koko69420/SmartBMS_Active-balancing/16s_BMS_Bill_of_Materials.xlsx

Sheet: Executive_Summary
16S LiFePO4 BMS - Procurement Executive Summary & Stock Analysis
Complete breakdown with MOQ / minimum pack sizing, XIQI 100A current shunt, external harness sensors, and verified domestic in-stock alternatives
SUPPLIER COST BREAKDOWN (ACCOUNTING FOR MOQ)
Supplier Name | Website / Storefront | Line Items | Design Qty | Cart / Order Qty | Order Total (₹) | Share of Total
ET Store | https://etstore.in
Robu.in | https://robu.in
Evelta | https://evelta.com
LionCircuits | https://lioncircuits.com
Rajiv Electronics | https://rajivelectronics.com
Sharvi Electronics | https://sharvielectronics.com
TOTALS | All Approved Domestic Sources
STOCK STATUS & VERIFIED IN-STOCK ALTERNATIVES
Part / Subsystem | Design Part | Supplier Status | Recommended In-Stock Alternative | Technical Verification & Impact
60V TVS Diode | SMBJ60CA (Evelta) | Out of stock on Evelta | SMBJ64CA-13-F (Robu.in ₹31.00) | In stock on Robu. Standoff 64V prevents leakage at 58.4V full pack charge while clamping safely below 100V FET breakdown.
100V Buck Regulator | TI LM5164DDA (Evelta) | Bare IC fluctuating | 7Semi LM5164 Buck Module (Evelta ₹548.70) | 173 units in stock on Evelta. Pre-built synchronous buck board with inductor and filter caps; can be wired or IC desoldered.
16-Ch Analog Mux | CD74HC4067SM (ET Store) | Breakout temporarily sold out | 74HC4067 Bare IC (Robu.in ₹35.00 / Sunrom) | In stock on Robu and Sunrom. Exact pin-compatible TSSOP/SSOP/SOP footprint for temperature & balance sensing.
RISC-V Microcontroller | CH32V203C8T6 Bare IC (ET Store) | In stock / hobby pack | WeAct CH32V203 Board (Robu ₹199) or STM32F103 (Evelta) | STM32F103C8T6 is 100% pin-compatible in LQFP-48 with identical pin functions (CAN, ADC, I2C, SPI).
Isolated DC-DC Rail | B1209S-1WR3 (Robu.in) | In stock (K-CUT brand ₹109) | Hi-Link HLK-B1209S-2WR3 (Robu.in ₹199.00) | 2W version provides higher peak gate charging current margin for switching the 16x IRFB4110 MOSFET bank.

Sheet: Master_BOM
16S LiFePO4 BMS - Complete Master Bill of Materials (Hierarchical & Verified)
Includes all 7 schematic sheets, 32 NTC dividers, XIQI 100A shunt, external NTC probes, mating hoods, commercial MOQs, stock status & verified alternatives
Item # | Subsystem / Sheet | Category | Reference Designator(s) | Component / Value | Description & Functional Purpose | Package / Footprint | Type | Design Qty | MOQ / Pack | Order Qty | Primary Supplier | Unit Price (₹) | Order Total (₹) | Stock Status | Verified In-Stock Alternative(s) | Direct Purchase Link
1 | External (Chassis / Busbar) | Current Shunt | RS1 (External Current Shunt, wired to J31/J32) | FL-2B 100A 75mV | XIQI Electric CG FL-2B 100A 75mV DC Current Shunt Resistor | Chassis_BoltMount | Chassis/THT | 1 | 1 | 1 | Robu.in | ₹352.00 |  | In Stock | FL-2C 100A 75mV with base (Robu ₹499), FL-2 150A 75mV | View / Buy on Robu.in (https://robu.in/product/xiqi-electric-cg-fl-2b-100a-75mv-dc-current-shunt-resister/)
2 | External (Chassis / Precharge) | Precharge Resistor | R_PRE (External Precharge Chassis-Mount Power Resistor, wired to J35) | 50 Ω 25W | 50 Ohm 25W Aluminum Housed Wirewound Power Resistor (55mm mounting pitch) | Chassis_Mount_55mm_Pitch | Chassis/THT | 1 | 1 | 1 | Sharvi Electronics | ₹184.88 |  | Procured (In Hand, 55mm Pitch) | 50 Ohm 50W Aluminum Resistor (Sharvi ₹184.88) | View / Buy on Sharvi Electronics (https://sharvielectronics.com/product/50-ohm-25-watt-aluminum-housed-wirewound-power-resistor/)
3 | External (Cell Pack Harness) | Sensors (External) | TH1..TH16 (16x Cell Temperature Sensors for DB-25 J20) | 10k NTC 3950 (with wire) | 10K Ohm NTC Thermistor Temperature Sensor Probe with 1m wire lead | Probe_Wire_Harness | Harness | 16 | 1 | 16 | ET Store | ₹14.58 |  | In Stock | ETStore SKU ET5524, NTC 10K with steel cap (ETD11498), 100K 3950 | View / Buy on ET Store (https://www.etstore.in/products/ntc-10k-ohm-with-wire-thermistor-temperature-sensor-et5524)
4 | 01 Cell AFE | ICs & Modules | U1 | BQ76952PFBR | 16S LiFePO4 Battery Monitor, Protector & Balancer IC | QFP50P900X900X120-48N | SMD | 1 | 1 | 1 | LionCircuits | ₹665.29 |  | In Stock | TI BQ76952PFBR, BQ7695202 (I2C default) | View / Buy on LionCircuits (https://www.lioncircuits.com/components/texas-instruments/bq76952pfbr)
5 | 04 Current Switching | ICs & Modules | U2, U3 | UCC27517DBVR | 4A High-Speed Low-Side Gate Driver, SOT-23-5 | SOT-23-5 | SMD | 2 | 1 | 2 | Robu.in | ₹35.00 |  | In Stock | UCC27511DBVR, FAN3100, MCP1407 | View / Buy on Robu.in (https://robu.in/product/ucc27517dbvr-texas-instruments/)
6 | 04 Current Switching | ICs & Modules | U4, U5, U6, U7, U40 | EL817 | Single Channel Phototransistor Optocoupler, SOP-4 | SOP-4_3.8x4.1mm_P2.54mm | SMD | 5 | 2 | 6 | ET Store | ₹6.50 |  | In Stock | PC817C, EL817S, TLP785, LTV-817 | View / Buy on ET Store (https://www.etstore.in/products/pc817-el817-opto-coupler-isolator-module-4-channel-level-shifter-et7518)
7 | 05 Temperature Sensing | ICs & Modules | U8, U9, U30 | CD74HC4067SM | High-Speed 16-Channel Analog Multiplexer / Demultiplexer | SSOP-24_5.3x8.2mm_P0.65mm | SMD | 3 | 1 | 3 | ET Store | ₹56.87 |  | In Stock | 74HC4067, 74HCT4067, ADG706 (Robu.in SKU 16345, Sunrom) | View / Buy on ET Store (https://www.etstore.in/products/cd74hc4067-multiplexer-breakout-module-et5969)
8 | 02 Power Supply | ICs & Modules | U10 | LM5164DDA | 100V 1A Synchronous Step-Down Buck DC-DC Converter | HSOP-8-1EP_3.9x4.9mm_P1.27mm_EP2.41x3.1mm_ThermalVias | SMD | 1 | 1 | 1 | Evelta | ₹548.70 |  | In Stock (7Semi Module / IC) | 7Semi LM5164 Breakout, TI LM5017MR, LM5007 (100V step-down) | View / Buy on Evelta (https://evelta.com/7semi-dc-dc-buck-converter-7v-100v-input-to-5v-1a-output-lm5164/)
9 | 02 Power Supply | ICs & Modules | U11 | LM2596S-3.3 | 3A Step-Down Voltage Regulator (LM2596S-3.3), TO-263-5 | TO-263-5_TabPin3 | SMD | 1 | 1 | 1 | ET Store | ₹35.00 |  | In Stock | LM2596S-ADJ + divider, LM2576S, XL4015 module | View / Buy on ET Store (https://www.etstore.in/products/lm2596s-step-down-voltage-regulator-to-263)
10 | 02 Power Supply | ICs & Modules | U12 | B1212S-1WR3 | 1W 12V-to-12V Isolated DC-DC Converter Module | Converter_DCDC_Murata_MEE1SxxxxSC_THT | THT | 1 | 1 | 1 | ET Store | ₹103.00 |  | In Stock | Mornsun B1212S-1WR3, Hi-Link HLK-B1212S-2WR3 | View / Buy on ET Store (https://www.etstore.in/products/b1212s-1wr3-g-energy-ylptec-isolated-module-dc-dc-converter-eta2637)
11 | 02 Power Supply | ICs & Modules | U13 | LM2596S-5.0 | 3A Step-Down Voltage Regulator (LM2596S-5.0), TO-263-5 | TO-263-5_TabPin3 | SMD | 1 | 1 | 1 | ET Store | ₹35.00 |  | In Stock | LM2596S-ADJ + divider, LM2576S, XL4015 module | View / Buy on ET Store (https://www.etstore.in/products/lm2596s-step-down-voltage-regulator-to-263)
12 | 07 Isolated CAN & Comms | ICs & Modules | U13 | ISO1050DUBR | 5V Isolated CAN Transceiver, SOP-8 | SOP-8_6.62x9.15mm_P2.54mm | SMD | 1 | 1 | 1 | Evelta | ₹230.10 |  | In Stock | TI ISO1050DUB, Robu.in ISO1050 Module, MAX14882 | View / Buy on Evelta (https://evelta.com/iso1050dubr-5v-isolated-can-transceiver-8-pin-sop/)
13 | 07 Isolated CAN & Comms | ICs & Modules | U14 | B1209S-1WR3 | 1W 12V-to-9V Isolated DC-DC Converter for Gate Drive Rail | Converter_DCDC_Murata_MEE1SxxxxSC_THT | THT | 1 | 1 | 1 | Robu.in | ₹109.00 |  | In Stock | K-CUT B1209S-1W, Hi-Link HLK-B1209S-2WR3 (₹199, Robu) | View / Buy on Robu.in (https://robu.in/product/k-cut-b1209s-1w-dc-dc-12-to-9v-isolated-step-down-power-module/)
14 | 07 Isolated CAN & Comms | ICs & Modules | U15 | AMS1117-5.0 | 1A Low Dropout Linear Voltage Regulator 5.0V, SOT-223 | SOT-223-3_TabPin2 | SMD | 1 | 1 | 1 | ET Store | ₹8.00 |  | In Stock | LM1117-5.0, AP1117-50, LD1117S50TR | View / Buy on ET Store (https://www.etstore.in/products/ams1117-5-0v-sot-223-voltage-regulator)
15 | 03 MCU Control | ICs & Modules | U20 | CH32V203C8T6 | QingKe 32-bit RISC-V MCU, 64KB Flash, 20KB SRAM, LQFP-48 | LQFP-48_7x7mm_P0.5mm | SMD | 1 | 1 | 1 | ET Store | ₹95.00 |  | In Stock | Robu.in WeAct CH32V203C8T6 Board (₹199), Evelta STM32F103C8T6 (₹210) | View / Buy on ET Store (https://www.etstore.in/products/ch32v203c8t6-risc-v-microcontroller-lqfp-48)
16 | 03 MCU Control | ICs & Modules | U21 | FM24CL64B-G | 64 Kbit (8Kx8) High-Endurance Non-Volatile I2C FRAM | SOIC-8_3.9x4.9mm_P1.27mm | SMD | 1 | 1 | 1 | Robu.in | ₹232.00 |  | In Stock | FM24CL16B (16Kb), FM24W256 (256Kb), Microchip 24LC256 (EEPROM) | View / Buy on Robu.in (https://robu.in/product/fm24cl64b-gtr-infineon-cypress-64kbit-soic-8-fram/)
17 | 06 Balance Status | ICs & Modules | U31..U34 (16 items: U31, U31, U31, U31 ...) | LTV-847S | Lite-On 4-Channel DC Optocoupler Isolator (Quad) | SMDIP-16_W9.53mm | SMD | 4 | 1 | 4 | ET Store | ₹60.53 |  | In Stock | PC847, EL847, TLP281-4, 4x PC817 | View / Buy on ET Store (https://www.etstore.in/products/ltv-847-dip-16-lite-on-847-4-channel-opto-coupler-isolators-eta2359)
18 | 04 Current Switching | Transistors/FETs | Q1..Q19 (17 items: Q1, Q2, Q3, Q4 ...) | IRFB4110 | 100V 180A 3.7mR N-Channel Power MOSFET (TO-220 THT) | TO-220-3_Vertical | THT | 17 | 1 | 17 | ET Store | ₹55.99 |  | In Stock | HY4008 (80V 200A), IRFB4310, STP180N10F7 | View / Buy on ET Store (https://www.etstore.in/products/irfb4110-to220-ir-mosfet-n-channel-100v-180a-eta1308)
19 | 04 Current Switching | Transistors/FETs | Q17, Q18 | BC817-40,215 | 45V 500mA General Purpose NPN Transistor, SOT-23 | SOT-23_Handsoldering | SMD | 2 | 5 | 5 | ET Store | ₹3.00 |  | In Stock | MMBT3904, 2N3904, BC847 | View / Buy on ET Store (https://www.etstore.in/products/bc817-25-sot-23-npn-transistor)
20 | 01 Cell AFE | Transistors/FETs | Q21 | BCX56-135 | 80V 1A Medium Power NPN Transistor, SOT-89-3 | SOT-89-3_Handsoldering | SMD | 1 | 1 | 1 | Evelta | ₹11.38 |  | In Stock | BCX56-16, BCP56, 2SD882 | View / Buy on Evelta (https://evelta.com/bcx56-cj-npn-bipolar-transistor-bjt-80v-1a-sot-89/)
21 | 01 Cell AFE | Diodes/TVS | D1, D2 | BAV21WS | 250V 200mA Fast Switching Diode, SOD-323 | D_SOD-323_HandSoldering | SMD | 2 | 5 | 5 | ET Store | ₹2.50 |  | In Stock | 1N4148W, BAV19WS, BAV20WS | View / Buy on ET Store (https://www.etstore.in/products/bav21ws-sod-323-switching-diode)
22 | 02 Power Supply | Diodes/TVS | D3 | SMBJ60CA | 60V 600W Bidirectional TVS Diode, SMB | D_SMB | SMD | 1 | 1 | 1 | Evelta | ₹15.00 |  | Low Stock / Use In-Stock Alt | SMBJ64CA-13-F (₹31, In Stock Robu), SMCJ60CA, 1.5SMC62CA | View / Buy on Evelta (https://evelta.com/smbj60ca-60v-bidirectional-tvs-diode-smb-surface-mount/)
23 | 02 Power Supply | Diodes/TVS | D4 | B340 | 40V 3A Schottky Barrier Rectifier Diode, SMC | D_SMC | SMD | 1 | 2 | 2 | ET Store | ₹6.00 |  | In Stock | SS34, SK34, MBRS340 | View / Buy on ET Store (https://www.etstore.in/products/ss34-b340-smc-schottky-barrier-diode)
24 | 02 Power Supply | Diodes/TVS | D5 | B340 | 40V 3A Schottky Barrier Rectifier Diode, SMC | D_SMC | SMD | 1 | 2 | 2 | ET Store | ₹6.00 |  | In Stock | SS34, SK34, MBRS340 | View / Buy on ET Store (https://www.etstore.in/products/ss34-b340-smc-schottky-barrier-diode)
25 | 07 Isolated CAN & Comms | Diodes/TVS | D5 | PESD2CAN | CAN Bus Dual-line ESD Protection TVS Diode, SOT-23 | SOT-23 | SMD | 1 | 1 | 1 | Robu.in | ₹12.00 |  | In Stock | PESD1CAN, NUP2105L, ESDCAN01-2BWY | View / Buy on Robu.in (https://robu.in/product/pesd2can215-nexperia/)
26 | 02 Power Supply | Diodes/TVS | D6 | B5819W | 40V 1A Surface Mount Schottky Barrier Diode, SOD-123 | D_SMA | SMD | 1 | 5 | 5 | ET Store | ₹3.00 |  | In Stock | 1N5819HW, SS14, BAT54 | View / Buy on ET Store (https://www.etstore.in/products/1n5819-b5819w-sod-123-schottky-diode)
27 | 03 MCU Control | Diodes/TVS | D10 | GREEN | SMD Green Indicator LED, 0805 | LED_0805_2012Metric | SMD | 1 | 5 | 5 | ET Store | ₹2.00 |  | In Stock | Standard 0805 SMD LEDs (Red/Blue/Green) | View / Buy on ET Store (https://www.etstore.in/products/smd-0805-green-led)
28 | 07 Isolated CAN & Comms | Diodes/TVS | D20 | SMAJ6.0A | 6.0V 400W Fast Unidirectional TVS Diode, SMA | D_SMA | SMD | 1 | 1 | 1 | Evelta | ₹4.15 |  | In Stock | SMAJ5.0A, SMAJ6.5A, SMBJ6.0A | View / Buy on Evelta (https://evelta.com/smaj6-0a-6v-400w-esd-suppressor-tvs-diode/)
29 | 08 Precharge Circuit | Diodes/TVS | D40 | SMAJ75A | 75V 400W Fast Unidirectional TVS Diode (Precharge Inductive Clamp, SMA) | D_SMA | SMD | 1 | 1 | 1 | Evelta | ₹3.30 |  | In Stock (SKU: 273-SMAJ75A) | SMAJ70A, SMAJ78A, SMCJ75A (1.5kW), Robu.in 75V TVS | View / Buy on Evelta (https://evelta.com/smaj75a-75v-400w-esd-suppressor-tvs-diode/)
30 | 08 Precharge Circuit | Diodes/TVS | D41 | BZT52C15 | 15V 500mW SMD Zener Diode (Gate Clamp, SOD-123) | D_SOD-123 | SMD | 1 | 5 | 5 | ET Store | ₹1.77 |  | In Stock (Marking WJ, ETStore) | MMSZ5245B, BZX384-C15, 15V 500mW Zener SOD-123 | View / Buy on ET Store (https://www.etstore.in/products/bzt52c15-wj-sod123-15v-zener-diode-smd)
31 | 08 Precharge Circuit | Diodes/TVS | D42 | BAT54S | Dual Schottky Barrier Diode Series Pair (Precharge Sense ADC Rail Clamp, SOT-23) | SOT-23 | SMD | 1 | 1 | 1 | Evelta | ₹2.01 |  | In Stock (JD / Nexperia, Evelta) | BAT54A, BAT54C, MMBD4148 dual, 2x 1N5819 | View / Buy on Evelta (https://evelta.com/bat54s-sot-23-3-schottky-barrier-diode/)
32 | 02 Power Supply | Protection/Fuses | F1 | 2A 80V | 2A 80V Fast-Acting Surface Mount Fuse, 1812 | Fuse_1812_4532Metric | SMD | 1 | 2 | 2 | ET Store | ₹16.00 |  | In Stock | Bel Fuse 0685P, Littelfuse 0451 | View / Buy on ET Store (https://www.etstore.in/products/1812-smd-fast-blow-fuse)
33 | 02 Power Supply | Protection/Fuses | F2 | 3.15A | 3.15A Fast-Acting Surface Mount Fuse, 1812 | Fuse_1812_4532Metric | SMD | 1 | 2 | 2 | ET Store | ₹16.00 |  | In Stock | Bel Fuse 0685P, Littelfuse 0451 | View / Buy on ET Store (https://www.etstore.in/products/1812-smd-fast-blow-fuse)
34 | 07 Isolated CAN & Comms | Protection/Fuses | F10 | 1.0A 1812 PTC | 1.0A 16V Resettable Polymeric PTC Fuse, 1812 | Fuse_1812_4532Metric | SMD | 1 | 2 | 2 | ET Store | ₹18.00 |  | In Stock | Bourns MF-MSMF110, Littelfuse 1812L110 | View / Buy on ET Store (https://www.etstore.in/products/1812-resettable-ptc-fuse-1a)
35 | External (Harness Cable) | Connectors/Hardware | P20 (Mating Plug for J20 DB-25 NTC Harness) | DB25 Male Solder Plug + Hood | DB25 Male Solder-Type Connector Plug with Plastic/Metal Protective Shell | Cable_Mount | Cable | 1 | 1 | 1 | Rajiv Electronics | ₹35.00 |  | In Stock | DB25 Male Solder Cup (₹18.90) + DB25 Plastic Cover (₹18.00) | View / Buy on Rajiv Electronics (https://rajivelectronics.com/product/db25-male-connector/)
36 | External (Harness Cable) | Connectors/Hardware | P30 (Mating Plug for J30 DD-50 Balance Tap Harness) | DB50 Male Solder Plug + Hood | DB50 50-Pin D-Sub Male Solder-Type Connector Plug with Protective Dust Cover | Cable_Mount | Cable | 1 | 1 | 1 | Rajiv Electronics | ₹95.00 |  | In Stock | Rajiv DB50 Male Solder Type (₹82.60) + DB50 Metal/Plastic Hood | View / Buy on Rajiv Electronics (https://rajivelectronics.com/product/db50-50-pin-d-sub-male-connector-solder-type/)
37 | 02 Power Supply | Connectors/Hardware | J1 | FAN1 | 2-Pin 5.08mm Pitch PCB Screw Terminal Block | TerminalBlock_Phoenix_MKDS-1,5-2-5.08_1x02_P5.08mm_Horizontal | THT | 1 | 1 | 1 | ET Store | ₹12.00 |  | In Stock | Phoenix MKDS 1,5/2-5.08, Degson DG301-5.08 | View / Buy on ET Store (https://www.etstore.in/products/2-pin-5-08mm-pitch-screw-terminal-block)
38 | 02 Power Supply | Connectors/Hardware | J2 | FAN2 | 2-Pin 5.08mm Pitch PCB Screw Terminal Block | TerminalBlock_Phoenix_MKDS-1,5-2-5.08_1x02_P5.08mm_Horizontal | THT | 1 | 1 | 1 | ET Store | ₹12.00 |  | In Stock | Phoenix MKDS 1,5/2-5.08, Degson DG301-5.08 | View / Buy on ET Store (https://www.etstore.in/products/2-pin-5-08mm-pitch-screw-terminal-block)
39 | 02 Power Supply | Connectors/Hardware | J4 | 12V_EXT | 2-Pin 5.08mm Pitch PCB Screw Terminal Block | TerminalBlock_Phoenix_MKDS-1,5-2-5.08_1x02_P5.08mm_Horizontal | THT | 1 | 1 | 1 | ET Store | ₹12.00 |  | In Stock | Phoenix MKDS 1,5/2-5.08, Degson DG301-5.08 | View / Buy on ET Store (https://www.etstore.in/products/2-pin-5-08mm-pitch-screw-terminal-block)
40 | 07 Isolated CAN & Comms | Connectors/Hardware | J4 | PACK LINK, NOT ETHERNET | RJ45 8P8C Right-Angle Shielded PCB Modular Jack | RJ45_Amphenol_54602-x08_Horizontal | THT | 1 | 1 | 1 | ET Store | ₹25.00 |  | In Stock | Amphenol 54602-x08, Standard PCB RJ45 Jack | View / Buy on ET Store (https://www.etstore.in/products/rj45-8p8c-horizontal-pcb-female-jack)
41 | 03 MCU Control | Connectors/Hardware | J10 | WCH-LinkE | 2.54mm Pitch Breakaway Pin Header (WCH-LinkE) | PinHeader_1x05_P2.54mm_Vertical | THT | 1 | 1 | 1 | ET Store | ₹5.00 |  | In Stock | 40-pin 2.54mm Male/Female header strips | View / Buy on ET Store (https://www.etstore.in/products/40-pin-2-54mm-male-header-strip)
42 | 03 MCU Control | Connectors/Hardware | J11 | Debug UART | 2.54mm Pitch Breakaway Pin Header (Debug UART) | PinHeader_1x03_P2.54mm_Vertical | THT | 1 | 1 | 1 | ET Store | ₹5.00 |  | In Stock | 40-pin 2.54mm Male/Female header strips | View / Buy on ET Store (https://www.etstore.in/products/40-pin-2-54mm-male-header-strip)
43 | 03 MCU Control | Connectors/Hardware | J12 | OLED Display (I2C) | 0.96 inch 128x64 I2C OLED Display Module (SSD1306, 4-Pin) | PinHeader_1x04_P2.54mm_Vertical | THT | 1 | 1 | 1 | ET Store | ₹171.73 |  | In Stock | SSD1306 0.96 I2C Blue/White, SH1106 1.3 inch I2C OLED | View / Buy on ET Store (https://www.etstore.in/products/0-96-inch-oled-display-module-i2c-128x64-4-pin-blue-et5049)
44 | 06 Balance Status | Connectors/Hardware | J20 | DB25_Female | 25-Pin D-Sub Female Right-Angle PCB Connector (NTC Taps) | DSUB-25_Socket_Horizontal_P2.77x2.84mm_EdgePinOffset4.94mm_Housed_MountingHolesOffset4.94mm | THT | 1 | 1 | 1 | Rajiv Electronics | ₹26.00 |  | In Stock | Rajiv DB25 Female, Amphenol D-sub 25 | View / Buy on Rajiv Electronics (https://rajivelectronics.com/product/db25-right-angle-female-connector-25-pin-d-sub-pcb-mount/)
45 | Top Level Interconnect | Connectors/Hardware | J30 | DD50_Female | 50-Pin D-Sub High-Density Female PCB Connector (Cell Taps) |  | THT | 1 | 1 | 1 | Rajiv Electronics | ₹112.10 |  | In Stock | Rajiv DB50 Straight Female, NorComp 180-050-203L001 | View / Buy on Rajiv Electronics (https://rajivelectronics.com/product/db50-pin-d-sub-pcb-mount-straight-female-connector/)
46 | Top Level Interconnect | Connectors/Hardware | J31 | SHUNT KELVIN | 2.54mm Pitch Breakaway Pin Header (SHUNT KELVIN) | PinHeader_1x02_P2.54mm_Vertical | THT | 1 | 1 | 1 | ET Store | ₹5.00 |  | In Stock | 40-pin 2.54mm Male/Female header strips | View / Buy on ET Store (https://www.etstore.in/products/40-pin-2-54mm-male-header-strip)
47 | Top Level Interconnect | Connectors/Hardware | J32 | FROM SHUNT | FROM SHUNT High-Current M5/M6 Direct Bolt-Down PCB Pad Terminal | MountingHole_8.4mm_M8_Pad | THT/Pad | 1 | 5 | 5 | Rajiv Electronics | ₹12.00 |  | In Stock | M5/M6 SS304 Hex Bolt, Spring Washer, Flange Nut | View / Buy on Rajiv Electronics (https://rajivelectronics.com/product-category/hardware-fittings/)
48 | Top Level Interconnect | Connectors/Hardware | J33 | PACK MINUS | PACK MINUS High-Current M5/M6 Direct Bolt-Down PCB Pad Terminal | MountingHole_8.4mm_M8_Pad | THT/Pad | 1 | 5 | 5 | Rajiv Electronics | ₹12.00 |  | In Stock | M5/M6 SS304 Hex Bolt, Spring Washer, Flange Nut | View / Buy on Rajiv Electronics (https://rajivelectronics.com/product-category/hardware-fittings/)
49 | Top Level Interconnect | Connectors/Hardware | J34 | PACK PLUS TAP | PACK PLUS TAP High-Current M5/M6 Direct Bolt-Down PCB Pad Terminal | MountingHole_8.4mm_M8_Pad | THT/Pad | 1 | 5 | 5 | Rajiv Electronics | ₹12.00 |  | In Stock | M5/M6 SS304 Hex Bolt, Spring Washer, Flange Nut | View / Buy on Rajiv Electronics (https://rajivelectronics.com/product-category/hardware-fittings/)
50 | 08 Precharge Circuit | Connectors/Hardware | J35 | AK300-2 | 2-Pin 5.08mm Pitch Precharge Resistor Terminal Block (Chassis Resistor Header) | TerminalBlock_Phoenix_MKDS-1,5-2-5.08_1x02_P5.08mm_Horizontal | THT | 1 | 1 | 1 | ET Store | ₹12.00 |  | In Stock | Phoenix MKDS 1,5/2-5.08, Degson DG301-5.08 | View / Buy on ET Store (https://www.etstore.in/products/2-pin-5-08mm-pitch-screw-terminal-block)
51 | 02 Power Supply | Connectors/Hardware | JP1 | JP_OPEN | 2-Pin Solder Jumper (JP_OPEN) | SolderJumper-2_P1.3mm_Open_Pad1.0x1.5mm | SMD | 1 | N/A | 0 | ET Store | ₹0.00 |  | PCB Track Feature | Solder bridge / 0-Ohm 0805 resistor | N/A (PCB Feature)
52 | 07 Isolated CAN & Comms | Connectors/Hardware | JP1 | TERMINATION | 2-Pin Solder Jumper (TERMINATION) | SolderJumper-2_P1.3mm_Open_RoundedPad1.0x1.5mm | SMD | 1 | N/A | 0 | ET Store | ₹0.00 |  | PCB Track Feature | Solder bridge / 0-Ohm 0805 resistor | N/A (PCB Feature)
53 | 03 MCU Control | Connectors/Hardware | JP10 | BOOT0 | 2-Pin Solder Jumper (BOOT0) | SolderJumper-2_P1.3mm_Open_RoundedPad1.0x1.5mm | SMD | 1 | N/A | 0 | ET Store | ₹0.00 |  | PCB Track Feature | Solder bridge / 0-Ohm 0805 resistor | N/A (PCB Feature)
54 | 03 MCU Control | Connectors/Hardware | JP11 | ADDR0 | 2-Pin Solder Jumper (ADDR0) | SolderJumper-2_P1.3mm_Open_RoundedPad1.0x1.5mm | SMD | 1 | N/A | 0 | ET Store | ₹0.00 |  | PCB Track Feature | Solder bridge / 0-Ohm 0805 resistor | N/A (PCB Feature)
55 | 03 MCU Control | Connectors/Hardware | JP12 | ADDR1 | 2-Pin Solder Jumper (ADDR1) | SolderJumper-2_P1.3mm_Open_RoundedPad1.0x1.5mm | SMD | 1 | N/A | 0 | ET Store | ₹0.00 |  | PCB Track Feature | Solder bridge / 0-Ohm 0805 resistor | N/A (PCB Feature)
56 | 03 MCU Control | Connectors/Hardware | JP13 | ADDR2 | 2-Pin Solder Jumper (ADDR2) | SolderJumper-2_P1.3mm_Open_RoundedPad1.0x1.5mm | SMD | 1 | N/A | 0 | ET Store | ₹0.00 |  | PCB Track Feature | Solder bridge / 0-Ohm 0805 resistor | N/A (PCB Feature)
57 | 03 MCU Control | Connectors/Hardware | JP14 | EE_WP | 2-Pin Solder Jumper (EE_WP) | SolderJumper-2_P1.3mm_Open_RoundedPad1.0x1.5mm | SMD | 1 | N/A | 0 | ET Store | ₹0.00 |  | PCB Track Feature | Solder bridge / 0-Ohm 0805 resistor | N/A (PCB Feature)
58 | 03 MCU Control | Inductors/Filters | FB10 | 120R/1.5A | 120 Ohm @ 100MHz 1.5A Ferrite Bead, 0805 | L_0805_2012Metric | SMD | 1 | 5 | 5 | ET Store | ₹3.50 |  | In Stock | Murata BLM21PG121SN1D, Sunlord 0805 Bead | View / Buy on ET Store (https://www.etstore.in/products/0805-smd-ferrite-bead-120-ohm)
59 | 02 Power Supply | Inductors/Filters | L1 | 68 uH | 68 uH High-Current Shielded Power Inductor (SRR1260) | L_Bourns_SRR1260 | SMD | 1 | 1 | 1 | ET Store | ₹28.00 |  | In Stock | Bourns SRR1260, Wurth WE-PDF, Coilcraft MSS1260 | View / Buy on ET Store (https://www.etstore.in/products/33uh-smd-power-inductor-srr1260)
60 | 02 Power Supply | Inductors/Filters | L2, L3 | 33 uH | 33 uH High-Current Shielded Power Inductor (SRR1260) | L_Bourns_SRR1260 | SMD | 2 | 1 | 2 | ET Store | ₹28.00 |  | In Stock | Bourns SRR1260, Wurth WE-PDF, Coilcraft MSS1260 | View / Buy on ET Store (https://www.etstore.in/products/33uh-smd-power-inductor-srr1260)
61 | 03 MCU Control | Crystals | Y1 | 8MHz | 8.000 MHz Fundamental SMD Crystal Resonator (3225-4P) | Crystal_SMD_3225-4Pin_3.2x2.5mm | SMD | 1 | 1 | 1 | ET Store | ₹15.00 |  | In Stock | Abracon ABM8, TXC 7M-8.000MAAJ-T, HC-49SMD | View / Buy on ET Store (https://www.etstore.in/products/8mhz-smd-crystal-oscillator-3225)
62 | 01 Cell AFE | Resistors | R1..R17 (17 items: R1, R2, R3, R4 ...) | 20 Ω | SMD Chip Resistor 20 Ω, 1% tolerance | R_1206_3216Metric_Pad1.30x1.75mm_HandSolder | SMD | 17 | 10 | 20 | ET Store | ₹0.75 |  | In Stock | Standard 1% SMD Resistor 20 Ω (Yageo / Walsin / UniOhm) | View / Buy on ET Store (https://www.etstore.in/collections/1206-smd-package-resistors)
63 | 01 Cell AFE | Resistors | R18, R21, R22 | 100 Ω | SMD Chip Resistor 100 Ω, 1% tolerance | R_1206_3216Metric_Pad1.30x1.75mm_HandSolder | SMD | 3 | 10 | 10 | ET Store | ₹0.75 |  | In Stock | Standard 1% SMD Resistor 100 Ω (Yageo / Walsin / UniOhm) | View / Buy on ET Store (https://www.etstore.in/collections/1206-smd-package-resistors)
64 | 01 Cell AFE | Resistors | R19..R58 (22 items: R19, R20, R23, R24 ...) | 10 kΩ | SMD Chip Resistor 10 kΩ, 1% tolerance | R_1206_3216Metric_Pad1.30x1.75mm_HandSolder | SMD | 22 | 10 | 30 | ET Store | ₹0.75 |  | In Stock | Standard 1% SMD Resistor 10 kΩ (Yageo / Walsin / UniOhm) | View / Buy on ET Store (https://www.etstore.in/collections/1206-smd-package-resistors)
65 | 04 Current Switching | Resistors | R25..R40 (16 items: R25, R26, R27, R28 ...) | 27 Ω | SMD Chip Resistor 27 Ω, 1% tolerance | R_1206_3216Metric_Pad1.30x1.75mm_HandSolder | SMD | 16 | 10 | 20 | ET Store | ₹0.75 |  | In Stock | Standard 1% SMD Resistor 27 Ω (Yageo / Walsin / UniOhm) | View / Buy on ET Store (https://www.etstore.in/collections/1206-smd-package-resistors)
66 | 04 Current Switching | Resistors | R59, R61 | 2.2 kΩ | SMD Chip Resistor 2.2 kΩ, 1% tolerance | R_1206_3216Metric_Pad1.30x1.75mm_HandSolder | SMD | 2 | 10 | 10 | ET Store | ₹0.75 |  | In Stock | Standard 1% SMD Resistor 2.2 kΩ (Yageo / Walsin / UniOhm) | View / Buy on ET Store (https://www.etstore.in/collections/1206-smd-package-resistors)
67 | 05 Temperature Sensing (NTC Dividers) | Resistors | R62..R110 (32 items: R62, R64, R66, R73 ...) | 10 kΩ | SMD Chip Resistor 10 kΩ, 1% tolerance | R_0805_2012Metric_Pad1.20x1.40mm_HandSolder | SMD | 32 | 10 | 40 | ET Store | ₹0.75 |  | In Stock | Standard 1% SMD Resistor 10 kΩ (Yageo / Walsin / UniOhm) | View / Buy on ET Store (https://www.etstore.in/collections/0805-smd-resistors-r0805)
68 | 04 Current Switching | Resistors | R63, R65 | 100 kΩ | SMD Chip Resistor 100 kΩ, 1% tolerance | R_1206_3216Metric_Pad1.30x1.75mm_HandSolder | SMD | 2 | 10 | 10 | ET Store | ₹0.75 |  | In Stock | Standard 1% SMD Resistor 100 kΩ (Yageo / Walsin / UniOhm) | View / Buy on ET Store (https://www.etstore.in/collections/1206-smd-package-resistors)
69 | 04 Current Switching | Resistors | R67, R68, R71, R72 | 330 Ω | SMD Chip Resistor 330 Ω, 1% tolerance | R_1206_3216Metric_Pad1.30x1.75mm_HandSolder | SMD | 4 | 10 | 10 | ET Store | ₹0.75 |  | In Stock | Standard 1% SMD Resistor 330 Ω (Yageo / Walsin / UniOhm) | View / Buy on ET Store (https://www.etstore.in/collections/1206-smd-package-resistors)
70 | 01 Cell AFE | Resistors | R69 | 300 Ω | SMD Chip Resistor 300 Ω, 1% tolerance | R_1206_3216Metric_Pad1.30x1.75mm_HandSolder | SMD | 1 | 10 | 10 | ET Store | ₹0.75 |  | In Stock | Standard 1% SMD Resistor 300 Ω (Yageo / Walsin / UniOhm) | View / Buy on ET Store (https://www.etstore.in/collections/1206-smd-package-resistors)
71 | 01 Cell AFE | Resistors | R70 | 10 MΩ | SMD Chip Resistor 10 MΩ, 1% tolerance | R_1206_3216Metric_Pad1.30x1.75mm_HandSolder | SMD | 1 | 10 | 10 | ET Store | ₹0.75 |  | In Stock | Standard 1% SMD Resistor 10 MΩ (Yageo / Walsin / UniOhm) | View / Buy on ET Store (https://www.etstore.in/collections/1206-smd-package-resistors)
72 | 08 Precharge Circuit | Resistors | R90 | 220 | SMD Chip Resistor 220, 1% tolerance | R_1206_3216Metric | SMD | 1 | 10 | 10 | ET Store | ₹0.75 |  | In Stock | Standard 1% SMD Resistor 220 (Yageo / Walsin / UniOhm) | View / Buy on ET Store (https://www.etstore.in/collections/1206-smd-package-resistors)
73 | 08 Precharge Circuit | Resistors | R91 | 100k | SMD Chip Resistor 100k, 1% tolerance | R_1206_3216Metric | SMD | 1 | 10 | 10 | ET Store | ₹0.75 |  | In Stock | Standard 1% SMD Resistor 100k (Yageo / Walsin / UniOhm) | View / Buy on ET Store (https://www.etstore.in/collections/1206-smd-package-resistors)
74 | 08 Precharge Circuit | Resistors | R92 | 100 | SMD Chip Resistor 100, 1% tolerance | R_1206_3216Metric | SMD | 1 | 10 | 10 | ET Store | ₹0.75 |  | In Stock | Standard 1% SMD Resistor 100 (Yageo / Walsin / UniOhm) | View / Buy on ET Store (https://www.etstore.in/collections/1206-smd-package-resistors)
75 | 08 Precharge Circuit | Resistors | R93 | 10k | SMD Chip Resistor 10k, 1% tolerance | R_1206_3216Metric | SMD | 1 | 10 | 10 | ET Store | ₹0.75 |  | In Stock | Standard 1% SMD Resistor 10k (Yageo / Walsin / UniOhm) | View / Buy on ET Store (https://www.etstore.in/collections/1206-smd-package-resistors)
76 | 08 Precharge Circuit | Resistors | R94, R96 | 84.5k 1% | SMD Chip Resistor 84.5k 1%, 1% tolerance | R_1206_3216Metric | SMD | 2 | 10 | 10 | ET Store | ₹0.75 |  | In Stock | Standard 1% SMD Resistor 84.5k 1% (Yageo / Walsin / UniOhm) | View / Buy on ET Store (https://www.etstore.in/collections/1206-smd-package-resistors)
77 | 08 Precharge Circuit | Resistors | R95 | 10k 1% | SMD Chip Resistor 10k 1%, 1% tolerance | R_1206_3216Metric | SMD | 1 | 10 | 10 | ET Store | ₹0.75 |  | In Stock | Standard 1% SMD Resistor 10k 1% (Yageo / Walsin / UniOhm) | View / Buy on ET Store (https://www.etstore.in/collections/1206-smd-package-resistors)
78 | 08 Precharge Circuit | Resistors | R97 | 1k | SMD Chip Resistor 1k, 1% tolerance | R_0805_2012Metric | SMD | 1 | 10 | 10 | ET Store | ₹0.75 |  | In Stock | Standard 1% SMD Resistor 1k (Yageo / Walsin / UniOhm) | View / Buy on ET Store (https://www.etstore.in/collections/0805-smd-resistors-r0805)
79 | 02 Power Supply | Resistors | R101 | 1M | SMD Chip Resistor 1M, 1% tolerance | R_1206_3216Metric | SMD | 1 | 10 | 10 | ET Store | ₹0.75 |  | In Stock | Standard 1% SMD Resistor 1M (Yageo / Walsin / UniOhm) | View / Buy on ET Store (https://www.etstore.in/collections/1206-smd-package-resistors)
80 | 02 Power Supply | Resistors | R102 | 51k | SMD Chip Resistor 51k, 1% tolerance | R_0805_2012Metric | SMD | 1 | 10 | 10 | ET Store | ₹0.75 |  | In Stock | Standard 1% SMD Resistor 51k (Yageo / Walsin / UniOhm) | View / Buy on ET Store (https://www.etstore.in/collections/0805-smd-resistors-r0805)
81 | 02 Power Supply | Resistors | R103, R121, R126, R127 | 100k | SMD Chip Resistor 100k, 1% tolerance | R_0805_2012Metric | SMD | 4 | 10 | 10 | ET Store | ₹0.75 |  | In Stock | Standard 1% SMD Resistor 100k (Yageo / Walsin / UniOhm) | View / Buy on ET Store (https://www.etstore.in/collections/0805-smd-resistors-r0805)
82 | 02 Power Supply | Resistors | R104 | 270k | SMD Chip Resistor 270k, 1% tolerance | R_0805_2012Metric | SMD | 1 | 10 | 10 | ET Store | ₹0.75 |  | In Stock | Standard 1% SMD Resistor 270k (Yageo / Walsin / UniOhm) | View / Buy on ET Store (https://www.etstore.in/collections/0805-smd-resistors-r0805)
83 | 02 Power Supply | Resistors | R105 | 30k | SMD Chip Resistor 30k, 1% tolerance | R_0805_2012Metric | SMD | 1 | 10 | 10 | ET Store | ₹0.75 |  | In Stock | Standard 1% SMD Resistor 30k (Yageo / Walsin / UniOhm) | View / Buy on ET Store (https://www.etstore.in/collections/0805-smd-resistors-r0805)
84 | 02 Power Supply | Resistors | R106 | 470k | SMD Chip Resistor 470k, 1% tolerance | R_0805_2012Metric | SMD | 1 | 10 | 10 | ET Store | ₹0.75 |  | In Stock | Standard 1% SMD Resistor 470k (Yageo / Walsin / UniOhm) | View / Buy on ET Store (https://www.etstore.in/collections/0805-smd-resistors-r0805)
85 | 07 Isolated CAN & Comms | Resistors | R107, R120, R131 | 10k | SMD Chip Resistor 10k, 1% tolerance | R_0805_2012Metric | SMD | 3 | 10 | 10 | ET Store | ₹0.75 |  | In Stock | Standard 1% SMD Resistor 10k (Yageo / Walsin / UniOhm) | View / Buy on ET Store (https://www.etstore.in/collections/0805-smd-resistors-r0805)
86 | 07 Isolated CAN & Comms | Resistors | R108 | 2k | SMD Chip Resistor 2k, 1% tolerance | R_0805_2012Metric | SMD | 1 | 10 | 10 | ET Store | ₹0.75 |  | In Stock | Standard 1% SMD Resistor 2k (Yageo / Walsin / UniOhm) | View / Buy on ET Store (https://www.etstore.in/collections/0805-smd-resistors-r0805)
87 | 07 Isolated CAN & Comms | Resistors | R109 | 120 | SMD Chip Resistor 120, 1% tolerance | R_1206_3216Metric | SMD | 1 | 10 | 10 | ET Store | ₹0.75 |  | In Stock | Standard 1% SMD Resistor 120 (Yageo / Walsin / UniOhm) | View / Buy on ET Store (https://www.etstore.in/collections/1206-smd-package-resistors)
88 | 03 MCU Control | Resistors | R125 | 1k | SMD Chip Resistor 1k, 1% tolerance | R_0805_2012Metric | SMD | 1 | 10 | 10 | ET Store | ₹0.75 |  | In Stock | Standard 1% SMD Resistor 1k (Yageo / Walsin / UniOhm) | View / Buy on ET Store (https://www.etstore.in/collections/0805-smd-resistors-r0805)
89 | 03 MCU Control | Resistors | R128, R129 | 4.7k | SMD Chip Resistor 4.7k, 1% tolerance | R_0805_2012Metric | SMD | 2 | 10 | 10 | ET Store | ₹0.75 |  | In Stock | Standard 1% SMD Resistor 4.7k (Yageo / Walsin / UniOhm) | View / Buy on ET Store (https://www.etstore.in/collections/0805-smd-resistors-r0805)
90 | 06 Balance Status | Resistors | R130 | 47k | SMD Chip Resistor 47k, 1% tolerance | R_0805_2012Metric | SMD | 1 | 10 | 10 | ET Store | ₹0.75 |  | In Stock | Standard 1% SMD Resistor 47k (Yageo / Walsin / UniOhm) | View / Buy on ET Store (https://www.etstore.in/collections/0805-smd-resistors-r0805)
91 | 01 Cell AFE | Capacitors | C1..C17 (17 items: C1, C2, C3, C4 ...) | 220 nF | 220 nF 50V Ceramic Decoupling Capacitor, 0805 | C_1206_3216Metric_Pad1.33x1.80mm_HandSolder | SMD | 17 | 10 | 20 | ET Store | ₹1.25 |  | In Stock | Standard SMD MLCC (Murata / Samsung / TDK) | View / Buy on ET Store (https://www.etstore.in/collections/smd-capacitors)
92 | 01 Cell AFE | Capacitors | C18, C20 | 1 µF | 1 µF 50V Ceramic Decoupling Capacitor, 0805 | C_1812_4532Metric_Pad1.57x3.40mm_HandSolder | SMD | 2 | 10 | 10 | ET Store | ₹1.25 |  | In Stock | Standard SMD MLCC (Murata / Samsung / TDK) | View / Buy on ET Store (https://www.etstore.in/collections/smd-capacitors)
93 | 01 Cell AFE | Capacitors | C19 | 100 pF | 100 pF 50V Ceramic Decoupling Capacitor, 0805 | C_0805_2012Metric_Pad1.18x1.45mm_HandSolder | SMD | 1 | 10 | 10 | ET Store | ₹1.25 |  | In Stock | Standard SMD MLCC (Murata / Samsung / TDK) | View / Buy on ET Store (https://www.etstore.in/collections/smd-capacitors)
94 | 01 Cell AFE | Capacitors | C21 | 2.2 µF | 2.2 µF 50V Ceramic Decoupling Capacitor, 0805 | C_0805_2012Metric_Pad1.18x1.45mm_HandSolder | SMD | 1 | 10 | 10 | ET Store | ₹1.25 |  | In Stock | Standard SMD MLCC (Murata / Samsung / TDK) | View / Buy on ET Store (https://www.etstore.in/collections/smd-capacitors)
95 | 01 Cell AFE | Capacitors | C22 | 100 nF | 100 nF 50V Ceramic Decoupling Capacitor, 0805 | C_0805_2012Metric_Pad1.18x1.45mm_HandSolder | SMD | 1 | 10 | 10 | ET Store | ₹1.25 |  | In Stock | Standard SMD MLCC (Murata / Samsung / TDK) | View / Buy on ET Store (https://www.etstore.in/collections/smd-capacitors)
96 | 01 Cell AFE | Capacitors | C23 | 22 nF | 22 nF 50V Ceramic Decoupling Capacitor, 0805 | C_0805_2012Metric_Pad1.18x1.45mm_HandSolder | SMD | 1 | 10 | 10 | ET Store | ₹1.25 |  | In Stock | Standard SMD MLCC (Murata / Samsung / TDK) | View / Buy on ET Store (https://www.etstore.in/collections/smd-capacitors)
97 | 01 Cell AFE | Capacitors | C24 | 1 µF | 1 µF 50V Ceramic Decoupling Capacitor, 0805 | C_0805_2012Metric_Pad1.18x1.45mm_HandSolder | SMD | 1 | 10 | 10 | ET Store | ₹1.25 |  | In Stock | Standard SMD MLCC (Murata / Samsung / TDK) | View / Buy on ET Store (https://www.etstore.in/collections/smd-capacitors)
98 | 05 Temperature Sensing | Capacitors | C25, C26 | 100 nF | 100 nF 50V Ceramic Decoupling Capacitor, 0805 | C_1206_3216Metric_Pad1.33x1.80mm_HandSolder | SMD | 2 | 10 | 10 | ET Store | ₹1.25 |  | In Stock | Standard SMD MLCC (Murata / Samsung / TDK) | View / Buy on ET Store (https://www.etstore.in/collections/smd-capacitors)
99 | 02 Power Supply | Capacitors | C27 | 4.7uF 100V | 4.7uF 100V Multi-layer Ceramic Capacitor (MLCC), 1206/0805 | C_1210_3225Metric | SMD | 1 | 10 | 10 | ET Store | ₹3.50 |  | In Stock | Standard SMD MLCC (Murata / Samsung / TDK) | View / Buy on ET Store (https://www.etstore.in/collections/smd-capacitors)
100 | 02 Power Supply | Capacitors | C28 | 100nF 100V | 100nF 100V 100V High-Voltage Ceramic Capacitor | C_0805_2012Metric | SMD | 1 | 5 | 5 | ET Store | ₹4.50 |  | In Stock | Standard SMD MLCC (Murata / Samsung / TDK) | View / Buy on ET Store (https://www.etstore.in/collections/smd-capacitors)
101 | 02 Power Supply | Capacitors | C29 | 2.2nF 50V | 2.2nF 50V 50V Ceramic Decoupling Capacitor, 0805 | C_0805_2012Metric | SMD | 1 | 10 | 10 | ET Store | ₹1.25 |  | In Stock | Standard SMD MLCC (Murata / Samsung / TDK) | View / Buy on ET Store (https://www.etstore.in/collections/smd-capacitors)
102 | 02 Power Supply | Capacitors | C30 | 3.3nF | 3.3nF 50V Ceramic Decoupling Capacitor, 0805 | C_0805_2012Metric | SMD | 1 | 10 | 10 | ET Store | ₹1.25 |  | In Stock | Standard SMD MLCC (Murata / Samsung / TDK) | View / Buy on ET Store (https://www.etstore.in/collections/smd-capacitors)
103 | 02 Power Supply | Capacitors | C31 | 56pF | 56pF 50V Ceramic Decoupling Capacitor, 0805 | C_0805_2012Metric | SMD | 1 | 10 | 10 | ET Store | ₹1.25 |  | In Stock | Standard SMD MLCC (Murata / Samsung / TDK) | View / Buy on ET Store (https://www.etstore.in/collections/smd-capacitors)
104 | 02 Power Supply | Capacitors | C32 | 22uF 25V | 22uF 25V Multi-layer Ceramic Capacitor (MLCC), 1206/0805 | C_1206_3216Metric | SMD | 1 | 10 | 10 | ET Store | ₹3.50 |  | In Stock | Standard SMD MLCC (Murata / Samsung / TDK) | View / Buy on ET Store (https://www.etstore.in/collections/smd-capacitors)
105 | 02 Power Supply | Capacitors | C33, C35 | 100nF 25V | 100nF 25V 50V Ceramic Decoupling Capacitor, 0805 | C_0805_2012Metric | SMD | 2 | 10 | 10 | ET Store | ₹1.25 |  | In Stock | Standard SMD MLCC (Murata / Samsung / TDK) | View / Buy on ET Store (https://www.etstore.in/collections/smd-capacitors)
106 | 02 Power Supply | Capacitors | C34 | 470uF 25V | 470uF 25V Radial Aluminum Electrolytic Capacitor (Low-ESR) | CP_Elec_8x10 | THT | 1 | 2 | 2 | ET Store | ₹8.50 |  | In Stock | Panasonic FR/FC series, Nichicon HE | View / Buy on ET Store (https://www.etstore.in/products/470uf-25v-radial-electrolytic-capacitor)
107 | 02 Power Supply | Capacitors | C36 | 220uF 10V | 220uF 10V Radial Aluminum Electrolytic Capacitor (Low-ESR) | CP_Elec_8x10 | THT | 1 | 2 | 2 | ET Store | ₹8.50 |  | In Stock | Panasonic FR/FC series, Nichicon HE | View / Buy on ET Store (https://www.etstore.in/products/470uf-25v-radial-electrolytic-capacitor)
108 | 02 Power Supply | Capacitors | C37 | 100nF 10V | 100nF 10V 50V Ceramic Decoupling Capacitor, 0805 | C_0805_2012Metric | SMD | 1 | 10 | 10 | ET Store | ₹1.25 |  | In Stock | Standard SMD MLCC (Murata / Samsung / TDK) | View / Buy on ET Store (https://www.etstore.in/collections/smd-capacitors)
109 | 02 Power Supply | Capacitors | C38, C39 | 4.7uF 25V | 4.7uF 25V Multi-layer Ceramic Capacitor (MLCC), 1206/0805 | C_0805_2012Metric | SMD | 2 | 10 | 10 | ET Store | ₹3.50 |  | In Stock | Standard SMD MLCC (Murata / Samsung / TDK) | View / Buy on ET Store (https://www.etstore.in/collections/smd-capacitors)
110 | 02 Power Supply | Capacitors | C40 | 22uF 25V | 22uF 25V Multi-layer Ceramic Capacitor (MLCC), 1206/0805 | C_1206_3216Metric | SMD | 1 | 10 | 10 | ET Store | ₹3.50 |  | In Stock | Standard SMD MLCC (Murata / Samsung / TDK) | View / Buy on ET Store (https://www.etstore.in/collections/smd-capacitors)
111 | 07 Isolated CAN & Comms | Capacitors | C40, C41 | 100nF | 100nF 50V Ceramic Decoupling Capacitor, 0805 | C_0805_2012Metric | SMD | 2 | 10 | 10 | ET Store | ₹1.25 |  | In Stock | Standard SMD MLCC (Murata / Samsung / TDK) | View / Buy on ET Store (https://www.etstore.in/collections/smd-capacitors)
112 | 02 Power Supply | Capacitors | C41 | 220uF 10V | 220uF 10V Radial Aluminum Electrolytic Capacitor (Low-ESR) | CP_Elec_8x10 | THT | 1 | 2 | 2 | ET Store | ₹8.50 |  | In Stock | Panasonic FR/FC series, Nichicon HE | View / Buy on ET Store (https://www.etstore.in/products/470uf-25v-radial-electrolytic-capacitor)
113 | 02 Power Supply | Capacitors | C42 | 100nF | 100nF 50V Ceramic Decoupling Capacitor, 0805 | C_0805_2012Metric | SMD | 1 | 10 | 10 | ET Store | ₹1.25 |  | In Stock | Standard SMD MLCC (Murata / Samsung / TDK) | View / Buy on ET Store (https://www.etstore.in/collections/smd-capacitors)
114 | 07 Isolated CAN & Comms | Capacitors | C42 | 4.7uF 25V | 4.7uF 25V Multi-layer Ceramic Capacitor (MLCC), 1206/0805 | C_0805_2012Metric | SMD | 1 | 10 | 10 | ET Store | ₹3.50 |  | In Stock | Standard SMD MLCC (Murata / Samsung / TDK) | View / Buy on ET Store (https://www.etstore.in/collections/smd-capacitors)
115 | 07 Isolated CAN & Comms | Capacitors | C43..C71 (12 items: C43, C45, C47, C50 ...) | 100nF | 100nF 50V Ceramic Decoupling Capacitor, 0805 | C_0805_2012Metric | SMD | 12 | 10 | 20 | ET Store | ₹1.25 |  | In Stock | Standard SMD MLCC (Murata / Samsung / TDK) | View / Buy on ET Store (https://www.etstore.in/collections/smd-capacitors)
116 | 07 Isolated CAN & Comms | Capacitors | C44 | 10uF 25V | 10uF 25V Multi-layer Ceramic Capacitor (MLCC), 1206/0805 | C_1206_3216Metric | SMD | 1 | 10 | 10 | ET Store | ₹3.50 |  | In Stock | Standard SMD MLCC (Murata / Samsung / TDK) | View / Buy on ET Store (https://www.etstore.in/collections/smd-capacitors)
117 | 07 Isolated CAN & Comms | Capacitors | C46 | 22uF 10V | 22uF 10V Multi-layer Ceramic Capacitor (MLCC), 1206/0805 | C_1206_3216Metric | SMD | 1 | 10 | 10 | ET Store | ₹3.50 |  | In Stock | Standard SMD MLCC (Murata / Samsung / TDK) | View / Buy on ET Store (https://www.etstore.in/collections/smd-capacitors)
118 | 03 MCU Control | Capacitors | C53 | 4.7uF | 4.7uF Multi-layer Ceramic Capacitor (MLCC), 1206/0805 | C_0805_2012Metric | SMD | 1 | 10 | 10 | ET Store | ₹3.50 |  | In Stock | Standard SMD MLCC (Murata / Samsung / TDK) | View / Buy on ET Store (https://www.etstore.in/collections/smd-capacitors)
119 | 03 MCU Control | Capacitors | C55 | 1uF | 1uF 50V Ceramic Decoupling Capacitor, 0805 | C_0805_2012Metric | SMD | 1 | 10 | 10 | ET Store | ₹1.25 |  | In Stock | Standard SMD MLCC (Murata / Samsung / TDK) | View / Buy on ET Store (https://www.etstore.in/collections/smd-capacitors)
120 | 03 MCU Control | Capacitors | C56 | 10nF | 10nF 50V Ceramic Decoupling Capacitor, 0805 | C_0805_2012Metric | SMD | 1 | 10 | 10 | ET Store | ₹1.25 |  | In Stock | Standard SMD MLCC (Murata / Samsung / TDK) | View / Buy on ET Store (https://www.etstore.in/collections/smd-capacitors)
121 | 03 MCU Control | Capacitors | C57, C58 | 18pF | 18pF 50V Ceramic Decoupling Capacitor, 0805 | C_0805_2012Metric | SMD | 2 | 10 | 10 | ET Store | ₹1.25 |  | In Stock | Standard SMD MLCC (Murata / Samsung / TDK) | View / Buy on ET Store (https://www.etstore.in/collections/smd-capacitors)
122 | 04 Current Switching | Capacitors | C_DRV1, C_DRV4 | 100 nF | 100 nF 50V Ceramic Decoupling Capacitor, 0805 |  | SMD | 2 | 10 | 10 | ET Store | ₹1.25 |  | In Stock | Standard SMD MLCC (Murata / Samsung / TDK) | View / Buy on ET Store (https://www.etstore.in/collections/smd-capacitors)
123 | 04 Current Switching | Capacitors | C_DRV2, C_DRV3 | 4.7 µF | 4.7 µF Multi-layer Ceramic Capacitor (MLCC), 1206/0805 |  | SMD | 2 | 10 | 10 | ET Store | ₹3.50 |  | In Stock | Standard SMD MLCC (Murata / Samsung / TDK) | View / Buy on ET Store (https://www.etstore.in/collections/smd-capacitors)
124 | 02 Power Supply | PCB Layout | NT1, NT2, NT3 | NetTie_2 | Net Tie Trace Link (Copper feature on PCB) | NetTie-2_SMD_Pad0.5mm | SMD | 3 | N/A | 0 | ET Store | ₹0.00 |  | PCB Track Feature | Direct PCB trace copper polygon | N/A (PCB Feature)
TOTAL ESTIMATED BILL OF MATERIALS (WITH MOQS & HARNESS)

Sheet: ET_Store
16S LiFePO4 BMS - Purchase Order: ET Store
Item # | Subsystem / Sheet | Component / Value | Description | Package | Type | Design Qty | MOQ / Pack | Order Qty | Unit Price (₹) | Order Total (₹) | Direct Product Link
1 | External (Cell Pack Harness) | 10k NTC 3950 (with wire) | 10K Ohm NTC Thermistor Temperature Sensor Probe with 1m wire lead | Probe_Wire_Harness | Harness | 16 | 1 | 16 | ₹14.58 |  | Buy on ET Store (https://www.etstore.in/products/ntc-10k-ohm-with-wire-thermistor-temperature-sensor-et5524)
2 | 04 Current Switching | EL817 | Single Channel Phototransistor Optocoupler, SOP-4 | SOP-4_3.8x4.1mm_P2.54mm | SMD | 5 | 2 | 6 | ₹6.50 |  | Buy on ET Store (https://www.etstore.in/products/pc817-el817-opto-coupler-isolator-module-4-channel-level-shifter-et7518)
3 | 05 Temperature Sensing | CD74HC4067SM | High-Speed 16-Channel Analog Multiplexer / Demultiplexer | SSOP-24_5.3x8.2mm_P0.65mm | SMD | 3 | 1 | 3 | ₹56.87 |  | Buy on ET Store (https://www.etstore.in/products/cd74hc4067-multiplexer-breakout-module-et5969)
4 | 02 Power Supply | LM2596S-3.3 | 3A Step-Down Voltage Regulator (LM2596S-3.3), TO-263-5 | TO-263-5_TabPin3 | SMD | 1 | 1 | 1 | ₹35.00 |  | Buy on ET Store (https://www.etstore.in/products/lm2596s-step-down-voltage-regulator-to-263)
5 | 02 Power Supply | B1212S-1WR3 | 1W 12V-to-12V Isolated DC-DC Converter Module | Converter_DCDC_Murata_MEE1SxxxxSC_THT | THT | 1 | 1 | 1 | ₹103.00 |  | Buy on ET Store (https://www.etstore.in/products/b1212s-1wr3-g-energy-ylptec-isolated-module-dc-dc-converter-eta2637)
6 | 02 Power Supply | LM2596S-5.0 | 3A Step-Down Voltage Regulator (LM2596S-5.0), TO-263-5 | TO-263-5_TabPin3 | SMD | 1 | 1 | 1 | ₹35.00 |  | Buy on ET Store (https://www.etstore.in/products/lm2596s-step-down-voltage-regulator-to-263)
7 | 07 Isolated CAN & Comms | AMS1117-5.0 | 1A Low Dropout Linear Voltage Regulator 5.0V, SOT-223 | SOT-223-3_TabPin2 | SMD | 1 | 1 | 1 | ₹8.00 |  | Buy on ET Store (https://www.etstore.in/products/ams1117-5-0v-sot-223-voltage-regulator)
8 | 03 MCU Control | CH32V203C8T6 | QingKe 32-bit RISC-V MCU, 64KB Flash, 20KB SRAM, LQFP-48 | LQFP-48_7x7mm_P0.5mm | SMD | 1 | 1 | 1 | ₹95.00 |  | Buy on ET Store (https://www.etstore.in/products/ch32v203c8t6-risc-v-microcontroller-lqfp-48)
9 | 06 Balance Status | LTV-847S | Lite-On 4-Channel DC Optocoupler Isolator (Quad) | SMDIP-16_W9.53mm | SMD | 4 | 1 | 4 | ₹60.53 |  | Buy on ET Store (https://www.etstore.in/products/ltv-847-dip-16-lite-on-847-4-channel-opto-coupler-isolators-eta2359)
10 | 04 Current Switching | IRFB4110 | 100V 180A 3.7mR N-Channel Power MOSFET (TO-220 THT) | TO-220-3_Vertical | THT | 17 | 1 | 17 | ₹55.99 |  | Buy on ET Store (https://www.etstore.in/products/irfb4110-to220-ir-mosfet-n-channel-100v-180a-eta1308)
11 | 04 Current Switching | BC817-40,215 | 45V 500mA General Purpose NPN Transistor, SOT-23 | SOT-23_Handsoldering | SMD | 2 | 5 | 5 | ₹3.00 |  | Buy on ET Store (https://www.etstore.in/products/bc817-25-sot-23-npn-transistor)
12 | 01 Cell AFE | BAV21WS | 250V 200mA Fast Switching Diode, SOD-323 | D_SOD-323_HandSoldering | SMD | 2 | 5 | 5 | ₹2.50 |  | Buy on ET Store (https://www.etstore.in/products/bav21ws-sod-323-switching-diode)
13 | 02 Power Supply | B340 | 40V 3A Schottky Barrier Rectifier Diode, SMC | D_SMC | SMD | 1 | 2 | 2 | ₹6.00 |  | Buy on ET Store (https://www.etstore.in/products/ss34-b340-smc-schottky-barrier-diode)
14 | 02 Power Supply | B340 | 40V 3A Schottky Barrier Rectifier Diode, SMC | D_SMC | SMD | 1 | 2 | 2 | ₹6.00 |  | Buy on ET Store (https://www.etstore.in/products/ss34-b340-smc-schottky-barrier-diode)
15 | 02 Power Supply | B5819W | 40V 1A Surface Mount Schottky Barrier Diode, SOD-123 | D_SMA | SMD | 1 | 5 | 5 | ₹3.00 |  | Buy on ET Store (https://www.etstore.in/products/1n5819-b5819w-sod-123-schottky-diode)
16 | 03 MCU Control | GREEN | SMD Green Indicator LED, 0805 | LED_0805_2012Metric | SMD | 1 | 5 | 5 | ₹2.00 |  | Buy on ET Store (https://www.etstore.in/products/smd-0805-green-led)
17 | 08 Precharge Circuit | BZT52C15 | 15V 500mW SMD Zener Diode (Gate Clamp, SOD-123) | D_SOD-123 | SMD | 1 | 5 | 5 | ₹1.77 |  | Buy on ET Store (https://www.etstore.in/products/bzt52c15-wj-sod123-15v-zener-diode-smd)
18 | 02 Power Supply | 2A 80V | 2A 80V Fast-Acting Surface Mount Fuse, 1812 | Fuse_1812_4532Metric | SMD | 1 | 2 | 2 | ₹16.00 |  | Buy on ET Store (https://www.etstore.in/products/1812-smd-fast-blow-fuse)
19 | 02 Power Supply | 3.15A | 3.15A Fast-Acting Surface Mount Fuse, 1812 | Fuse_1812_4532Metric | SMD | 1 | 2 | 2 | ₹16.00 |  | Buy on ET Store (https://www.etstore.in/products/1812-smd-fast-blow-fuse)
20 | 07 Isolated CAN & Comms | 1.0A 1812 PTC | 1.0A 16V Resettable Polymeric PTC Fuse, 1812 | Fuse_1812_4532Metric | SMD | 1 | 2 | 2 | ₹18.00 |  | Buy on ET Store (https://www.etstore.in/products/1812-resettable-ptc-fuse-1a)
21 | 02 Power Supply | FAN1 | 2-Pin 5.08mm Pitch PCB Screw Terminal Block | TerminalBlock_Phoenix_MKDS-1,5-2-5.08_1x02_P5.08mm_Horizontal | THT | 1 | 1 | 1 | ₹12.00 |  | Buy on ET Store (https://www.etstore.in/products/2-pin-5-08mm-pitch-screw-terminal-block)
22 | 02 Power Supply | FAN2 | 2-Pin 5.08mm Pitch PCB Screw Terminal Block | TerminalBlock_Phoenix_MKDS-1,5-2-5.08_1x02_P5.08mm_Horizontal | THT | 1 | 1 | 1 | ₹12.00 |  | Buy on ET Store (https://www.etstore.in/products/2-pin-5-08mm-pitch-screw-terminal-block)
23 | 02 Power Supply | 12V_EXT | 2-Pin 5.08mm Pitch PCB Screw Terminal Block | TerminalBlock_Phoenix_MKDS-1,5-2-5.08_1x02_P5.08mm_Horizontal | THT | 1 | 1 | 1 | ₹12.00 |  | Buy on ET Store (https://www.etstore.in/products/2-pin-5-08mm-pitch-screw-terminal-block)
24 | 07 Isolated CAN & Comms | PACK LINK, NOT ETHERNET | RJ45 8P8C Right-Angle Shielded PCB Modular Jack | RJ45_Amphenol_54602-x08_Horizontal | THT | 1 | 1 | 1 | ₹25.00 |  | Buy on ET Store (https://www.etstore.in/products/rj45-8p8c-horizontal-pcb-female-jack)
25 | 03 MCU Control | WCH-LinkE | 2.54mm Pitch Breakaway Pin Header (WCH-LinkE) | PinHeader_1x05_P2.54mm_Vertical | THT | 1 | 1 | 1 | ₹5.00 |  | Buy on ET Store (https://www.etstore.in/products/40-pin-2-54mm-male-header-strip)
26 | 03 MCU Control | Debug UART | 2.54mm Pitch Breakaway Pin Header (Debug UART) | PinHeader_1x03_P2.54mm_Vertical | THT | 1 | 1 | 1 | ₹5.00 |  | Buy on ET Store (https://www.etstore.in/products/40-pin-2-54mm-male-header-strip)
27 | 03 MCU Control | OLED Display (I2C) | 0.96 inch 128x64 I2C OLED Display Module (SSD1306, 4-Pin) | PinHeader_1x04_P2.54mm_Vertical | THT | 1 | 1 | 1 | ₹171.73 |  | Buy on ET Store (https://www.etstore.in/products/0-96-inch-oled-display-module-i2c-128x64-4-pin-blue-et5049)
28 | Top Level Interconnect | SHUNT KELVIN | 2.54mm Pitch Breakaway Pin Header (SHUNT KELVIN) | PinHeader_1x02_P2.54mm_Vertical | THT | 1 | 1 | 1 | ₹5.00 |  | Buy on ET Store (https://www.etstore.in/products/40-pin-2-54mm-male-header-strip)
29 | 08 Precharge Circuit | AK300-2 | 2-Pin 5.08mm Pitch Precharge Resistor Terminal Block (Chassis Resistor Header) | TerminalBlock_Phoenix_MKDS-1,5-2-5.08_1x02_P5.08mm_Horizontal | THT | 1 | 1 | 1 | ₹12.00 |  | Buy on ET Store (https://www.etstore.in/products/2-pin-5-08mm-pitch-screw-terminal-block)
30 | 02 Power Supply | JP_OPEN | 2-Pin Solder Jumper (JP_OPEN) | SolderJumper-2_P1.3mm_Open_Pad1.0x1.5mm | SMD | 1 | N/A | 0 | ₹0.00 |  | N/A (PCB Feature)
31 | 07 Isolated CAN & Comms | TERMINATION | 2-Pin Solder Jumper (TERMINATION) | SolderJumper-2_P1.3mm_Open_RoundedPad1.0x1.5mm | SMD | 1 | N/A | 0 | ₹0.00 |  | N/A (PCB Feature)
32 | 03 MCU Control | BOOT0 | 2-Pin Solder Jumper (BOOT0) | SolderJumper-2_P1.3mm_Open_RoundedPad1.0x1.5mm | SMD | 1 | N/A | 0 | ₹0.00 |  | N/A (PCB Feature)
33 | 03 MCU Control | ADDR0 | 2-Pin Solder Jumper (ADDR0) | SolderJumper-2_P1.3mm_Open_RoundedPad1.0x1.5mm | SMD | 1 | N/A | 0 | ₹0.00 |  | N/A (PCB Feature)
34 | 03 MCU Control | ADDR1 | 2-Pin Solder Jumper (ADDR1) | SolderJumper-2_P1.3mm_Open_RoundedPad1.0x1.5mm | SMD | 1 | N/A | 0 | ₹0.00 |  | N/A (PCB Feature)
35 | 03 MCU Control | ADDR2 | 2-Pin Solder Jumper (ADDR2) | SolderJumper-2_P1.3mm_Open_RoundedPad1.0x1.5mm | SMD | 1 | N/A | 0 | ₹0.00 |  | N/A (PCB Feature)
36 | 03 MCU Control | EE_WP | 2-Pin Solder Jumper (EE_WP) | SolderJumper-2_P1.3mm_Open_RoundedPad1.0x1.5mm | SMD | 1 | N/A | 0 | ₹0.00 |  | N/A (PCB Feature)
37 | 03 MCU Control | 120R/1.5A | 120 Ohm @ 100MHz 1.5A Ferrite Bead, 0805 | L_0805_2012Metric | SMD | 1 | 5 | 5 | ₹3.50 |  | Buy on ET Store (https://www.etstore.in/products/0805-smd-ferrite-bead-120-ohm)
38 | 02 Power Supply | 68 uH | 68 uH High-Current Shielded Power Inductor (SRR1260) | L_Bourns_SRR1260 | SMD | 1 | 1 | 1 | ₹28.00 |  | Buy on ET Store (https://www.etstore.in/products/33uh-smd-power-inductor-srr1260)
39 | 02 Power Supply | 33 uH | 33 uH High-Current Shielded Power Inductor (SRR1260) | L_Bourns_SRR1260 | SMD | 2 | 1 | 2 | ₹28.00 |  | Buy on ET Store (https://www.etstore.in/products/33uh-smd-power-inductor-srr1260)
40 | 03 MCU Control | 8MHz | 8.000 MHz Fundamental SMD Crystal Resonator (3225-4P) | Crystal_SMD_3225-4Pin_3.2x2.5mm | SMD | 1 | 1 | 1 | ₹15.00 |  | Buy on ET Store (https://www.etstore.in/products/8mhz-smd-crystal-oscillator-3225)
41 | 01 Cell AFE | 20 Ω | SMD Chip Resistor 20 Ω, 1% tolerance | R_1206_3216Metric_Pad1.30x1.75mm_HandSolder | SMD | 17 | 10 | 20 | ₹0.75 |  | Buy on ET Store (https://www.etstore.in/collections/1206-smd-package-resistors)
42 | 01 Cell AFE | 100 Ω | SMD Chip Resistor 100 Ω, 1% tolerance | R_1206_3216Metric_Pad1.30x1.75mm_HandSolder | SMD | 3 | 10 | 10 | ₹0.75 |  | Buy on ET Store (https://www.etstore.in/collections/1206-smd-package-resistors)
43 | 01 Cell AFE | 10 kΩ | SMD Chip Resistor 10 kΩ, 1% tolerance | R_1206_3216Metric_Pad1.30x1.75mm_HandSolder | SMD | 22 | 10 | 30 | ₹0.75 |  | Buy on ET Store (https://www.etstore.in/collections/1206-smd-package-resistors)
44 | 04 Current Switching | 27 Ω | SMD Chip Resistor 27 Ω, 1% tolerance | R_1206_3216Metric_Pad1.30x1.75mm_HandSolder | SMD | 16 | 10 | 20 | ₹0.75 |  | Buy on ET Store (https://www.etstore.in/collections/1206-smd-package-resistors)
45 | 04 Current Switching | 2.2 kΩ | SMD Chip Resistor 2.2 kΩ, 1% tolerance | R_1206_3216Metric_Pad1.30x1.75mm_HandSolder | SMD | 2 | 10 | 10 | ₹0.75 |  | Buy on ET Store (https://www.etstore.in/collections/1206-smd-package-resistors)
46 | 05 Temperature Sensing (NTC Dividers) | 10 kΩ | SMD Chip Resistor 10 kΩ, 1% tolerance | R_0805_2012Metric_Pad1.20x1.40mm_HandSolder | SMD | 32 | 10 | 40 | ₹0.75 |  | Buy on ET Store (https://www.etstore.in/collections/0805-smd-resistors-r0805)
47 | 04 Current Switching | 100 kΩ | SMD Chip Resistor 100 kΩ, 1% tolerance | R_1206_3216Metric_Pad1.30x1.75mm_HandSolder | SMD | 2 | 10 | 10 | ₹0.75 |  | Buy on ET Store (https://www.etstore.in/collections/1206-smd-package-resistors)
48 | 04 Current Switching | 330 Ω | SMD Chip Resistor 330 Ω, 1% tolerance | R_1206_3216Metric_Pad1.30x1.75mm_HandSolder | SMD | 4 | 10 | 10 | ₹0.75 |  | Buy on ET Store (https://www.etstore.in/collections/1206-smd-package-resistors)
49 | 01 Cell AFE | 300 Ω | SMD Chip Resistor 300 Ω, 1% tolerance | R_1206_3216Metric_Pad1.30x1.75mm_HandSolder | SMD | 1 | 10 | 10 | ₹0.75 |  | Buy on ET Store (https://www.etstore.in/collections/1206-smd-package-resistors)
50 | 01 Cell AFE | 10 MΩ | SMD Chip Resistor 10 MΩ, 1% tolerance | R_1206_3216Metric_Pad1.30x1.75mm_HandSolder | SMD | 1 | 10 | 10 | ₹0.75 |  | Buy on ET Store (https://www.etstore.in/collections/1206-smd-package-resistors)
51 | 08 Precharge Circuit | 220 | SMD Chip Resistor 220, 1% tolerance | R_1206_3216Metric | SMD | 1 | 10 | 10 | ₹0.75 |  | Buy on ET Store (https://www.etstore.in/collections/1206-smd-package-resistors)
52 | 08 Precharge Circuit | 100k | SMD Chip Resistor 100k, 1% tolerance | R_1206_3216Metric | SMD | 1 | 10 | 10 | ₹0.75 |  | Buy on ET Store (https://www.etstore.in/collections/1206-smd-package-resistors)
53 | 08 Precharge Circuit | 100 | SMD Chip Resistor 100, 1% tolerance | R_1206_3216Metric | SMD | 1 | 10 | 10 | ₹0.75 |  | Buy on ET Store (https://www.etstore.in/collections/1206-smd-package-resistors)
54 | 08 Precharge Circuit | 10k | SMD Chip Resistor 10k, 1% tolerance | R_1206_3216Metric | SMD | 1 | 10 | 10 | ₹0.75 |  | Buy on ET Store (https://www.etstore.in/collections/1206-smd-package-resistors)
55 | 08 Precharge Circuit | 84.5k 1% | SMD Chip Resistor 84.5k 1%, 1% tolerance | R_1206_3216Metric | SMD | 2 | 10 | 10 | ₹0.75 |  | Buy on ET Store (https://www.etstore.in/collections/1206-smd-package-resistors)
56 | 08 Precharge Circuit | 10k 1% | SMD Chip Resistor 10k 1%, 1% tolerance | R_1206_3216Metric | SMD | 1 | 10 | 10 | ₹0.75 |  | Buy on ET Store (https://www.etstore.in/collections/1206-smd-package-resistors)
57 | 08 Precharge Circuit | 1k | SMD Chip Resistor 1k, 1% tolerance | R_0805_2012Metric | SMD | 1 | 10 | 10 | ₹0.75 |  | Buy on ET Store (https://www.etstore.in/collections/0805-smd-resistors-r0805)
58 | 02 Power Supply | 1M | SMD Chip Resistor 1M, 1% tolerance | R_1206_3216Metric | SMD | 1 | 10 | 10 | ₹0.75 |  | Buy on ET Store (https://www.etstore.in/collections/1206-smd-package-resistors)
59 | 02 Power Supply | 51k | SMD Chip Resistor 51k, 1% tolerance | R_0805_2012Metric | SMD | 1 | 10 | 10 | ₹0.75 |  | Buy on ET Store (https://www.etstore.in/collections/0805-smd-resistors-r0805)
60 | 02 Power Supply | 100k | SMD Chip Resistor 100k, 1% tolerance | R_0805_2012Metric | SMD | 4 | 10 | 10 | ₹0.75 |  | Buy on ET Store (https://www.etstore.in/collections/0805-smd-resistors-r0805)
61 | 02 Power Supply | 270k | SMD Chip Resistor 270k, 1% tolerance | R_0805_2012Metric | SMD | 1 | 10 | 10 | ₹0.75 |  | Buy on ET Store (https://www.etstore.in/collections/0805-smd-resistors-r0805)
62 | 02 Power Supply | 30k | SMD Chip Resistor 30k, 1% tolerance | R_0805_2012Metric | SMD | 1 | 10 | 10 | ₹0.75 |  | Buy on ET Store (https://www.etstore.in/collections/0805-smd-resistors-r0805)
63 | 02 Power Supply | 470k | SMD Chip Resistor 470k, 1% tolerance | R_0805_2012Metric | SMD | 1 | 10 | 10 | ₹0.75 |  | Buy on ET Store (https://www.etstore.in/collections/0805-smd-resistors-r0805)
64 | 07 Isolated CAN & Comms | 10k | SMD Chip Resistor 10k, 1% tolerance | R_0805_2012Metric | SMD | 3 | 10 | 10 | ₹0.75 |  | Buy on ET Store (https://www.etstore.in/collections/0805-smd-resistors-r0805)
65 | 07 Isolated CAN & Comms | 2k | SMD Chip Resistor 2k, 1% tolerance | R_0805_2012Metric | SMD | 1 | 10 | 10 | ₹0.75 |  | Buy on ET Store (https://www.etstore.in/collections/0805-smd-resistors-r0805)
66 | 07 Isolated CAN & Comms | 120 | SMD Chip Resistor 120, 1% tolerance | R_1206_3216Metric | SMD | 1 | 10 | 10 | ₹0.75 |  | Buy on ET Store (https://www.etstore.in/collections/1206-smd-package-resistors)
67 | 03 MCU Control | 1k | SMD Chip Resistor 1k, 1% tolerance | R_0805_2012Metric | SMD | 1 | 10 | 10 | ₹0.75 |  | Buy on ET Store (https://www.etstore.in/collections/0805-smd-resistors-r0805)
68 | 03 MCU Control | 4.7k | SMD Chip Resistor 4.7k, 1% tolerance | R_0805_2012Metric | SMD | 2 | 10 | 10 | ₹0.75 |  | Buy on ET Store (https://www.etstore.in/collections/0805-smd-resistors-r0805)
69 | 06 Balance Status | 47k | SMD Chip Resistor 47k, 1% tolerance | R_0805_2012Metric | SMD | 1 | 10 | 10 | ₹0.75 |  | Buy on ET Store (https://www.etstore.in/collections/0805-smd-resistors-r0805)
70 | 01 Cell AFE | 220 nF | 220 nF 50V Ceramic Decoupling Capacitor, 0805 | C_1206_3216Metric_Pad1.33x1.80mm_HandSolder | SMD | 17 | 10 | 20 | ₹1.25 |  | Buy on ET Store (https://www.etstore.in/collections/smd-capacitors)
71 | 01 Cell AFE | 1 µF | 1 µF 50V Ceramic Decoupling Capacitor, 0805 | C_1812_4532Metric_Pad1.57x3.40mm_HandSolder | SMD | 2 | 10 | 10 | ₹1.25 |  | Buy on ET Store (https://www.etstore.in/collections/smd-capacitors)
72 | 01 Cell AFE | 100 pF | 100 pF 50V Ceramic Decoupling Capacitor, 0805 | C_0805_2012Metric_Pad1.18x1.45mm_HandSolder | SMD | 1 | 10 | 10 | ₹1.25 |  | Buy on ET Store (https://www.etstore.in/collections/smd-capacitors)
73 | 01 Cell AFE | 2.2 µF | 2.2 µF 50V Ceramic Decoupling Capacitor, 0805 | C_0805_2012Metric_Pad1.18x1.45mm_HandSolder | SMD | 1 | 10 | 10 | ₹1.25 |  | Buy on ET Store (https://www.etstore.in/collections/smd-capacitors)
74 | 01 Cell AFE | 100 nF | 100 nF 50V Ceramic Decoupling Capacitor, 0805 | C_0805_2012Metric_Pad1.18x1.45mm_HandSolder | SMD | 1 | 10 | 10 | ₹1.25 |  | Buy on ET Store (https://www.etstore.in/collections/smd-capacitors)
75 | 01 Cell AFE | 22 nF | 22 nF 50V Ceramic Decoupling Capacitor, 0805 | C_0805_2012Metric_Pad1.18x1.45mm_HandSolder | SMD | 1 | 10 | 10 | ₹1.25 |  | Buy on ET Store (https://www.etstore.in/collections/smd-capacitors)
76 | 01 Cell AFE | 1 µF | 1 µF 50V Ceramic Decoupling Capacitor, 0805 | C_0805_2012Metric_Pad1.18x1.45mm_HandSolder | SMD | 1 | 10 | 10 | ₹1.25 |  | Buy on ET Store (https://www.etstore.in/collections/smd-capacitors)
77 | 05 Temperature Sensing | 100 nF | 100 nF 50V Ceramic Decoupling Capacitor, 0805 | C_1206_3216Metric_Pad1.33x1.80mm_HandSolder | SMD | 2 | 10 | 10 | ₹1.25 |  | Buy on ET Store (https://www.etstore.in/collections/smd-capacitors)
78 | 02 Power Supply | 4.7uF 100V | 4.7uF 100V Multi-layer Ceramic Capacitor (MLCC), 1206/0805 | C_1210_3225Metric | SMD | 1 | 10 | 10 | ₹3.50 |  | Buy on ET Store (https://www.etstore.in/collections/smd-capacitors)
79 | 02 Power Supply | 100nF 100V | 100nF 100V 100V High-Voltage Ceramic Capacitor | C_0805_2012Metric | SMD | 1 | 5 | 5 | ₹4.50 |  | Buy on ET Store (https://www.etstore.in/collections/smd-capacitors)
80 | 02 Power Supply | 2.2nF 50V | 2.2nF 50V 50V Ceramic Decoupling Capacitor, 0805 | C_0805_2012Metric | SMD | 1 | 10 | 10 | ₹1.25 |  | Buy on ET Store (https://www.etstore.in/collections/smd-capacitors)
81 | 02 Power Supply | 3.3nF | 3.3nF 50V Ceramic Decoupling Capacitor, 0805 | C_0805_2012Metric | SMD | 1 | 10 | 10 | ₹1.25 |  | Buy on ET Store (https://www.etstore.in/collections/smd-capacitors)
82 | 02 Power Supply | 56pF | 56pF 50V Ceramic Decoupling Capacitor, 0805 | C_0805_2012Metric | SMD | 1 | 10 | 10 | ₹1.25 |  | Buy on ET Store (https://www.etstore.in/collections/smd-capacitors)
83 | 02 Power Supply | 22uF 25V | 22uF 25V Multi-layer Ceramic Capacitor (MLCC), 1206/0805 | C_1206_3216Metric | SMD | 1 | 10 | 10 | ₹3.50 |  | Buy on ET Store (https://www.etstore.in/collections/smd-capacitors)
84 | 02 Power Supply | 100nF 25V | 100nF 25V 50V Ceramic Decoupling Capacitor, 0805 | C_0805_2012Metric | SMD | 2 | 10 | 10 | ₹1.25 |  | Buy on ET Store (https://www.etstore.in/collections/smd-capacitors)
85 | 02 Power Supply | 470uF 25V | 470uF 25V Radial Aluminum Electrolytic Capacitor (Low-ESR) | CP_Elec_8x10 | THT | 1 | 2 | 2 | ₹8.50 |  | Buy on ET Store (https://www.etstore.in/products/470uf-25v-radial-electrolytic-capacitor)
86 | 02 Power Supply | 220uF 10V | 220uF 10V Radial Aluminum Electrolytic Capacitor (Low-ESR) | CP_Elec_8x10 | THT | 1 | 2 | 2 | ₹8.50 |  | Buy on ET Store (https://www.etstore.in/products/470uf-25v-radial-electrolytic-capacitor)
87 | 02 Power Supply | 100nF 10V | 100nF 10V 50V Ceramic Decoupling Capacitor, 0805 | C_0805_2012Metric | SMD | 1 | 10 | 10 | ₹1.25 |  | Buy on ET Store (https://www.etstore.in/collections/smd-capacitors)
88 | 02 Power Supply | 4.7uF 25V | 4.7uF 25V Multi-layer Ceramic Capacitor (MLCC), 1206/0805 | C_0805_2012Metric | SMD | 2 | 10 | 10 | ₹3.50 |  | Buy on ET Store (https://www.etstore.in/collections/smd-capacitors)
89 | 02 Power Supply | 22uF 25V | 22uF 25V Multi-layer Ceramic Capacitor (MLCC), 1206/0805 | C_1206_3216Metric | SMD | 1 | 10 | 10 | ₹3.50 |  | Buy on ET Store (https://www.etstore.in/collections/smd-capacitors)
90 | 07 Isolated CAN & Comms | 100nF | 100nF 50V Ceramic Decoupling Capacitor, 0805 | C_0805_2012Metric | SMD | 2 | 10 | 10 | ₹1.25 |  | Buy on ET Store (https://www.etstore.in/collections/smd-capacitors)
91 | 02 Power Supply | 220uF 10V | 220uF 10V Radial Aluminum Electrolytic Capacitor (Low-ESR) | CP_Elec_8x10 | THT | 1 | 2 | 2 | ₹8.50 |  | Buy on ET Store (https://www.etstore.in/products/470uf-25v-radial-electrolytic-capacitor)
92 | 02 Power Supply | 100nF | 100nF 50V Ceramic Decoupling Capacitor, 0805 | C_0805_2012Metric | SMD | 1 | 10 | 10 | ₹1.25 |  | Buy on ET Store (https://www.etstore.in/collections/smd-capacitors)
93 | 07 Isolated CAN & Comms | 4.7uF 25V | 4.7uF 25V Multi-layer Ceramic Capacitor (MLCC), 1206/0805 | C_0805_2012Metric | SMD | 1 | 10 | 10 | ₹3.50 |  | Buy on ET Store (https://www.etstore.in/collections/smd-capacitors)
94 | 07 Isolated CAN & Comms | 100nF | 100nF 50V Ceramic Decoupling Capacitor, 0805 | C_0805_2012Metric | SMD | 12 | 10 | 20 | ₹1.25 |  | Buy on ET Store (https://www.etstore.in/collections/smd-capacitors)
95 | 07 Isolated CAN & Comms | 10uF 25V | 10uF 25V Multi-layer Ceramic Capacitor (MLCC), 1206/0805 | C_1206_3216Metric | SMD | 1 | 10 | 10 | ₹3.50 |  | Buy on ET Store (https://www.etstore.in/collections/smd-capacitors)
96 | 07 Isolated CAN & Comms | 22uF 10V | 22uF 10V Multi-layer Ceramic Capacitor (MLCC), 1206/0805 | C_1206_3216Metric | SMD | 1 | 10 | 10 | ₹3.50 |  | Buy on ET Store (https://www.etstore.in/collections/smd-capacitors)
97 | 03 MCU Control | 4.7uF | 4.7uF Multi-layer Ceramic Capacitor (MLCC), 1206/0805 | C_0805_2012Metric | SMD | 1 | 10 | 10 | ₹3.50 |  | Buy on ET Store (https://www.etstore.in/collections/smd-capacitors)
98 | 03 MCU Control | 1uF | 1uF 50V Ceramic Decoupling Capacitor, 0805 | C_0805_2012Metric | SMD | 1 | 10 | 10 | ₹1.25 |  | Buy on ET Store (https://www.etstore.in/collections/smd-capacitors)
99 | 03 MCU Control | 10nF | 10nF 50V Ceramic Decoupling Capacitor, 0805 | C_0805_2012Metric | SMD | 1 | 10 | 10 | ₹1.25 |  | Buy on ET Store (https://www.etstore.in/collections/smd-capacitors)
100 | 03 MCU Control | 18pF | 18pF 50V Ceramic Decoupling Capacitor, 0805 | C_0805_2012Metric | SMD | 2 | 10 | 10 | ₹1.25 |  | Buy on ET Store (https://www.etstore.in/collections/smd-capacitors)
101 | 04 Current Switching | 100 nF | 100 nF 50V Ceramic Decoupling Capacitor, 0805 |  | SMD | 2 | 10 | 10 | ₹1.25 |  | Buy on ET Store (https://www.etstore.in/collections/smd-capacitors)
102 | 04 Current Switching | 4.7 µF | 4.7 µF Multi-layer Ceramic Capacitor (MLCC), 1206/0805 |  | SMD | 2 | 10 | 10 | ₹3.50 |  | Buy on ET Store (https://www.etstore.in/collections/smd-capacitors)
103 | 02 Power Supply | NetTie_2 | Net Tie Trace Link (Copper feature on PCB) | NetTie-2_SMD_Pad0.5mm | SMD | 3 | N/A | 0 | ₹0.00 |  | N/A (PCB Feature)
SUBTOTAL - ET Store (WITH MOQ)

Sheet: Robuin
16S LiFePO4 BMS - Purchase Order: Robu.in
Item # | Subsystem / Sheet | Component / Value | Description | Package | Type | Design Qty | MOQ / Pack | Order Qty | Unit Price (₹) | Order Total (₹) | Direct Product Link
1 | External (Chassis / Busbar) | FL-2B 100A 75mV | XIQI Electric CG FL-2B 100A 75mV DC Current Shunt Resistor | Chassis_BoltMount | Chassis/THT | 1 | 1 | 1 | ₹352.00 |  | Buy on Robu.in (https://robu.in/product/xiqi-electric-cg-fl-2b-100a-75mv-dc-current-shunt-resister/)
2 | 04 Current Switching | UCC27517DBVR | 4A High-Speed Low-Side Gate Driver, SOT-23-5 | SOT-23-5 | SMD | 2 | 1 | 2 | ₹35.00 |  | Buy on Robu.in (https://robu.in/product/ucc27517dbvr-texas-instruments/)
3 | 07 Isolated CAN & Comms | B1209S-1WR3 | 1W 12V-to-9V Isolated DC-DC Converter for Gate Drive Rail | Converter_DCDC_Murata_MEE1SxxxxSC_THT | THT | 1 | 1 | 1 | ₹109.00 |  | Buy on Robu.in (https://robu.in/product/k-cut-b1209s-1w-dc-dc-12-to-9v-isolated-step-down-power-module/)
4 | 03 MCU Control | FM24CL64B-G | 64 Kbit (8Kx8) High-Endurance Non-Volatile I2C FRAM | SOIC-8_3.9x4.9mm_P1.27mm | SMD | 1 | 1 | 1 | ₹232.00 |  | Buy on Robu.in (https://robu.in/product/fm24cl64b-gtr-infineon-cypress-64kbit-soic-8-fram/)
5 | 07 Isolated CAN & Comms | PESD2CAN | CAN Bus Dual-line ESD Protection TVS Diode, SOT-23 | SOT-23 | SMD | 1 | 1 | 1 | ₹12.00 |  | Buy on Robu.in (https://robu.in/product/pesd2can215-nexperia/)
SUBTOTAL - Robu.in (WITH MOQ)

Sheet: Evelta
16S LiFePO4 BMS - Purchase Order: Evelta
Item # | Subsystem / Sheet | Component / Value | Description | Package | Type | Design Qty | MOQ / Pack | Order Qty | Unit Price (₹) | Order Total (₹) | Direct Product Link
1 | 02 Power Supply | LM5164DDA | 100V 1A Synchronous Step-Down Buck DC-DC Converter | HSOP-8-1EP_3.9x4.9mm_P1.27mm_EP2.41x3.1mm_ThermalVias | SMD | 1 | 1 | 1 | ₹548.70 |  | Buy on Evelta (https://evelta.com/7semi-dc-dc-buck-converter-7v-100v-input-to-5v-1a-output-lm5164/)
2 | 07 Isolated CAN & Comms | ISO1050DUBR | 5V Isolated CAN Transceiver, SOP-8 | SOP-8_6.62x9.15mm_P2.54mm | SMD | 1 | 1 | 1 | ₹230.10 |  | Buy on Evelta (https://evelta.com/iso1050dubr-5v-isolated-can-transceiver-8-pin-sop/)
3 | 01 Cell AFE | BCX56-135 | 80V 1A Medium Power NPN Transistor, SOT-89-3 | SOT-89-3_Handsoldering | SMD | 1 | 1 | 1 | ₹11.38 |  | Buy on Evelta (https://evelta.com/bcx56-cj-npn-bipolar-transistor-bjt-80v-1a-sot-89/)
4 | 02 Power Supply | SMBJ60CA | 60V 600W Bidirectional TVS Diode, SMB | D_SMB | SMD | 1 | 1 | 1 | ₹15.00 |  | Buy on Evelta (https://evelta.com/smbj60ca-60v-bidirectional-tvs-diode-smb-surface-mount/)
5 | 07 Isolated CAN & Comms | SMAJ6.0A | 6.0V 400W Fast Unidirectional TVS Diode, SMA | D_SMA | SMD | 1 | 1 | 1 | ₹4.15 |  | Buy on Evelta (https://evelta.com/smaj6-0a-6v-400w-esd-suppressor-tvs-diode/)
6 | 08 Precharge Circuit | SMAJ75A | 75V 400W Fast Unidirectional TVS Diode (Precharge Inductive Clamp, SMA) | D_SMA | SMD | 1 | 1 | 1 | ₹3.30 |  | Buy on Evelta (https://evelta.com/smaj75a-75v-400w-esd-suppressor-tvs-diode/)
7 | 08 Precharge Circuit | BAT54S | Dual Schottky Barrier Diode Series Pair (Precharge Sense ADC Rail Clamp, SOT-23) | SOT-23 | SMD | 1 | 1 | 1 | ₹2.01 |  | Buy on Evelta (https://evelta.com/bat54s-sot-23-3-schottky-barrier-diode/)
SUBTOTAL - Evelta (WITH MOQ)

Sheet: LionCircuits
16S LiFePO4 BMS - Purchase Order: LionCircuits
Item # | Subsystem / Sheet | Component / Value | Description | Package | Type | Design Qty | MOQ / Pack | Order Qty | Unit Price (₹) | Order Total (₹) | Direct Product Link
1 | 01 Cell AFE | BQ76952PFBR | 16S LiFePO4 Battery Monitor, Protector & Balancer IC | QFP50P900X900X120-48N | SMD | 1 | 1 | 1 | ₹665.29 |  | Buy on LionCircuits (https://www.lioncircuits.com/components/texas-instruments/bq76952pfbr)
SUBTOTAL - LionCircuits (WITH MOQ)

Sheet: Rajiv_Electronics
16S LiFePO4 BMS - Purchase Order: Rajiv Electronics
Item # | Subsystem / Sheet | Component / Value | Description | Package | Type | Design Qty | MOQ / Pack | Order Qty | Unit Price (₹) | Order Total (₹) | Direct Product Link
1 | External (Harness Cable) | DB25 Male Solder Plug + Hood | DB25 Male Solder-Type Connector Plug with Plastic/Metal Protective Shell | Cable_Mount | Cable | 1 | 1 | 1 | ₹35.00 |  | Buy on Rajiv Electronics (https://rajivelectronics.com/product/db25-male-connector/)
2 | External (Harness Cable) | DB50 Male Solder Plug + Hood | DB50 50-Pin D-Sub Male Solder-Type Connector Plug with Protective Dust Cover | Cable_Mount | Cable | 1 | 1 | 1 | ₹95.00 |  | Buy on Rajiv Electronics (https://rajivelectronics.com/product/db50-50-pin-d-sub-male-connector-solder-type/)
3 | 06 Balance Status | DB25_Female | 25-Pin D-Sub Female Right-Angle PCB Connector (NTC Taps) | DSUB-25_Socket_Horizontal_P2.77x2.84mm_EdgePinOffset4.94mm_Housed_MountingHolesOffset4.94mm | THT | 1 | 1 | 1 | ₹26.00 |  | Buy on Rajiv Electronics (https://rajivelectronics.com/product/db25-right-angle-female-connector-25-pin-d-sub-pcb-mount/)
4 | Top Level Interconnect | DD50_Female | 50-Pin D-Sub High-Density Female PCB Connector (Cell Taps) |  | THT | 1 | 1 | 1 | ₹112.10 |  | Buy on Rajiv Electronics (https://rajivelectronics.com/product/db50-pin-d-sub-pcb-mount-straight-female-connector/)
5 | Top Level Interconnect | FROM SHUNT | FROM SHUNT High-Current M5/M6 Direct Bolt-Down PCB Pad Terminal | MountingHole_8.4mm_M8_Pad | THT/Pad | 1 | 5 | 5 | ₹12.00 |  | Buy on Rajiv Electronics (https://rajivelectronics.com/product-category/hardware-fittings/)
6 | Top Level Interconnect | PACK MINUS | PACK MINUS High-Current M5/M6 Direct Bolt-Down PCB Pad Terminal | MountingHole_8.4mm_M8_Pad | THT/Pad | 1 | 5 | 5 | ₹12.00 |  | Buy on Rajiv Electronics (https://rajivelectronics.com/product-category/hardware-fittings/)
7 | Top Level Interconnect | PACK PLUS TAP | PACK PLUS TAP High-Current M5/M6 Direct Bolt-Down PCB Pad Terminal | MountingHole_8.4mm_M8_Pad | THT/Pad | 1 | 5 | 5 | ₹12.00 |  | Buy on Rajiv Electronics (https://rajivelectronics.com/product-category/hardware-fittings/)
SUBTOTAL - Rajiv Electronics (WITH MOQ)

Sheet: Sharvi_Electronics
16S LiFePO4 BMS - Purchase Order: Sharvi Electronics
Item # | Subsystem / Sheet | Component / Value | Description | Package | Type | Design Qty | MOQ / Pack | Order Qty | Unit Price (₹) | Order Total (₹) | Direct Product Link
1 | External (Chassis / Precharge) | 50 Ω 25W | 50 Ohm 25W Aluminum Housed Wirewound Power Resistor (55mm mounting pitch) | Chassis_Mount_55mm_Pitch | Chassis/THT | 1 | 1 | 1 | ₹184.88 |  | Buy on Sharvi Electronics (https://sharvielectronics.com/product/50-ohm-25-watt-aluminum-housed-wirewound-power-resistor/)
SUBTOTAL - Sharvi Electronics (WITH MOQ)
