koko69420/SmartBMS_Active-balancing/16s_BMS/Overall_schematic/16s_BMS.pdf

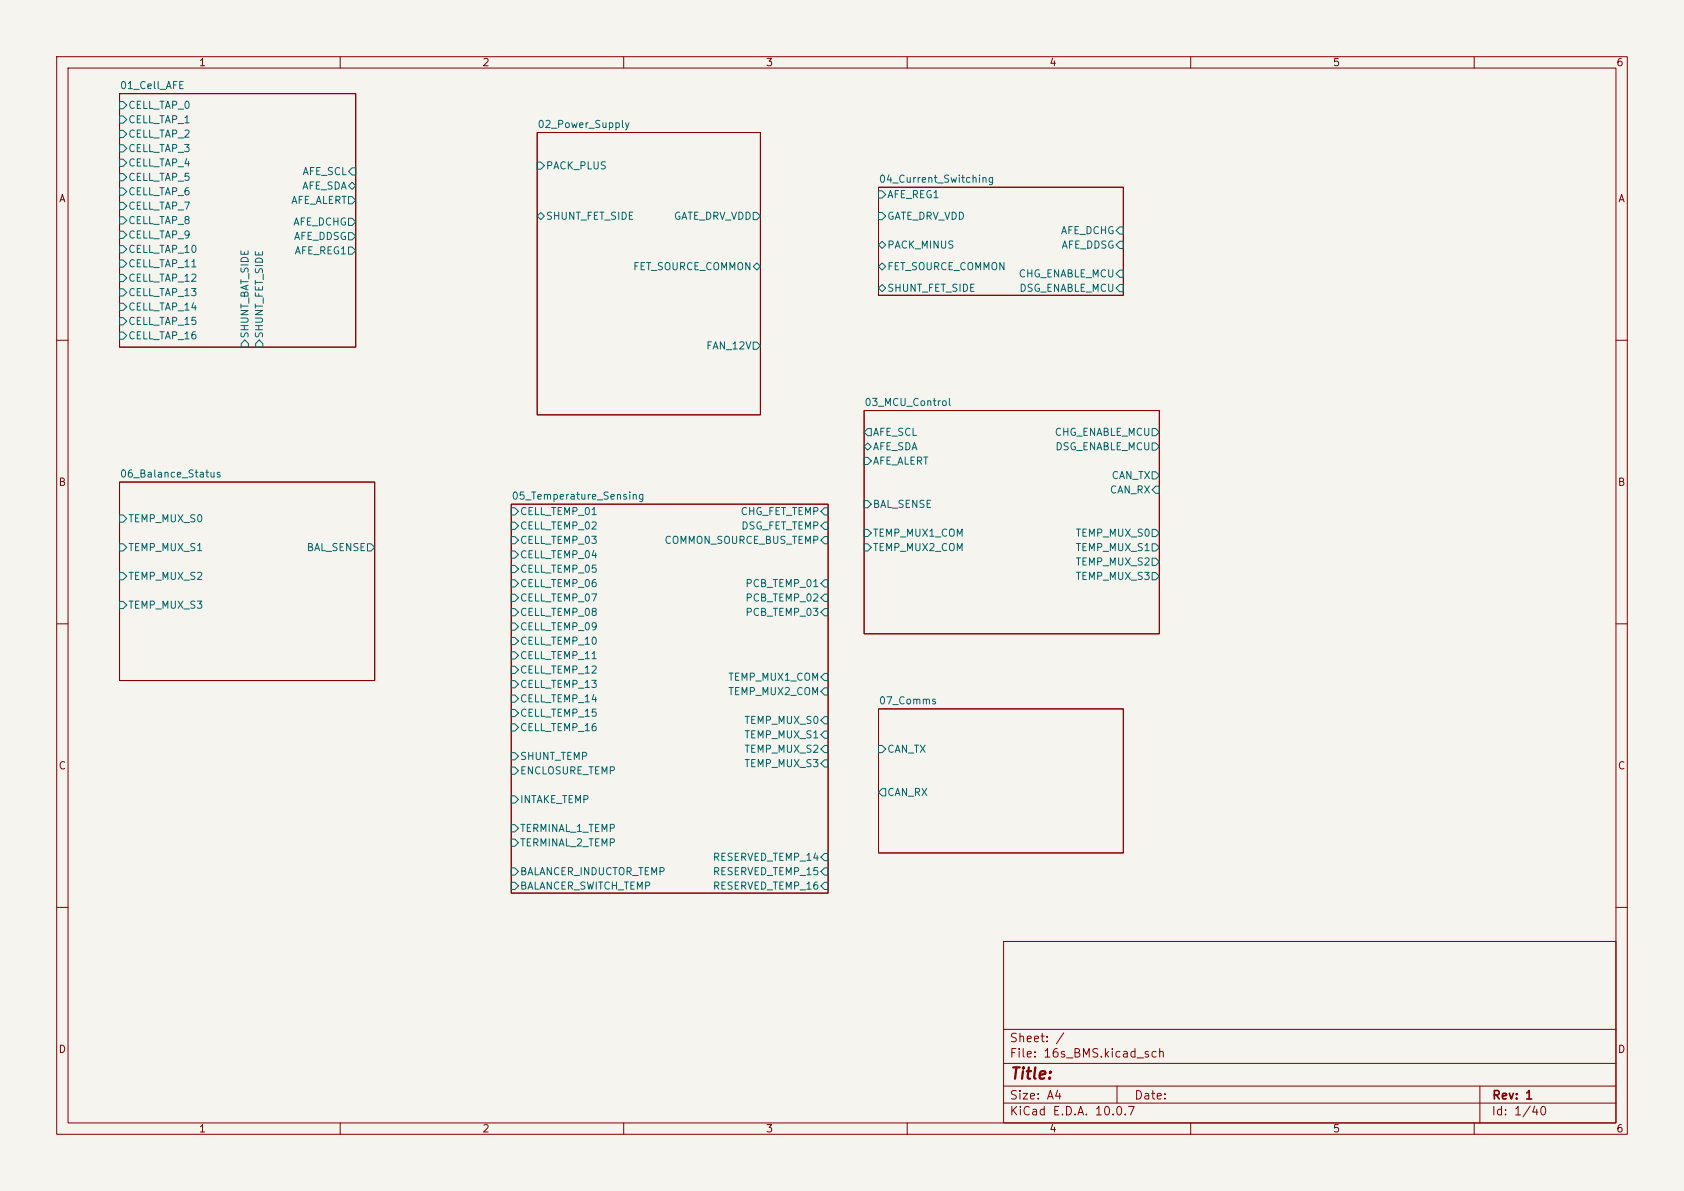
[picture p1: page 1]

Size: A4 | Rev: 1
KiCad E.D.A. 10.0.7 | Id: 1/40

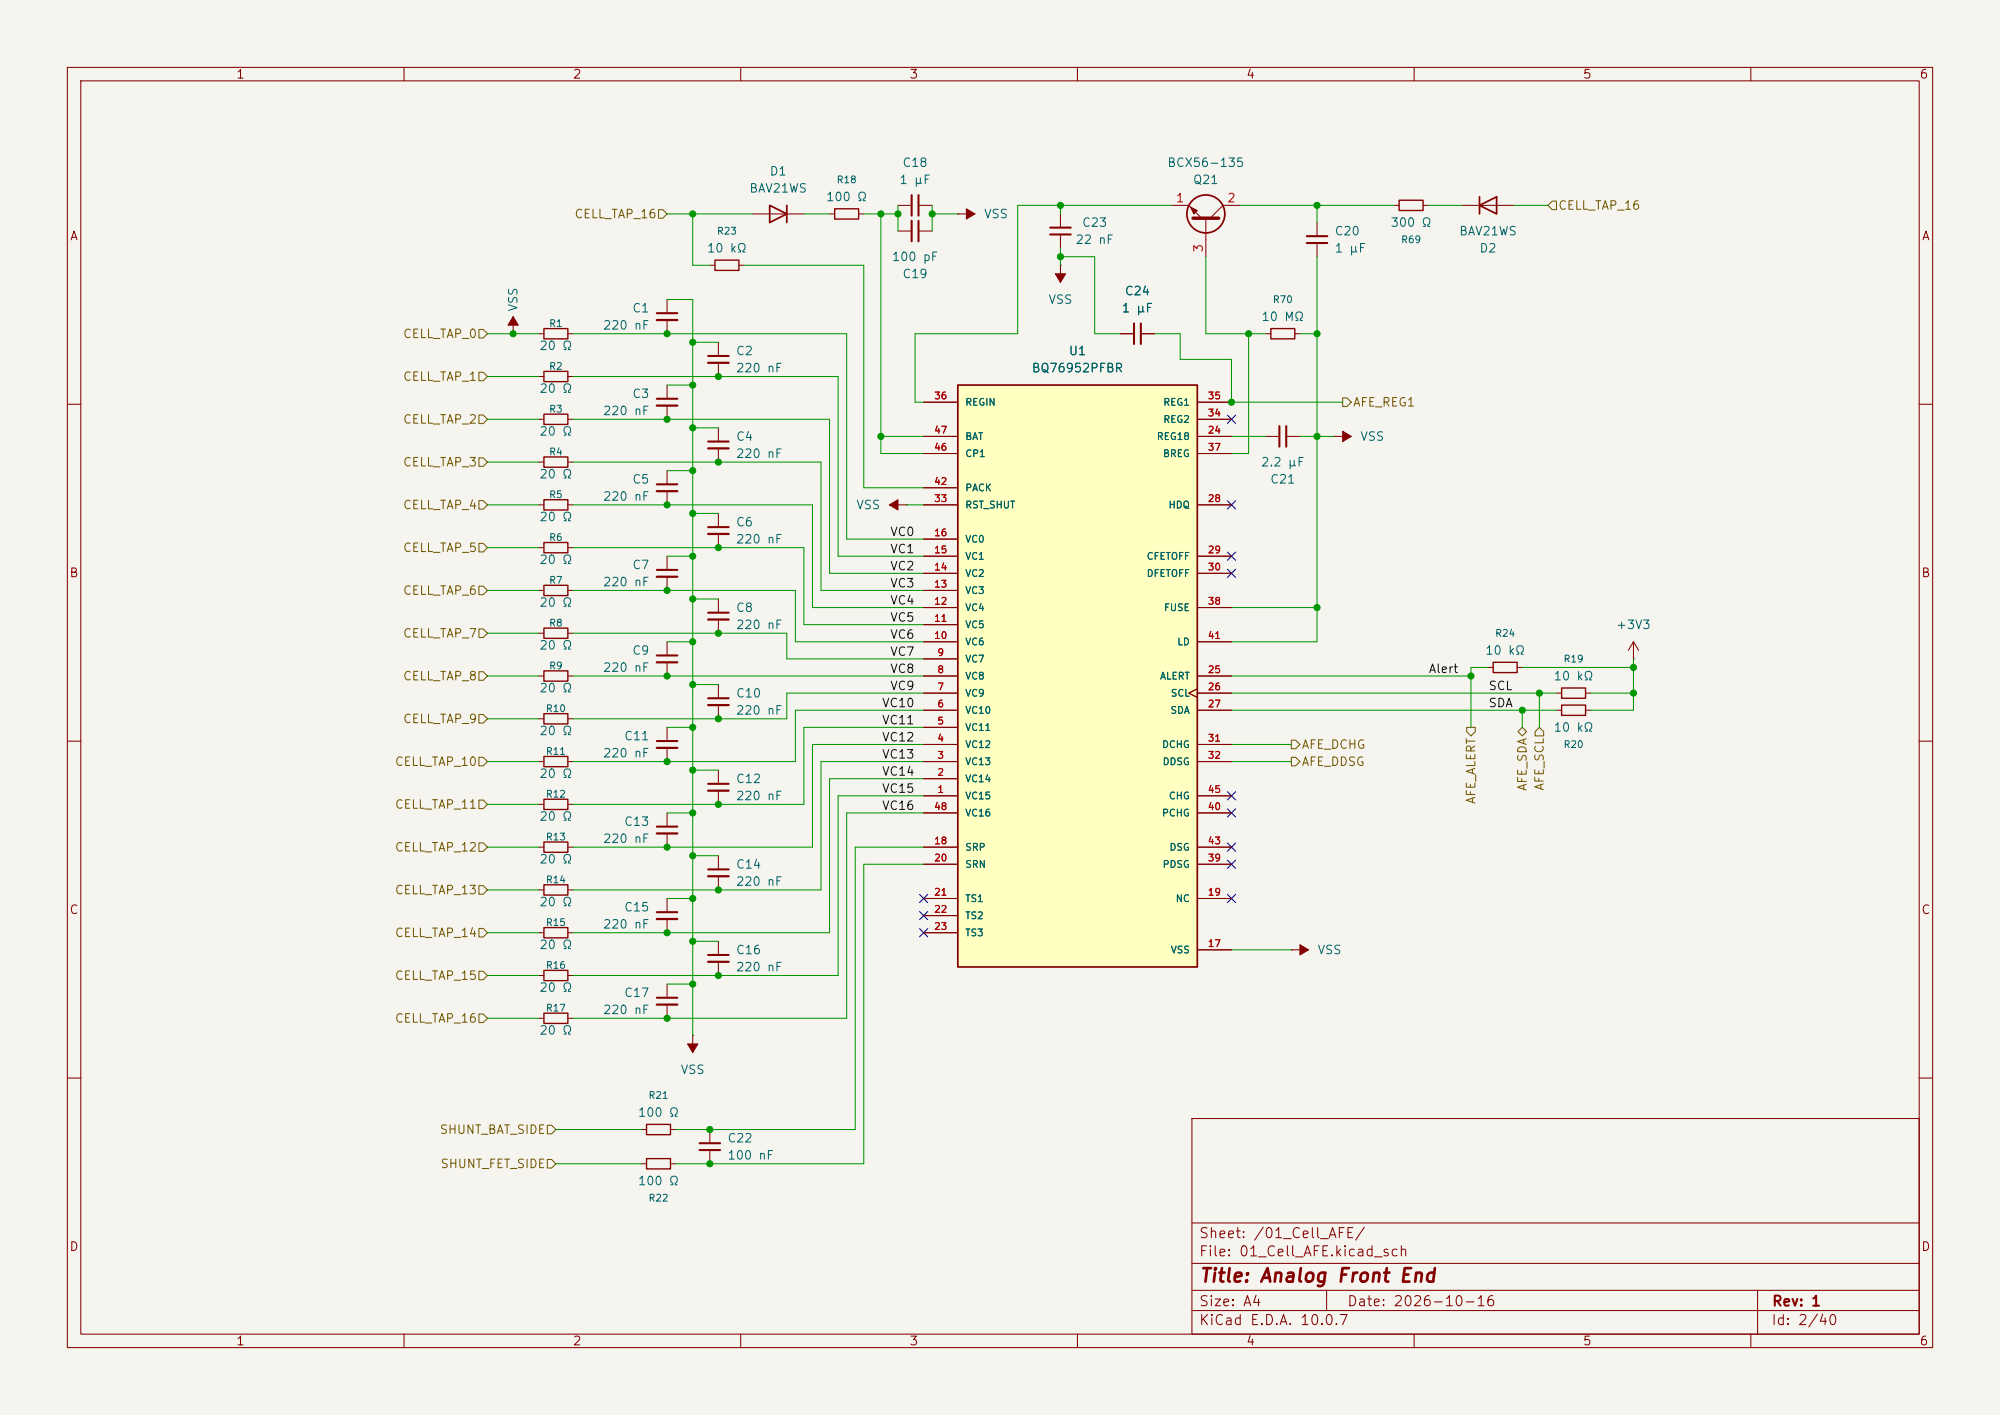
[picture p2: page 2]

Sheet: /01_Cell_AFE/
File: 01_Cell_AFE.kicad_sch
Title: Analog Front End

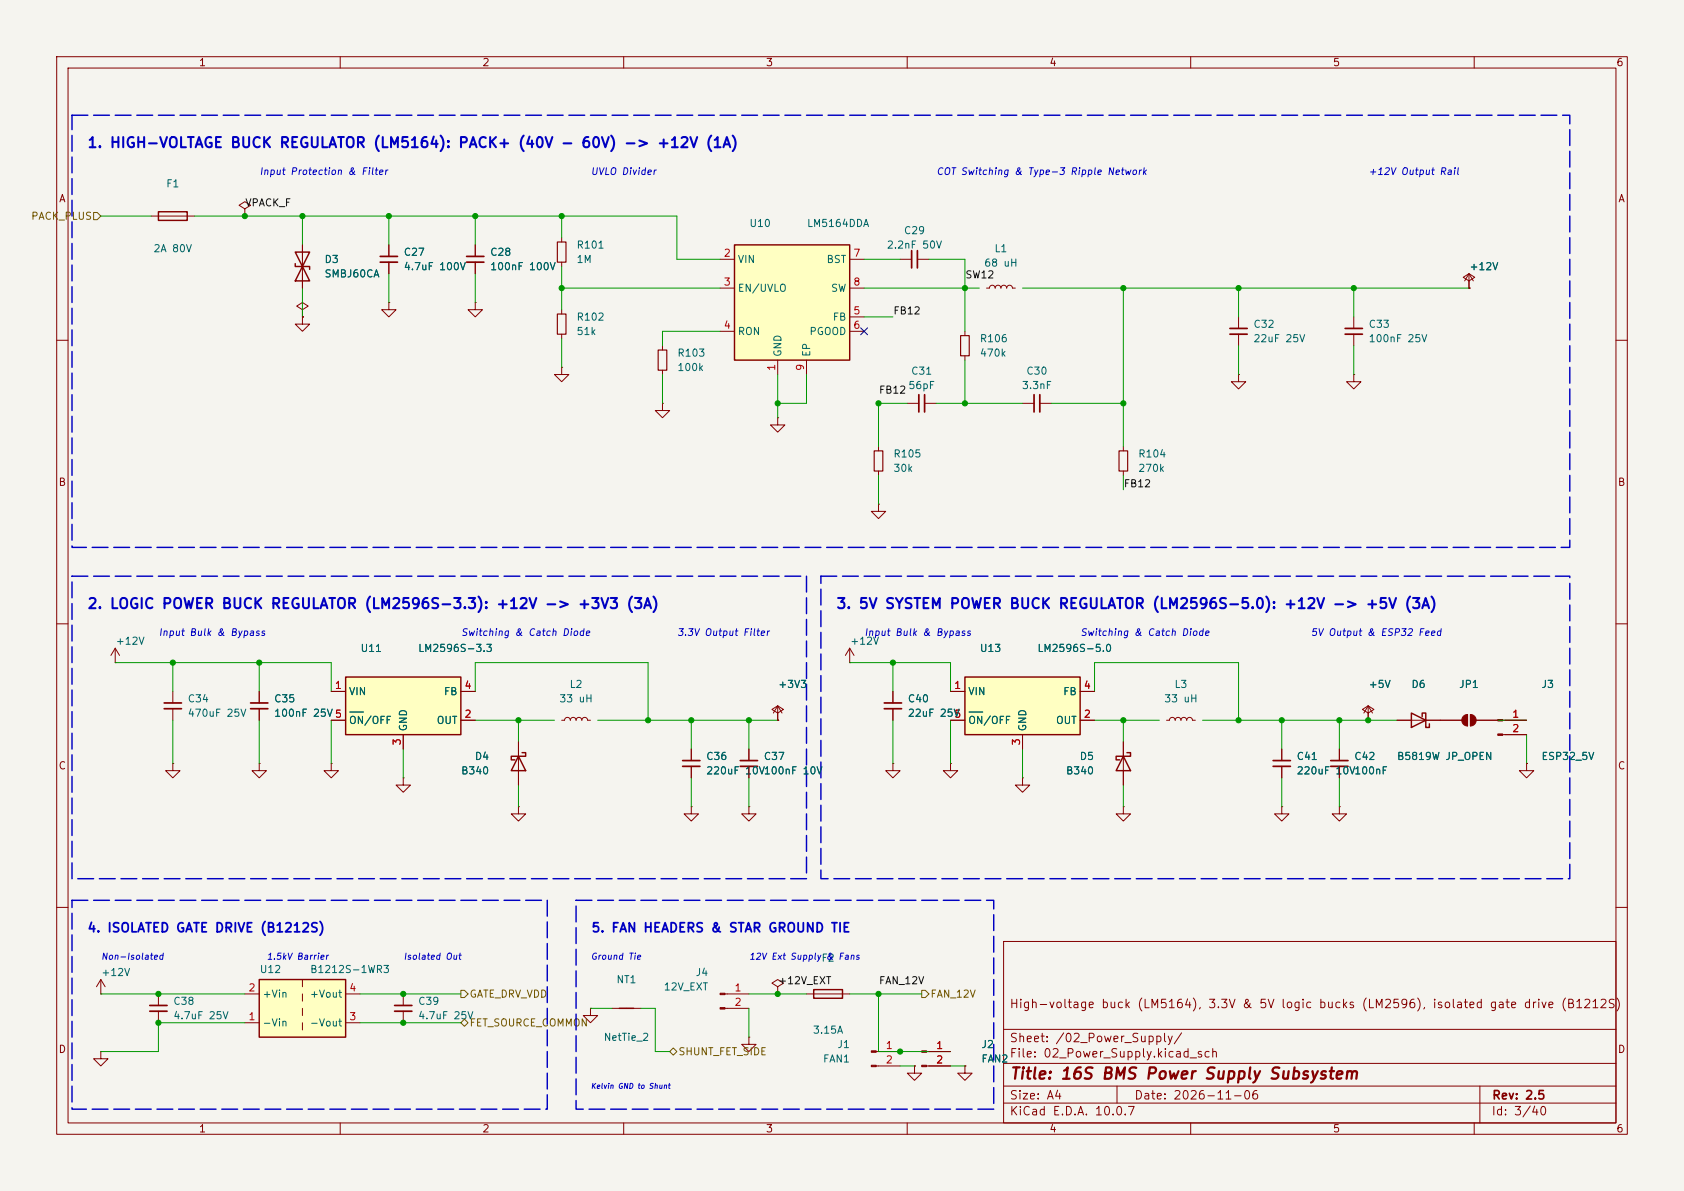
[picture p3: page 3]

Kelvin GND to Shunt 5. FAN HEADERS & STAR GROUND TIE

High-voltage buck (LM5164), 3.3V & 5V logic bucks (LM2596), isolated gate drive (B1212S) 1

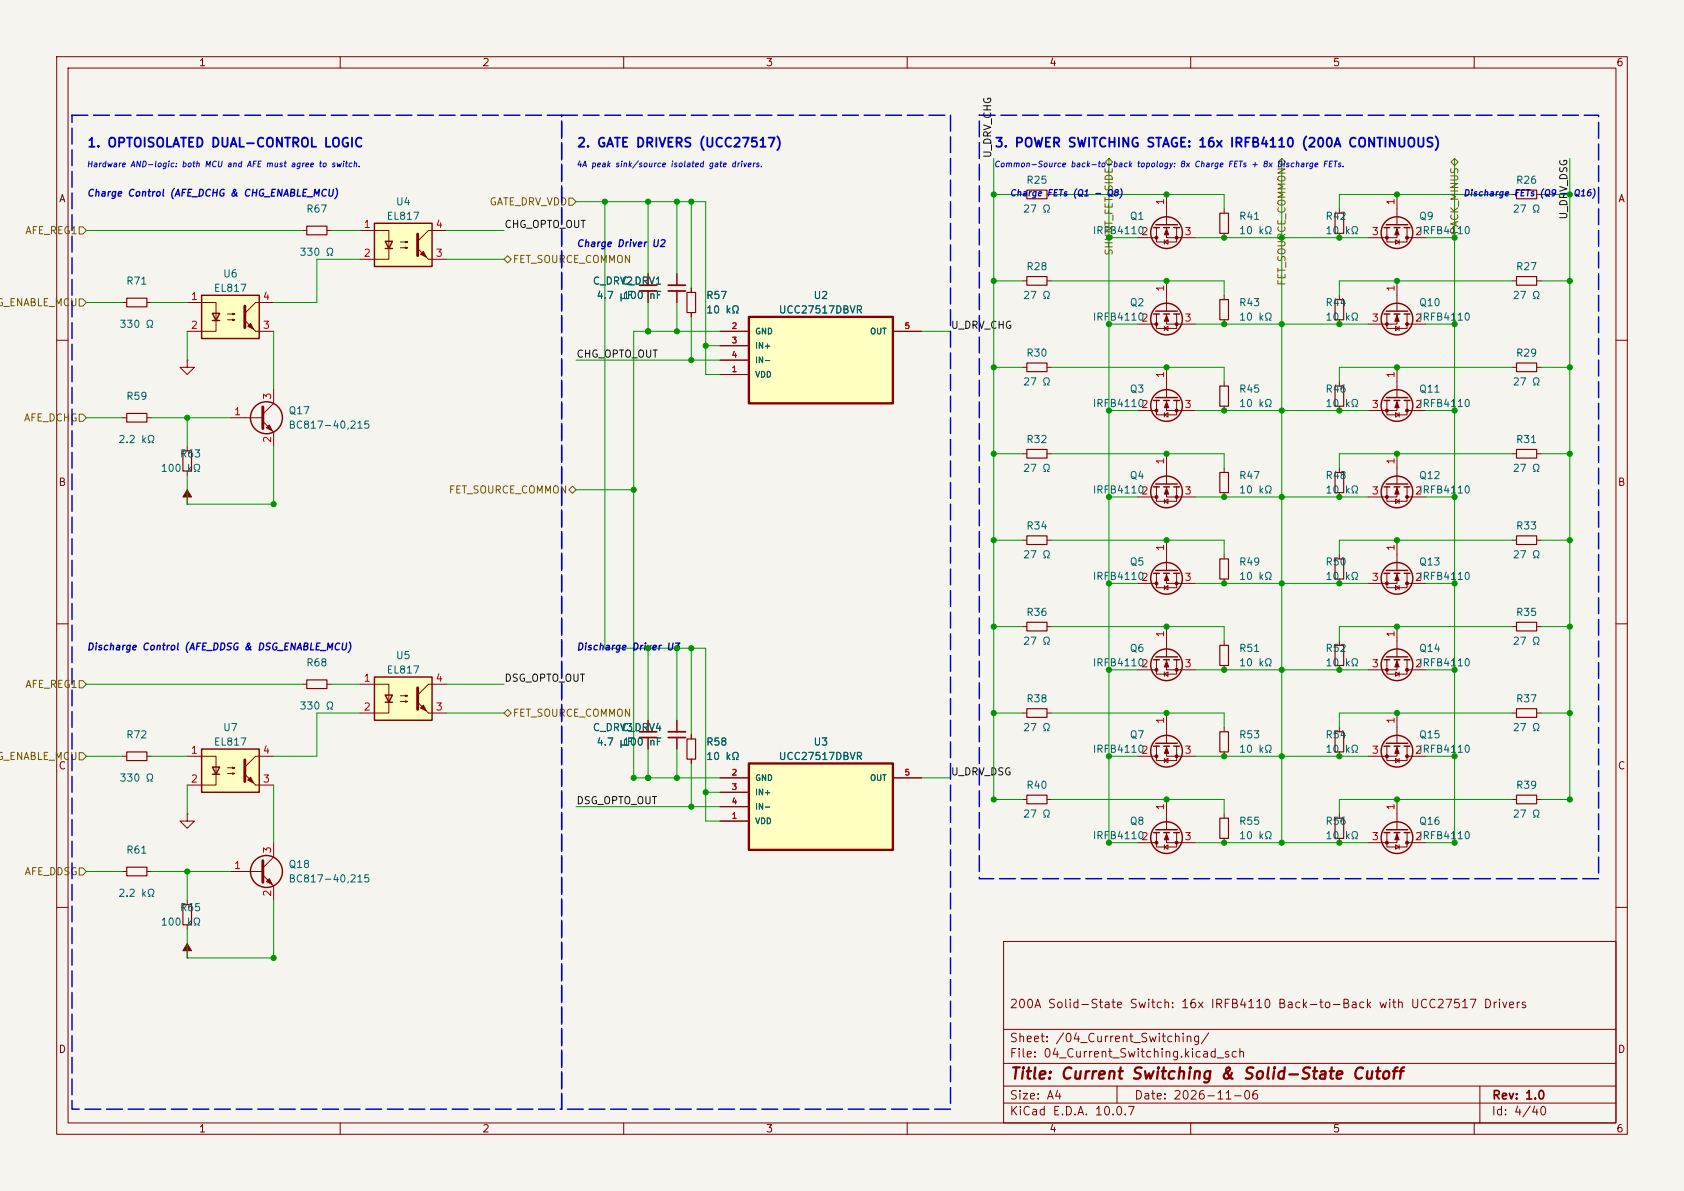
[picture p4: page 4]

1. OPTOISOLATED DUAL-CONTROL LOGIC

Hardware AND-logic: both MCU and AFE must agree to switch. Charge Control (AFE_DCHG & CHG_ENABLE_MCU)

200A Solid-State Switch: 16x IRFB4110 Back-to-Back with UCC27517 Drivers

Sheet: /04_Current_Switching/
File: 04_Current_Switching.kicad_sch
Title: Current Switching & Solid-State Cutoff

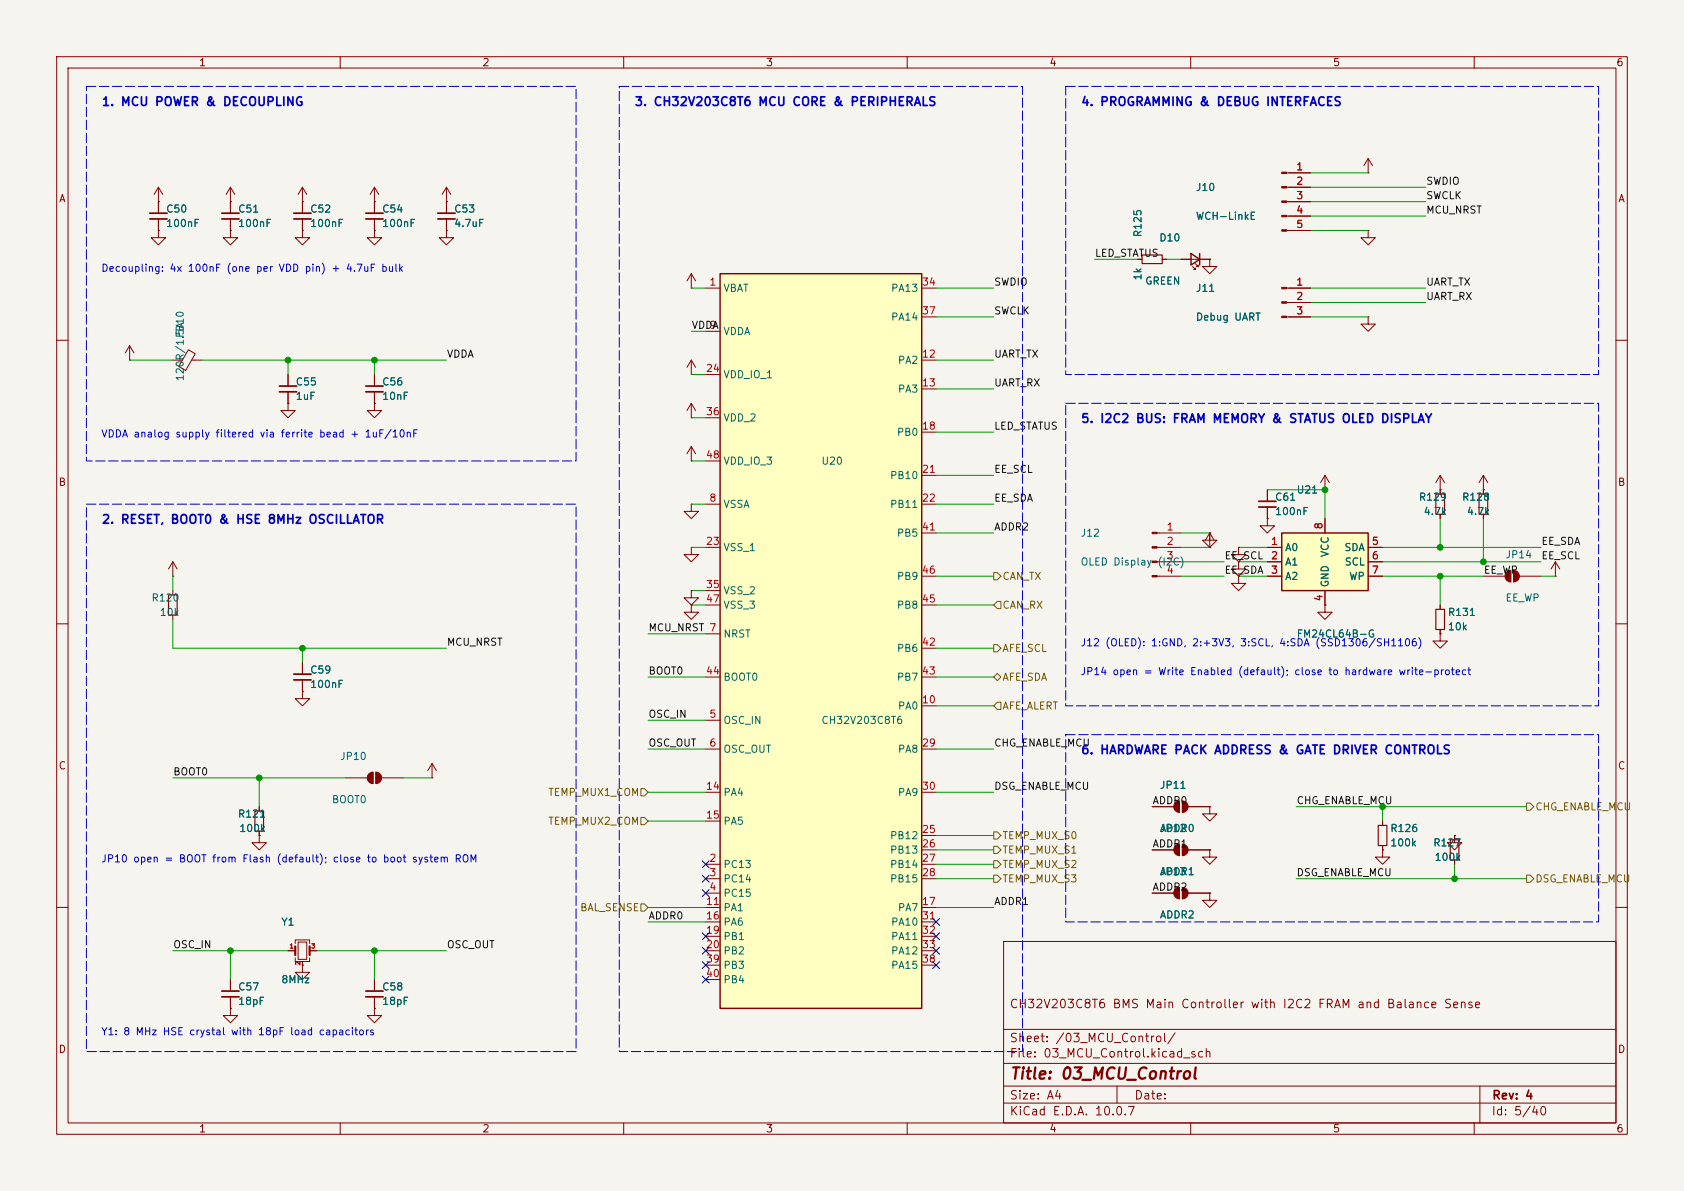
[picture p5: page 5]

J12 (OLED): 1:GND, 2:+3V3, 3:SCL, 4:SDA (SSD1306/SH1106) R125 1k

Decoupling: 4x 100nF (one per VDD pin) + 4.7uF bulk

5. I2C2 BUS: FRAM MEMORY & STATUS OLED DISPLAY

EE_SDA EE_SCL VDDA analog supply filtered via ferrite bead + 1uF/10nF

JP14 open = Write Enabled (default); close to hardware write-protect

6. HARDWARE PACK ADDRESS & GATE DRIVER CONTROLS

JP10 open = BOOT from Flash (default); close to boot system ROM

CH32V203C8T6 BMS Main Controller with I2C2 FRAM and Balance Sense

Y1: 8 MHz HSE crystal with 18pF load capacitors

Sheet: /03_MCU_Control/ File: 03_MCU_Control.kicad_sch | D Date:

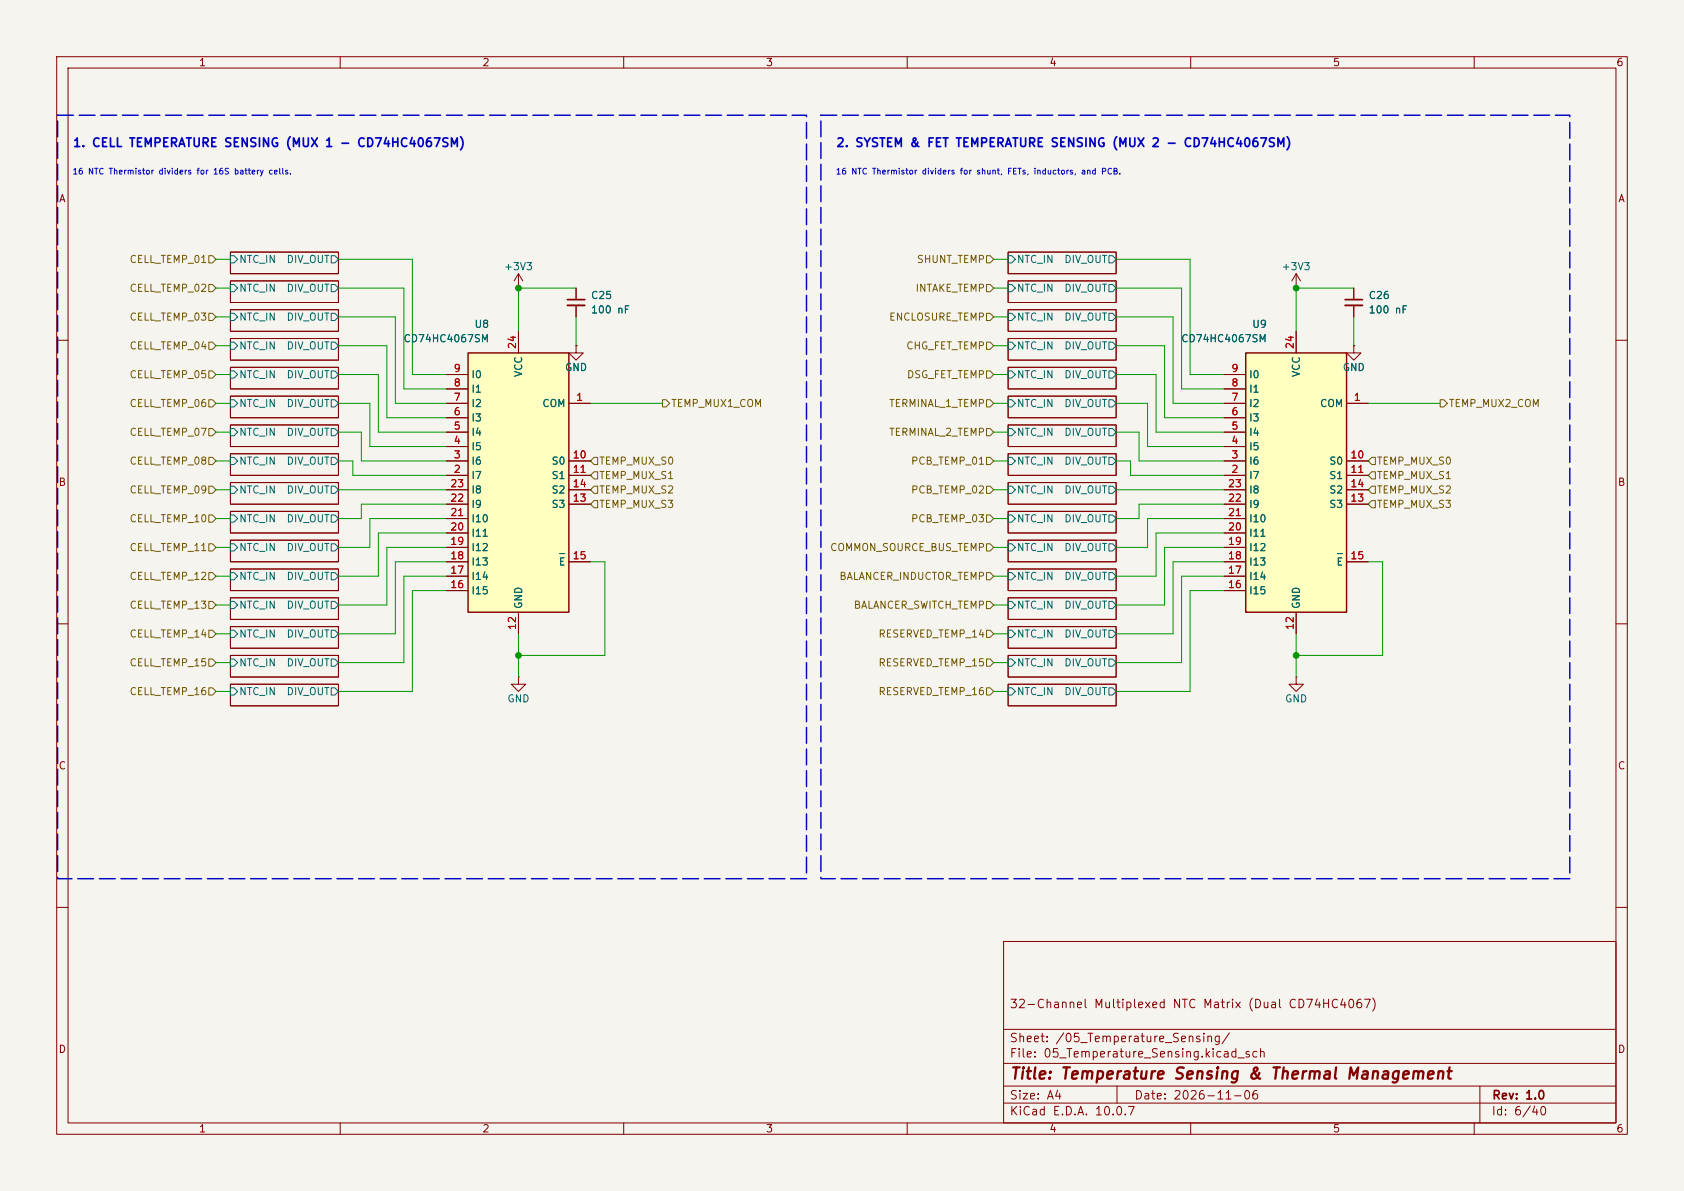
[picture p6: page 6]

16 NTC Thermistor dividers for 16S battery cells. 1. CELL TEMPERATURE SENSING (MUX 1 - CD74HC4067SM)
CELL_TEMP_15 CELL_TEMP_16 CELL_TEMP_13 CELL_TEMP_12 CELL_TEMP_14 CELL_TEMP_11 CELL_TEMP_10 CELL_TEMP_09 CELL_TEMP_08 CELL_TEMP_07 CELL_TEMP_06 CELL_TEMP_05 CELL_TEMP_04 CELL_TEMP_03 CELL_TEMP_02

16 NTC Thermistor dividers for shunt, FETs, inductors, and PCB. 2. SYSTEM & FET TEMPERATURE SENSING (MUX 2 - CD74HC4067SM) C25

32-Channel Multiplexed NTC Matrix (Dual CD74HC4067)

Sheet: /05_Temperature_Sensing/
File: 05_Temperature_Sensing.kicad_sch
Title: Temperature Sensing & Thermal Management

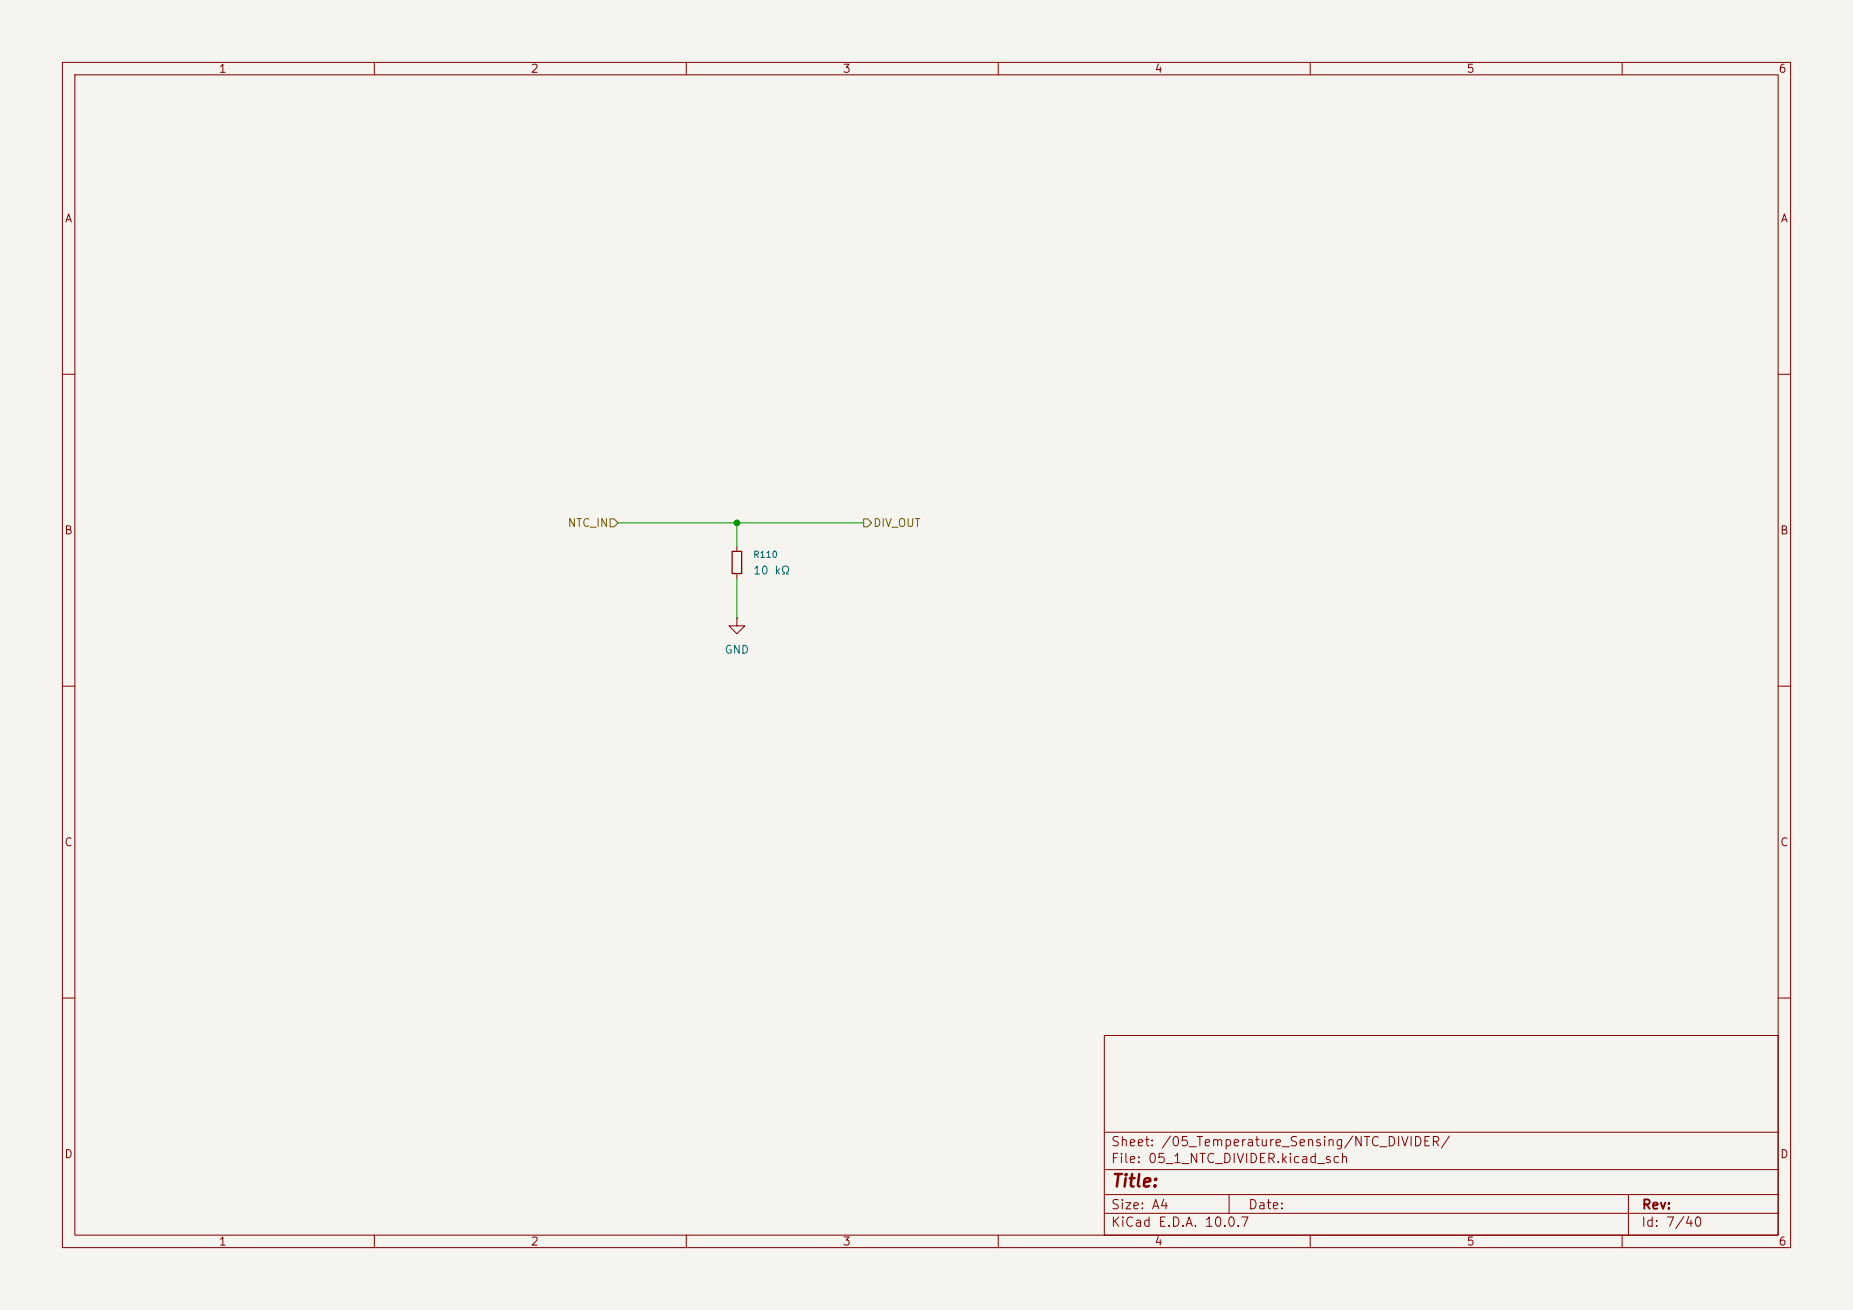
[picture p7: page 7]

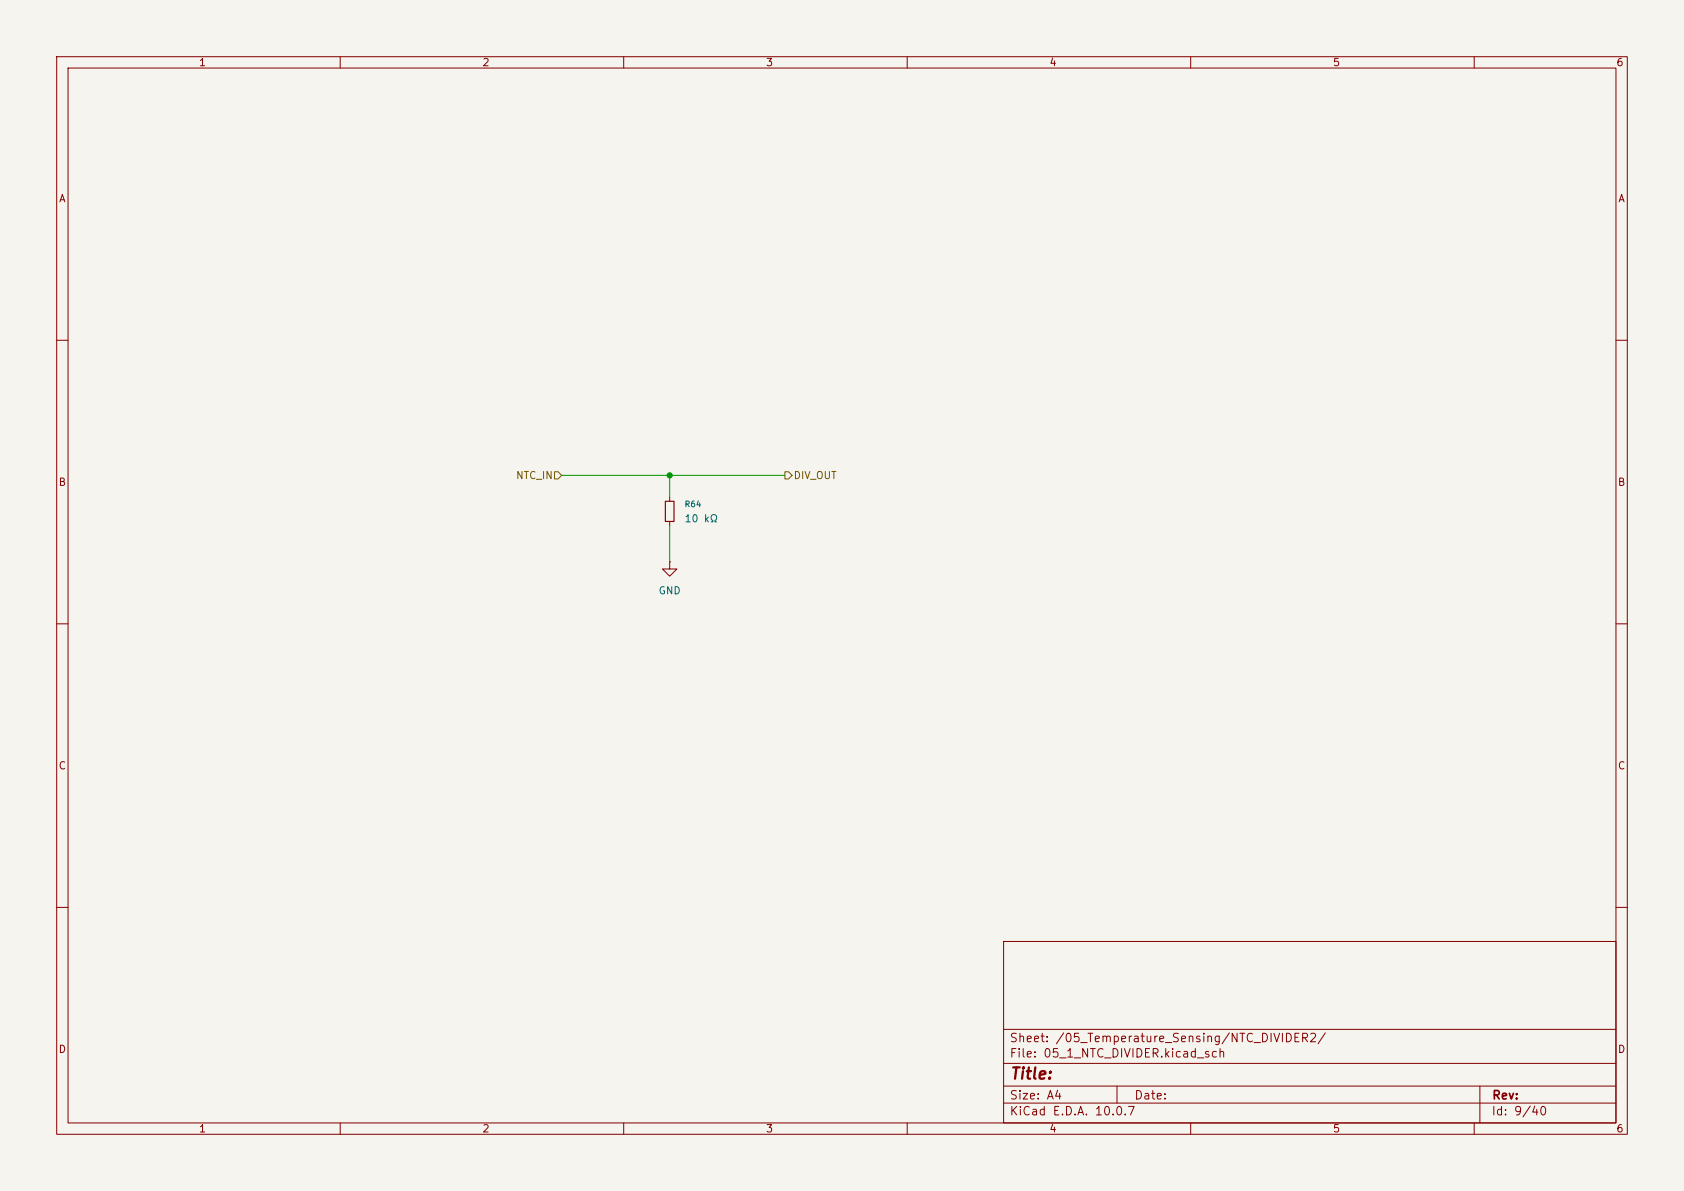
[picture p8: page 8]

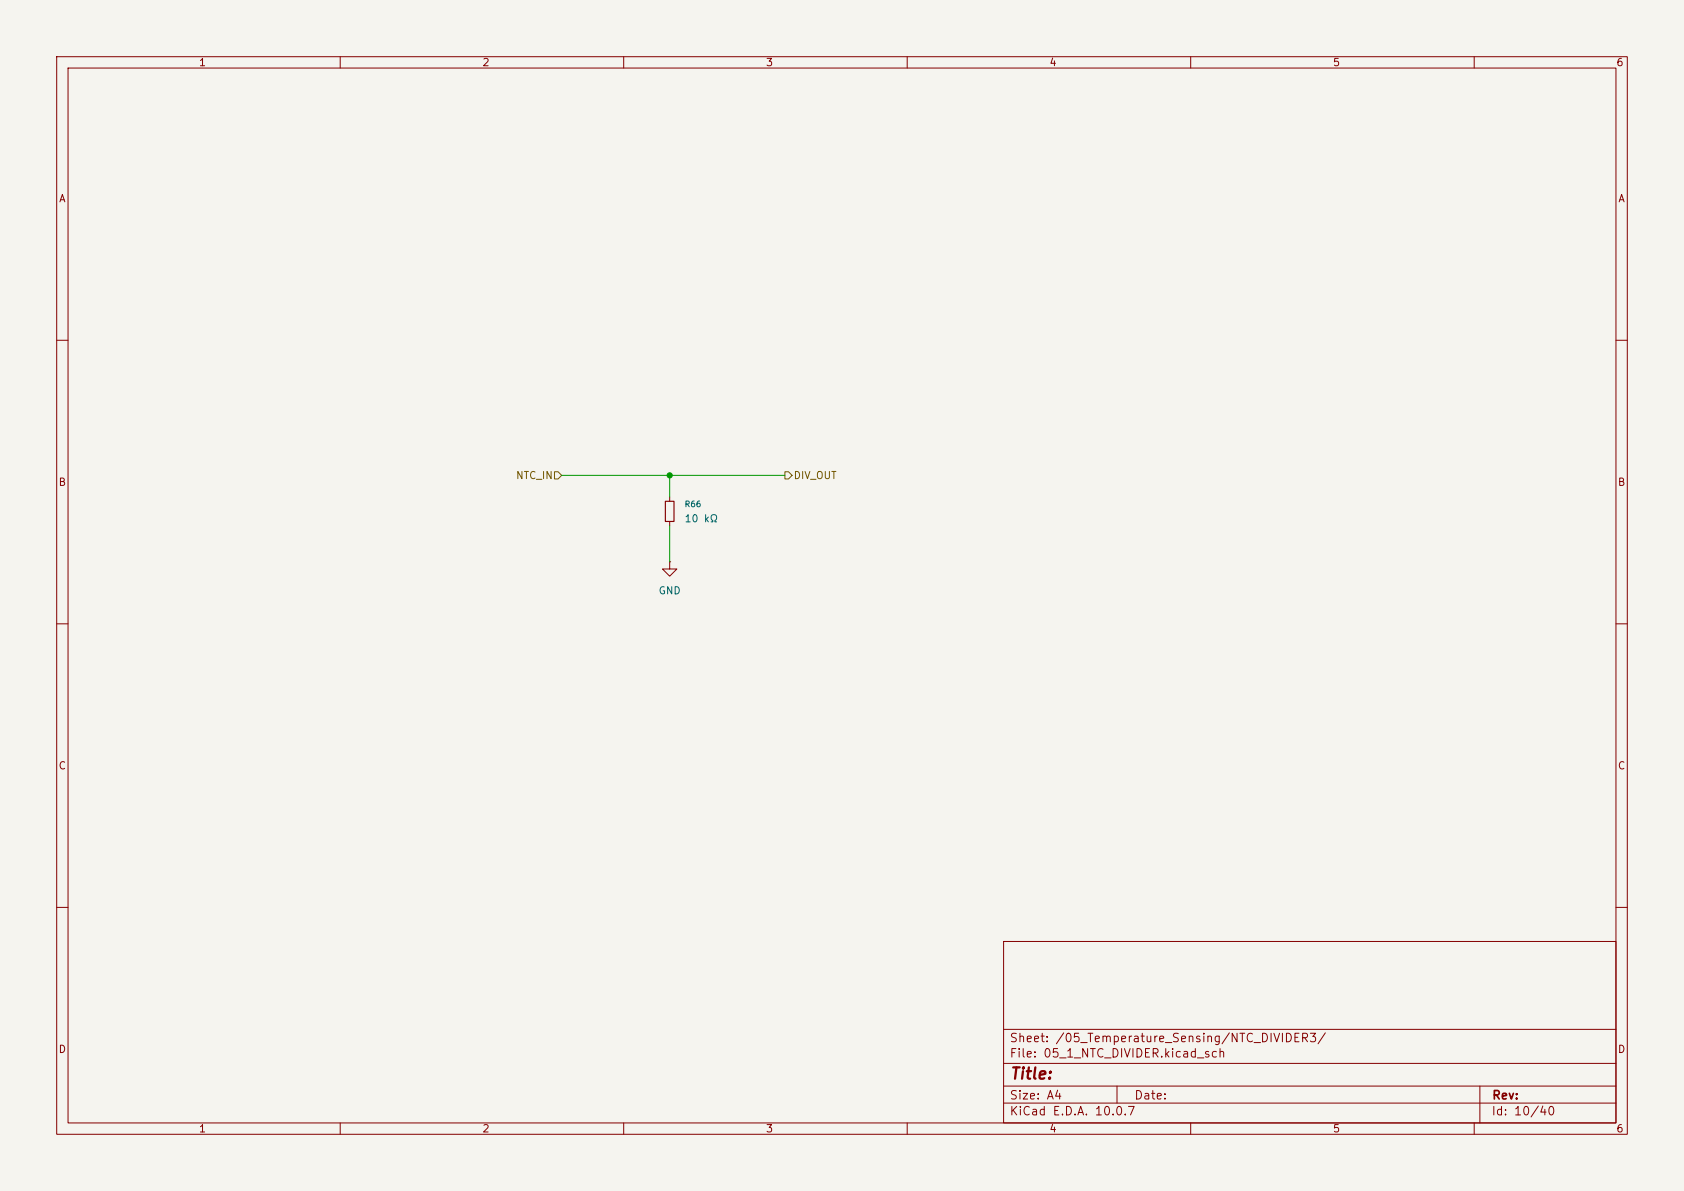
[picture p9: page 9]

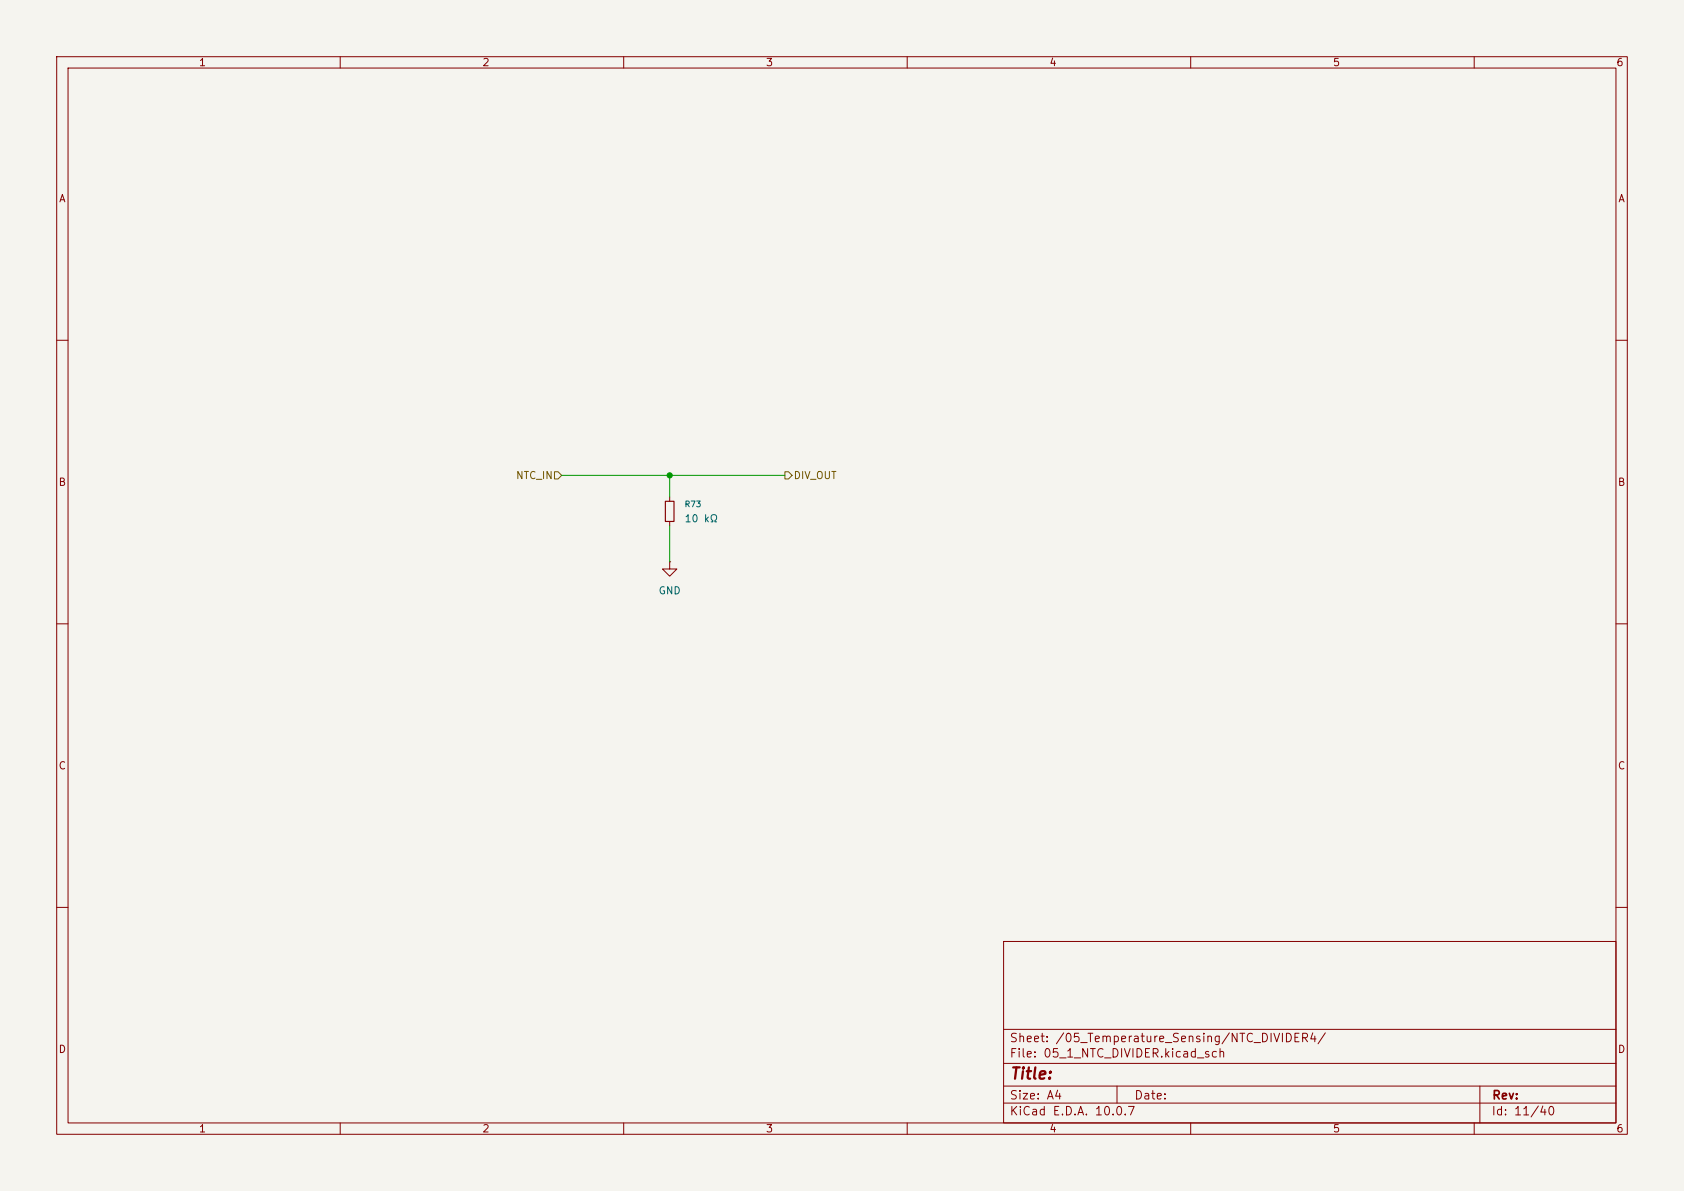
[picture p10: page 10]

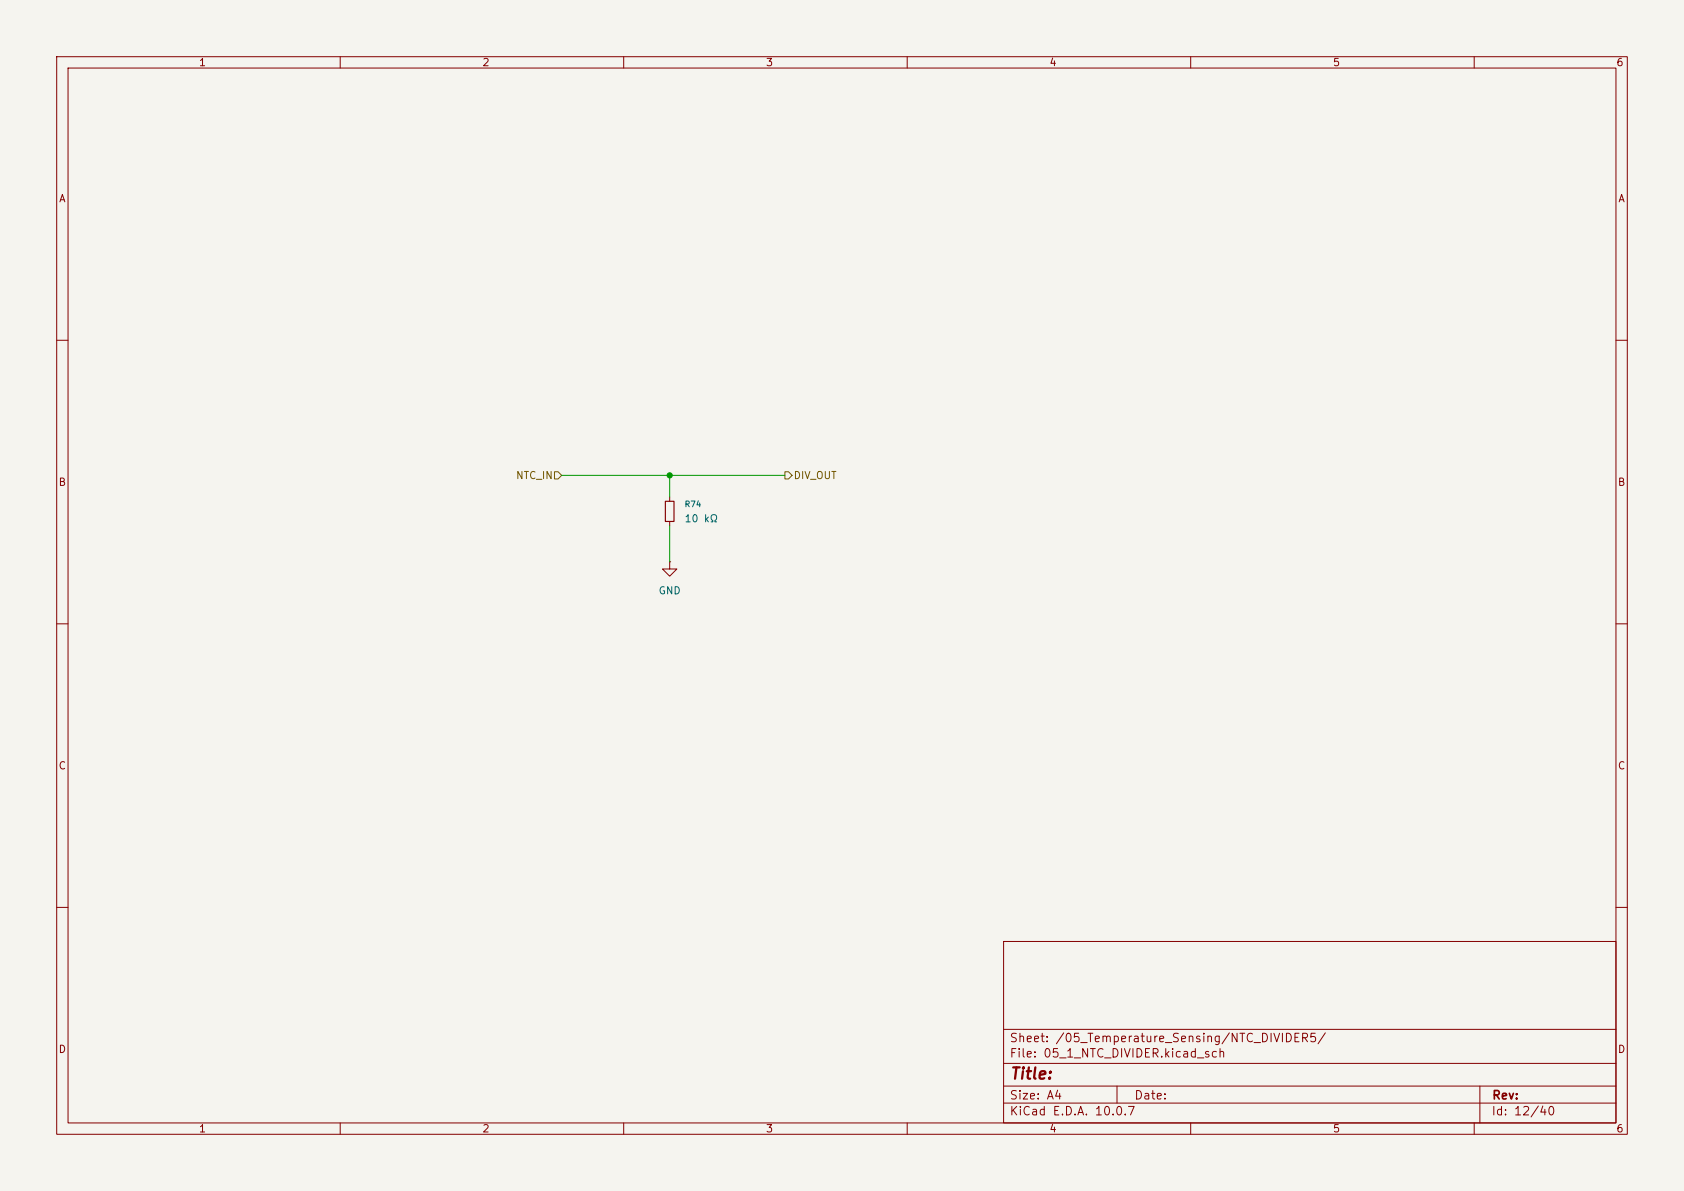
[picture p11: page 11]

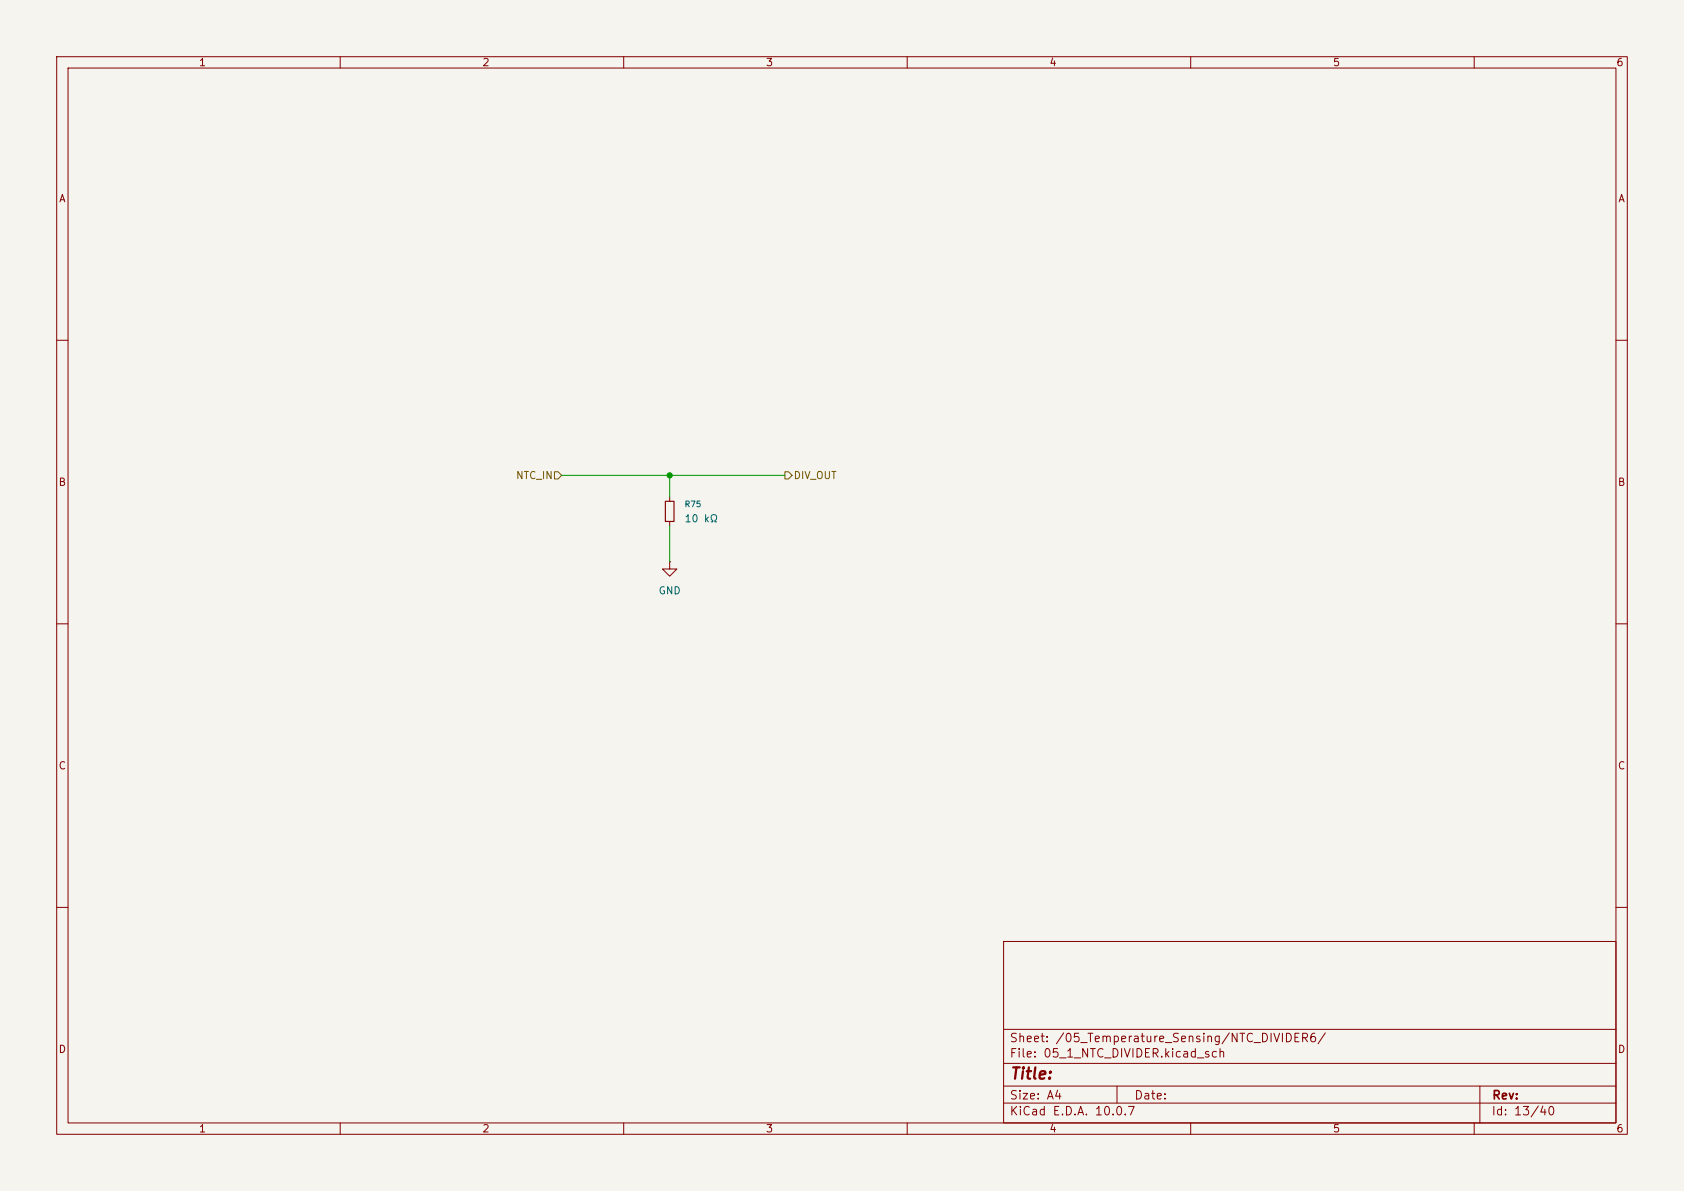
[picture p12: page 12]

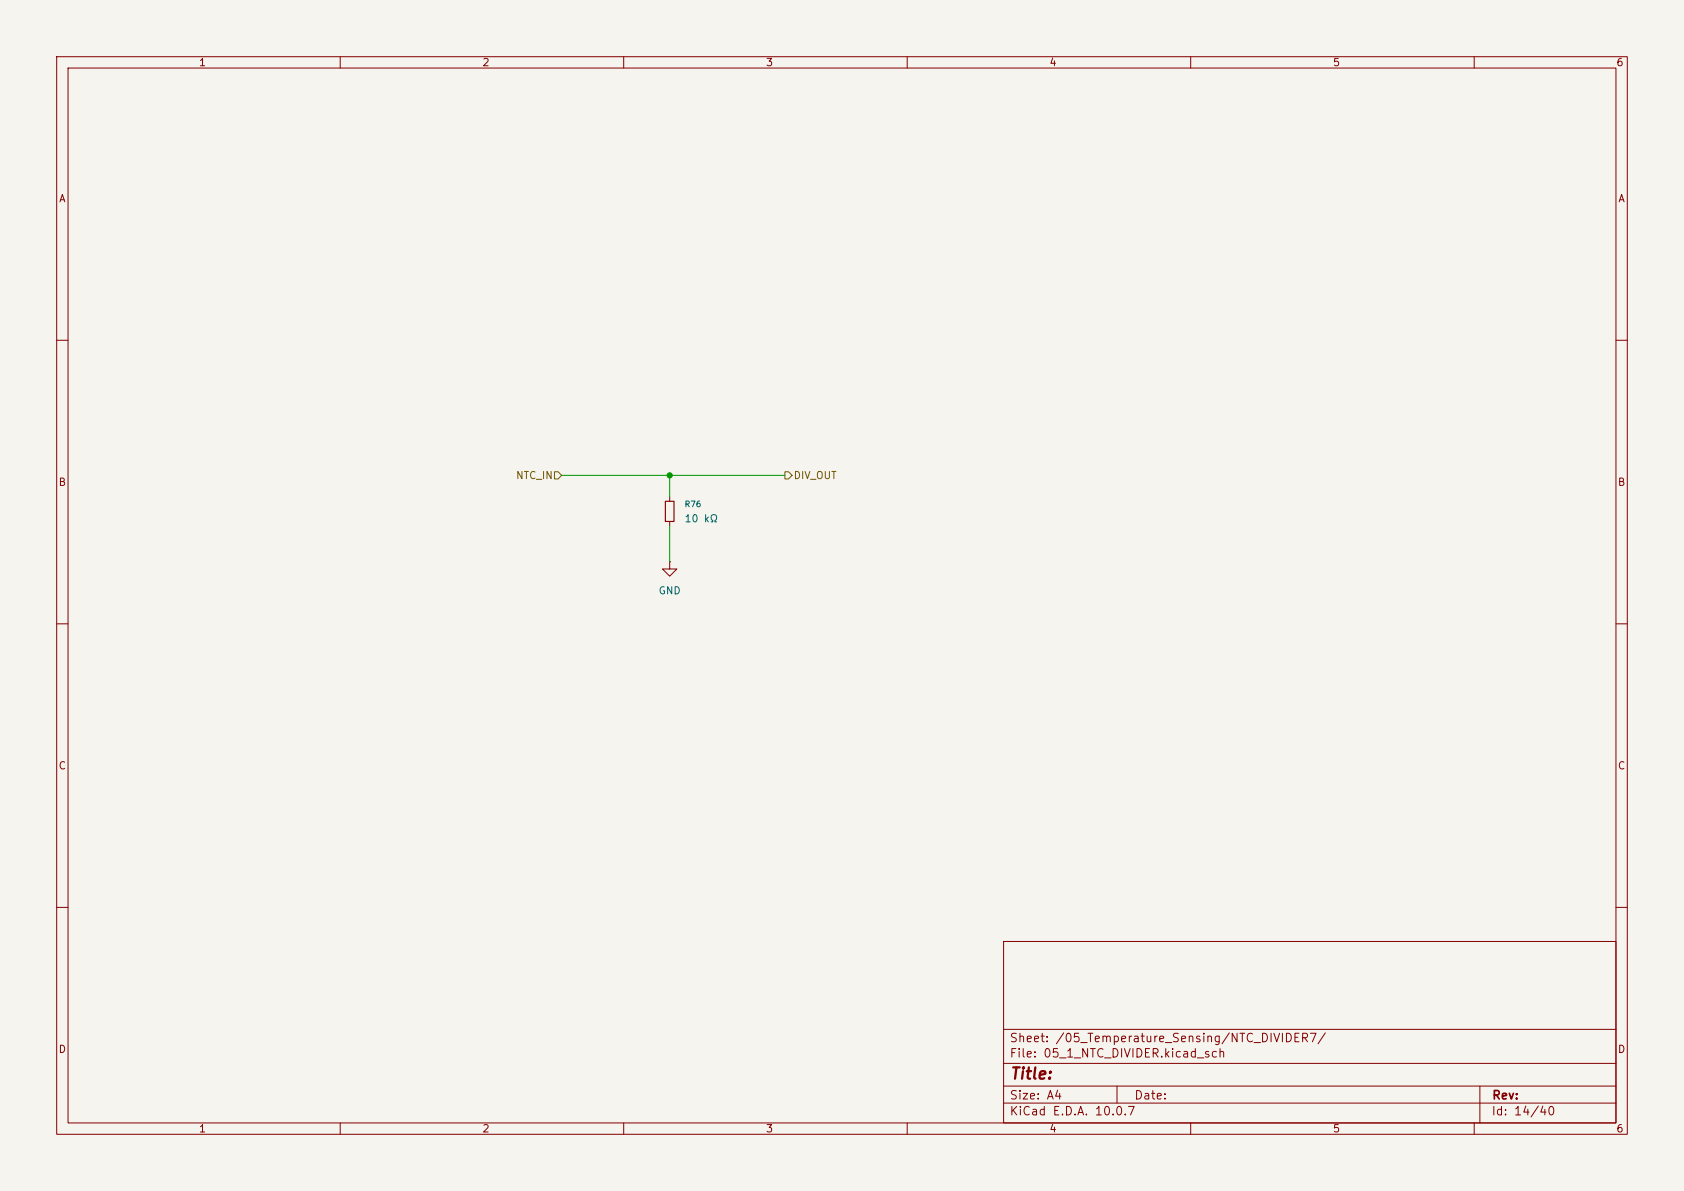
[picture p13: page 13]

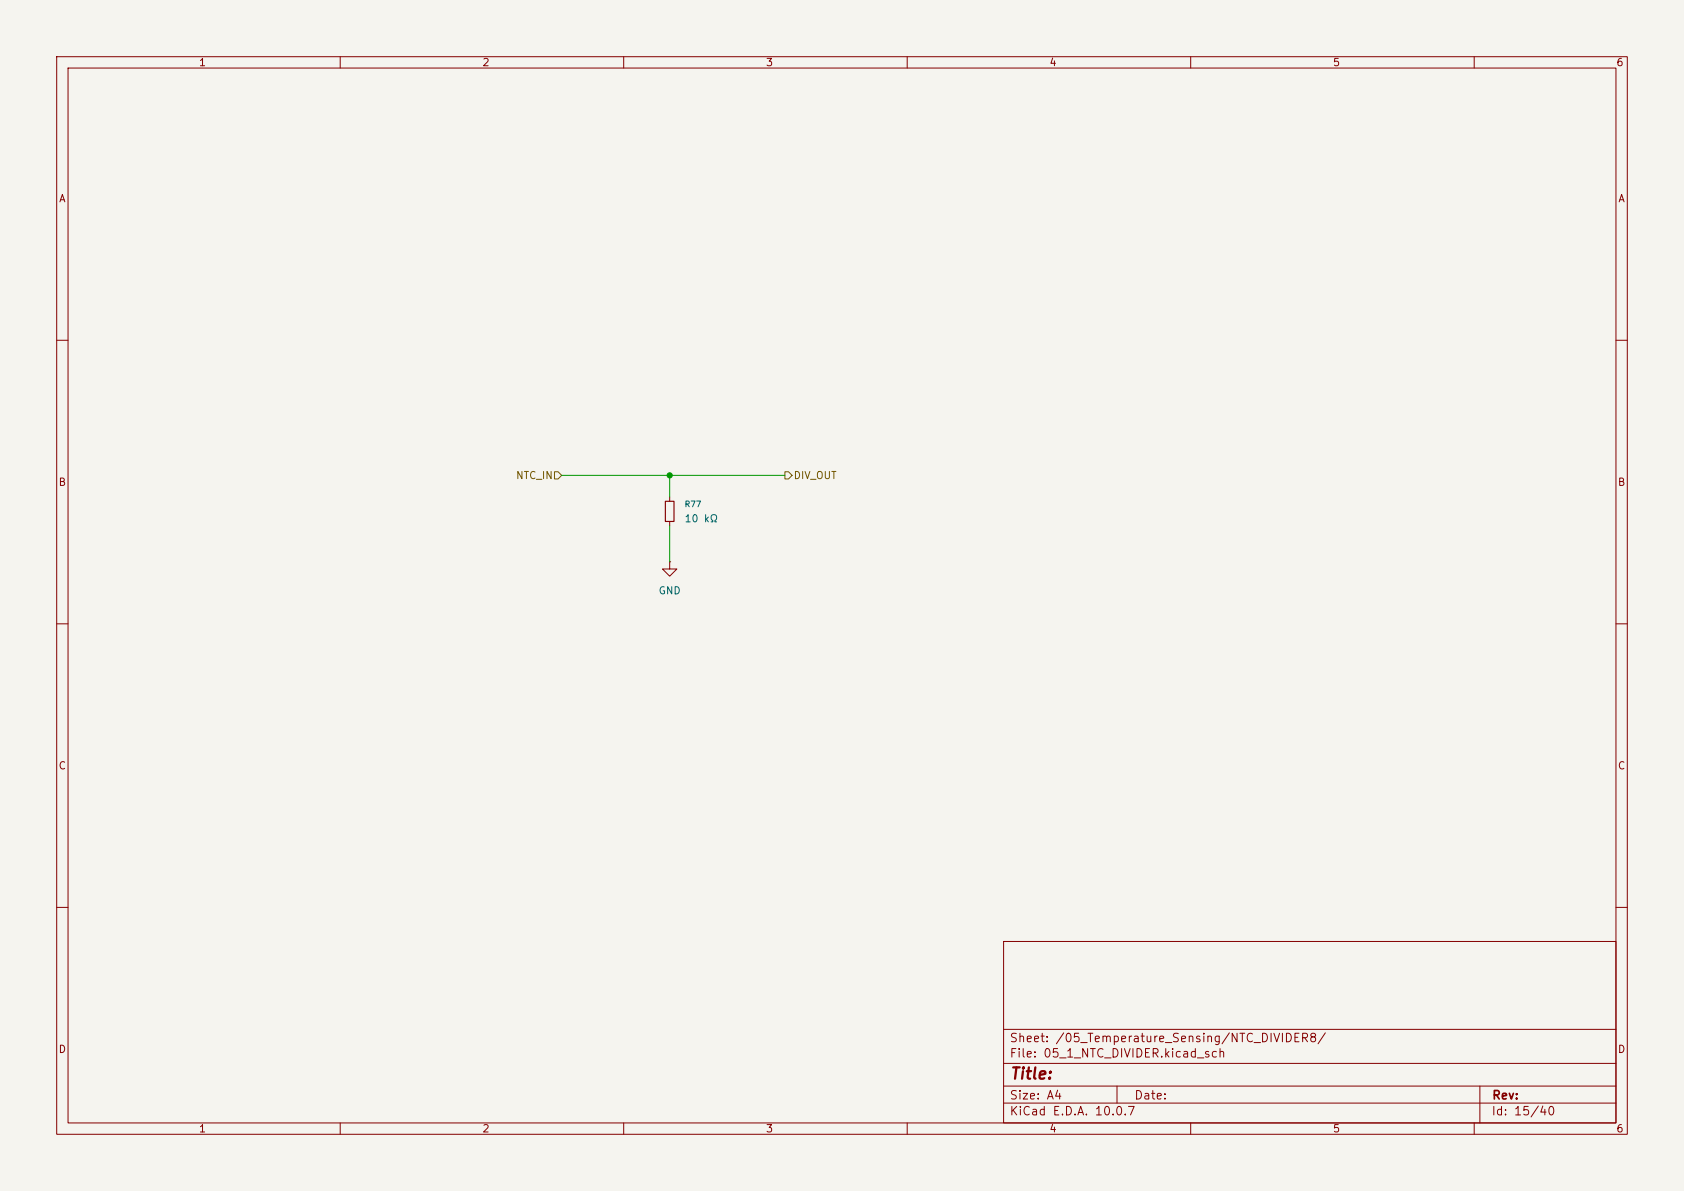
[picture p14: page 14]

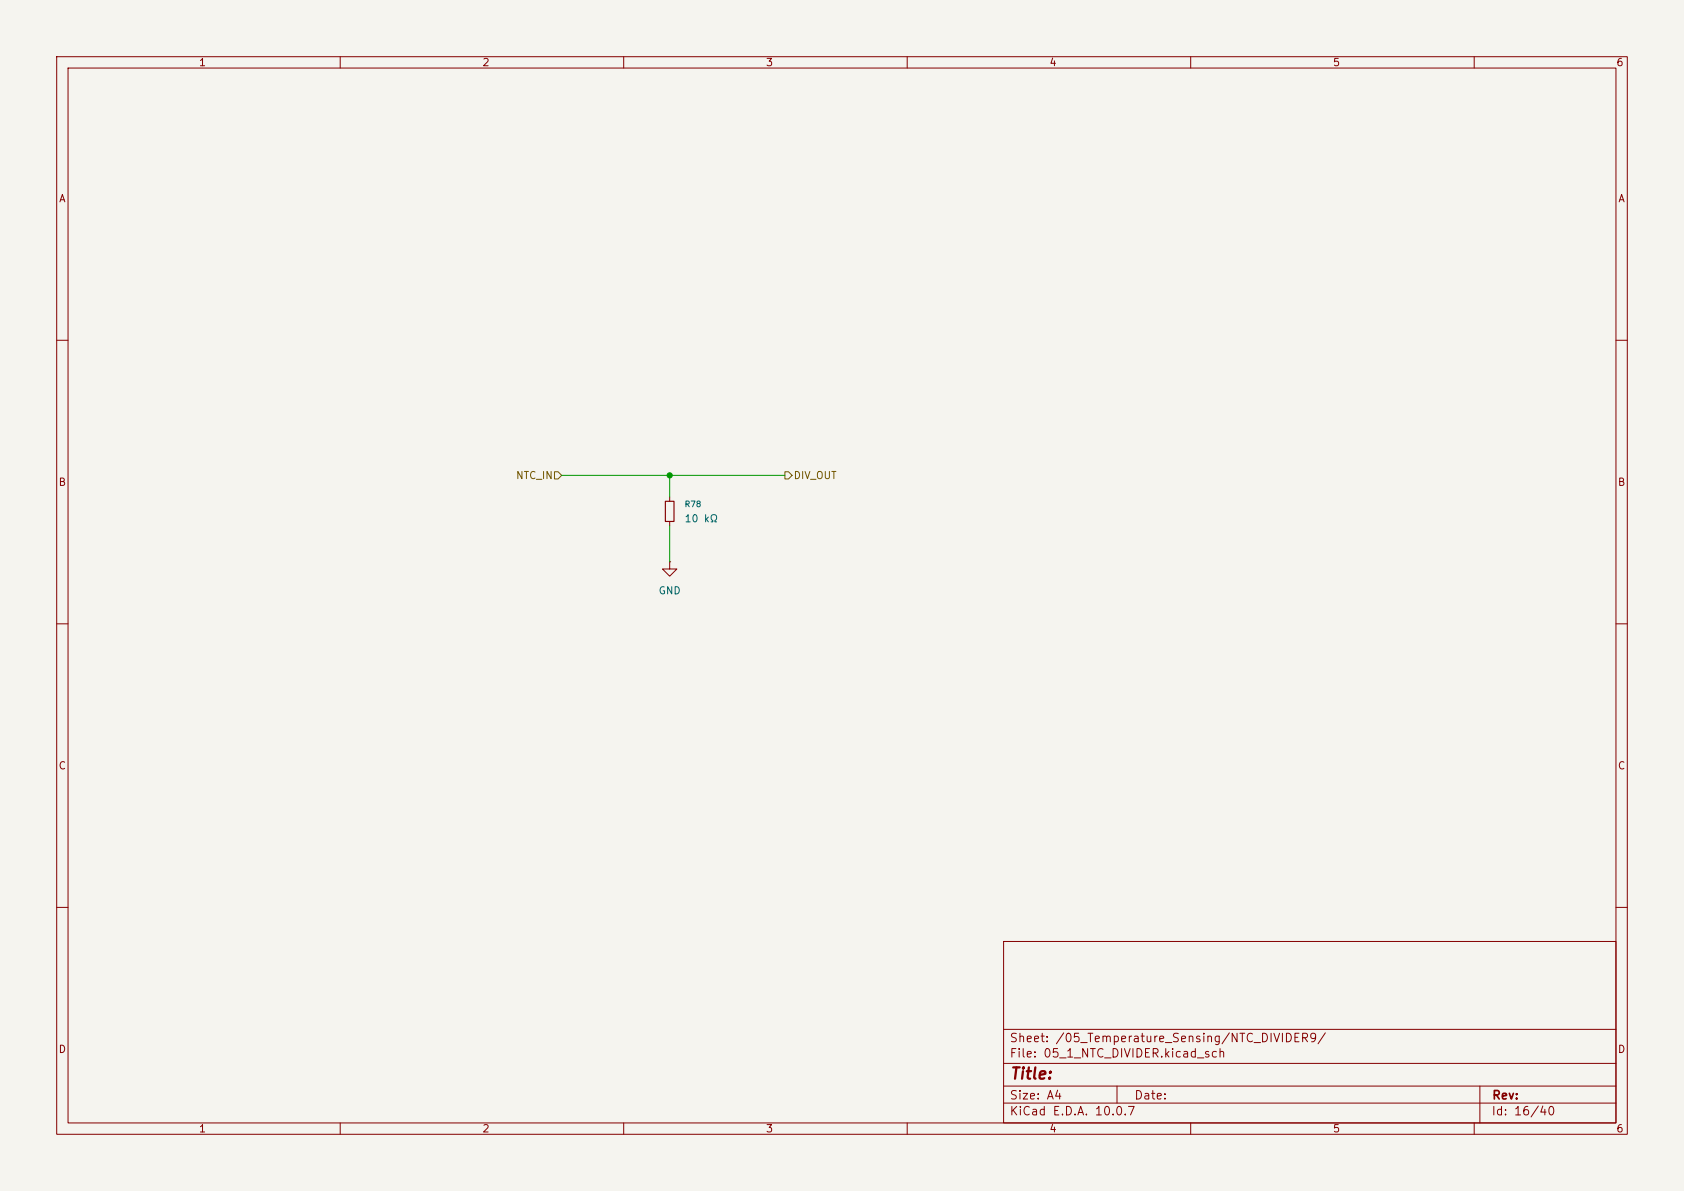
[picture p15: page 15]

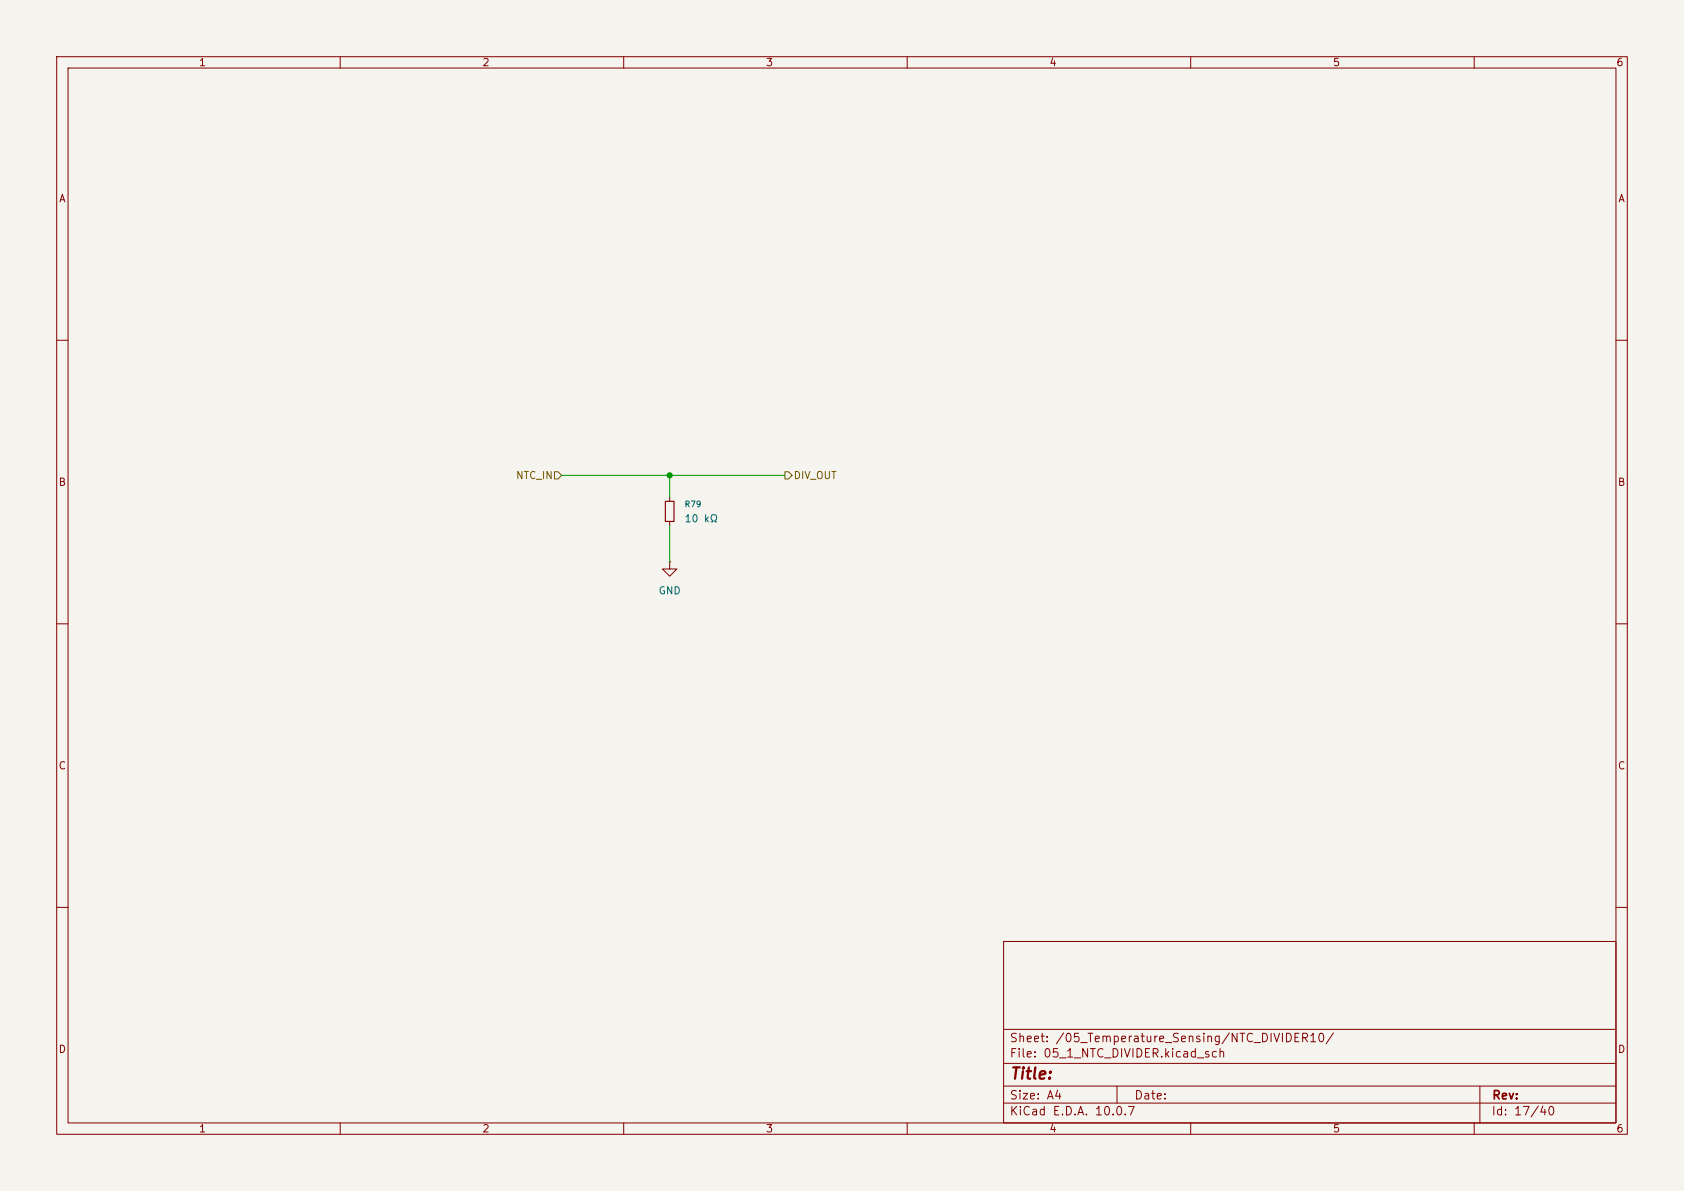
[picture p16: page 16]

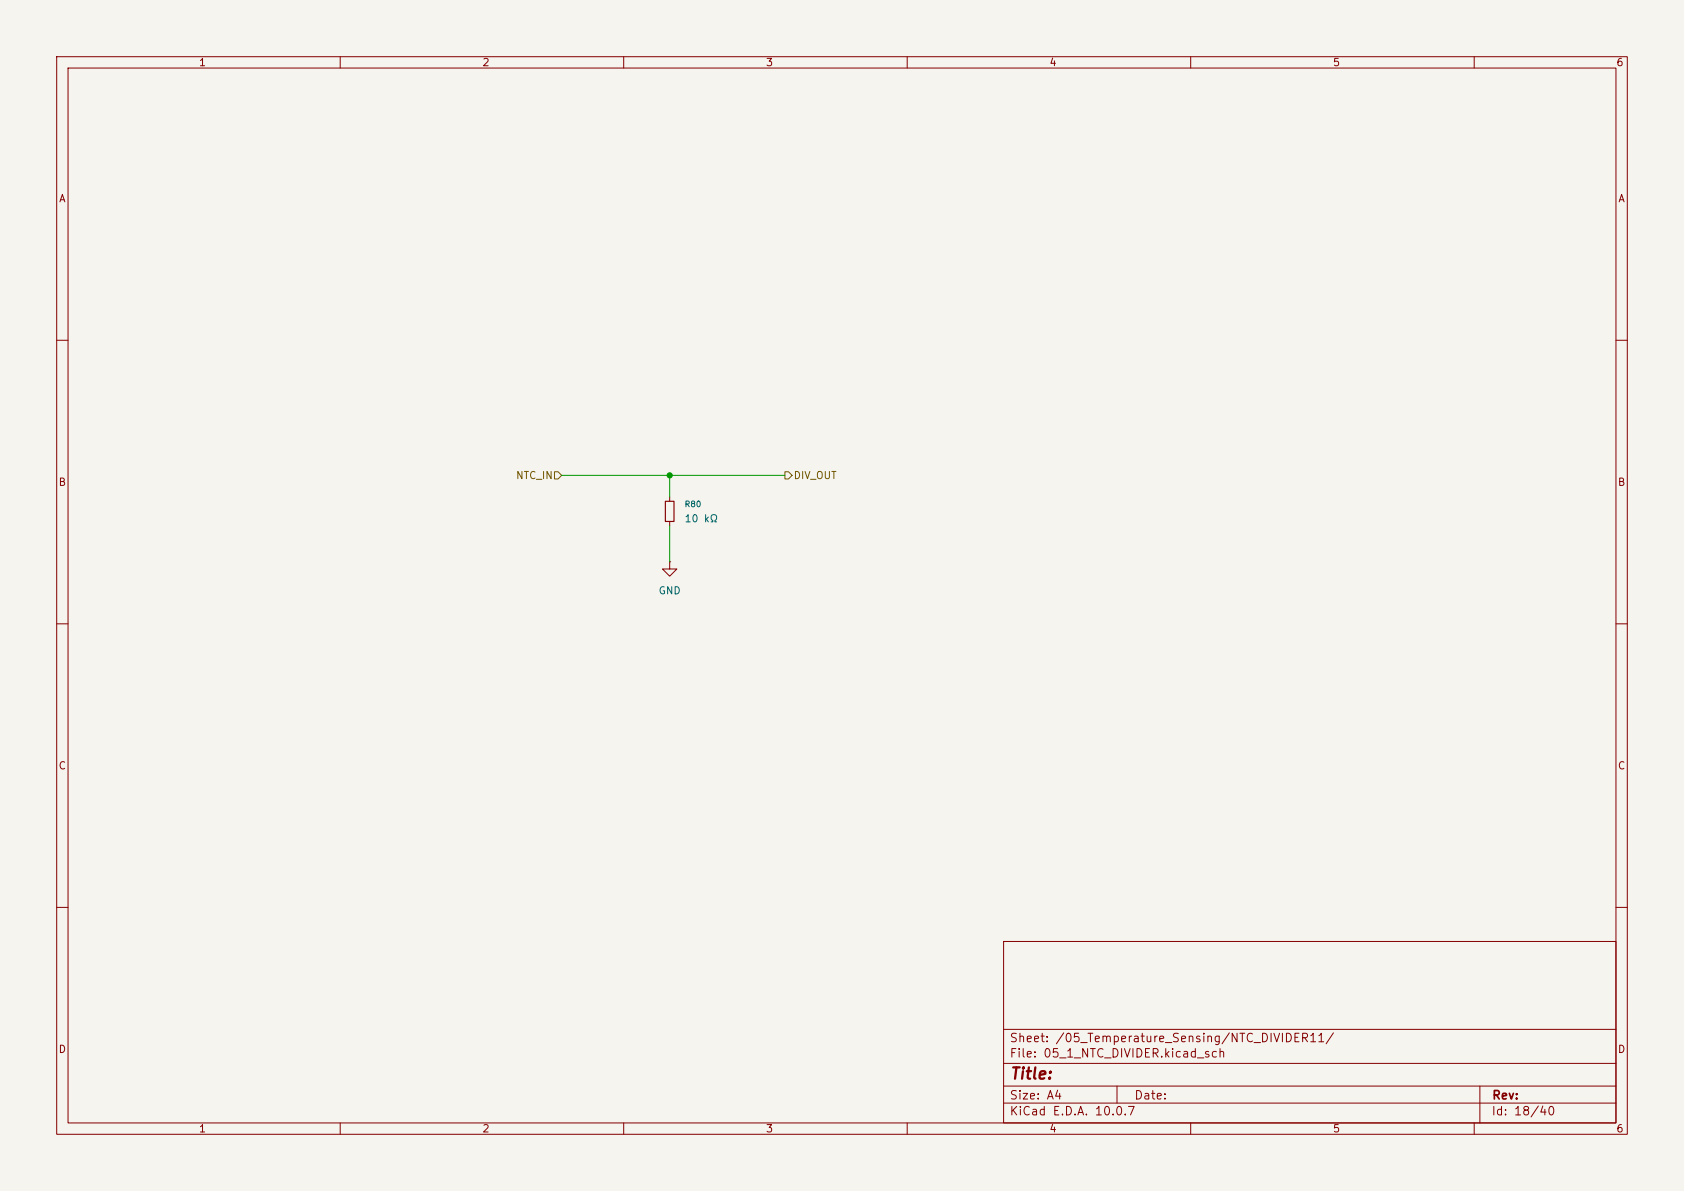
[picture p17: page 17]

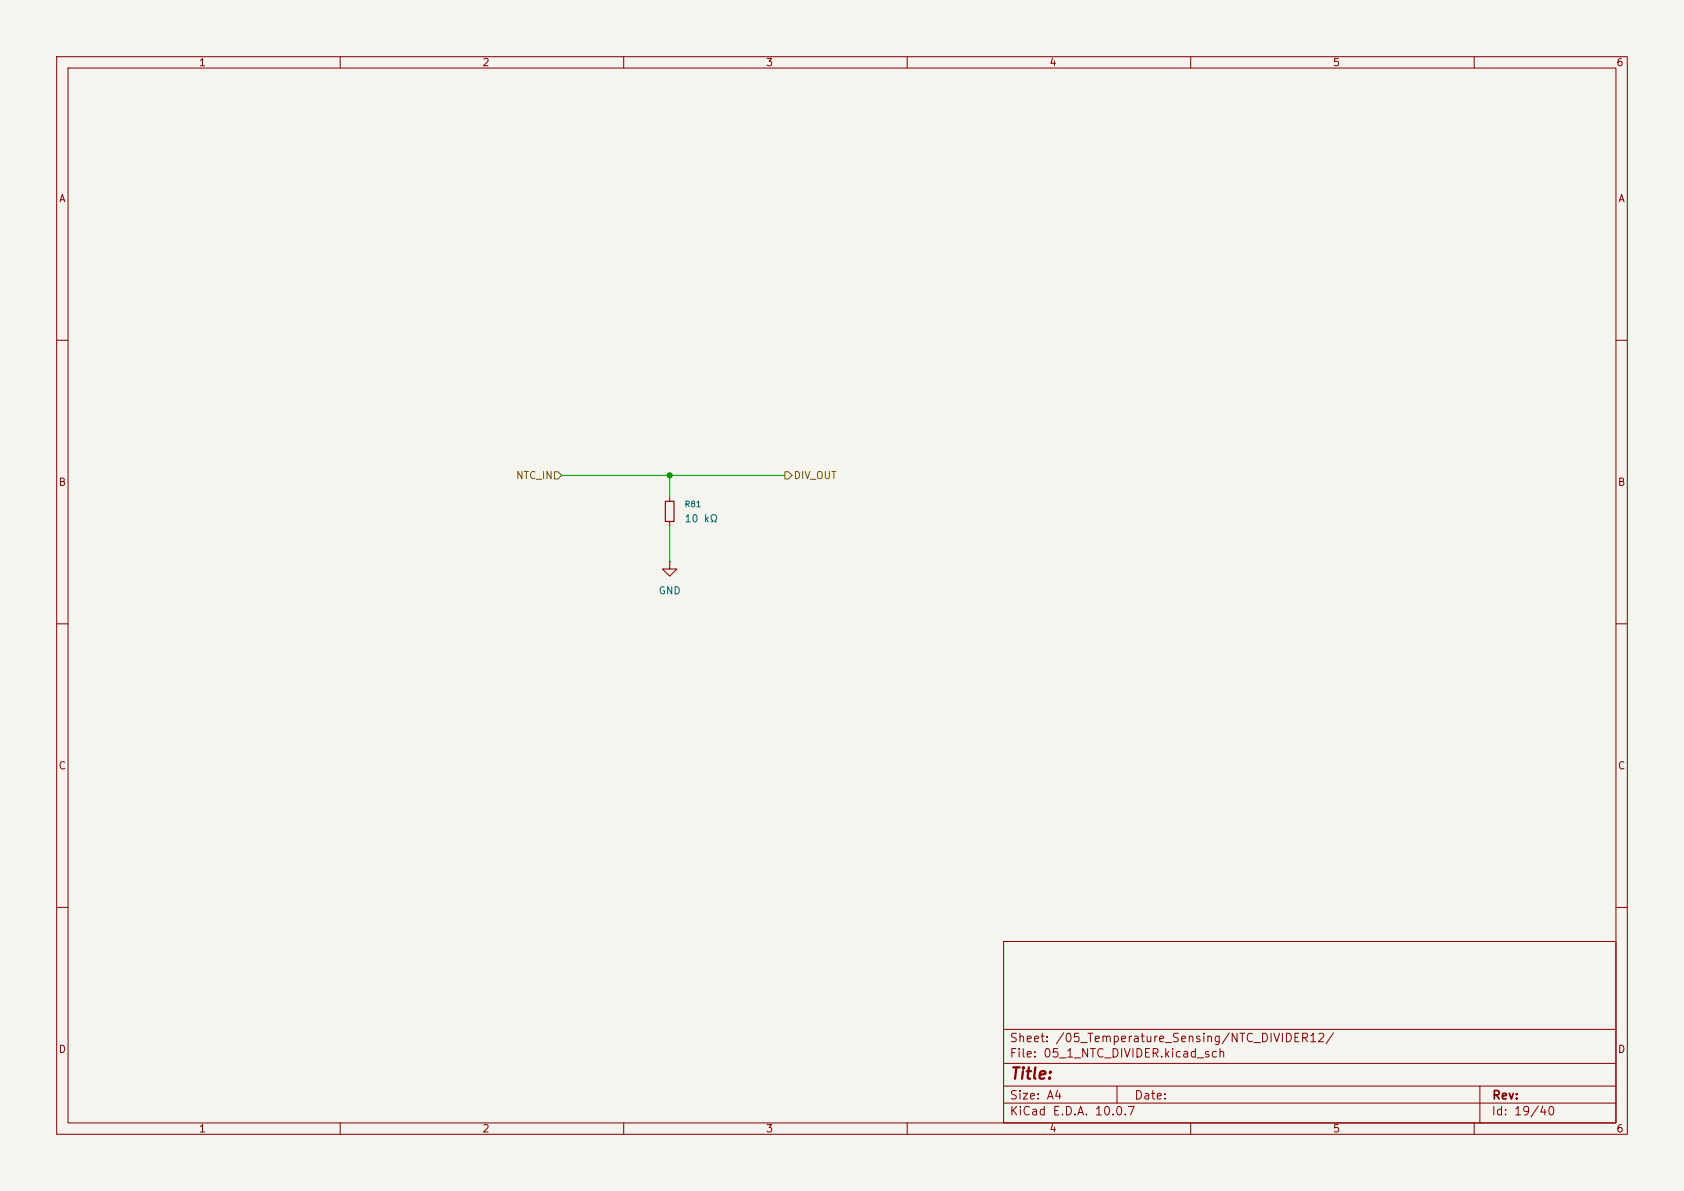
[picture p18: page 18]

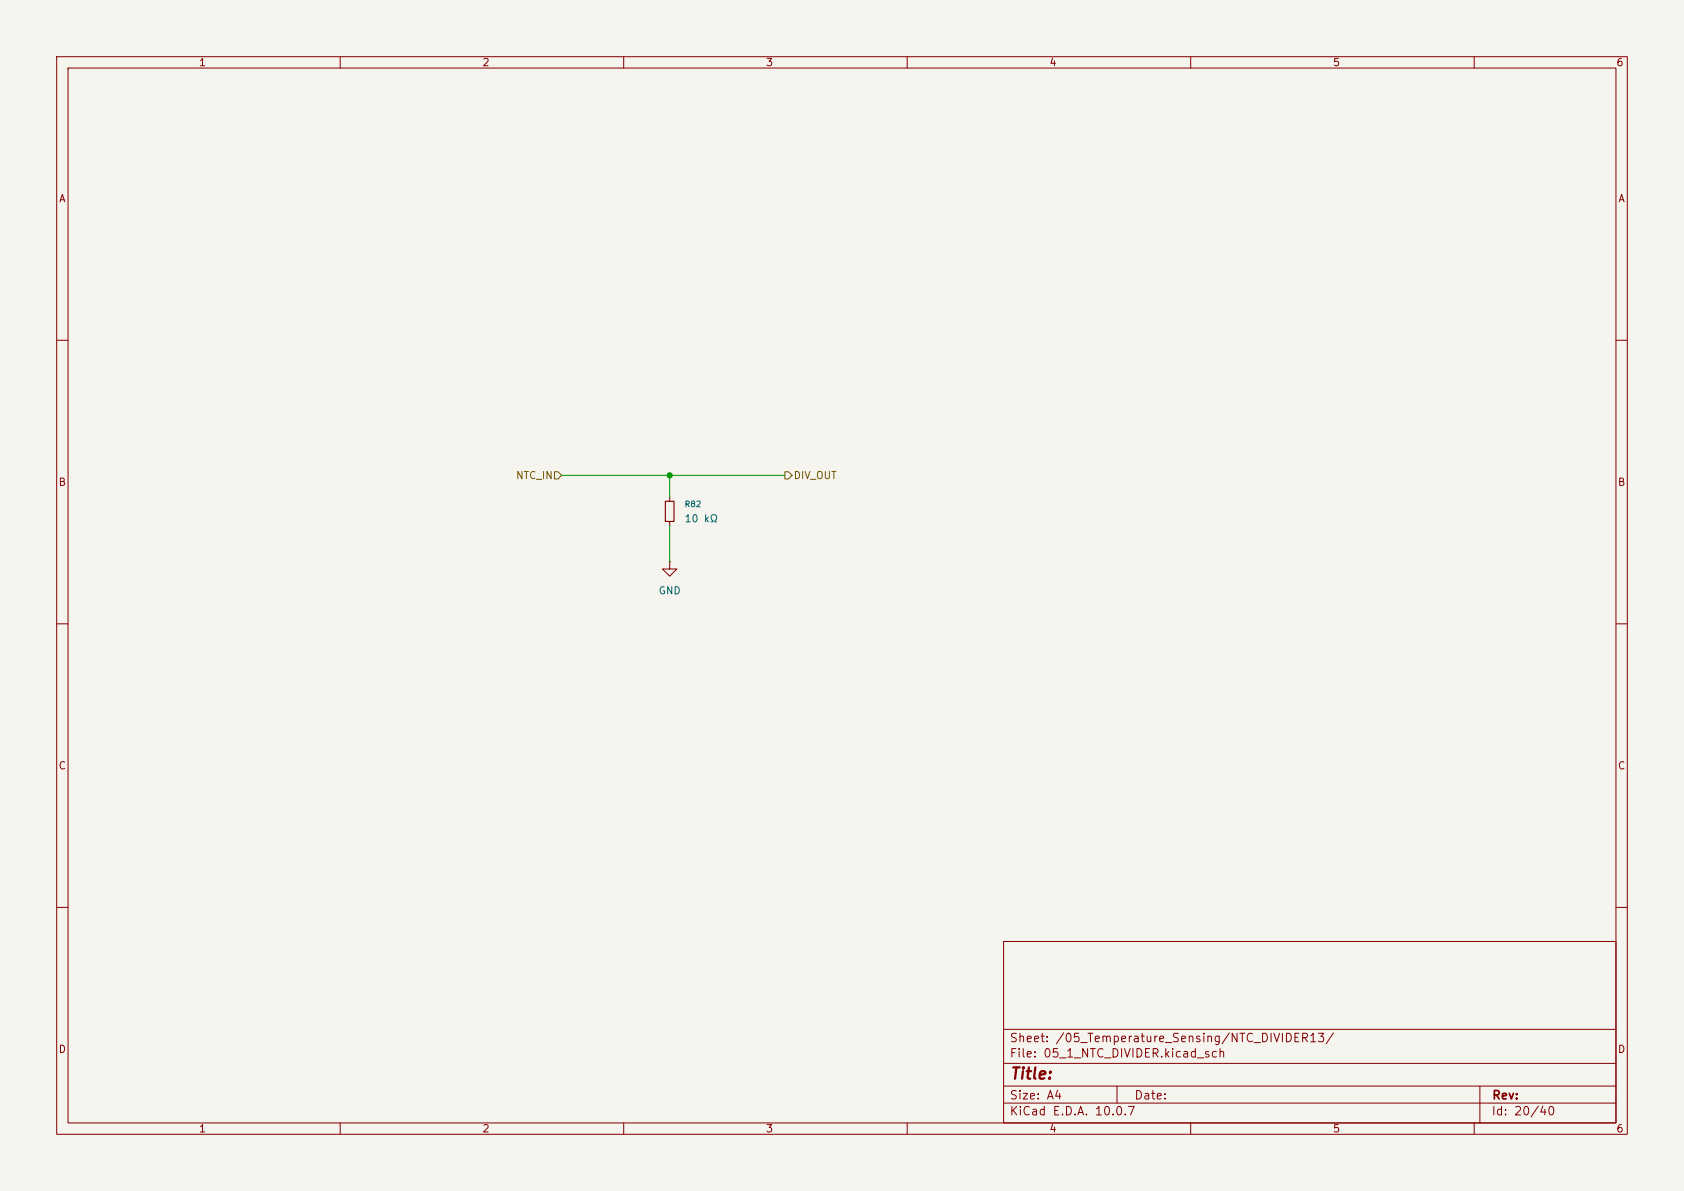
[picture p19: page 19]

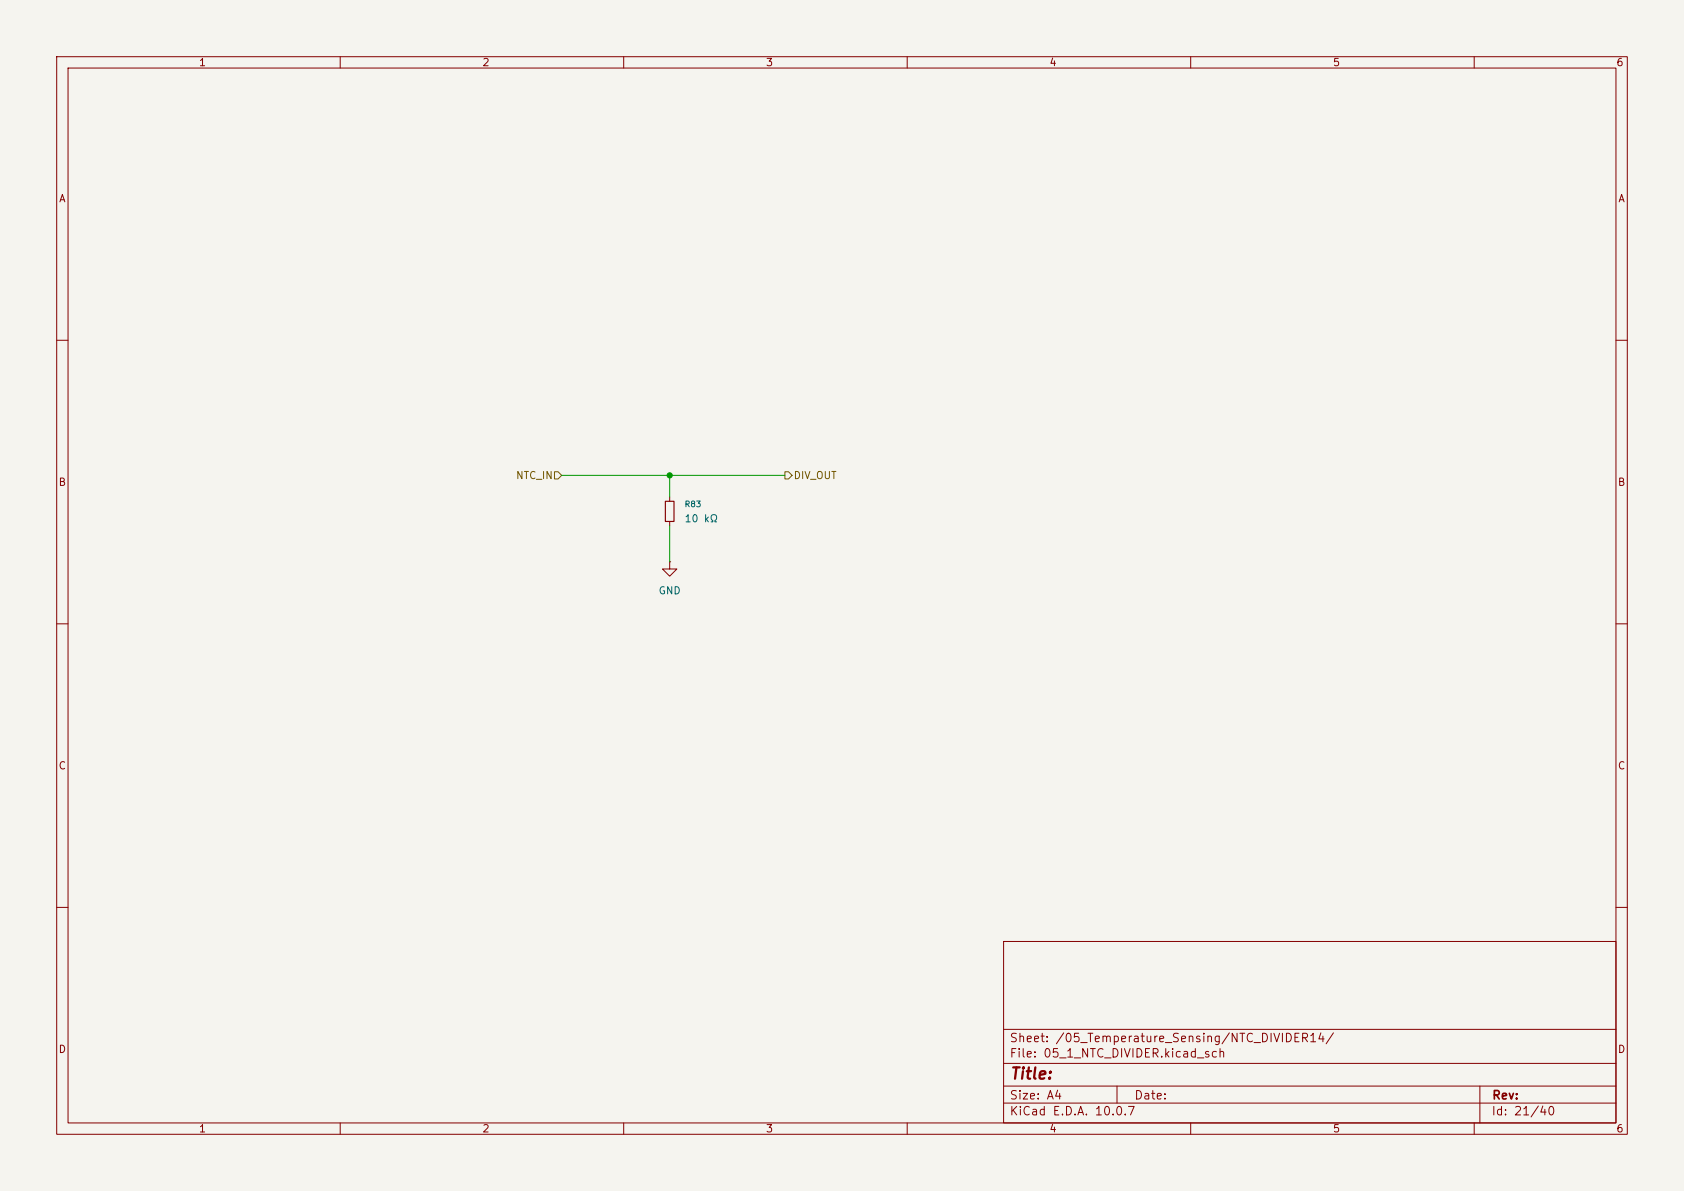
[picture p20: page 20]

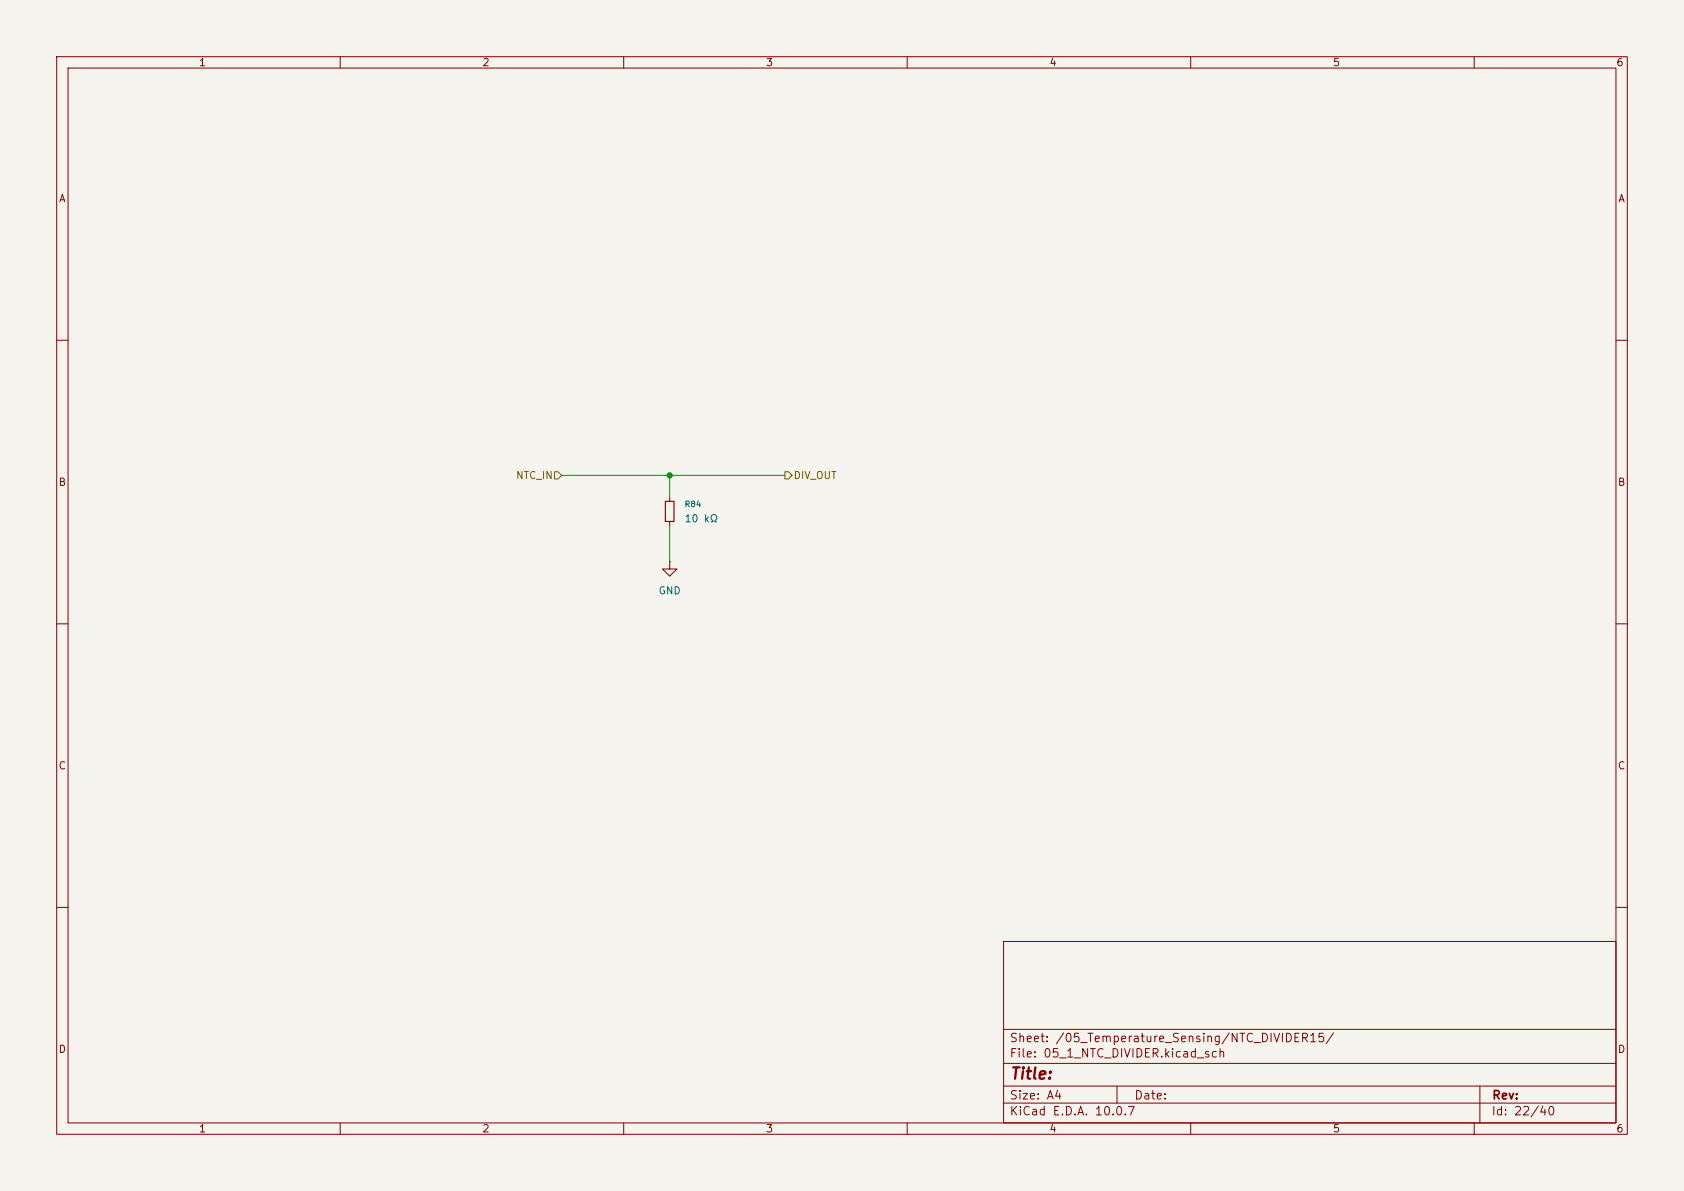
[picture p21: page 21]

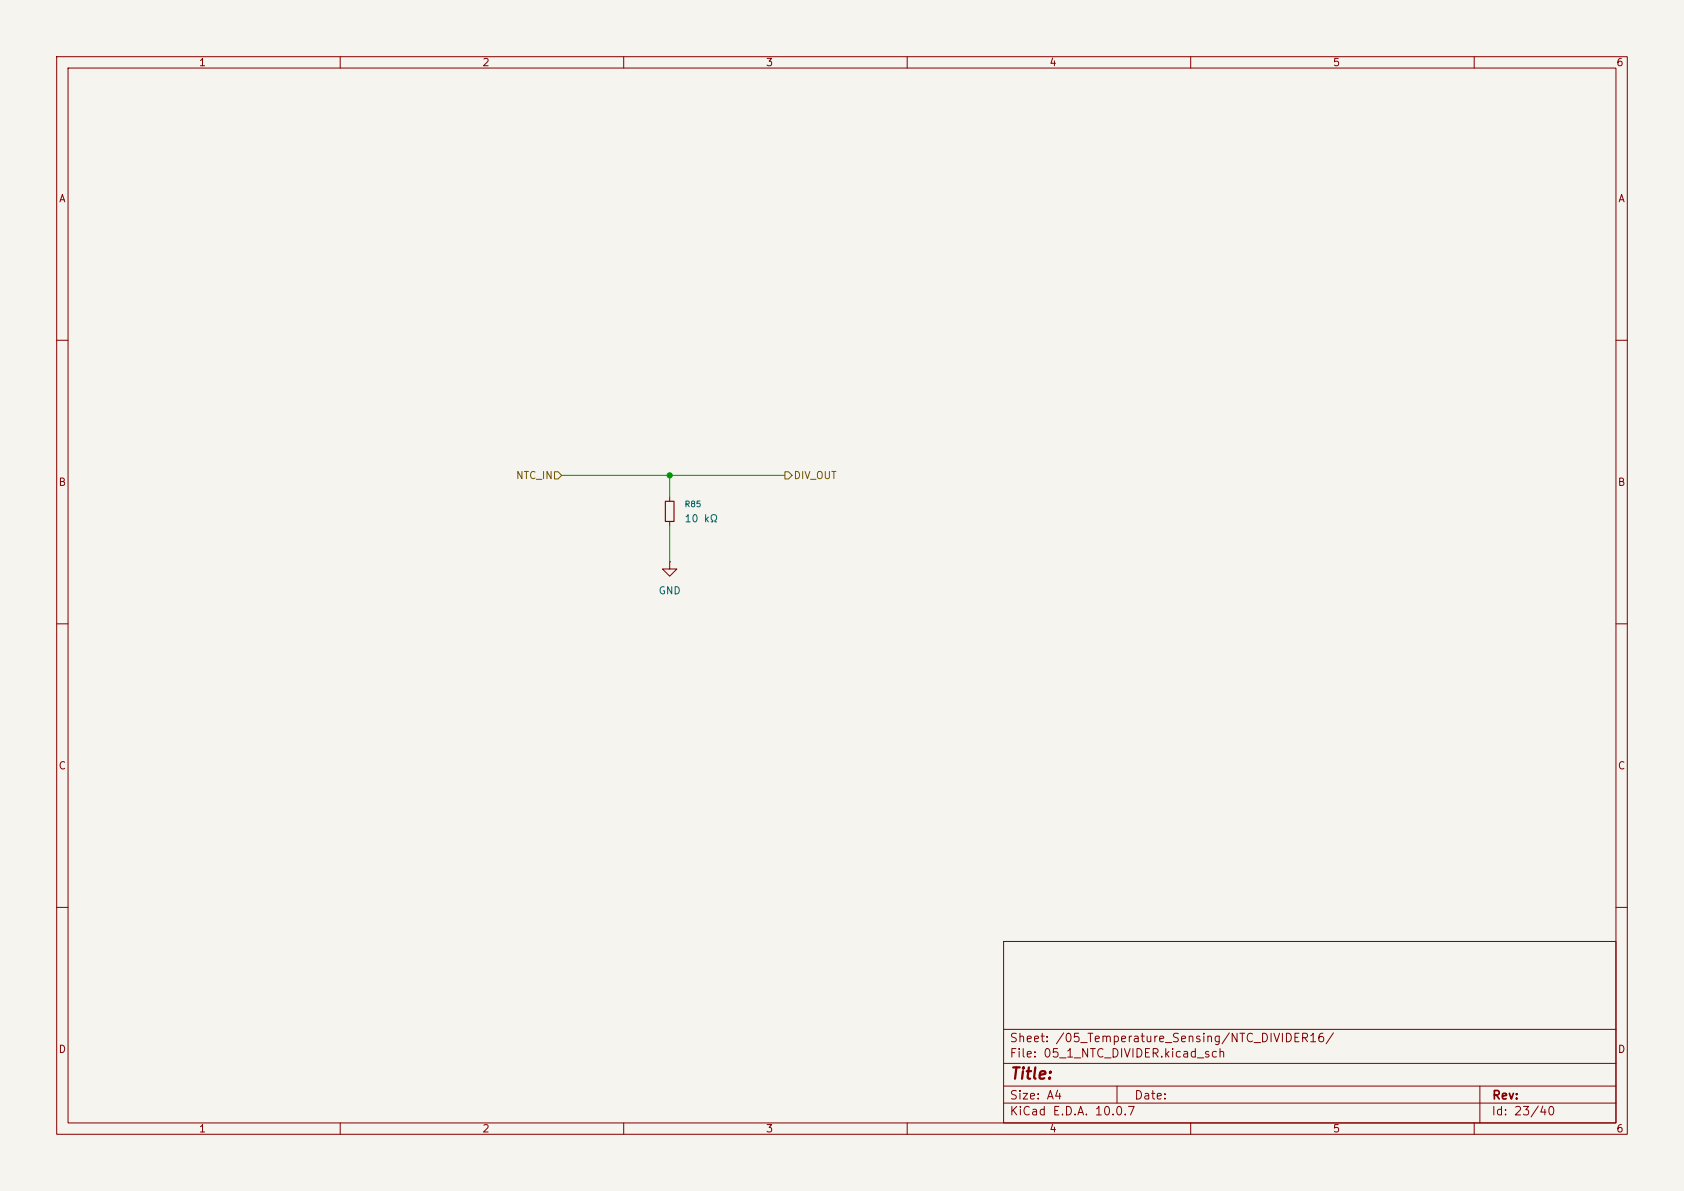
[picture p22: page 22]

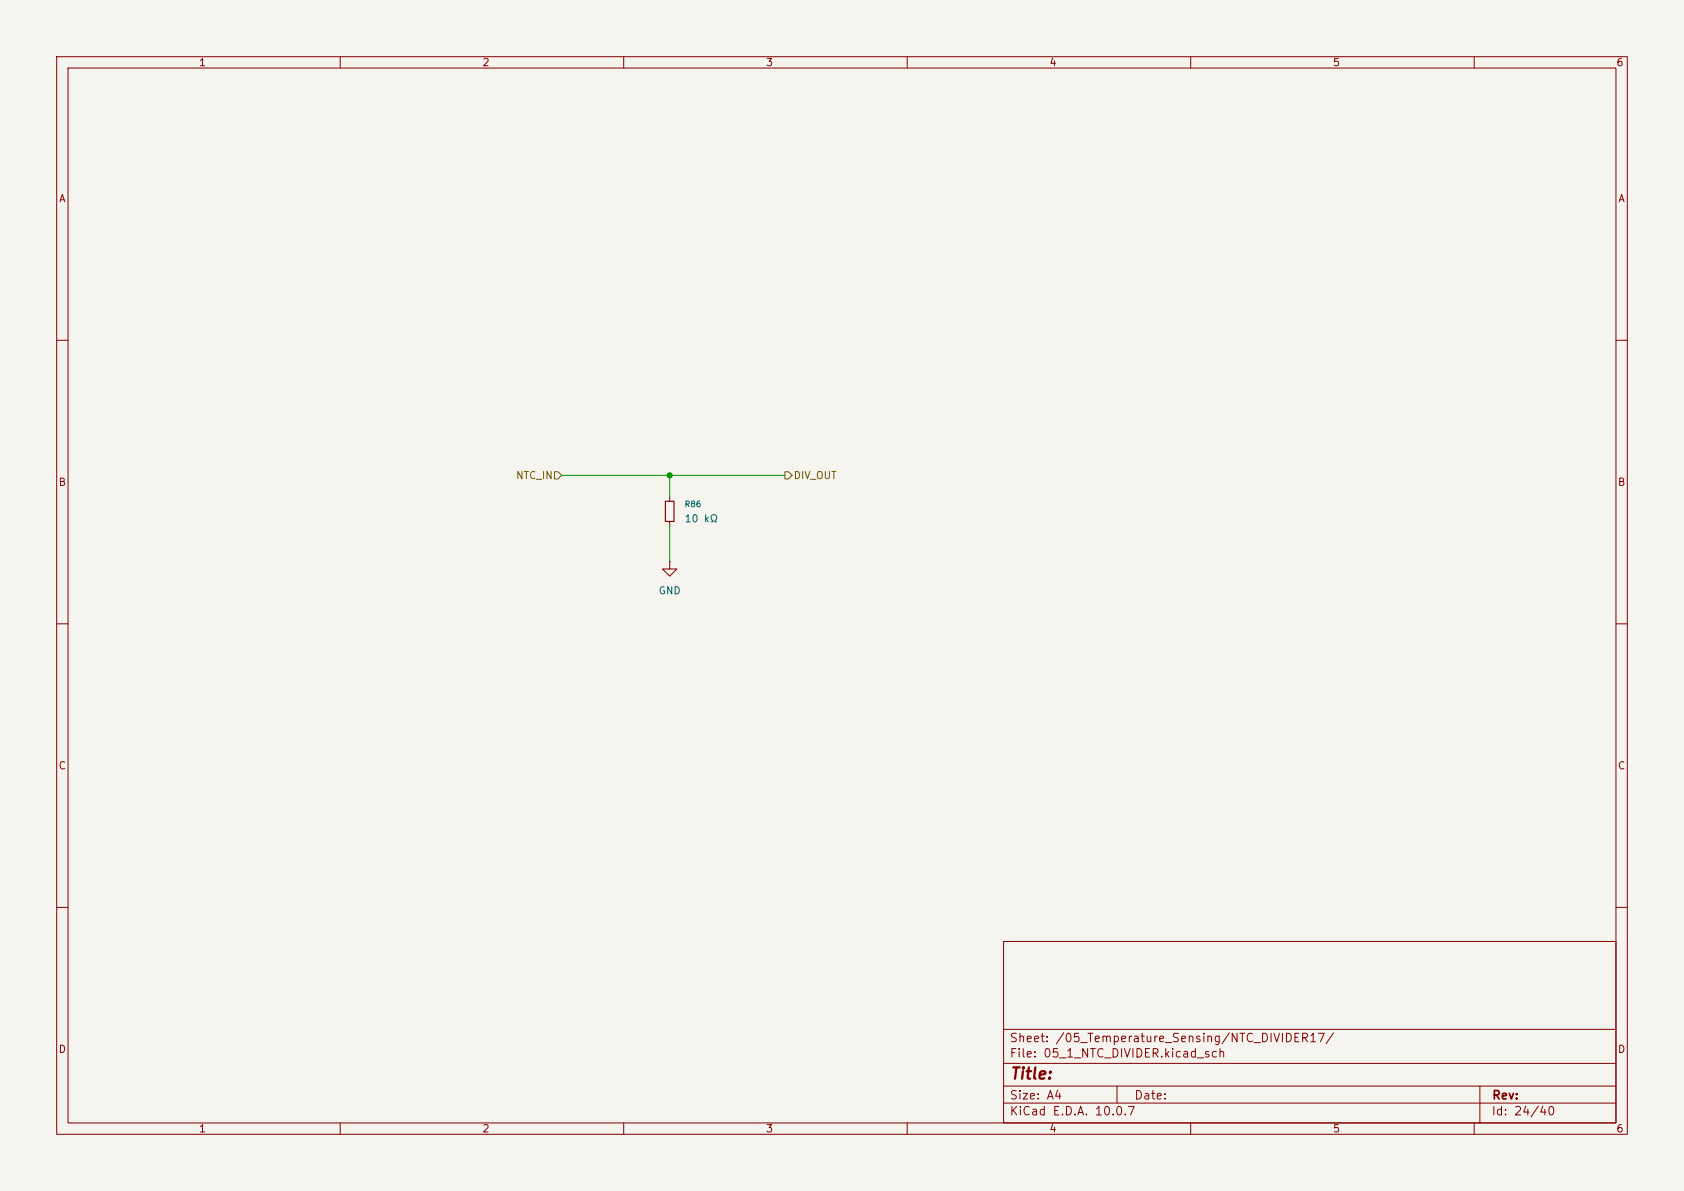
[picture p23: page 23]

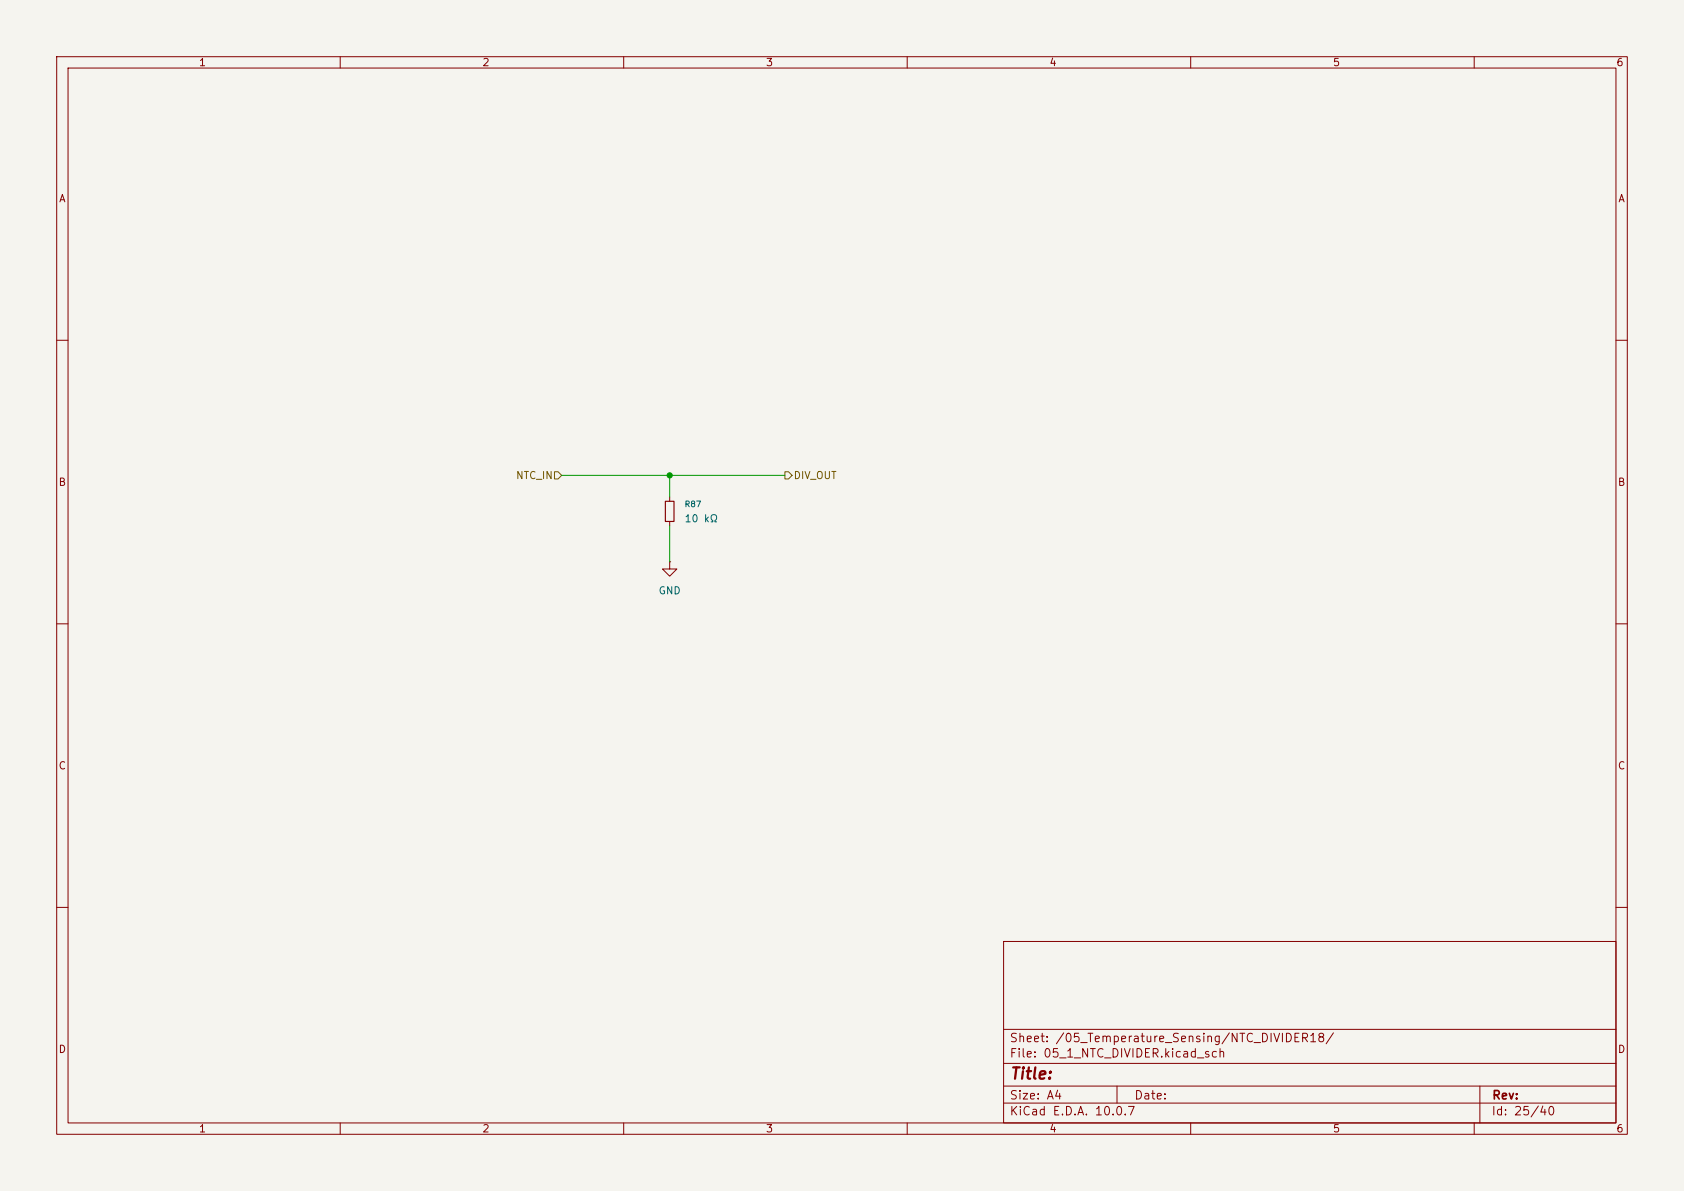
[picture p24: page 24]

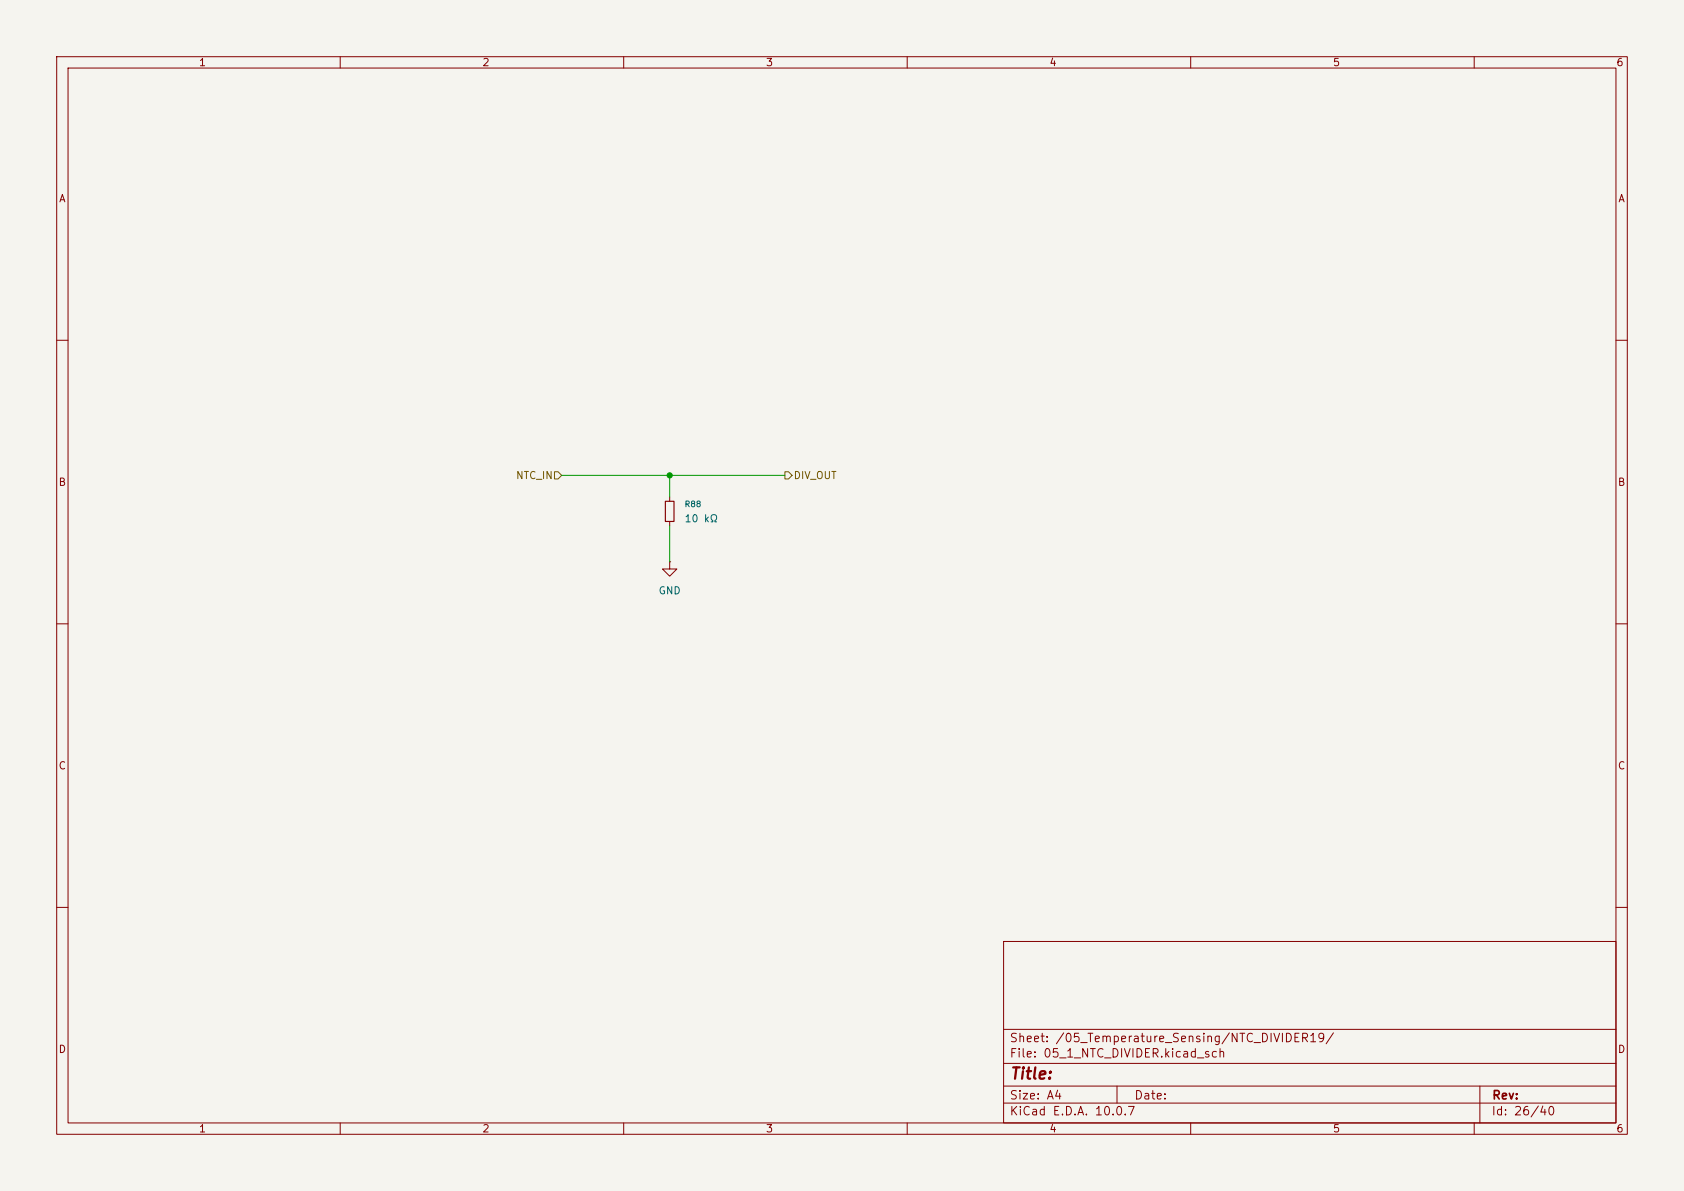
[picture p25: page 25]

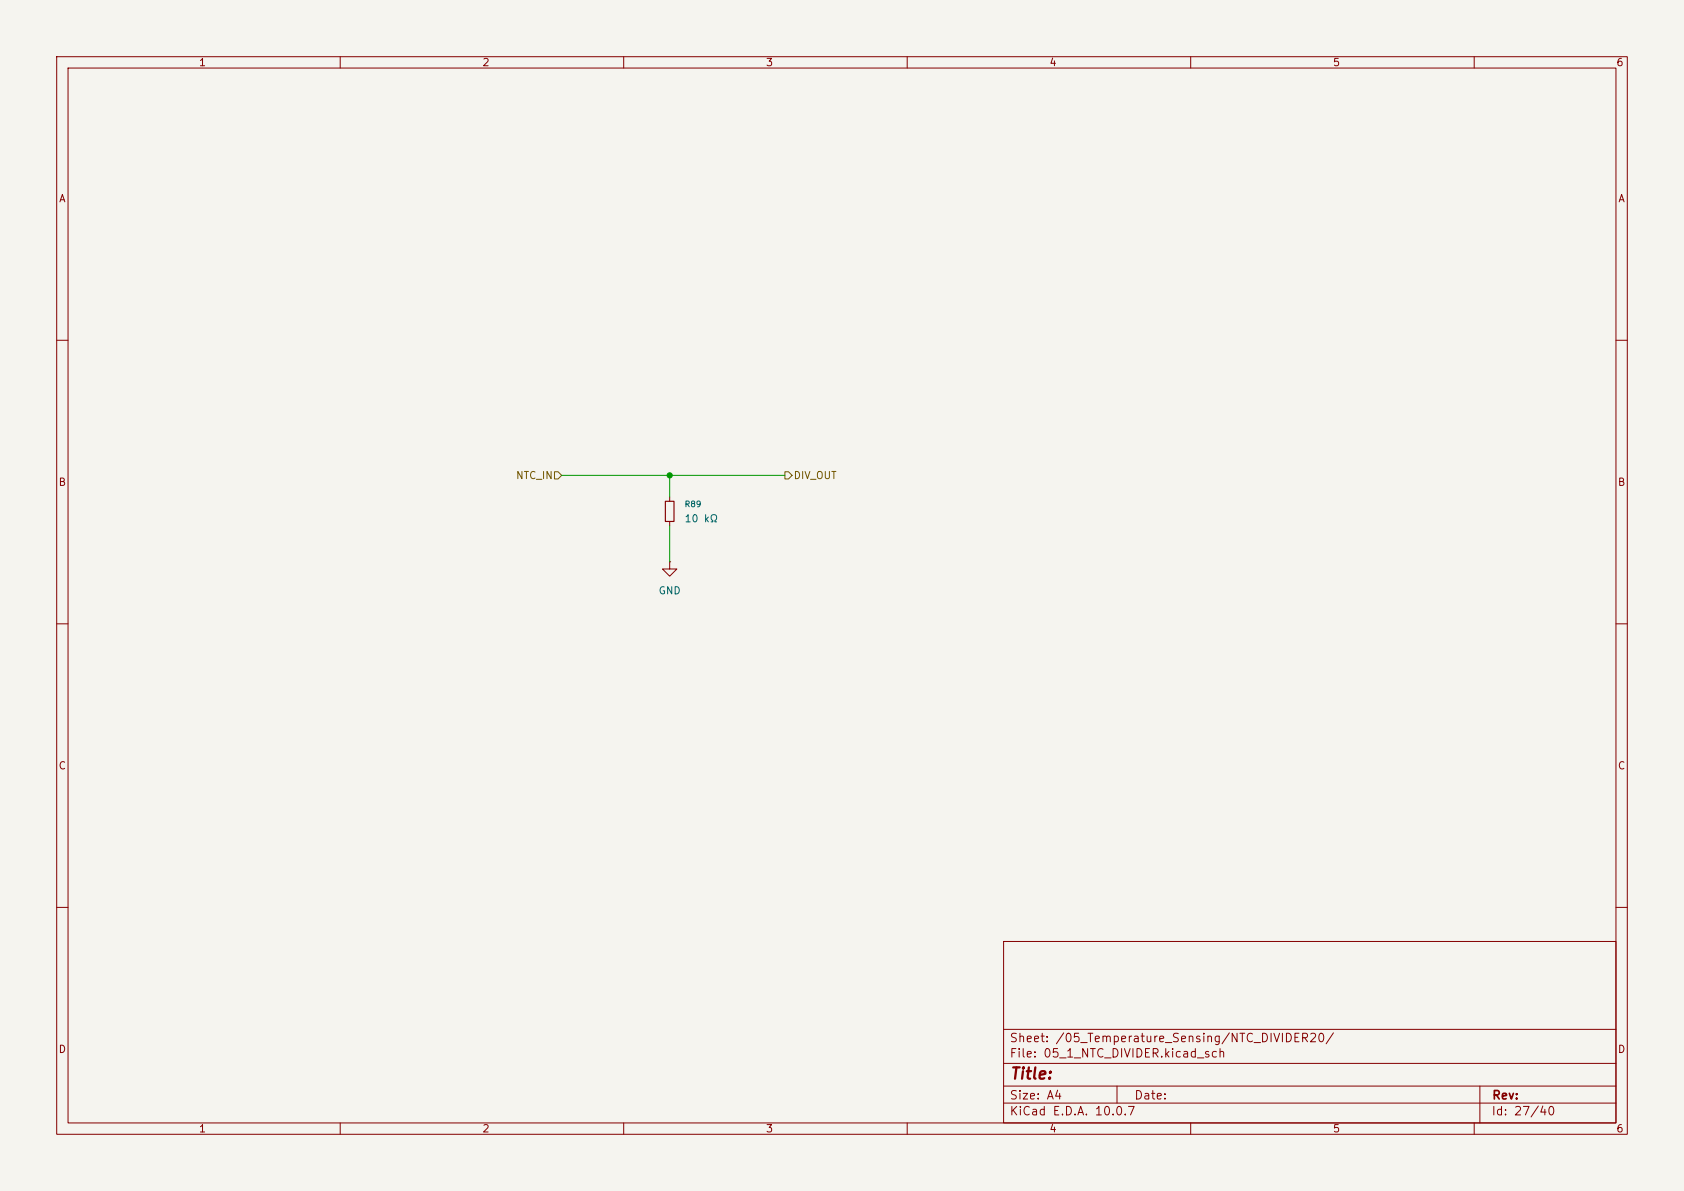
[picture p26: page 26]

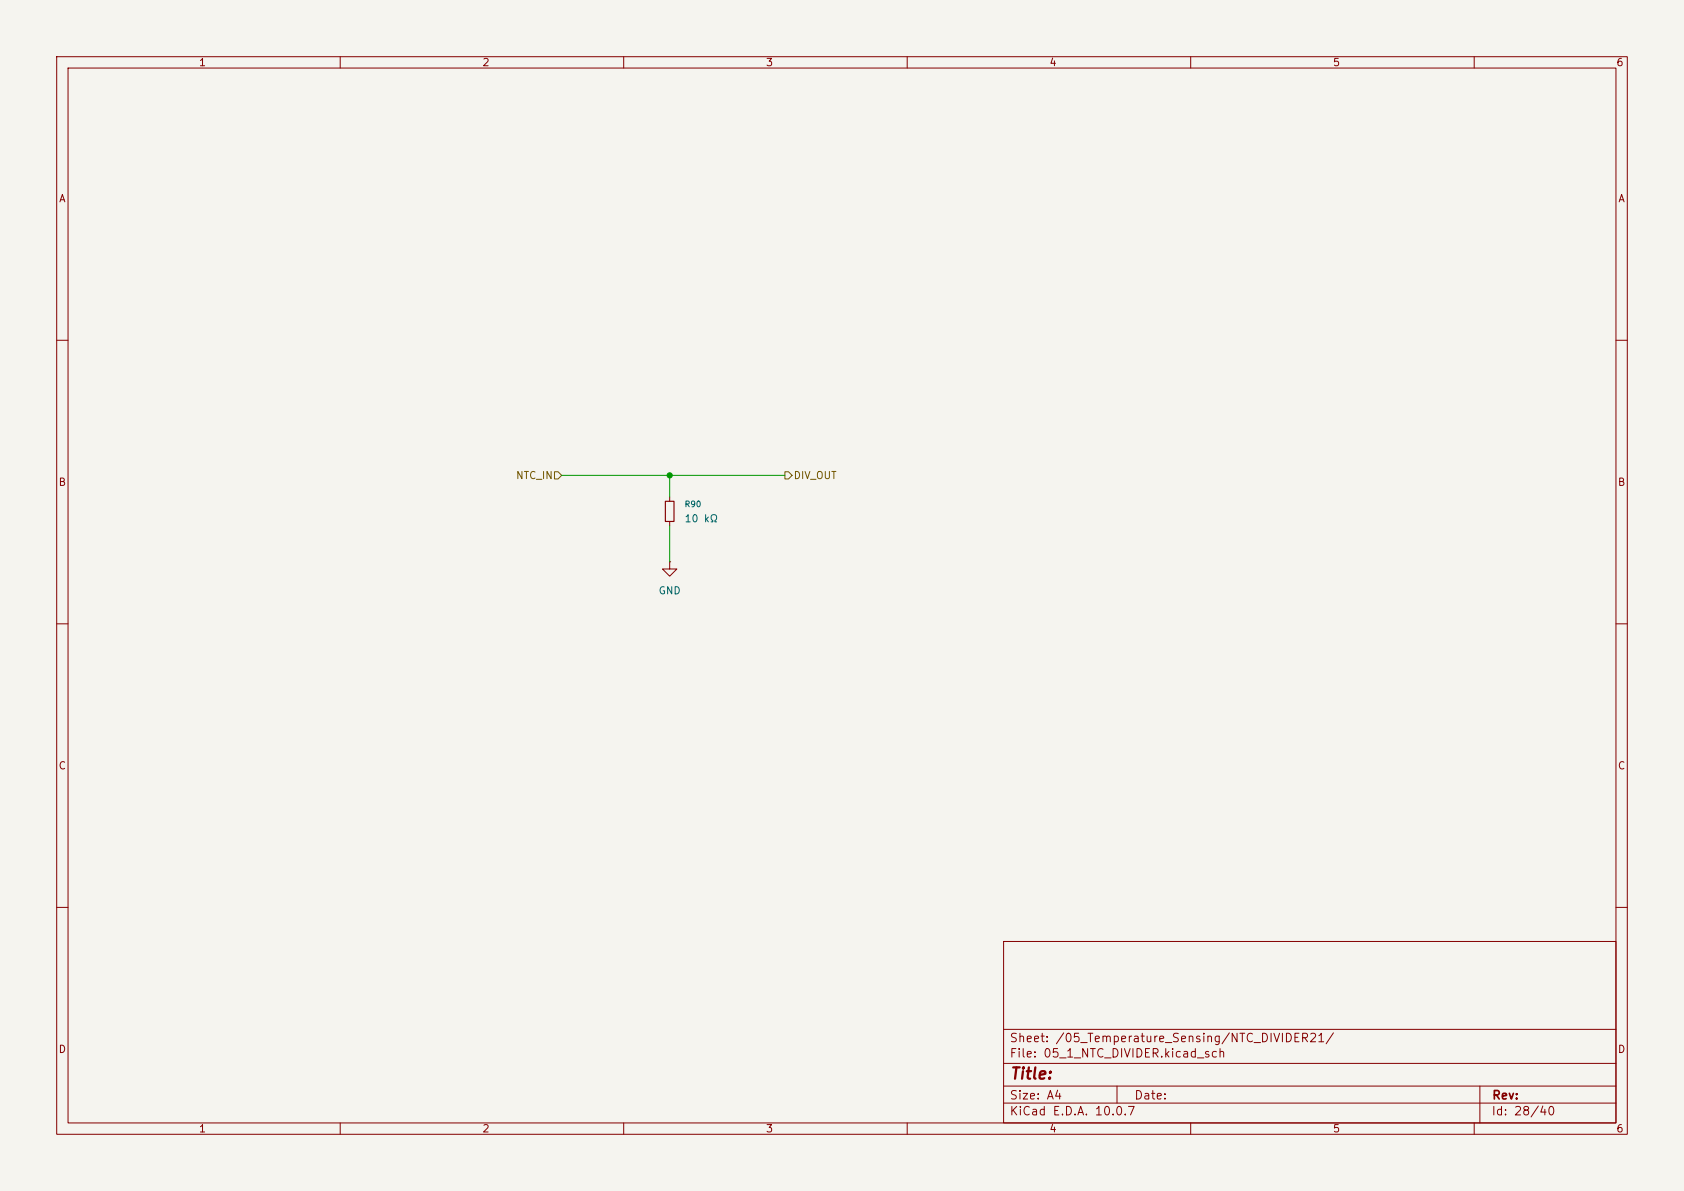
[picture p27: page 27]

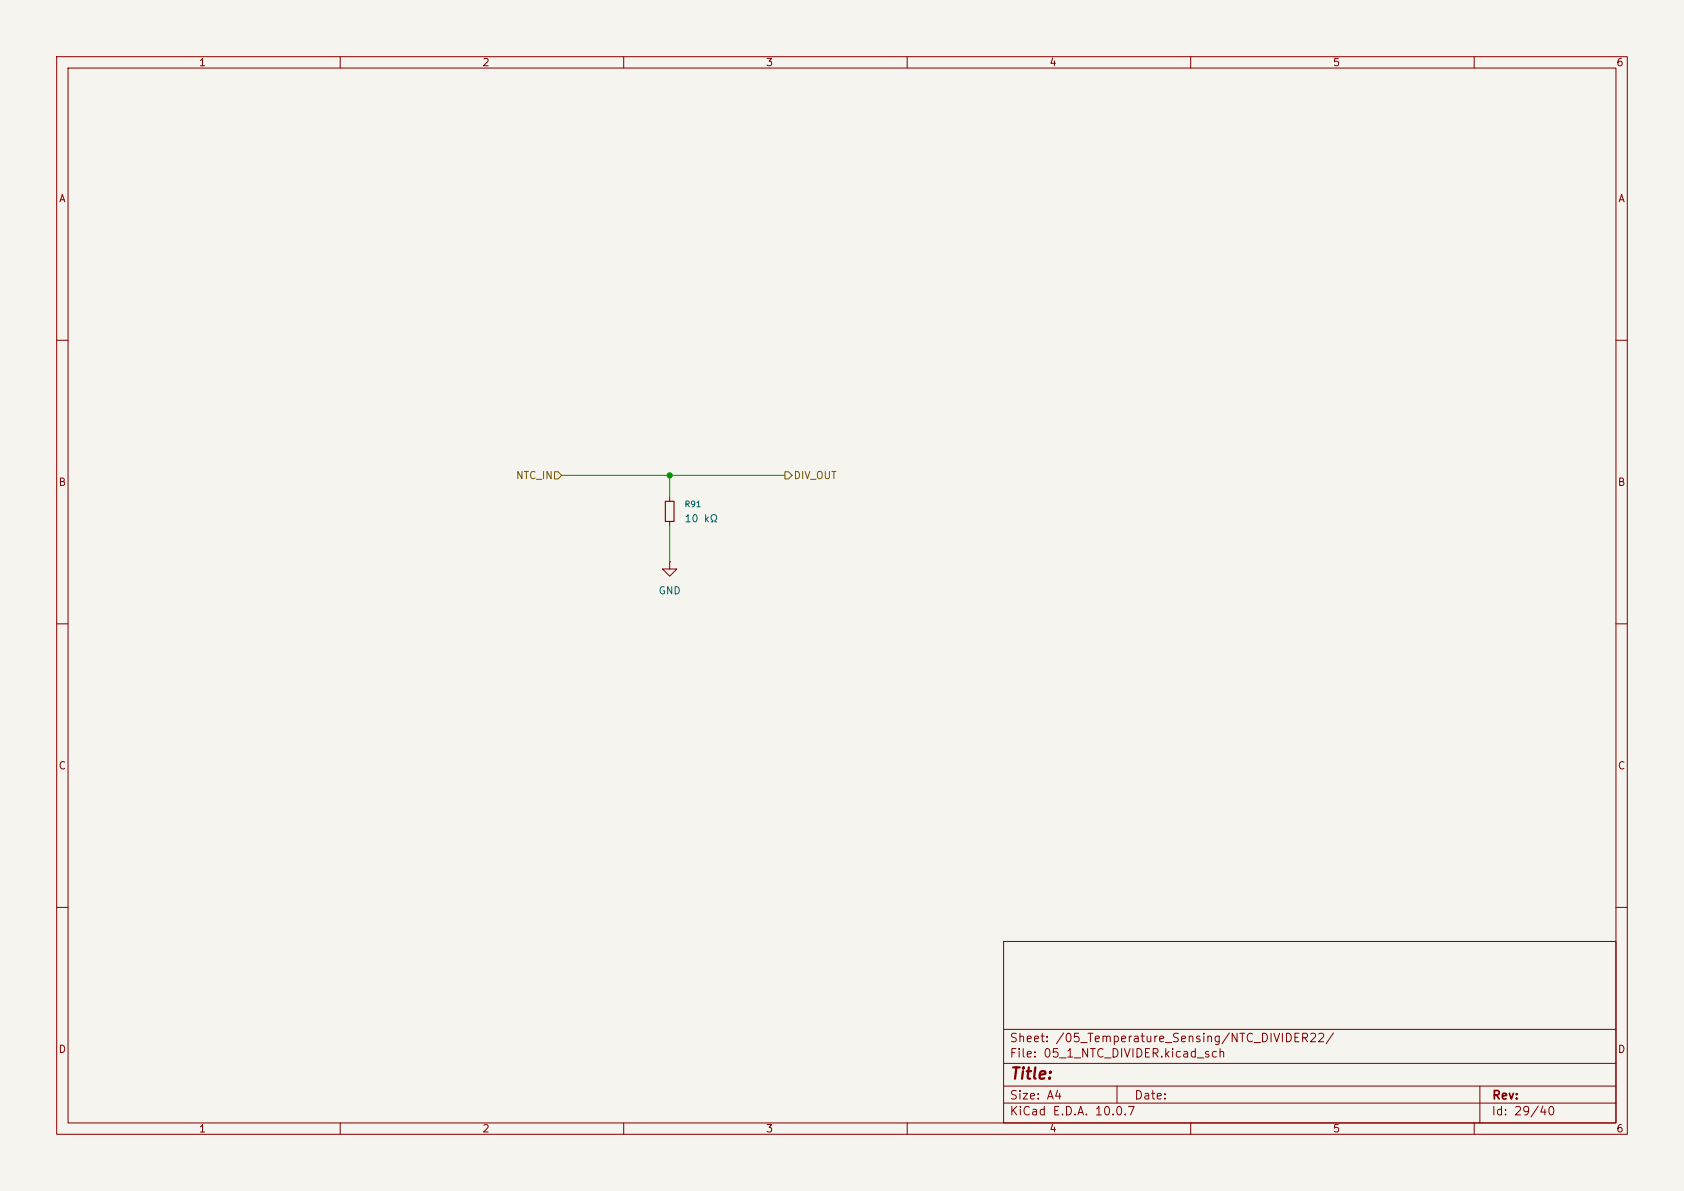
[picture p28: page 28]

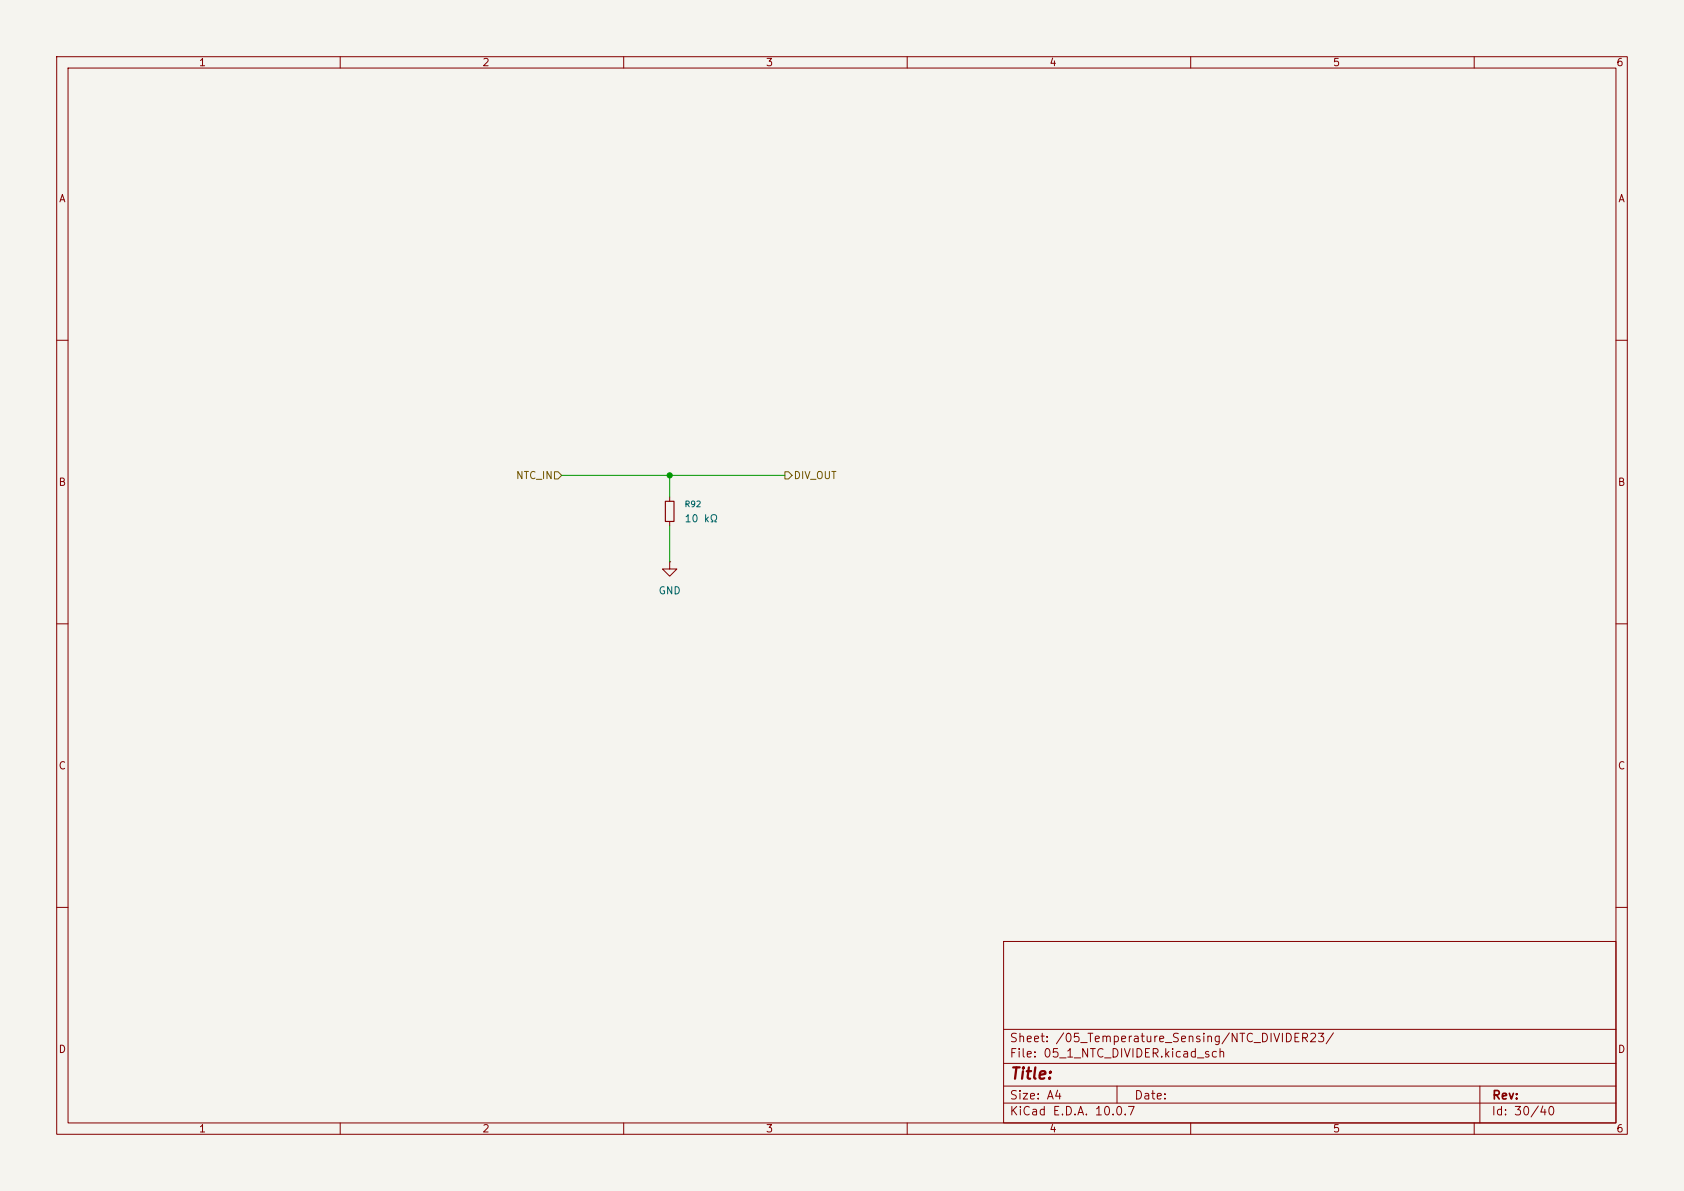
[picture p29: page 29]

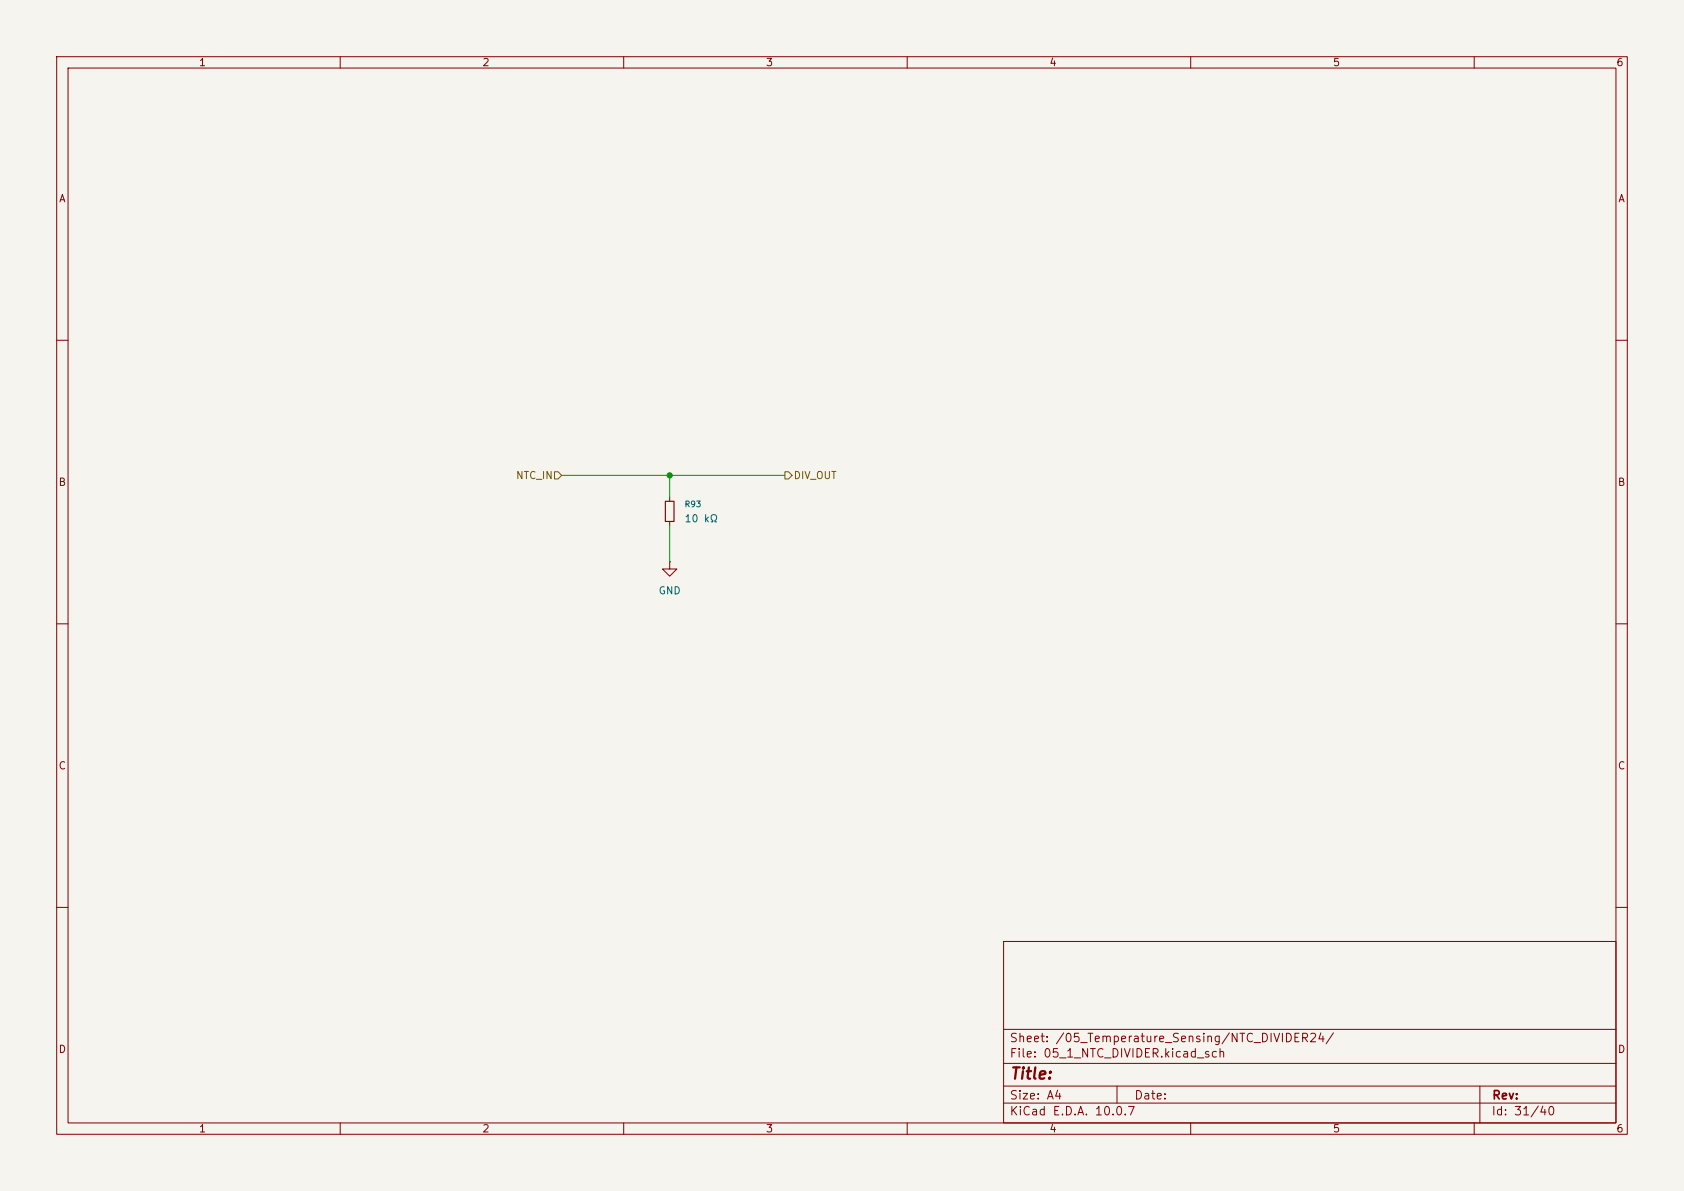
[picture p30: page 30]

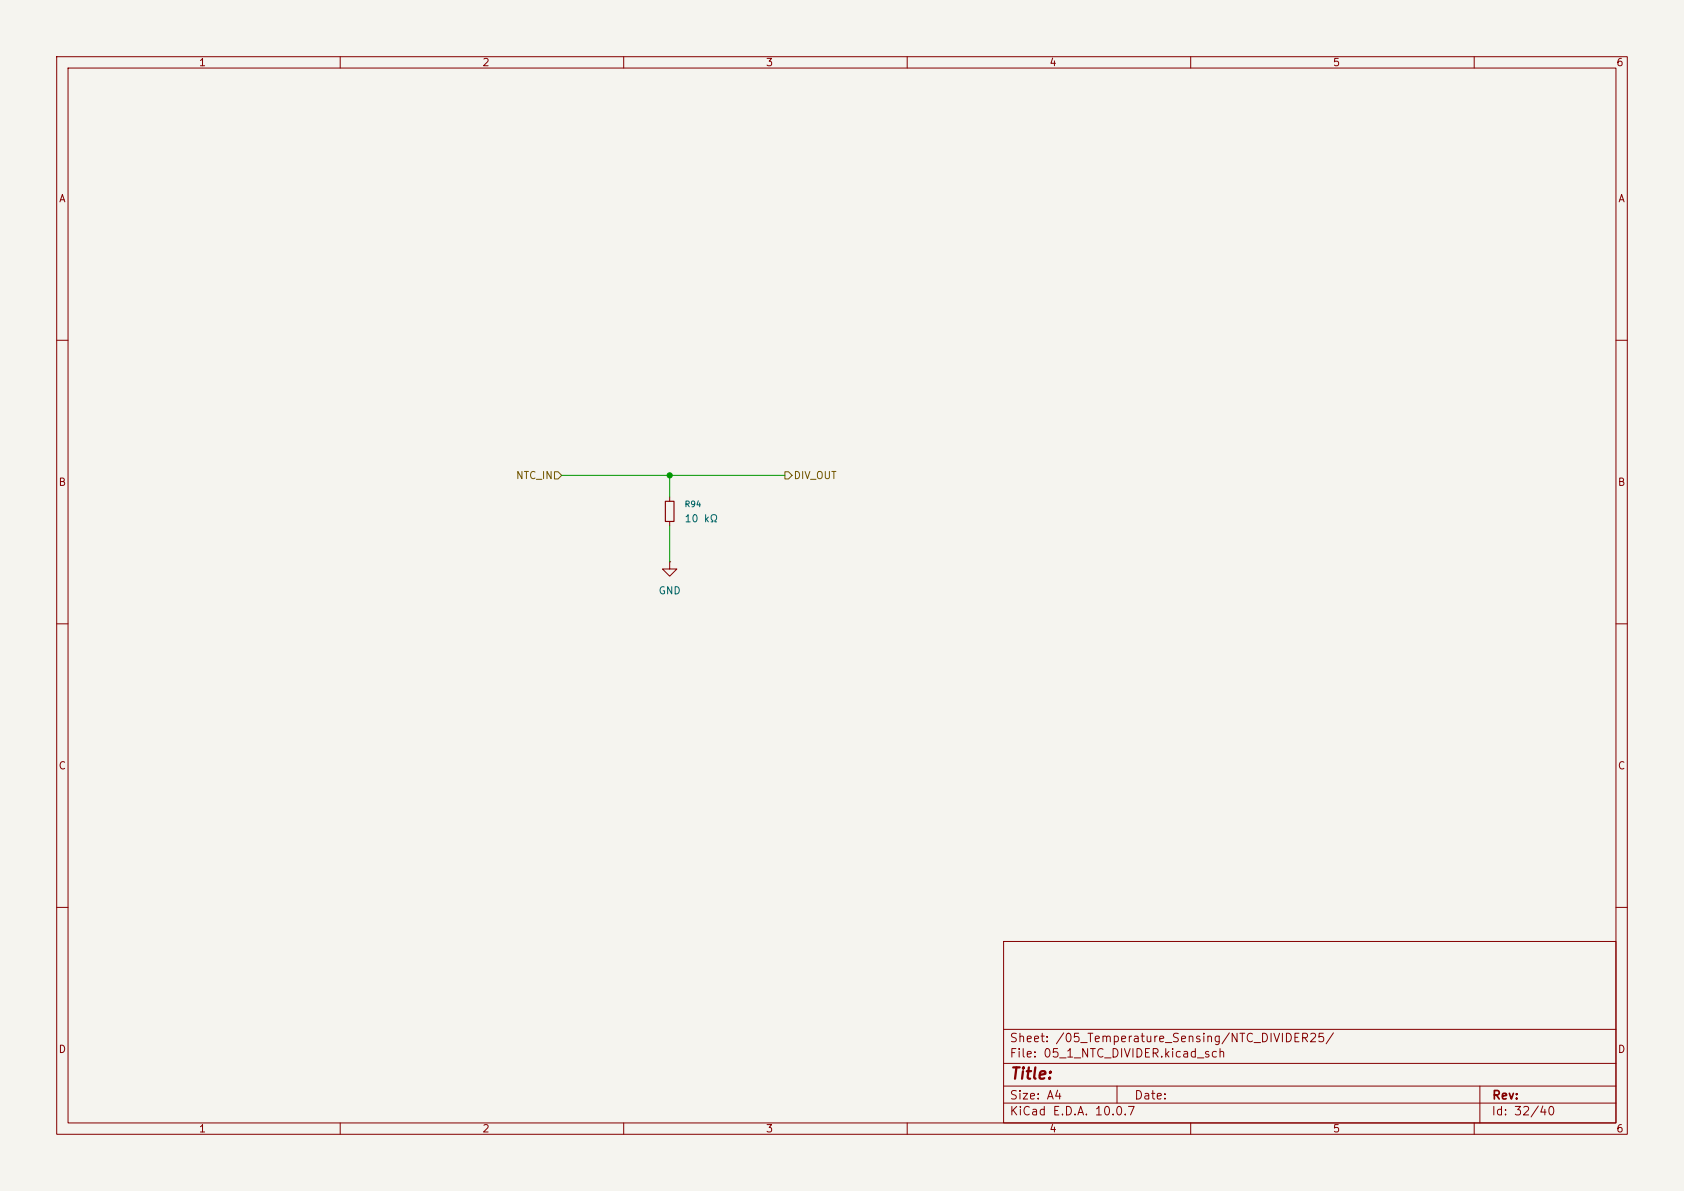
[picture p31: page 31]

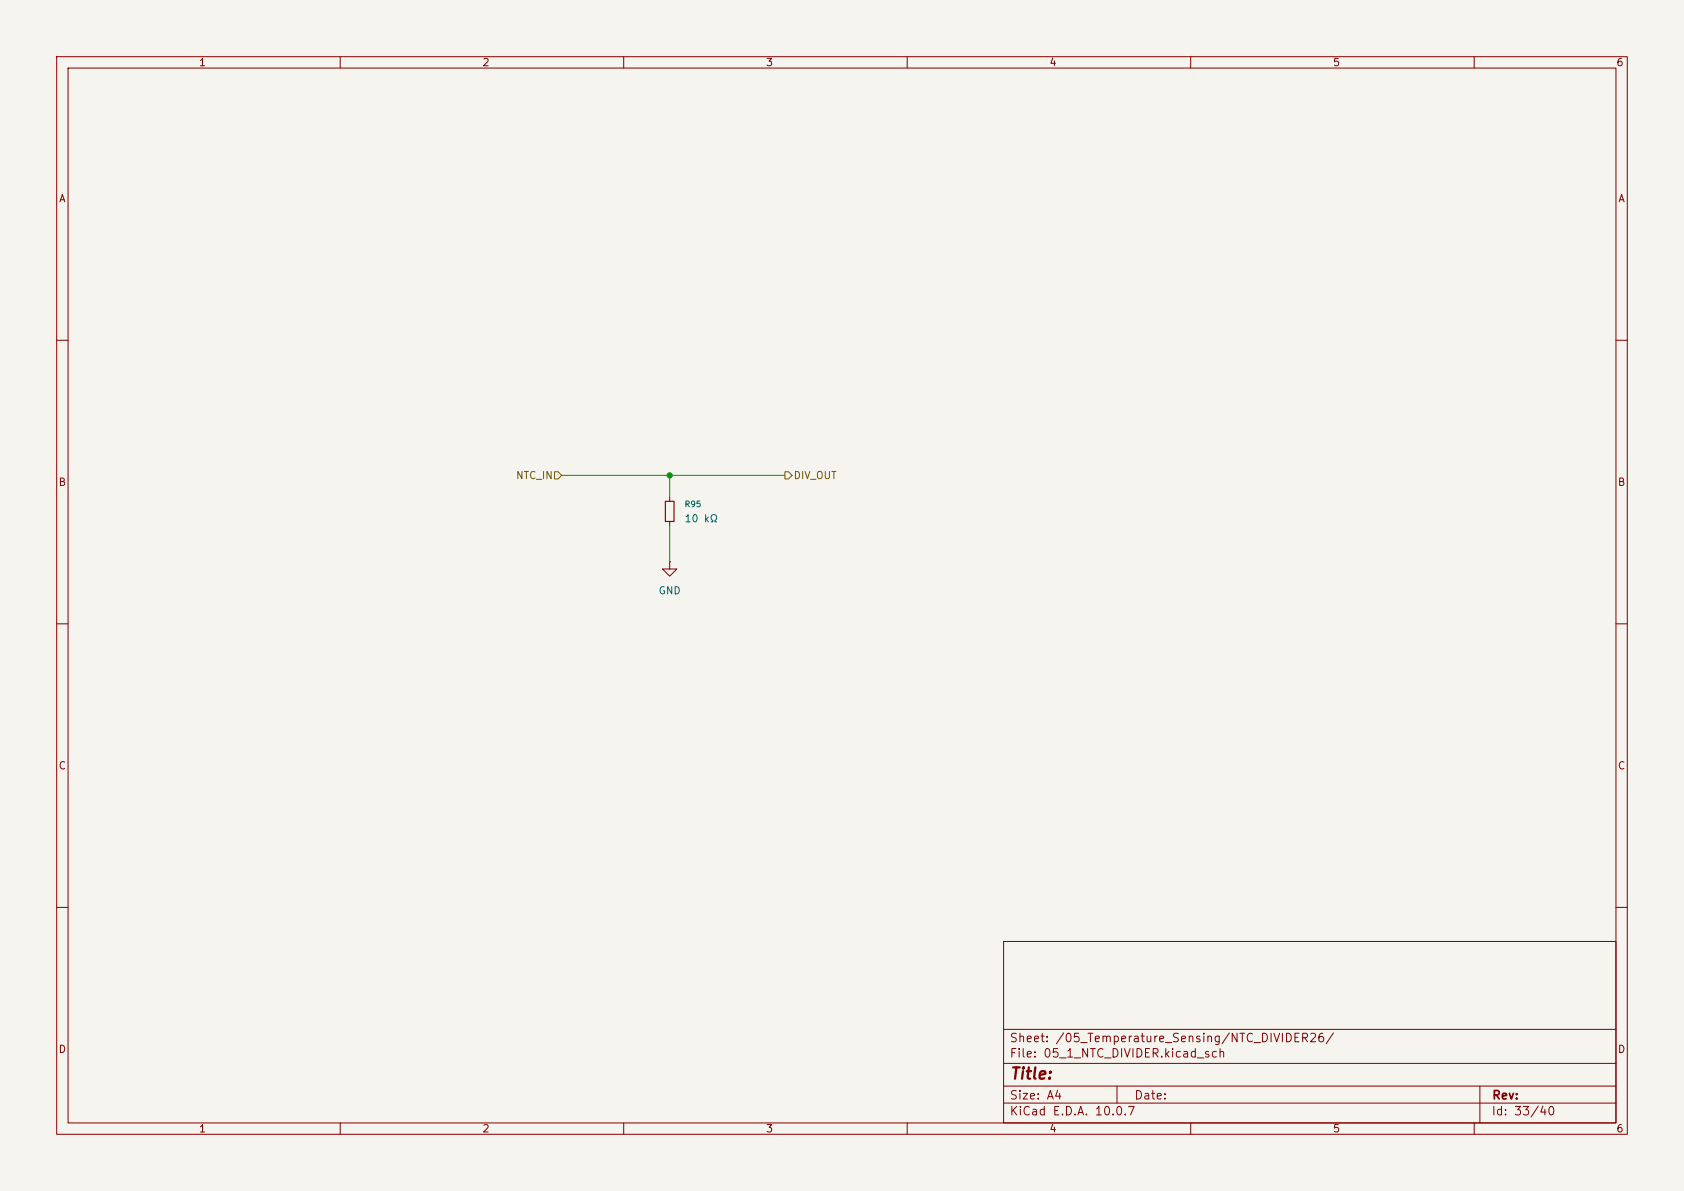
[picture p32: page 32]

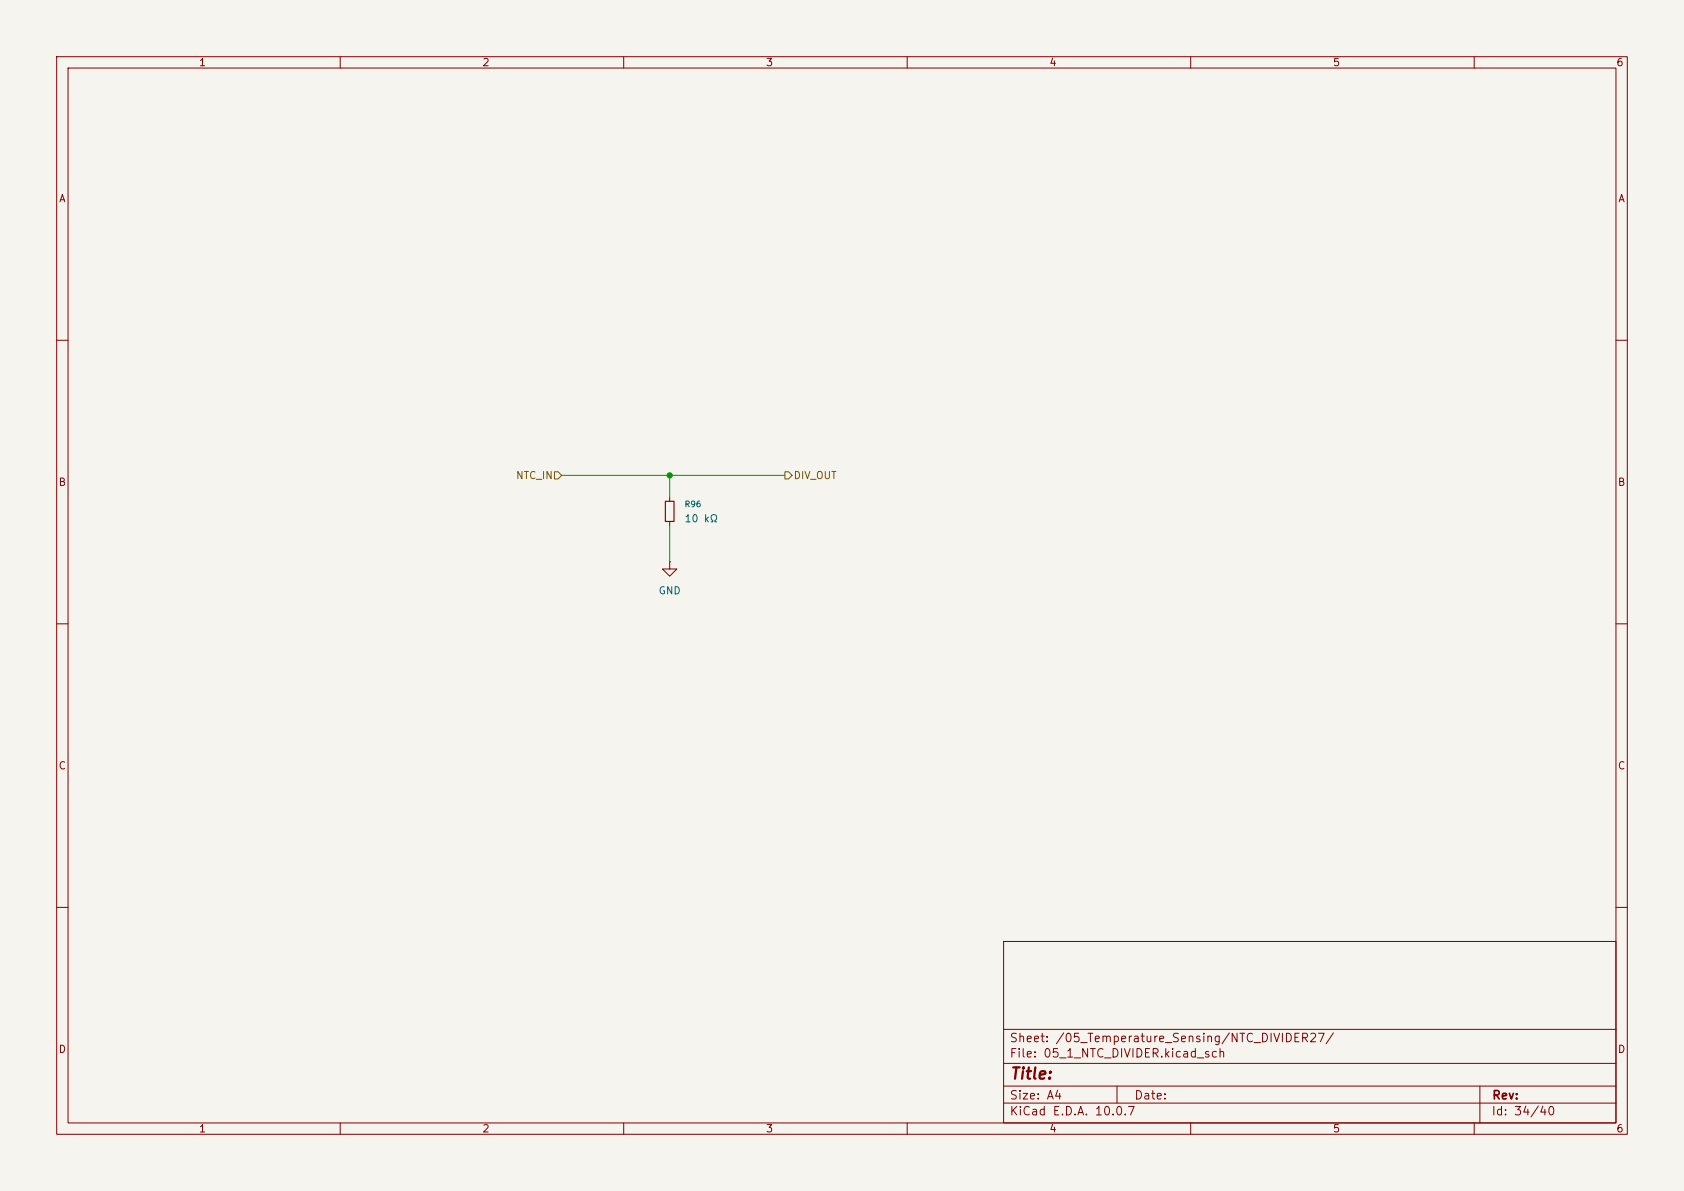
[picture p33: page 33]

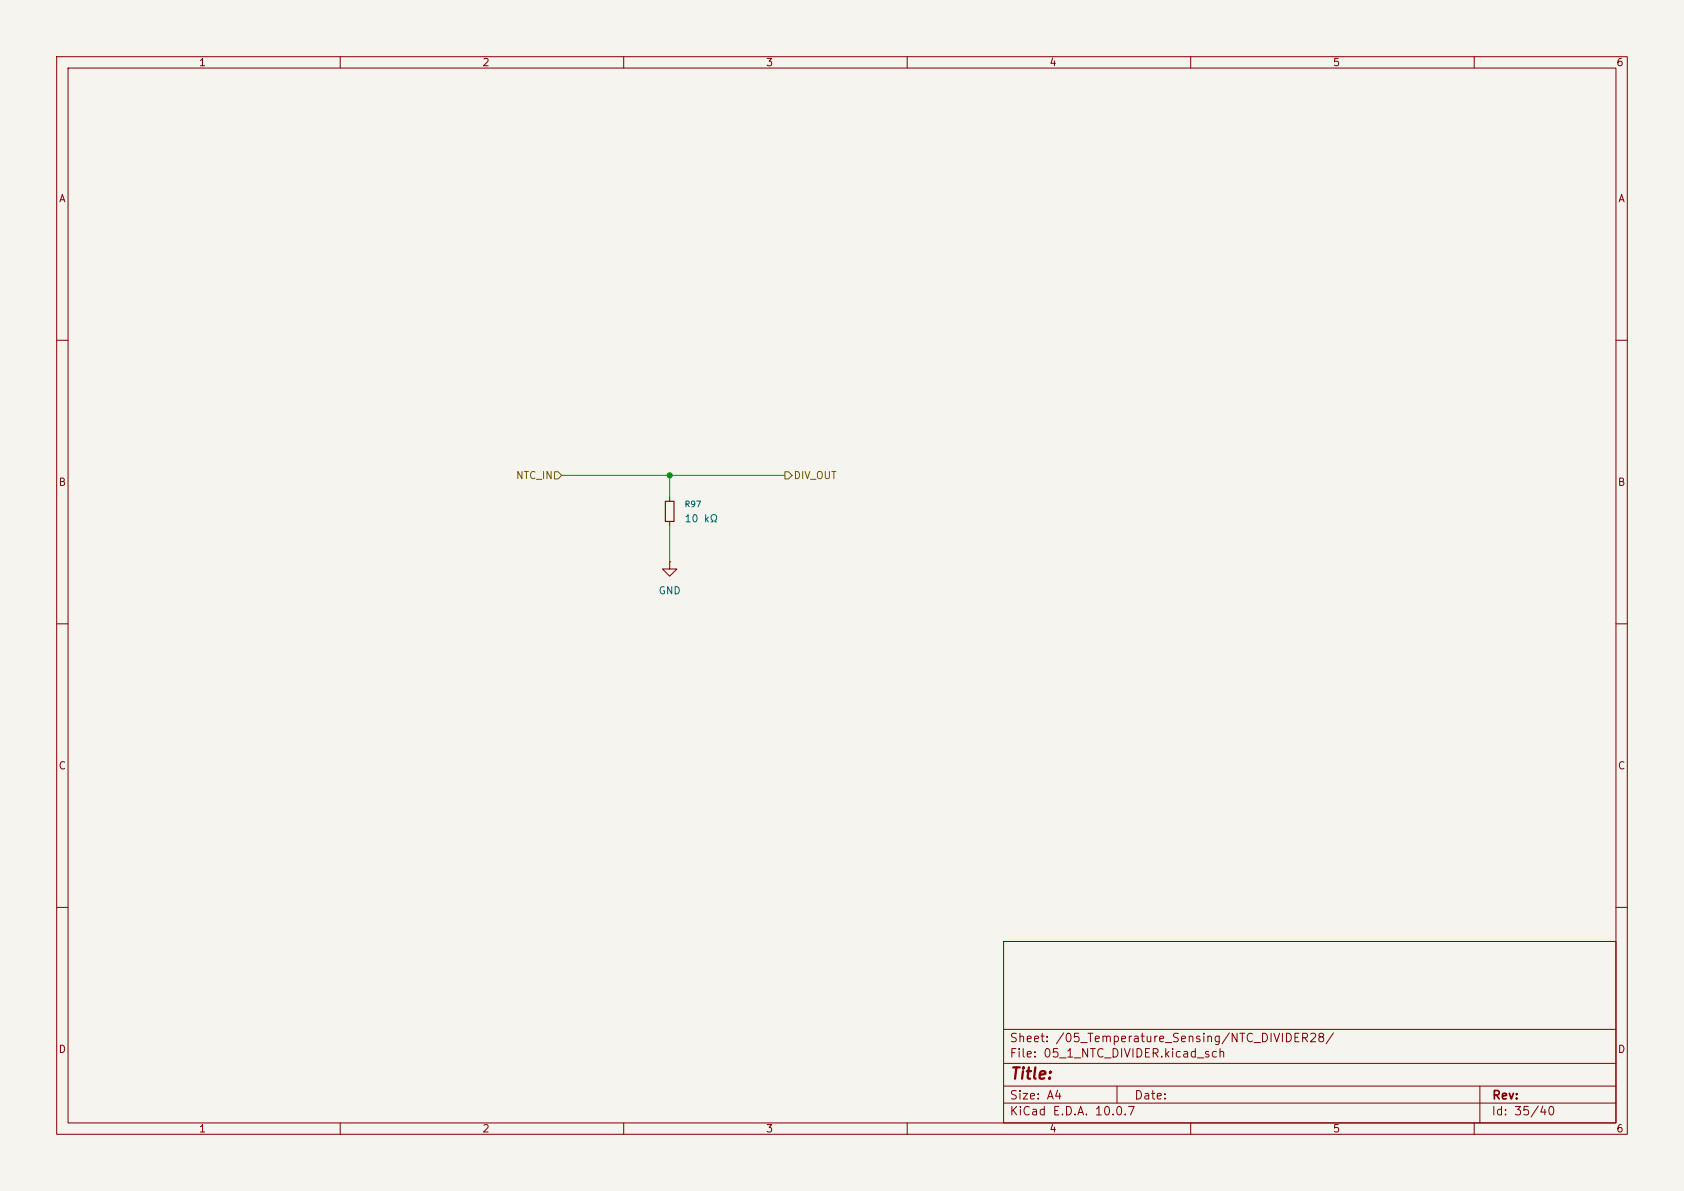
[picture p34: page 34]

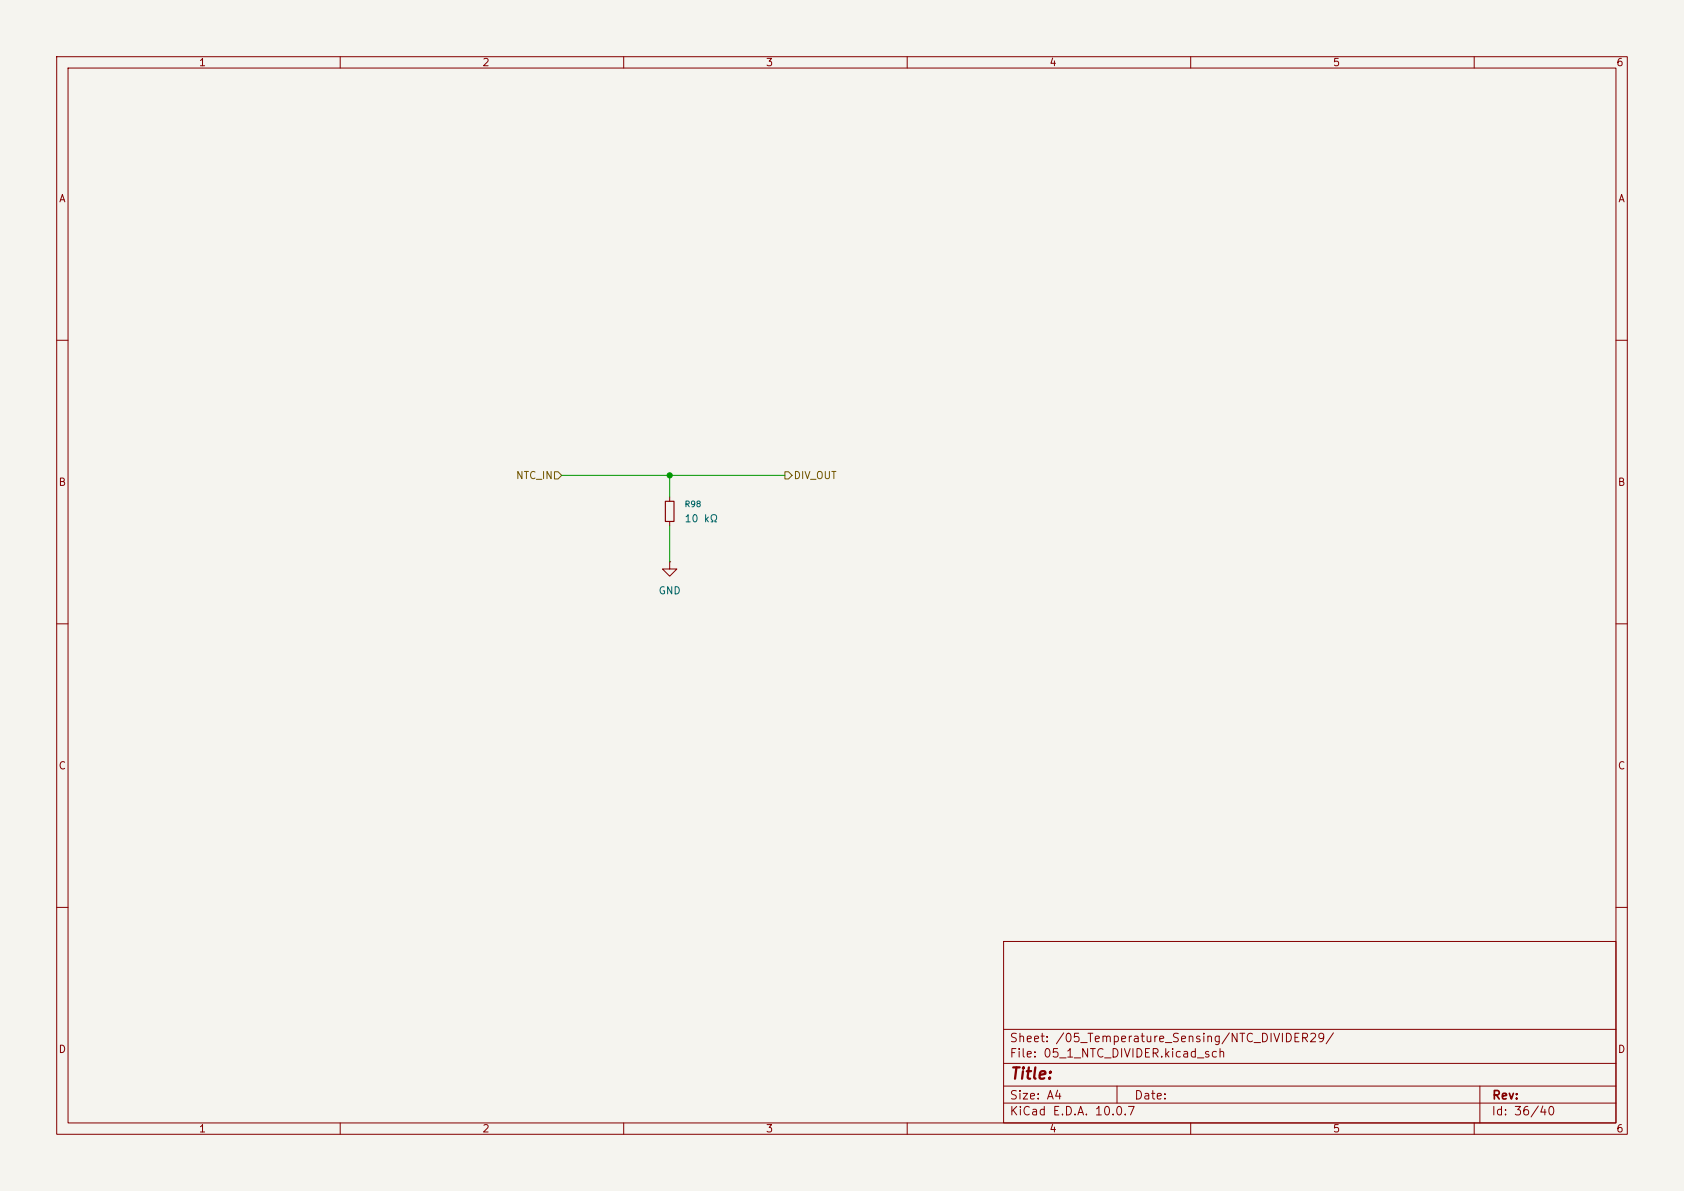
[picture p35: page 35]

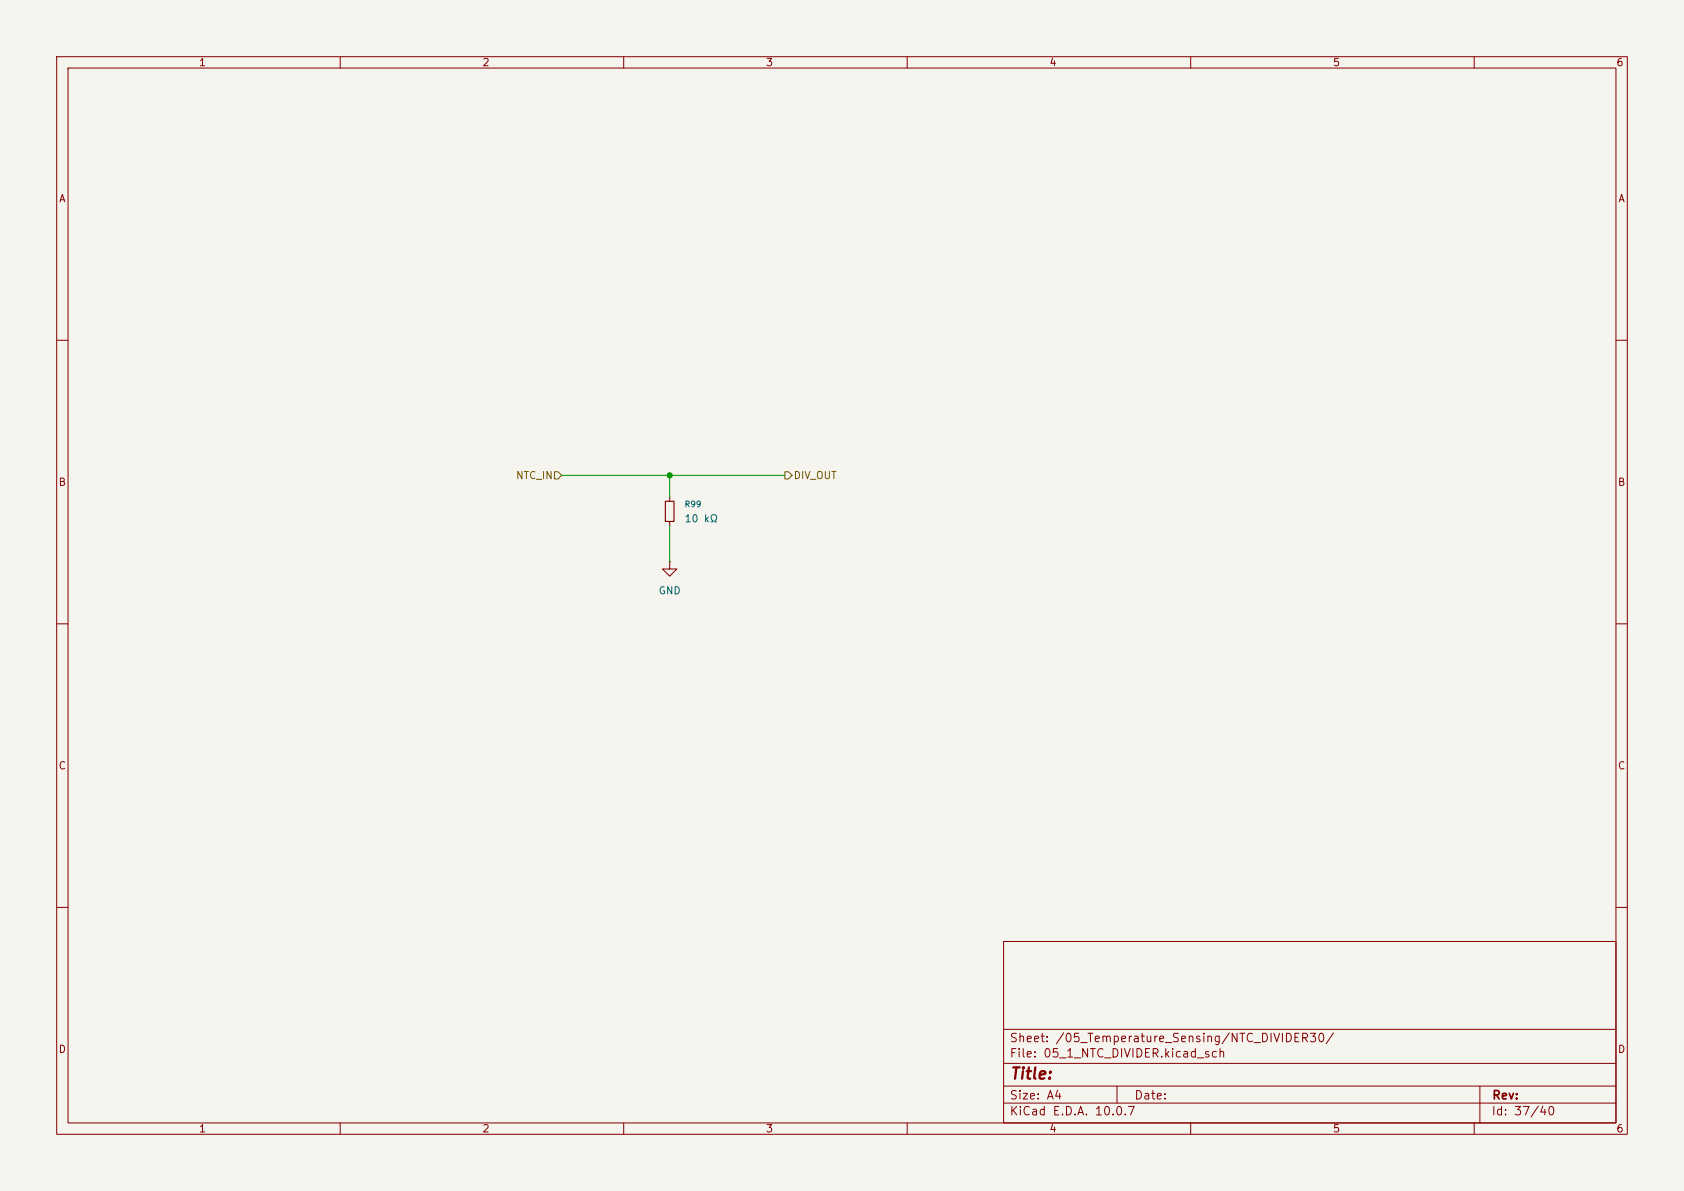
[picture p36: page 36]

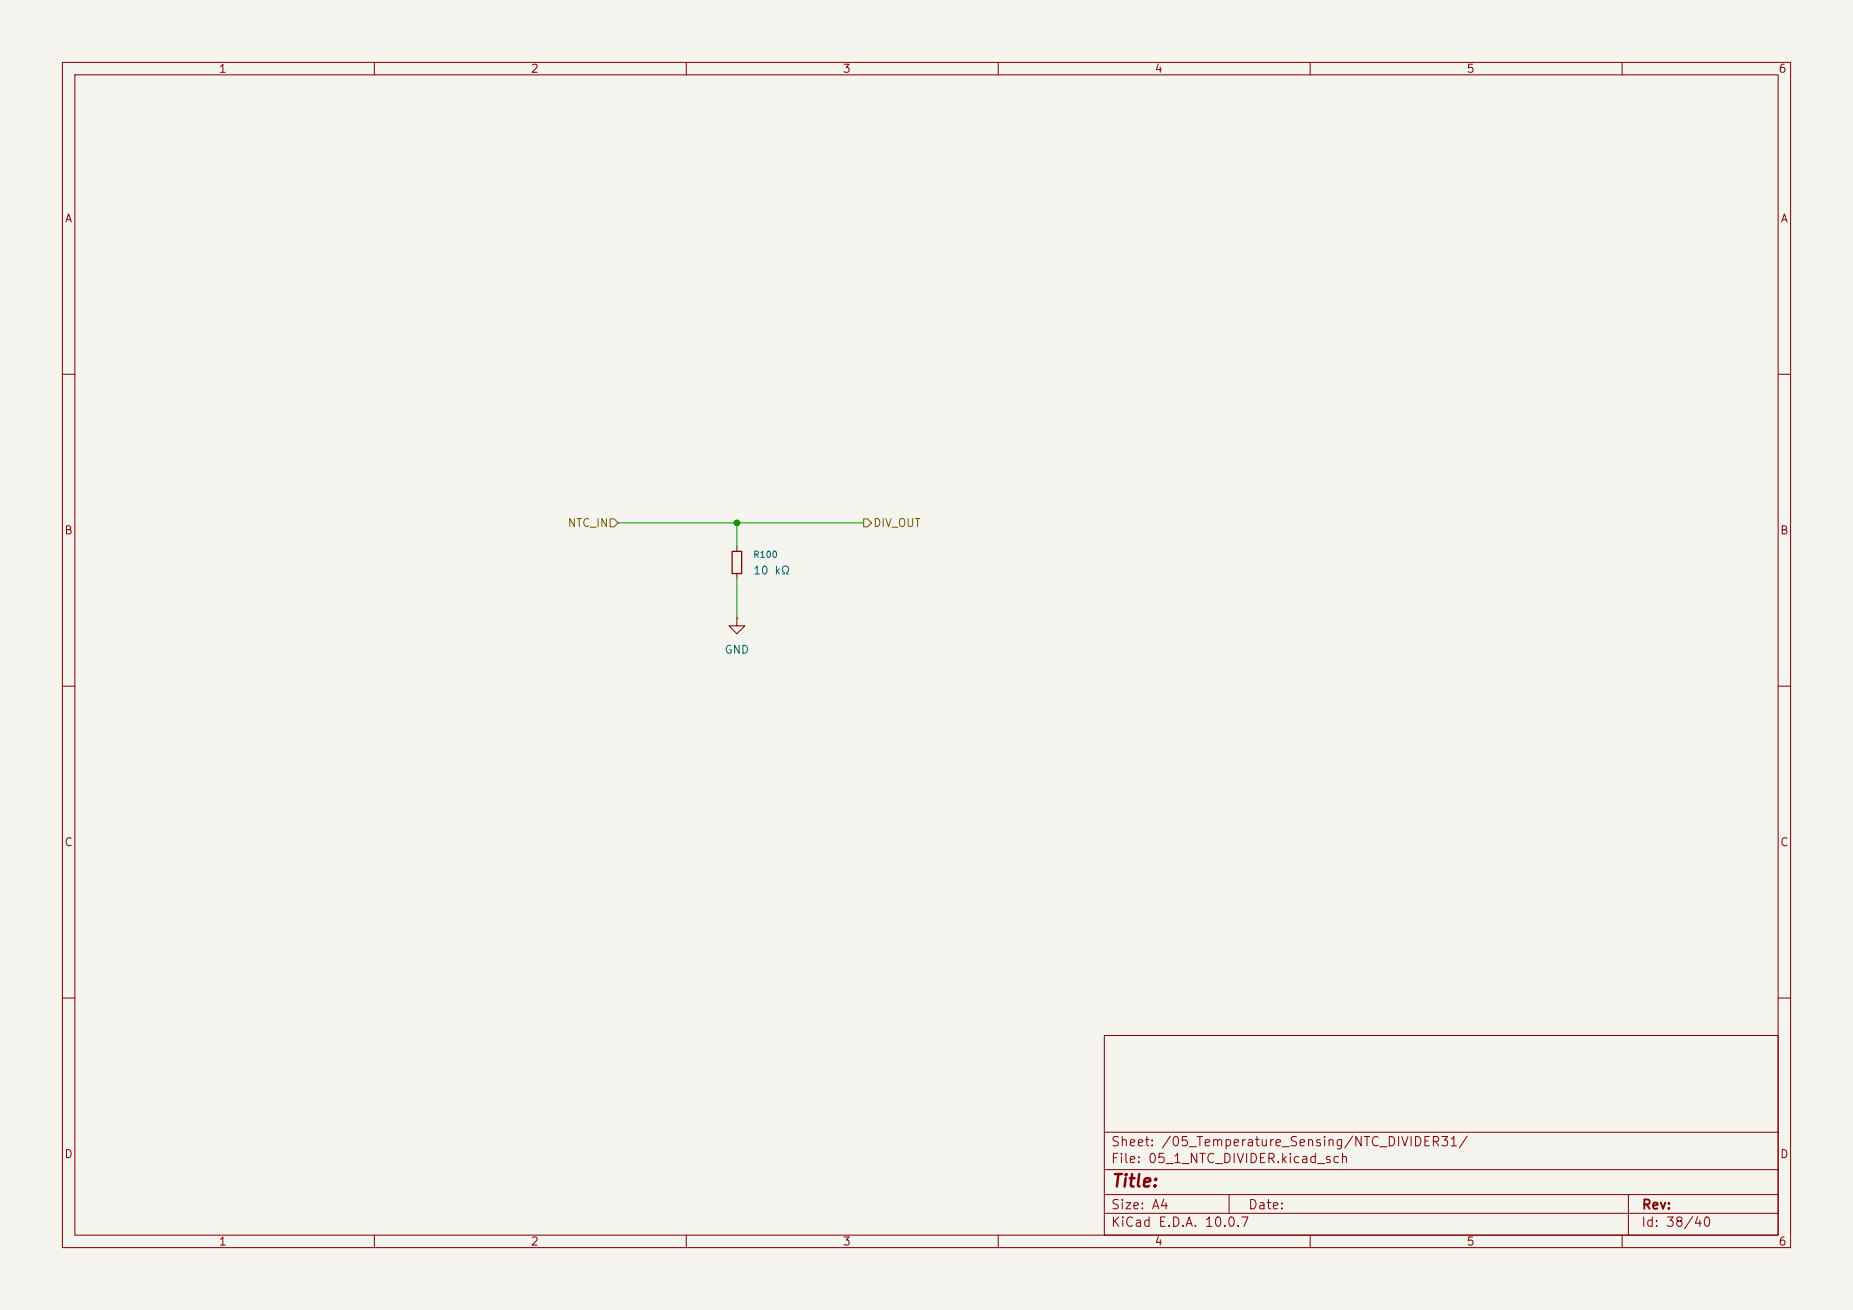
[picture p37: page 37]

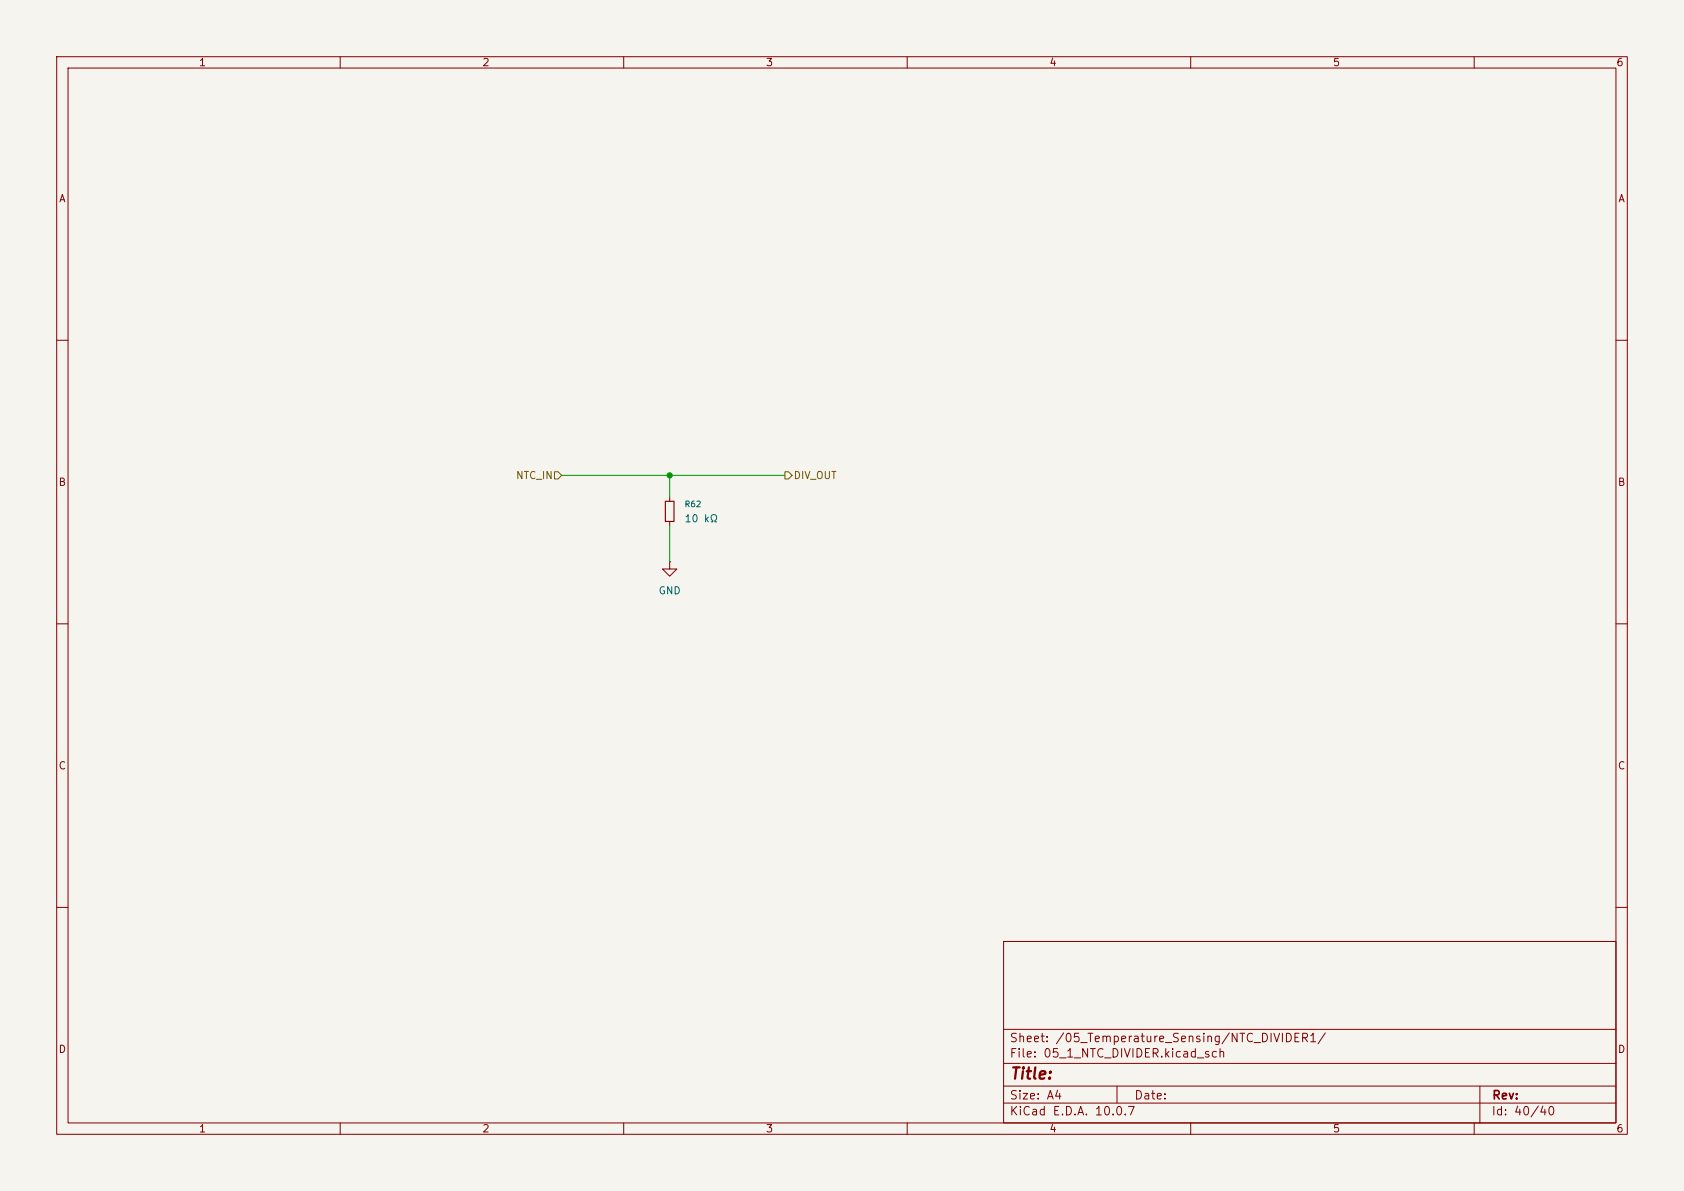
[picture p38: page 38]

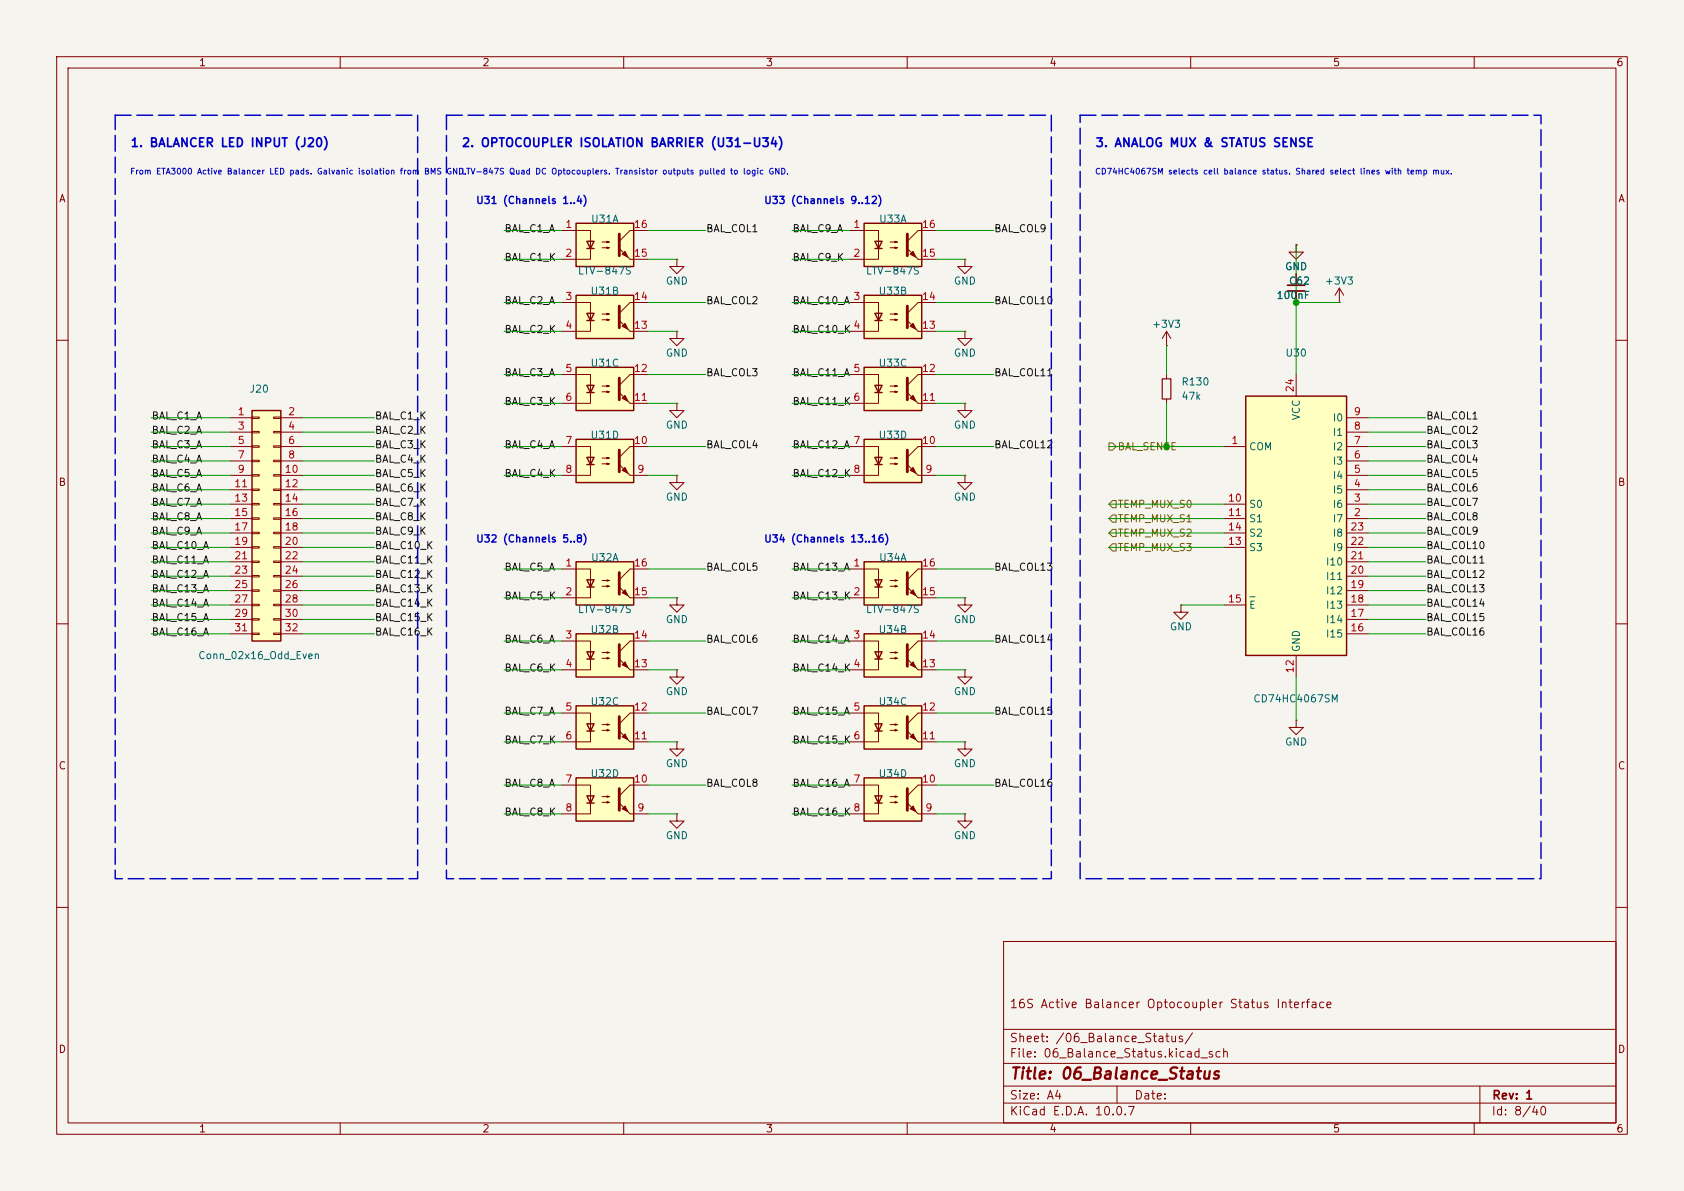
[picture p39: page 39]

CD74HC4067SM selects cell balance status. Shared select lines with temp mux. GND

16S Active Balancer Optocoupler Status Interface

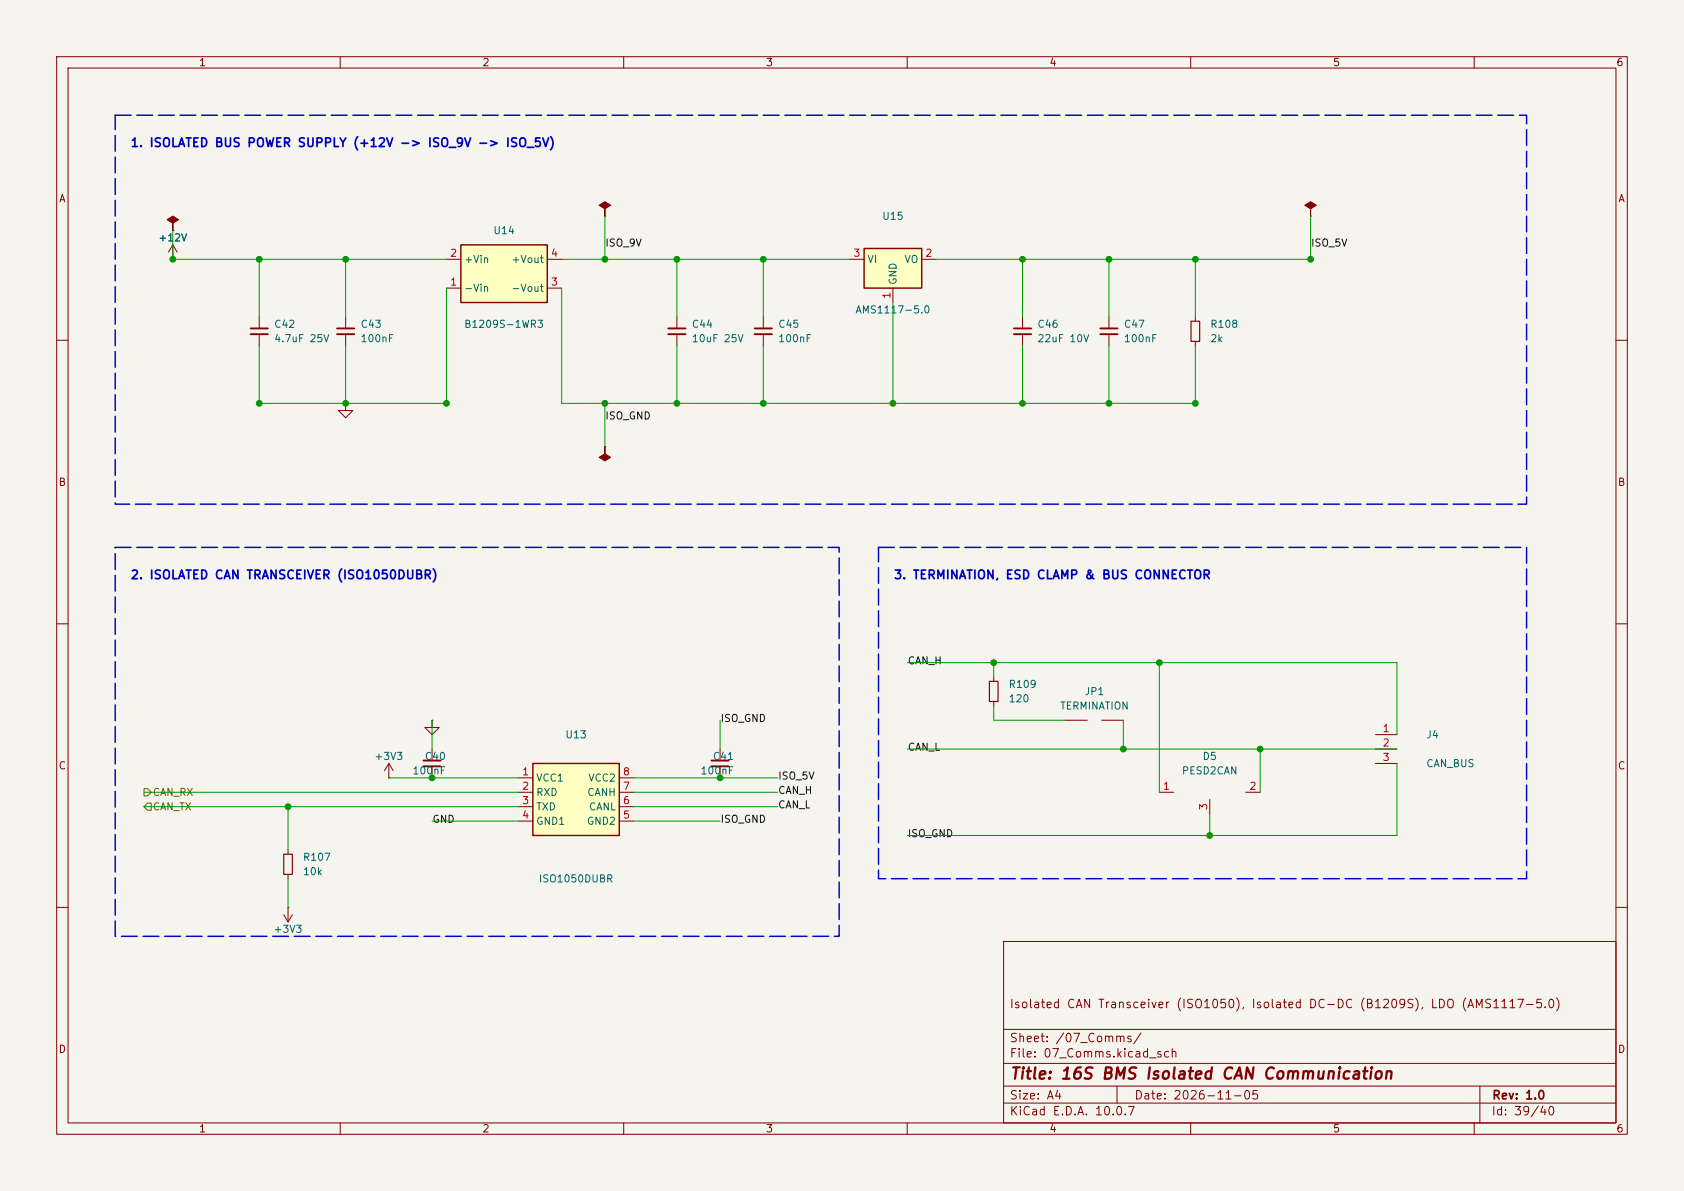
[picture p40: page 40]

1. ISOLATED BUS POWER SUPPLY (+12V -> ISO_9V -> ISO_5V) +12V

Isolated CAN Transceiver (ISO1050), Isolated DC-DC (B1209S), LDO (AMS1117-5.0)

Sheet: /07_Comms/
File: 07_Comms.kicad_sch
Title: 16S BMS Isolated CAN Communication
