koko69420/SmartBMS_Active-balancing/16s_BMS/16s_BMS_with_precharge.pdf

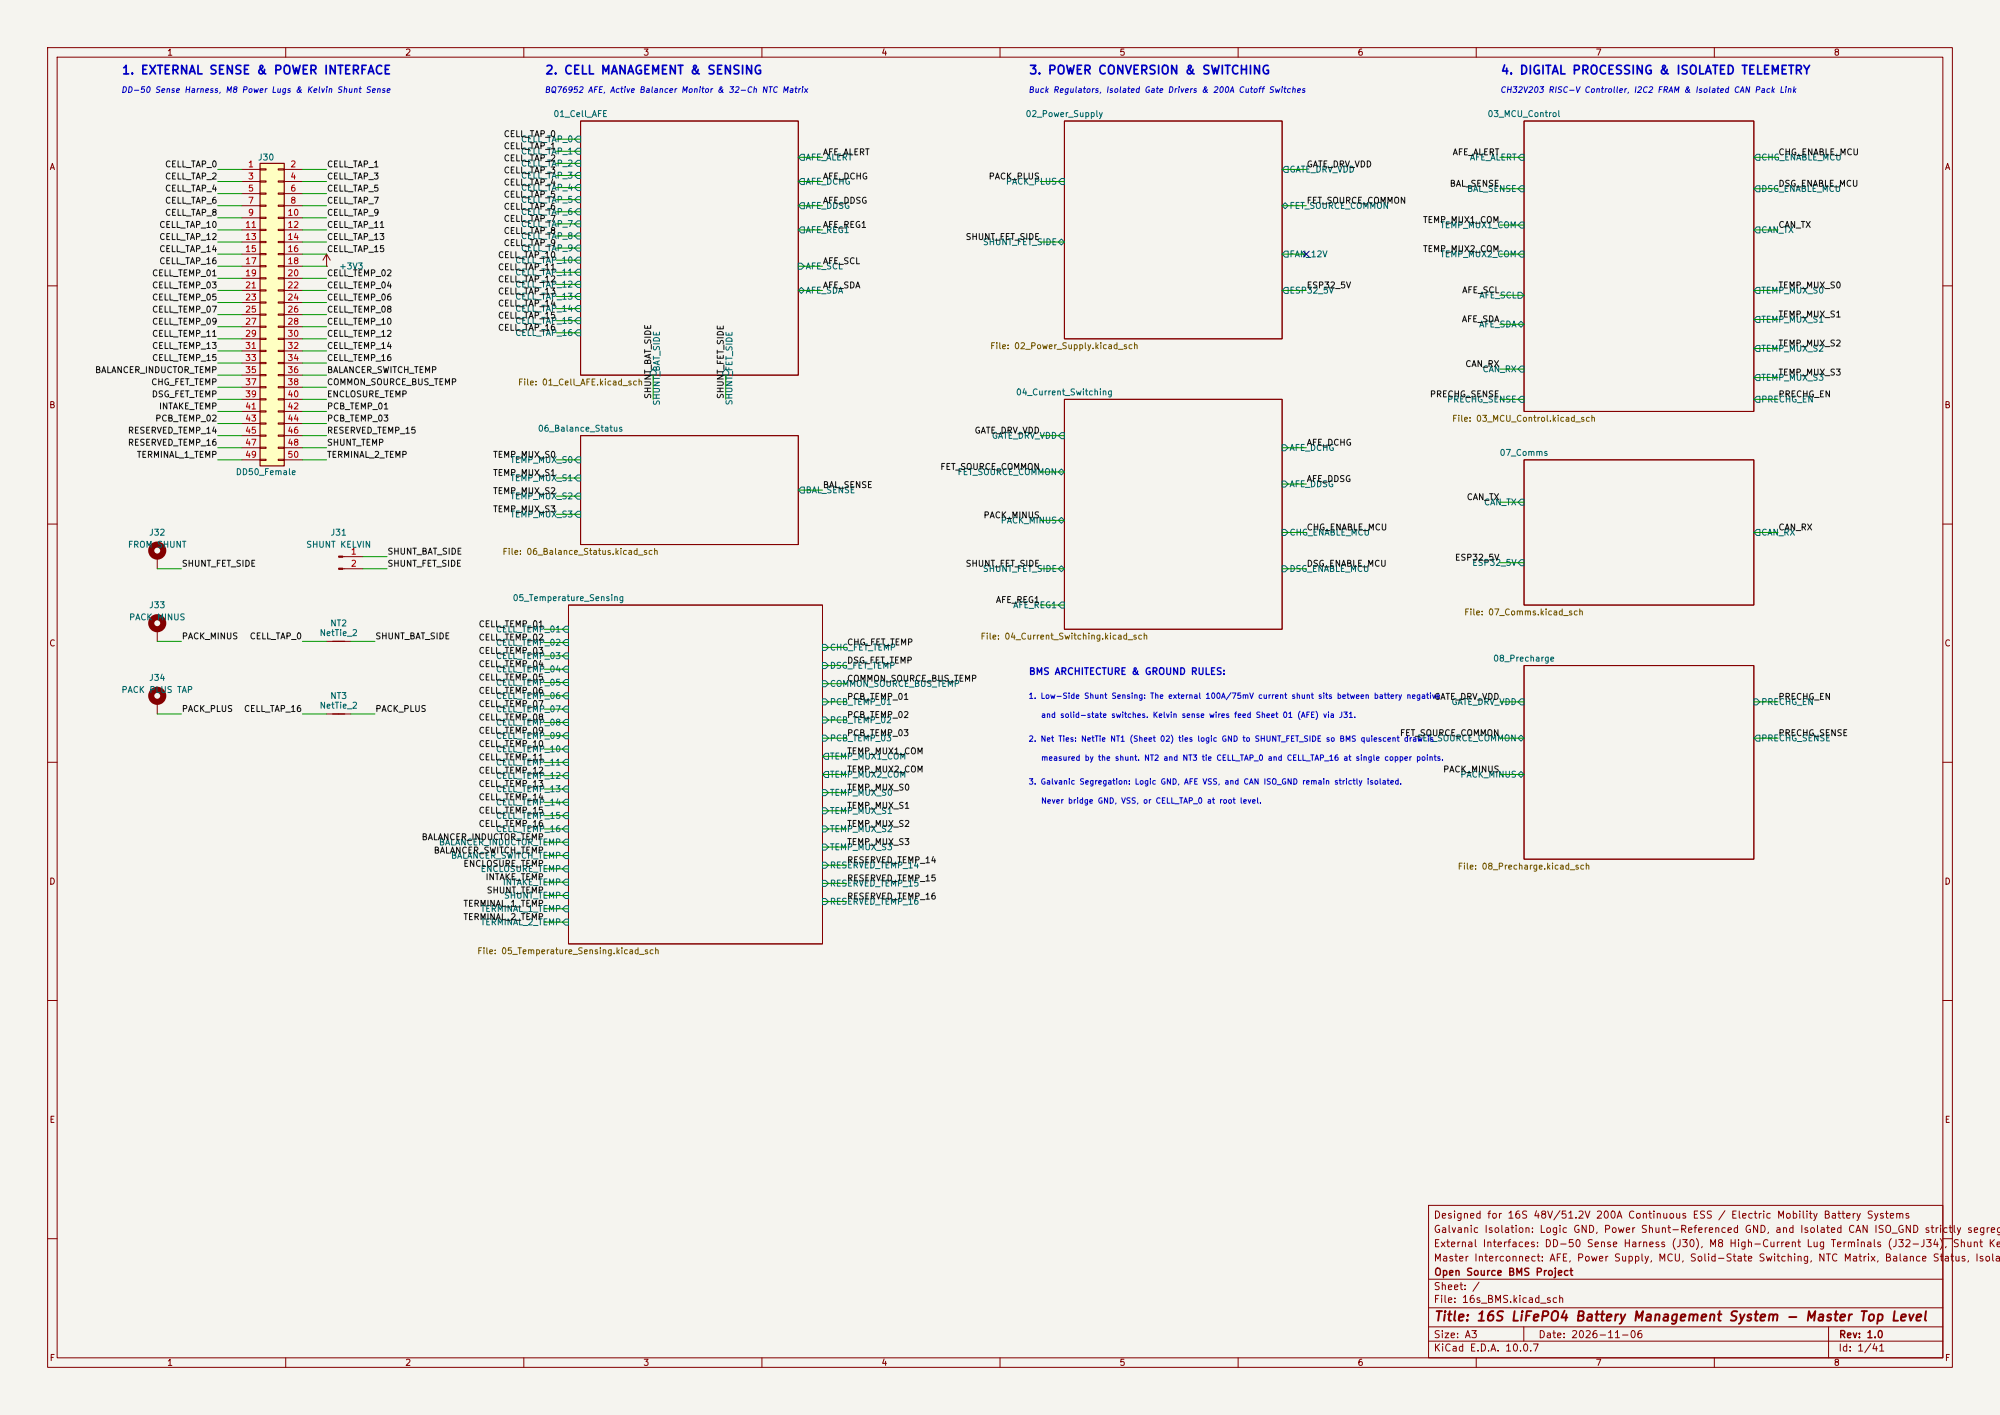
[picture p41: page 1]

CH32V203 RISC-V Controller, I2C2 FRAM & Isolated CAN Pack Link 3. POWER CONVERSION & SWITCHING
03_MCU_Control File: 03_MCU_Control.kicad_sch CAN_TX

BMS ARCHITECTURE & GROUND RULES:

Never bridge GND, VSS, or CELL_TAP_0 at root level. 3. Galvanic Segregation: Logic GND, AFE VSS, and CAN ISO_GND remain strictly isolated. measured by the shunt. NT2 and NT3 tie CELL_TAP_0 and CELL_TAP_16 at single copper points. 2. Net Ties: NetTie NT1 (Sheet 02) ties logic GND to SHUNT_FET_SIDE so BMS quiescent draw is and solid-state switches. Kelvin sense wires feed Sheet 01 (AFE) via J31. 1. Low-Side Shunt Sensing: The external 100A/75mV current shunt sits between battery negative

Designed for 16S 48V/51.2V 200A Continuous ESS / Electric Mobility Battery Systems
Galvanic Isolation: Logic GND, Power Shunt-Referenced GND, and Isolated CAN ISO_GND strictly segregated
External Interfaces: DD-50 Sense Harness (J30), M8 High-Current Lug Terminals (J32-J34), Shunt Kelvin Header (J31)
Master Interconnect: AFE, Power Supply, MCU, Solid-State Switching, NTC Matrix, Balance Status, Isolated CAN
Open Source BMS Project
Sheet: /
File: 16s_BMS.kicad_sch
Title: 16S LiFePO4 Battery Management System - Master Top Level

Size: A3 | Rev: 1.0 | F Date: 2026-11-06
KiCad E.D.A. 10.0.7 | Id: 1/41

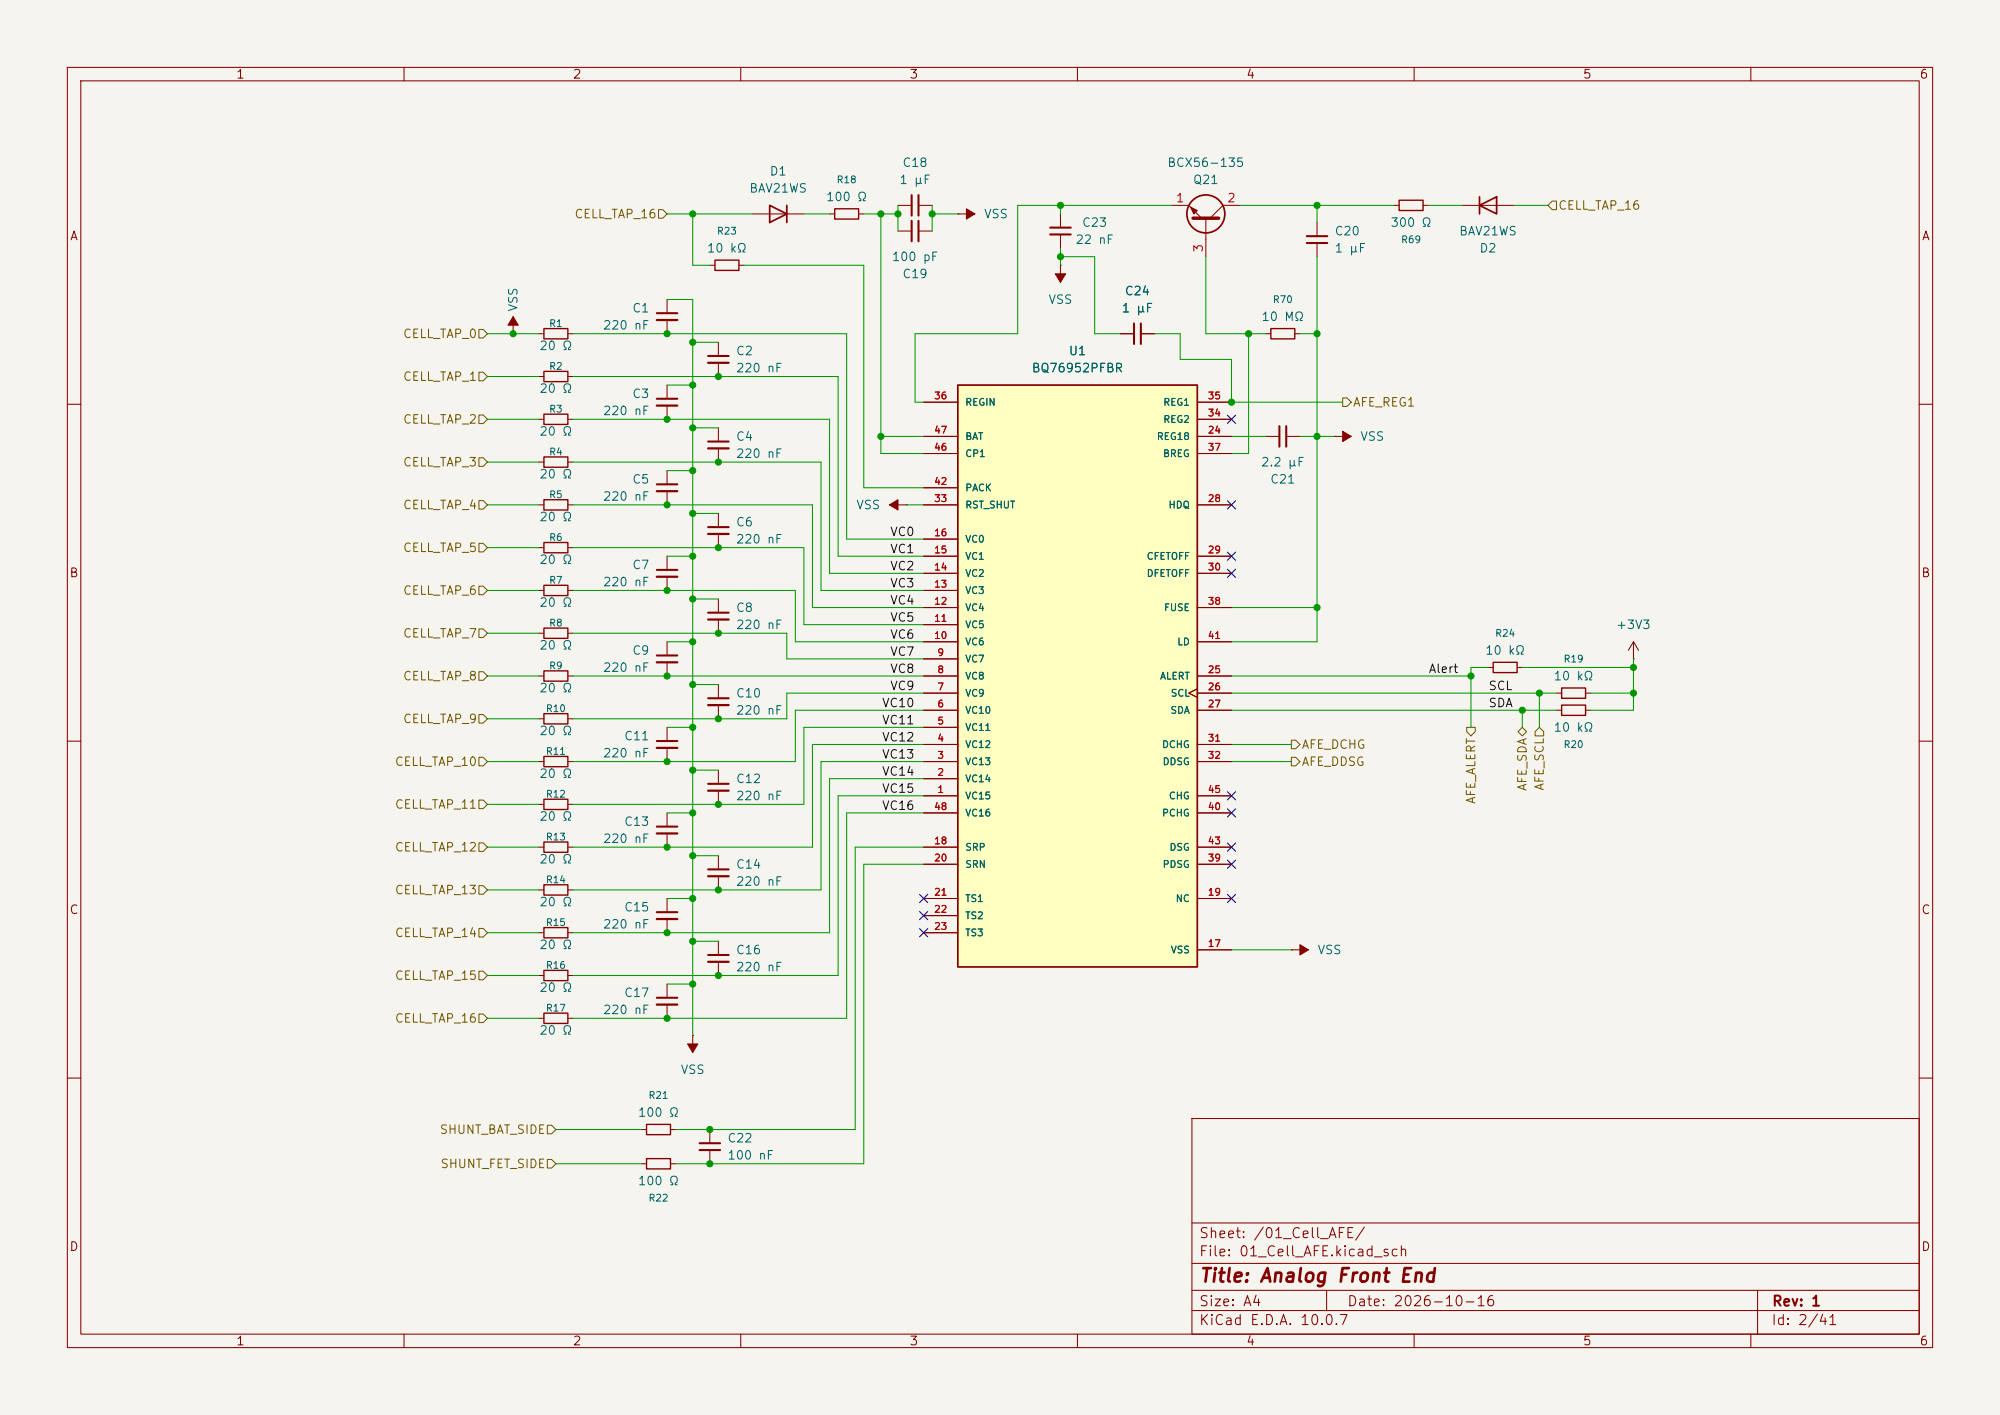
[picture p42: page 2]

Sheet: /01_Cell_AFE/
File: 01_Cell_AFE.kicad_sch
Title: Analog Front End

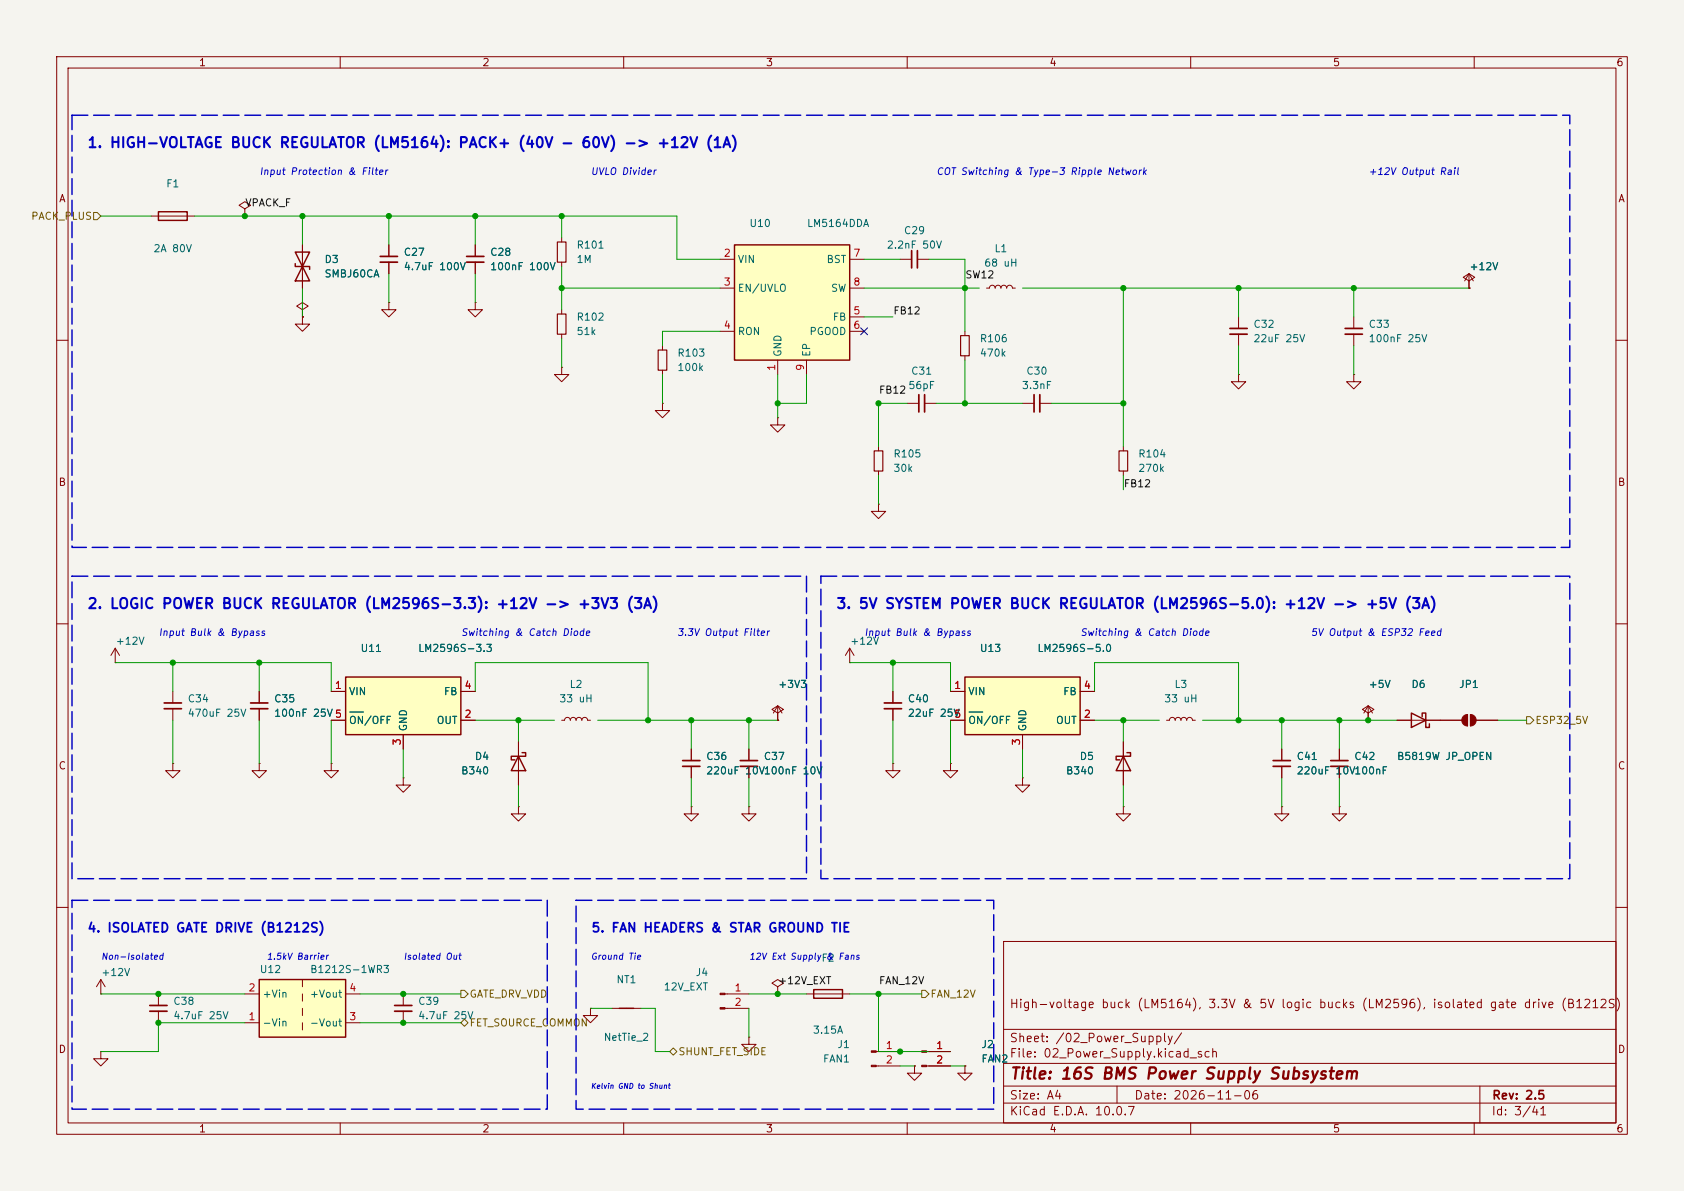
[picture p43: page 3]

Input Bulk & Bypass COT Switching & Type-3 Ripple Network D3

High-voltage buck (LM5164), 3.3V & 5V logic bucks (LM2596), isolated gate drive (B1212S) D4 B340

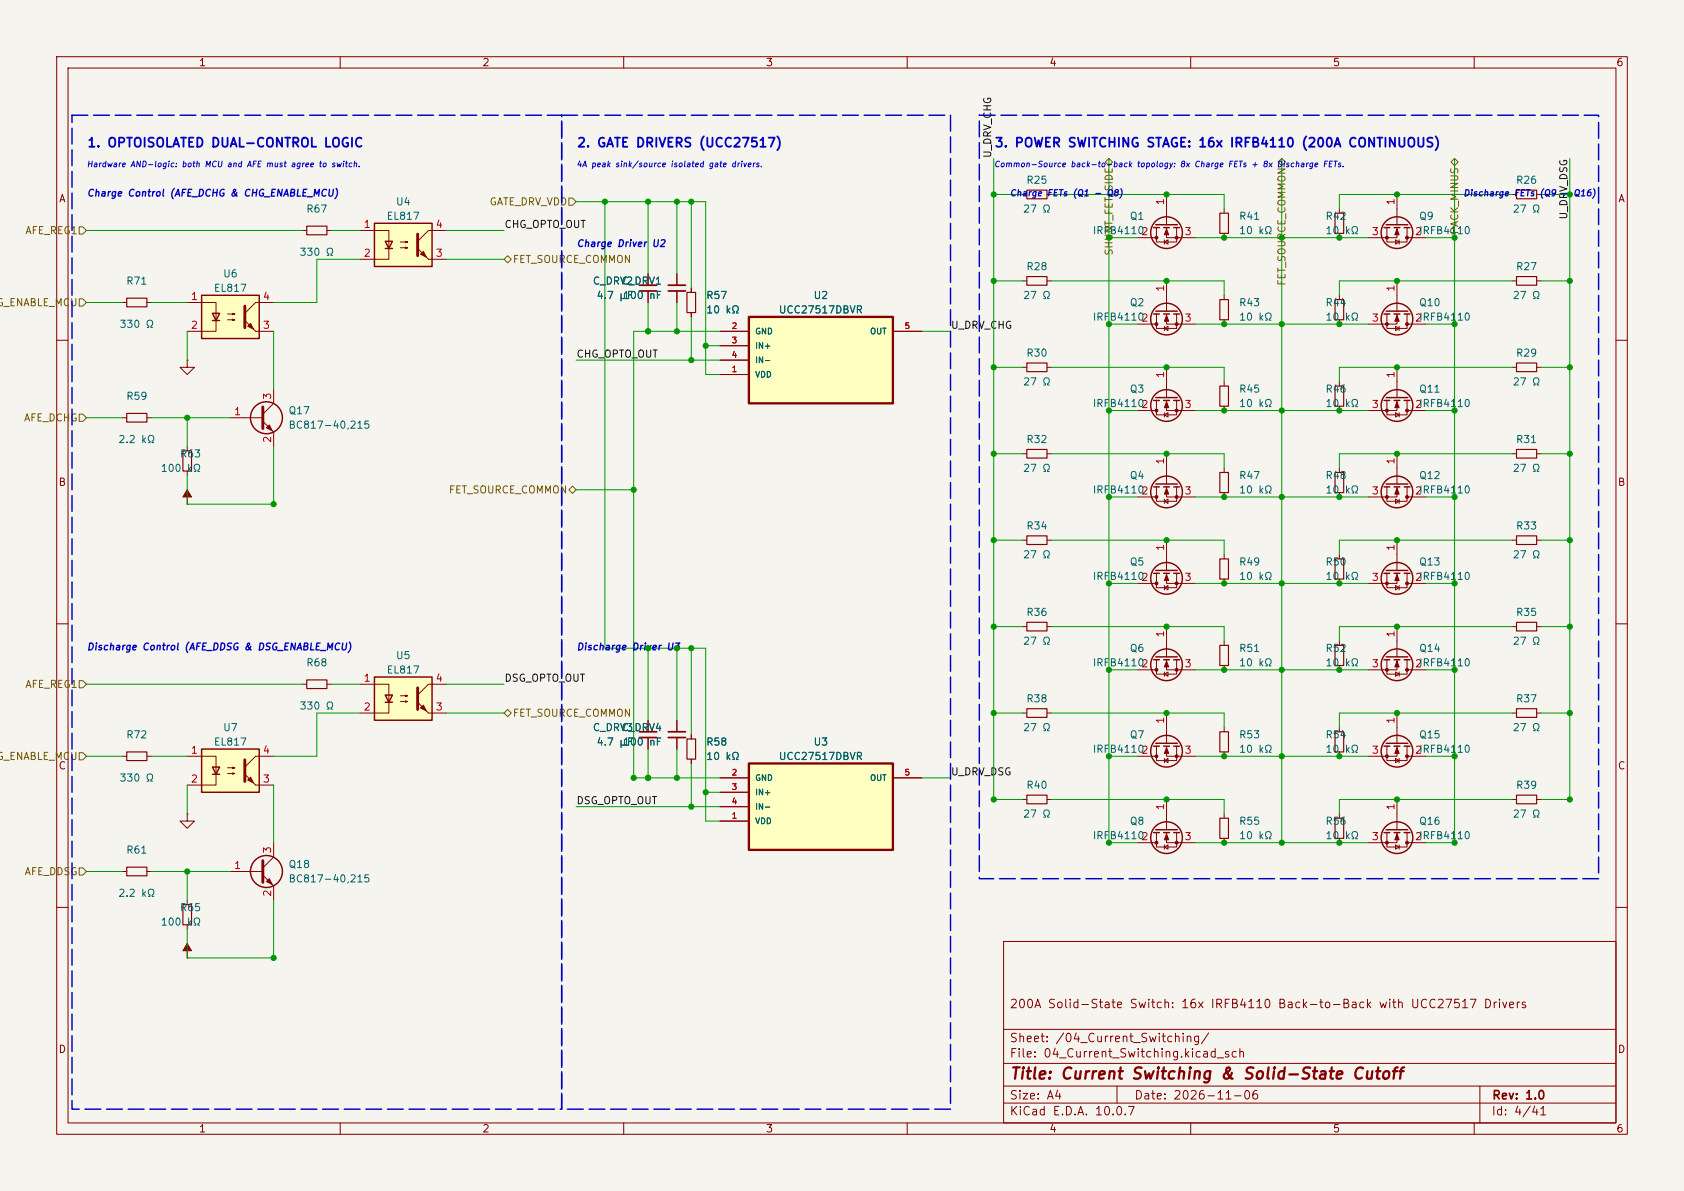
[picture p44: page 4]

1. OPTOISOLATED DUAL-CONTROL LOGIC

Hardware AND-logic: both MCU and AFE must agree to switch. Charge Control (AFE_DCHG & CHG_ENABLE_MCU)

200A Solid-State Switch: 16x IRFB4110 Back-to-Back with UCC27517 Drivers

Sheet: /04_Current_Switching/
File: 04_Current_Switching.kicad_sch
Title: Current Switching & Solid-State Cutoff

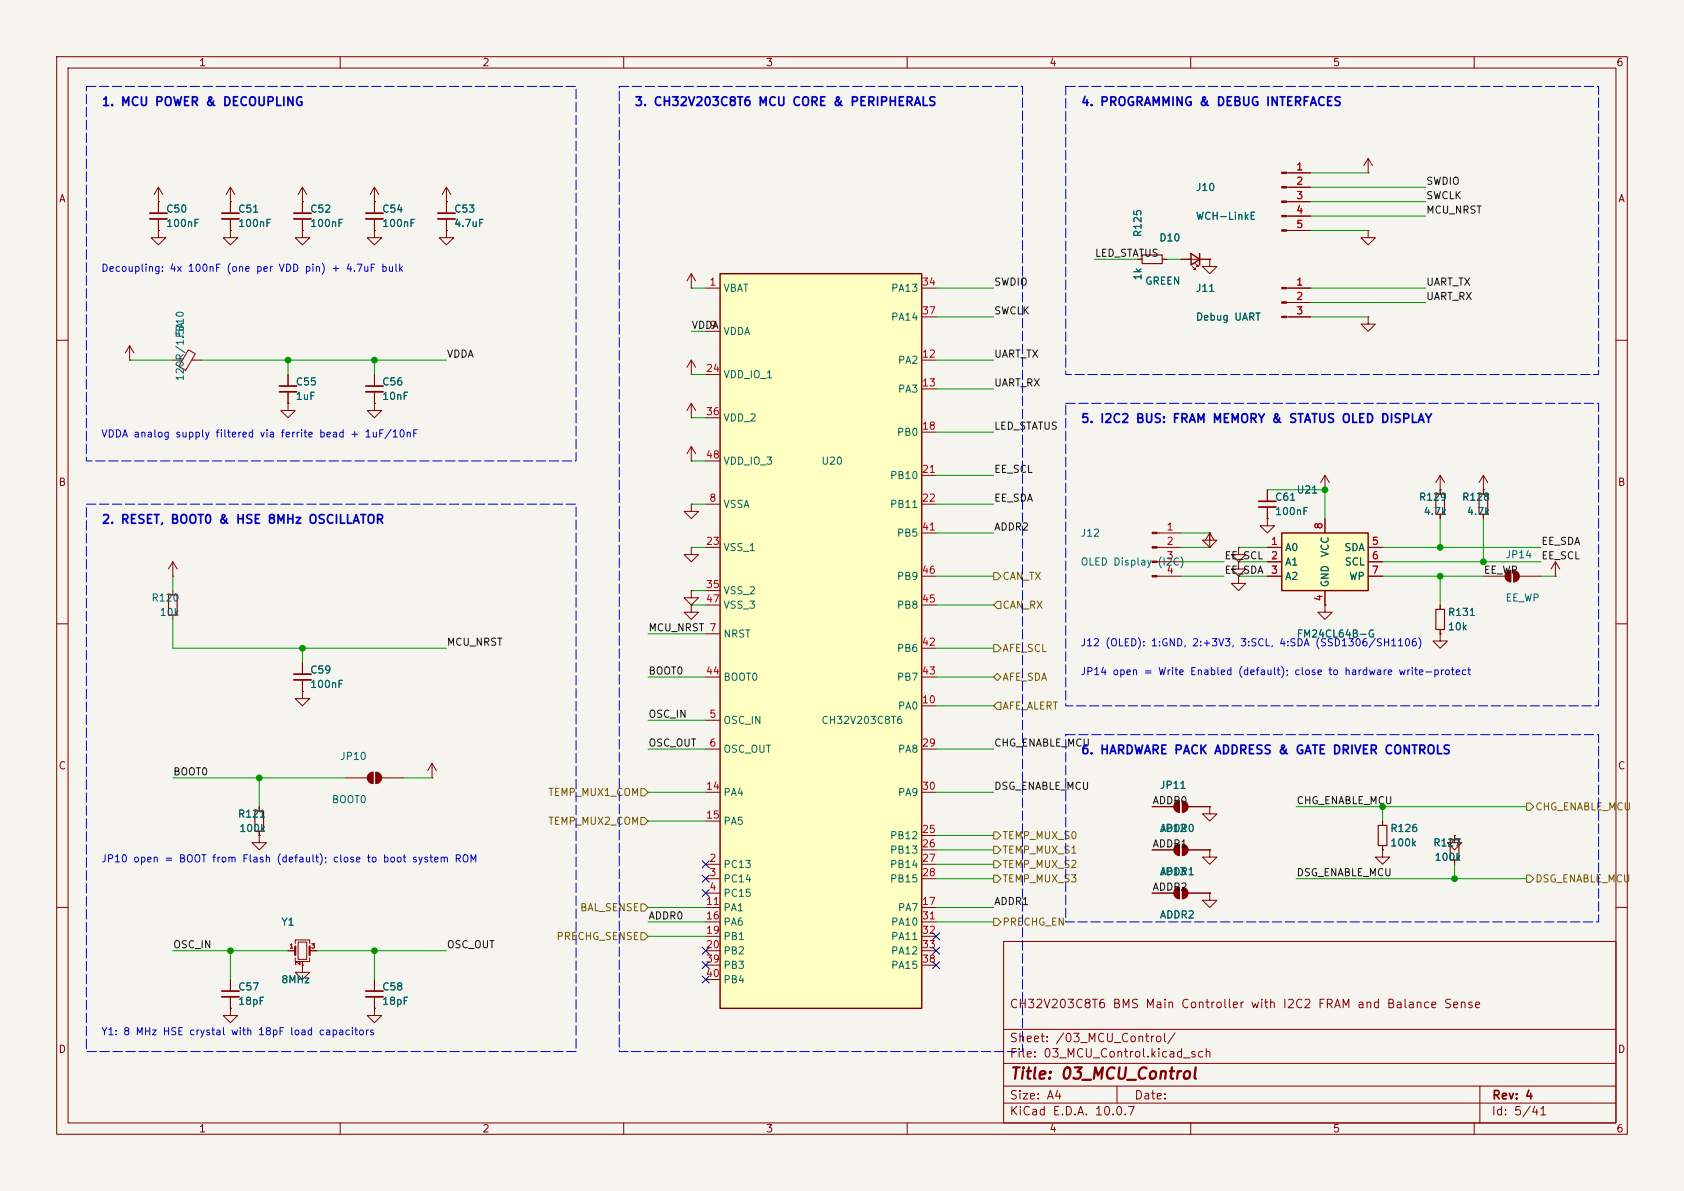
[picture p45: page 5]

6. HARDWARE PACK ADDRESS & GATE DRIVER CONTROLS R125 1k

Decoupling: 4x 100nF (one per VDD pin) + 4.7uF bulk

5. I2C2 BUS: FRAM MEMORY & STATUS OLED DISPLAY

VDDA analog supply filtered via ferrite bead + 1uF/10nF

J12 (OLED): 1:GND, 2:+3V3, 3:SCL, 4:SDA (SSD1306/SH1106)

JP14 open = Write Enabled (default); close to hardware write-protect

JP10 open = BOOT from Flash (default); close to boot system ROM

Y1: 8 MHz HSE crystal with 18pF load capacitors

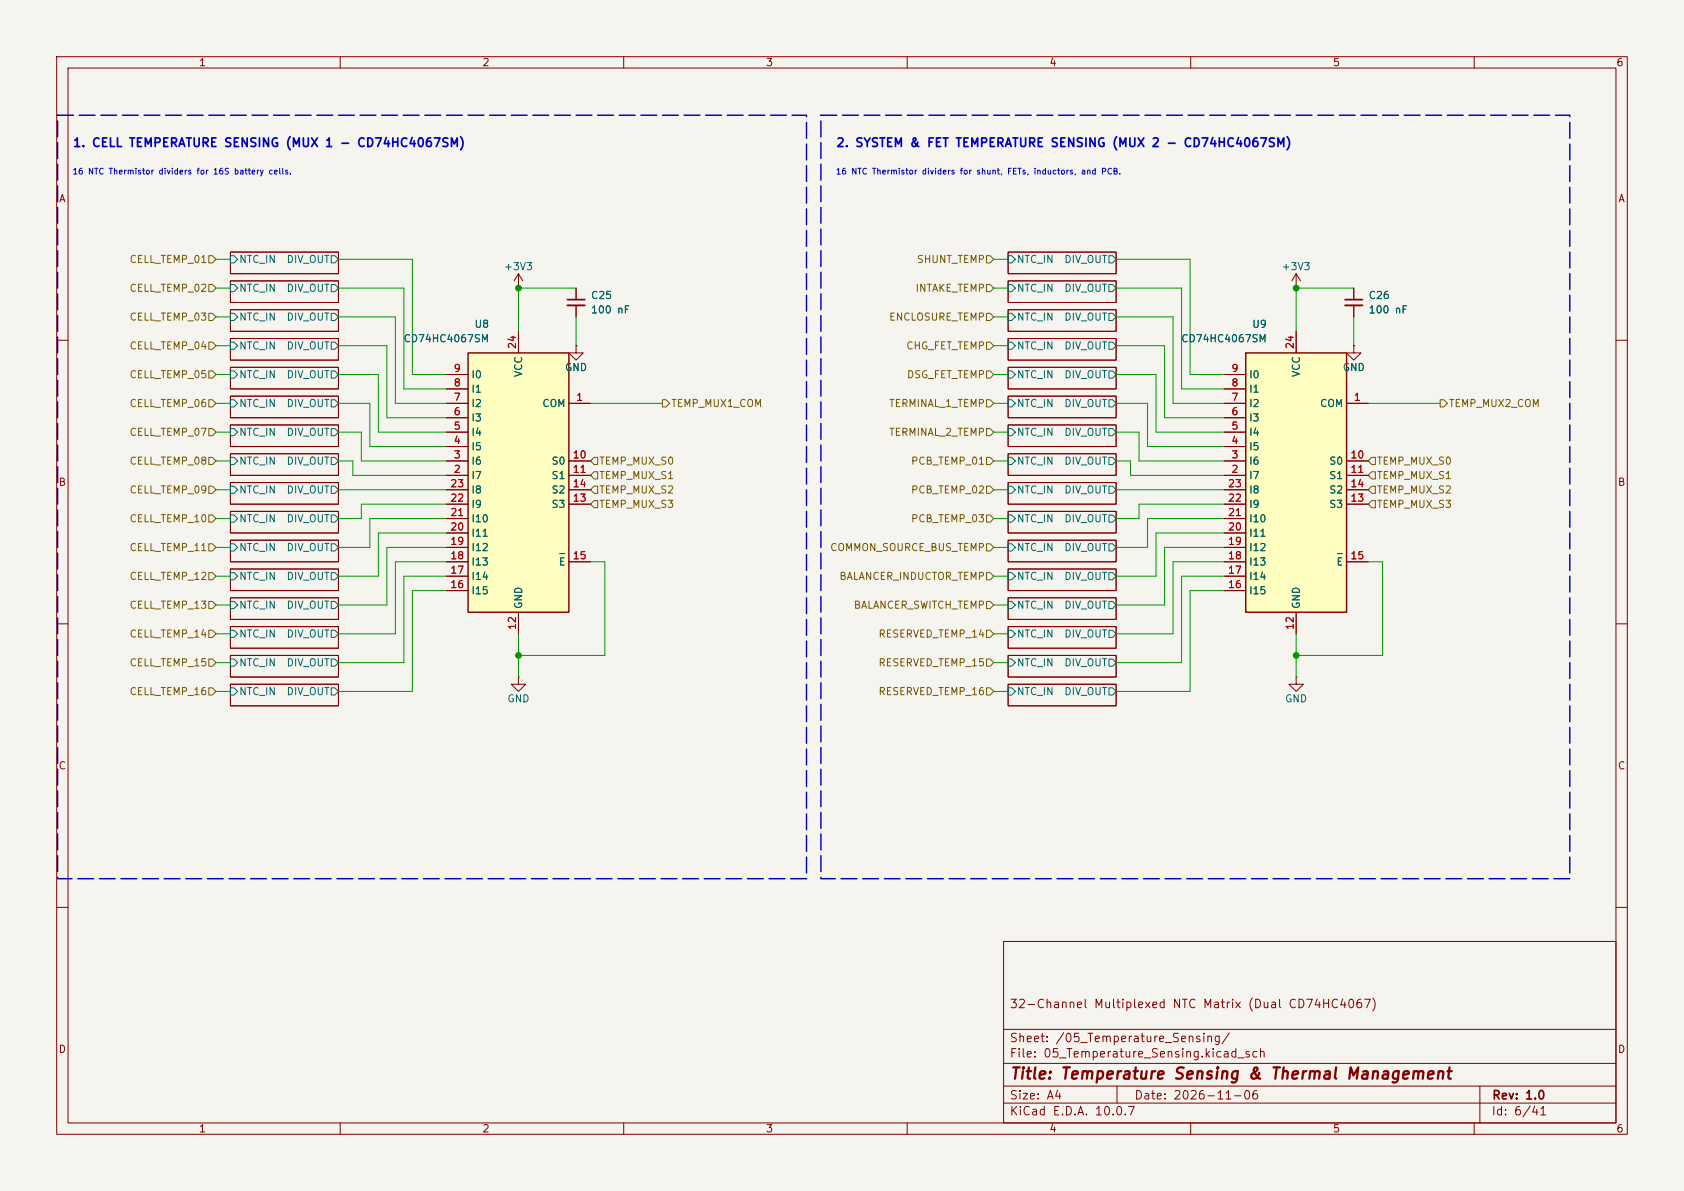
[picture p46: page 6]

16 NTC Thermistor dividers for 16S battery cells. 1. CELL TEMPERATURE SENSING (MUX 1 - CD74HC4067SM)
CELL_TEMP_15 CELL_TEMP_16 CELL_TEMP_13 CELL_TEMP_12 CELL_TEMP_14 CELL_TEMP_11 CELL_TEMP_10 CELL_TEMP_09 CELL_TEMP_08 CELL_TEMP_07 CELL_TEMP_06 CELL_TEMP_05 CELL_TEMP_04 CELL_TEMP_03 CELL_TEMP_02

16 NTC Thermistor dividers for shunt, FETs, inductors, and PCB. 2. SYSTEM & FET TEMPERATURE SENSING (MUX 2 - CD74HC4067SM) C25

32-Channel Multiplexed NTC Matrix (Dual CD74HC4067)

Sheet: /05_Temperature_Sensing/
File: 05_Temperature_Sensing.kicad_sch
Title: Temperature Sensing & Thermal Management

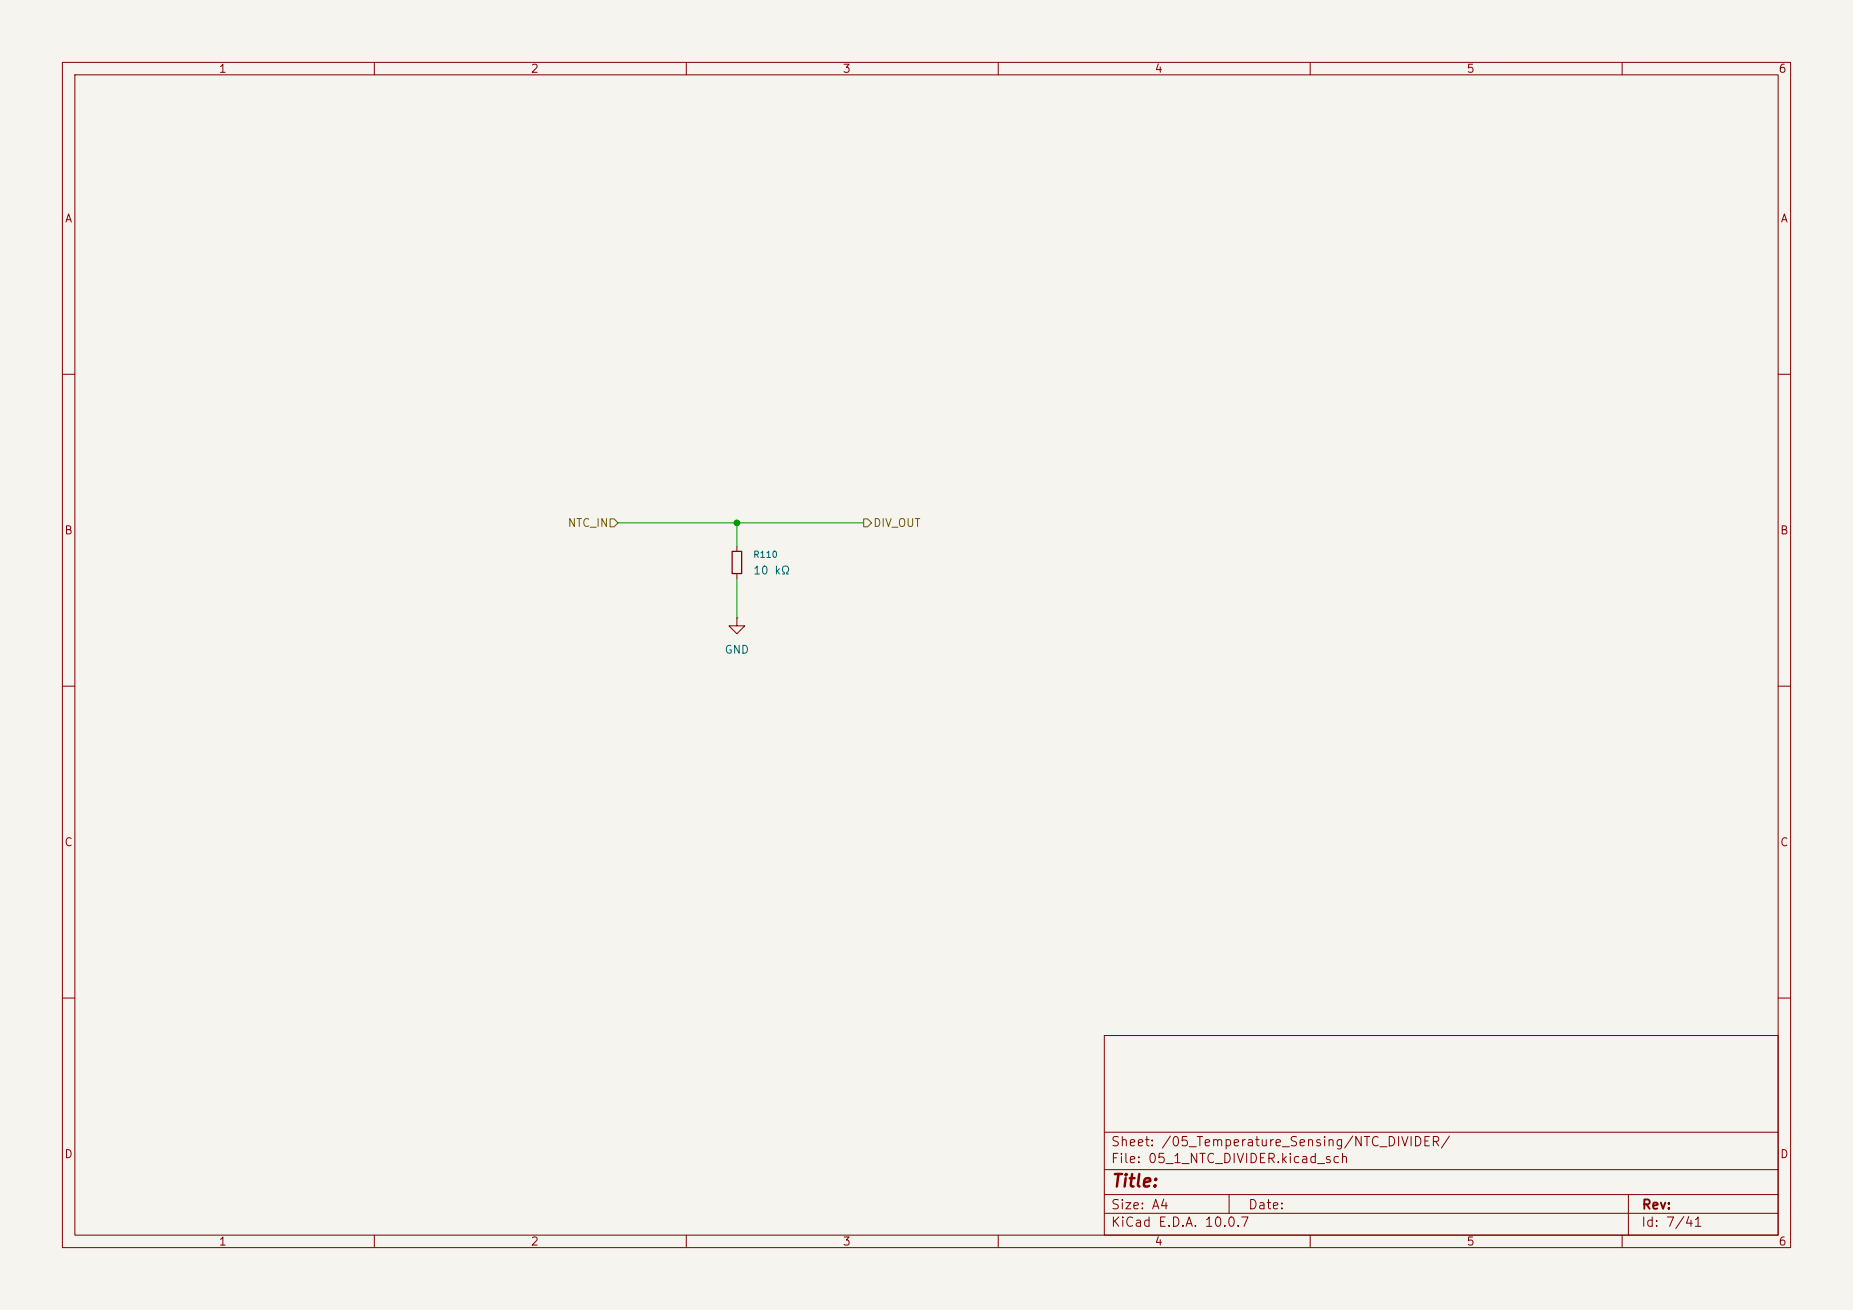
[picture p47: page 7]

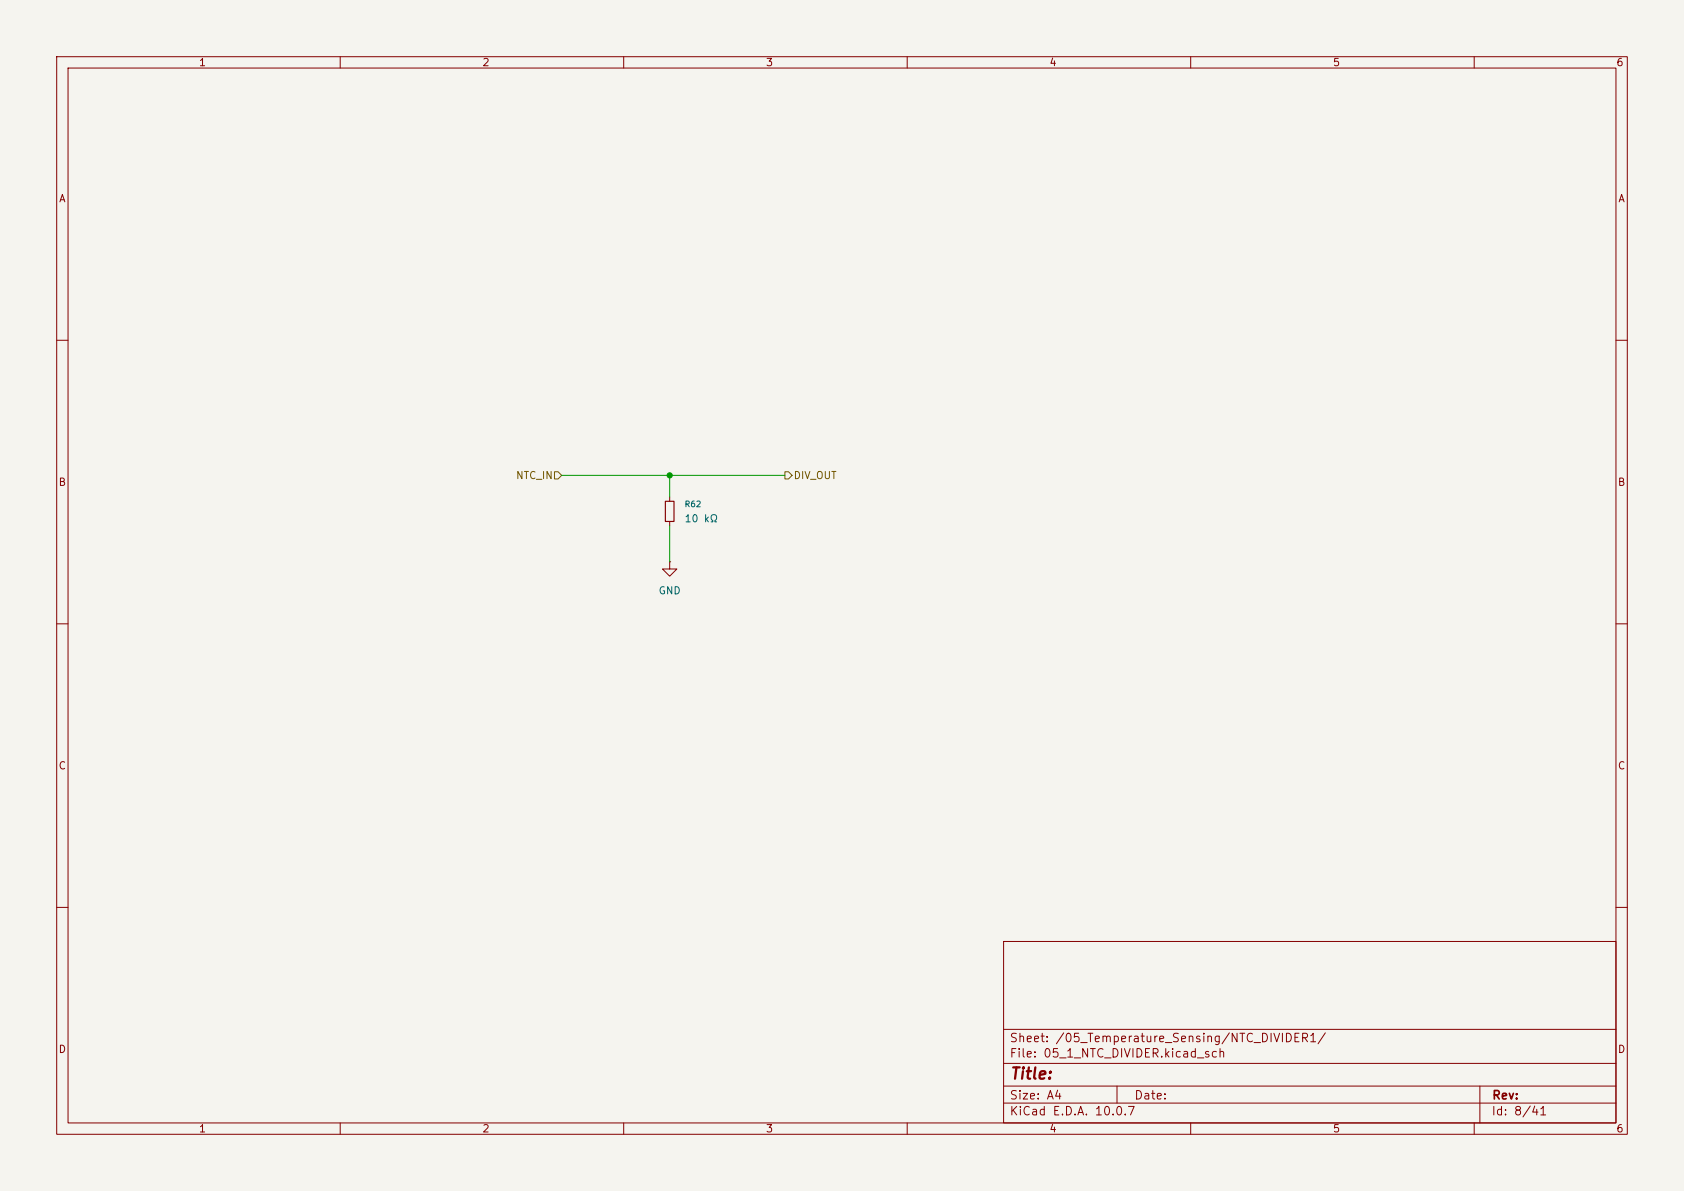
[picture p48: page 8]

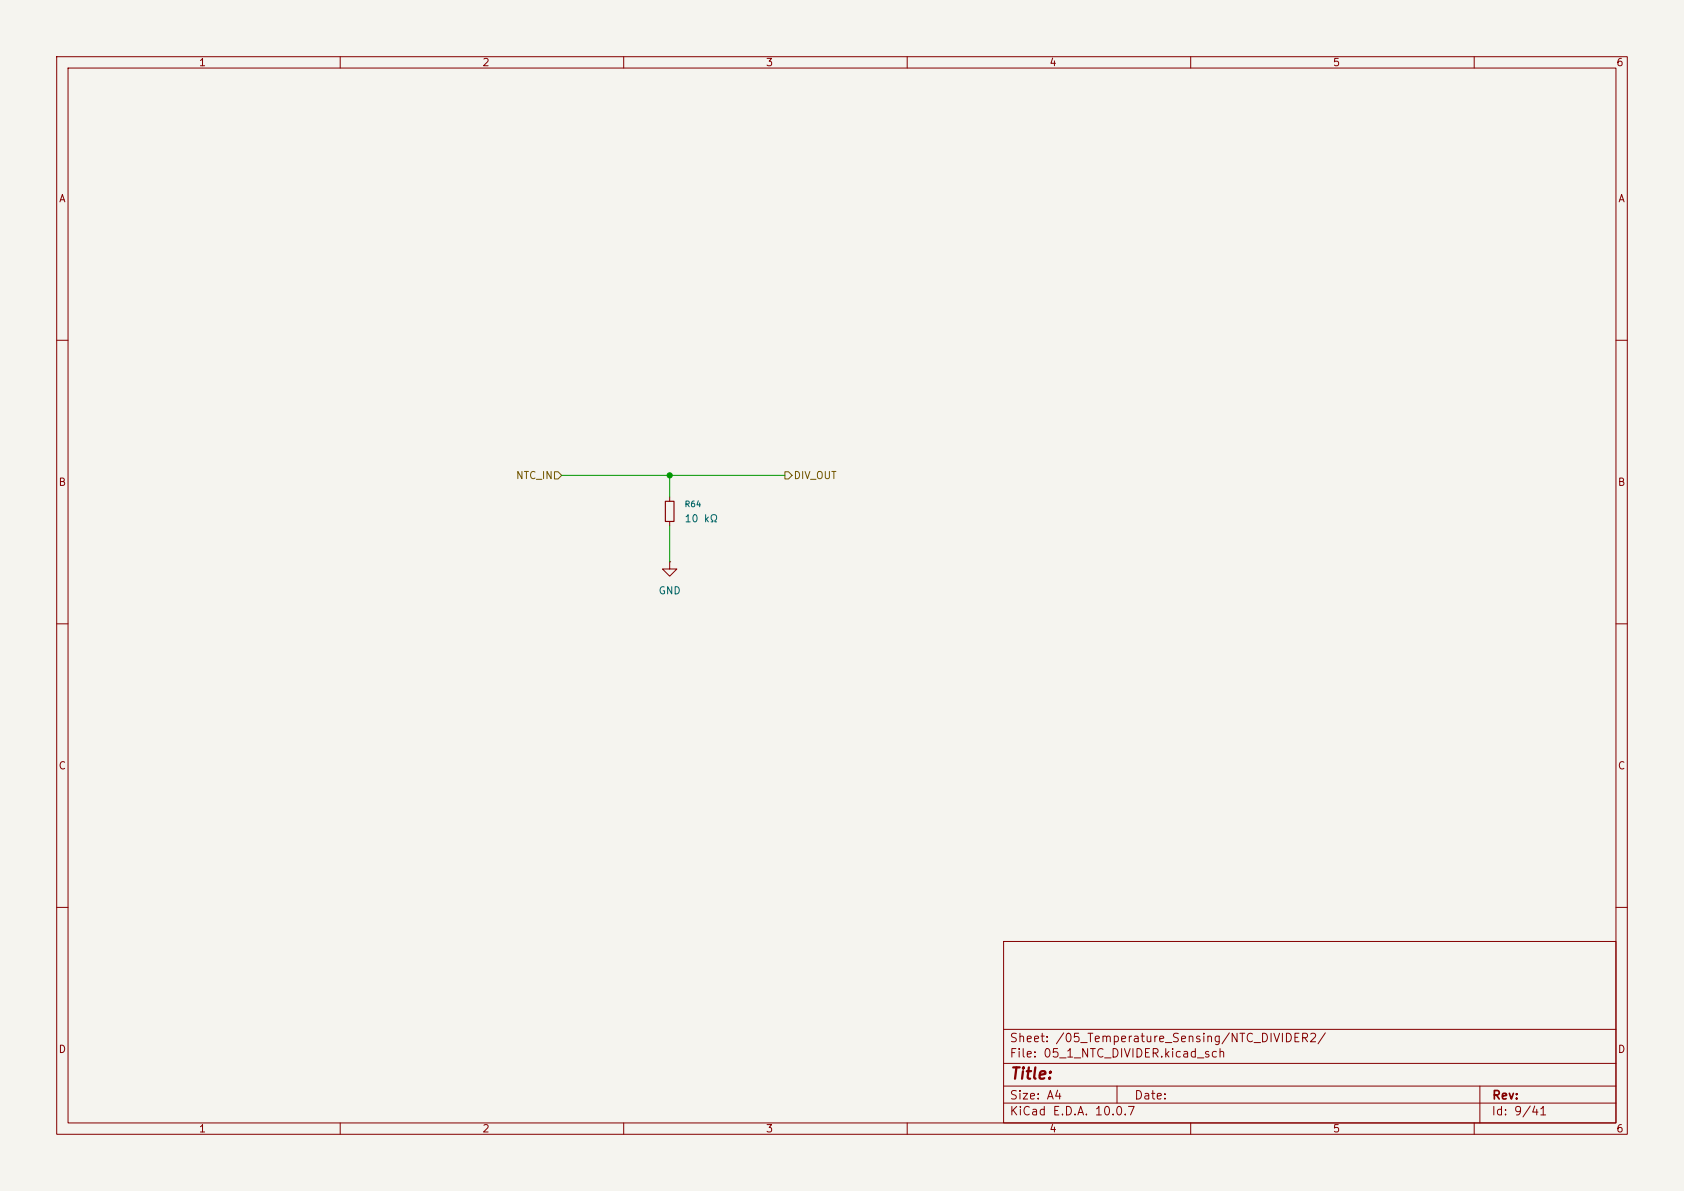
[picture p49: page 9]

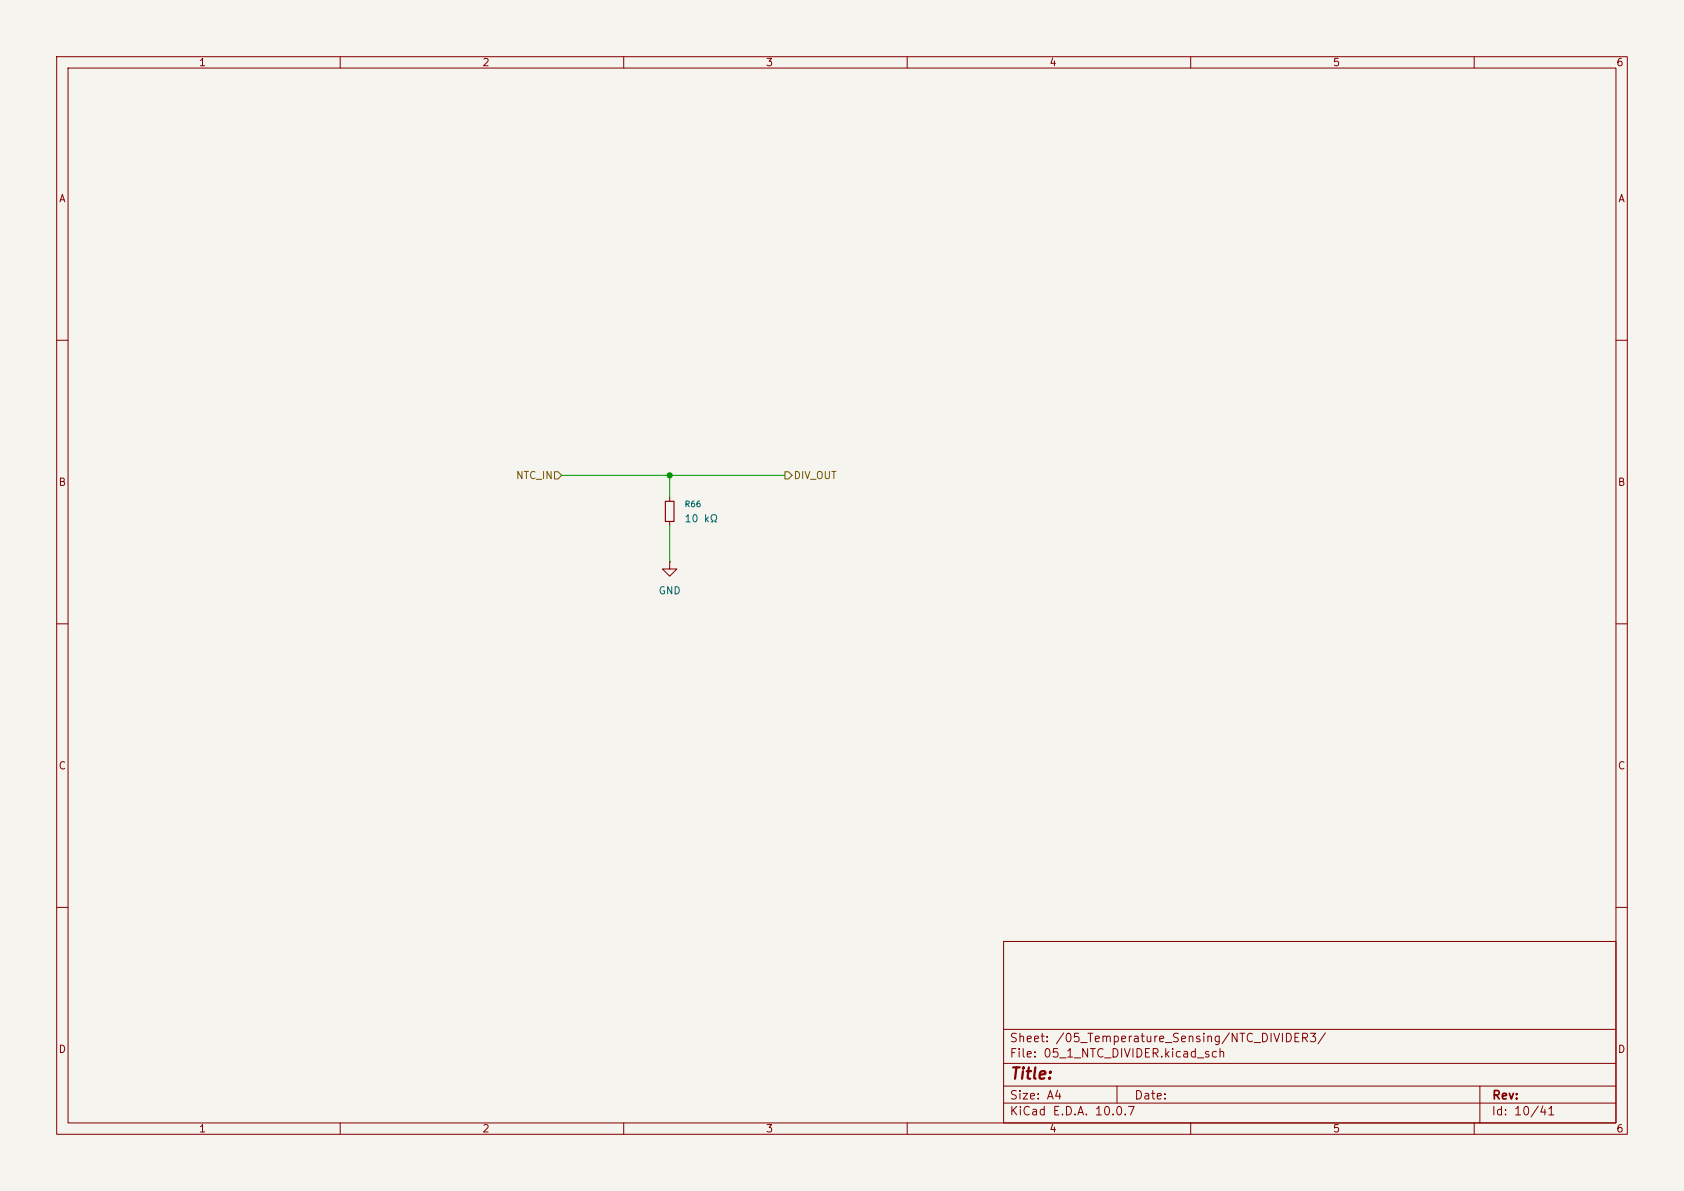
[picture p50: page 10]

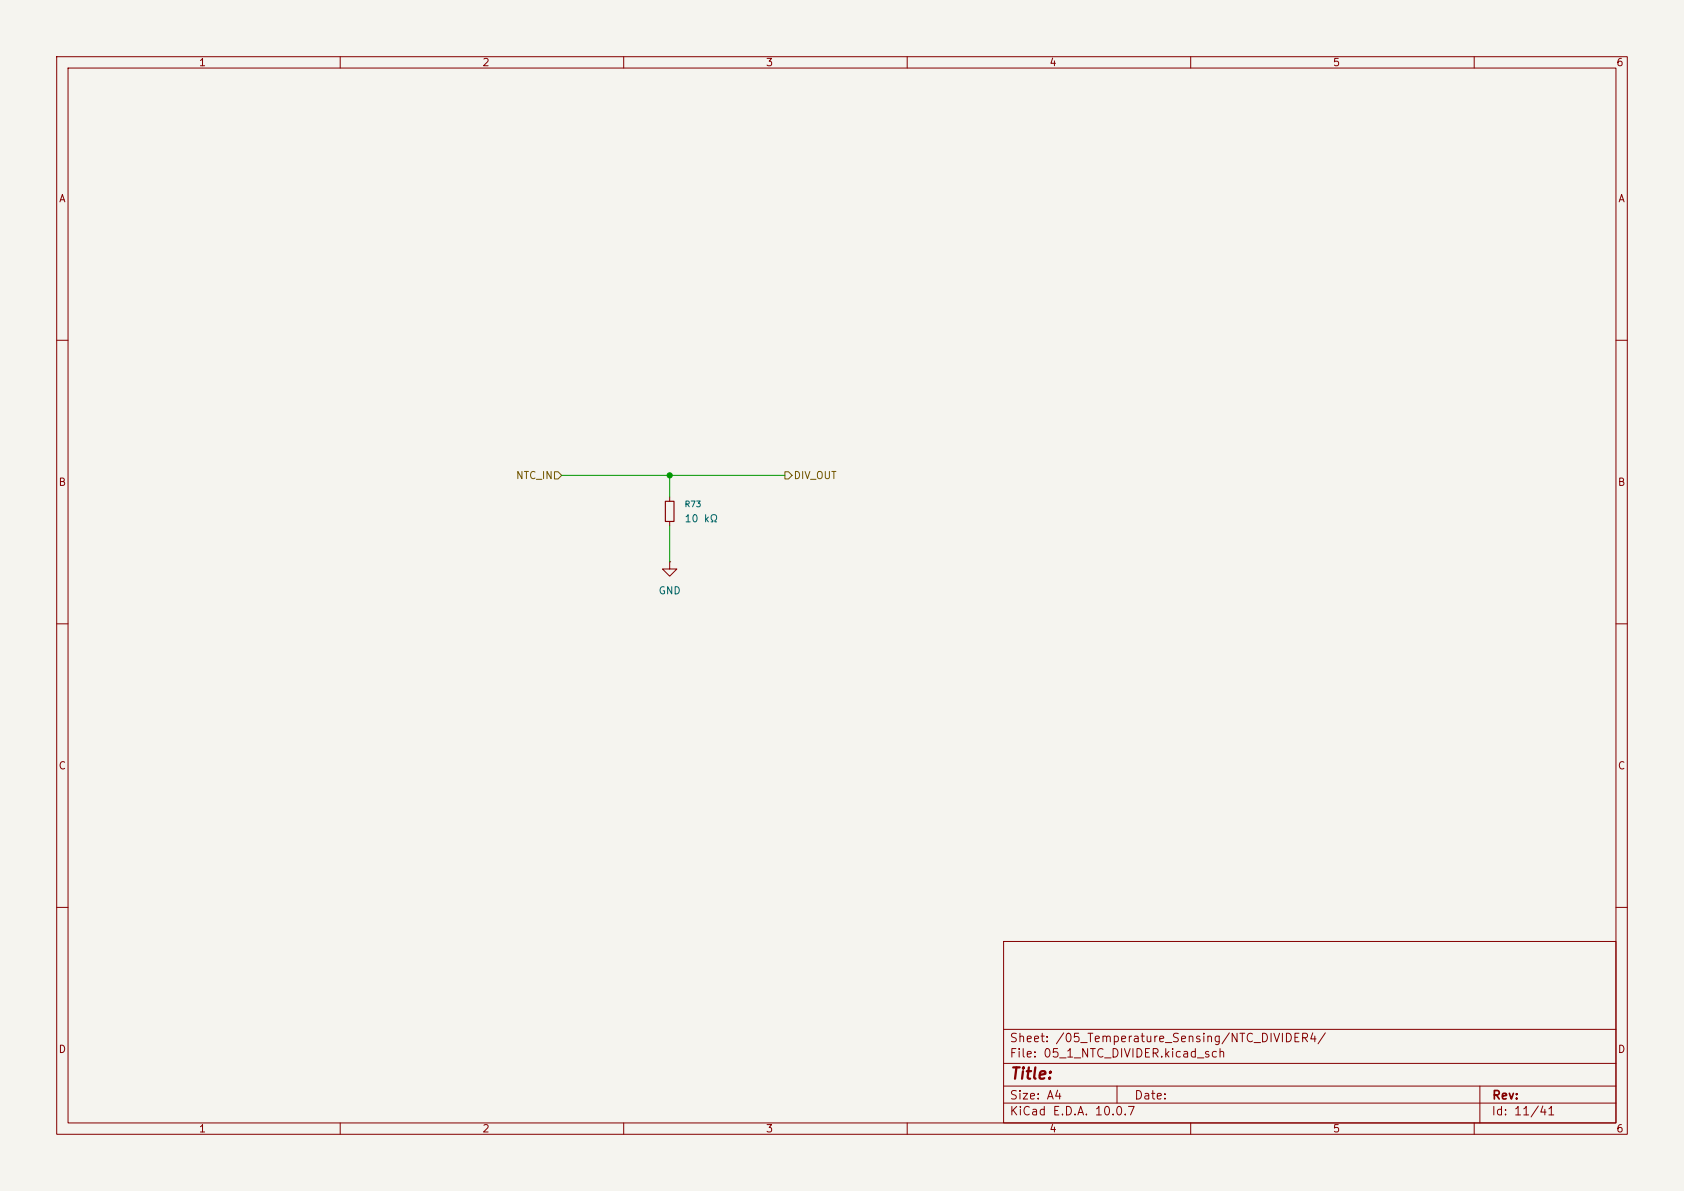
[picture p51: page 11]

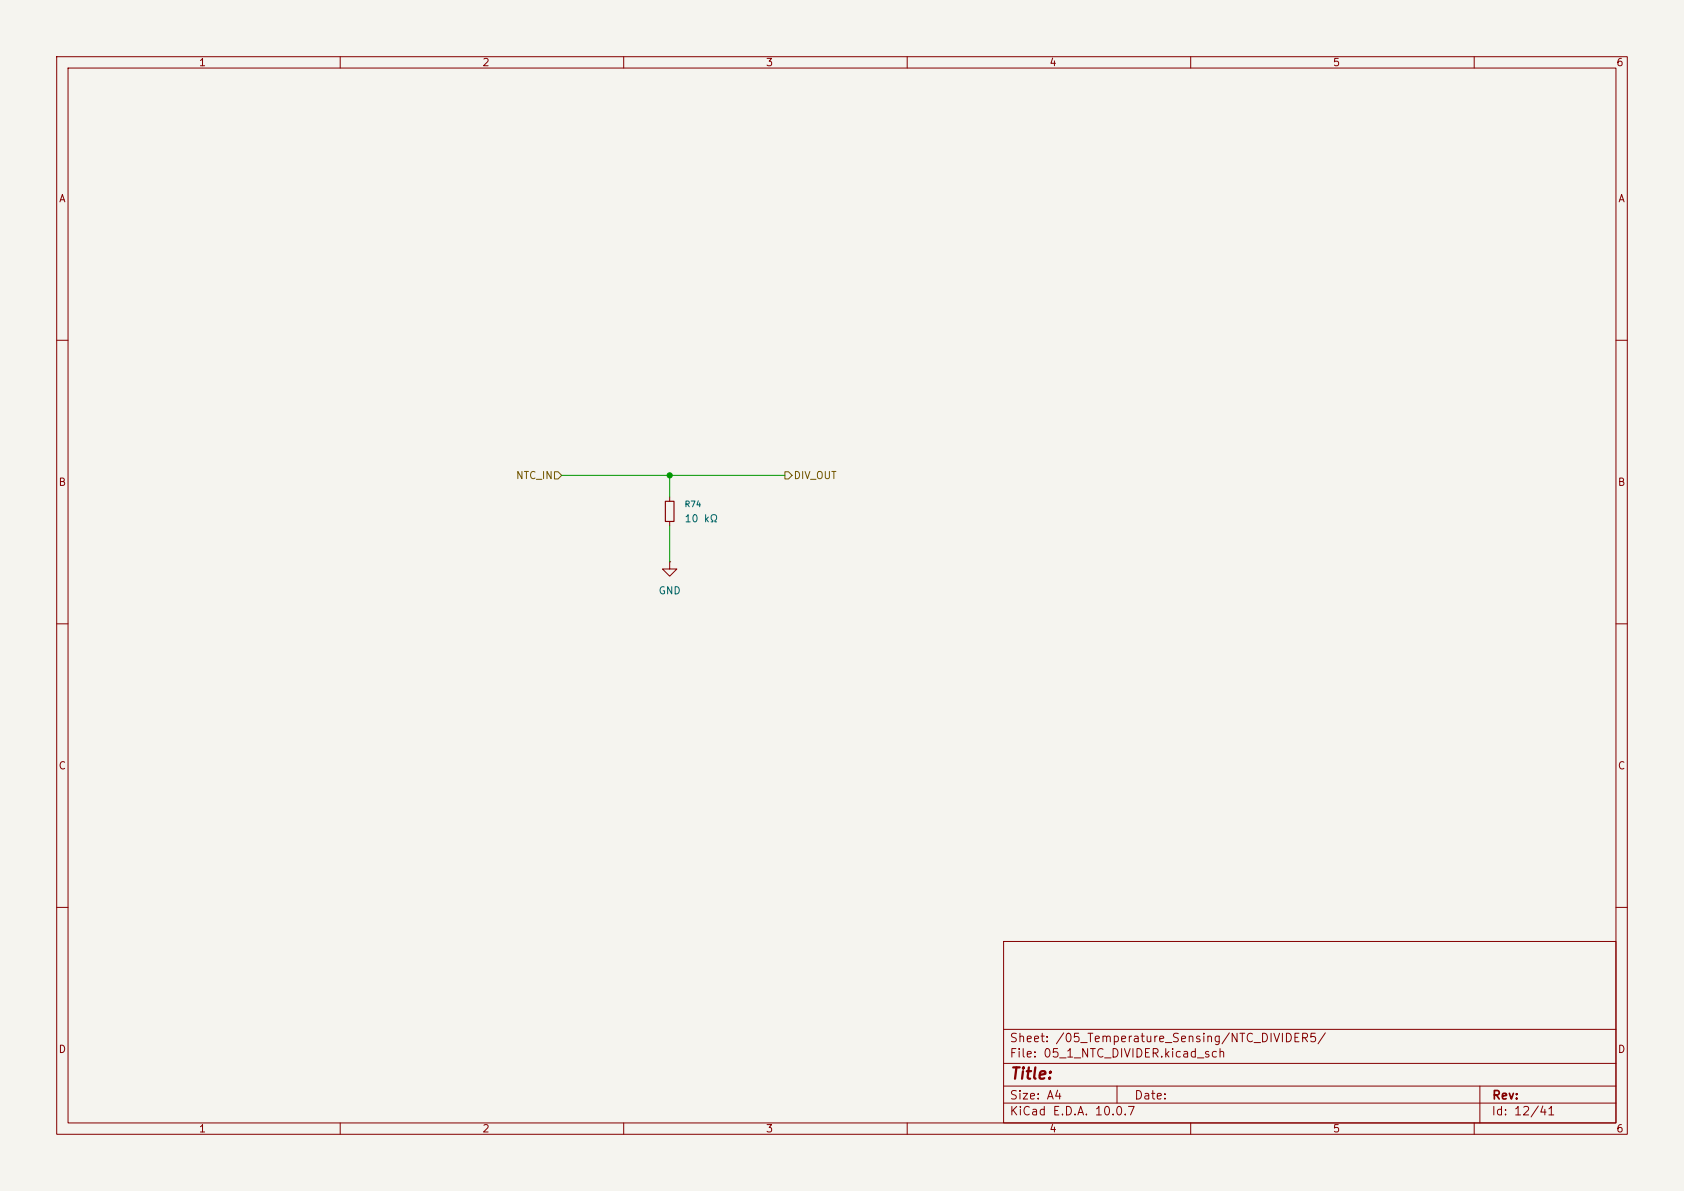
[picture p52: page 12]

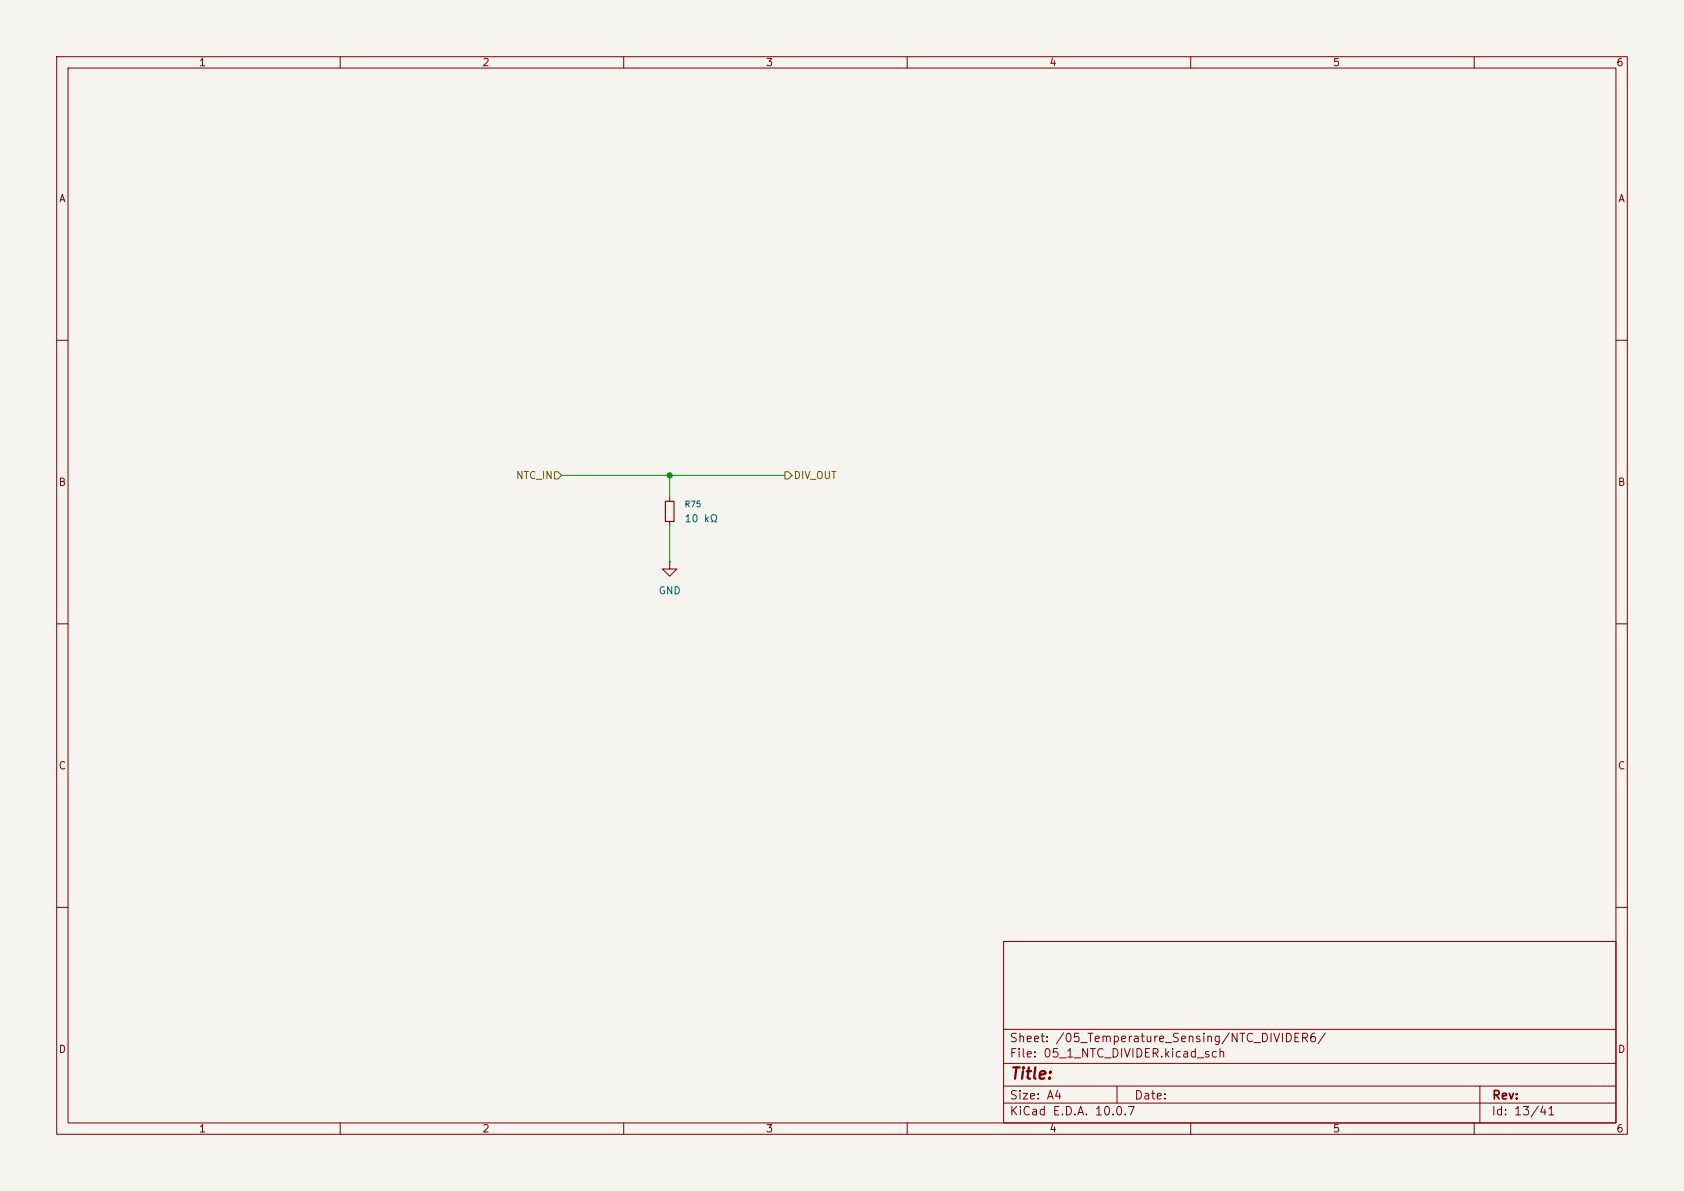
[picture p53: page 13]

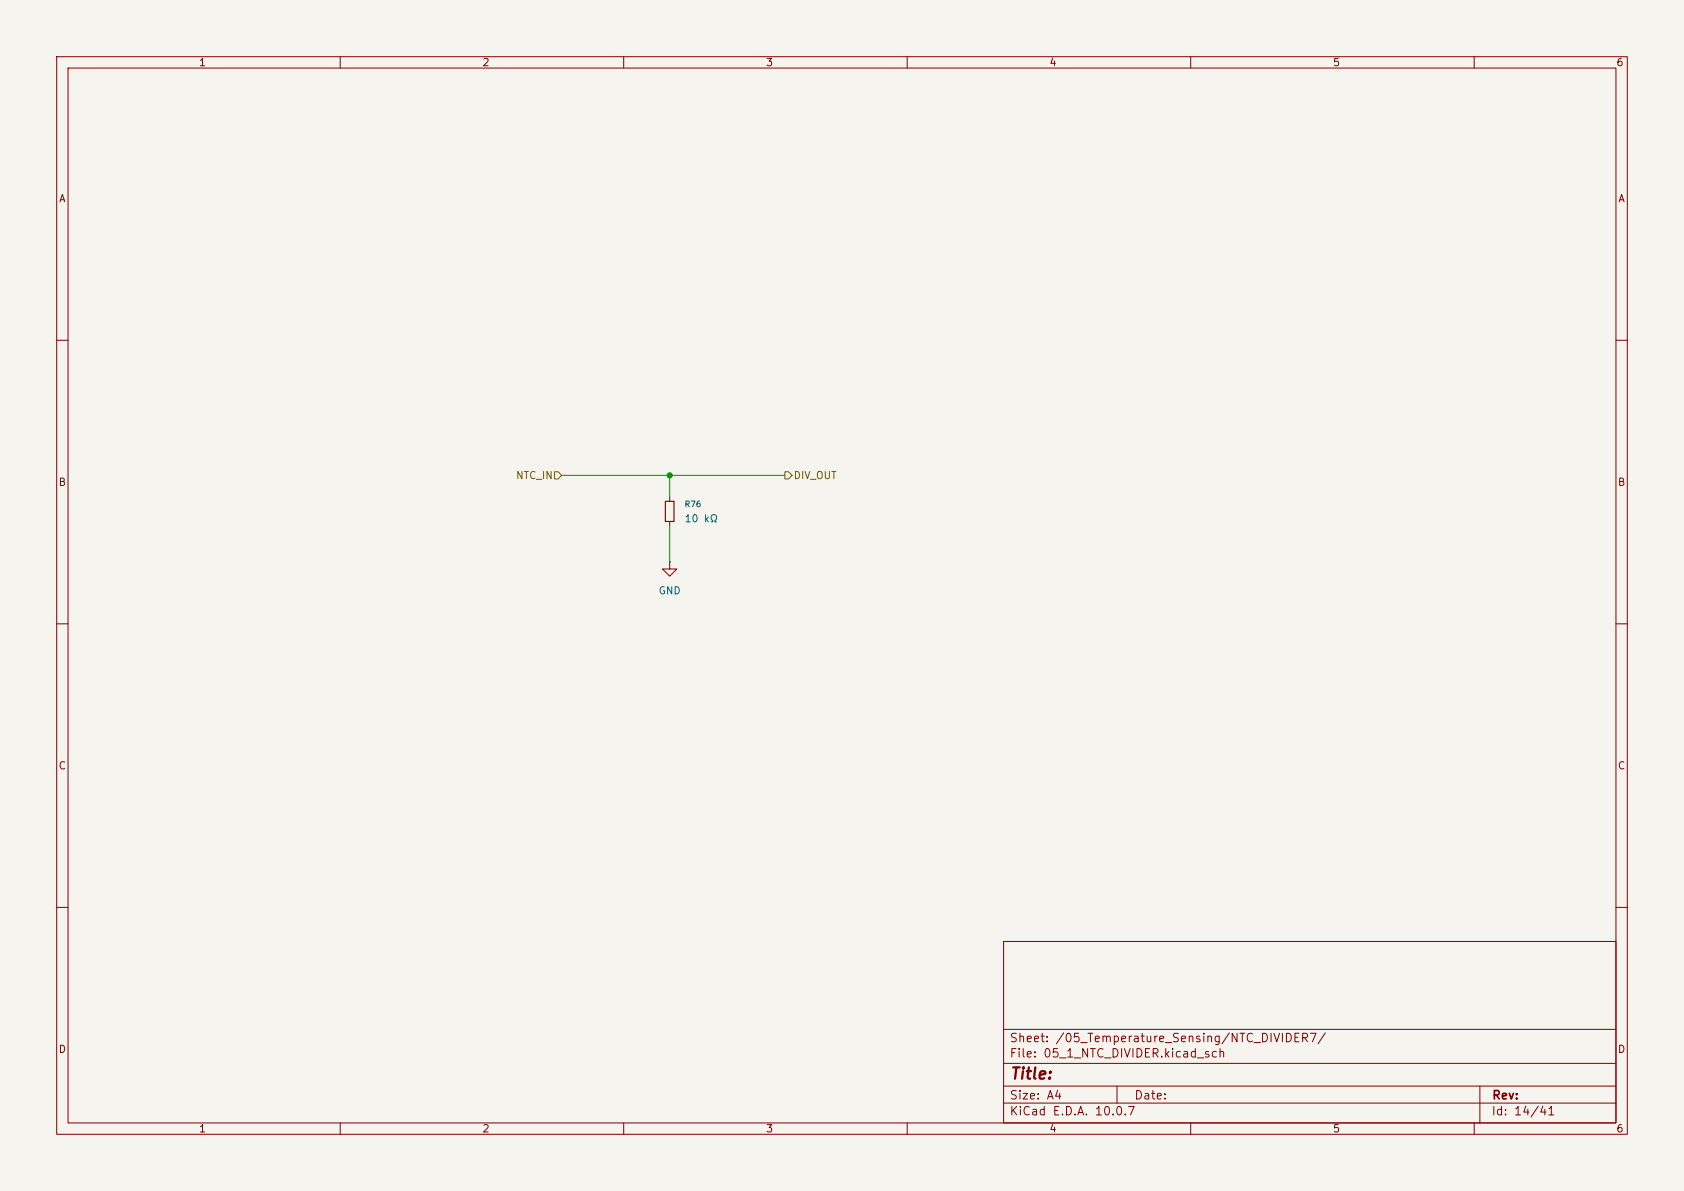
[picture p54: page 14]

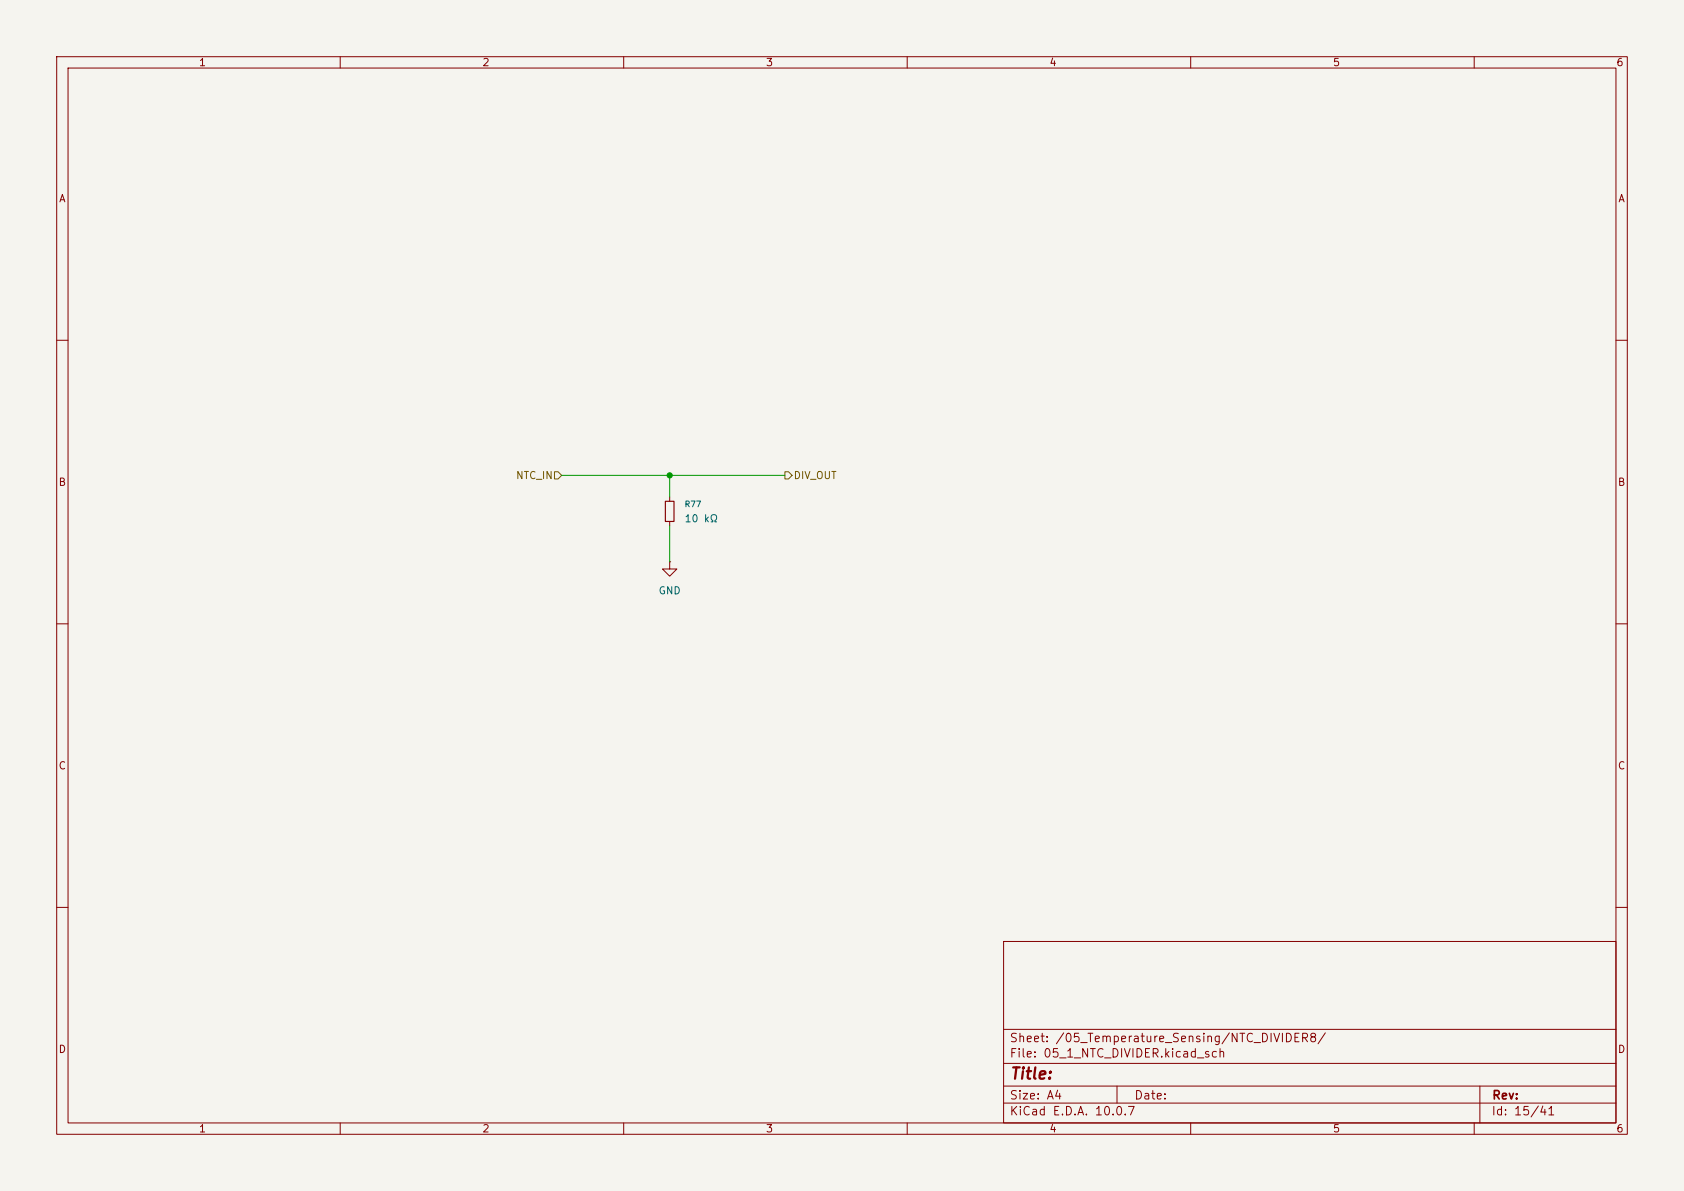
[picture p55: page 15]

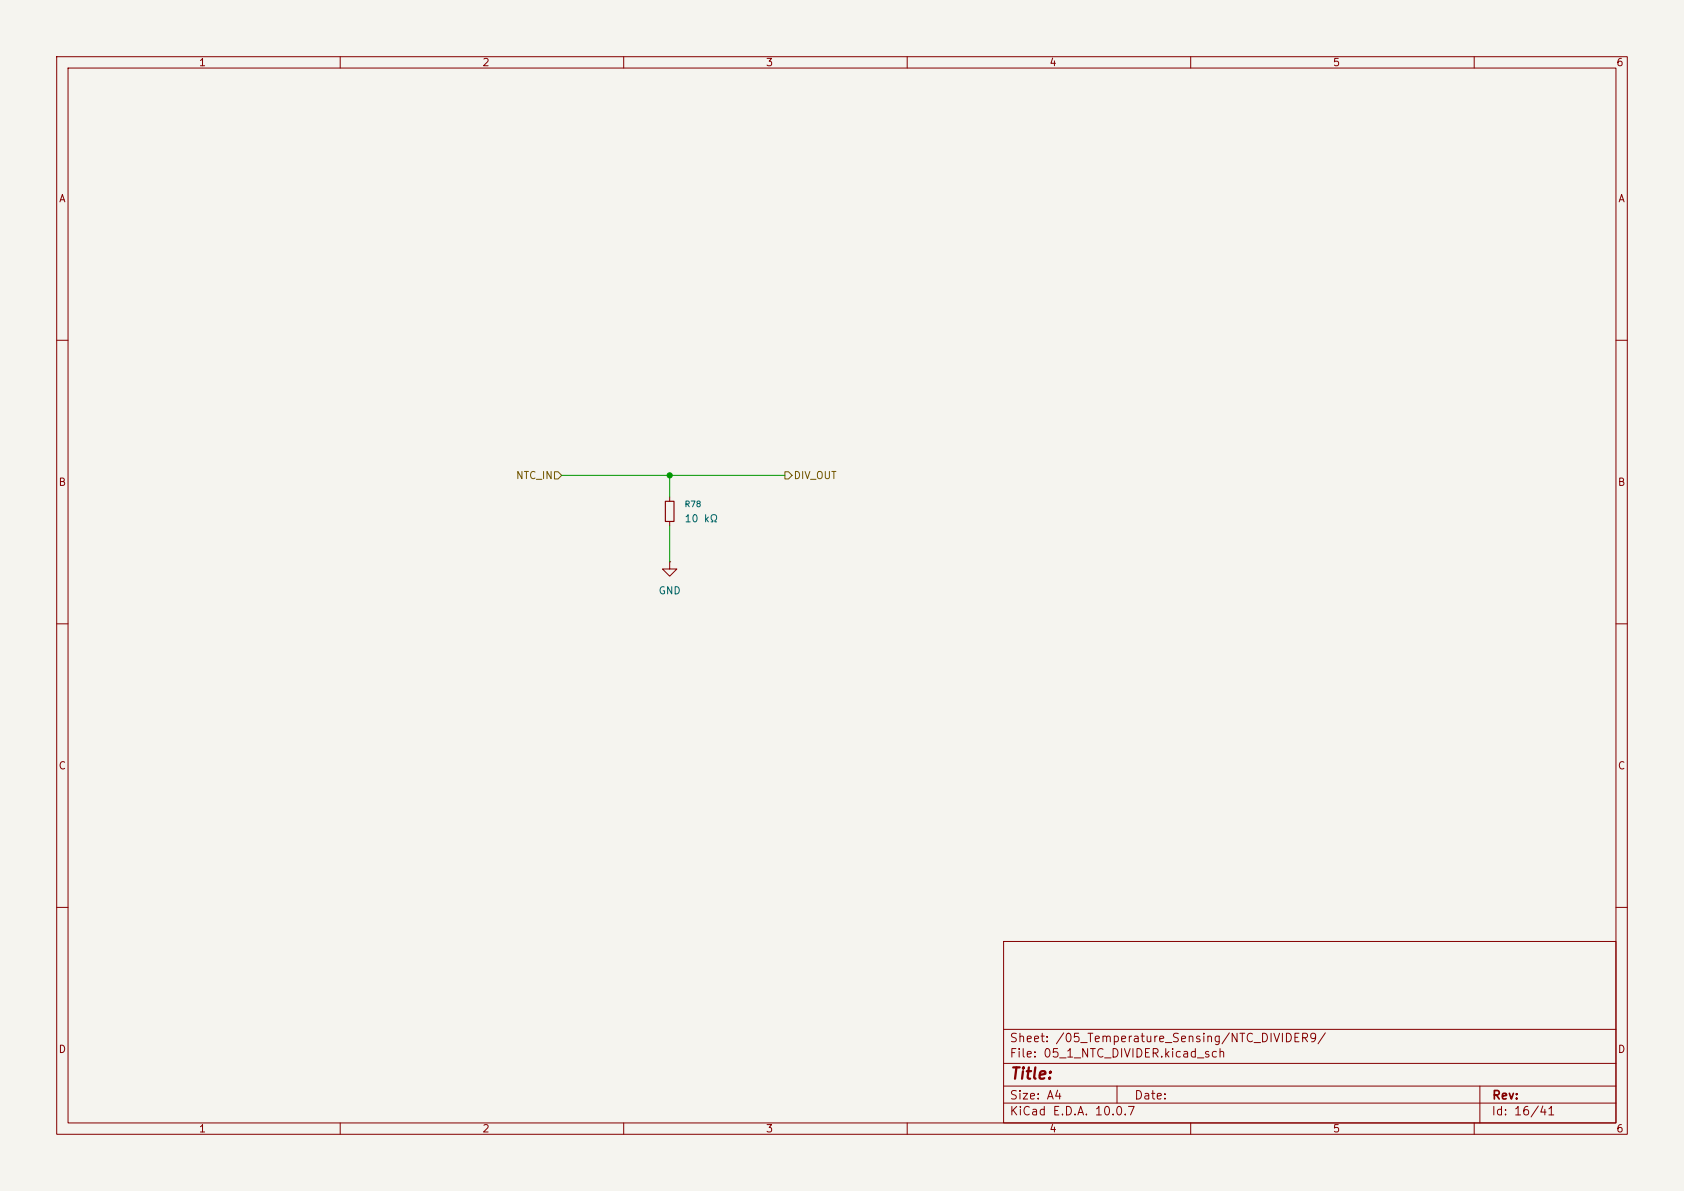
[picture p56: page 16]

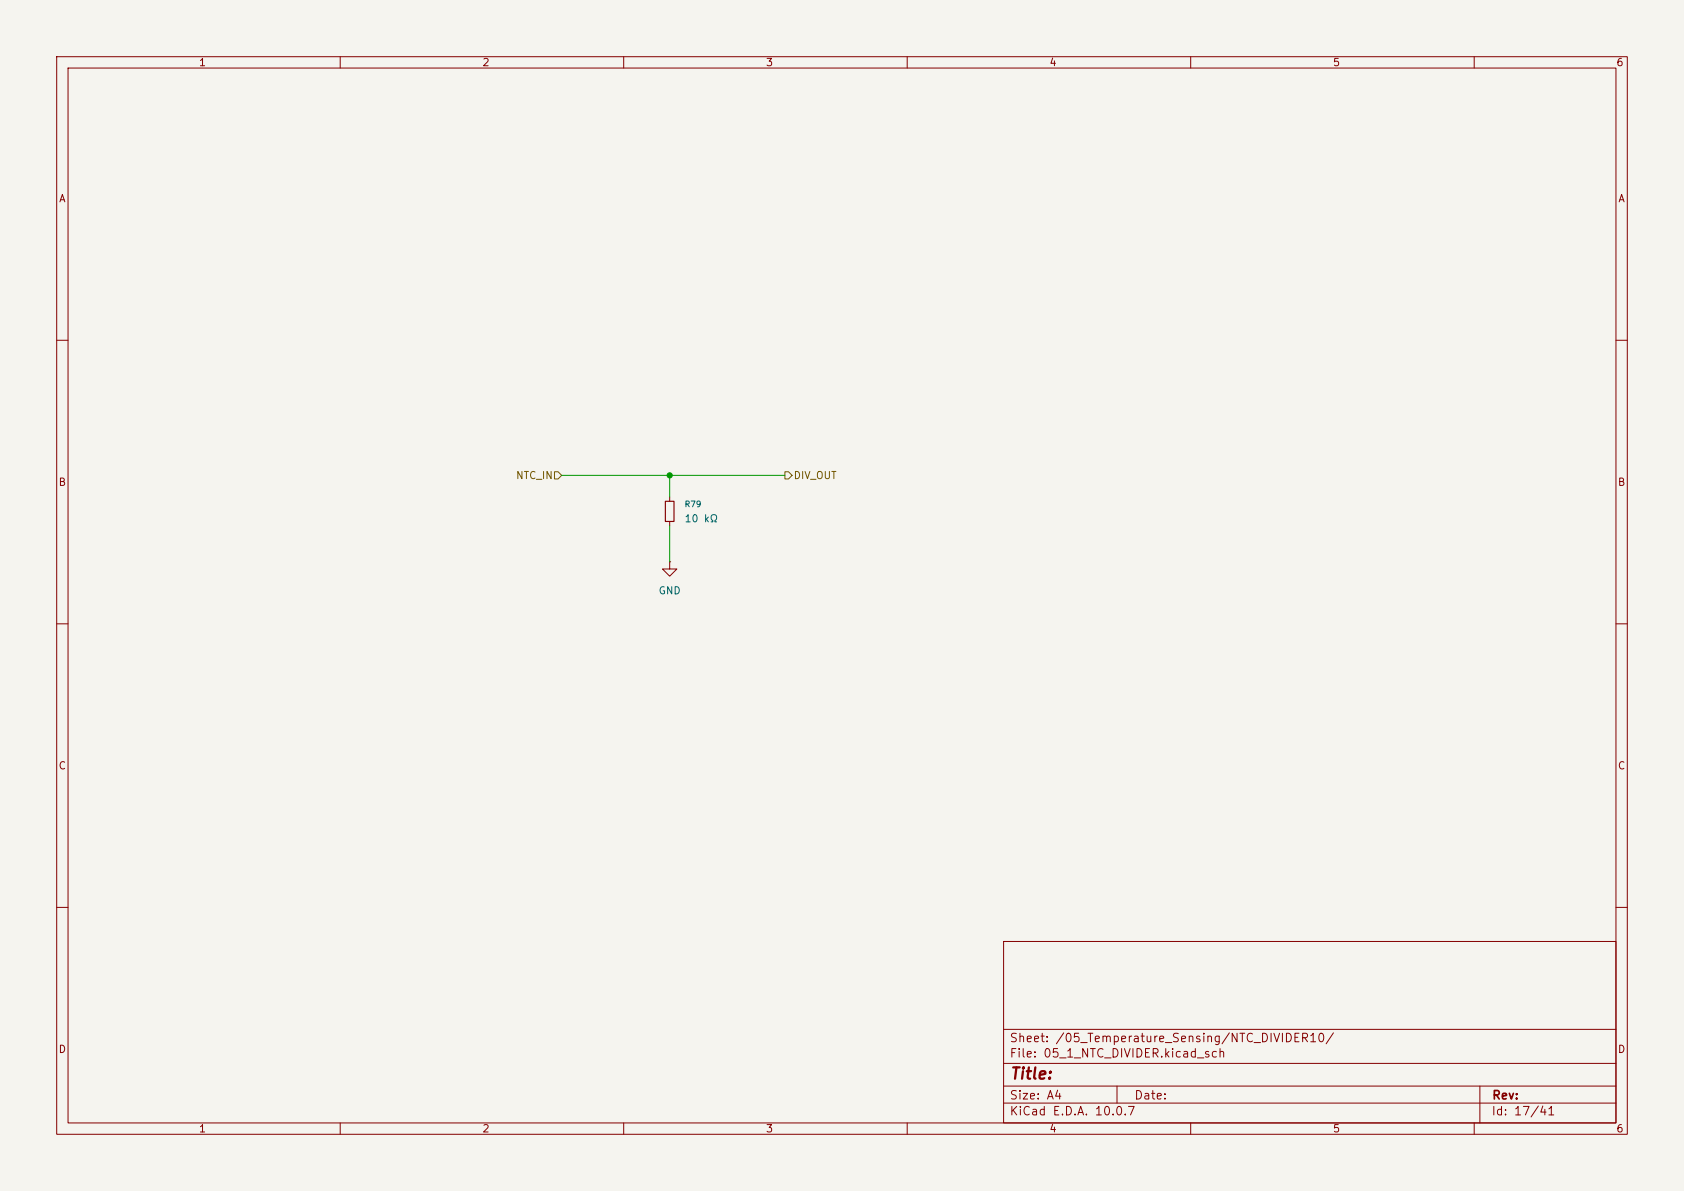
[picture p57: page 17]

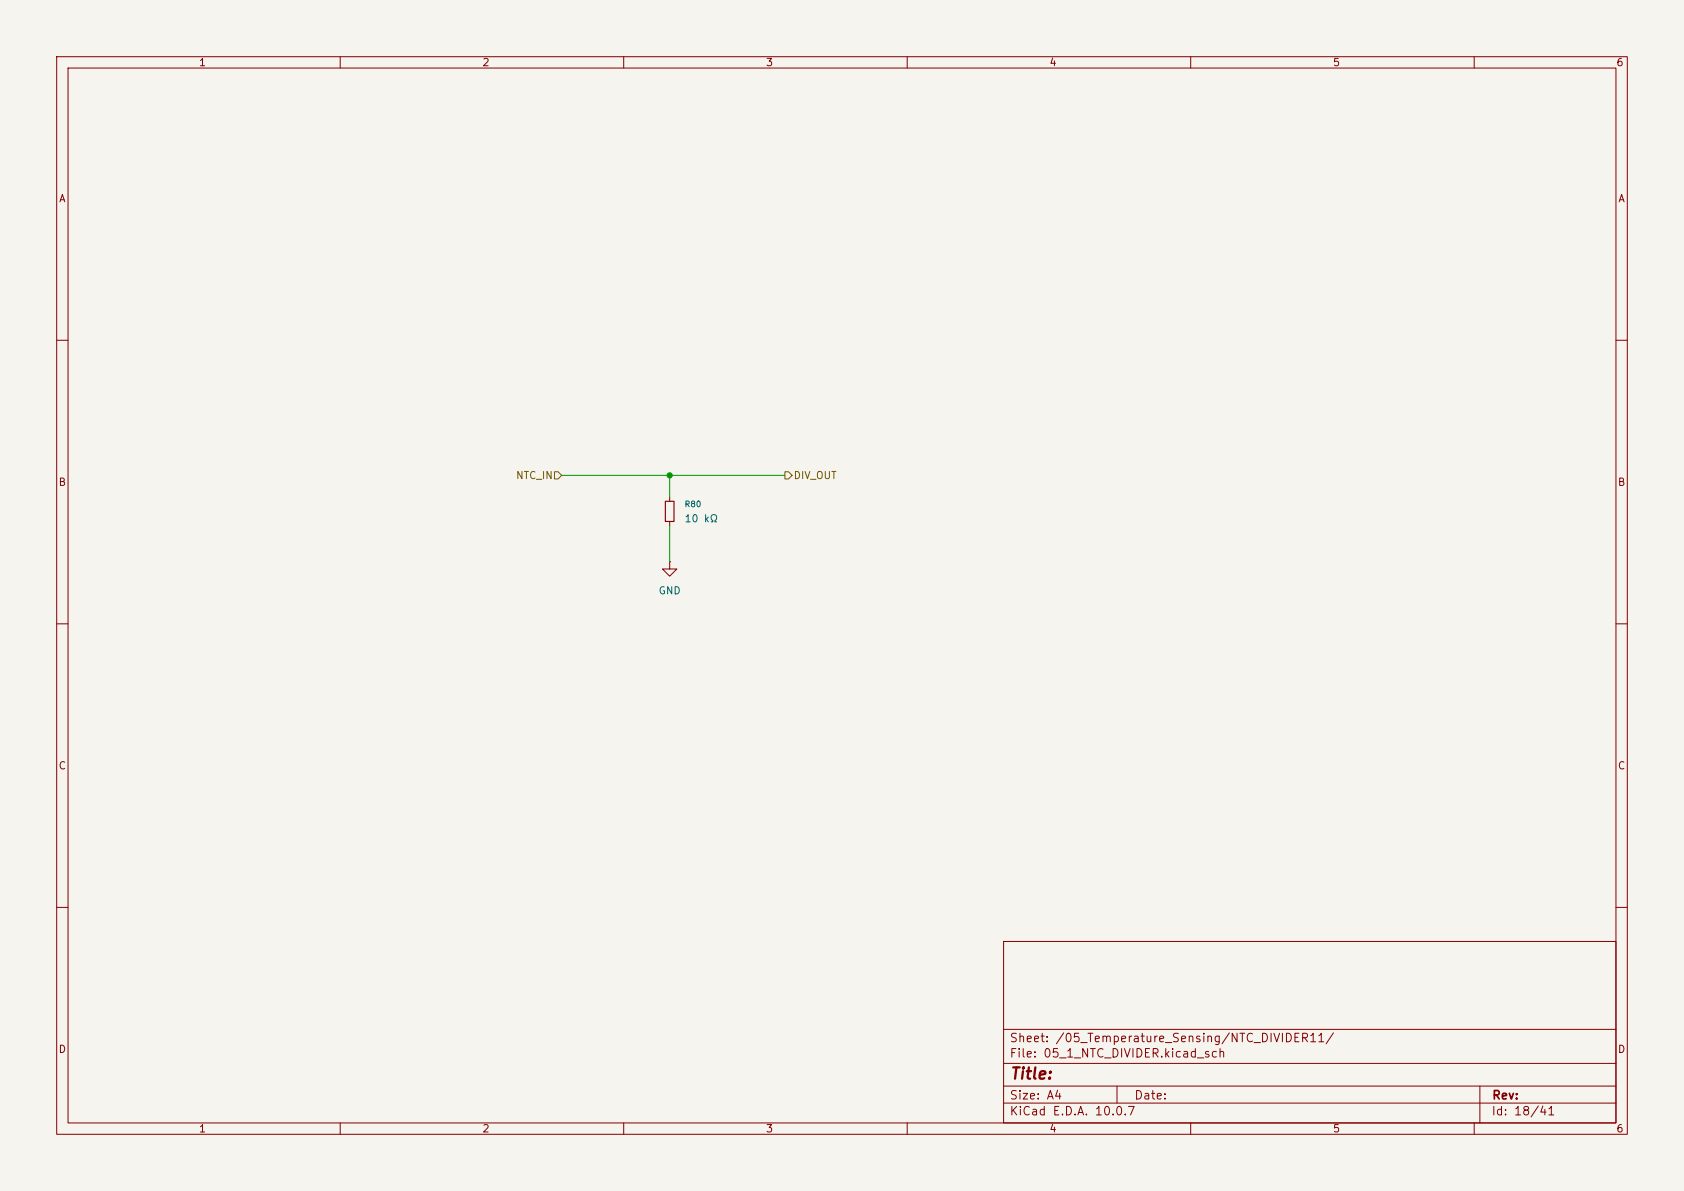
[picture p58: page 18]

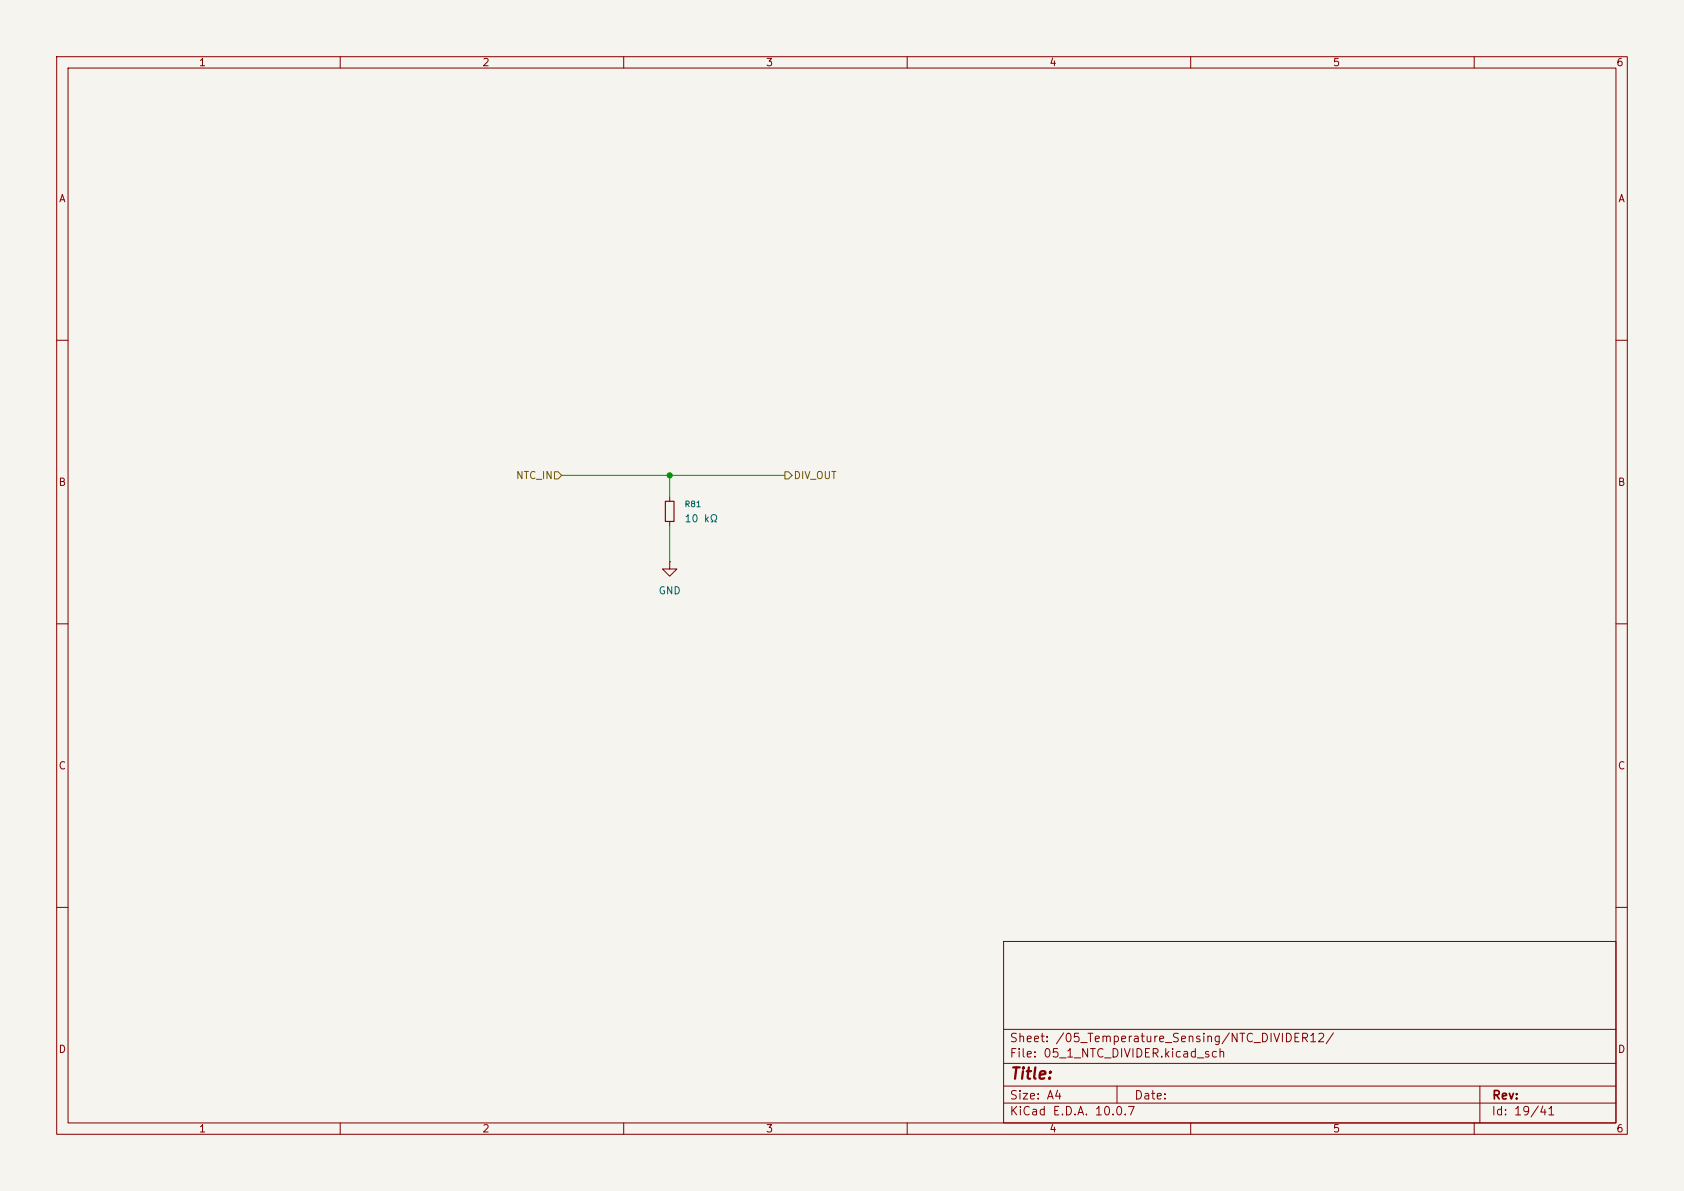
[picture p59: page 19]

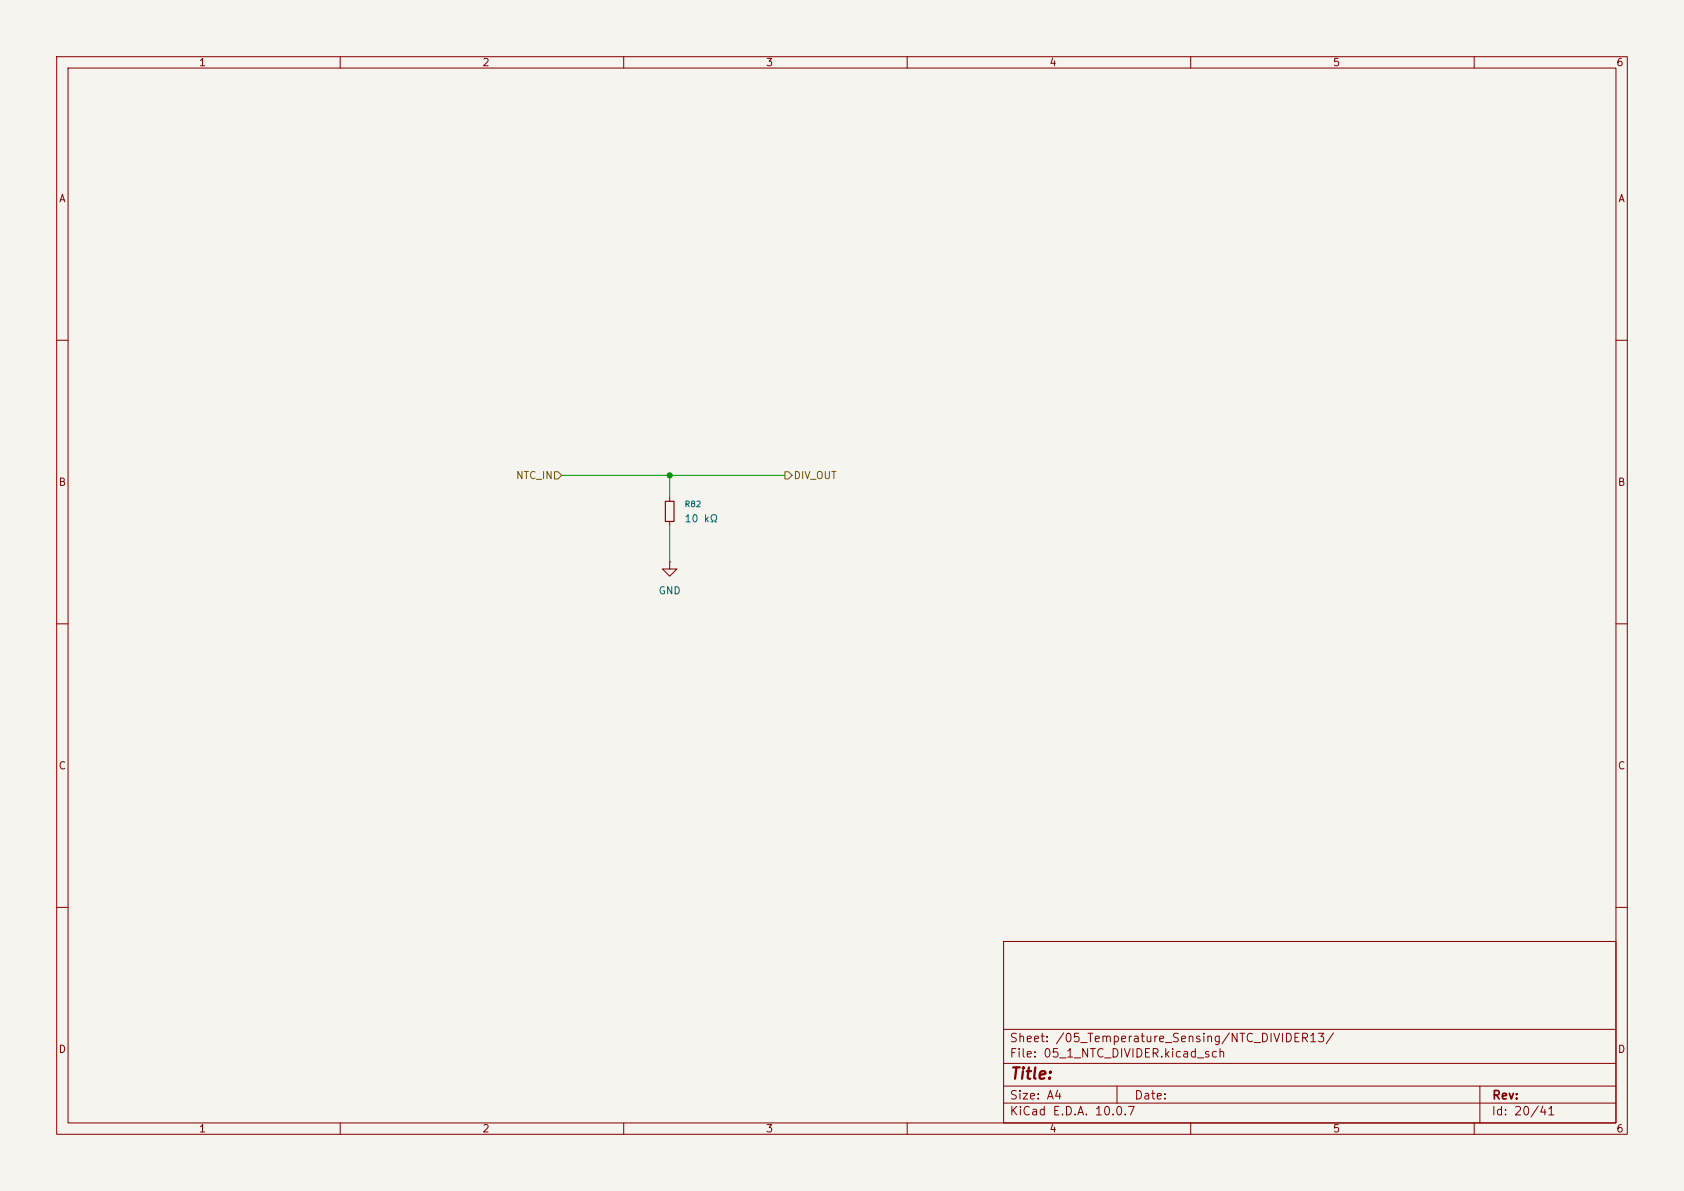
[picture p60: page 20]

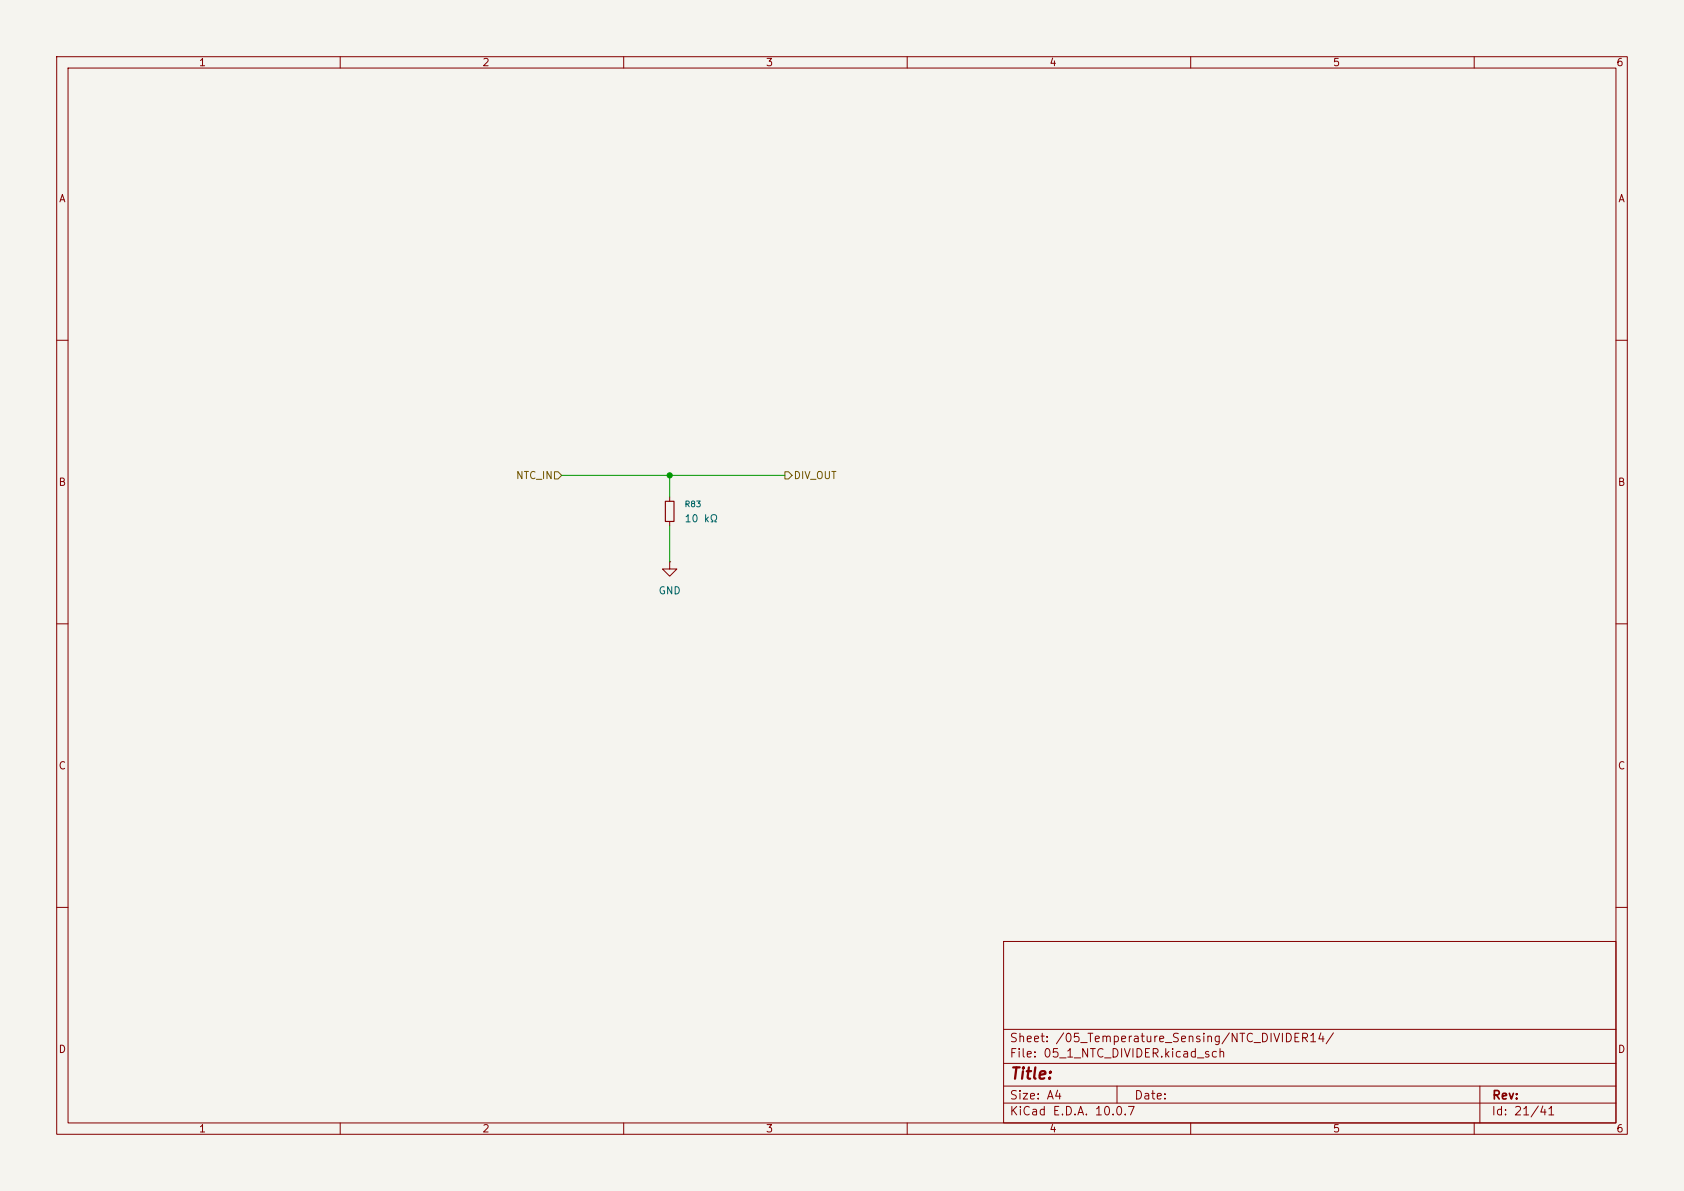
[picture p61: page 21]

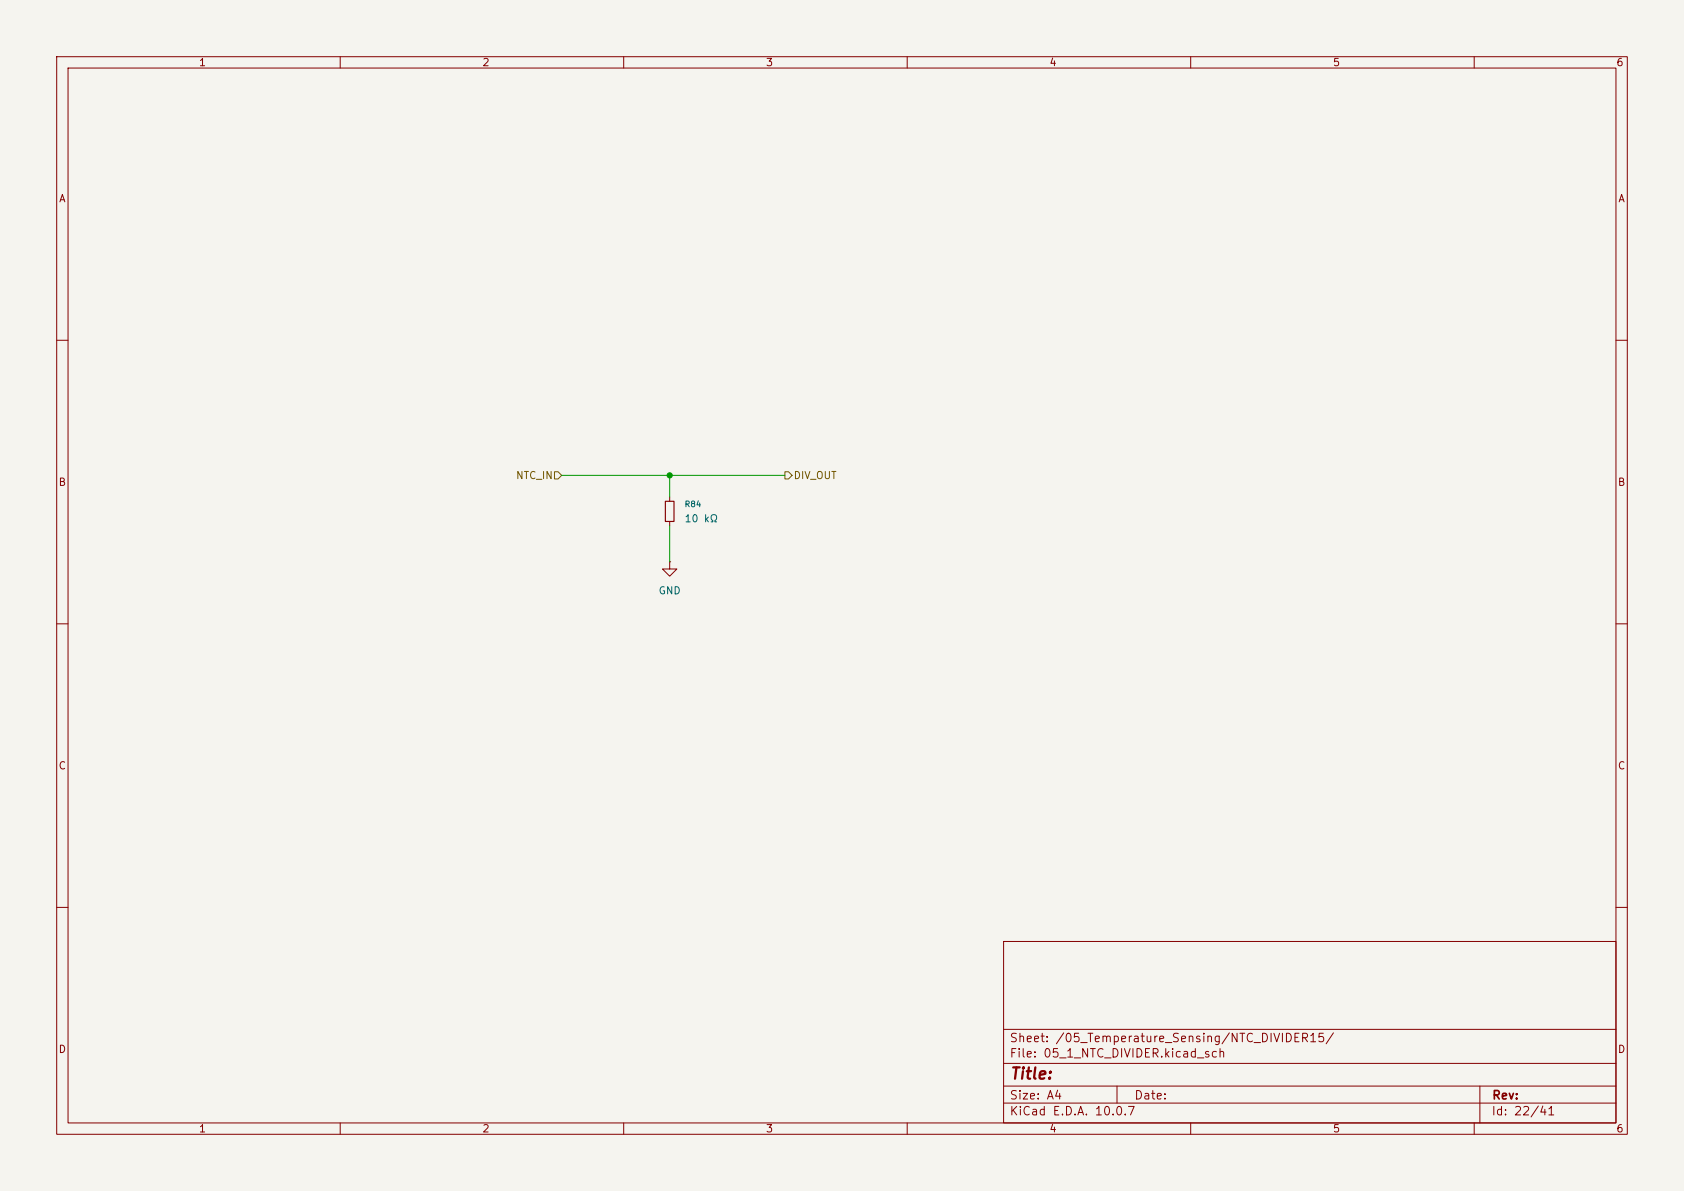
[picture p62: page 22]

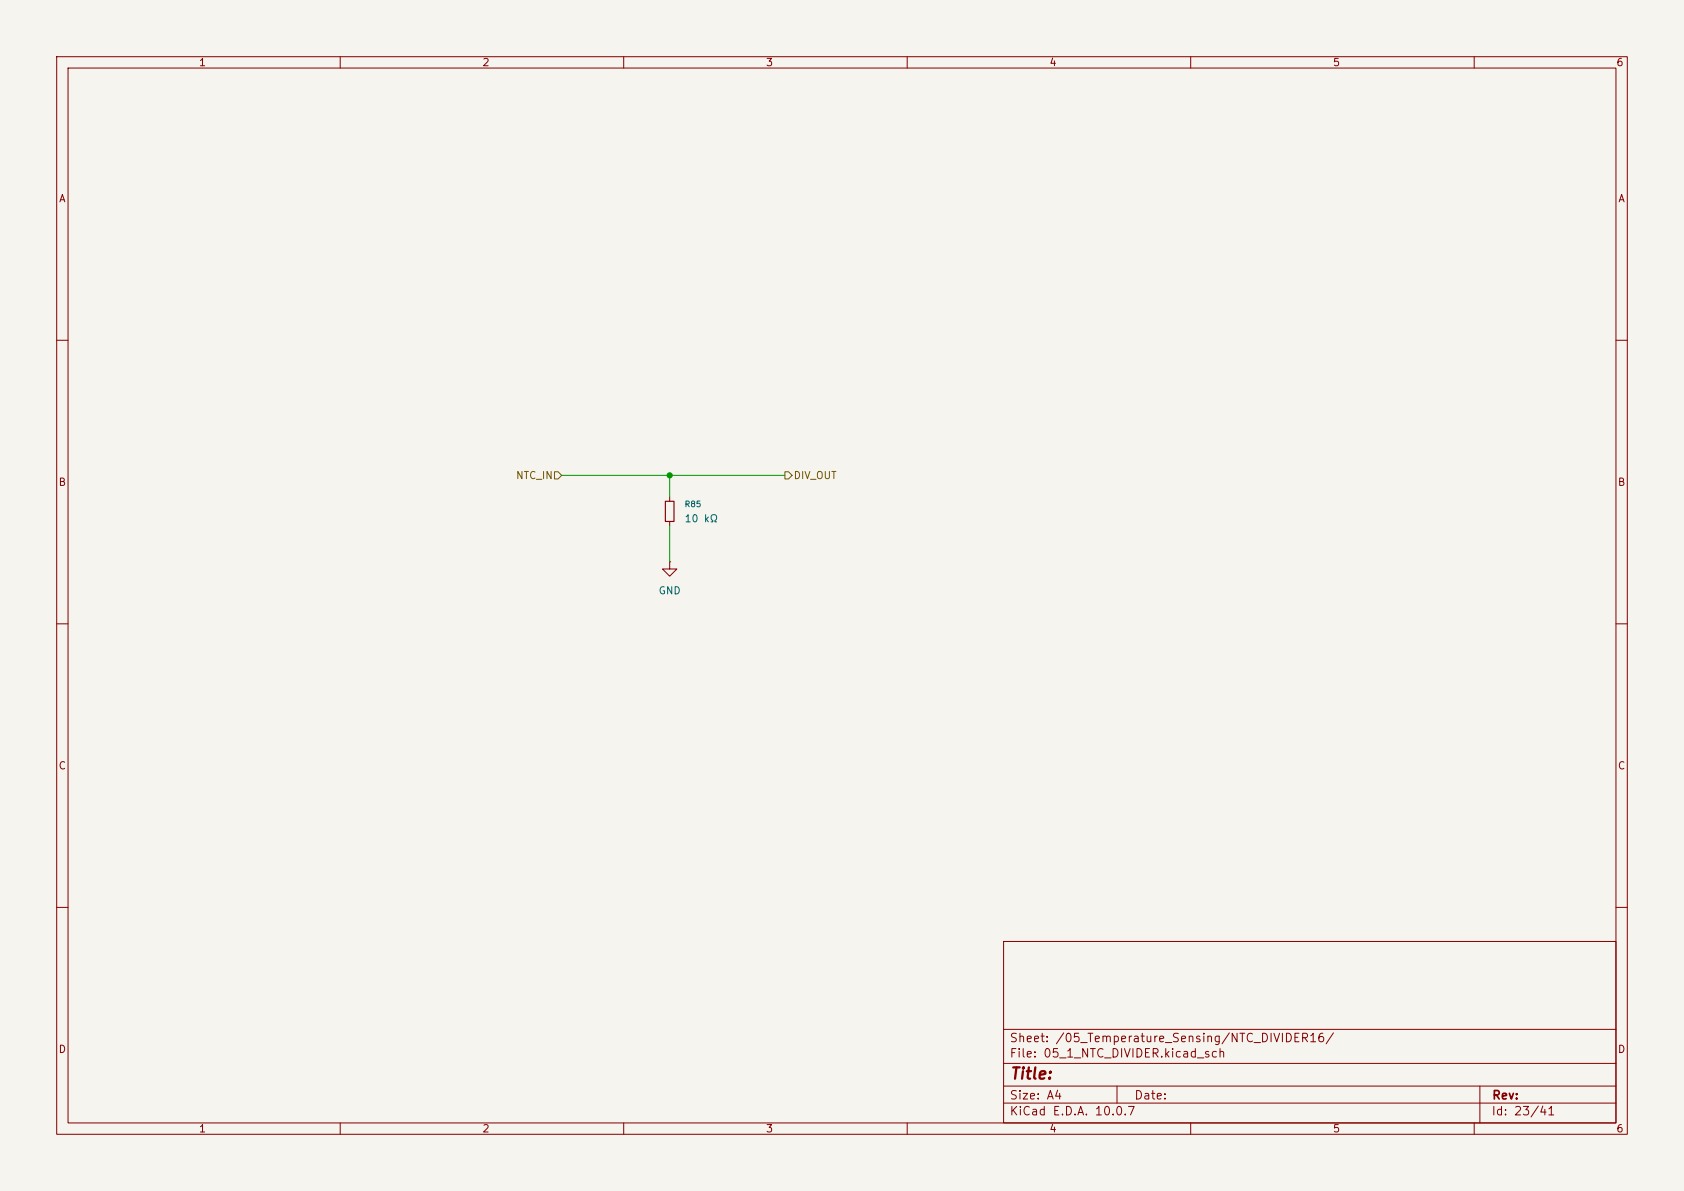
[picture p63: page 23]

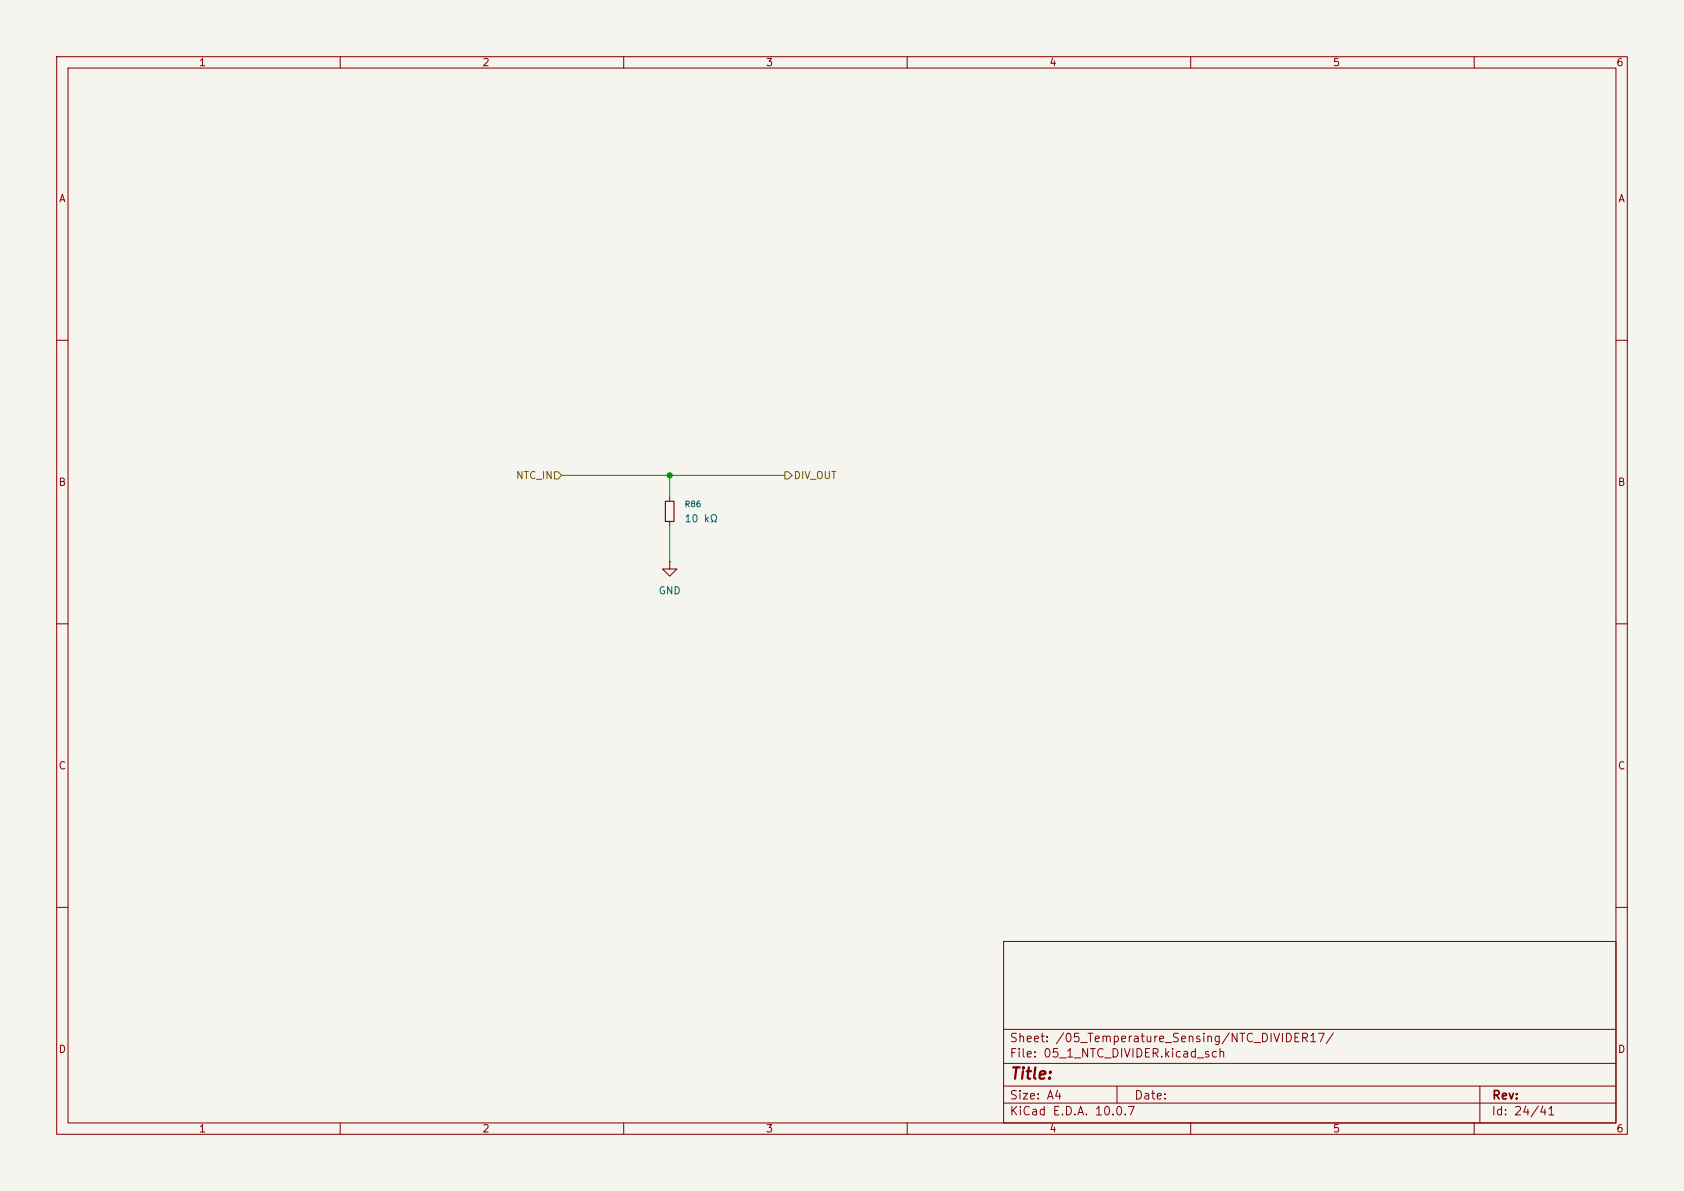
[picture p64: page 24]

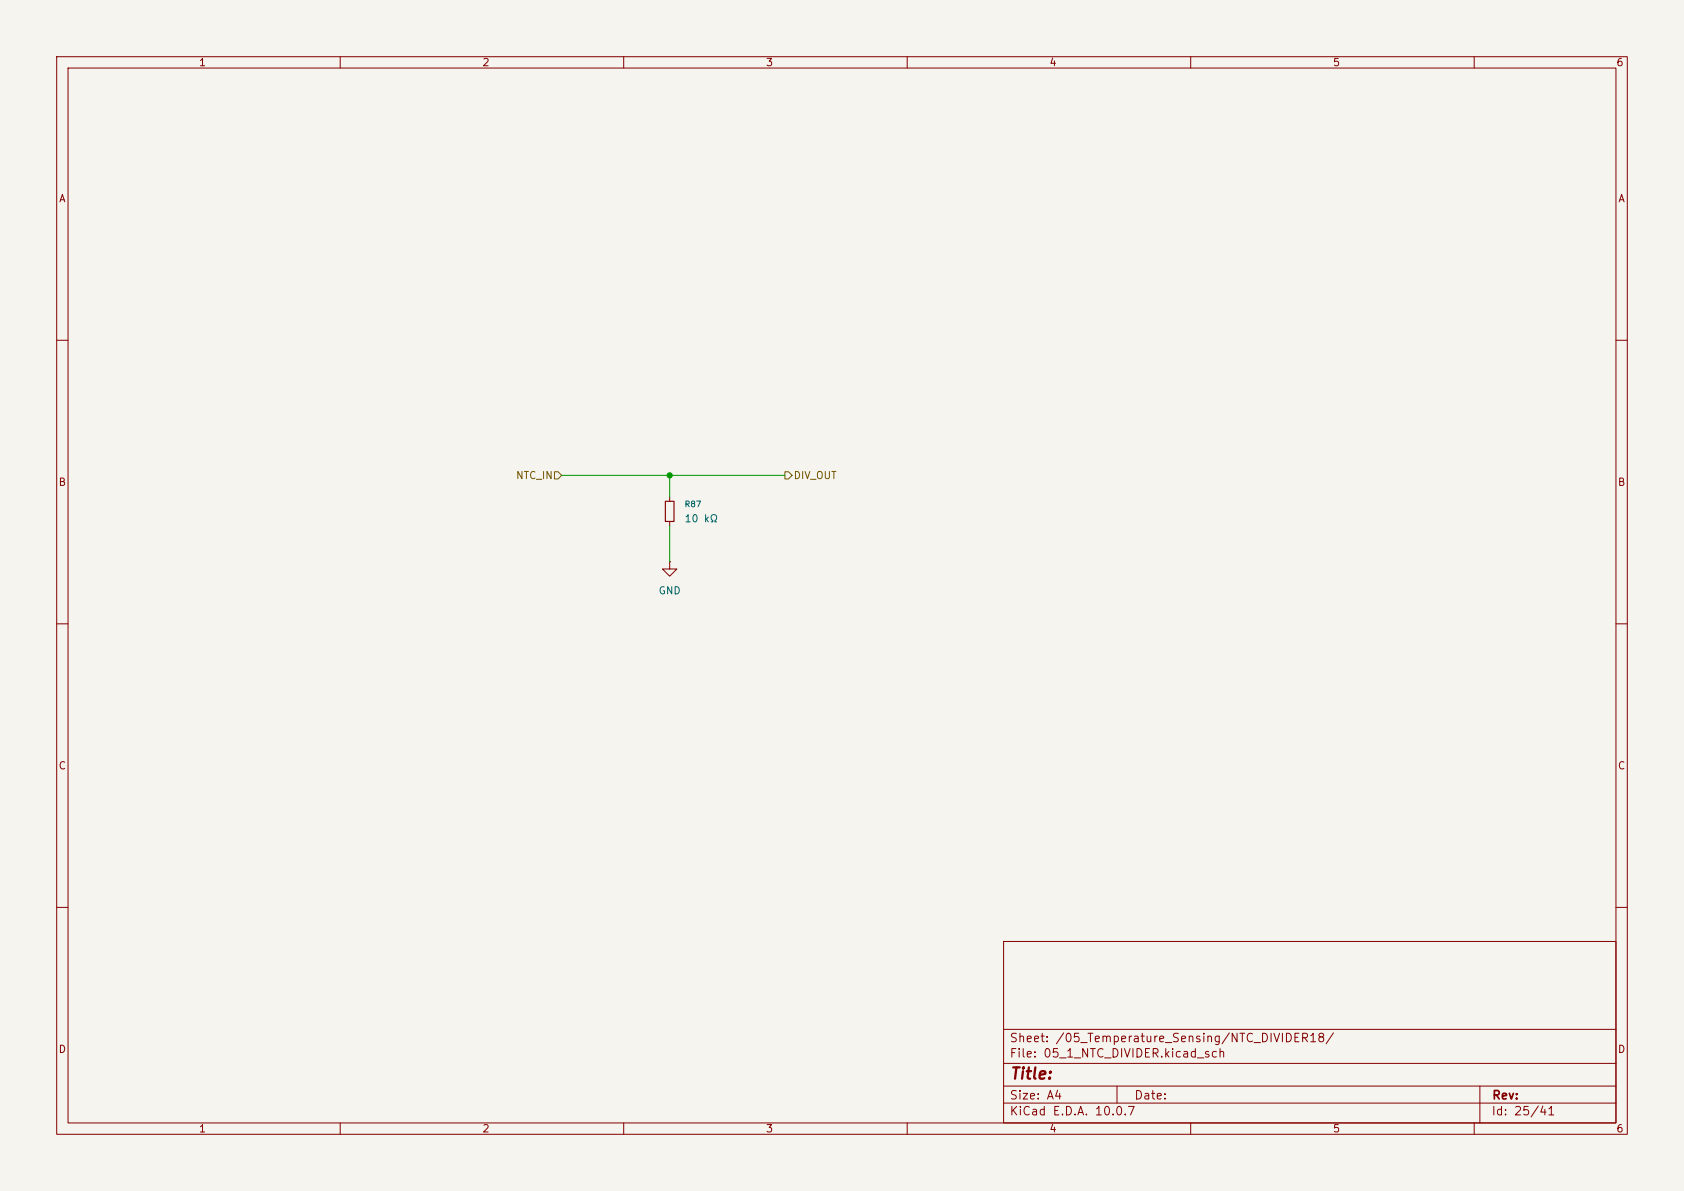
[picture p65: page 25]

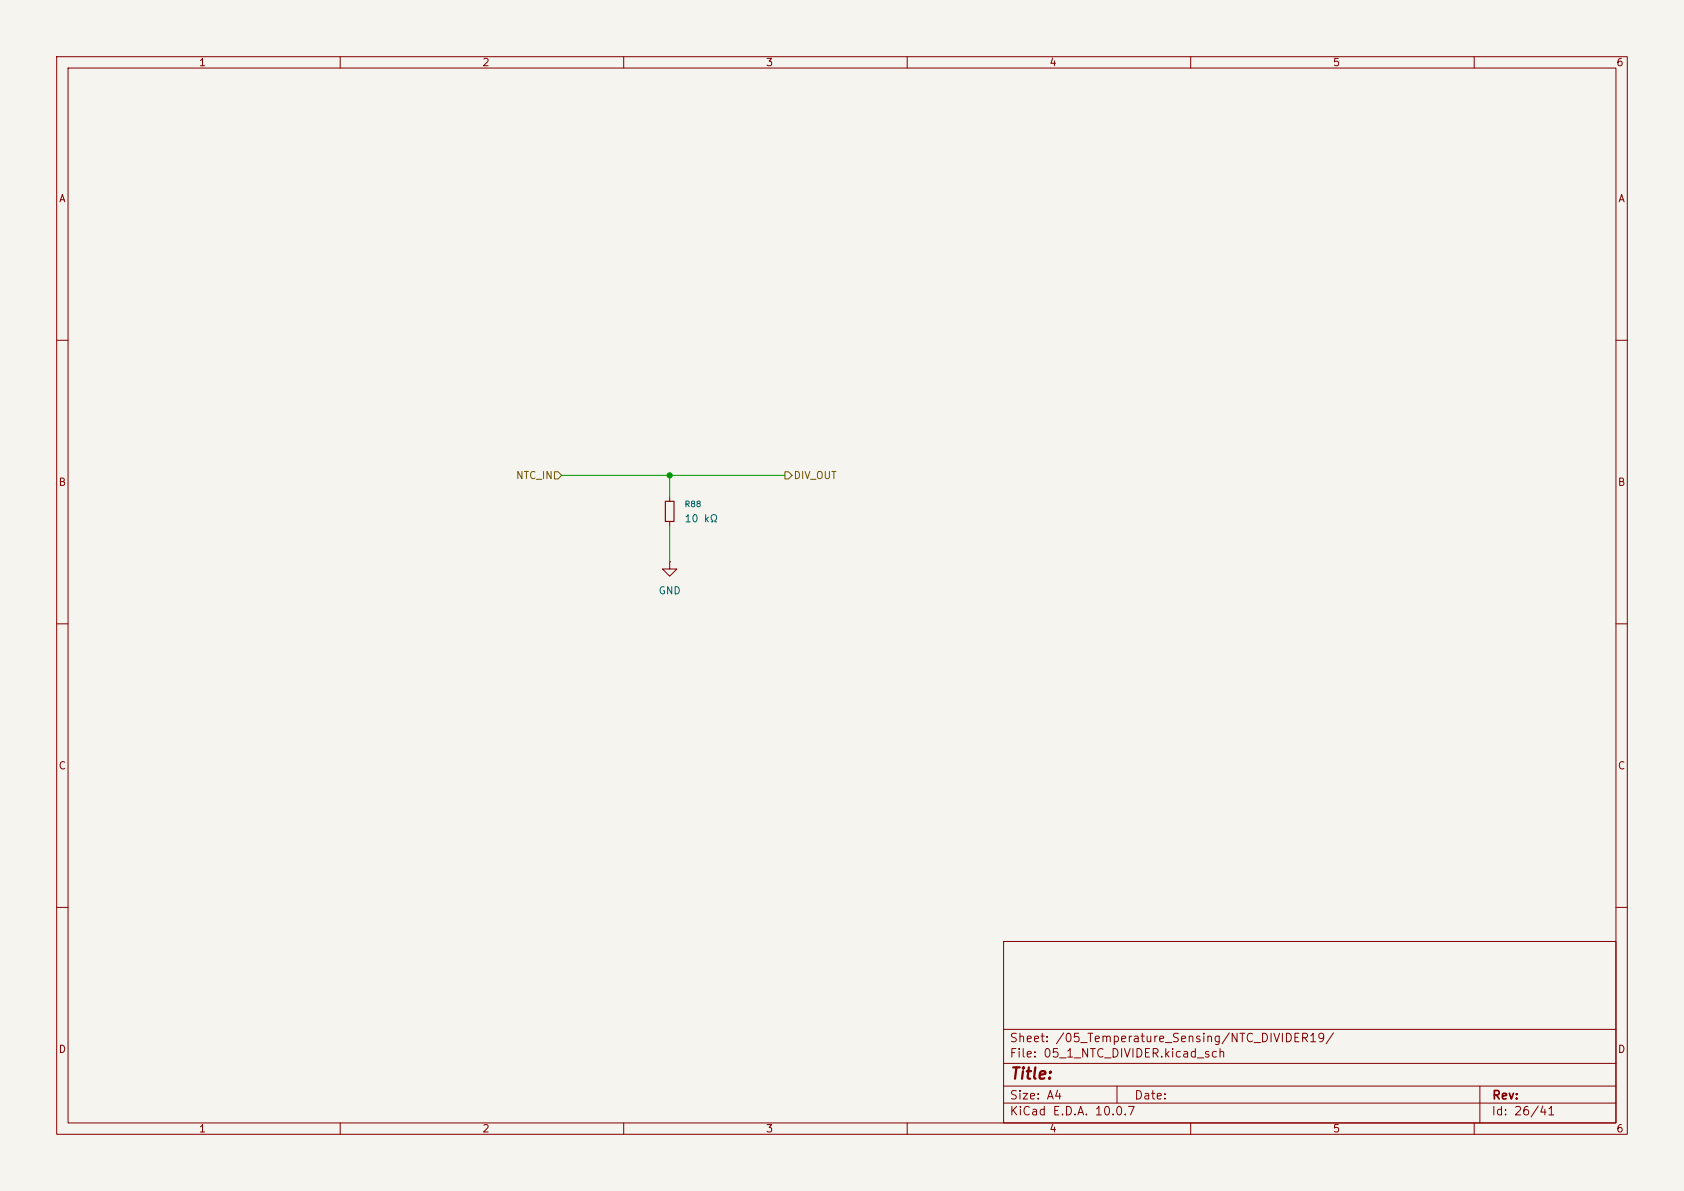
[picture p66: page 26]

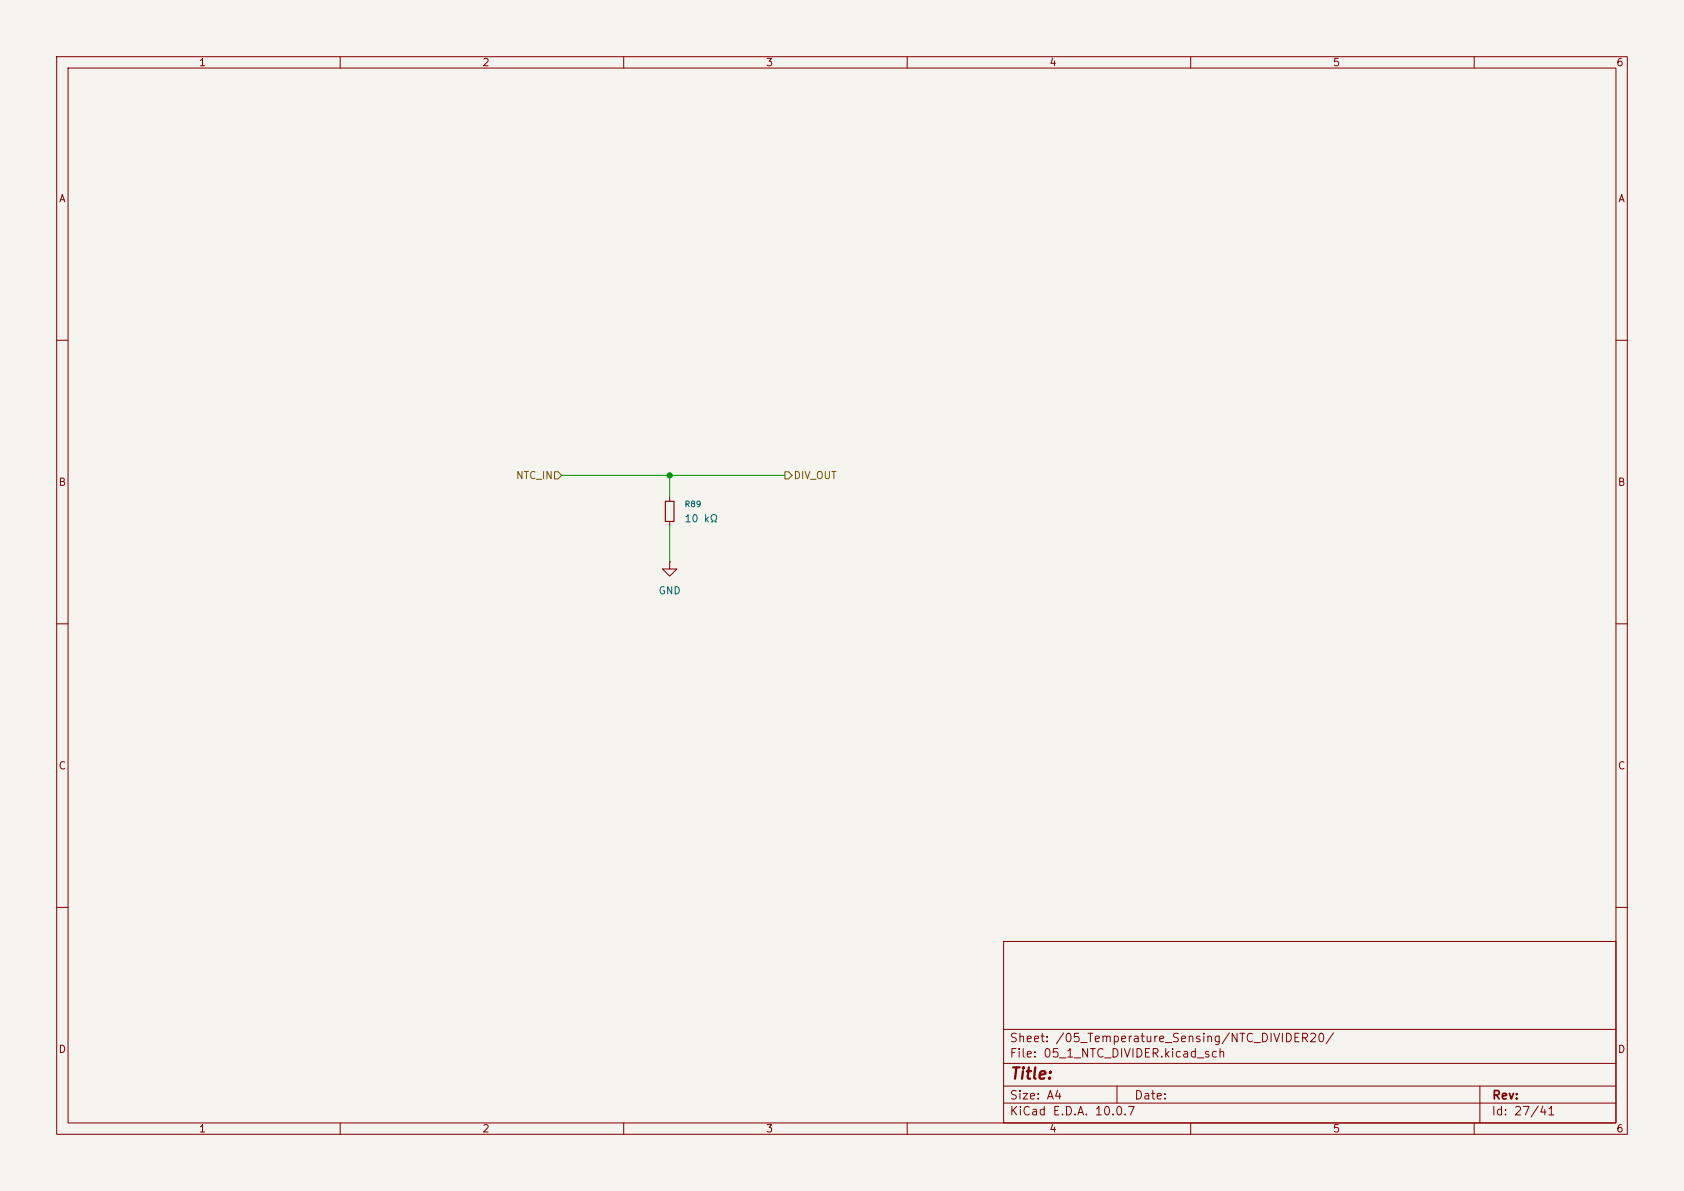
[picture p67: page 27]

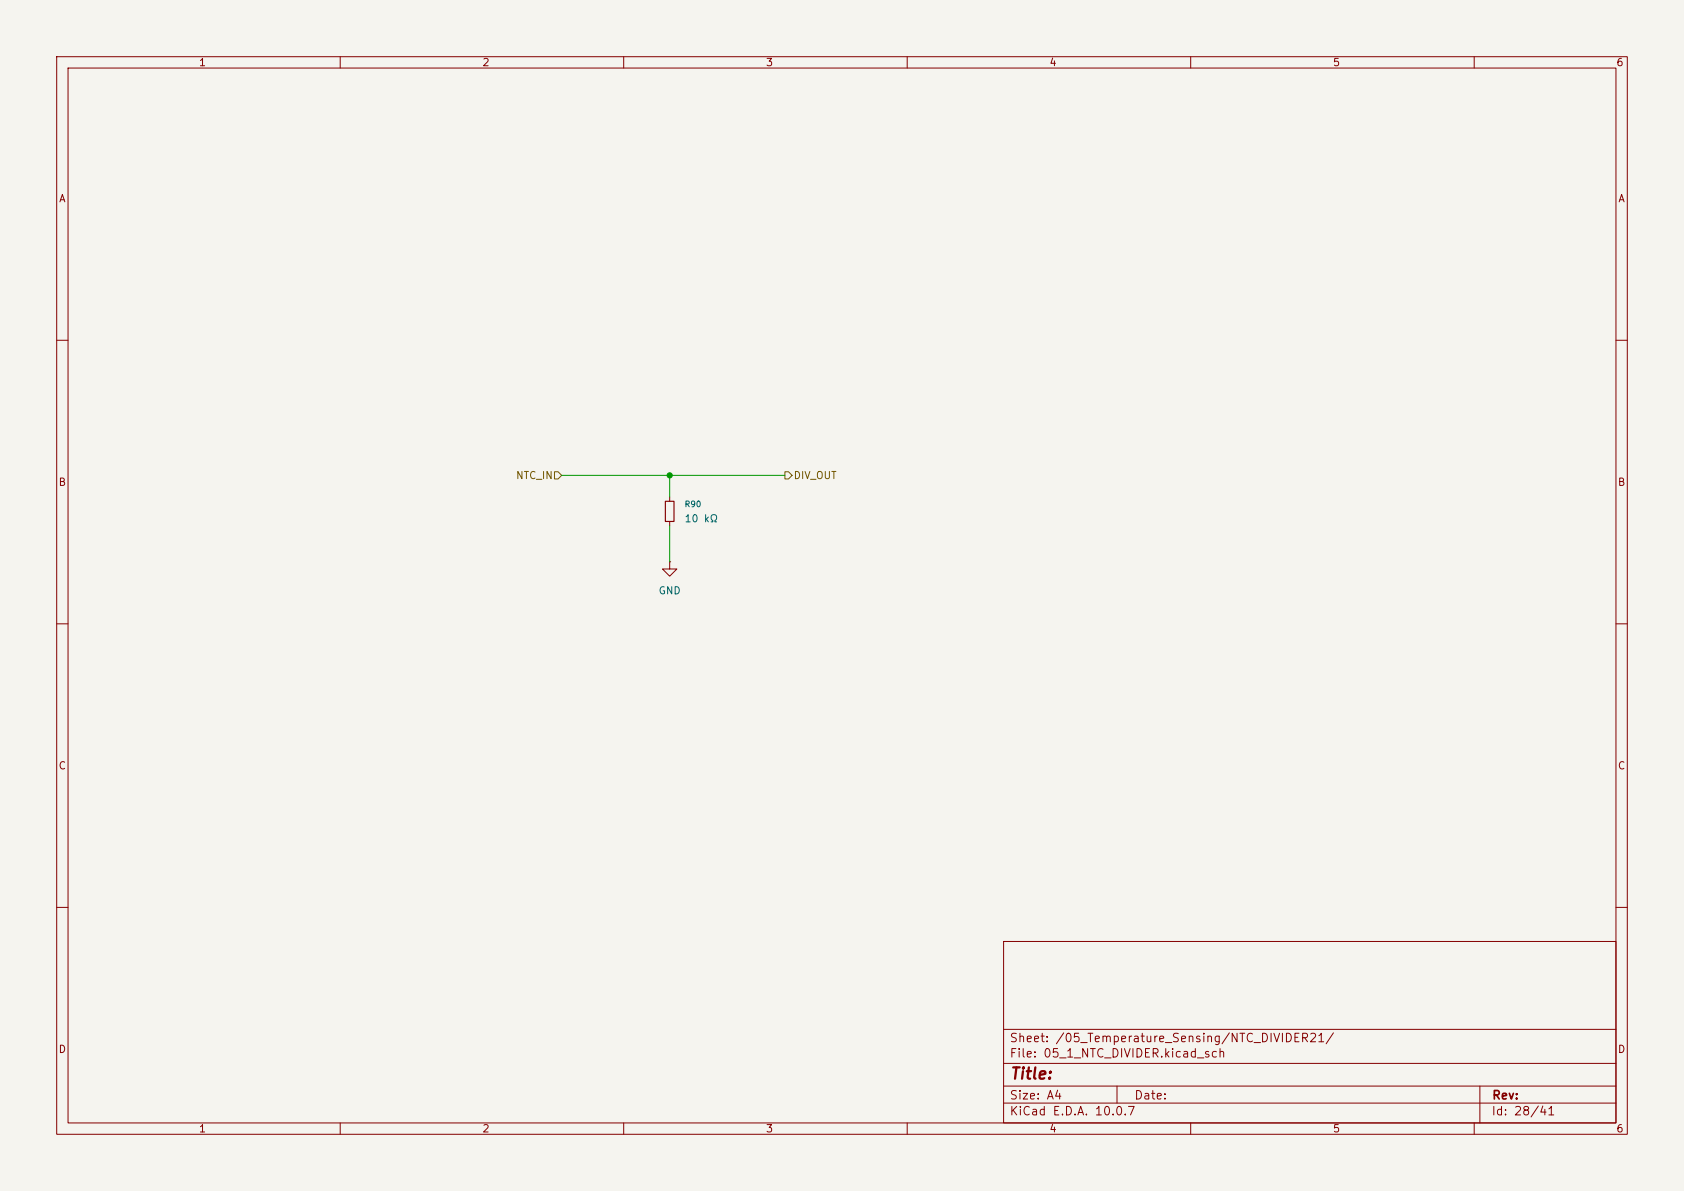
[picture p68: page 28]

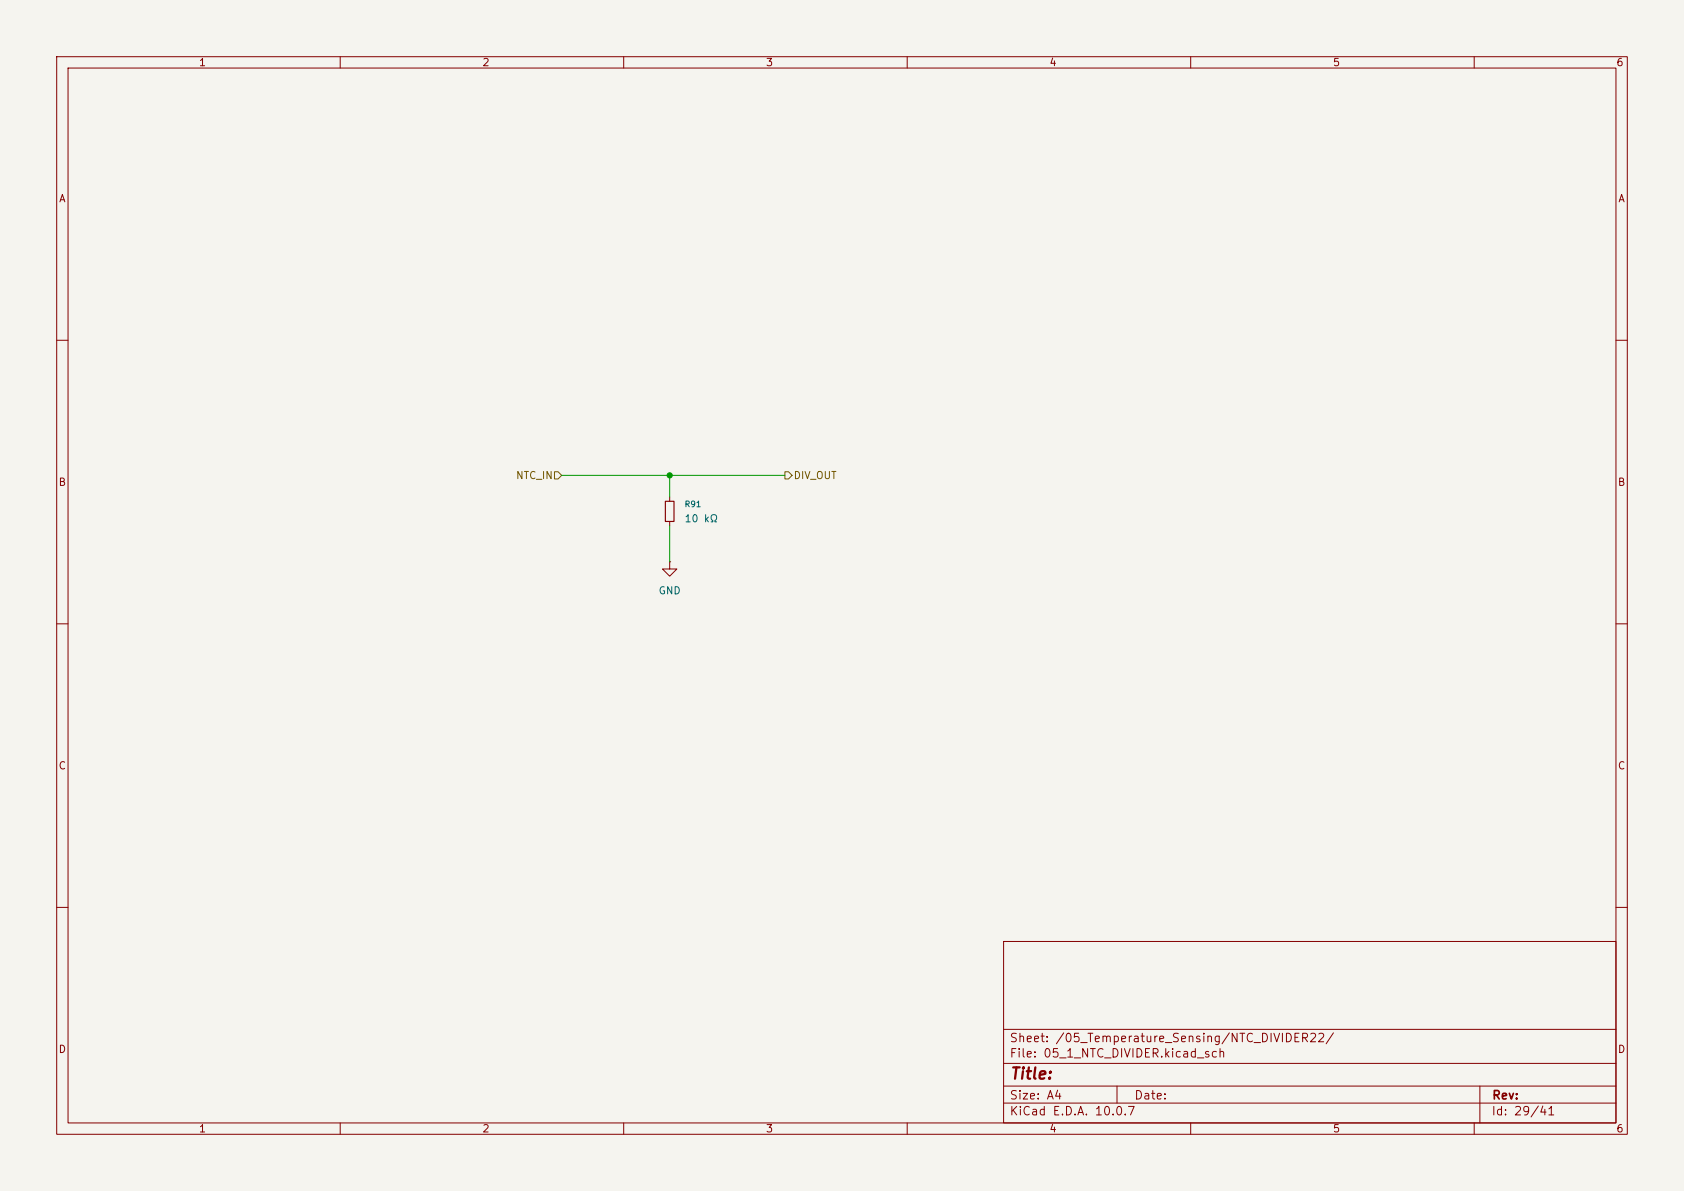
[picture p69: page 29]

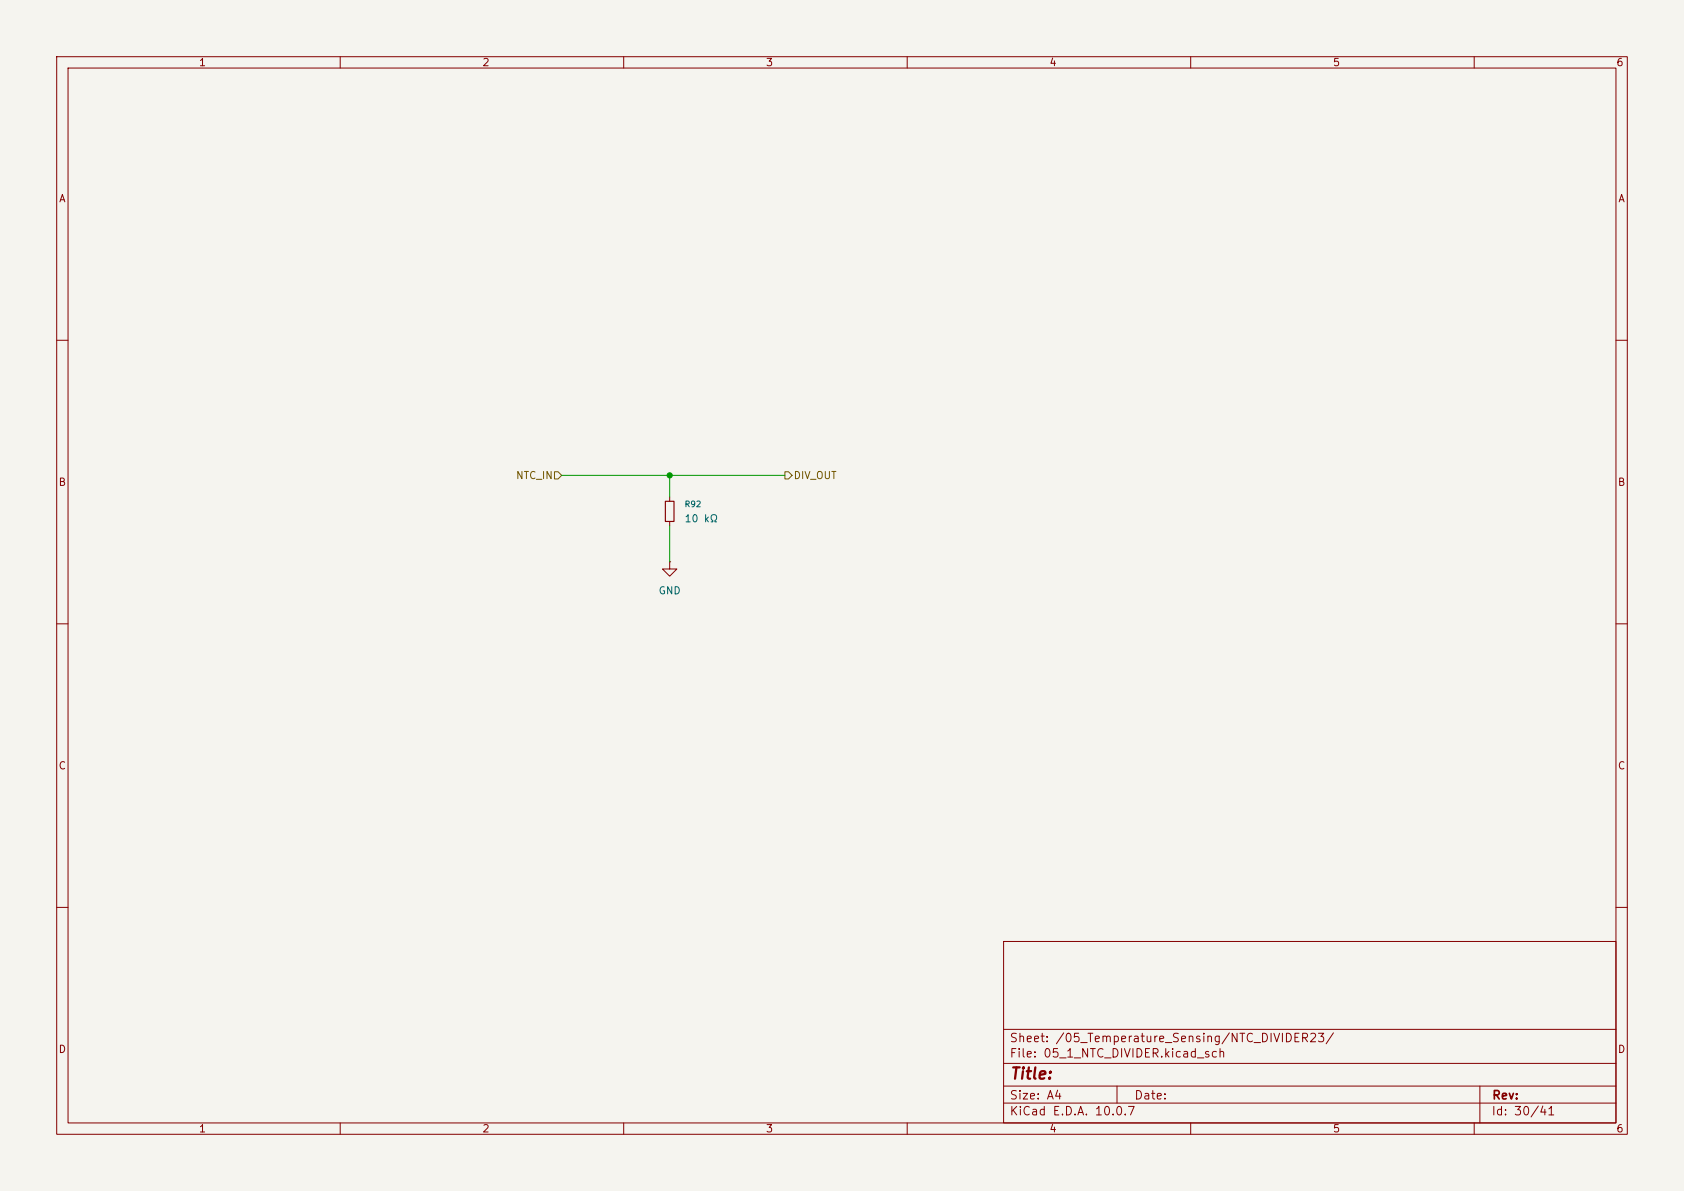
[picture p70: page 30]

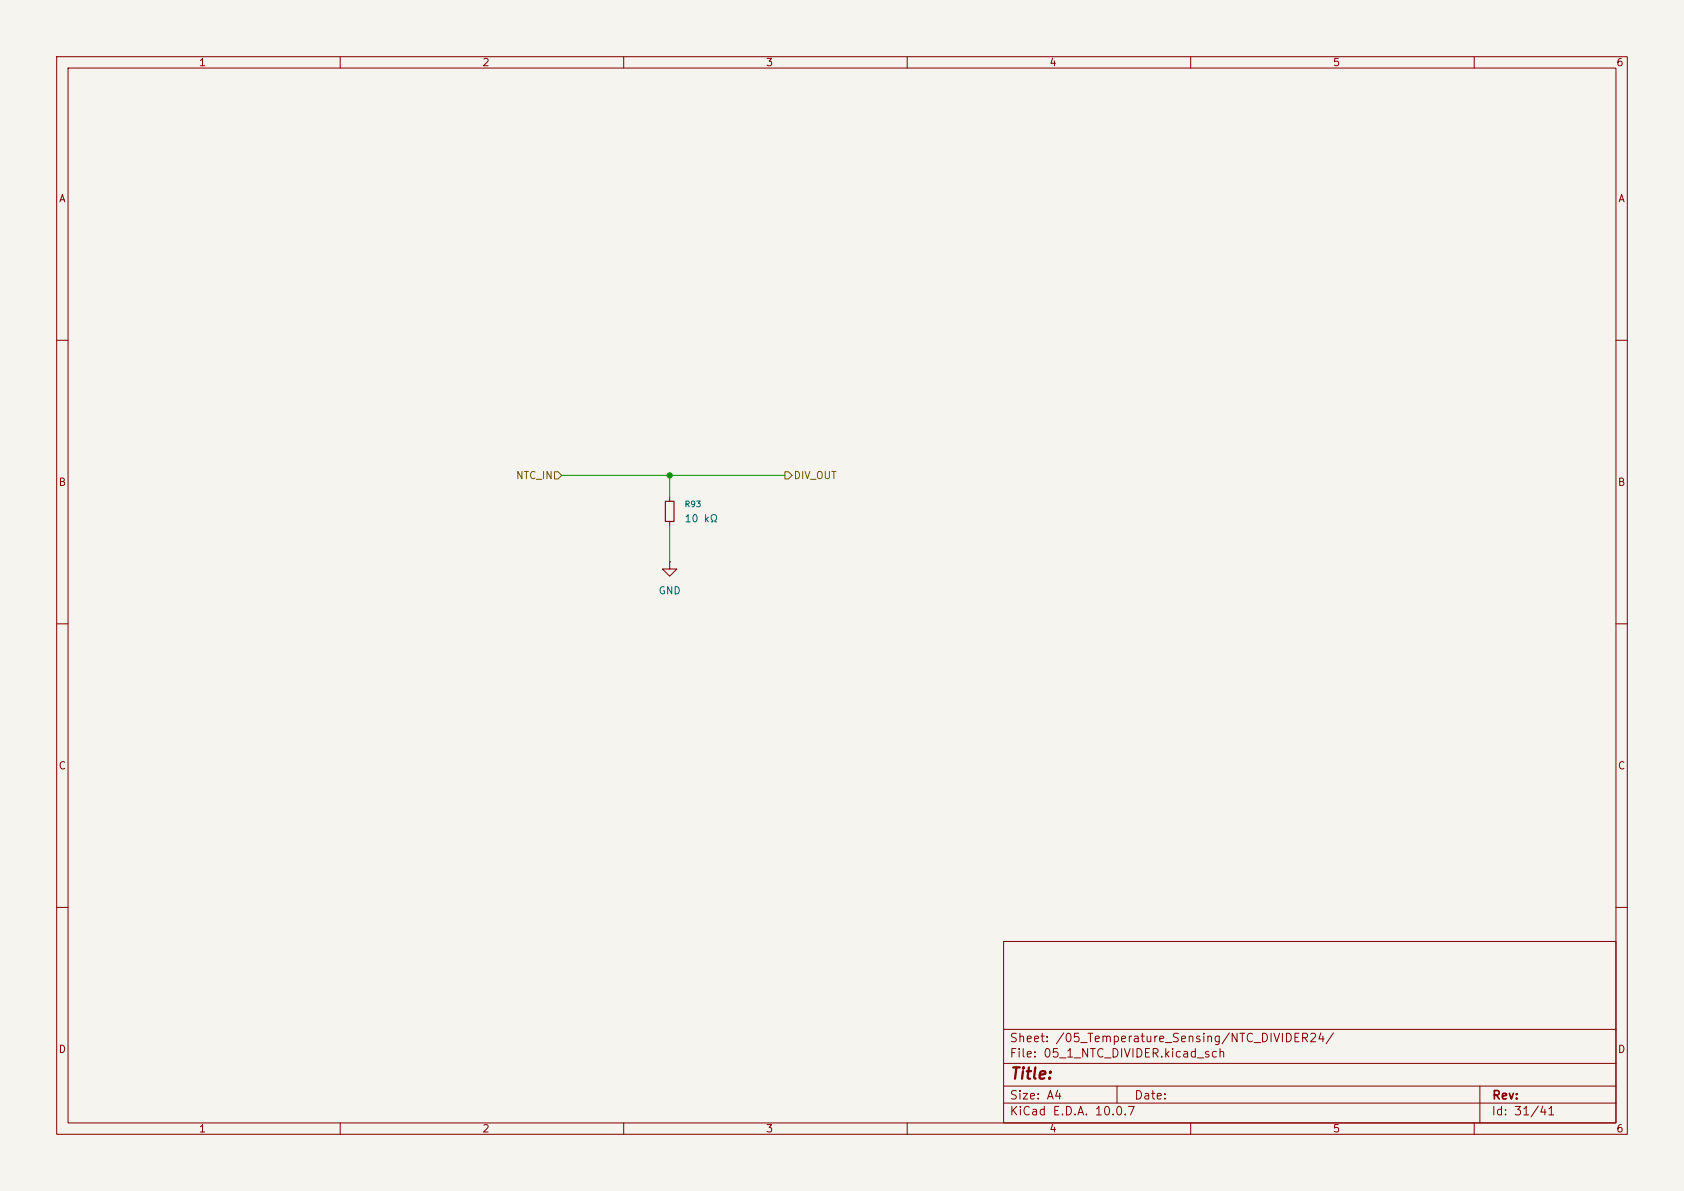
[picture p71: page 31]

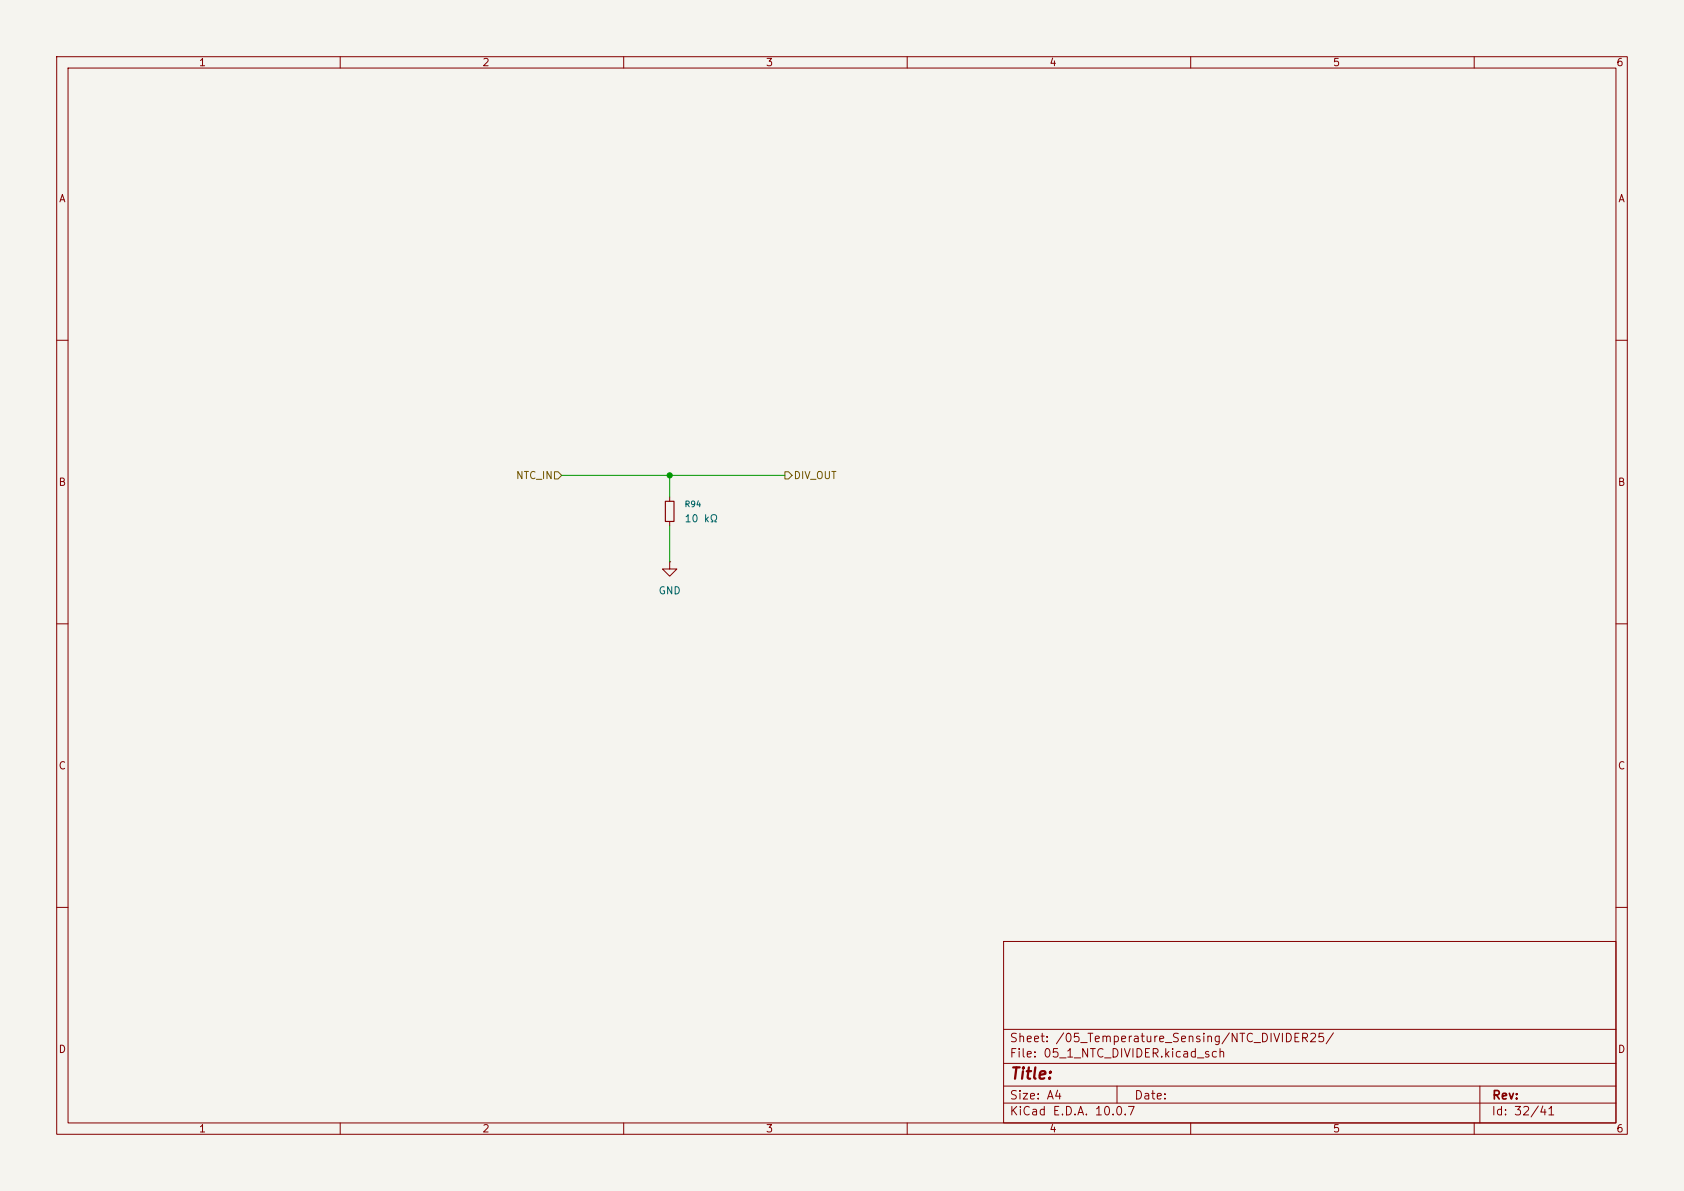
[picture p72: page 32]

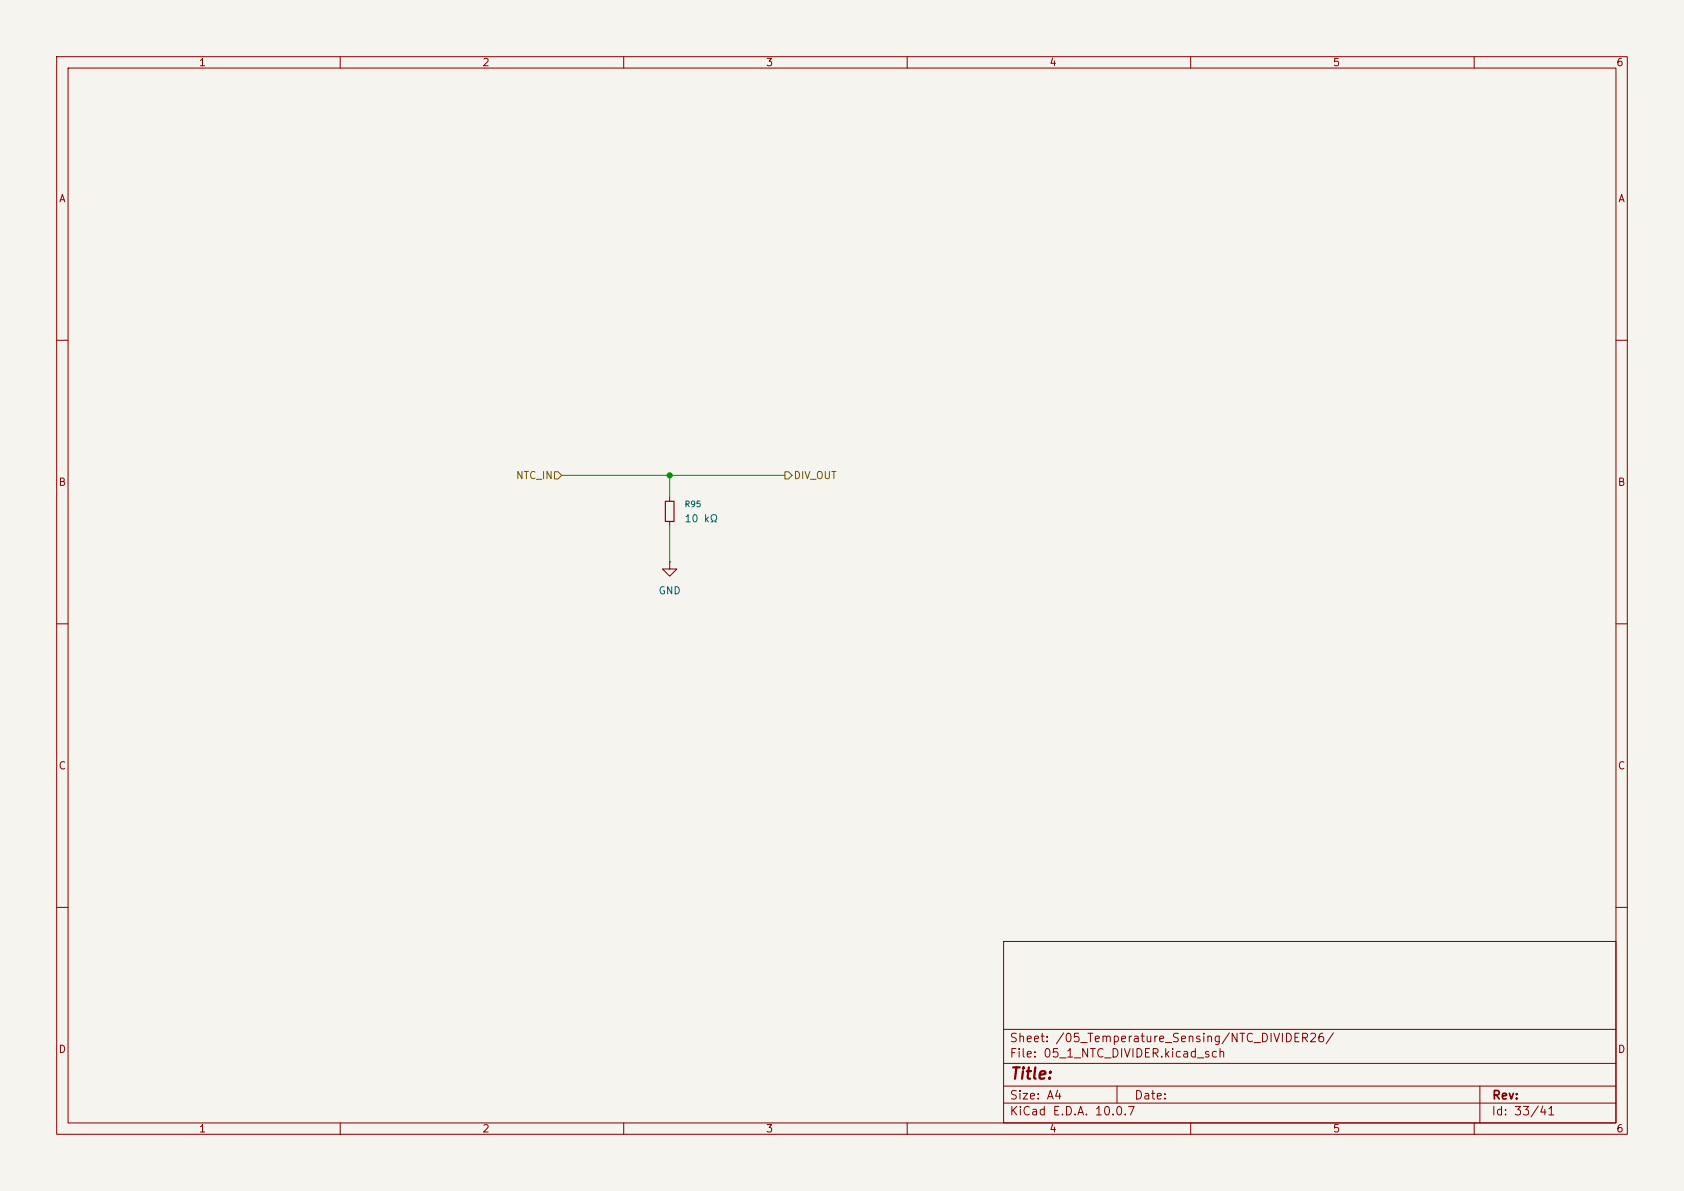
[picture p73: page 33]

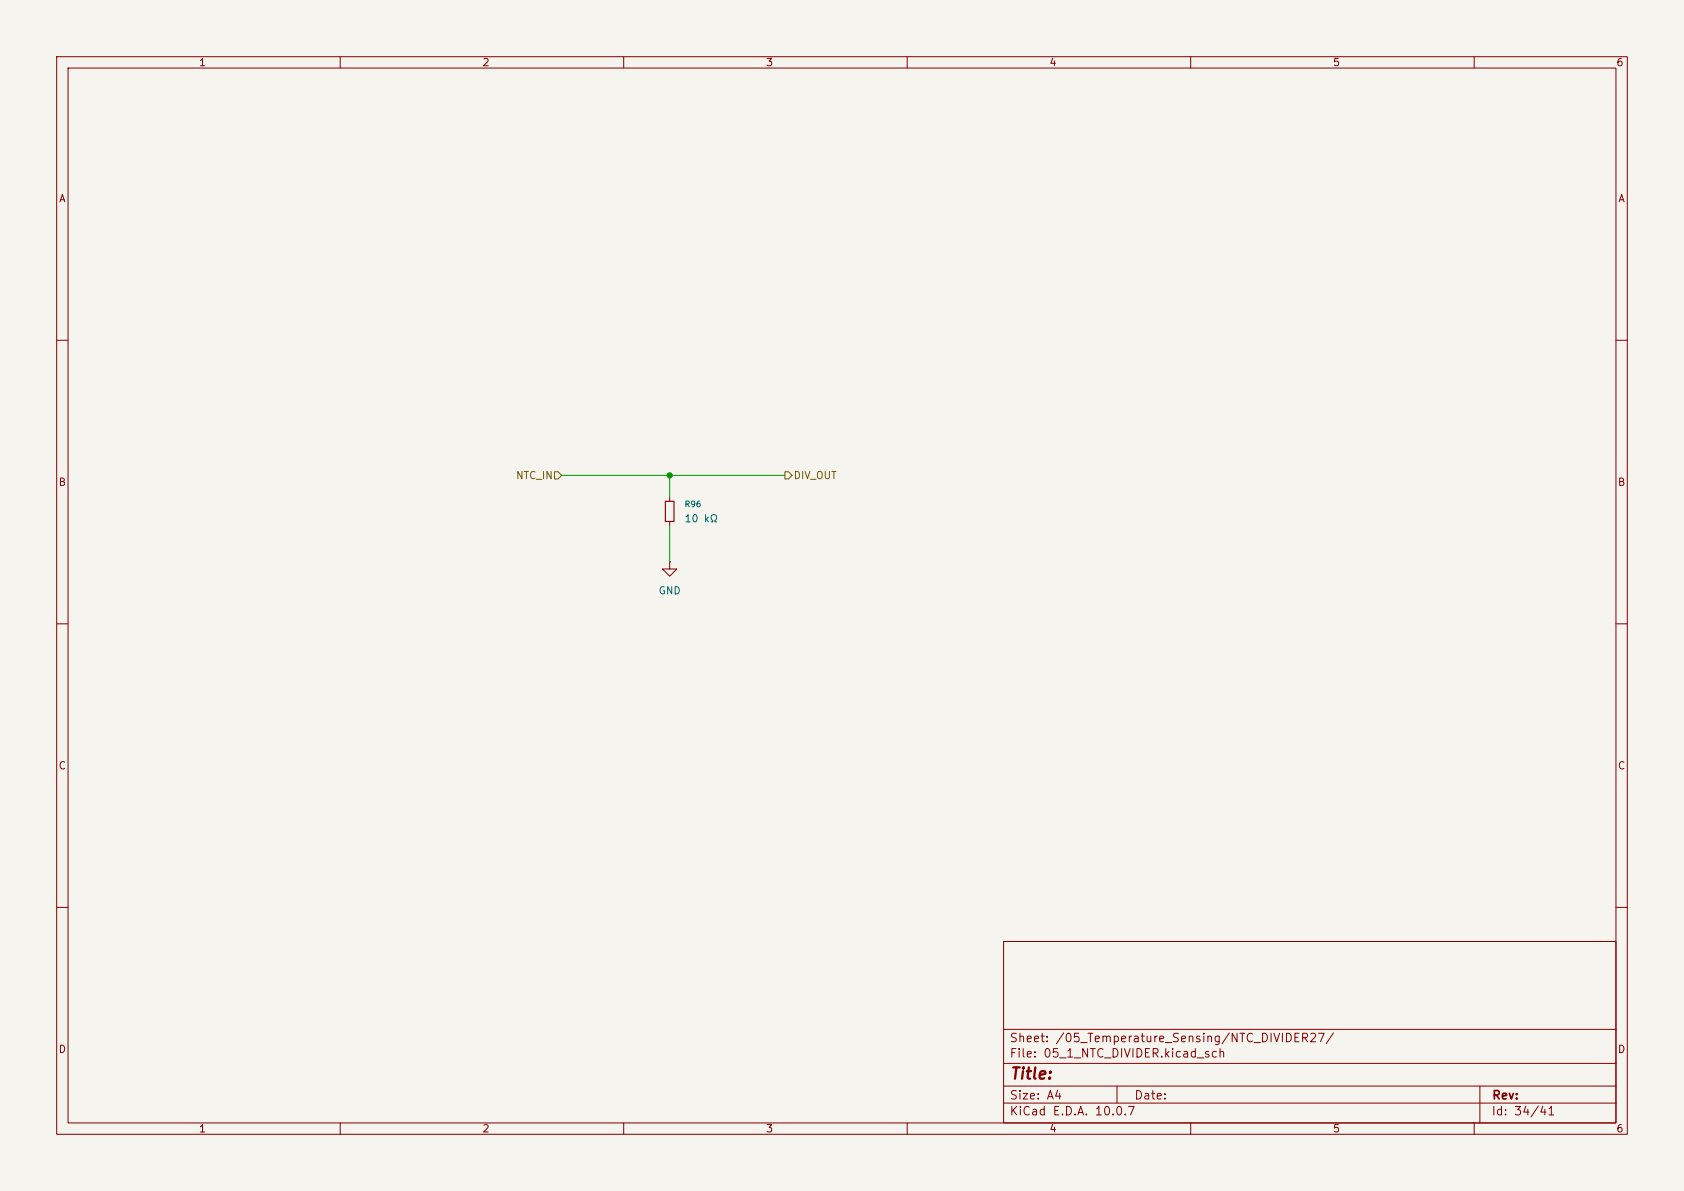
[picture p74: page 34]

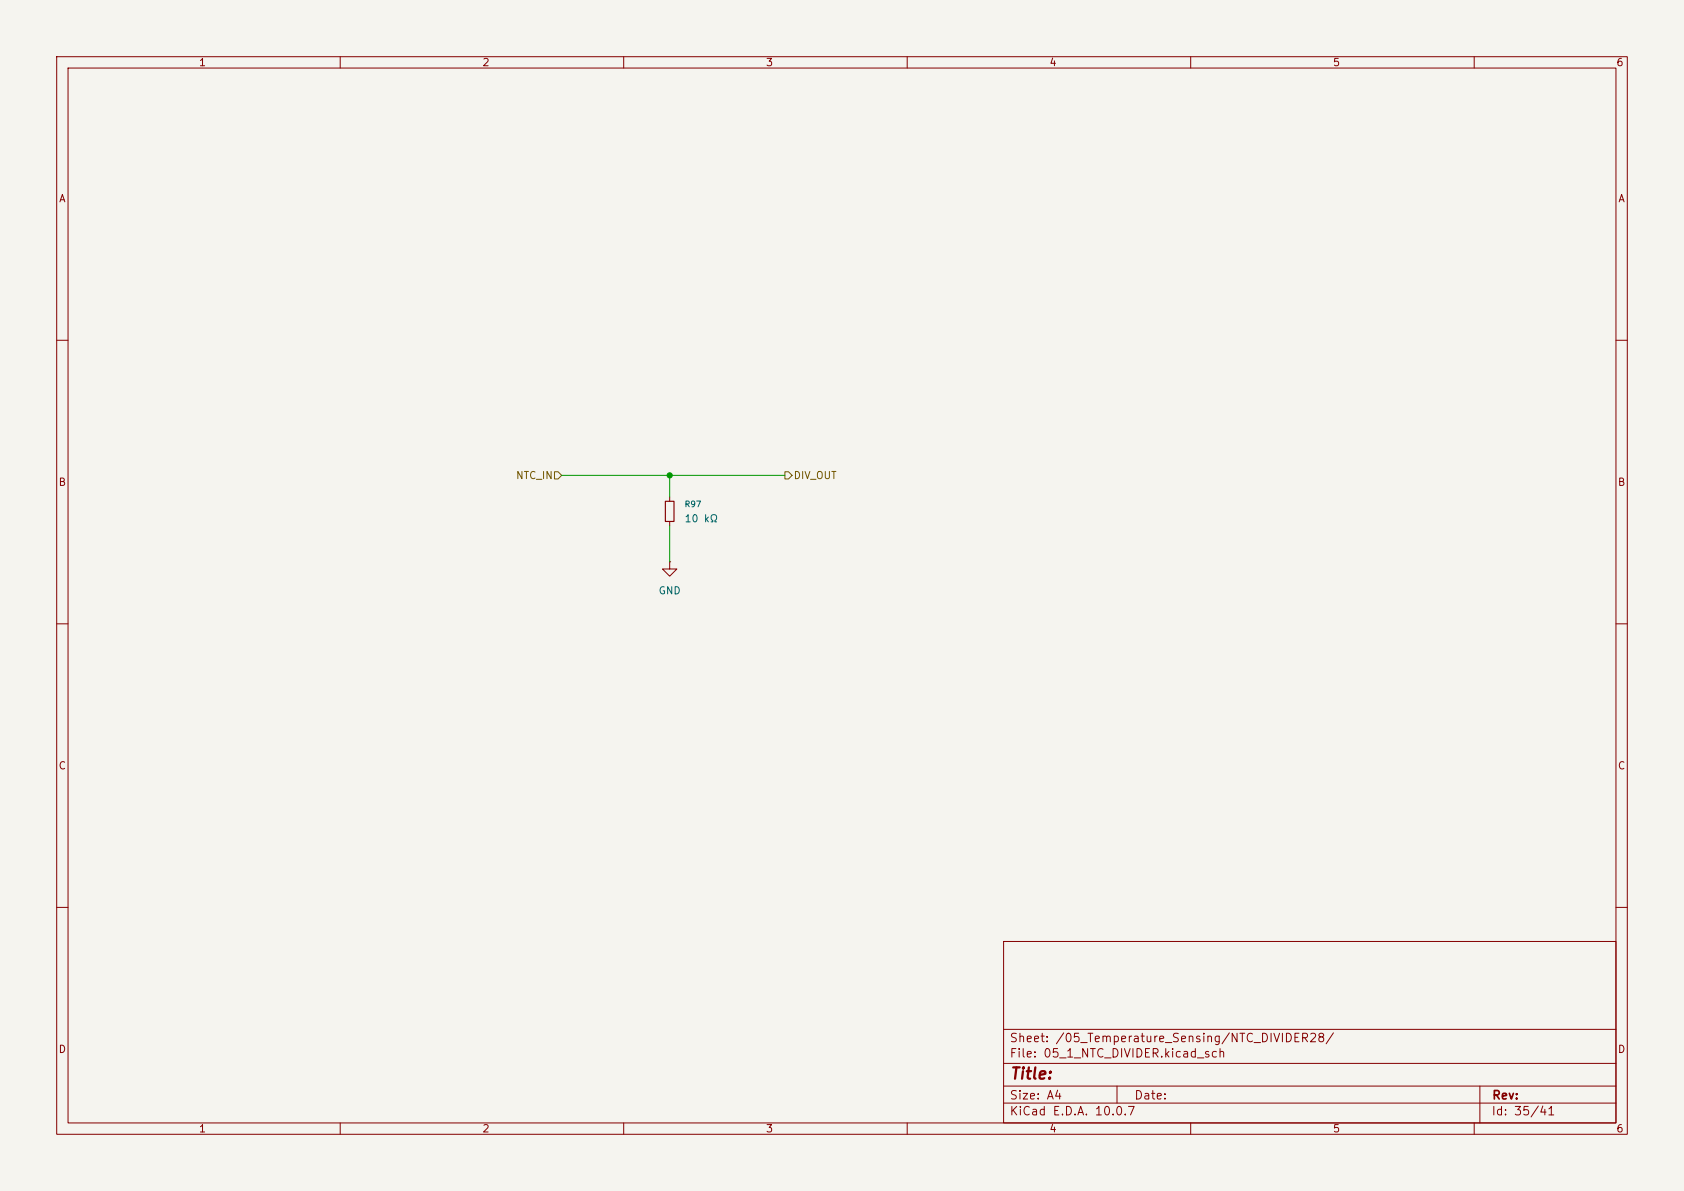
[picture p75: page 35]

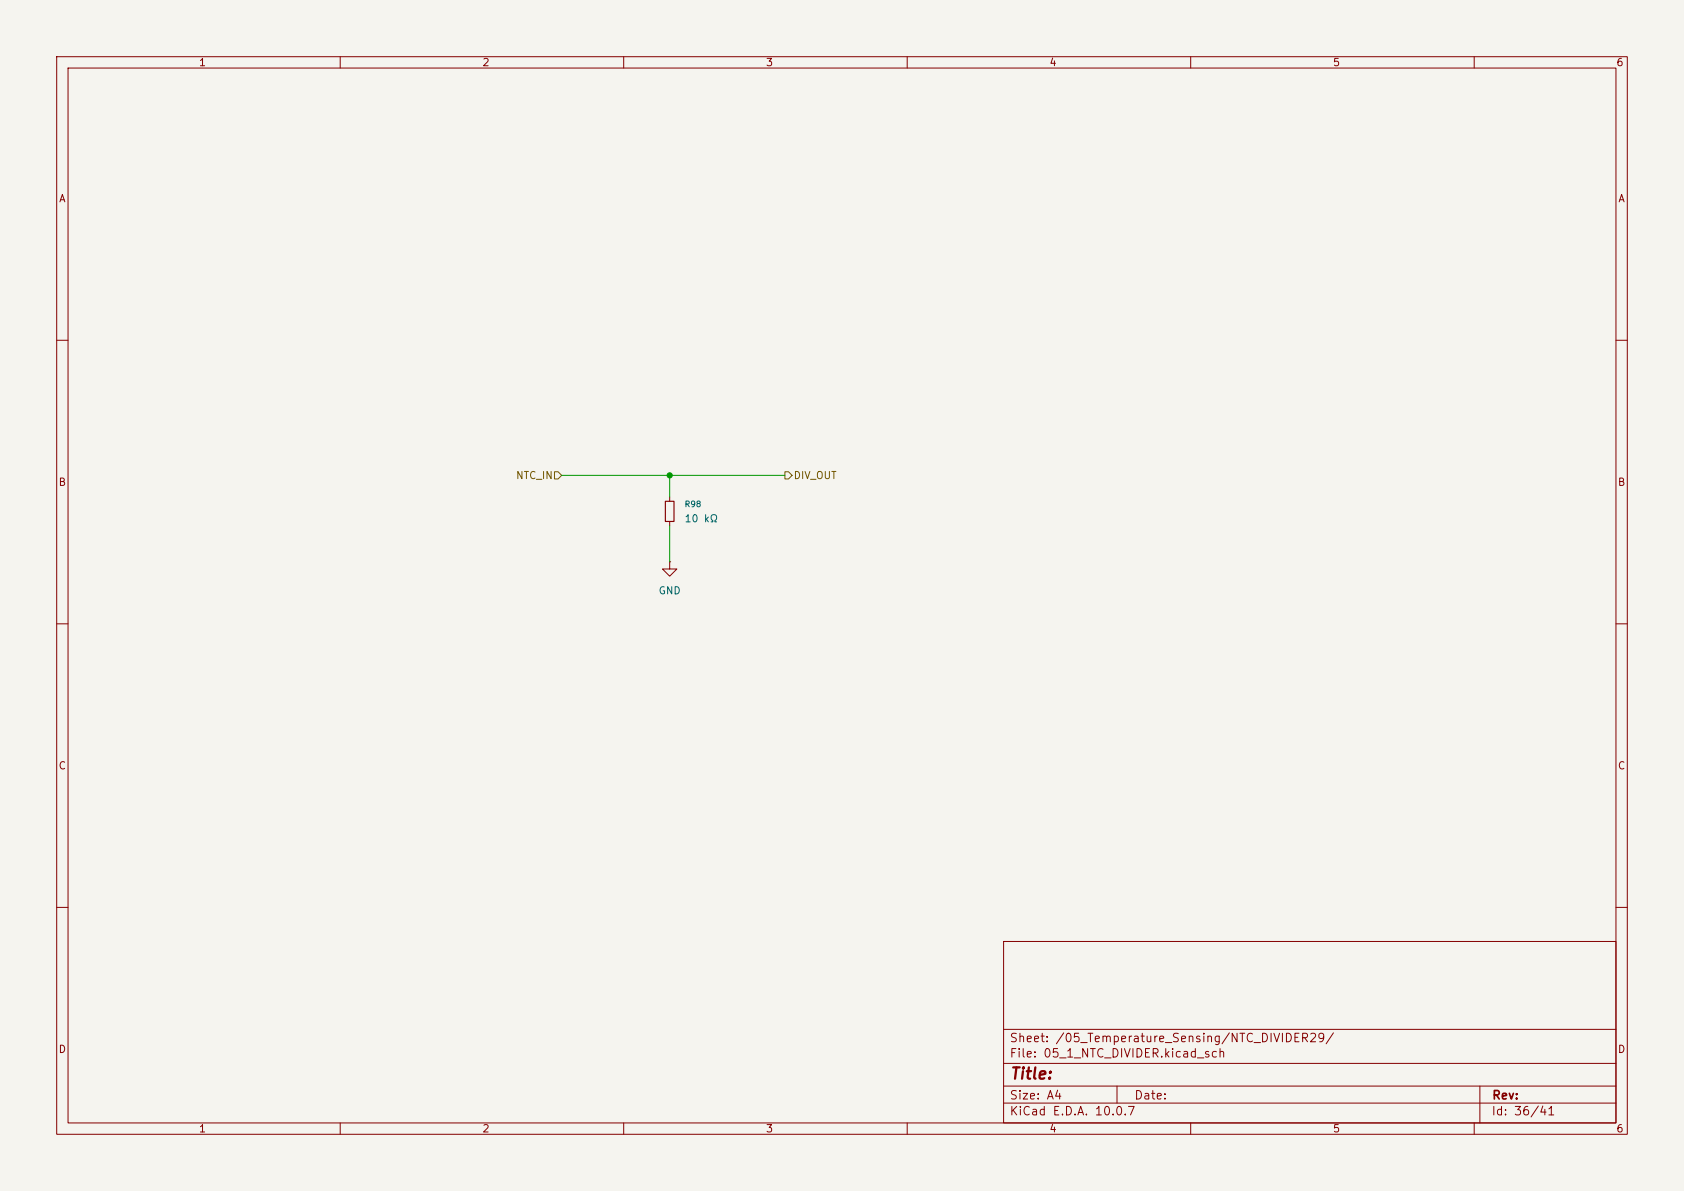
[picture p76: page 36]

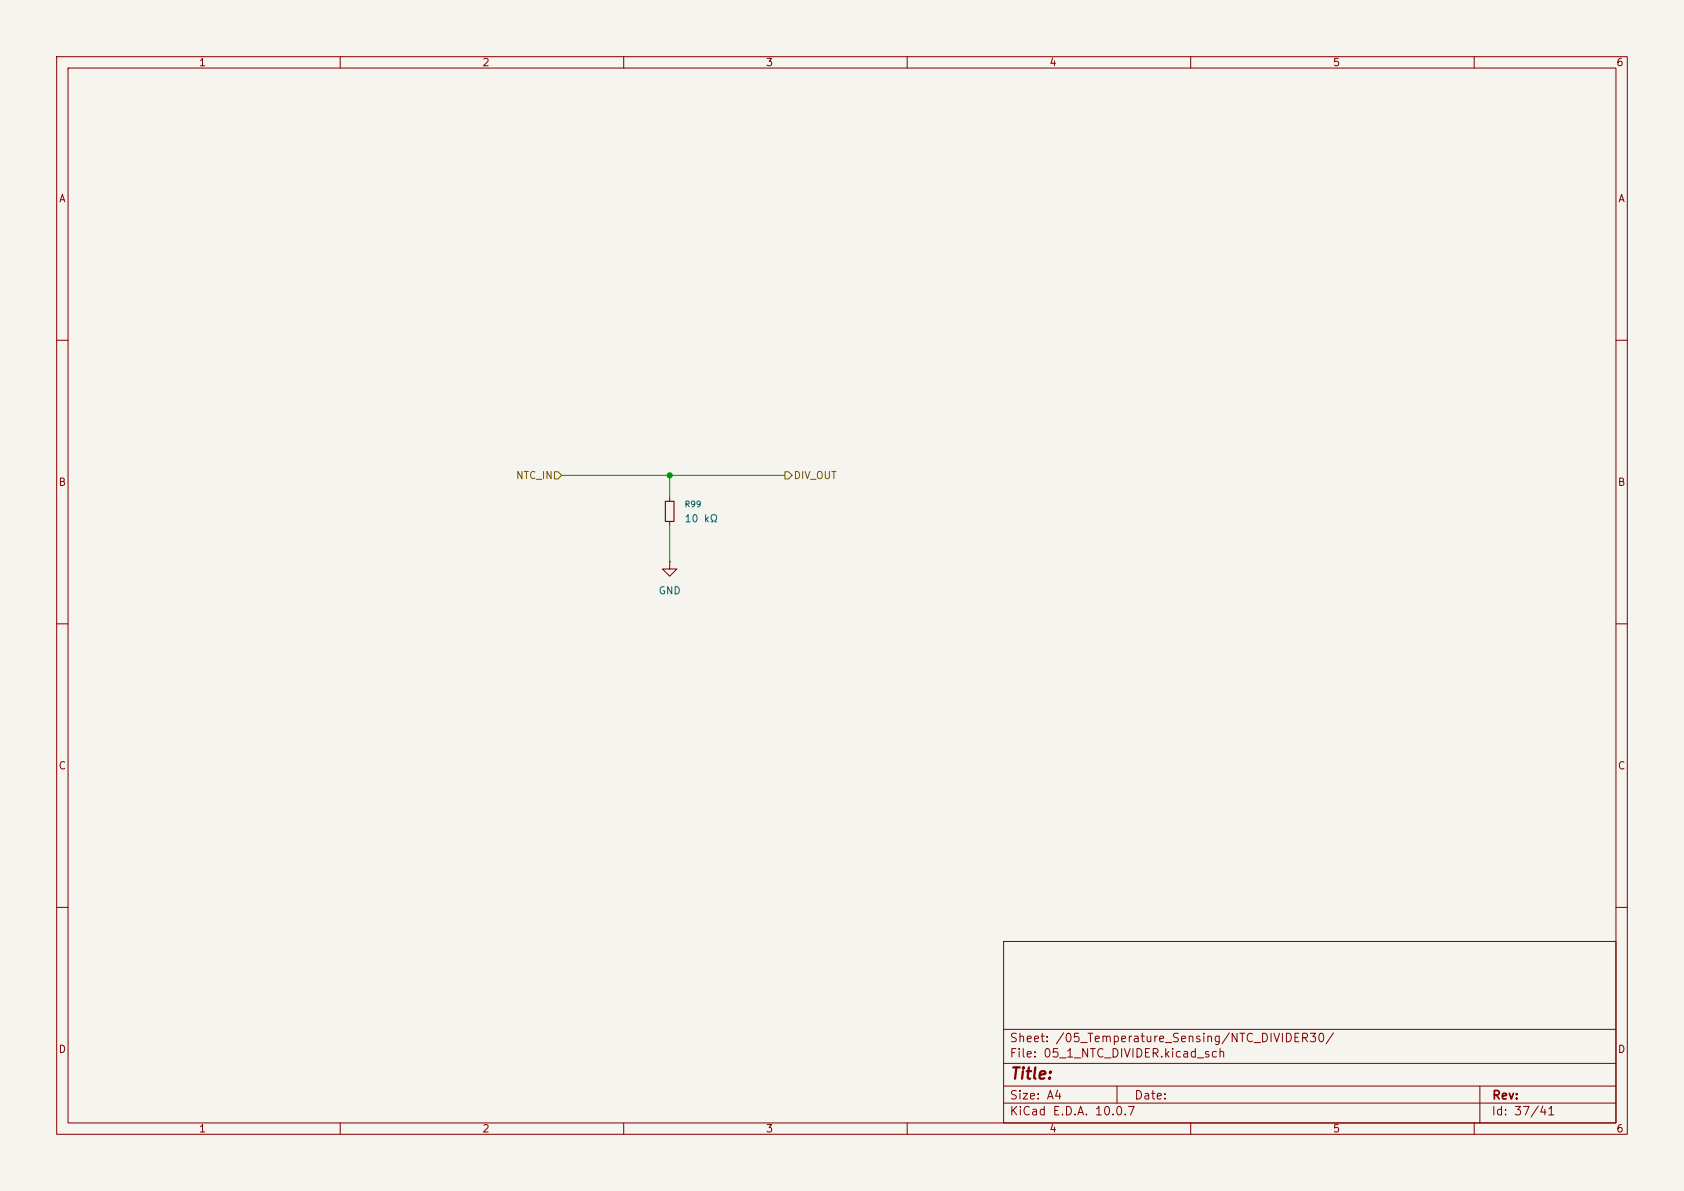
[picture p77: page 37]

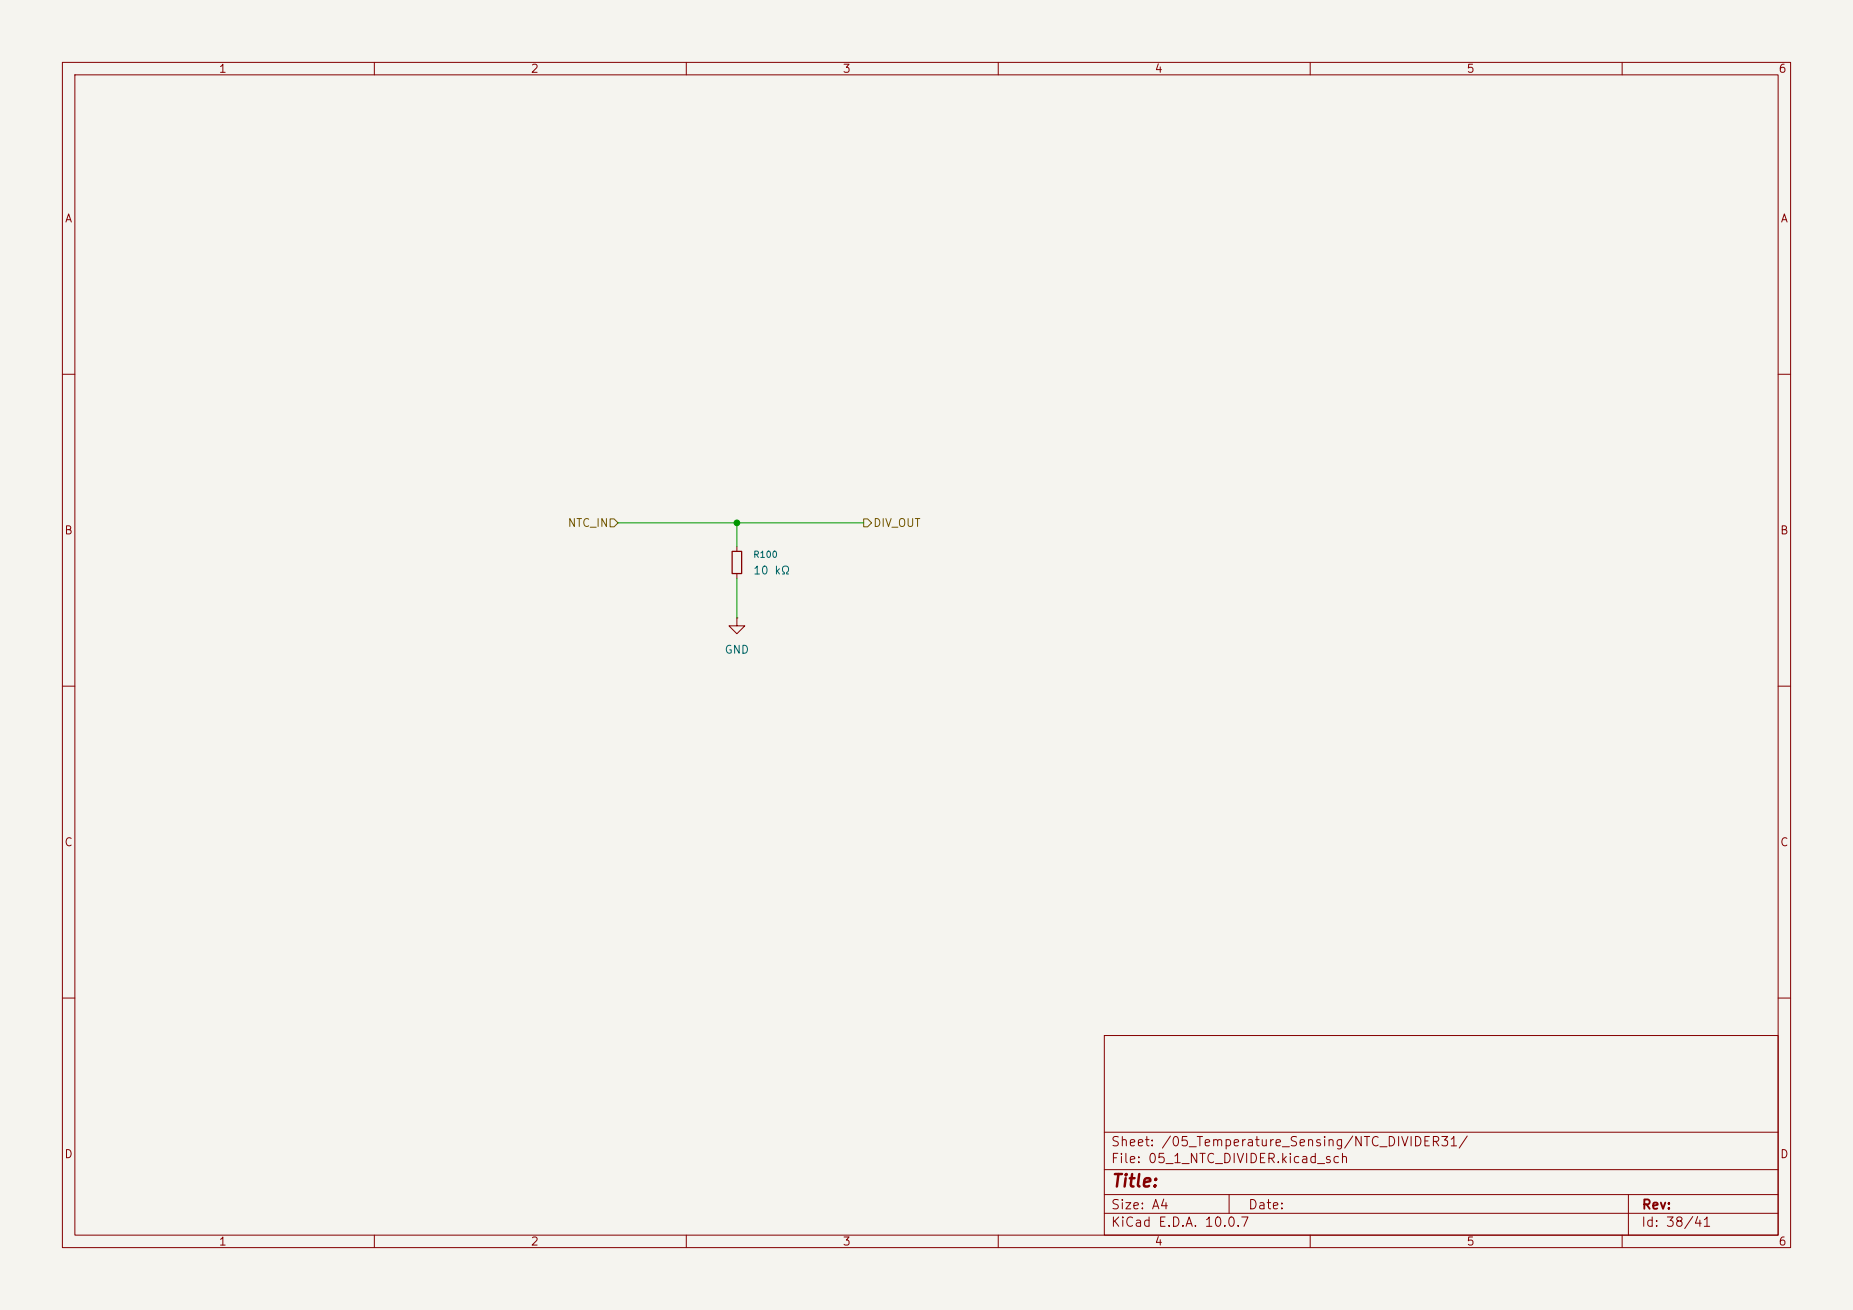
[picture p78: page 38]

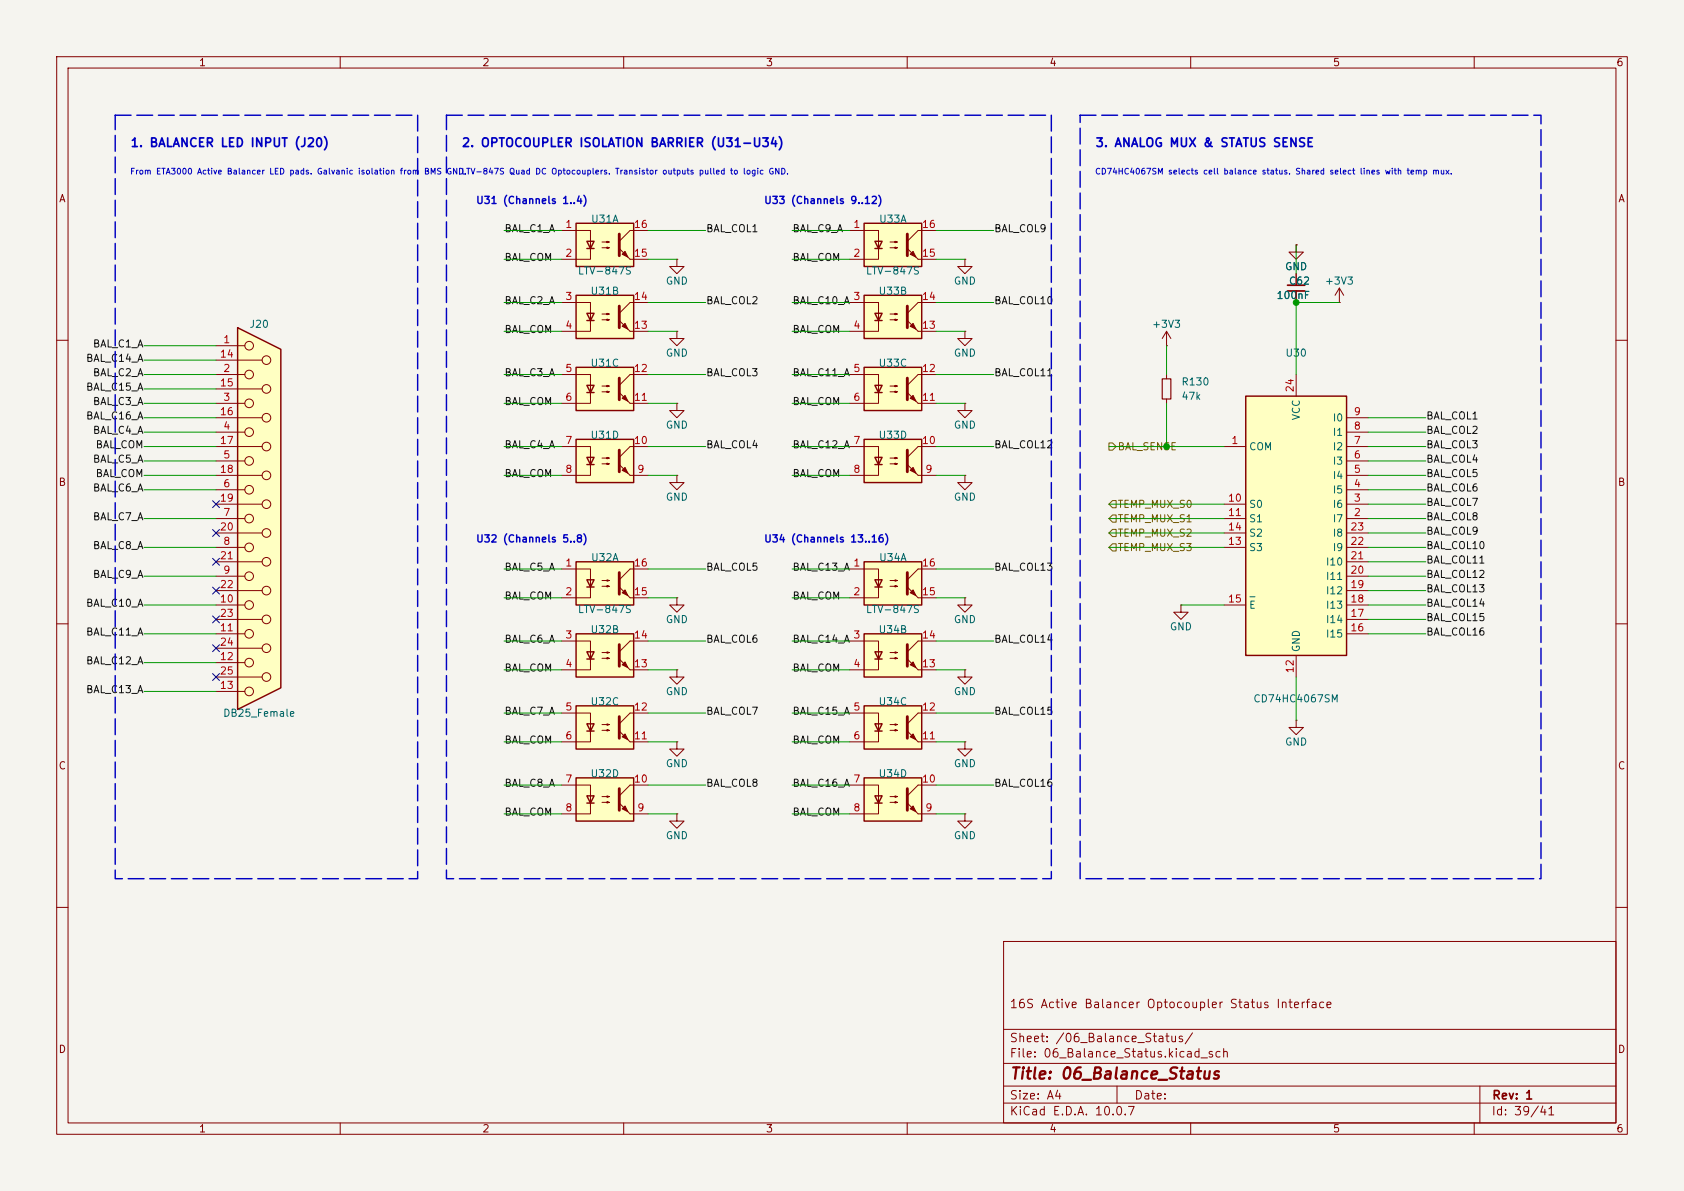
[picture p79: page 39]

LTV-847S Quad DC Optocouplers. Transistor outputs pulled to logic GND. U34 (Channels 13..16)
BAL_C1_A BAL_C4_A BAL_C3_A BAL_COM

16S Active Balancer Optocoupler Status Interface

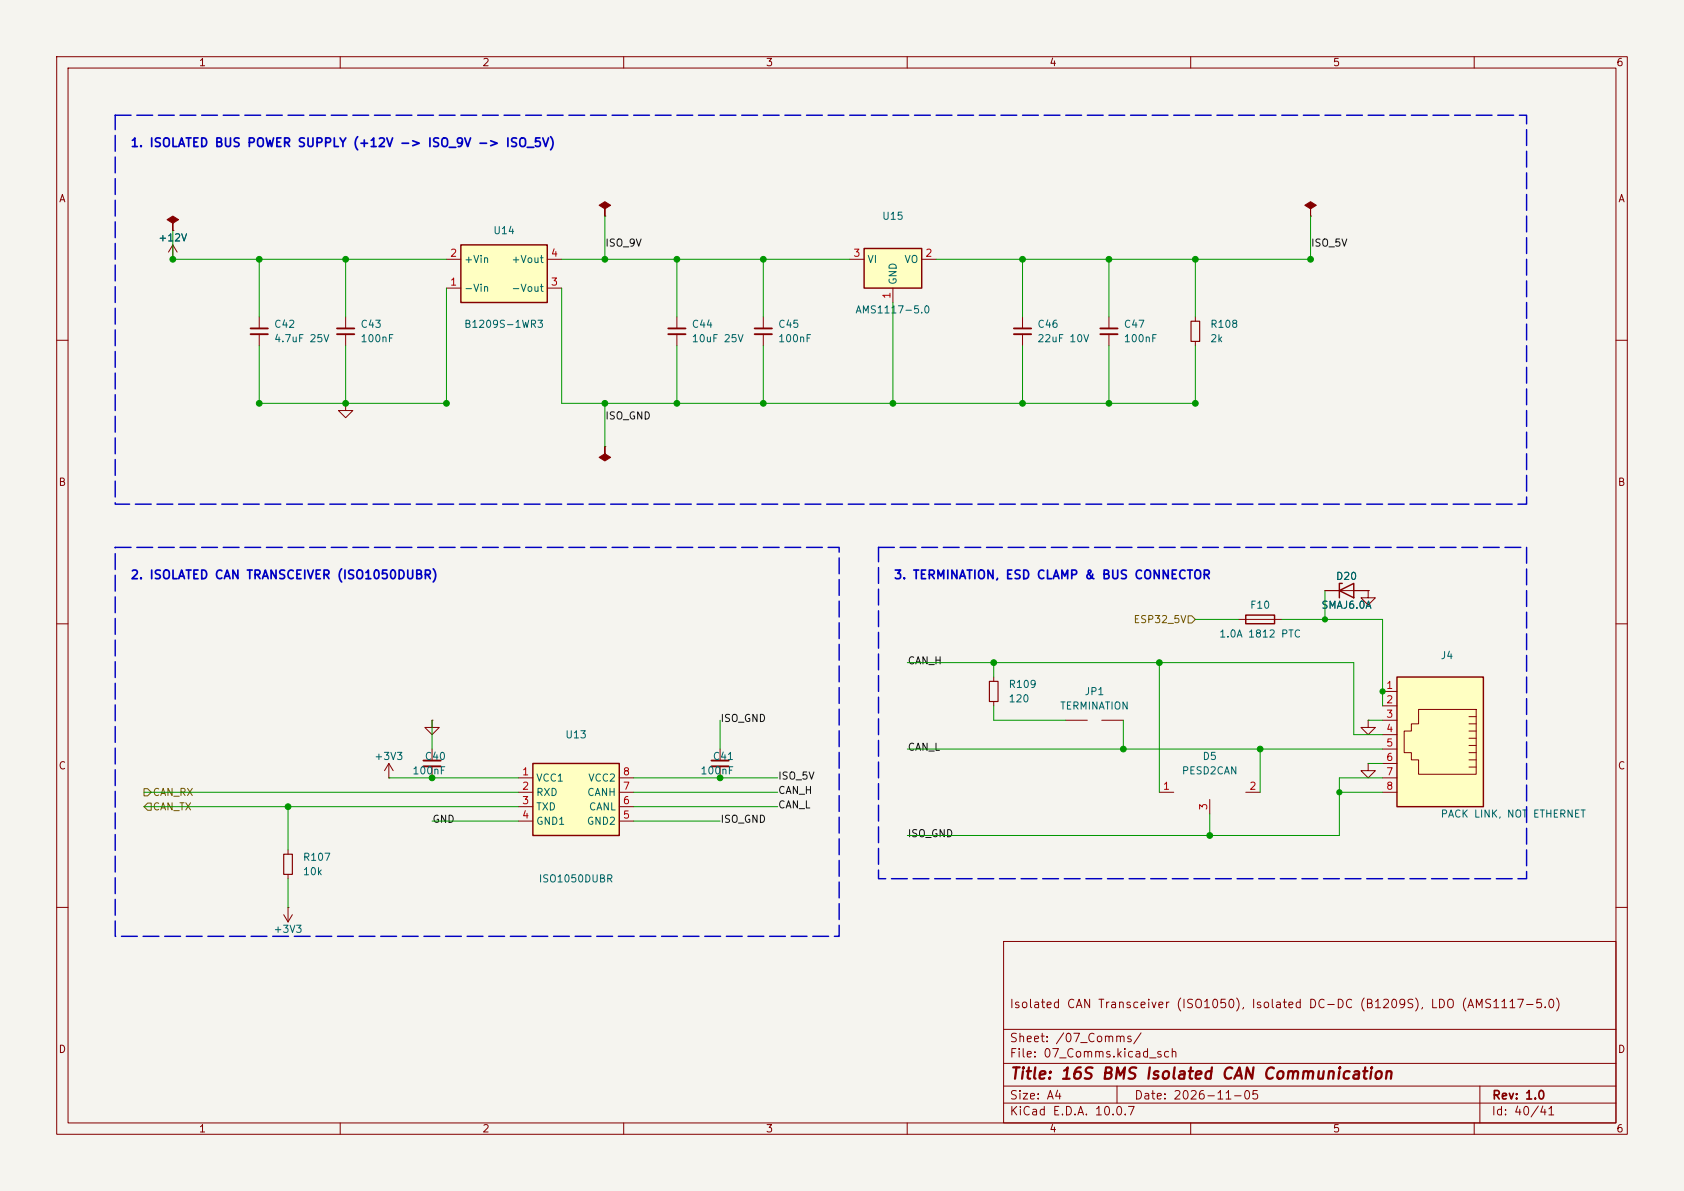
[picture p80: page 40]

1. ISOLATED BUS POWER SUPPLY (+12V -> ISO_9V -> ISO_5V)
4.7uF 25V CAN_TX CAN_RX

Isolated CAN Transceiver (ISO1050), Isolated DC-DC (B1209S), LDO (AMS1117-5.0)

Sheet: /07_Comms/
File: 07_Comms.kicad_sch
Title: 16S BMS Isolated CAN Communication

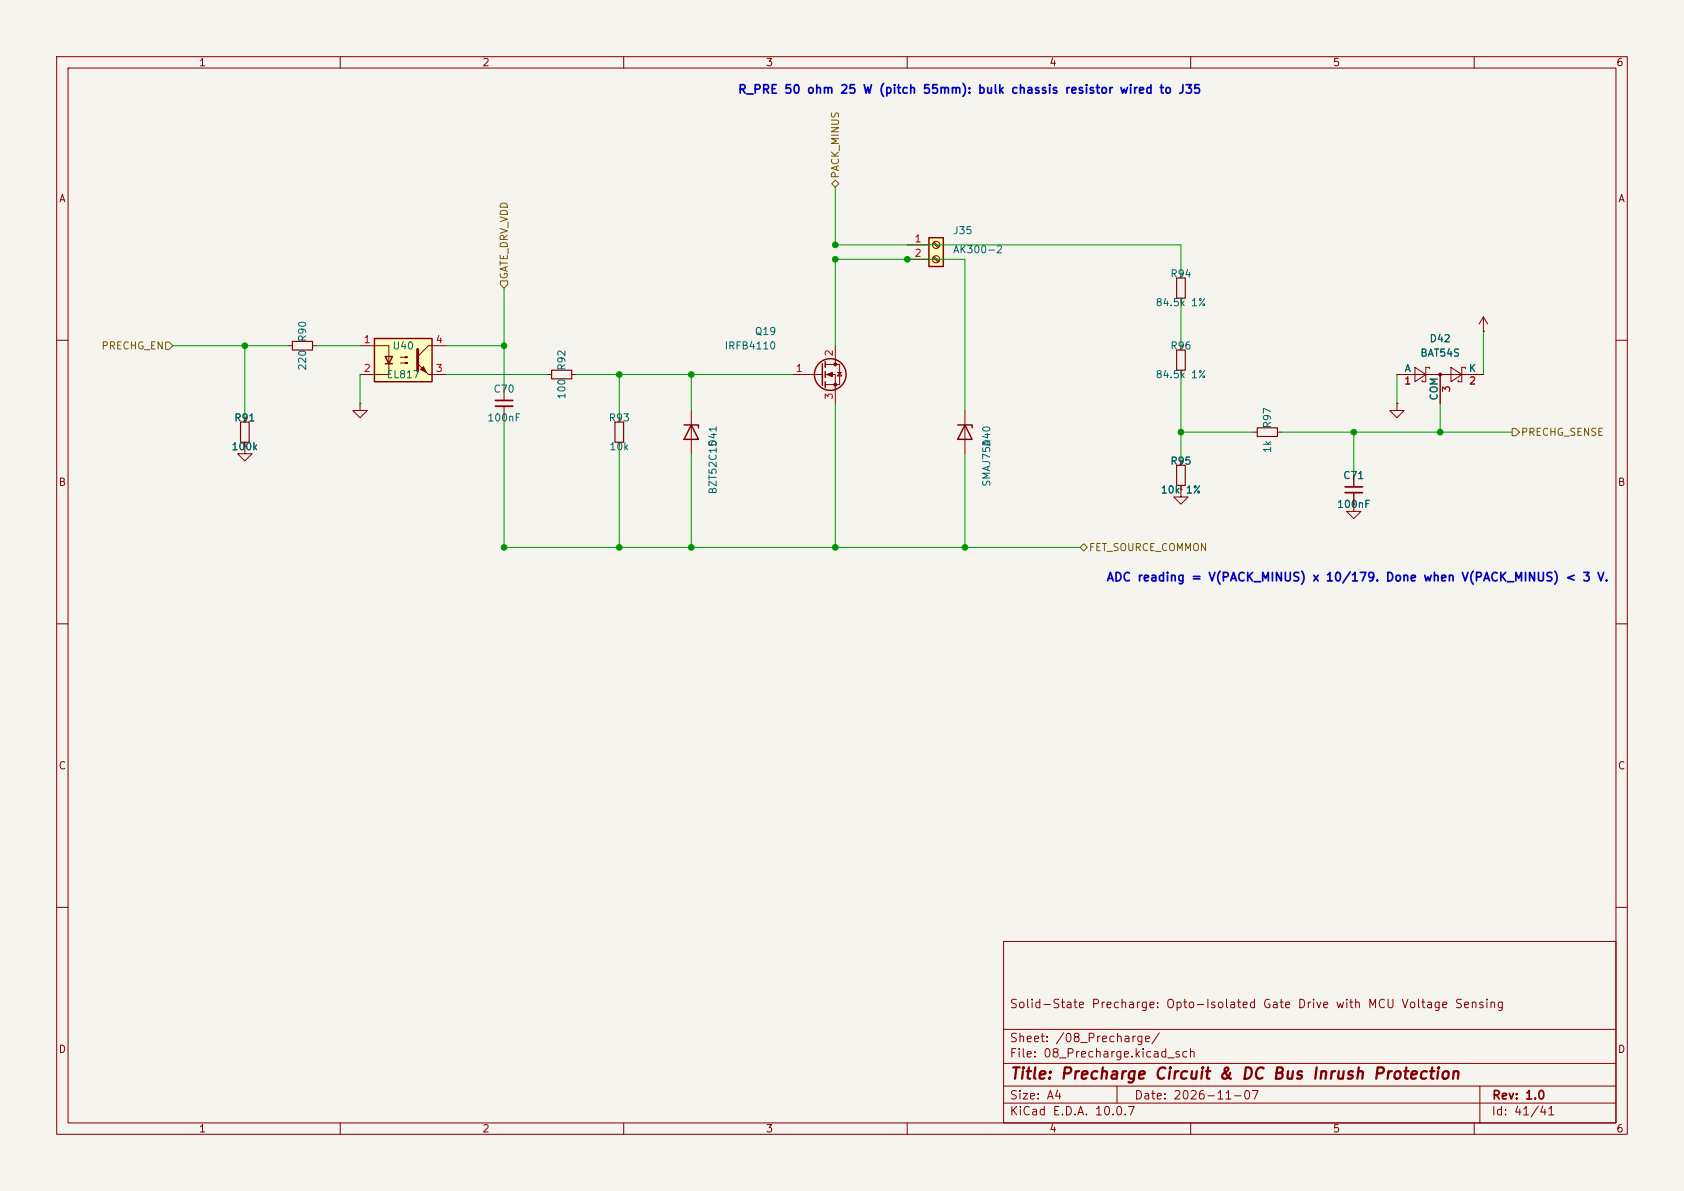
[picture p81: page 41]

R_PRE 50 ohm 25 W (pitch 55mm): bulk chassis resistor wired to J35

ADC reading = V(PACK_MINUS) x 10/179. Done when V(PACK_MINUS) < 3 V. R91

Solid-State Precharge: Opto-Isolated Gate Drive with MCU Voltage Sensing

Sheet: /08_Precharge/
File: 08_Precharge.kicad_sch
Title: Precharge Circuit & DC Bus Inrush Protection
