koko69420/SmartBMS_Active-balancing/16s_BMS/16s_BMS_all_sheets.pdf

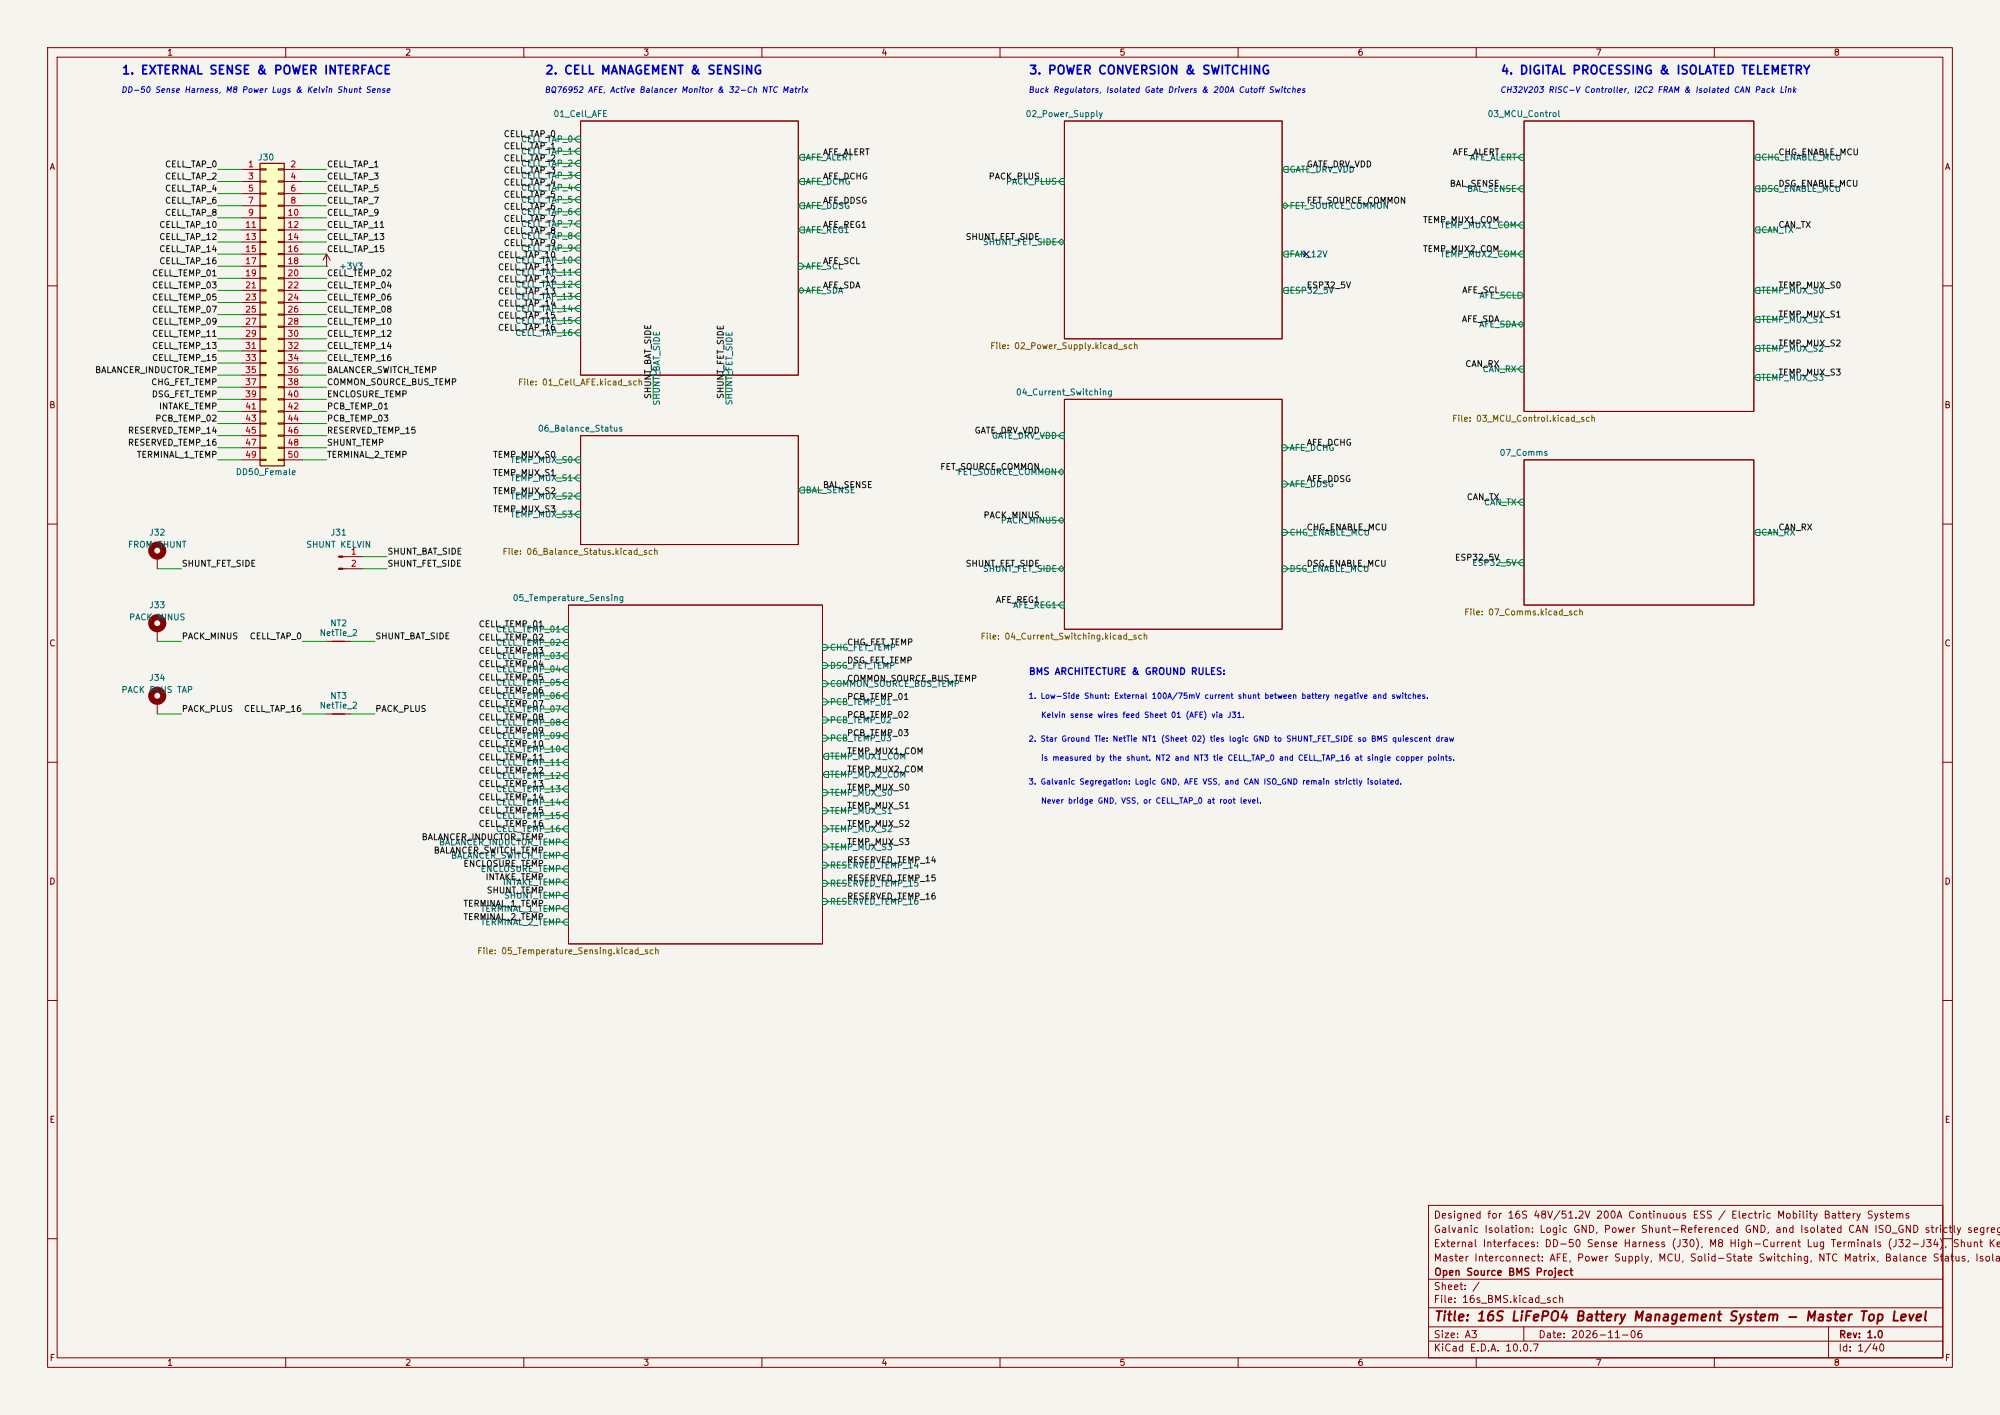
[picture p82: page 1]

BQ76952 AFE, Active Balancer Monitor & 32-Ch NTC Matrix

Buck Regulators, Isolated Gate Drivers & 200A Cutoff Switches
03_MCU_Control File: 03_MCU_Control.kicad_sch

1. Low-Side Shunt: External 100A/75mV current shunt between battery negative and switches. Never bridge GND, VSS, or CELL_TAP_0 at root level. Kelvin sense wires feed Sheet 01 (AFE) via J31. BMS ARCHITECTURE & GROUND RULES:

is measured by the shunt. NT2 and NT3 tie CELL_TAP_0 and CELL_TAP_16 at single copper points. 2. Star Ground Tie: NetTie NT1 (Sheet 02) ties logic GND to SHUNT_FET_SIDE so BMS quiescent draw

3. Galvanic Segregation: Logic GND, AFE VSS, and CAN ISO_GND remain strictly isolated.

Designed for 16S 48V/51.2V 200A Continuous ESS / Electric Mobility Battery Systems
Galvanic Isolation: Logic GND, Power Shunt-Referenced GND, and Isolated CAN ISO_GND strictly segregated
External Interfaces: DD-50 Sense Harness (J30), M8 High-Current Lug Terminals (J32-J34), Shunt Kelvin Header (J31)
Master Interconnect: AFE, Power Supply, MCU, Solid-State Switching, NTC Matrix, Balance Status, Isolated CAN
Open Source BMS Project
Sheet: /
File: 16s_BMS.kicad_sch
Title: 16S LiFePO4 Battery Management System - Master Top Level

Size: A3 | Rev: 1.0 | F Date: 2026-11-06
KiCad E.D.A. 10.0.7 | Id: 1/40


Sheet: /01_Cell_AFE/
File: 01_Cell_AFE.kicad_sch
Title: Analog Front End

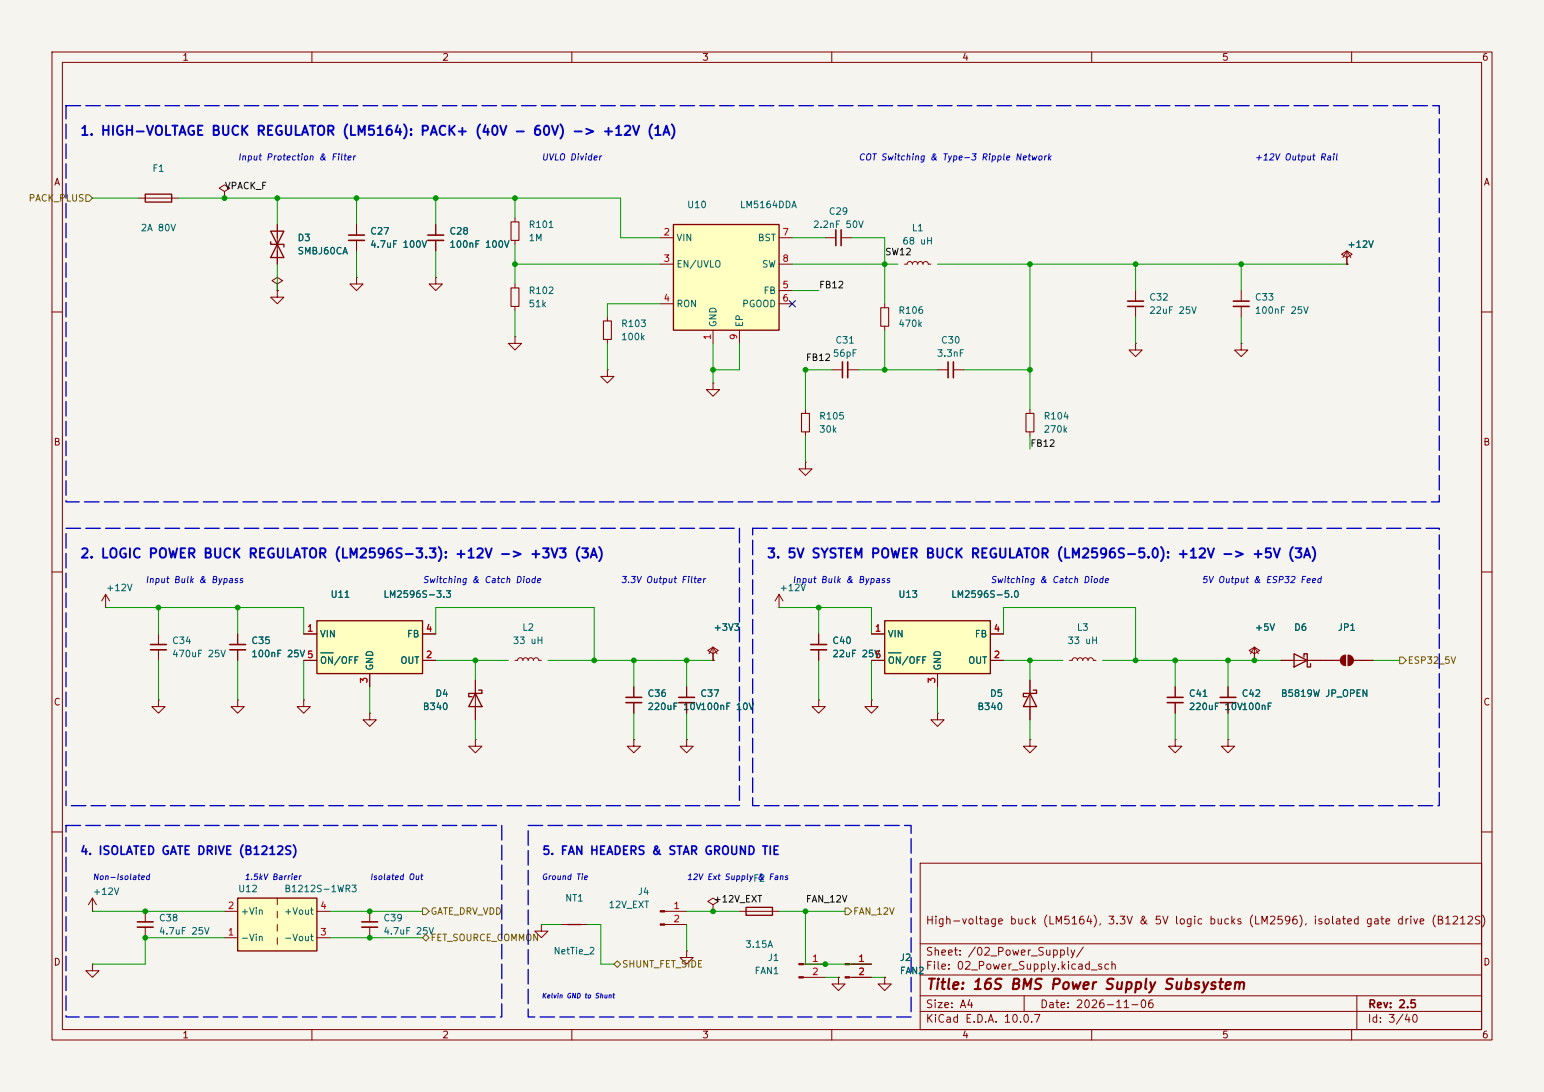
[picture p83: page 3]

Input Bulk & Bypass COT Switching & Type-3 Ripple Network D3

High-voltage buck (LM5164), 3.3V & 5V logic bucks (LM2596), isolated gate drive (B1212S) D4 B340

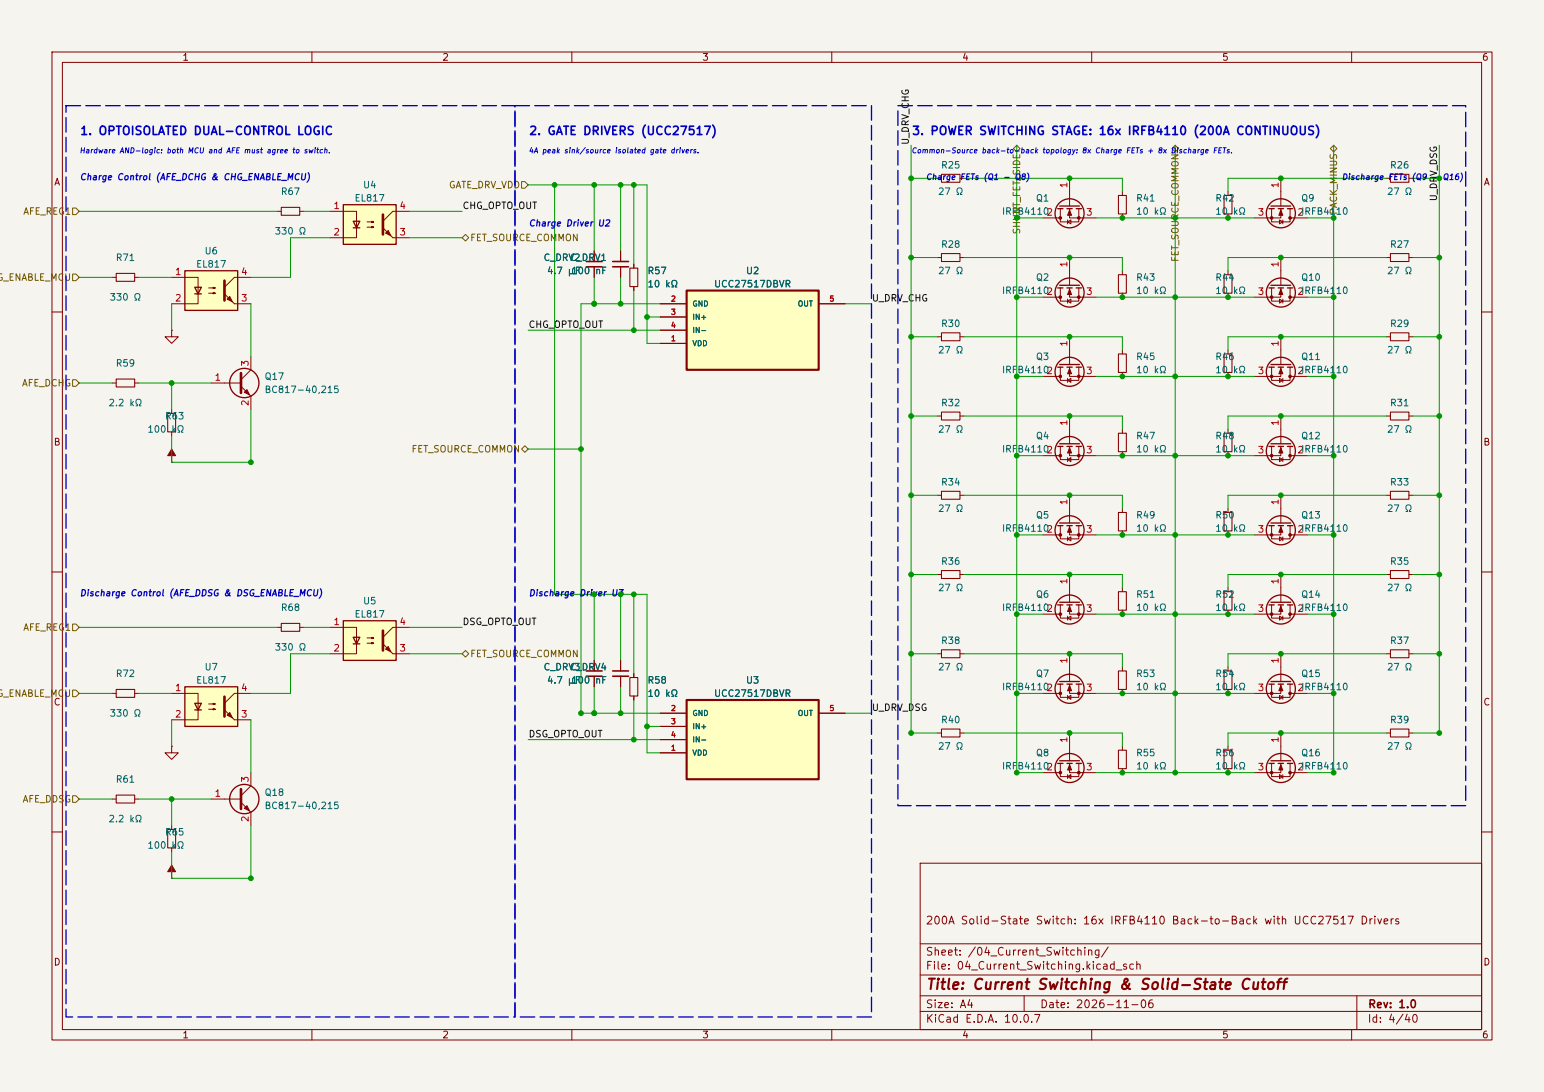
[picture p84: page 4]

1. OPTOISOLATED DUAL-CONTROL LOGIC

Hardware AND-logic: both MCU and AFE must agree to switch. Charge Control (AFE_DCHG & CHG_ENABLE_MCU)

200A Solid-State Switch: 16x IRFB4110 Back-to-Back with UCC27517 Drivers

Sheet: /04_Current_Switching/
File: 04_Current_Switching.kicad_sch
Title: Current Switching & Solid-State Cutoff

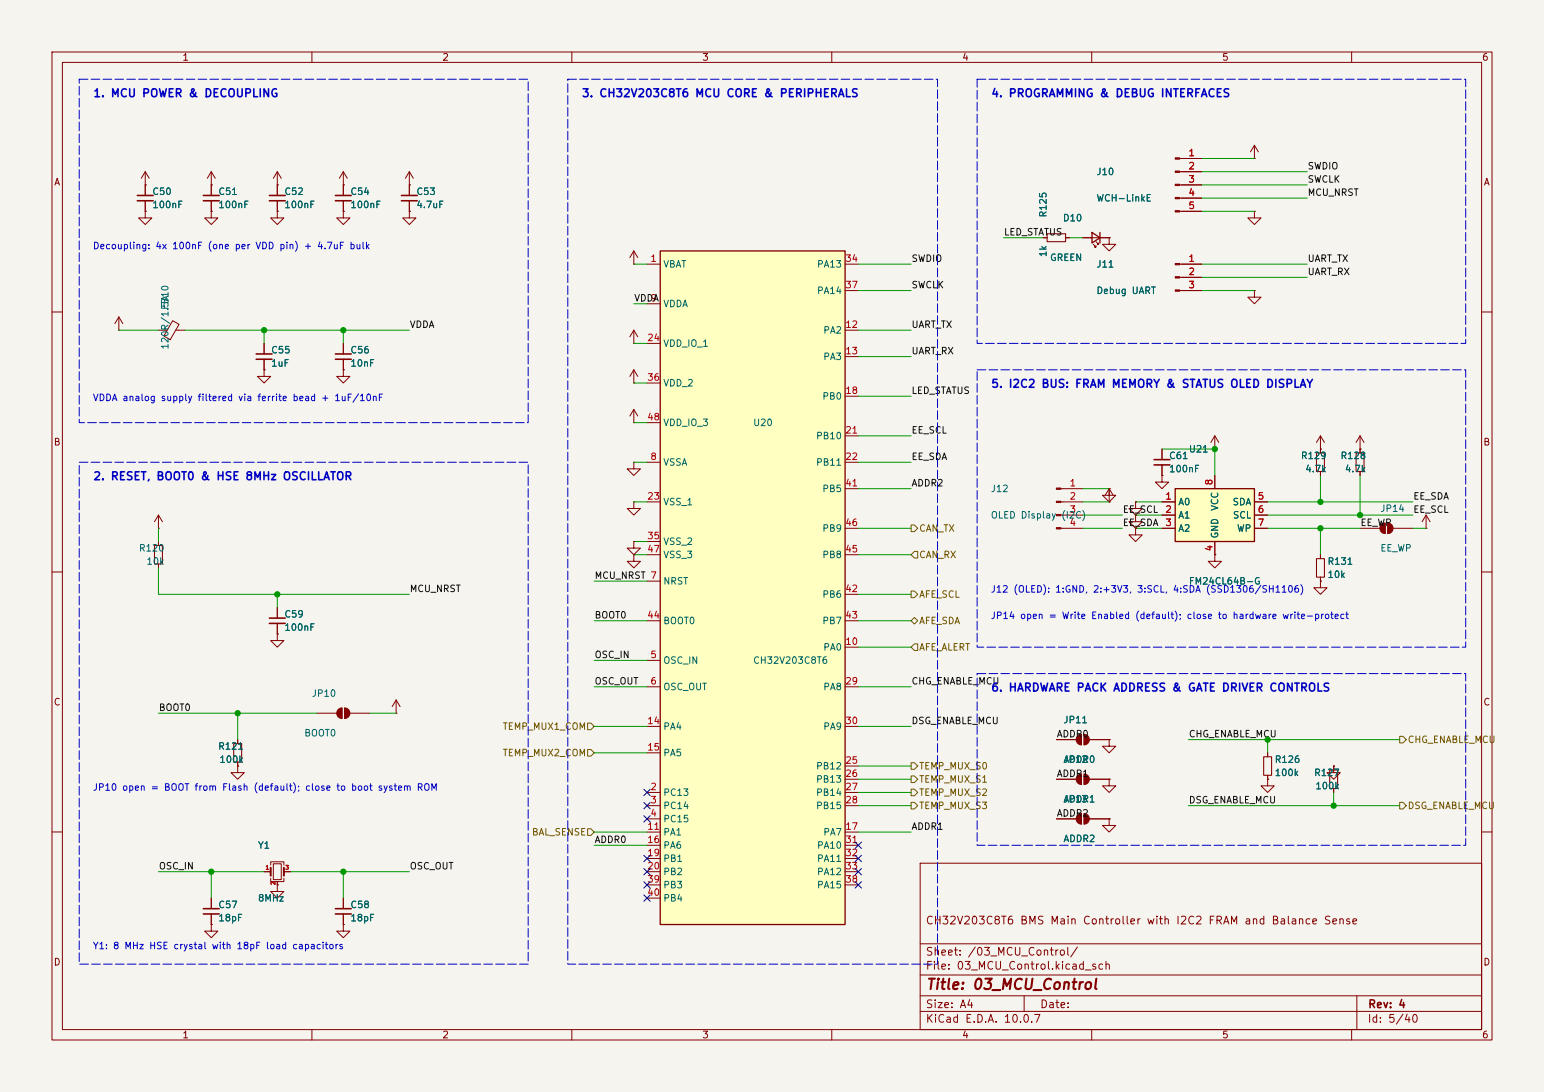
[picture p85: page 5]

J12 (OLED): 1:GND, 2:+3V3, 3:SCL, 4:SDA (SSD1306/SH1106) R125 1k

Decoupling: 4x 100nF (one per VDD pin) + 4.7uF bulk

5. I2C2 BUS: FRAM MEMORY & STATUS OLED DISPLAY

EE_SDA EE_SCL VDDA analog supply filtered via ferrite bead + 1uF/10nF

JP14 open = Write Enabled (default); close to hardware write-protect

6. HARDWARE PACK ADDRESS & GATE DRIVER CONTROLS

JP10 open = BOOT from Flash (default); close to boot system ROM

CH32V203C8T6 BMS Main Controller with I2C2 FRAM and Balance Sense

Y1: 8 MHz HSE crystal with 18pF load capacitors

Sheet: /03_MCU_Control/ File: 03_MCU_Control.kicad_sch | D Date:

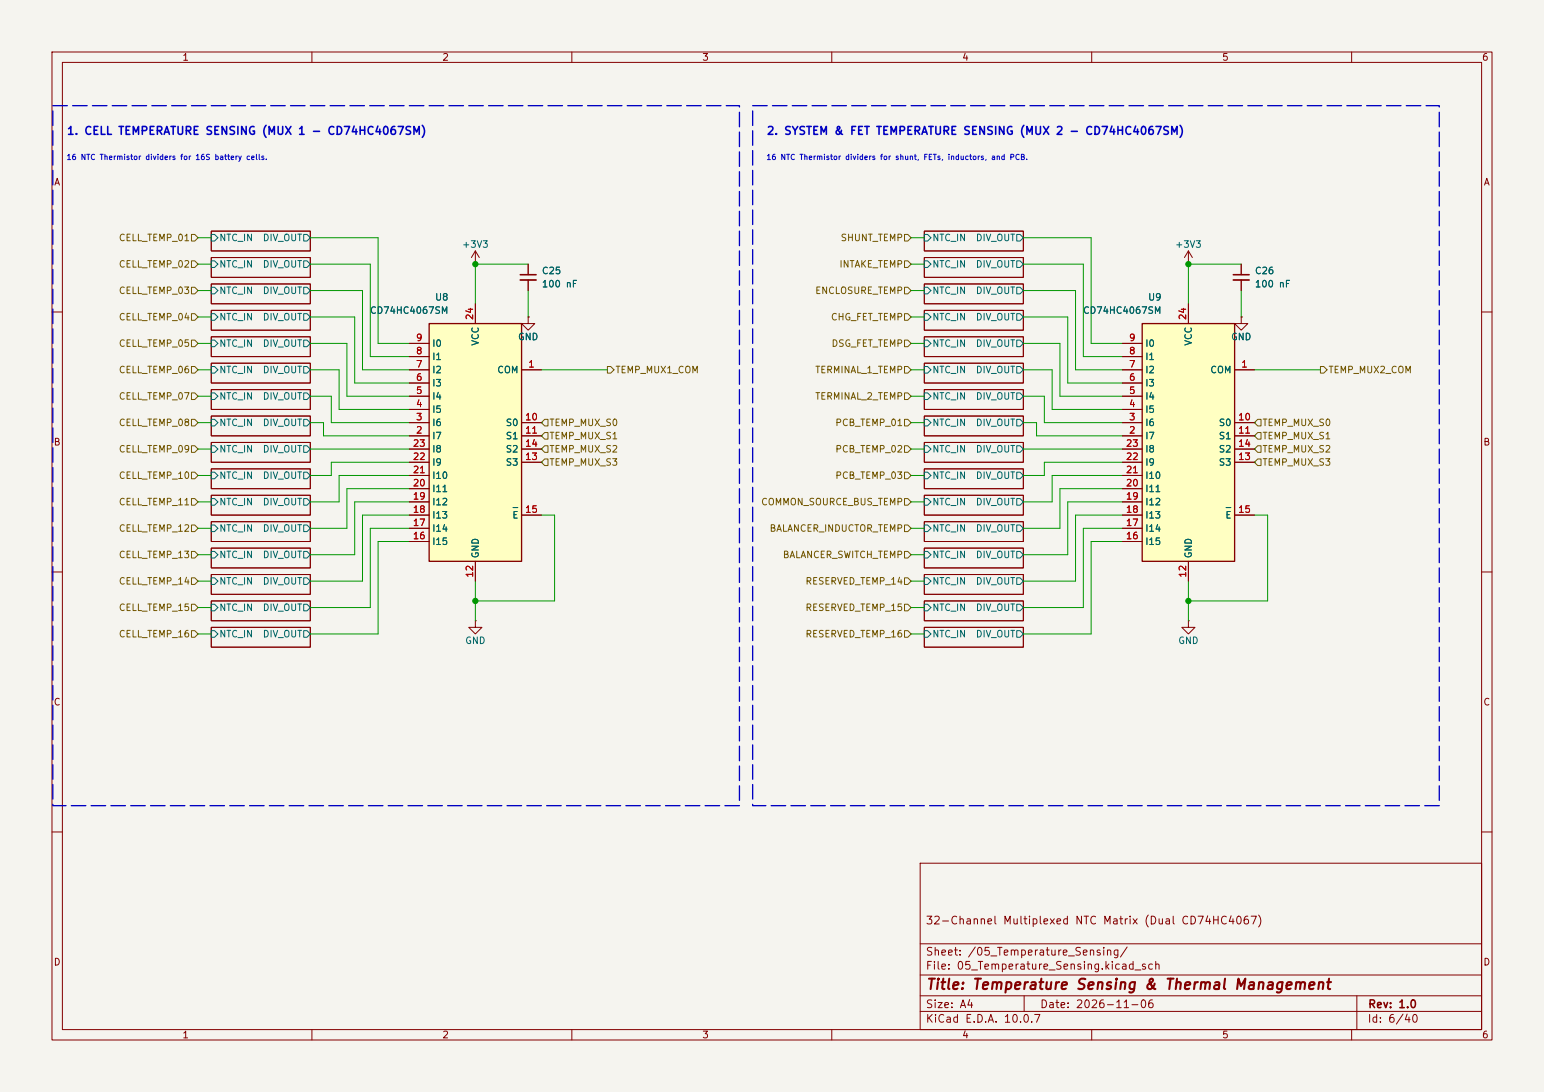
[picture p86: page 6]

16 NTC Thermistor dividers for 16S battery cells. 1. CELL TEMPERATURE SENSING (MUX 1 - CD74HC4067SM)
CELL_TEMP_15 CELL_TEMP_16 CELL_TEMP_13 CELL_TEMP_12 CELL_TEMP_14 CELL_TEMP_11 CELL_TEMP_10 CELL_TEMP_09 CELL_TEMP_08 CELL_TEMP_07 CELL_TEMP_06 CELL_TEMP_05 CELL_TEMP_04 CELL_TEMP_03 CELL_TEMP_02

16 NTC Thermistor dividers for shunt, FETs, inductors, and PCB. 2. SYSTEM & FET TEMPERATURE SENSING (MUX 2 - CD74HC4067SM) C25

32-Channel Multiplexed NTC Matrix (Dual CD74HC4067)

Sheet: /05_Temperature_Sensing/
File: 05_Temperature_Sensing.kicad_sch
Title: Temperature Sensing & Thermal Management


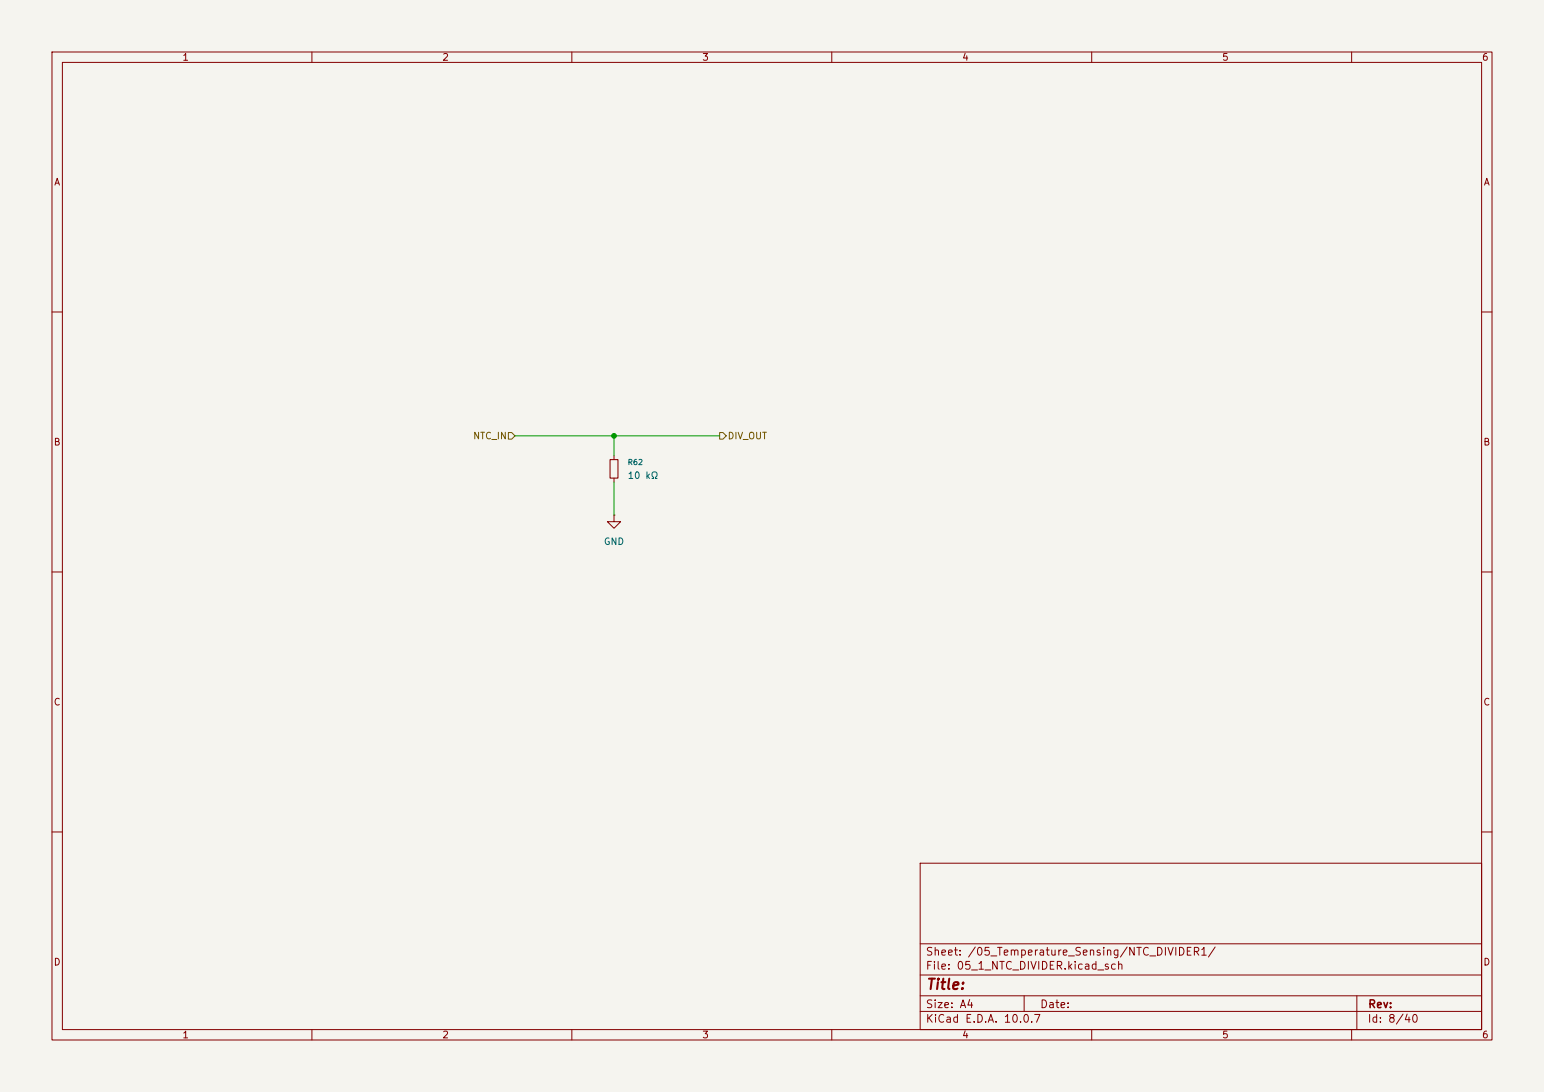
[picture p87: page 8]

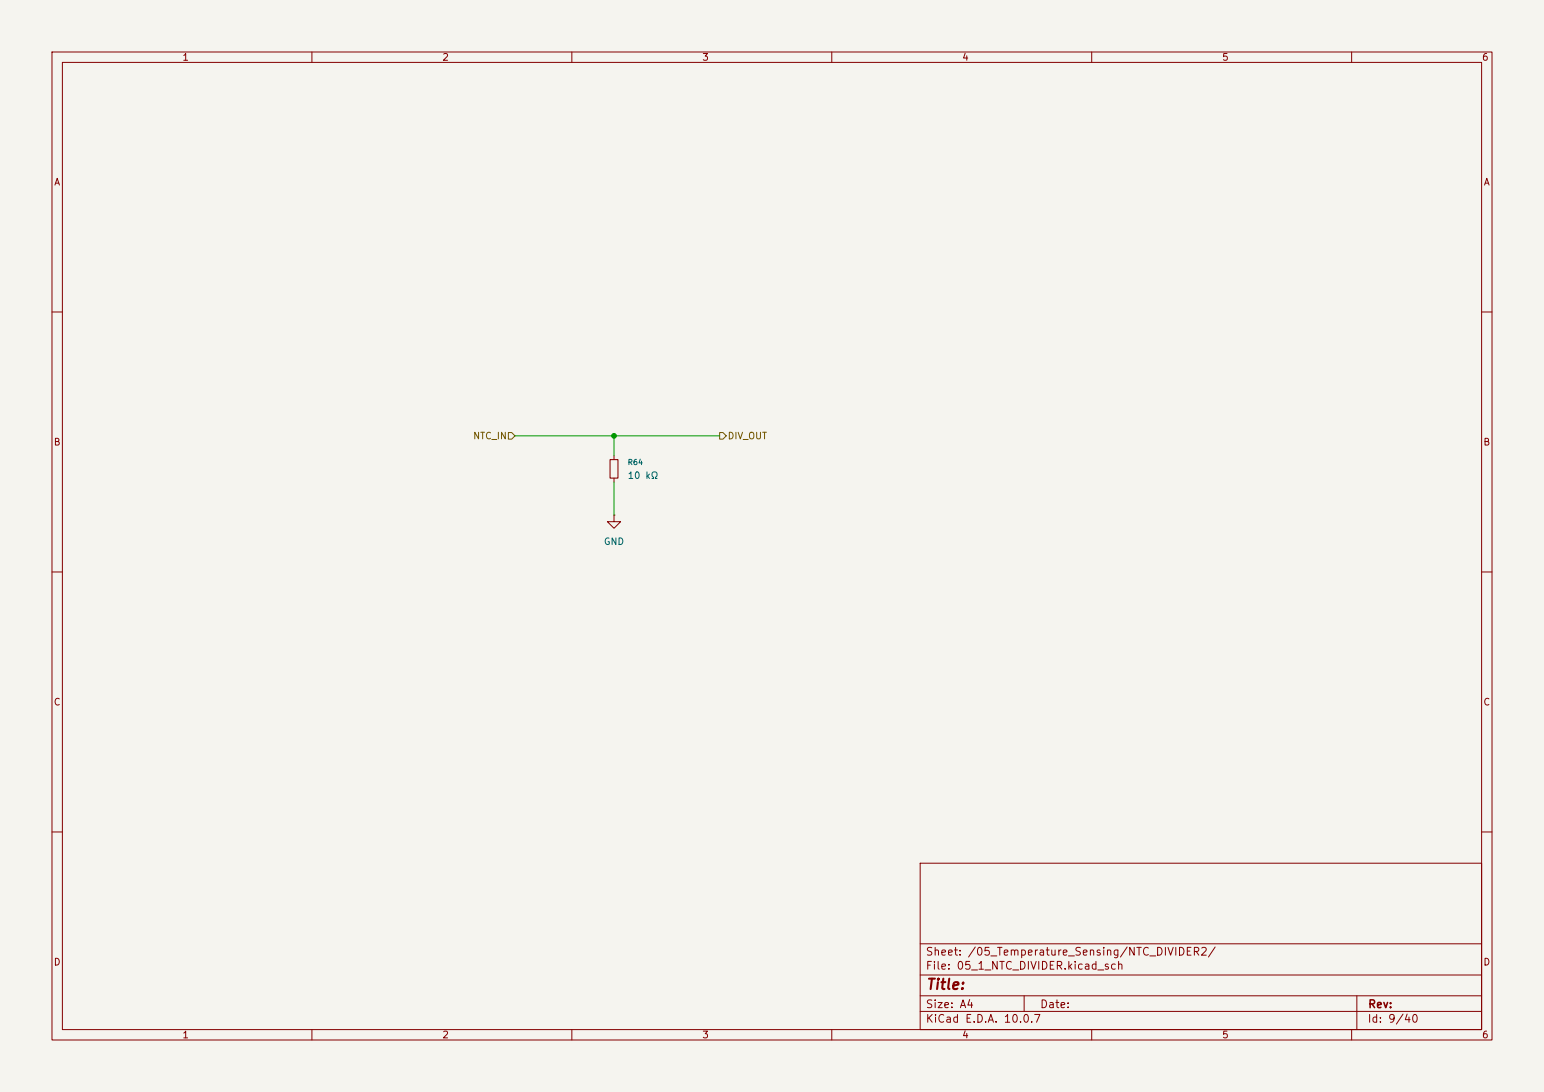
[picture p88: page 9]

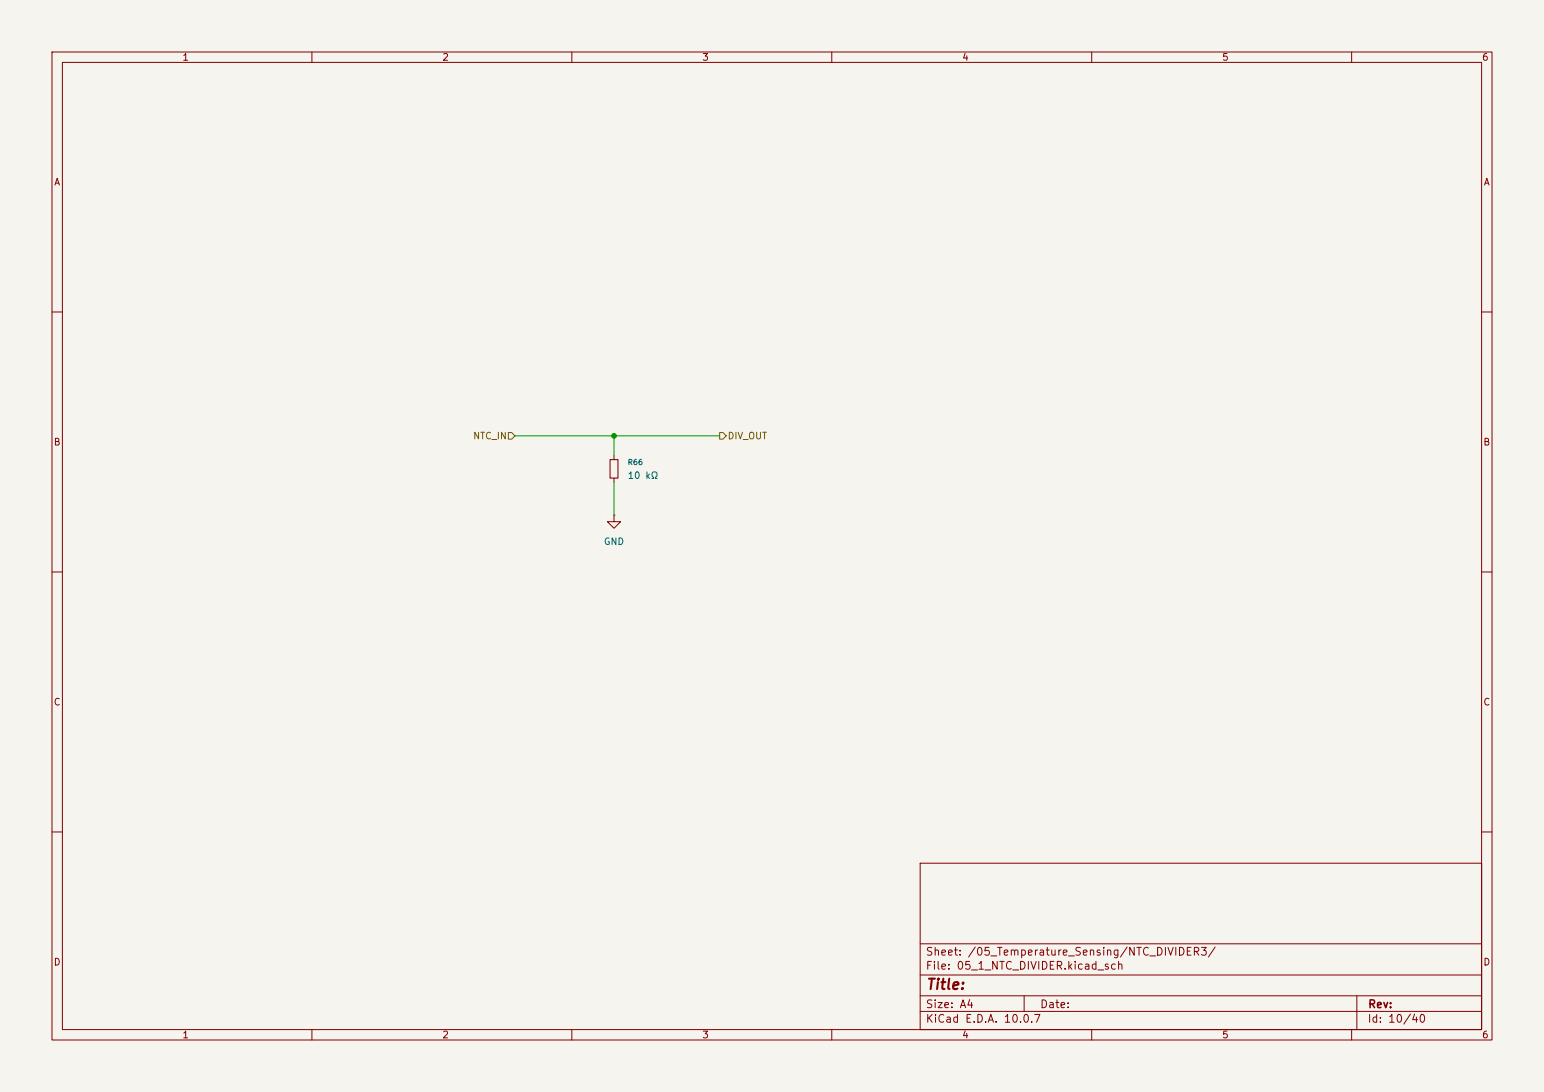
[picture p89: page 10]

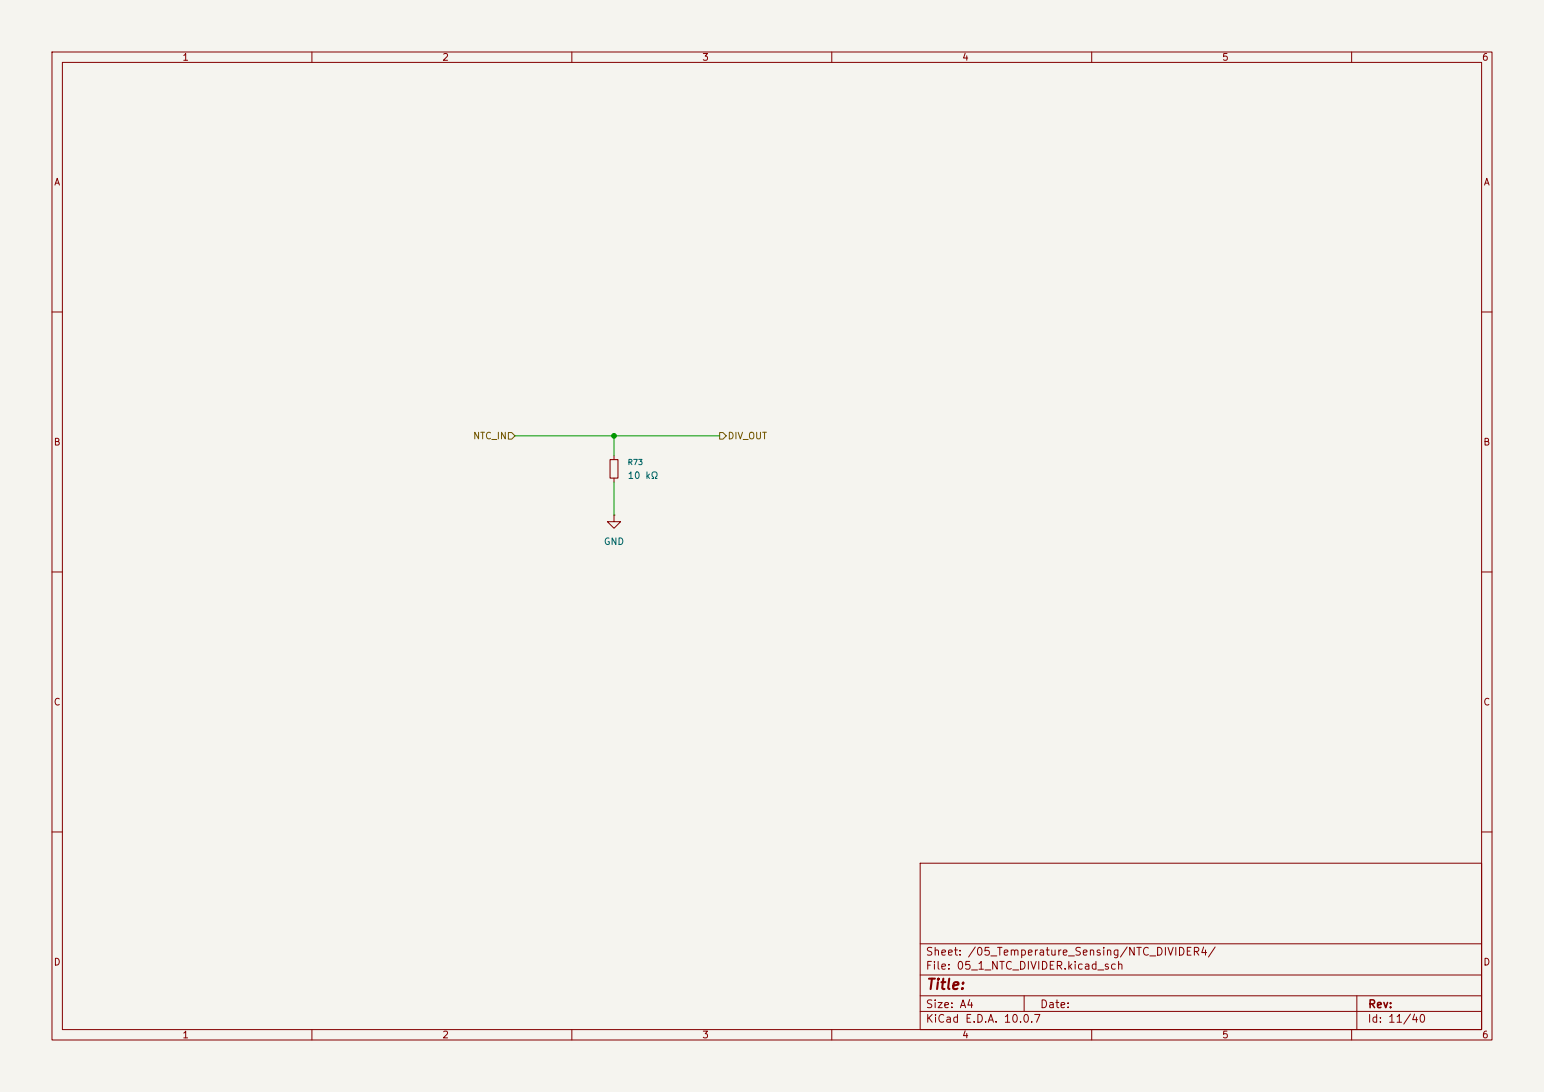
[picture p90: page 11]

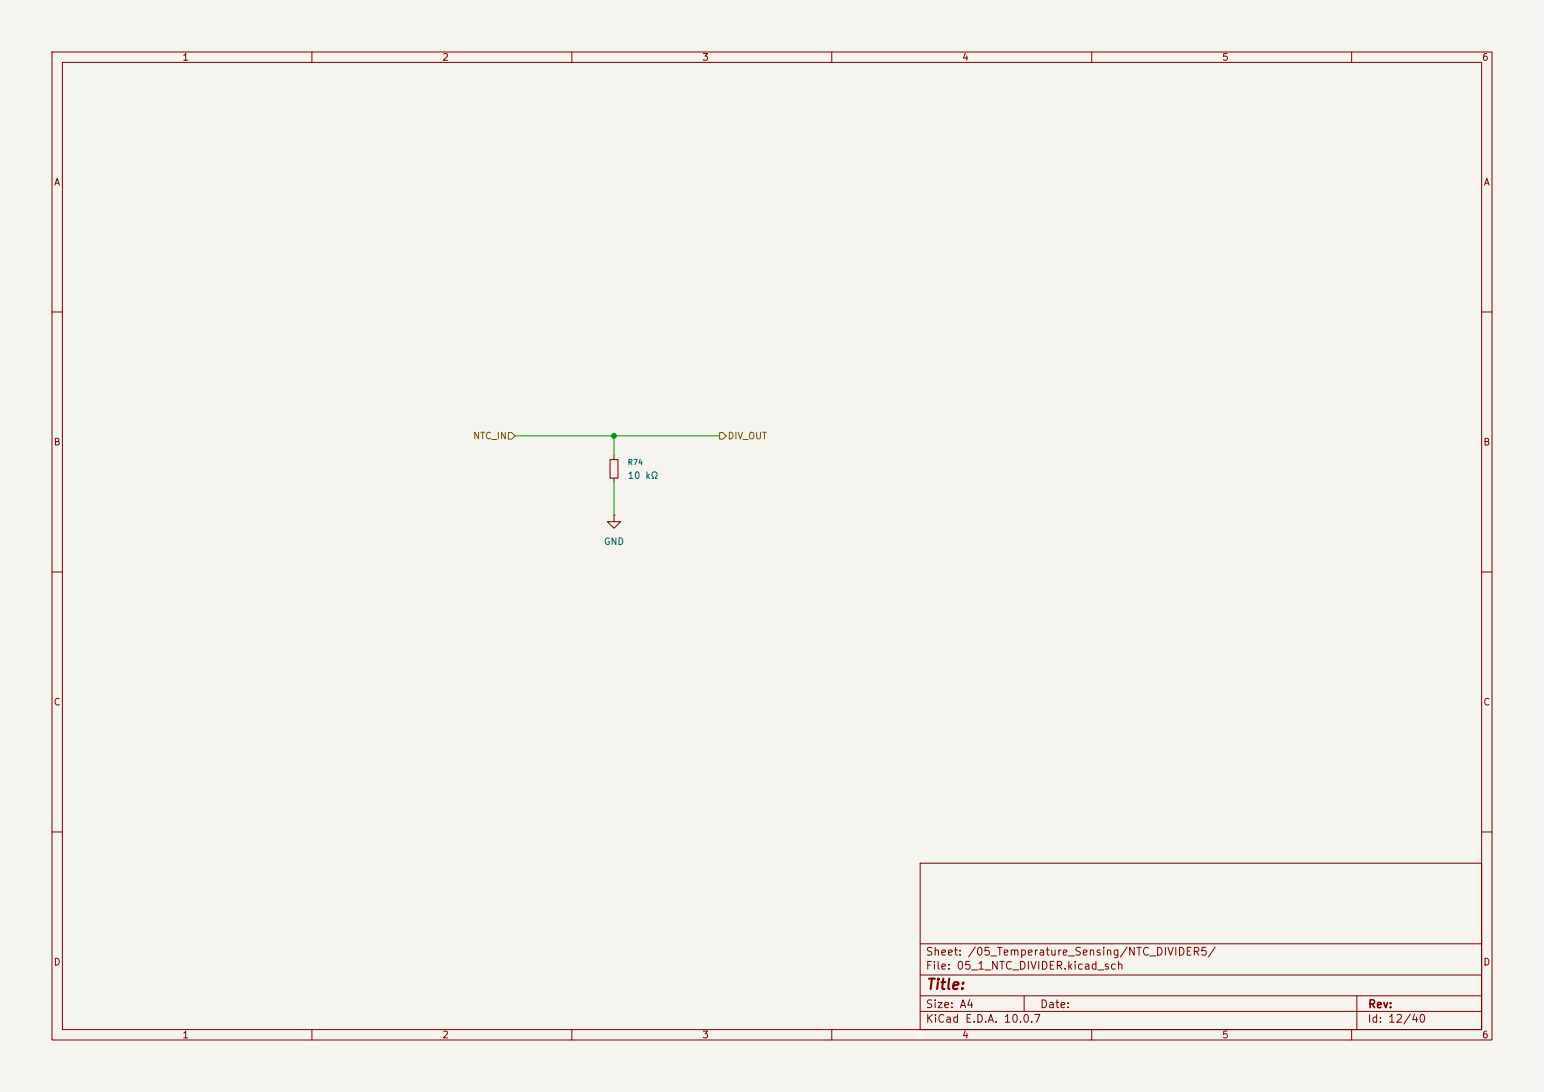
[picture p91: page 12]

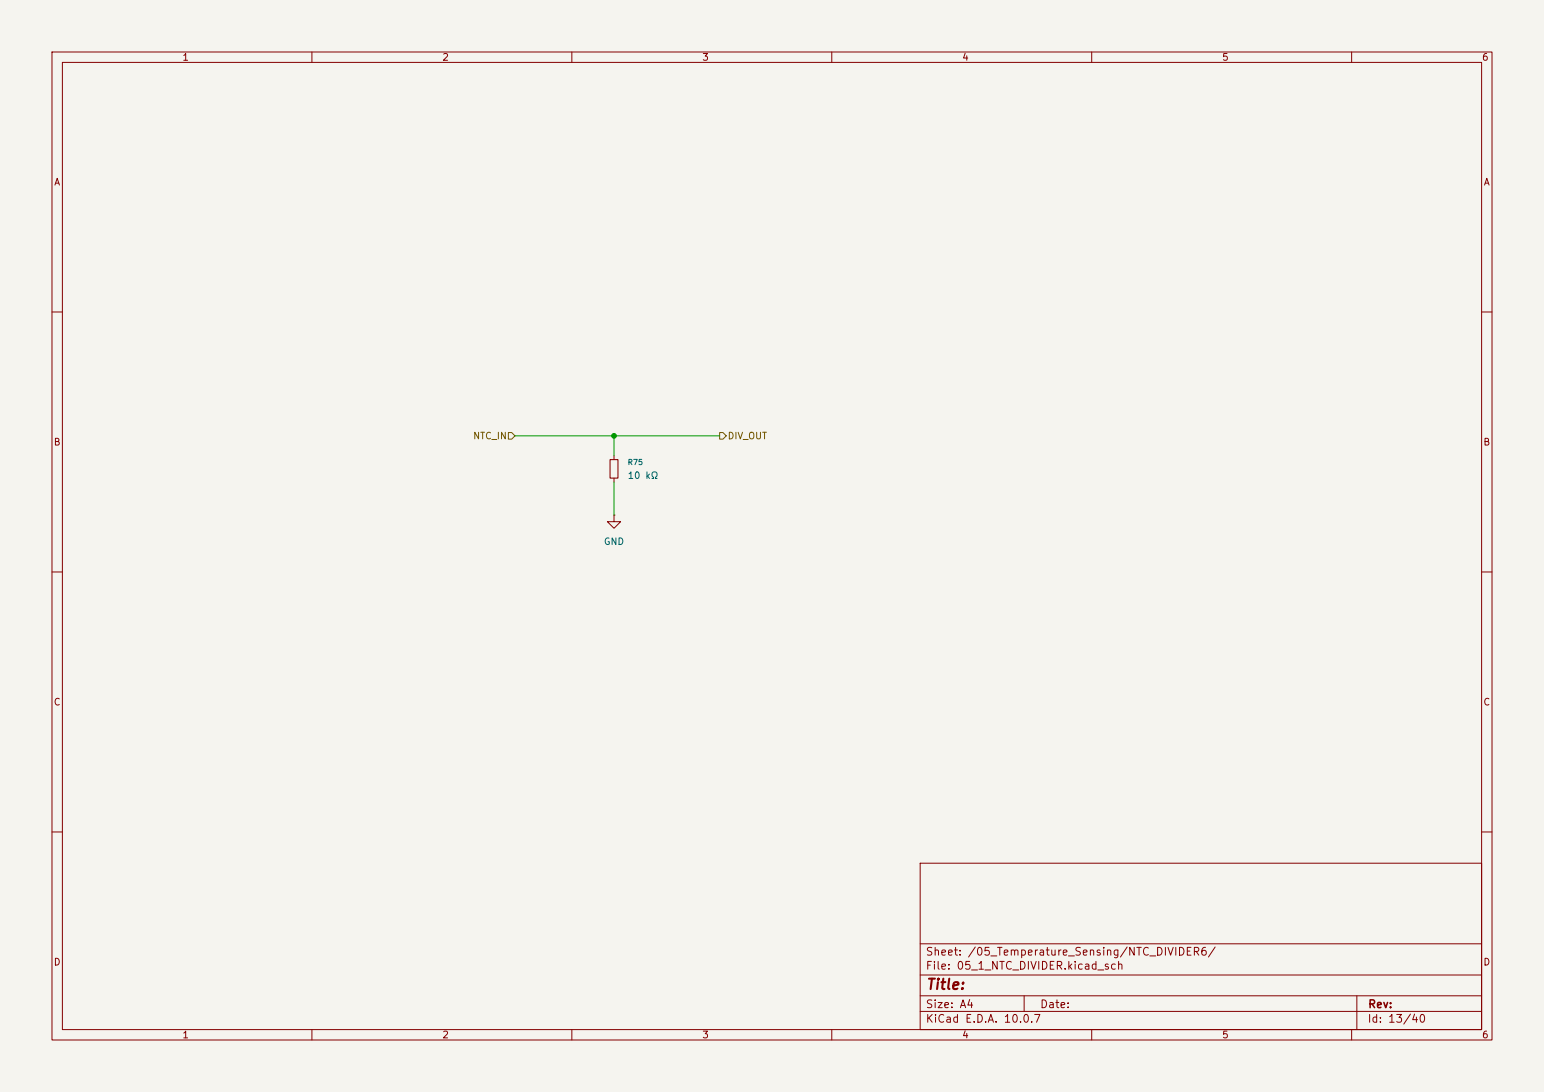
[picture p92: page 13]

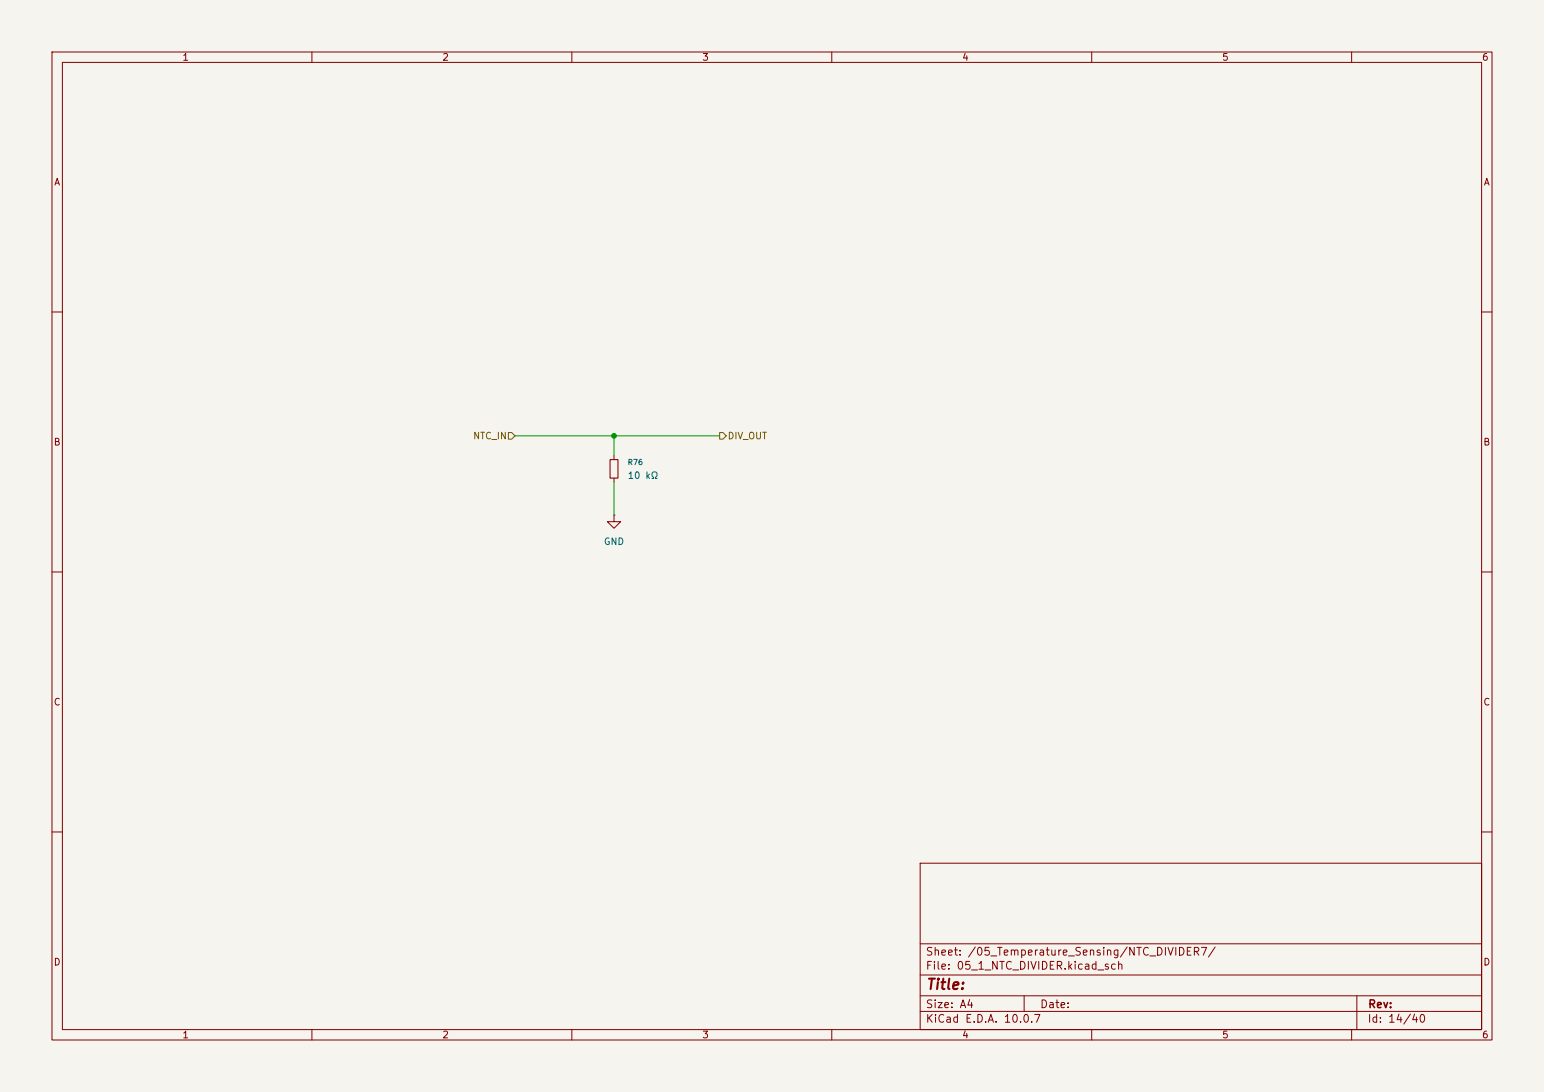
[picture p93: page 14]

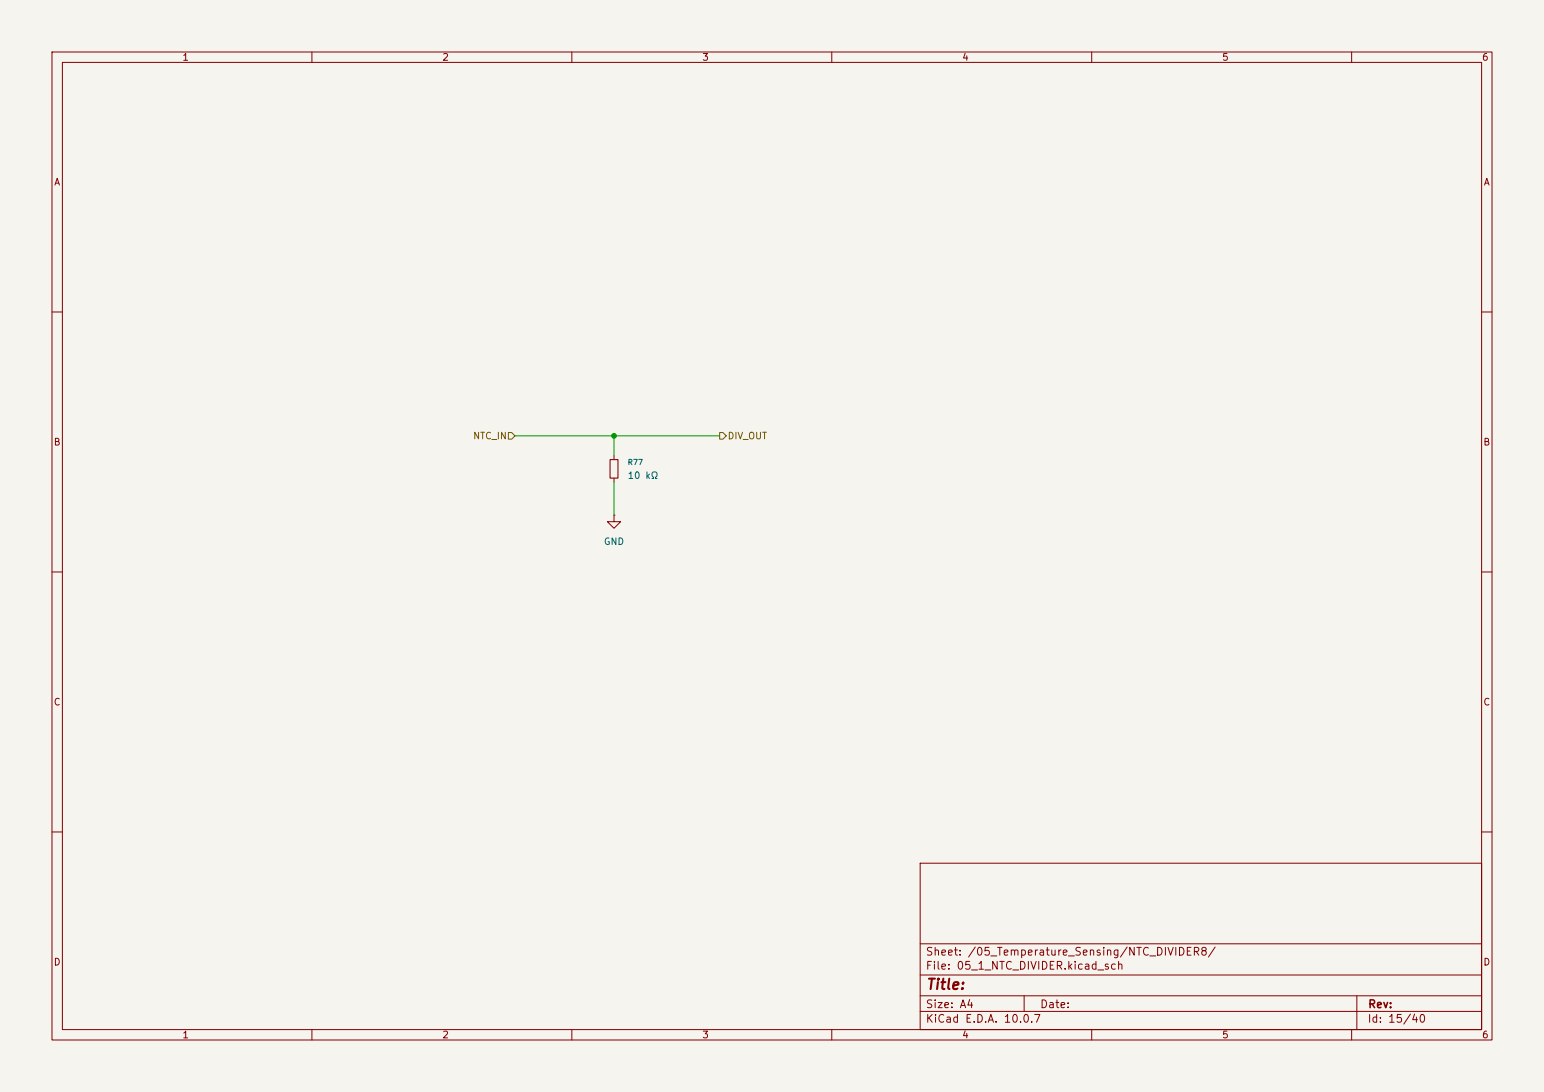
[picture p94: page 15]

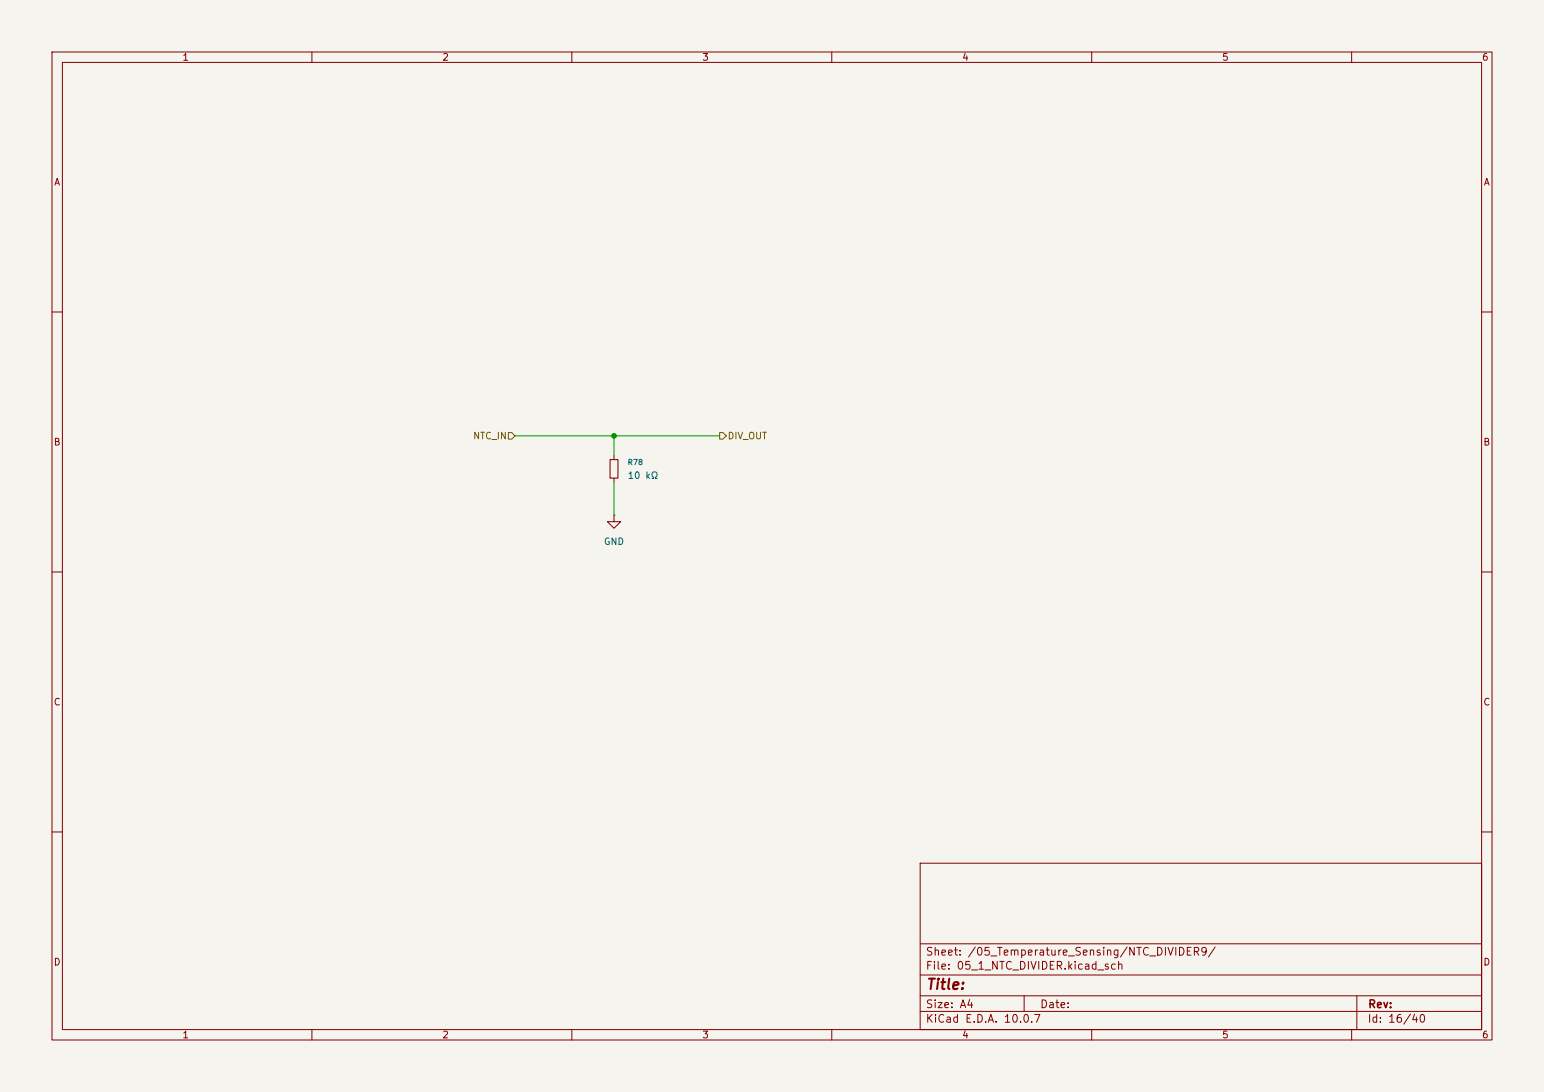
[picture p95: page 16]

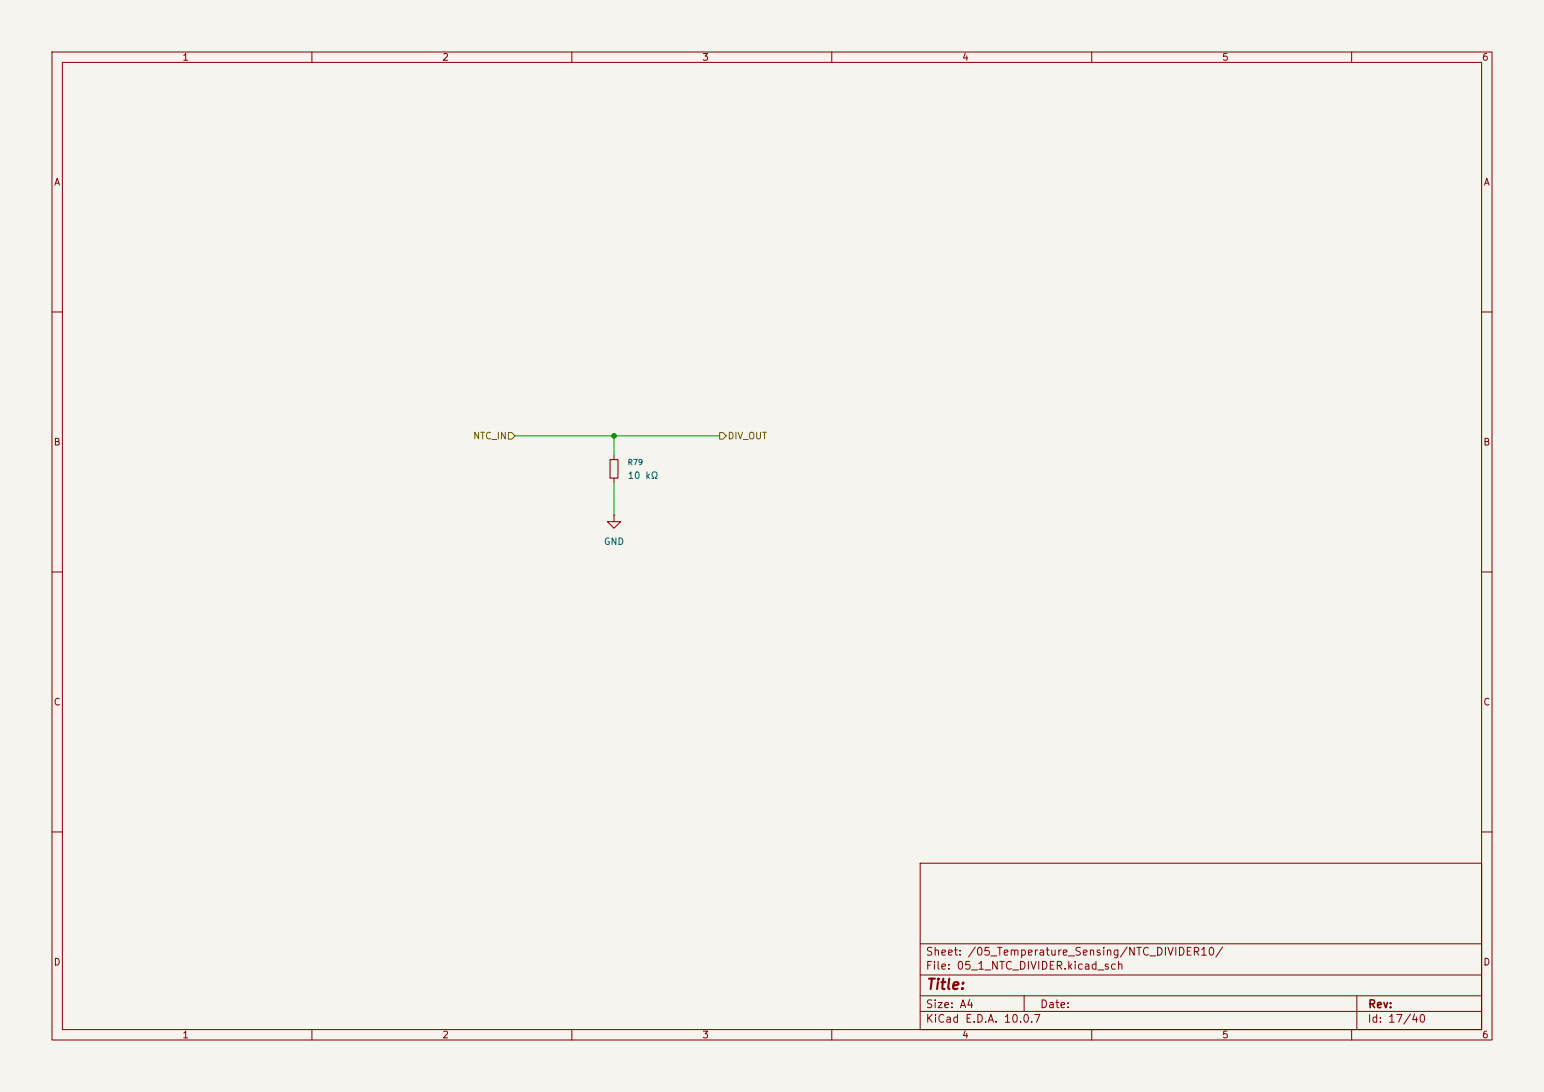
[picture p96: page 17]

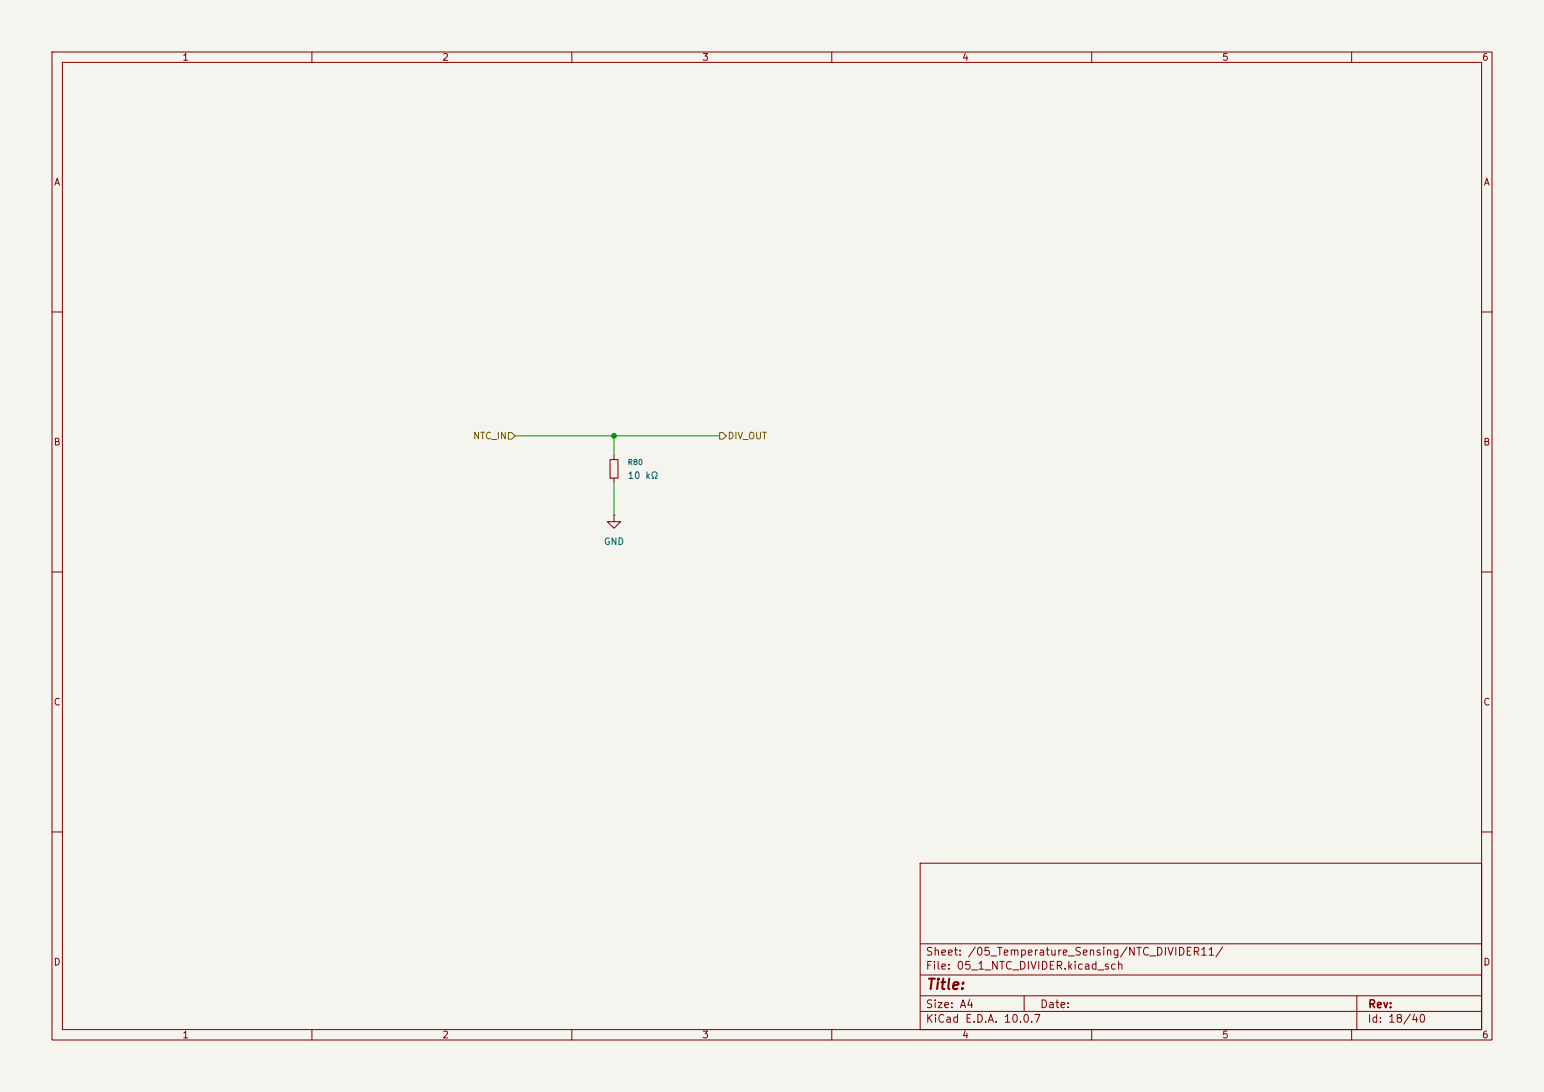
[picture p97: page 18]

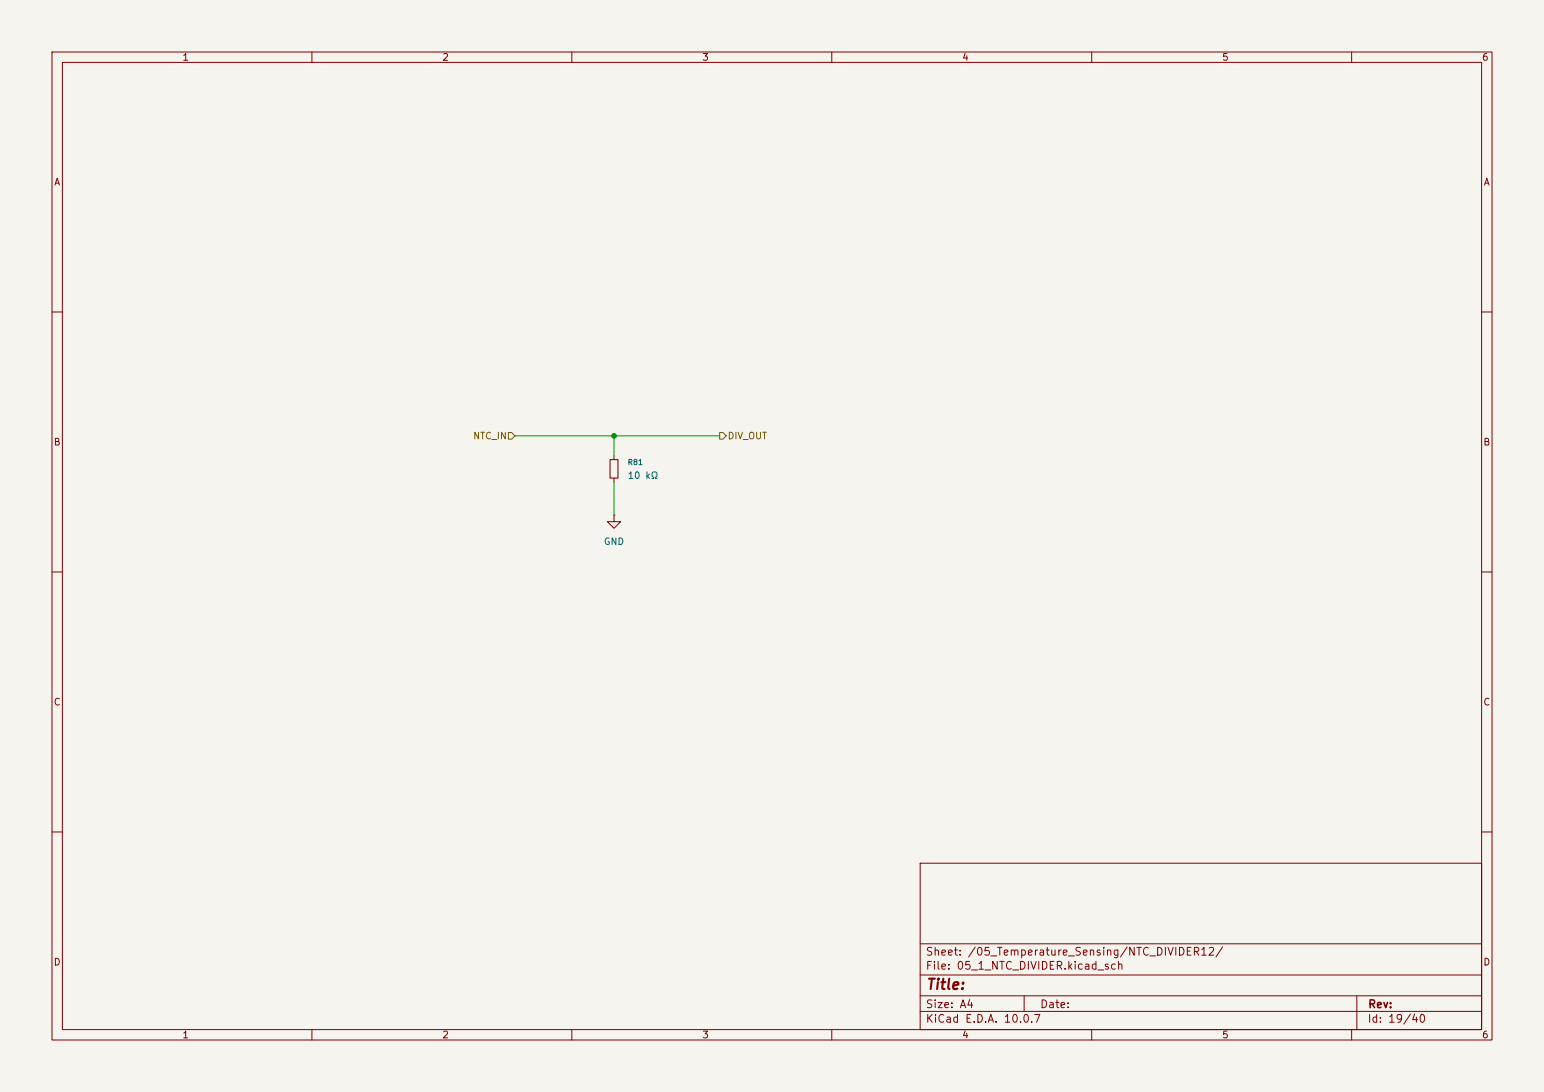
[picture p98: page 19]

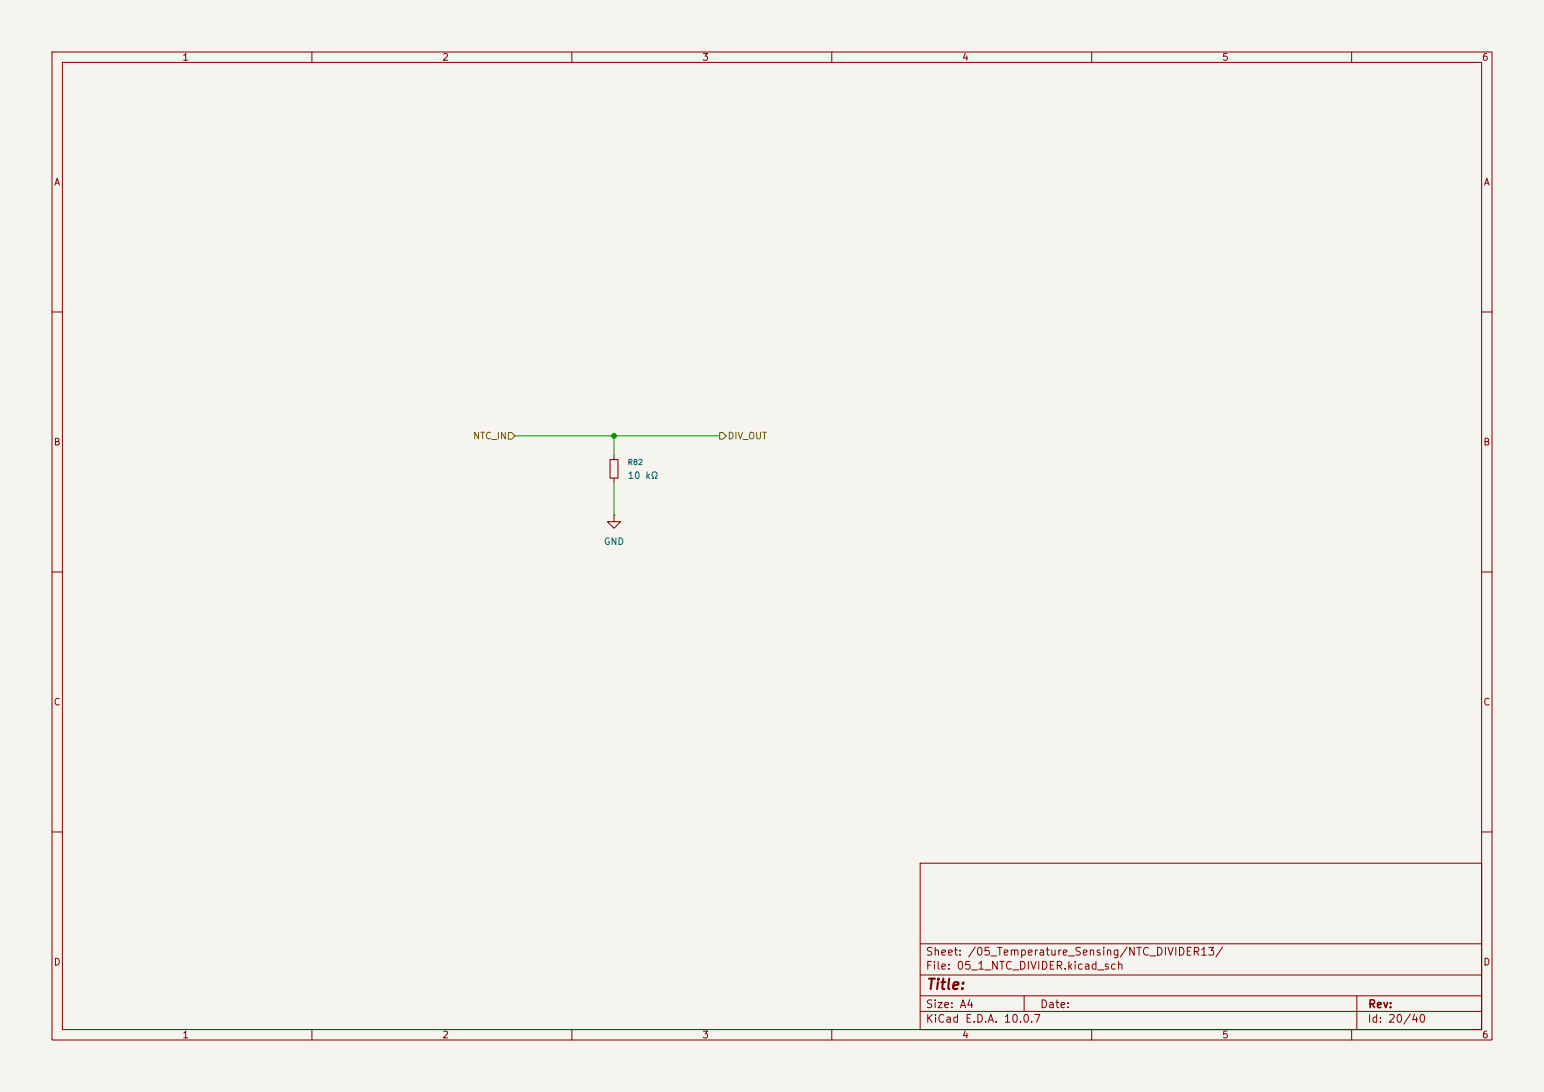
[picture p99: page 20]

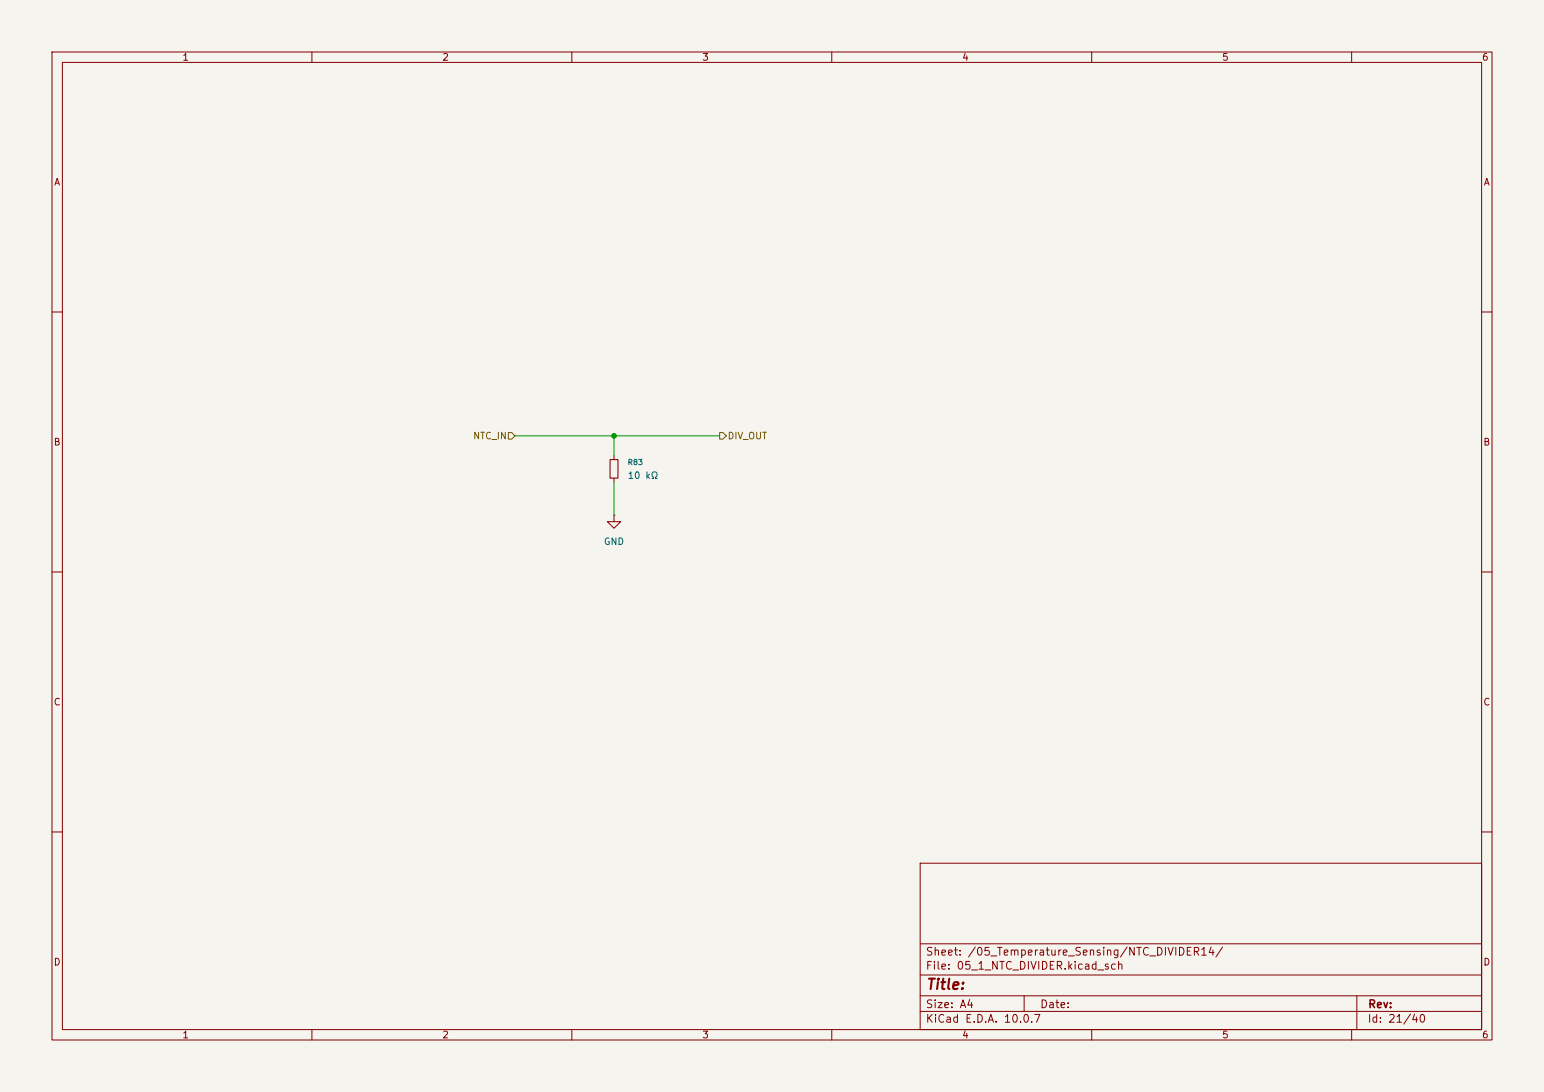
[picture p100: page 21]

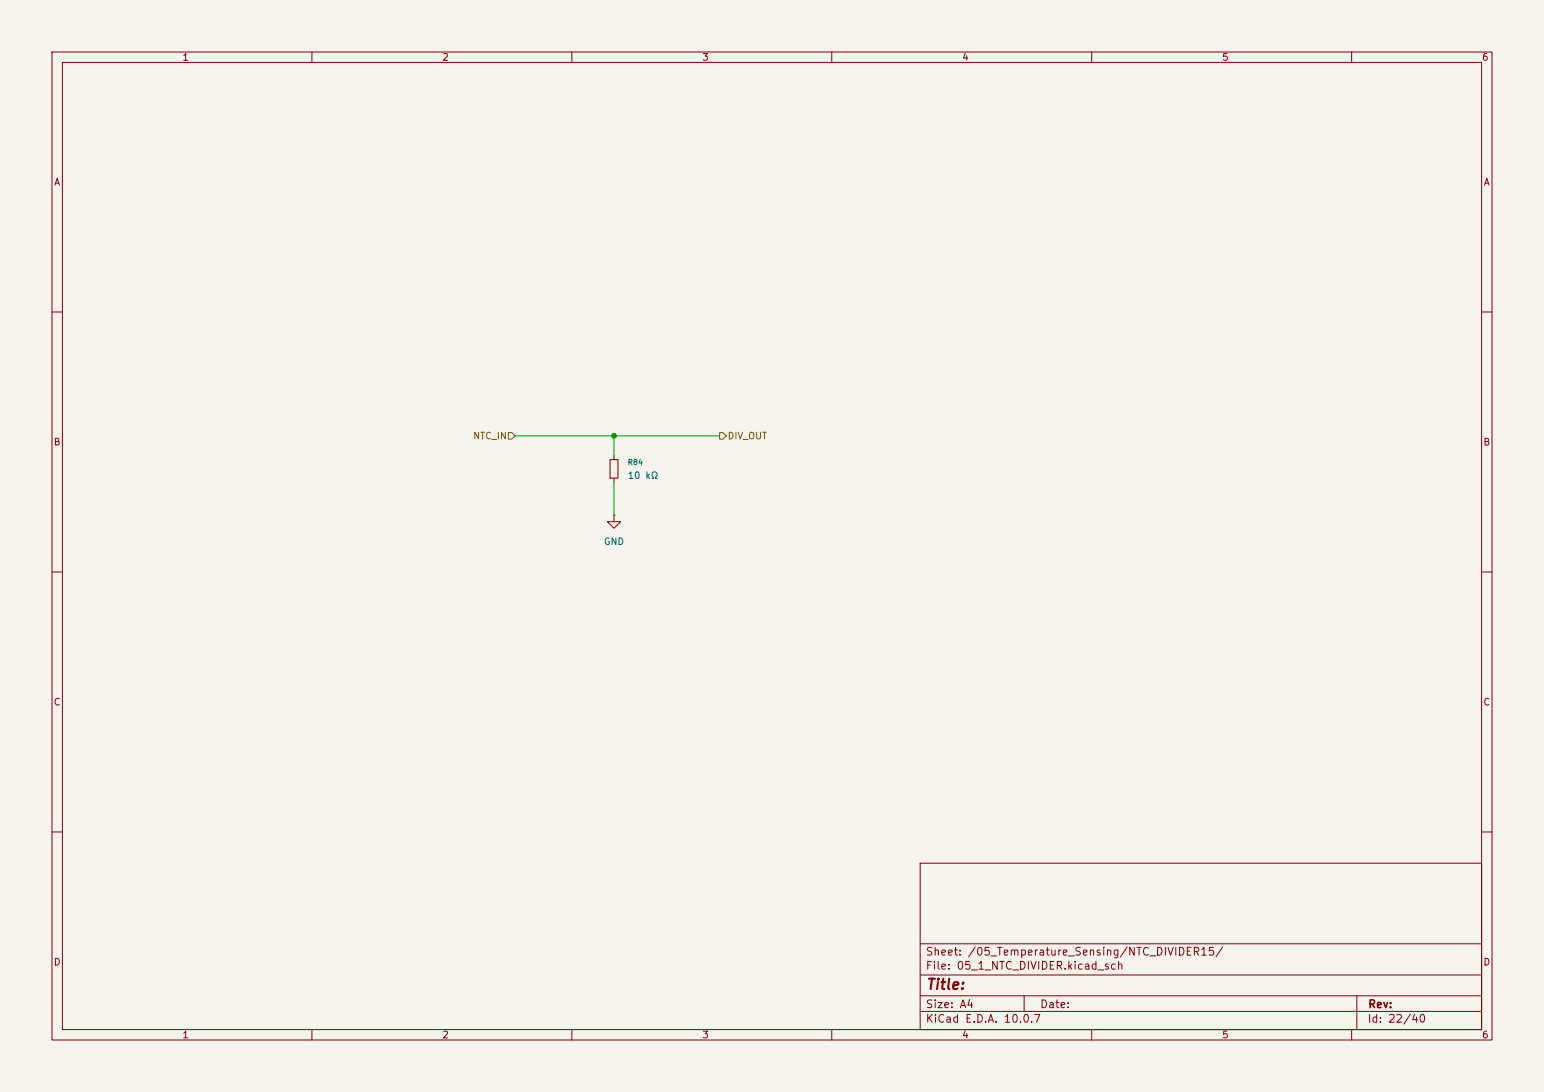
[picture p101: page 22]

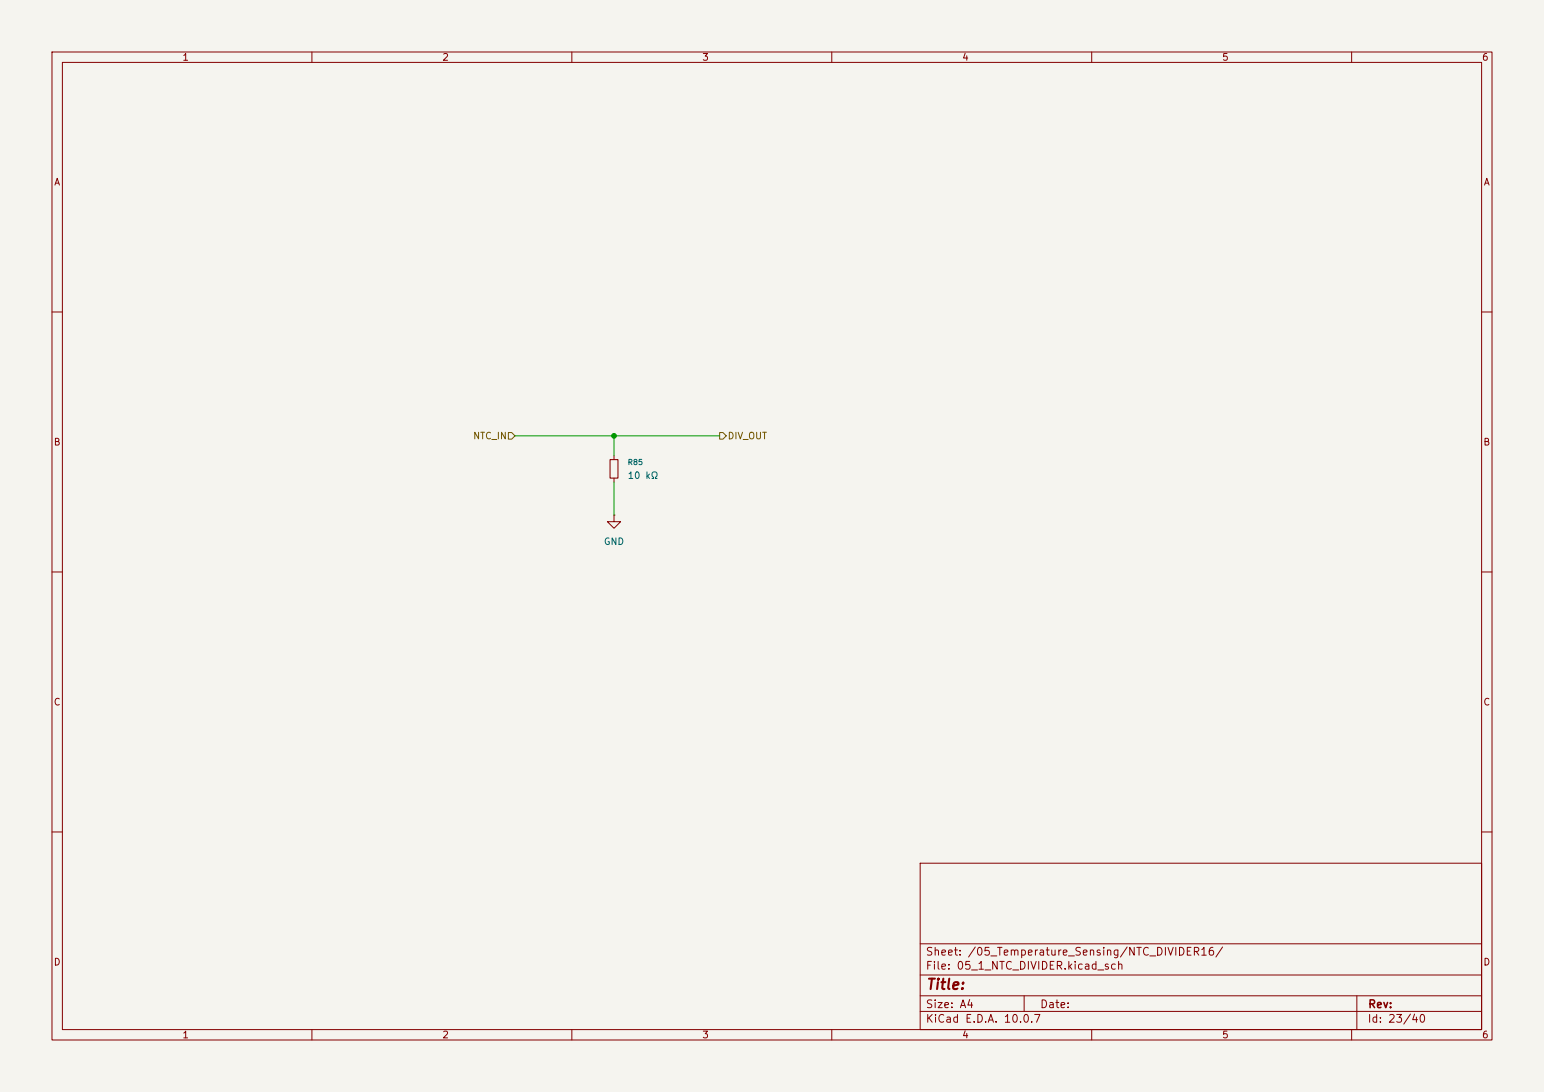
[picture p102: page 23]

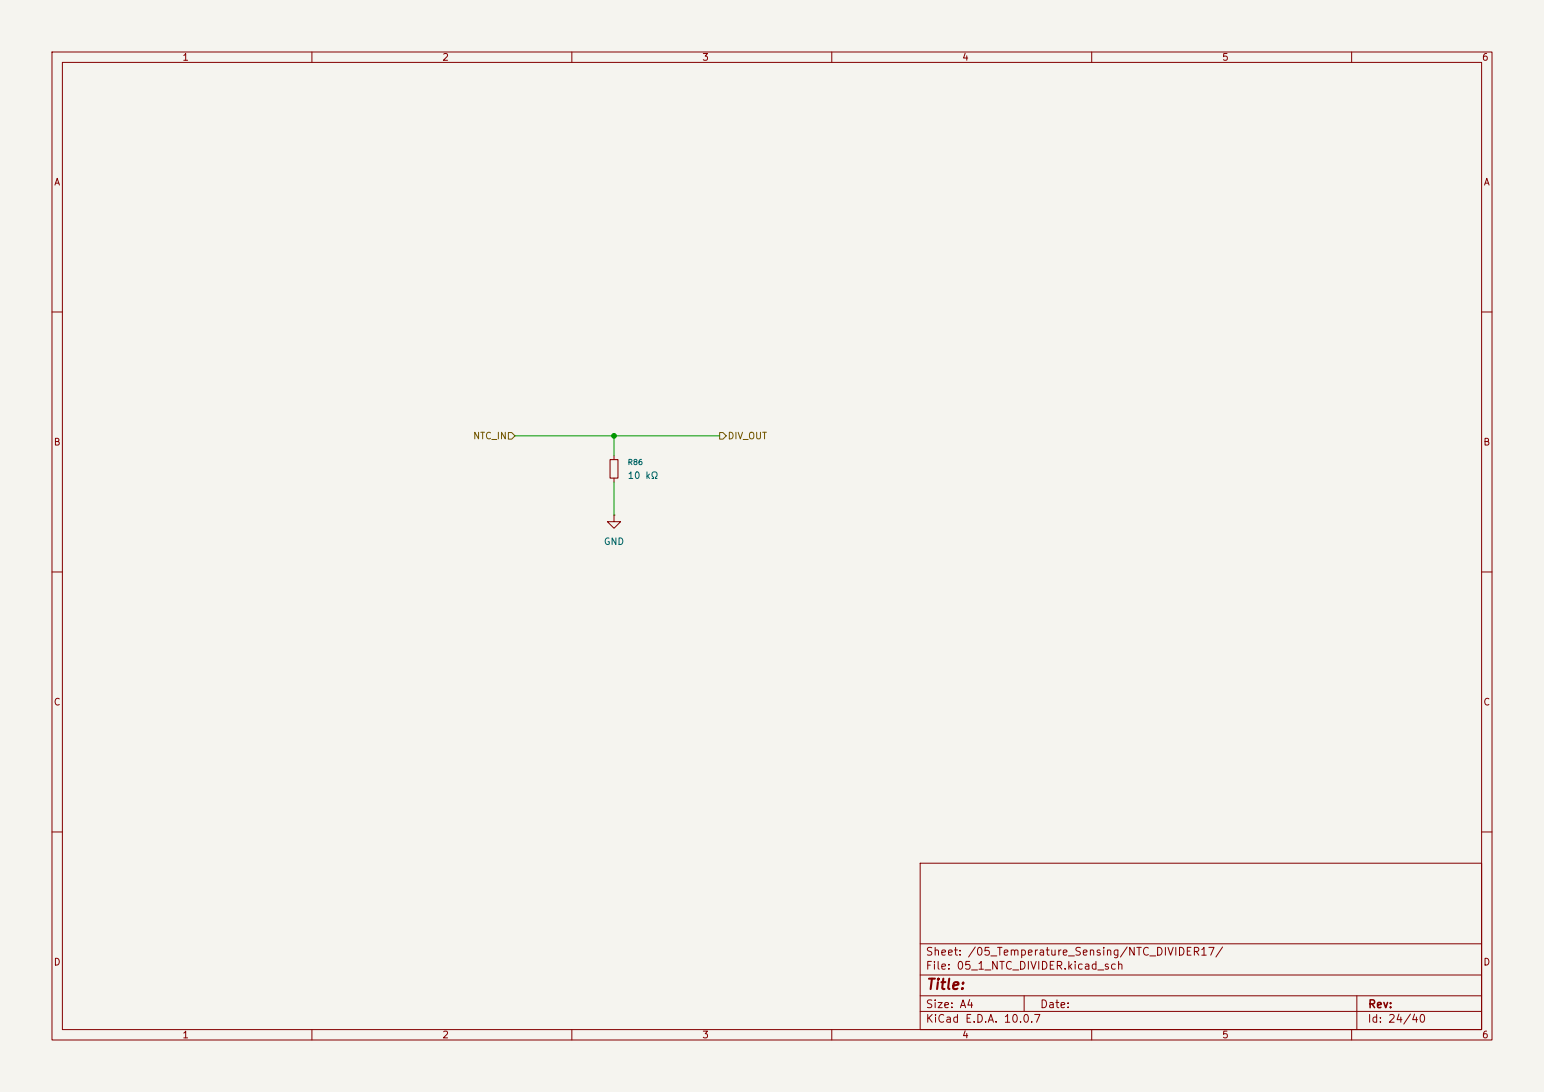
[picture p103: page 24]

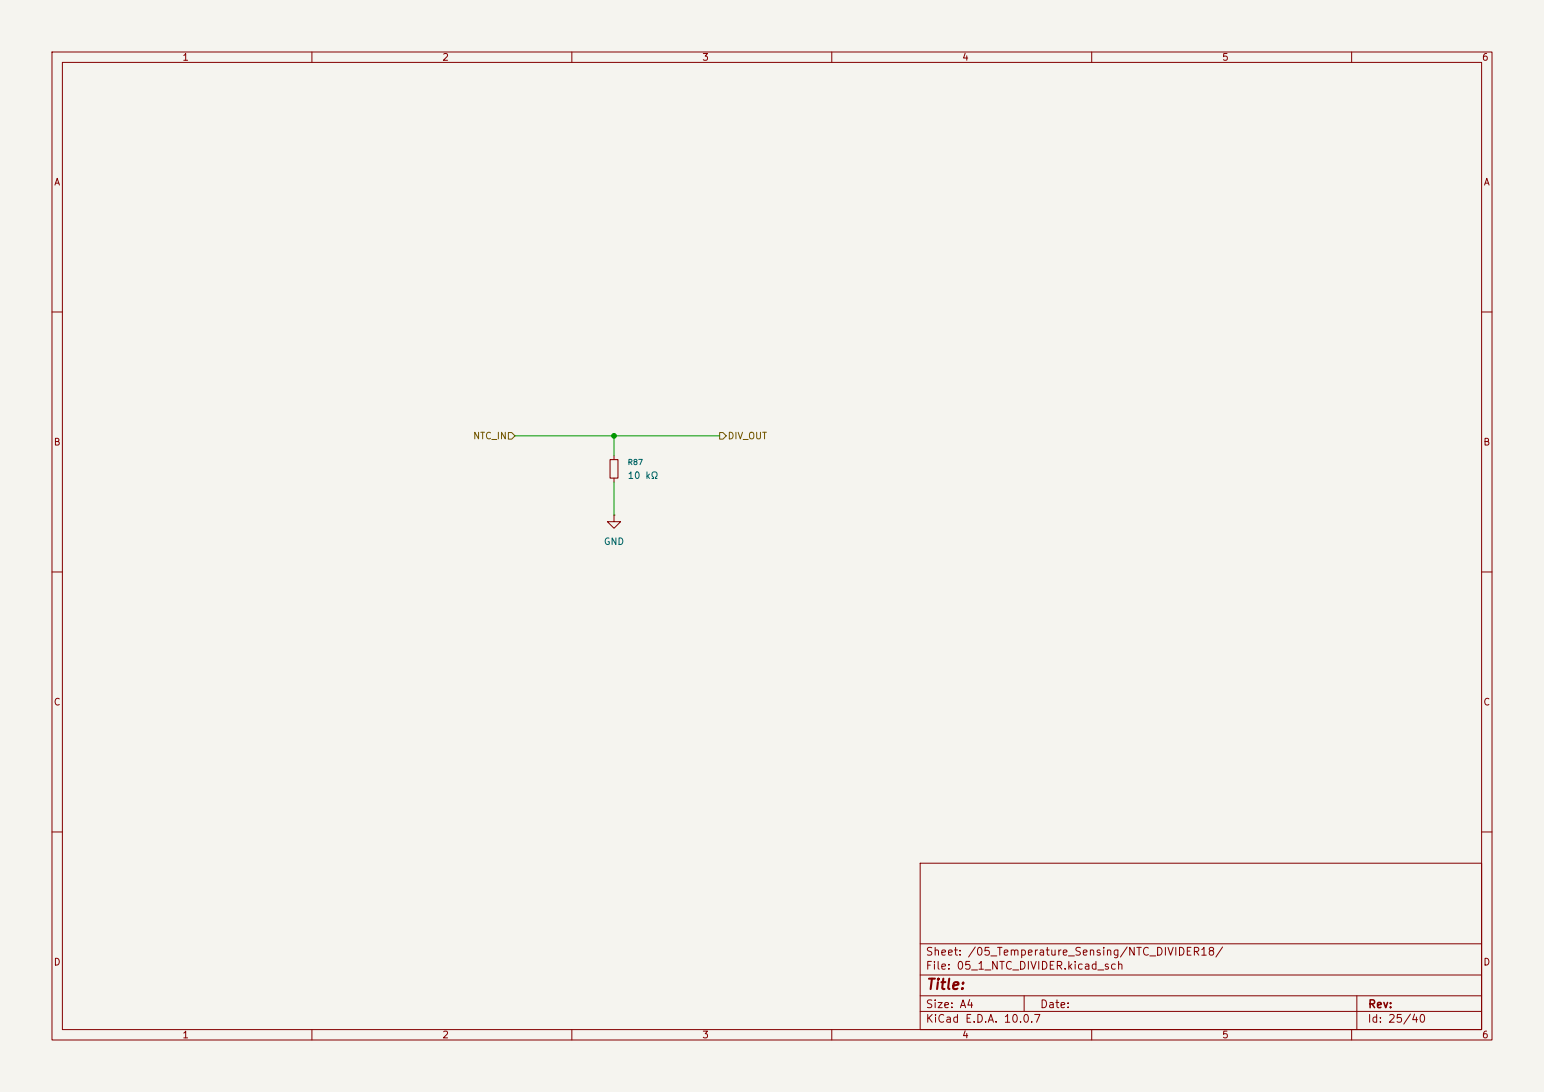
[picture p104: page 25]

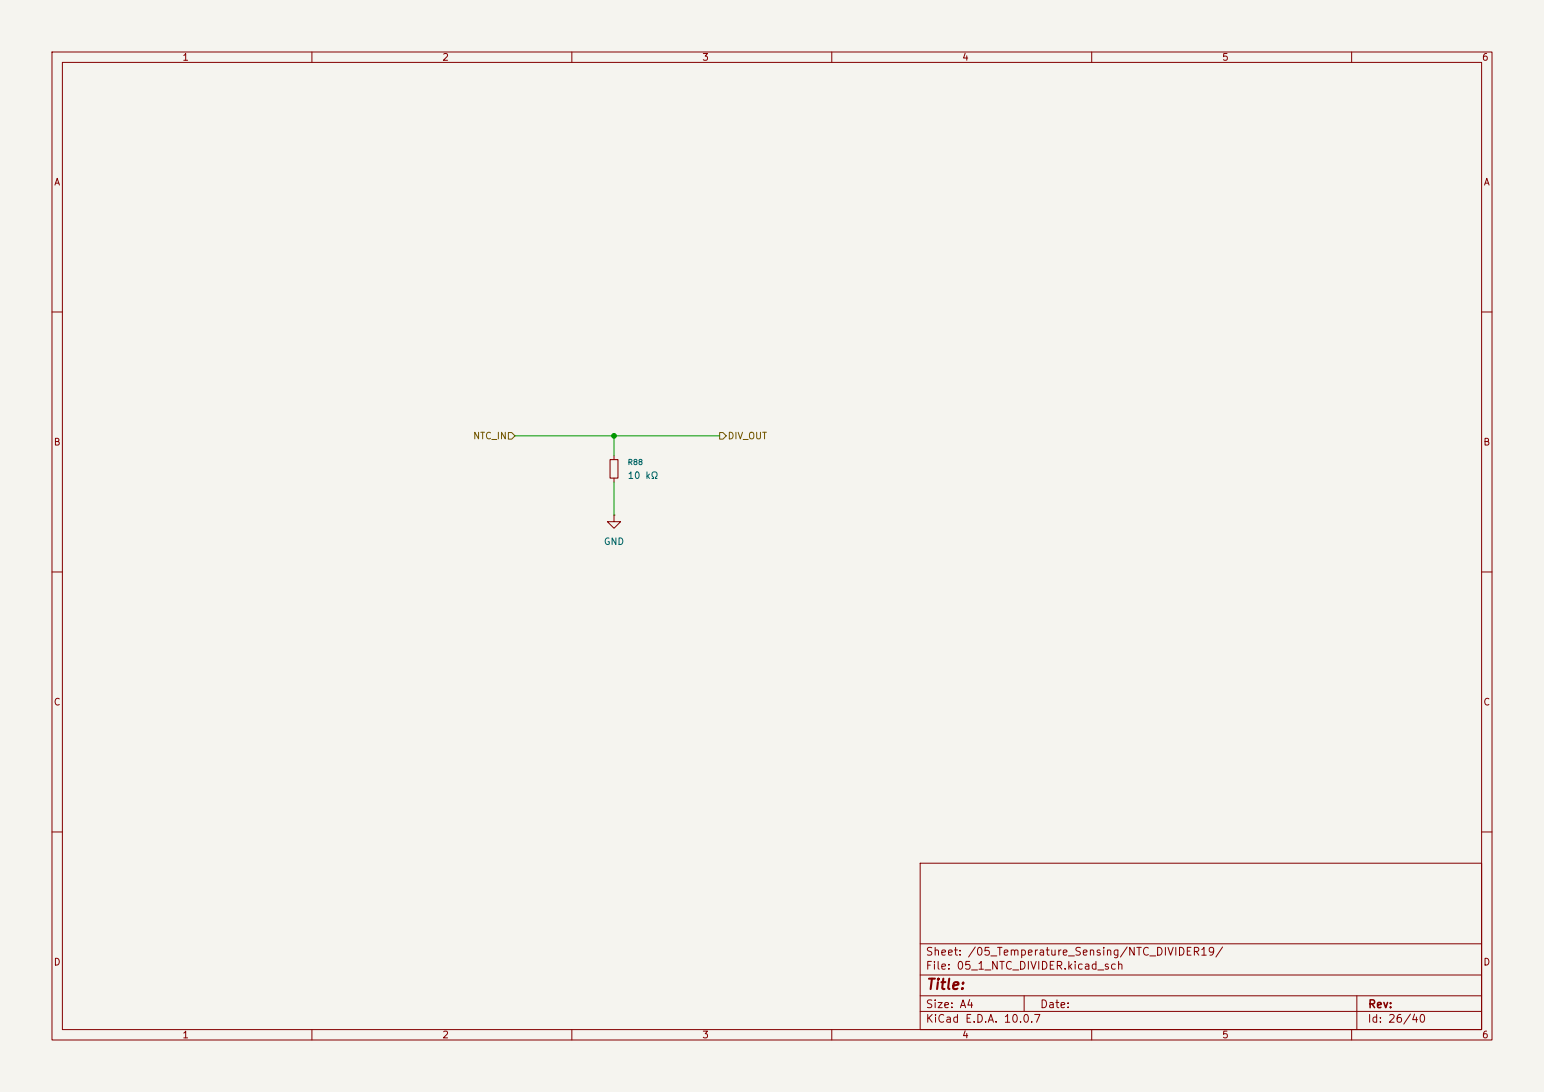
[picture p105: page 26]

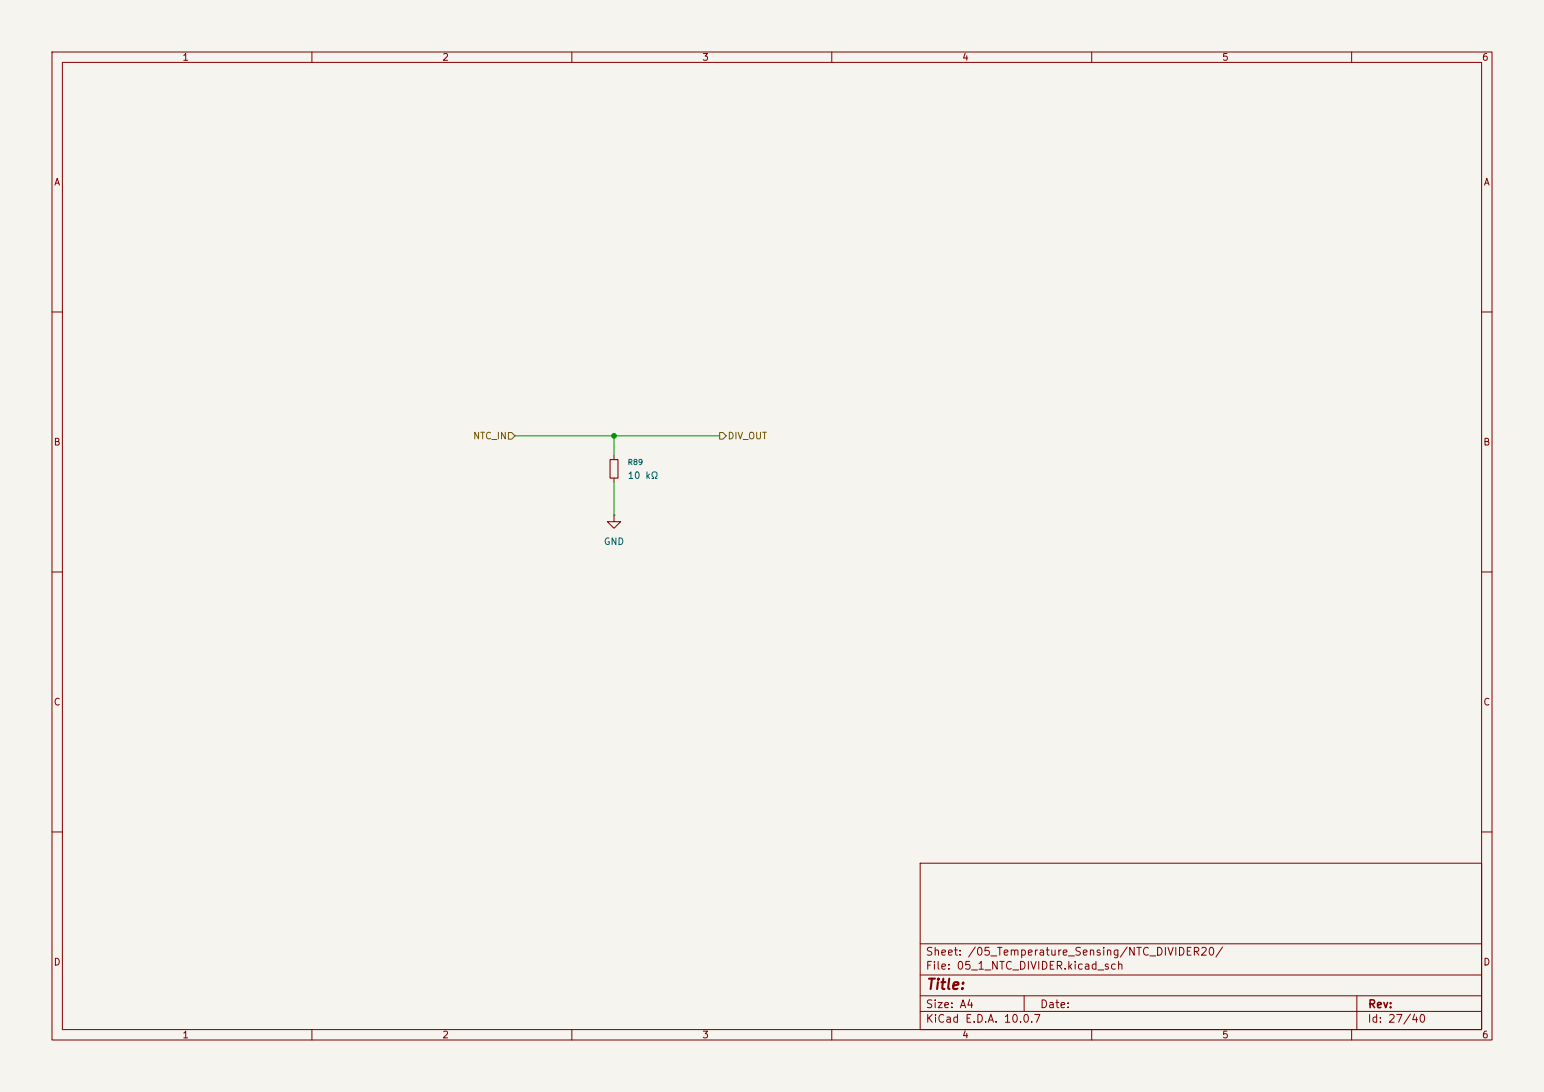
[picture p106: page 27]

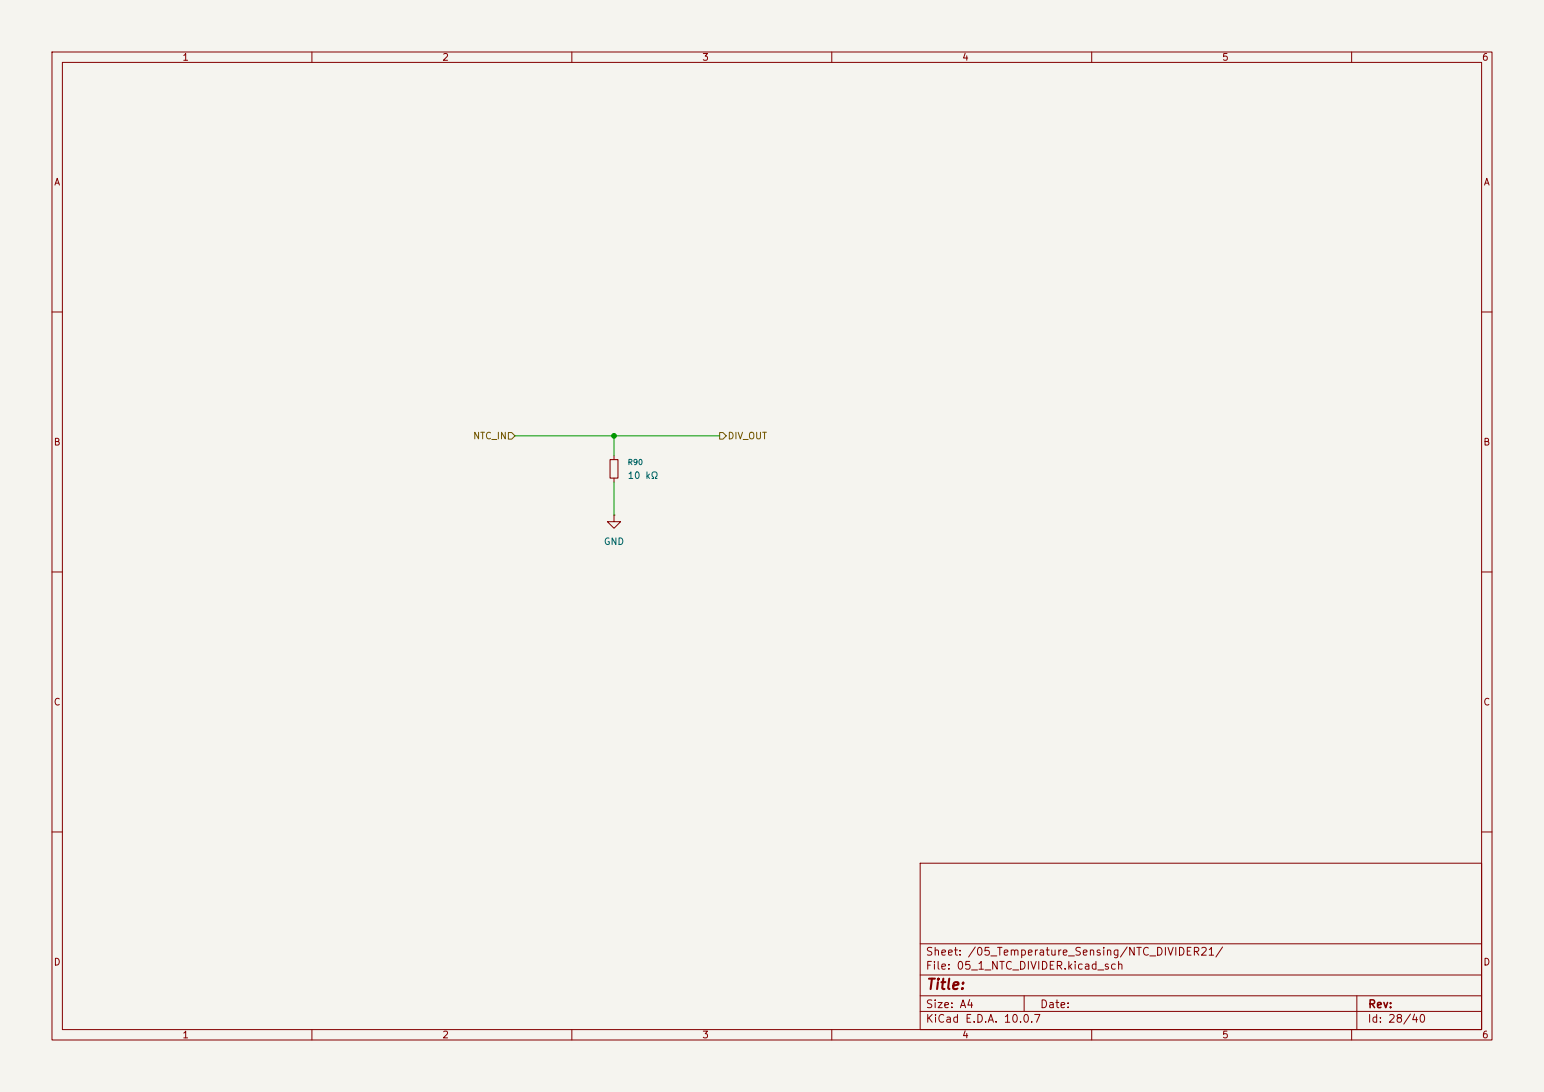
[picture p107: page 28]

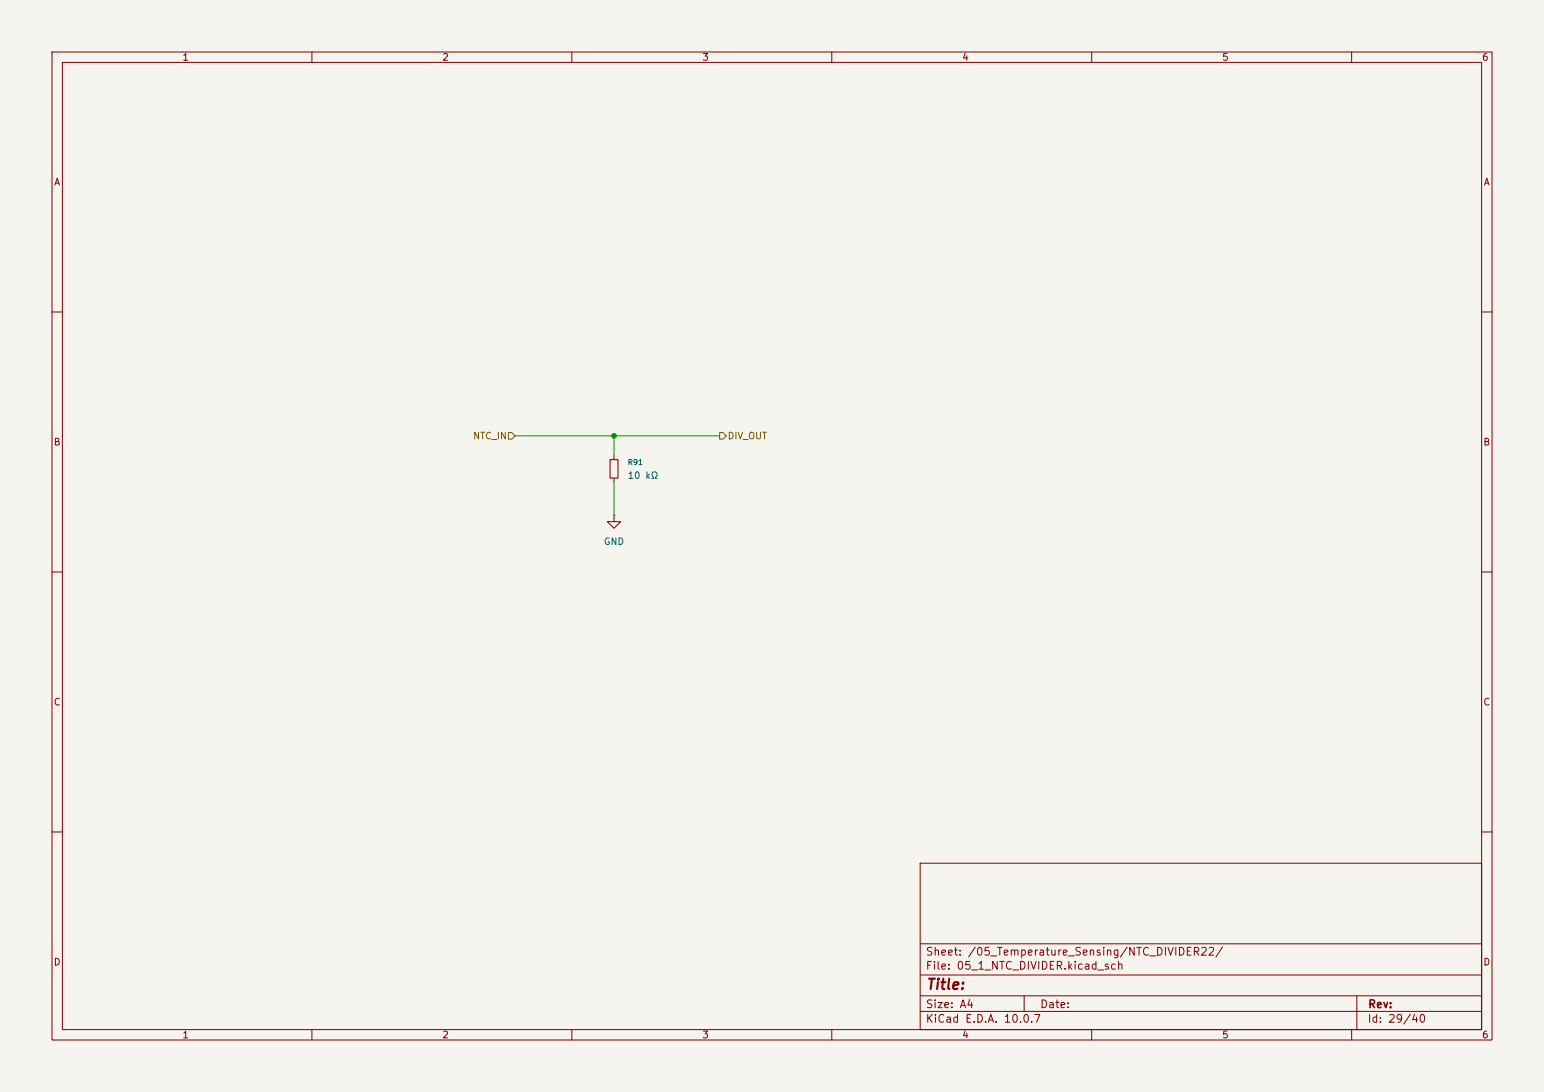
[picture p108: page 29]

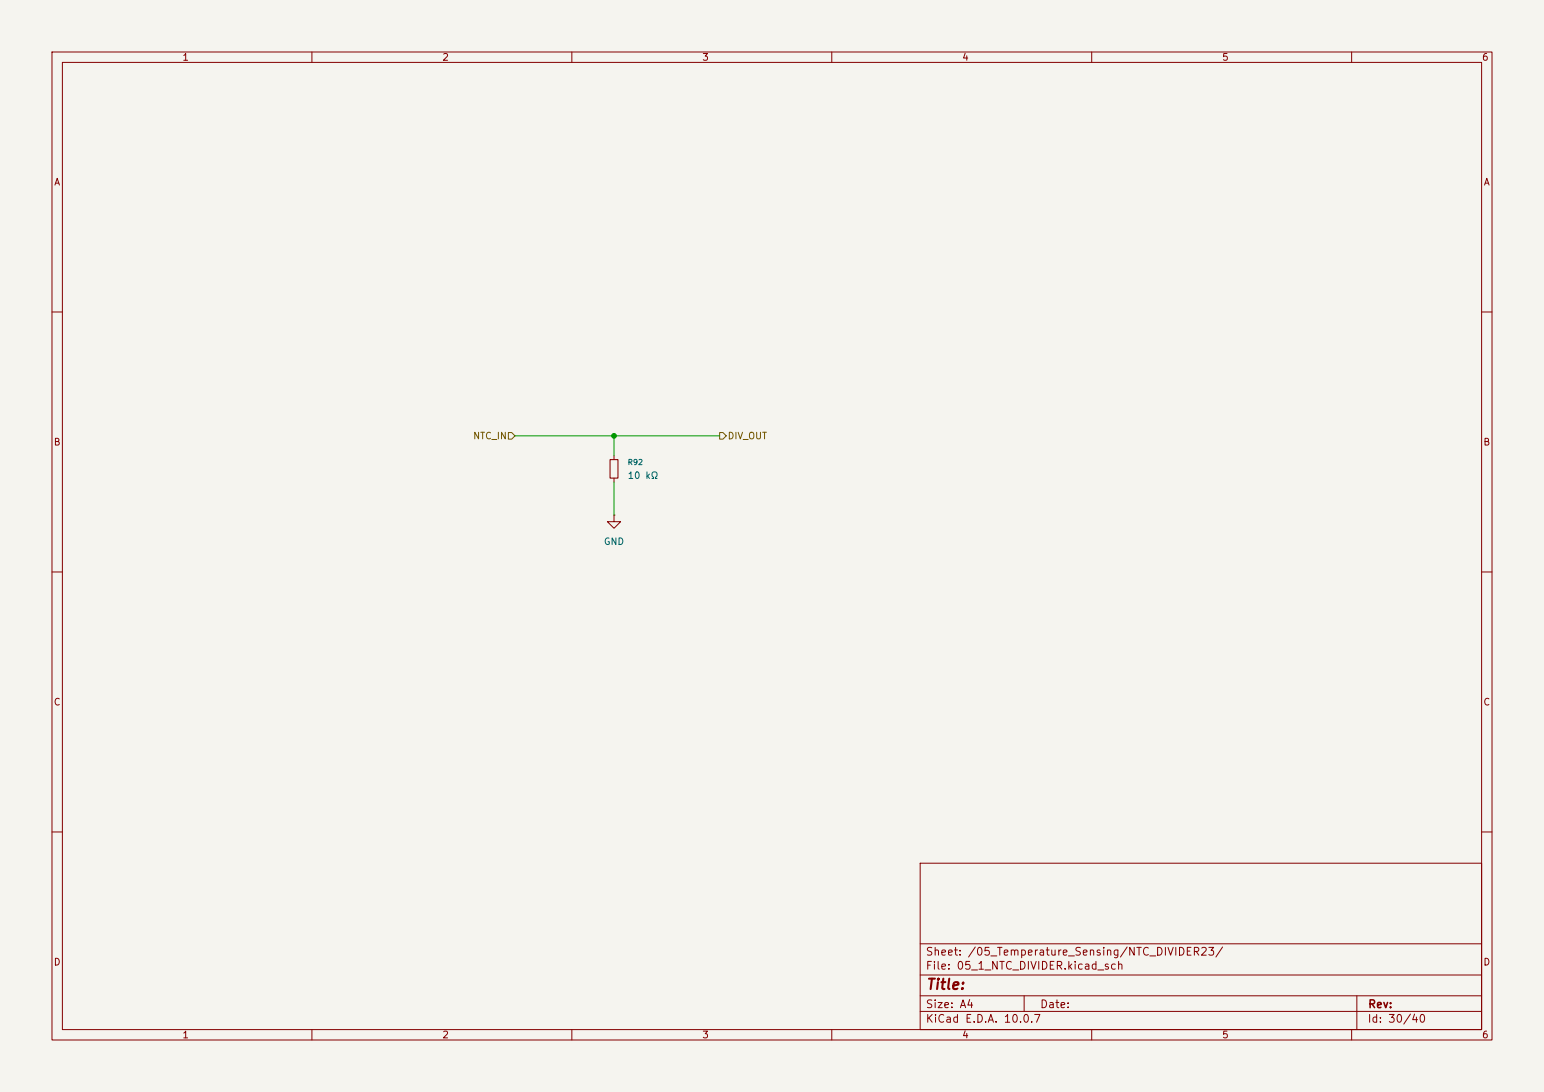
[picture p109: page 30]

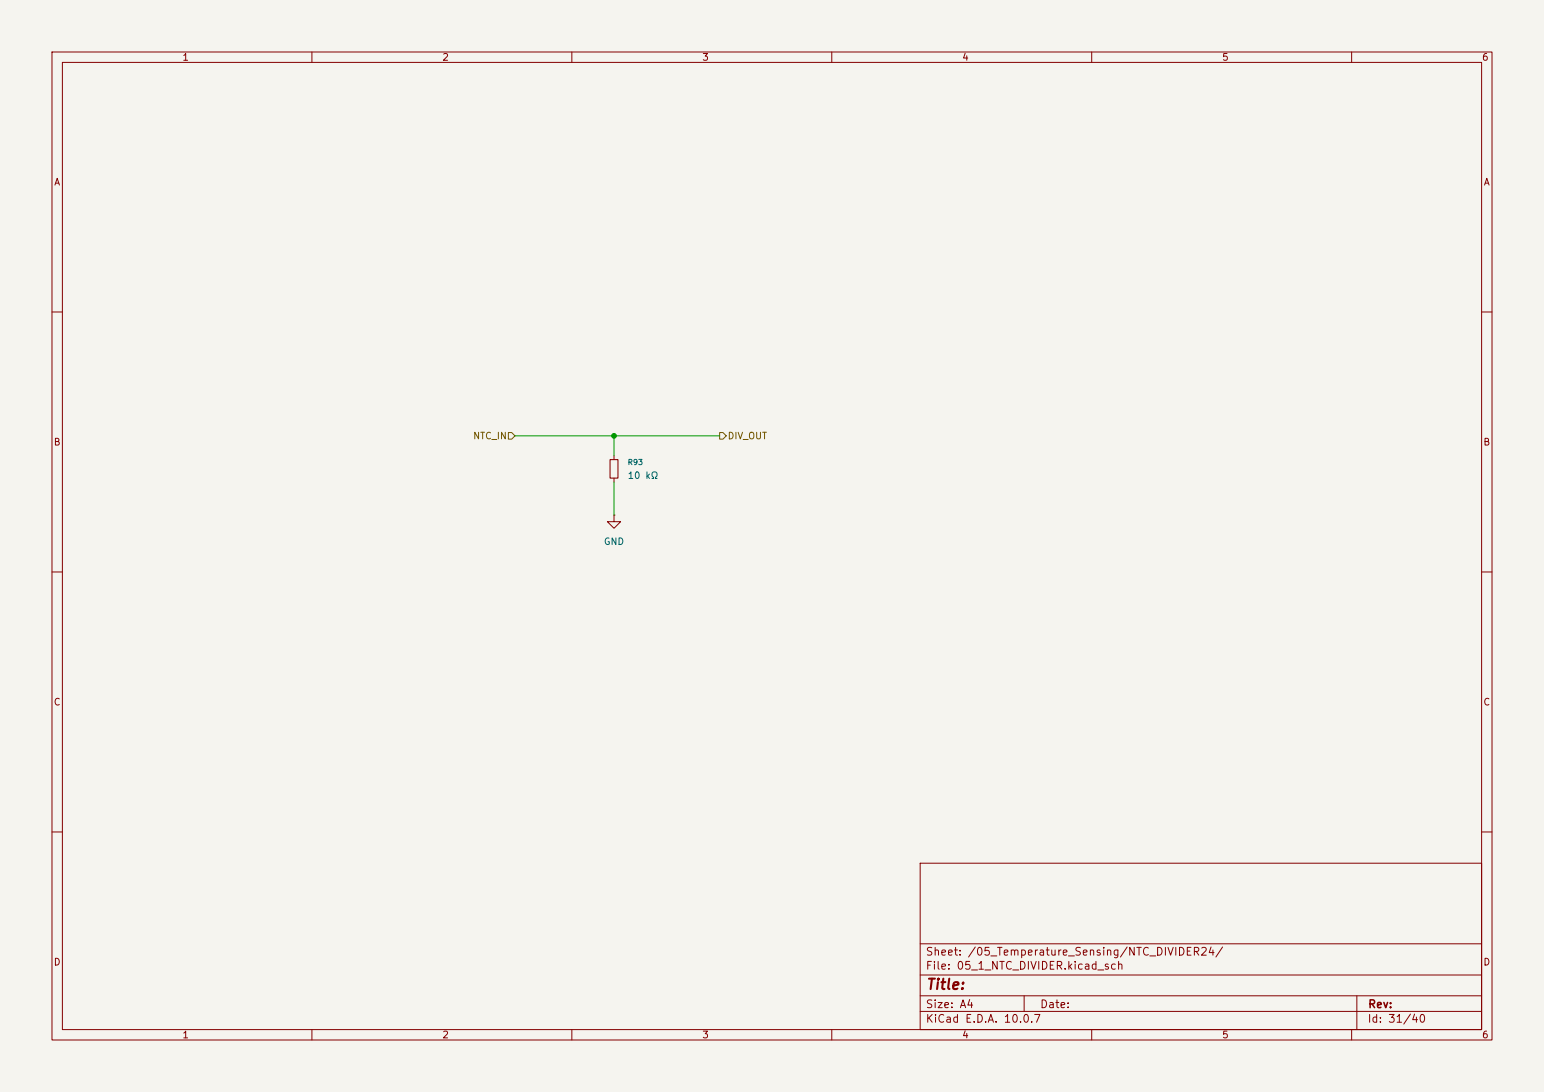
[picture p110: page 31]

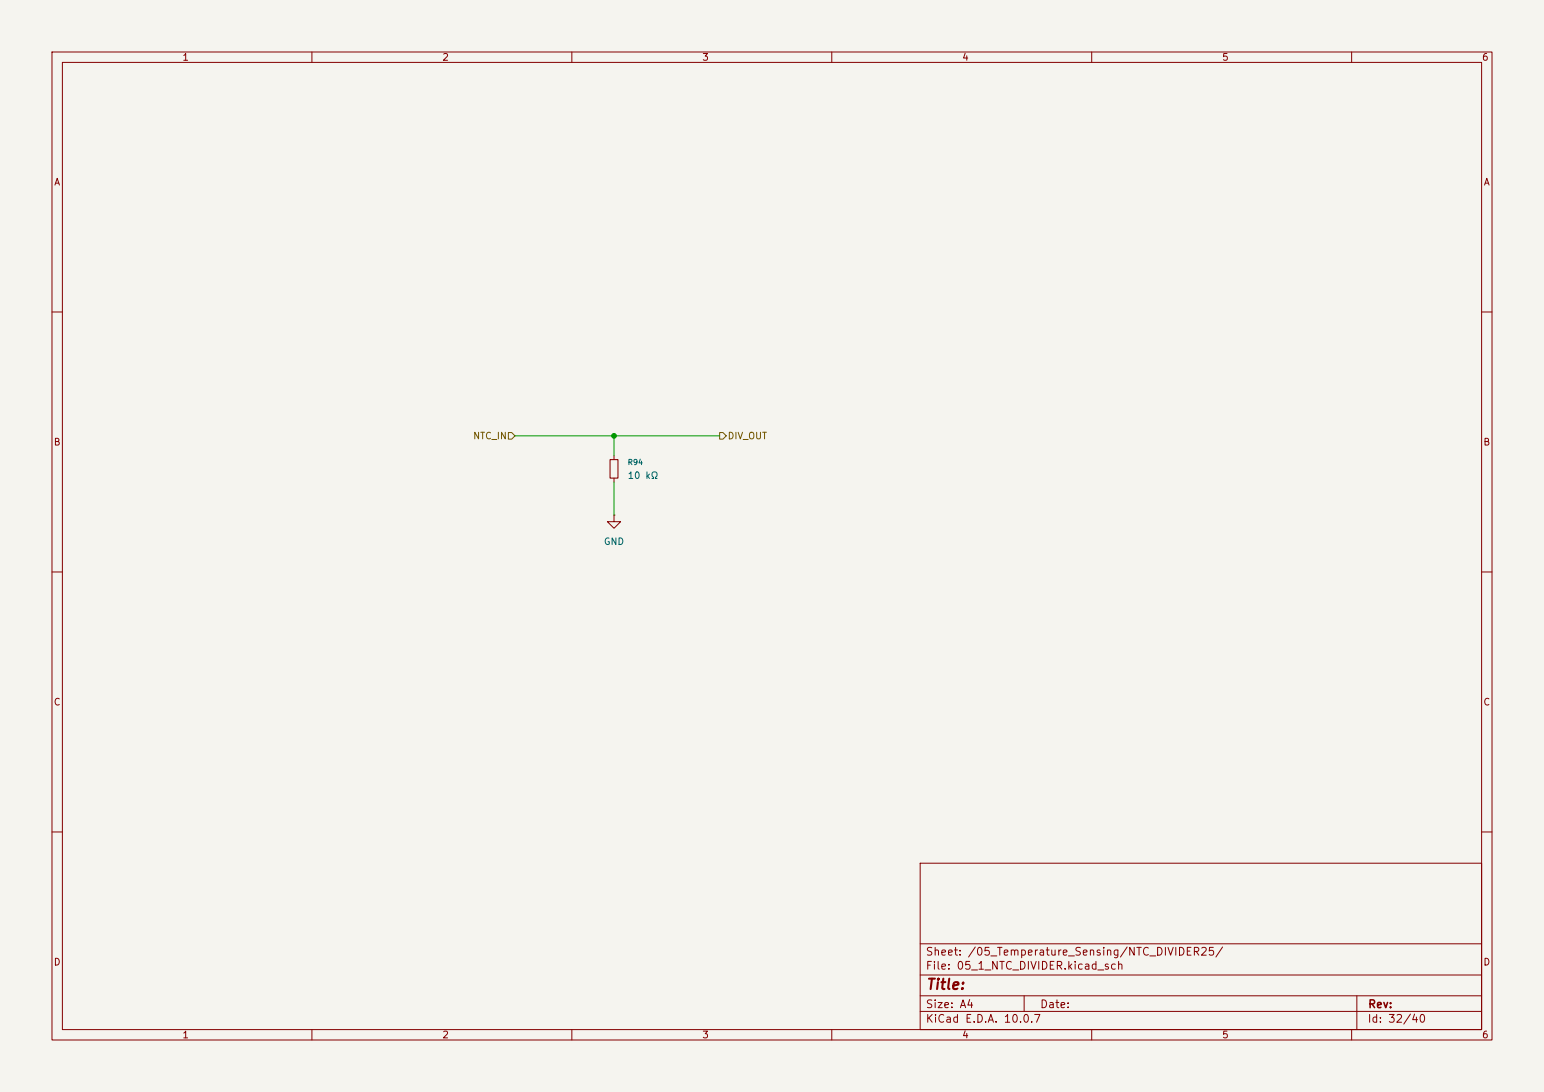
[picture p111: page 32]

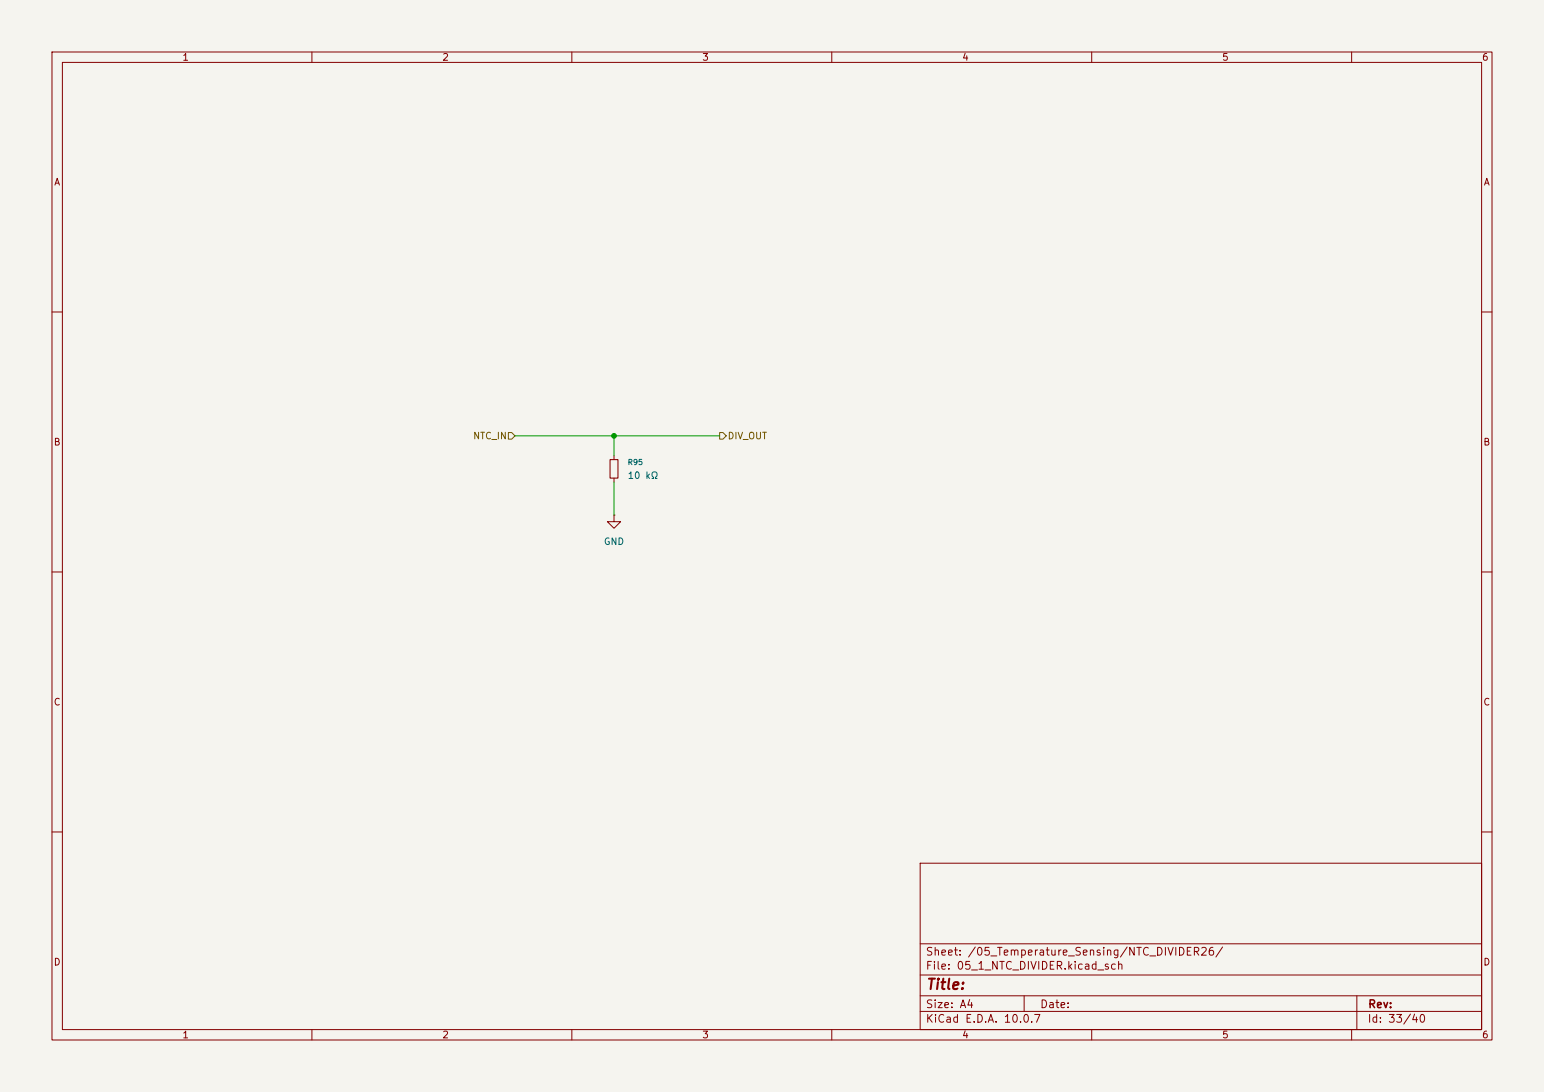
[picture p112: page 33]

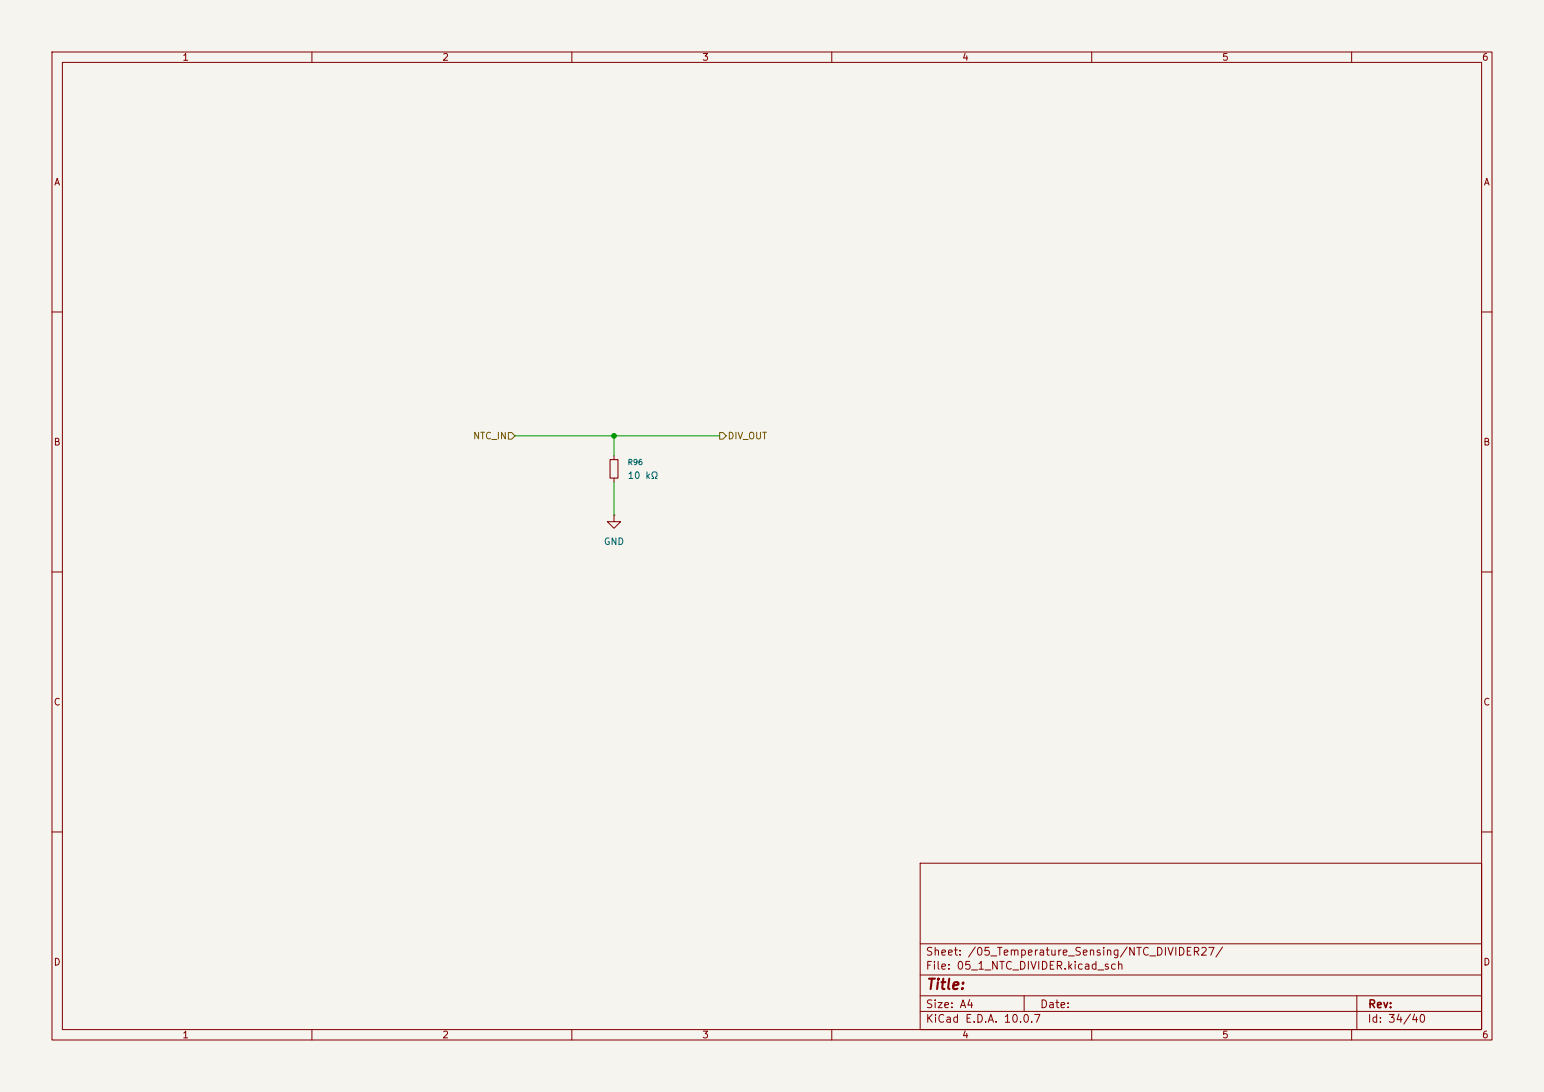
[picture p113: page 34]

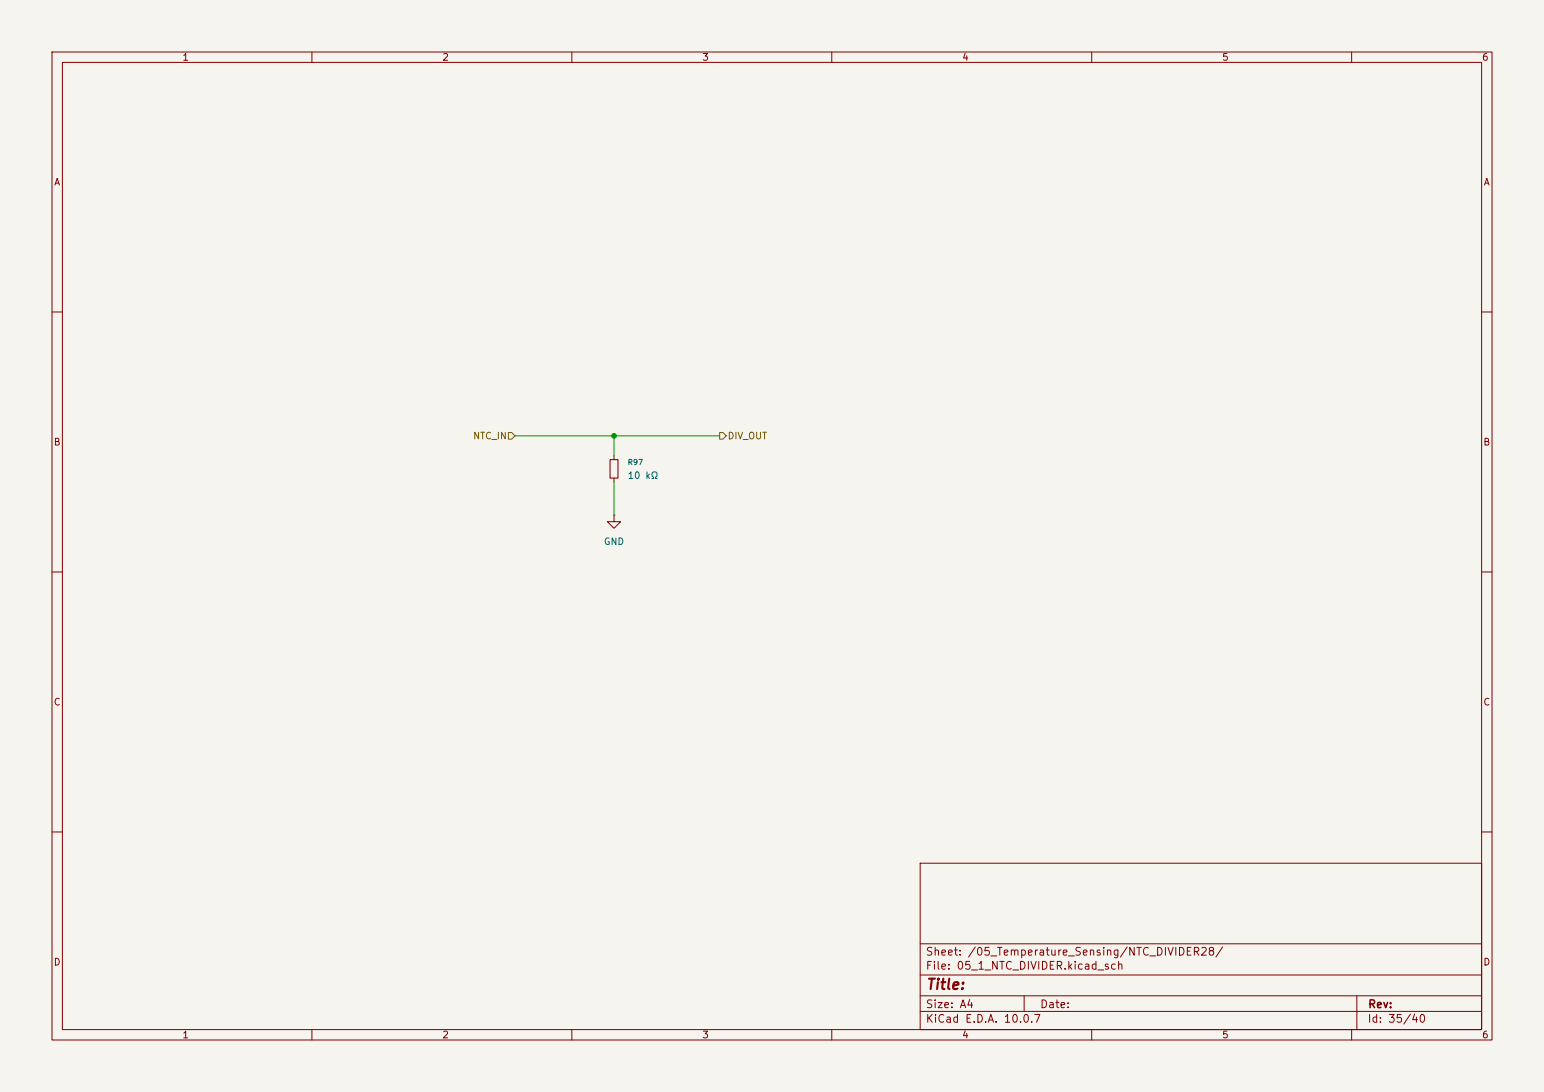
[picture p114: page 35]

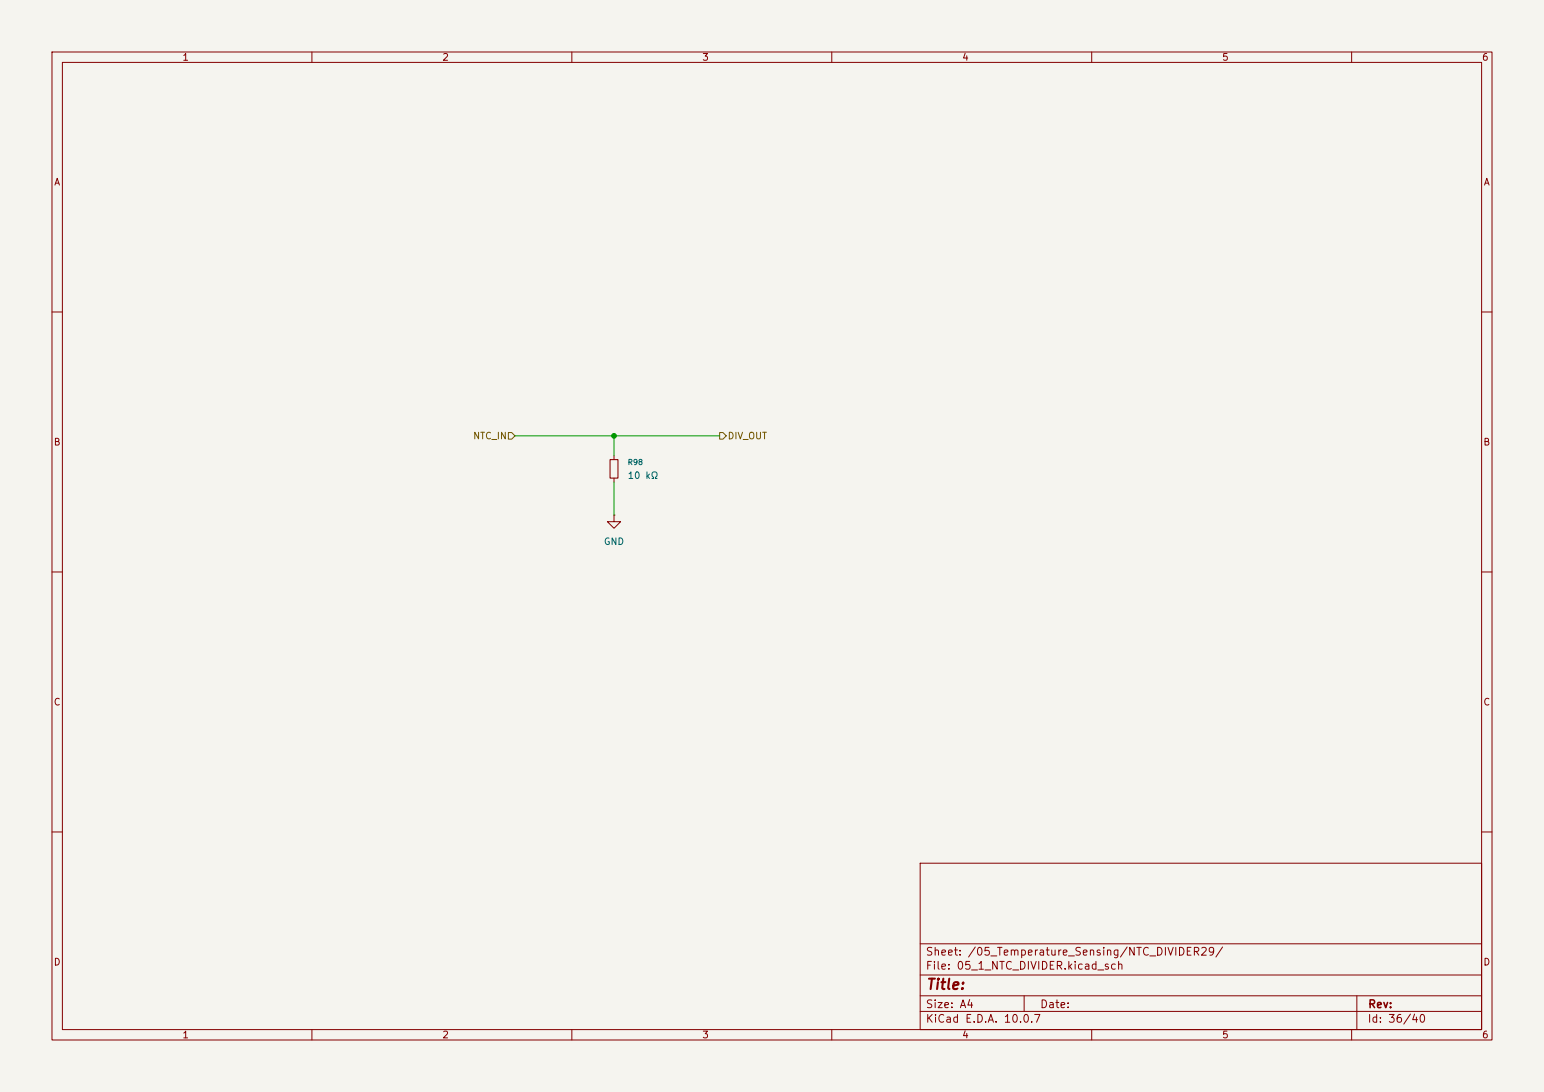
[picture p115: page 36]

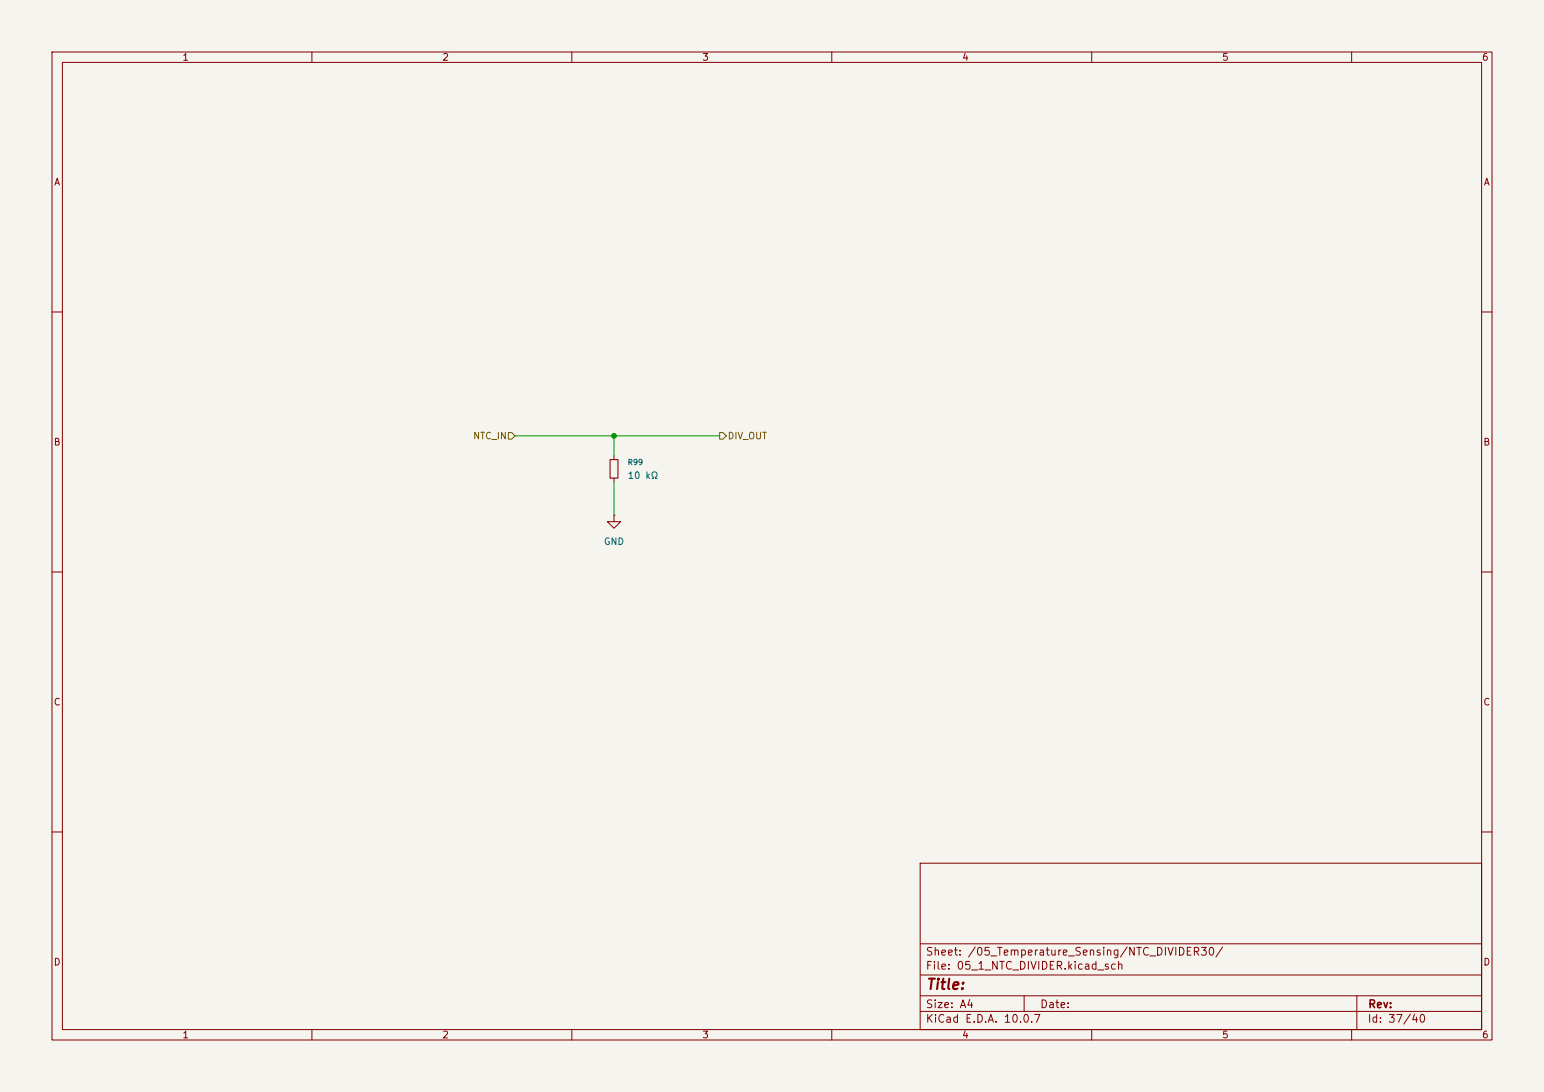
[picture p116: page 37]


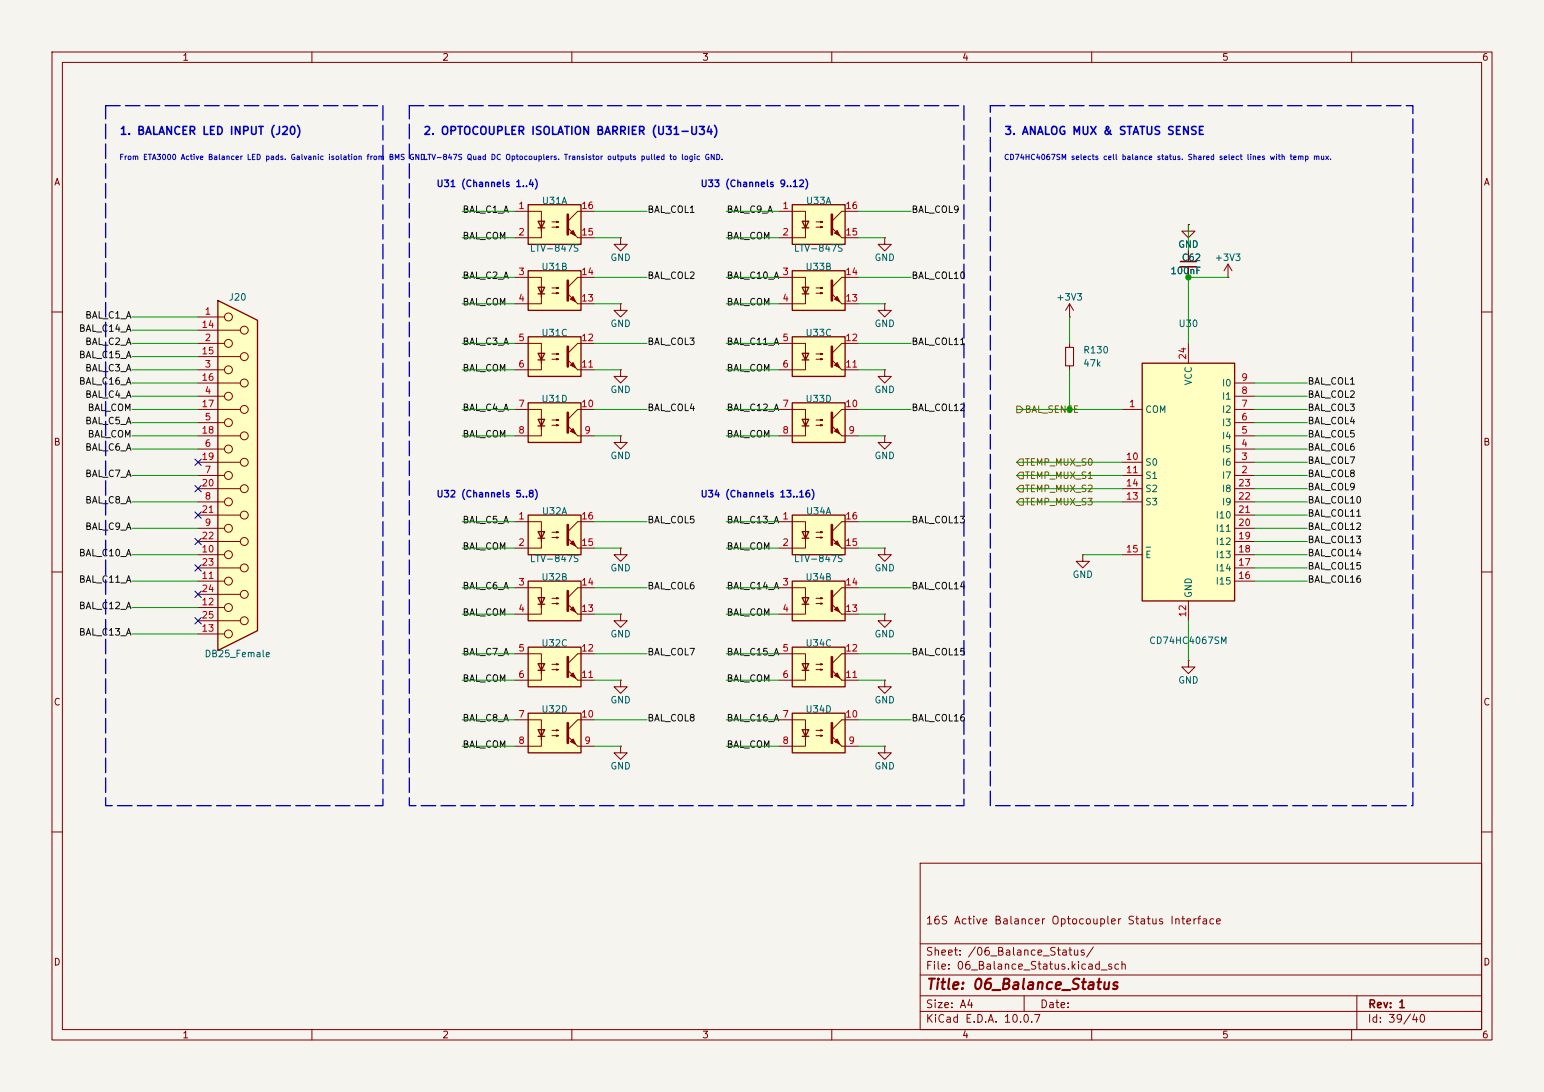
[picture p117: page 39]

LTV-847S Quad DC Optocouplers. Transistor outputs pulled to logic GND. U34 (Channels 13..16)
BAL_C1_A BAL_C4_A BAL_C3_A BAL_COM

16S Active Balancer Optocoupler Status Interface

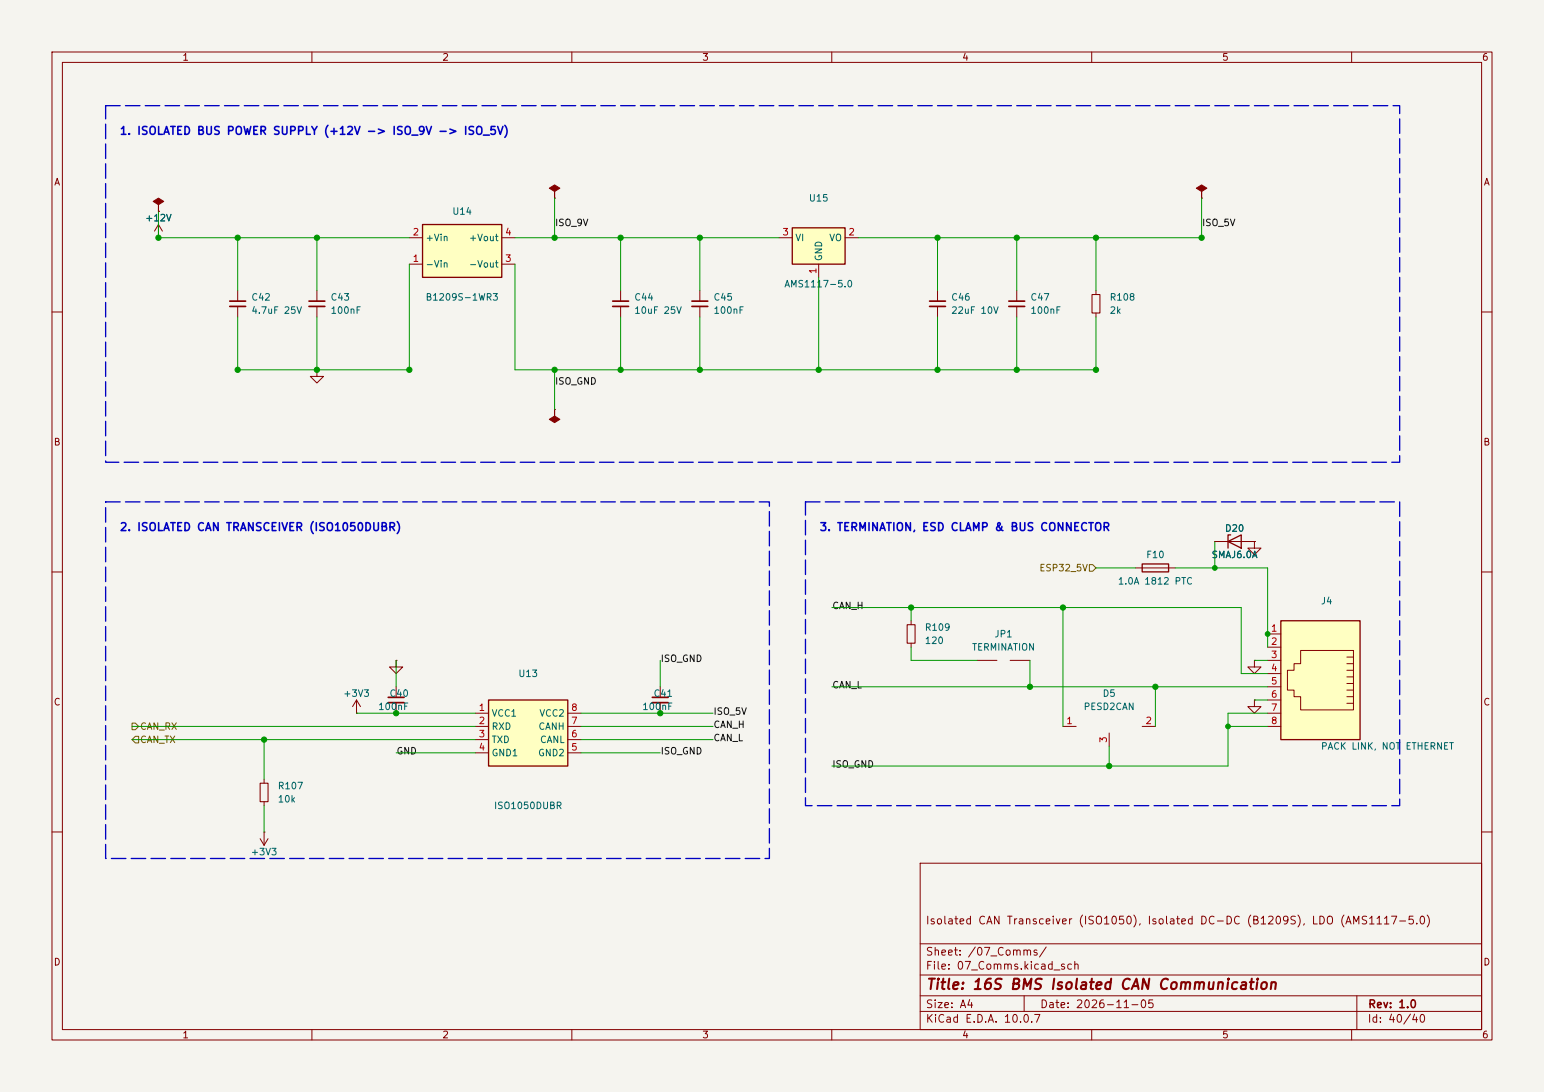
[picture p118: page 40]

1. ISOLATED BUS POWER SUPPLY (+12V -> ISO_9V -> ISO_5V)
4.7uF 25V CAN_TX CAN_RX

Isolated CAN Transceiver (ISO1050), Isolated DC-DC (B1209S), LDO (AMS1117-5.0)

Sheet: /07_Comms/
File: 07_Comms.kicad_sch
Title: 16S BMS Isolated CAN Communication
