koko69420/SmartBMS_Active-balancing/esp32_gateway/esp32_gateway.pdf

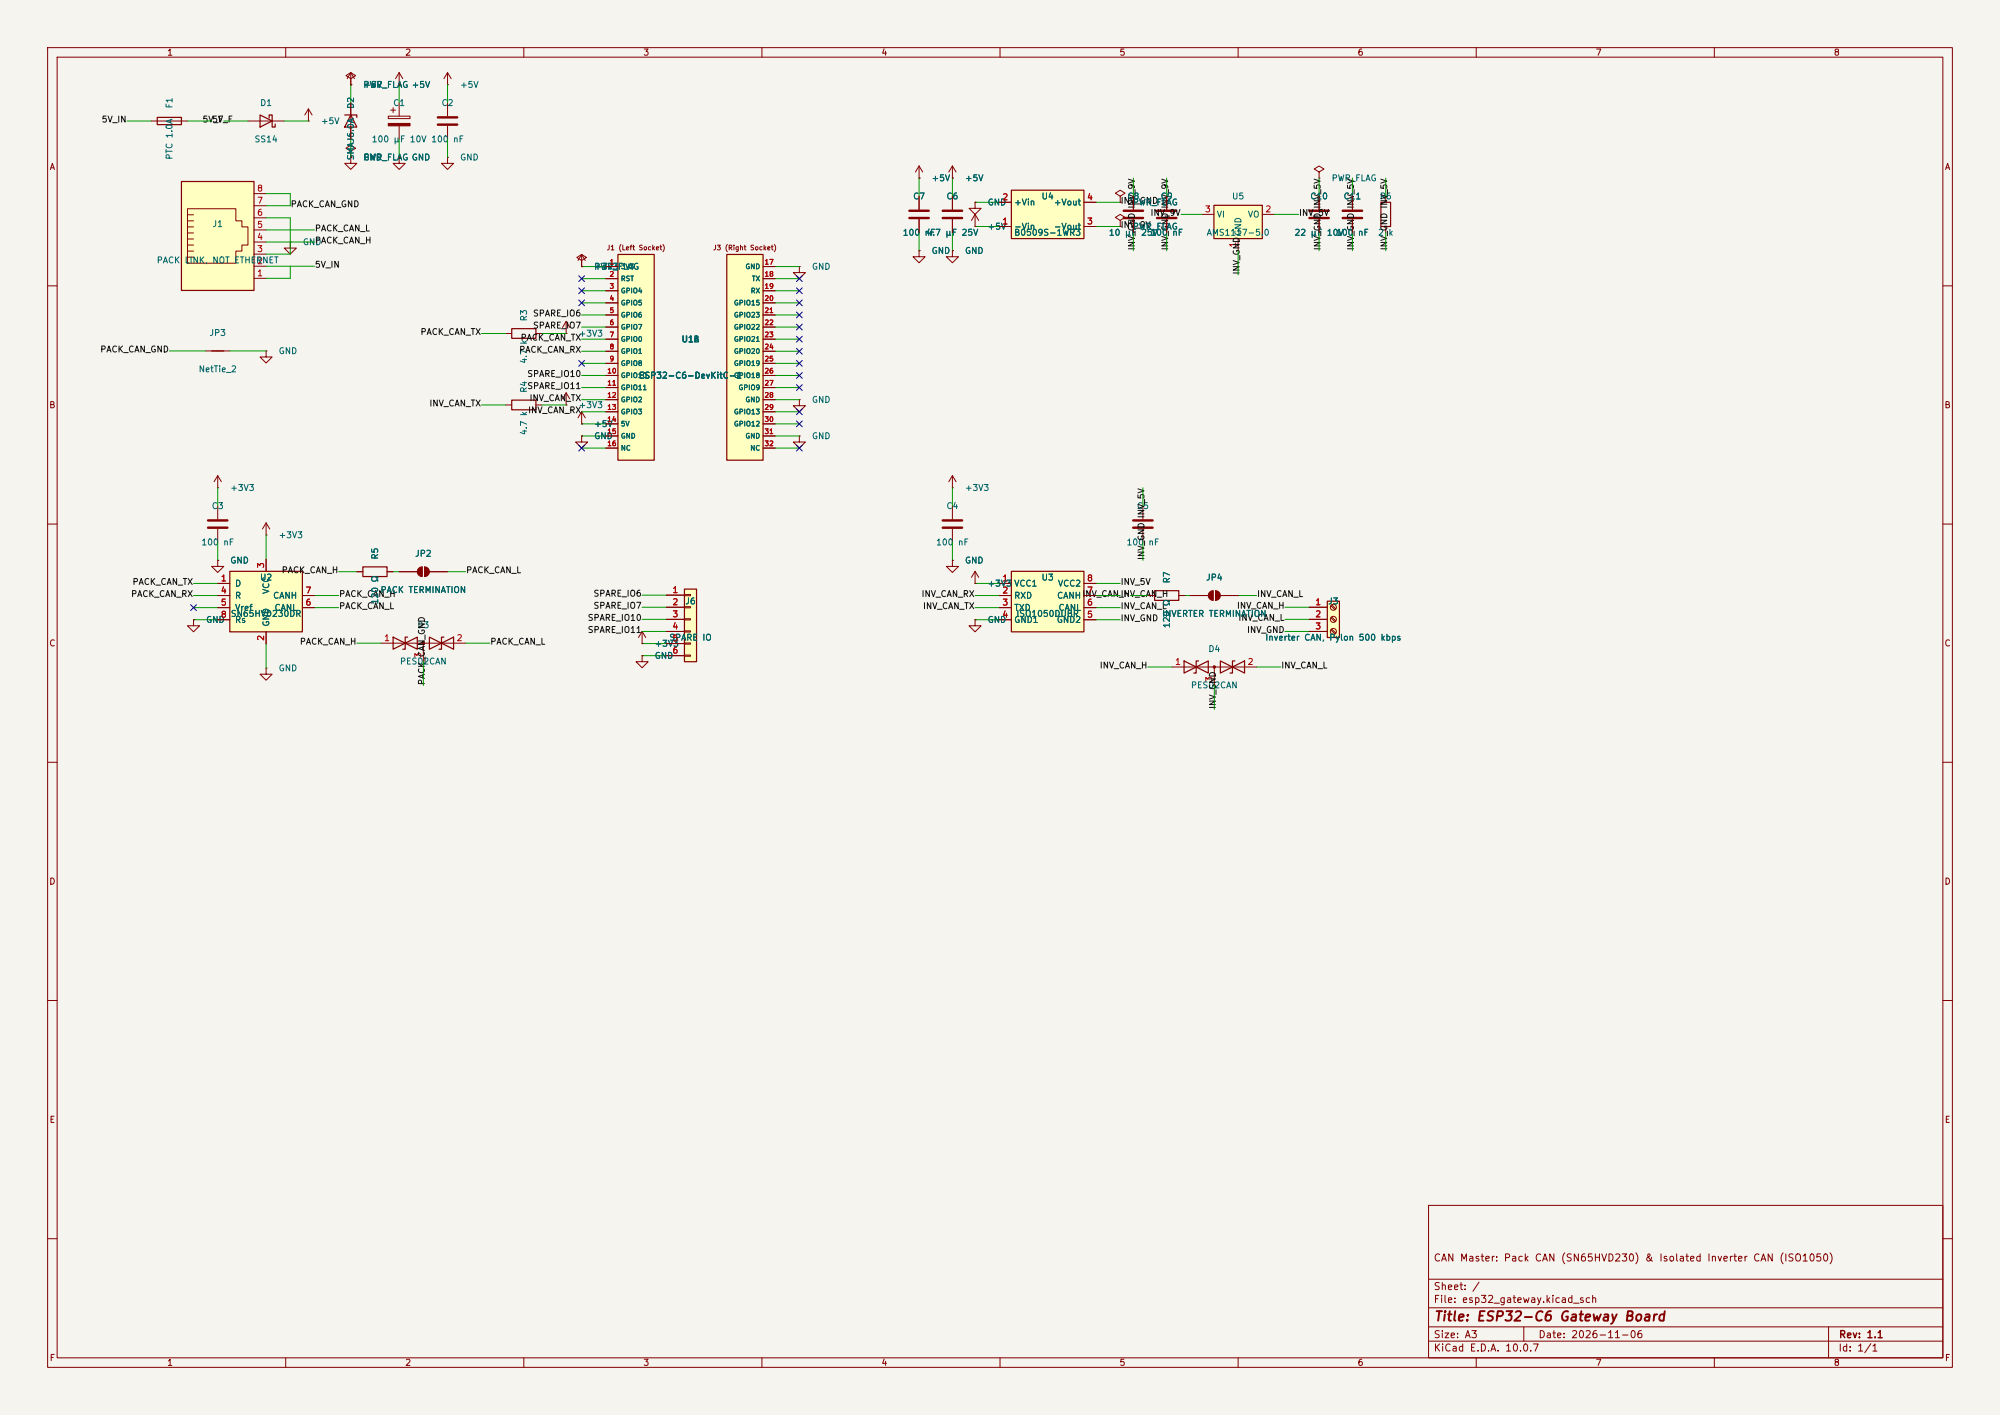
[picture p119: page 1]

Inverter CAN, Pylon 500 kbps C5

Inverter CAN, Pylon 500 kbps 1

CAN Master: Pack CAN (SN65HVD230) & Isolated Inverter CAN (ISO1050)

Size: A3 | Rev: 1.1 | F Date: 2026-11-06
KiCad E.D.A. 10.0.7 | Id: 1/1
