koko69420/SmartBMS_Active-balancing/16s_BMS/05_Tempreture_Sensing/16s_BMS-05_Temperature_Sensing.pdf

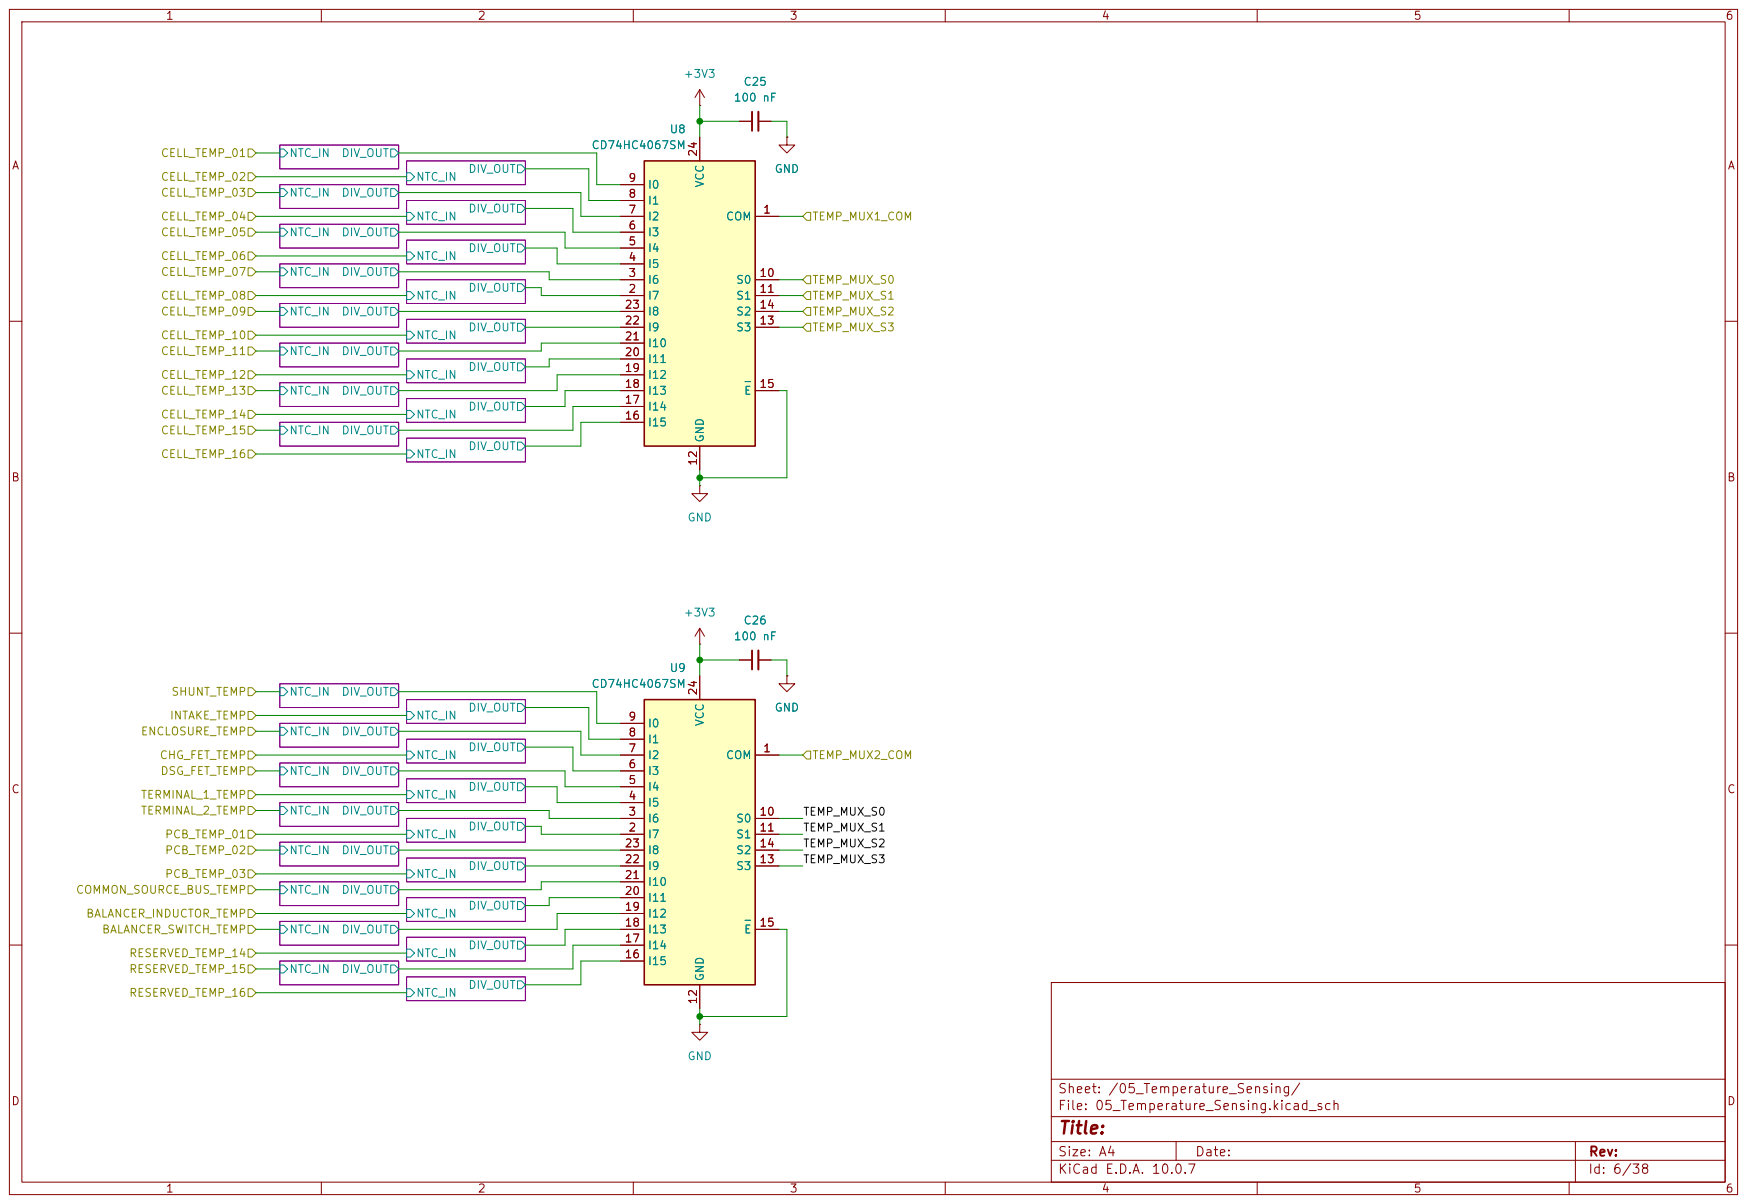
[picture p120: page 1]

Size: A4 | Rev:
KiCad E.D.A. 10.0.7 | Id: 6/38
