koko69420/SmartBMS_Active-balancing/16s_BMS/01_Cell_AFE/01_Cell_AFE.pdf

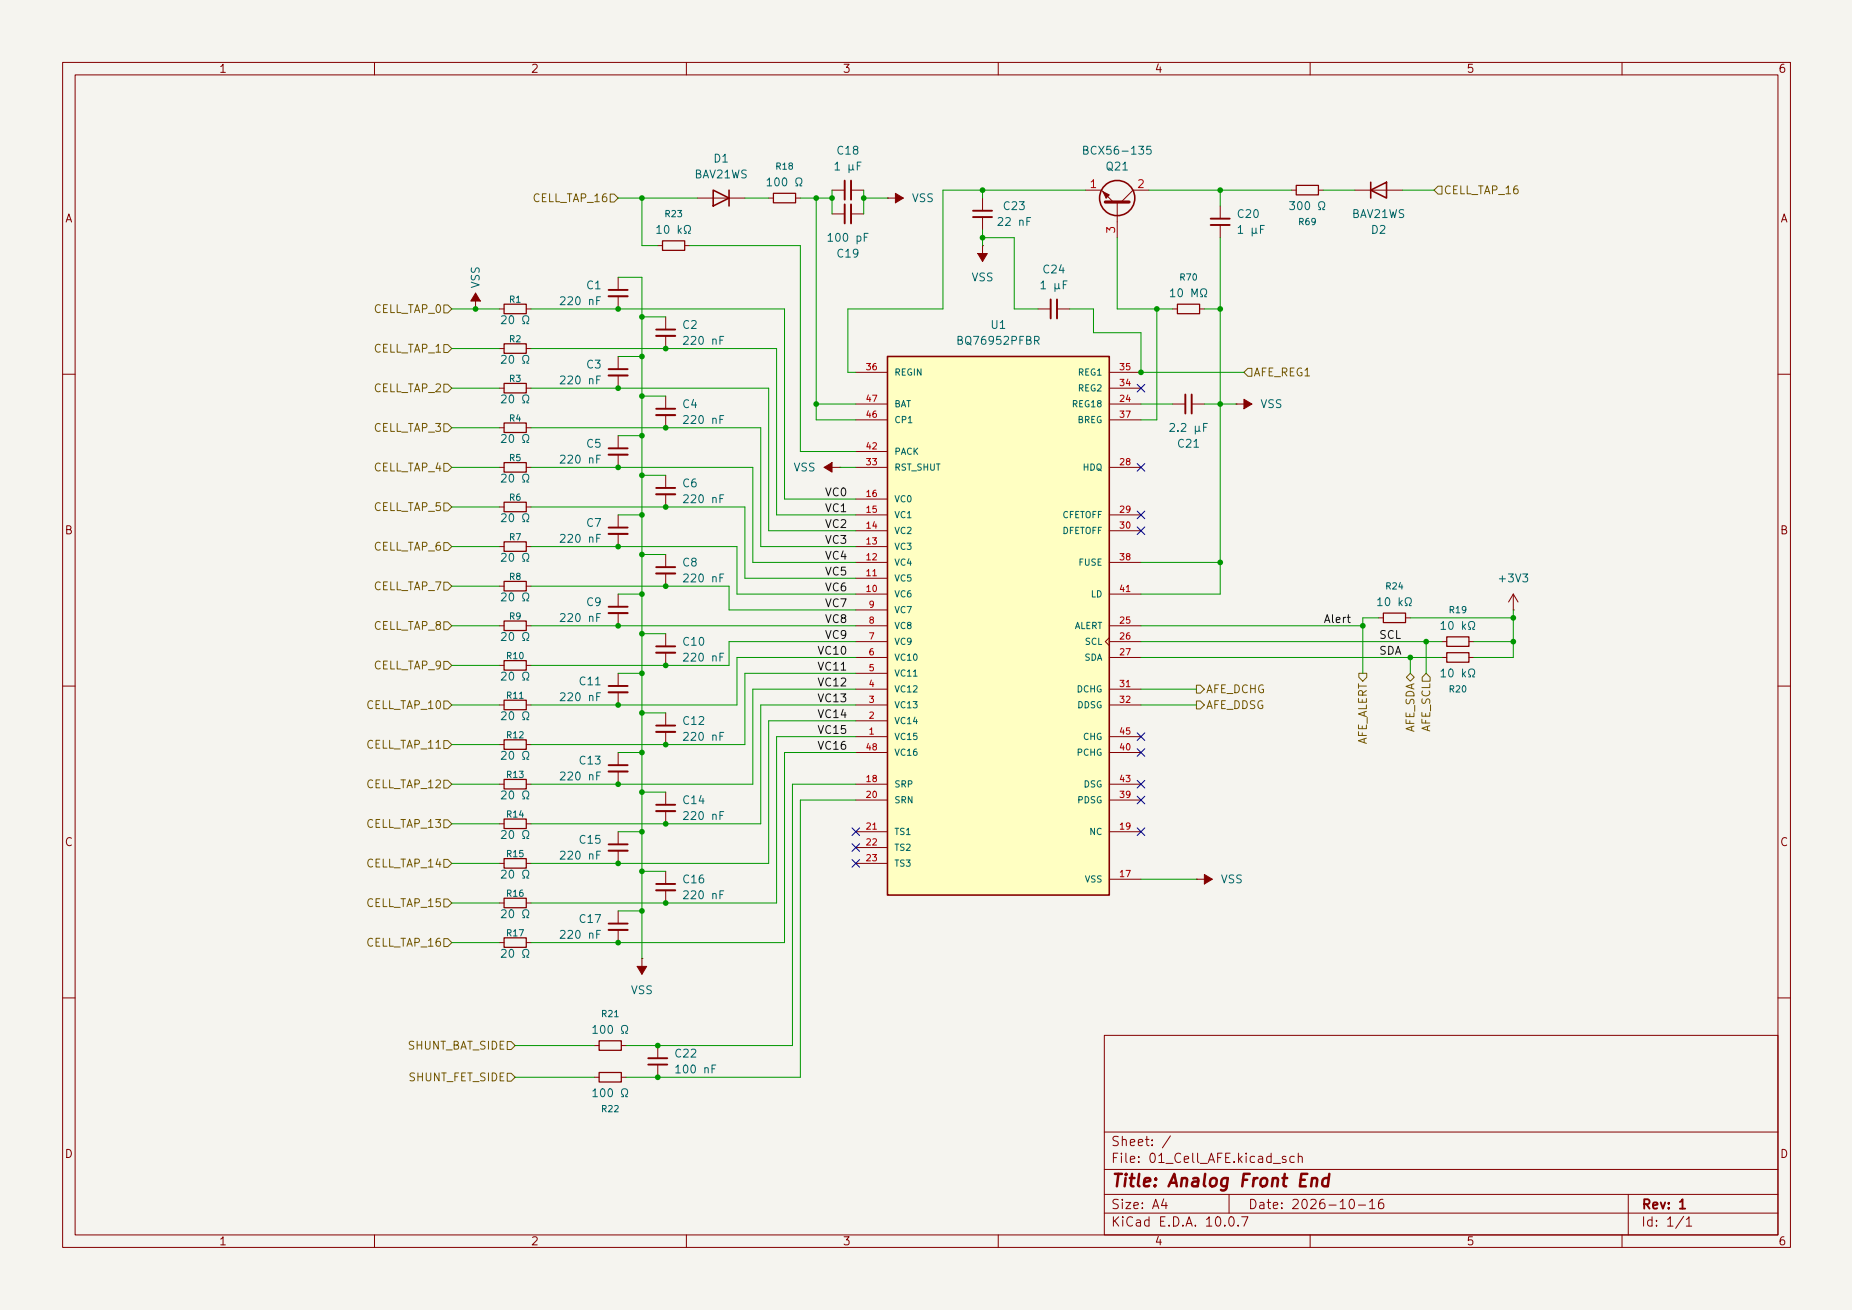
[picture p121: page 1]
