koko69420/SmartBMS_Active-balancing/16s_BMS/01_Cell_AFE.kicad_sch

## KiCad design 16s_BMS/01_Cell_AFE.kicad_sch (2026-11-05)

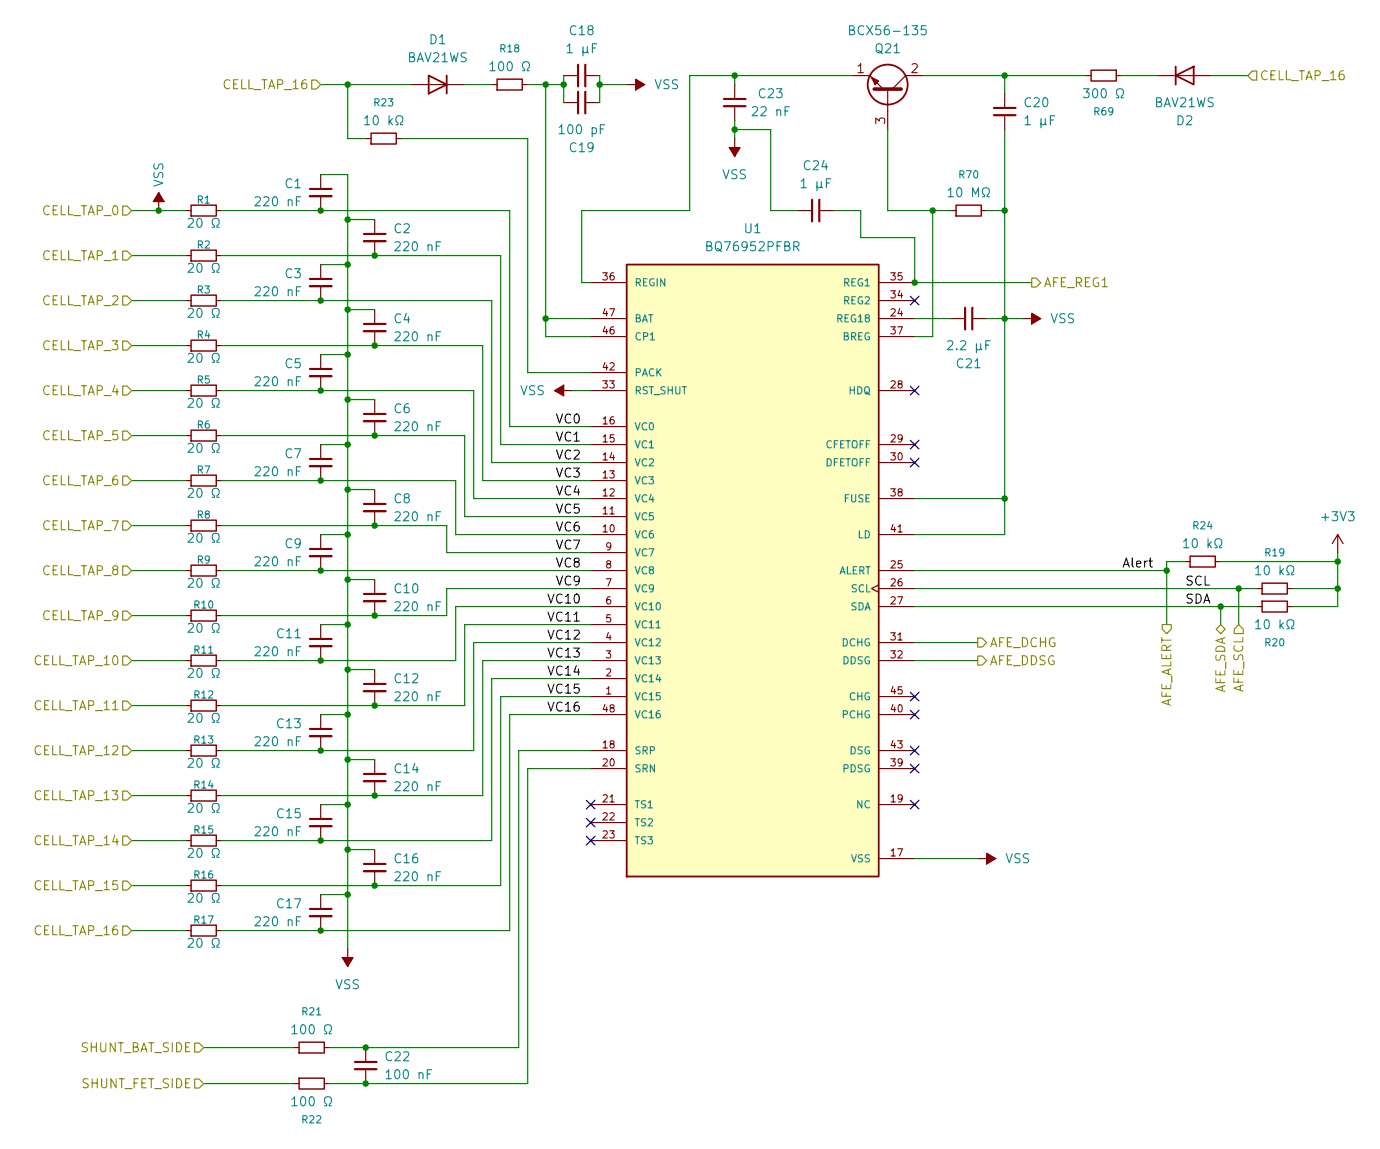
[picture p122: schematic 01_Cell_AFE.kicad_sch]

Parts:
C1, C2, C3, C4, C5, C6, C7, C8, C9, C10, C11, C12, C13, C14, C15, C16, C17: 220 nF; C_1206_3216Metric_Pad1.33x1.80mm_HandSolder
C18, C20: 1 µF; C_1812_4532Metric_Pad1.57x3.40mm_HandSolder
C19: 100 pF; C_0805_2012Metric_Pad1.18x1.45mm_HandSolder
C21: 2.2 µF; C_0805_2012Metric_Pad1.18x1.45mm_HandSolder
C22: 100 nF; C_0805_2012Metric_Pad1.18x1.45mm_HandSolder
C23: 22 nF; C_0805_2012Metric_Pad1.18x1.45mm_HandSolder
C24: 1 µF; C_0805_2012Metric_Pad1.18x1.45mm_HandSolder
D1, D2: BAV21WS; D_SOD-323_HandSoldering
Q21: BCX56-135; SOT-89-3_Handsoldering
R1, R2, R3, R4, R5, R6, R7, R8, R9, R10, R11, R12, R13, R14, R15, R16, R17: 20 Ω; R_1206_3216Metric_Pad1.30x1.75mm_HandSolder
R18, R21, R22: 100 Ω; R_1206_3216Metric_Pad1.30x1.75mm_HandSolder
R19, R20, R23, R24: 10 kΩ; R_1206_3216Metric_Pad1.30x1.75mm_HandSolder
R69: 300 Ω; R_1206_3216Metric_Pad1.30x1.75mm_HandSolder
R70: 10 MΩ; R_1206_3216Metric_Pad1.30x1.75mm_HandSolder
U1: BQ76952PFBR; QFP50P900X900X120-48N; PARTREV B

Connections:
+3V3: R19.2, R20.2, R24.2
AFE_ALERT: R24.1, U1.25 (ALERT)
AFE_DCHG: U1.31 (DCHG)
AFE_DDSG: U1.32 (DDSG)
AFE_REG1: C24.2, U1.35 (REG1)
AFE_SCL: R19.1, U1.26 (SCL)
AFE_SDA: R20.1, U1.27 (SDA)
CELL_TAP_1: R2.1
CELL_TAP_2: R3.1
CELL_TAP_3: R4.1
CELL_TAP_4: R5.1
CELL_TAP_5: R6.1
CELL_TAP_6: R7.1
CELL_TAP_7: R8.1
CELL_TAP_8: R9.1
CELL_TAP_9: R10.1
CELL_TAP_10: R11.1
CELL_TAP_11: R12.1
CELL_TAP_12: R13.1
CELL_TAP_13: R14.1
CELL_TAP_14: R15.1
CELL_TAP_15: R16.1
CELL_TAP_16: D1.2 (A), D2.2 (A), R17.1, R23.1
unnamed: C18.1, C19.1, R18.2, U1.46 (CP1), U1.47 (BAT)
unnamed: C20.2, Q21.2 (C), R69.2
unnamed: C21.1, U1.24 (REG18)
unnamed: C22.1, R22.2, U1.20 (SRN)
unnamed: C22.2, R21.2, U1.18 (SRP)
unnamed: C23.2, Q21.1 (E), U1.36 (REGIN)
unnamed: D1.1 (K), R18.1
unnamed: D2.1 (K), R69.1
unnamed: Q21.3 (B), R70.1, U1.37 (BREG)
unnamed: R23.2, U1.42 (PACK)
unnamed: U1.19 (NC), U1.44 (NC)
SHUNT_BAT_SIDE: R21.1
SHUNT_FET_SIDE: R22.1
VC0: C1.2, R1.2, U1.16 (VC0)
VC1: C2.2, R2.2, U1.15 (VC1)
VC2: C3.2, R3.2, U1.14 (VC2)
VC3: C4.2, R4.2, U1.13 (VC3)
VC4: C5.2, R5.2, U1.12 (VC4)
VC5: C6.2, R6.2, U1.11 (VC5)
VC6: C7.2, R7.2, U1.10 (VC6)
VC7: C8.2, R8.2, U1.9 (VC7)
VC8: C9.2, R9.2, U1.8 (VC8)
VC9: C10.2, R10.2, U1.7 (VC9)
VC10: C11.2, R11.2, U1.6 (VC10)
VC11: C12.2, R12.2, U1.5 (VC11)
VC12: C13.2, R13.2, U1.4 (VC12)
VC13: C14.2, R14.2, U1.3 (VC13)
VC14: C15.2, R15.2, U1.2 (VC14)
VC15: C16.2, R16.2, U1.1 (VC15)
VC16: C17.2, R17.2, U1.48 (VC16)
VSS: C1.1, C2.1, C3.1, C4.1, C5.1, C6.1, C7.1, C8.1, C9.1, C10.1, C11.1, C12.1, C13.1, C14.1, C15.1, C16.1, C17.1, C18.2, C19.2, C20.1, C21.2, C23.1, C24.1, R1.1, R70.2, U1.17 (VSS), U1.33 (RST_SHUT), U1.38 (FUSE), U1.41 (LD)
