koko69420/SmartBMS_Active-balancing/16s_BMS/02_Power_Supply.kicad_sch

## KiCad design 16s_BMS/02_Power_Supply.kicad_sch (2026-11-10, an earlier design)

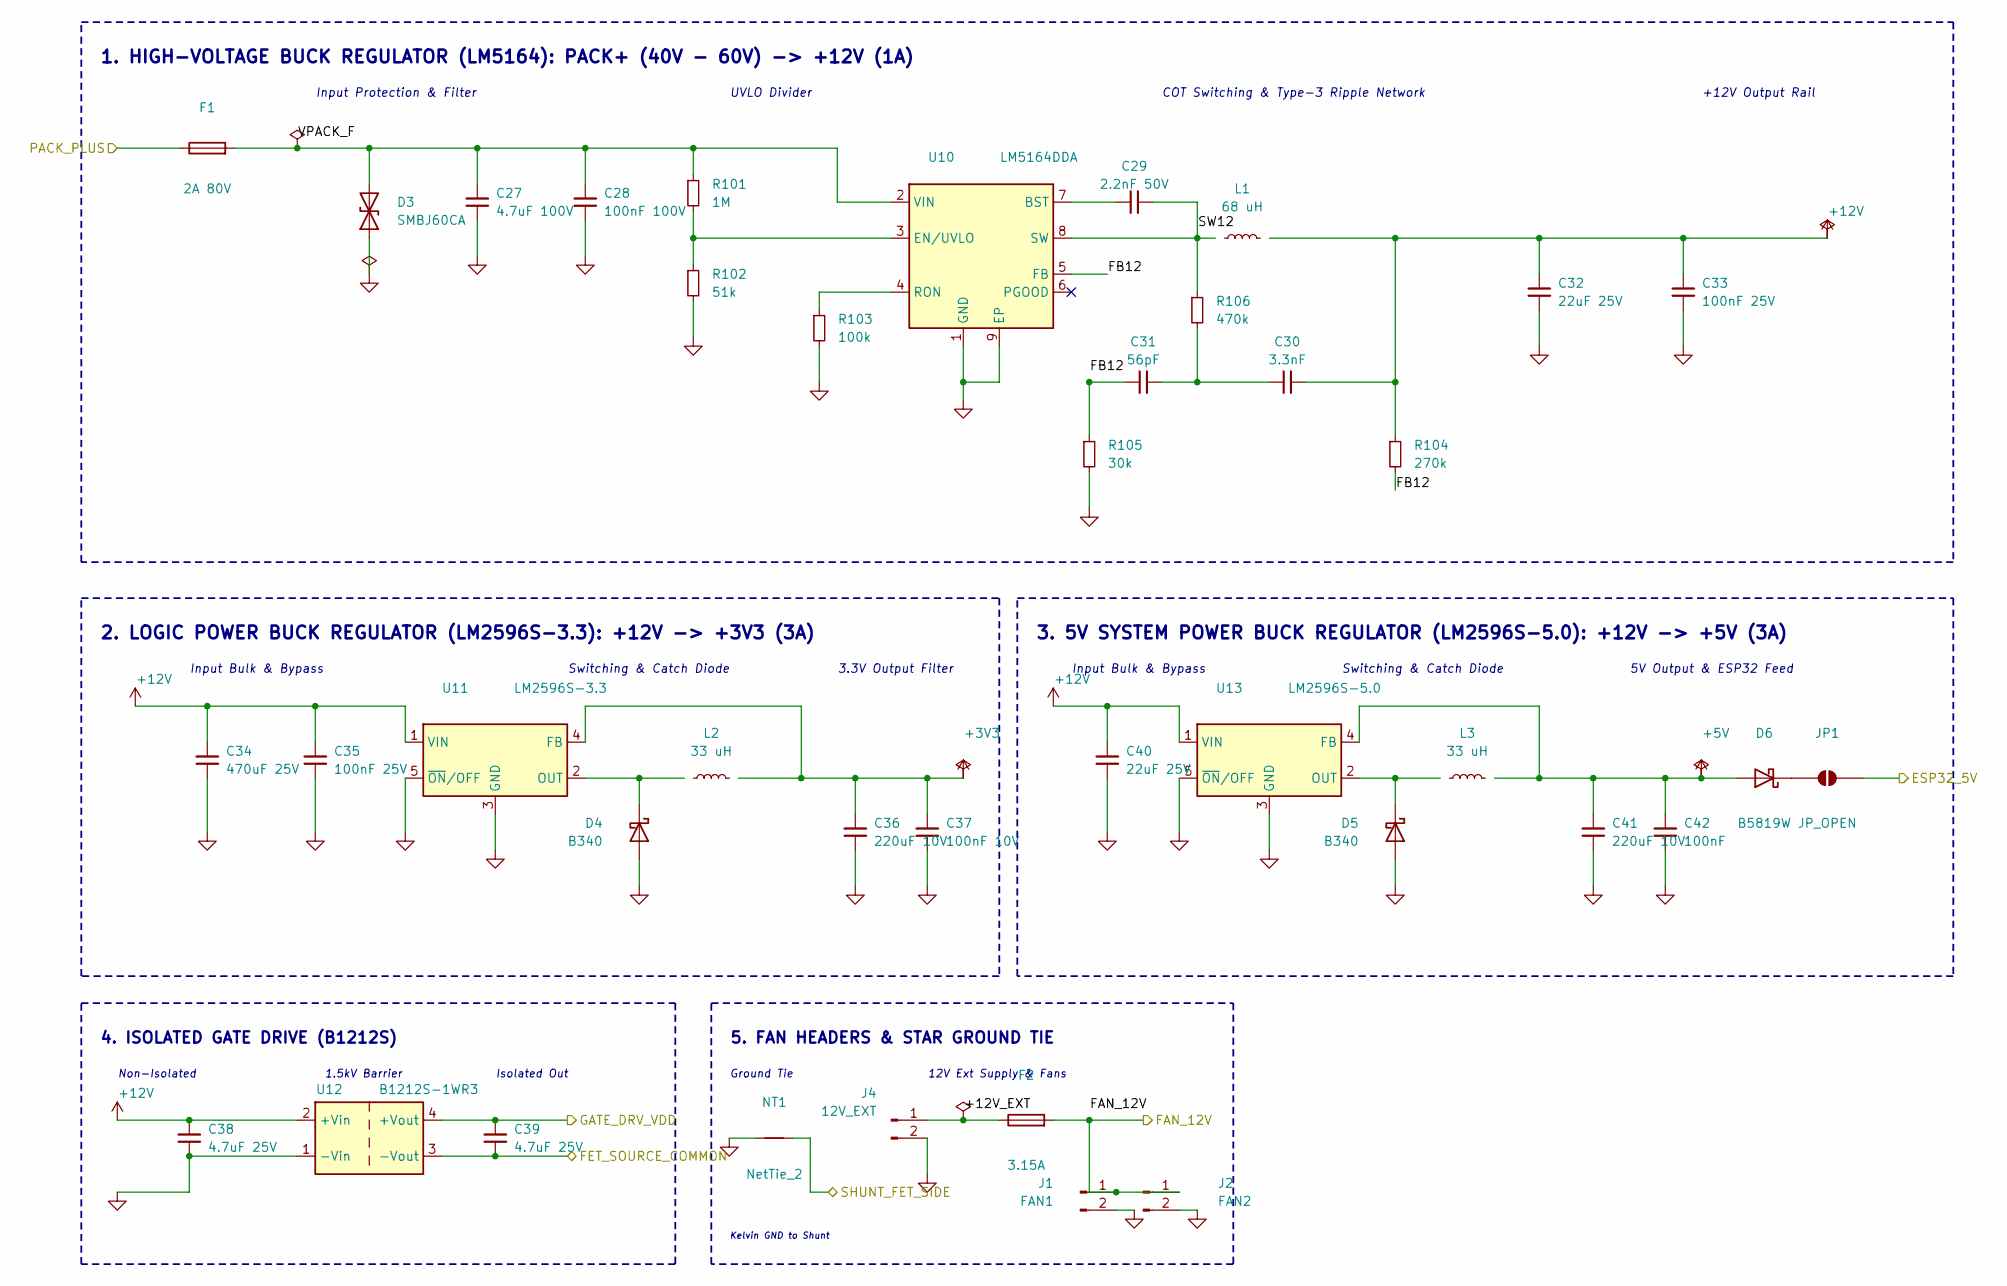
[picture p123: schematic 02_Power_Supply.kicad_sch]

Parts:
C27: 4.7uF 100V; C_1210_3225Metric
C28: 100nF 100V; C_0805_2012Metric
C29: 2.2nF 50V; C_0805_2012Metric
C30: 3.3nF; C_0805_2012Metric
C31: 56pF; C_0805_2012Metric
C32, C40: 22uF 25V; C_1206_3216Metric
C33, C35: 100nF 25V; C_0805_2012Metric
C34: 470uF 25V; CP_Elec_8x10
C36, C41: 220uF 10V; CP_Elec_8x10
C37: 100nF 10V; C_0805_2012Metric
C38, C39: 4.7uF 25V; C_0805_2012Metric
C42: 100nF; C_0805_2012Metric
D3: SMBJ60CA; D_SMB
D4, D5: B340; D_SMC
D6: B5819W; D_SMA
F1: 2A 80V; Fuse_1812_4532Metric
F2: 3.15A; Fuse_1812_4532Metric
J1: FAN1; TerminalBlock_Phoenix_MKDS-1,5-2-5.08_1x02_P5.08mm_Horizont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
J2: FAN2; TerminalBlock_Phoenix_MKDS-1,5-2-5.08_1x02_P5.08mm_Horizont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
J4: 12V_EXT; TerminalBlock_Phoenix_MKDS-1,5-2-5.08_1x02_P5.08mm_Horizont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
JP1: JP_OPEN; SolderJumper-2_P1.3mm_Open_Pad1.0x1.5mm
L1: 68 uH; L_Bourns_SRR1260
L2, L3: 33 uH; L_Bourns_SRR1260
NT1: NetTie_2; NetTie-2_SMD_Pad0.5mm
R101: 1M; R_1206_3216Metric
R102: 51k; R_0805_2012Metric
R103: 100k; R_0805_2012Metric
R104: 270k; R_0805_2012Metric
R105: 30k; R_0805_2012Metric
R106: 470k; R_0805_2012Metric
U10: LM5164DDA; HSOP-8-1EP_3.9x4.9mm_P1.27mm_EP2.41x3.1mm_ThermalVias
U11: LM2596S-3.3; TO-263-5_TabPin3
U12: B1212S-1WR3; Converter_DCDC_Murata_MEE1SxxxxSC_THT
U13: LM2596S-5.0; TO-263-5_TabPin3

Connections:
+3V3: C36.1, C37.1, U11.4 (FB)
+5V: C41.1, C42.1, D6.2 (A), U13.4 (FB)
+12V: C30.2, C32.1, C33.1, C34.1, C35.1, C38.1, C40.1, R104.1, U11.1 (VIN), U12.2 (+Vin), U13.1 (VIN)
ESP32_5V: JP1.2 (B)
FAN_12V: F2.2, J1.1, J2.1
FB12: R104.2, U10.5 (FB)
FET_SOURCE_COMMON: C39.2, U12.3 (-Vout)
GATE_DRV_VDD: C39.1, U12.4 (+Vout)
GND: C27.2, C28.2, C32.2, C33.2, C34.2, C35.2, C36.2, C37.2, C38.2, C40.2, C41.2, C42.2, D3.1 (A1), D4.2 (A), D5.2 (A), J1.2, J2.2, J4.2, NT1.1, R102.2, R103.2, R105.2, U10.1 (GND), U10.9 (EP), U11.3 (GND), U11.5 (~ON/OFF), U12.1 (-Vin), U13.3 (GND), U13.5 (~ON/OFF)
unnamed: C27.1, C28.1, D3.2 (A2), F1.2, R101.1, U10.2 (VIN)
unnamed: C29.1, U10.7 (BST)
unnamed: C30.1, C31.2, R106.2
unnamed: C31.1, R105.1
unnamed: D4.1 (K), U11.2 (OUT)
unnamed: D5.1 (K), U13.2 (OUT)
unnamed: D6.1 (K), JP1.1 (A)
unnamed: F2.1, J4.1
unnamed: R101.2, R102.1, U10.3 (EN/UVLO)
unnamed: R103.1, U10.4 (RON)
PACK_PLUS: F1.1
SHUNT_FET_SIDE: NT1.2
SW12: C29.2, R106.1, U10.8 (SW)

Notes on the sheet:
1. HIGH-VOLTAGE BUCK REGULATOR (LM5164): PACK+ (40V - 60V) -> +12V (1A)
Input Protection & Filter
UVLO Divider
COT Switching & Type-3 Ripple Network
+12V Output Rail
2. LOGIC POWER BUCK REGULATOR (LM2596S-3.3): +12V -> +3V3 (3A)
Input Bulk & Bypass
Switching & Catch Diode
3.3V Output Filter
3. 5V SYSTEM POWER BUCK REGULATOR (LM2596S-5.0): +12V -> +5V (3A)
5V Output & ESP32 Feed
4. ISOLATED GATE DRIVE (B1212S)
Non-Isolated
1.5kV Barrier
Isolated Out
5. FAN HEADERS & STAR GROUND TIE
Ground Tie
12V Ext Supply & Fans
Kelvin GND to Shunt
