koko69420/SmartBMS_Active-balancing/16s_BMS/03_MCU_Control.kicad_sch

## KiCad design 16s_BMS/03_MCU_Control.kicad_sch (2026-11-10, an earlier design)

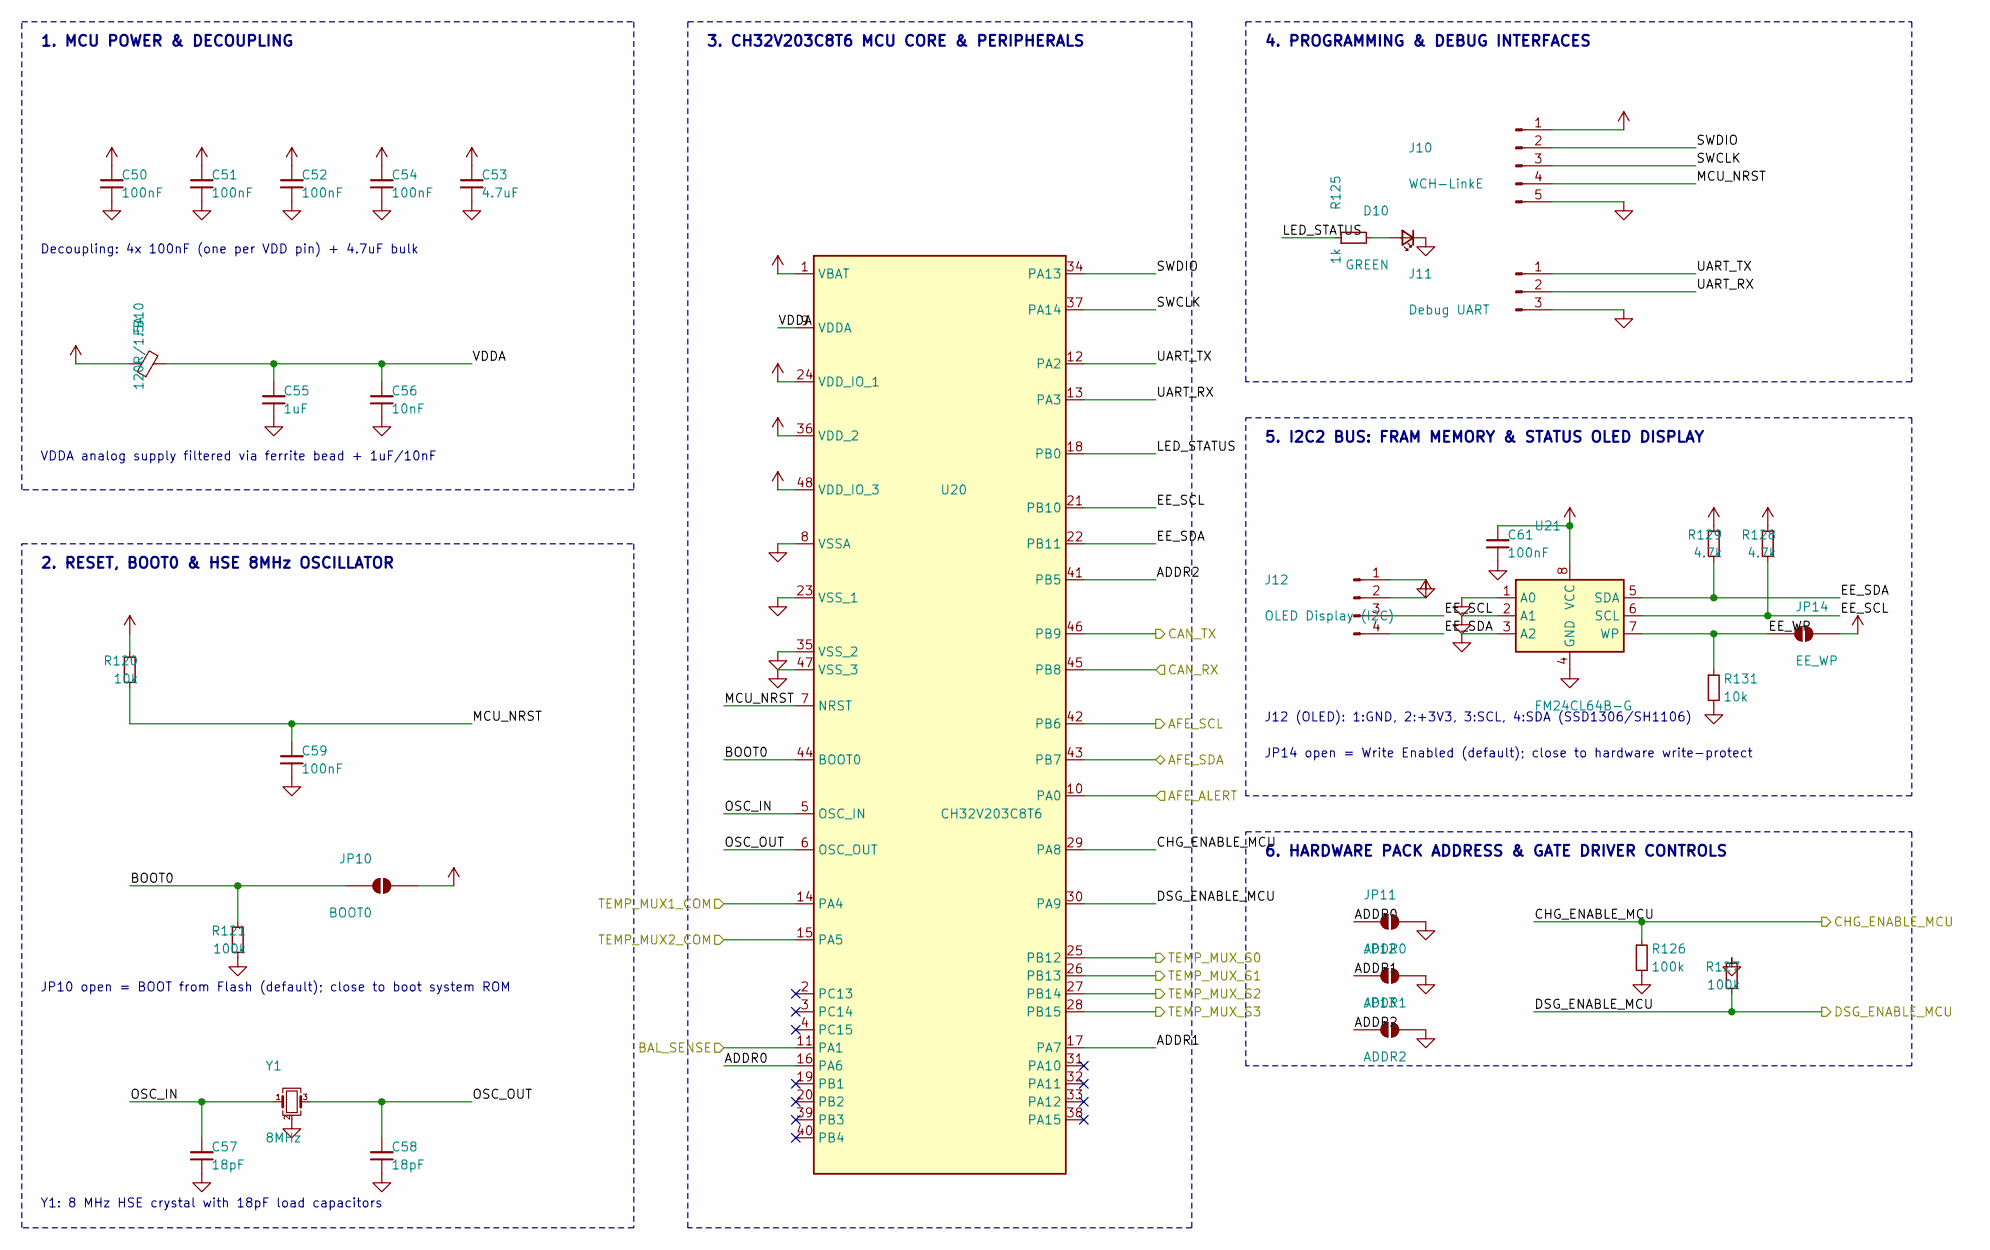
[picture p124: schematic 03_MCU_Control.kicad_sch]

Parts:
C50, C51, C52, C54, C59, C61: 100nF; C_0805_2012Metric
C53: 4.7uF; C_0805_2012Metric
C55: 1uF; C_0805_2012Metric
C56: 10nF; C_0805_2012Metric
C57, C58: 18pF; C_0805_2012Metric
D10: GREEN; LED_0805_2012Metric
FB10: 120R/1.5A; L_0805_2012Metric
J10: WCH-LinkE; PinHeader_1x05_P2.54mm_Vertical
J11: Debug UART; PinHeader_1x03_P2.54mm_Vertical
J12: OLED Display (I2C); PinHeader_1x04_P2.54mm_Vertical
JP10: BOOT0; SolderJumper-2_P1.3mm_Open_RoundedPad1.0x1.5mm
JP11: ADDR0; SolderJumper-2_P1.3mm_Open_RoundedPad1.0x1.5mm
JP12: ADDR1; SolderJumper-2_P1.3mm_Open_RoundedPad1.0x1.5mm
JP13: ADDR2; SolderJumper-2_P1.3mm_Open_RoundedPad1.0x1.5mm
JP14: EE_WP; SolderJumper-2_P1.3mm_Open_RoundedPad1.0x1.5mm
R120, R131: 10k; R_0805_2012Metric
R121, R126, R127: 100k; R_0805_2012Metric
R125: 1k; R_0805_2012Metric
R128, R129: 4.7k; R_0805_2012Metric
U20: CH32V203C8T6; LQFP-48_7x7mm_P0.5mm
U21: FM24CL64B-G; SOIC-8_3.9x4.9mm_P1.27mm
Y1: 8MHz; Crystal_SMD_3225-4Pin_3.2x2.5mm

Connections:
+3V3: C50.1, C51.1, C52.1, C53.1, C54.1, C61.1, FB10.1, J10.1, J12.2, JP10.1 (A), JP14.2 (B), R120.2, R128.2, R129.2, U20.1 (VBAT), U20.24 (VDD_IO_1), U20.36 (VDD_2), U20.48 (VDD_IO_3), U21.8 (VCC)
ADDR0: JP11.1 (A), U20.16 (PA6)
ADDR1: JP12.1 (A), U20.17 (PA7)
ADDR2: JP13.1 (A), U20.41 (PB5)
AFE_ALERT: U20.10 (PA0)
AFE_SCL: U20.42 (PB6)
AFE_SDA: U20.43 (PB7)
BAL_SENSE: U20.11 (PA1)
BOOT0: JP10.2 (B), R121.2, U20.44 (BOOT0)
CAN_RX: U20.45 (PB8)
CAN_TX: U20.46 (PB9)
CHG_ENABLE_MCU: R126.1, U20.29 (PA8)
DSG_ENABLE_MCU: R127.1, U20.30 (PA9)
EE_SCL: J12.3, R128.1, U20.21 (PB10), U21.6 (SCL)
EE_SDA: J12.4, R129.1, U20.22 (PB11), U21.5 (SDA)
EE_WP: JP14.1 (A), R131.1, U21.7 (WP)
GND: C50.2, C51.2, C52.2, C53.2, C54.2, C55.2, C56.2, C57.2, C58.2, C59.2, C61.2, D10.1 (K), J10.5, J11.3, J12.1, JP11.2 (B), JP12.2 (B), JP13.2 (B), R121.1, R126.2, R127.2, R131.2, U20.8 (VSSA), U20.23 (VSS_1), U20.35 (VSS_2), U20.47 (VSS_3), U21.1 (A0), U21.2 (A1), U21.3 (A2), U21.4 (GND), Y1.2 (G), Y1.4 (G)
LED_STATUS: R125.1, U20.18 (PB0)
MCU_NRST: C59.1, J10.4, R120.1, U20.7 (NRST)
unnamed: D10.2 (A), R125.2
OSC_IN: C57.1, U20.5 (OSC_IN), Y1.1
OSC_OUT: C58.1, U20.6 (OSC_OUT), Y1.3
SWCLK: J10.3, U20.37 (PA14)
SWDIO: J10.2, U20.34 (PA13)
TEMP_MUX1_COM: U20.14 (PA4)
TEMP_MUX2_COM: U20.15 (PA5)
TEMP_MUX_S0: U20.25 (PB12)
TEMP_MUX_S1: U20.26 (PB13)
TEMP_MUX_S2: U20.27 (PB14)
TEMP_MUX_S3: U20.28 (PB15)
UART_RX: J11.2, U20.13 (PA3)
UART_TX: J11.1, U20.12 (PA2)
VDDA: C55.1, C56.1, FB10.2, U20.9 (VDDA)

Notes on the sheet:
1. MCU POWER & DECOUPLING
Decoupling: 4x 100nF (one per VDD pin) + 4.7uF bulk
VDDA analog supply filtered via ferrite bead + 1uF/10nF
2. RESET, BOOT0 & HSE 8MHz OSCILLATOR
JP10 open = BOOT from Flash (default); close to boot system ROM
Y1: 8 MHz HSE crystal with 18pF load capacitors
3. CH32V203C8T6 MCU CORE & PERIPHERALS
4. PROGRAMMING & DEBUG INTERFACES
5. I2C2 BUS: FRAM MEMORY & STATUS OLED DISPLAY
J12 (OLED): 1:GND, 2:+3V3, 3:SCL, 4:SDA (SSD1306/SH1106)
JP14 open = Write Enabled (default); close to hardware write-protect
6. HARDWARE PACK ADDRESS & GATE DRIVER CONTROLS
