koko69420/SmartBMS_Active-balancing/16s_BMS/04_Current_Switching.kicad_sch

## KiCad design 16s_BMS/04_Current_Switching.kicad_sch (2026-11-10, an earlier design)

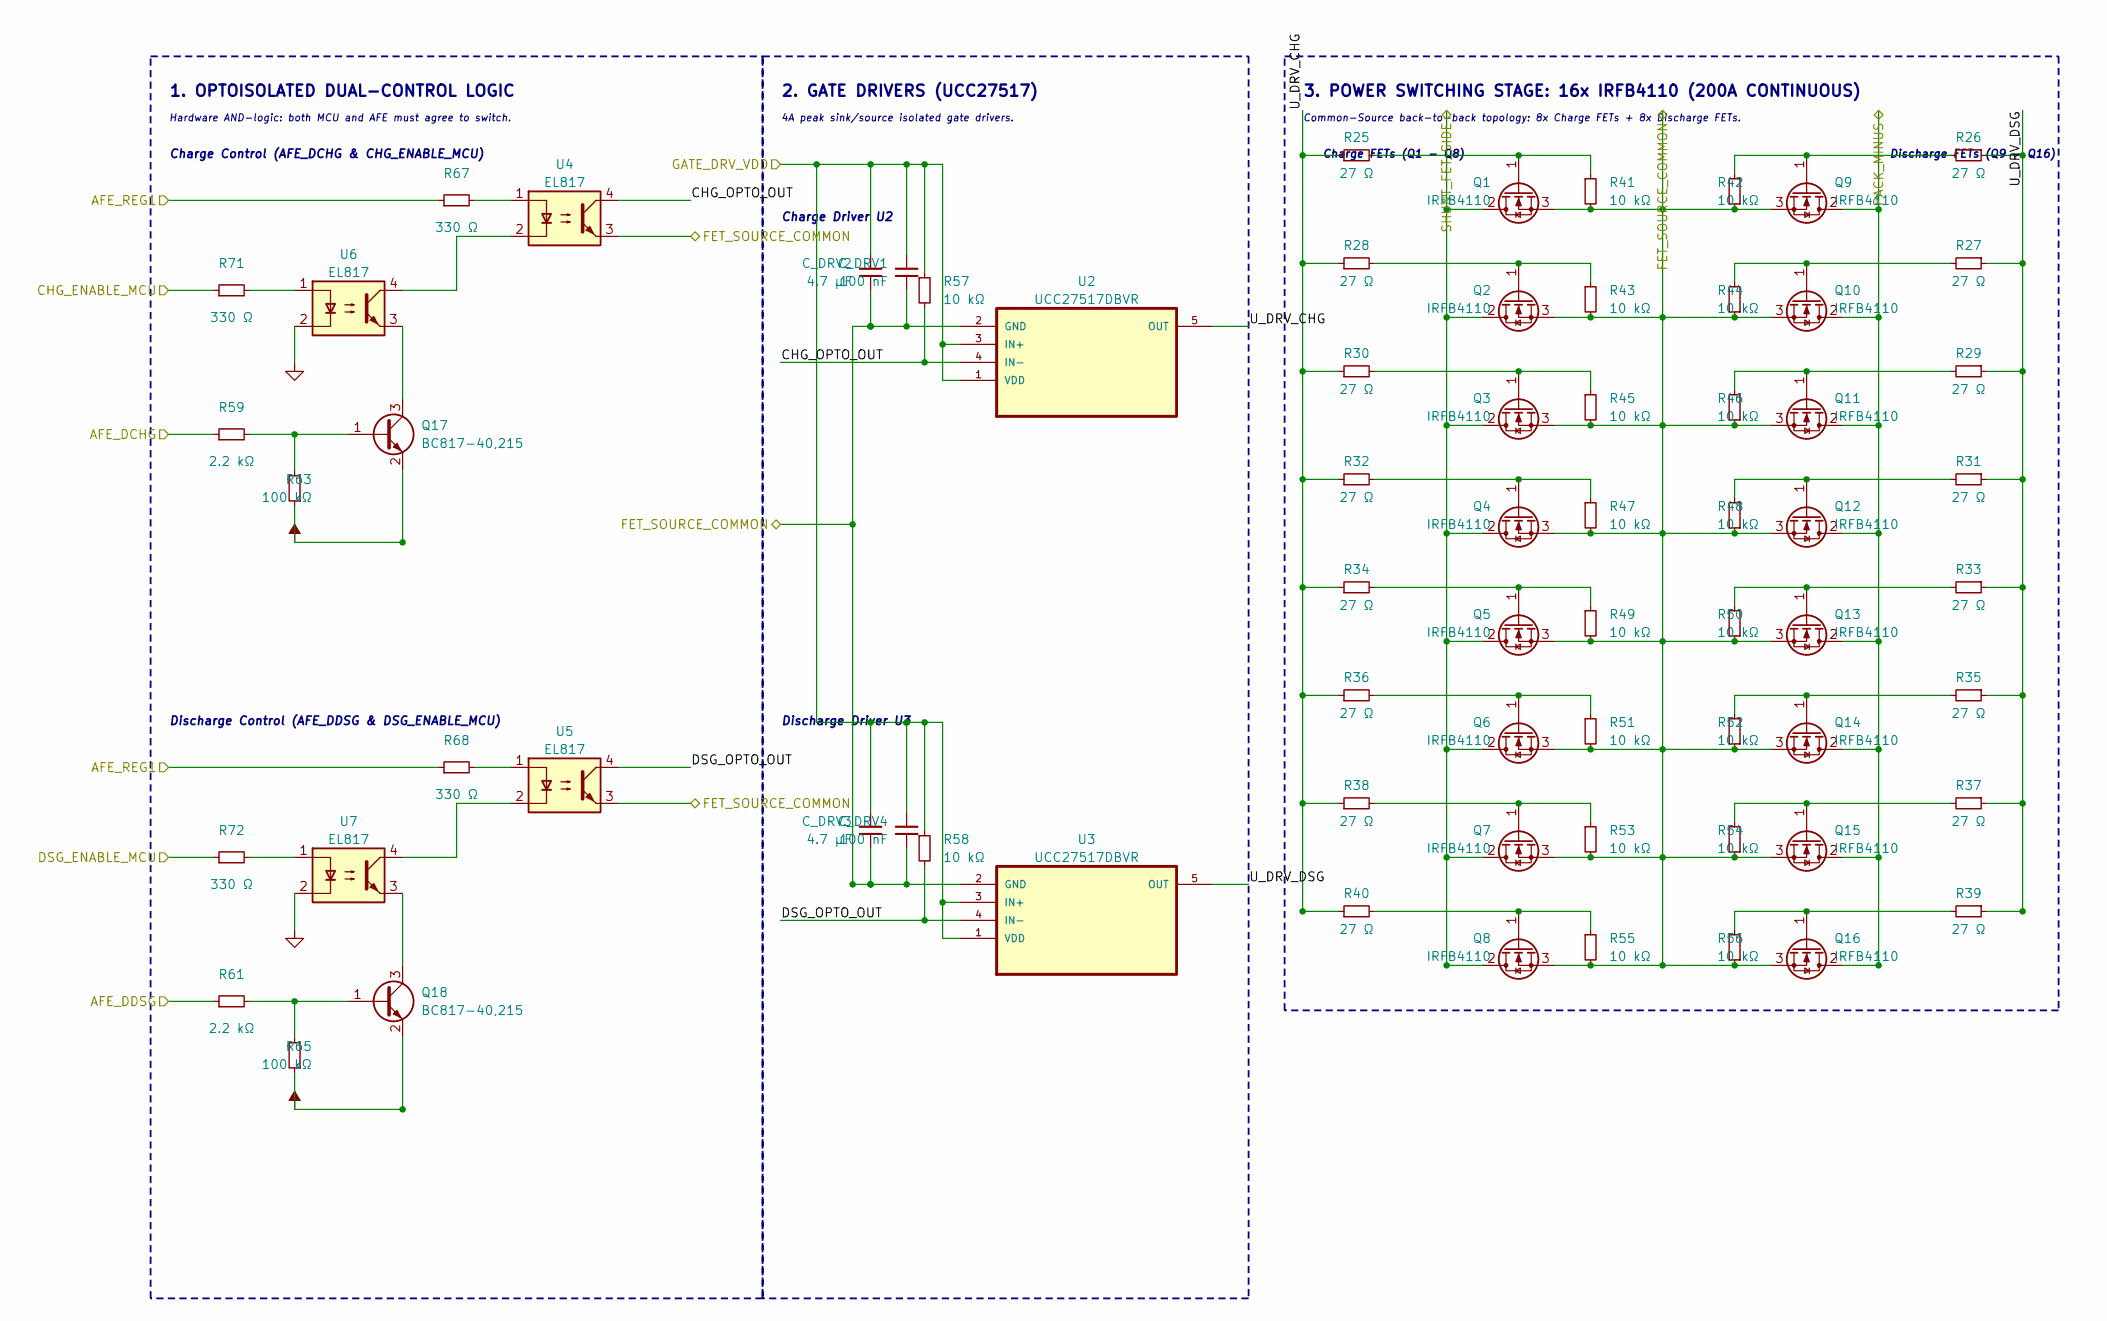
[picture p125: schematic 04_Current_Switching.kicad_sch]

Parts:
C_DRV1, C_DRV4: 100 nF
C_DRV2, C_DRV3: 4.7 µF
Q1, Q2, Q3, Q4, Q5, Q6, Q7, Q8, Q9, Q10, Q11, Q12, Q13, Q14, Q15, Q16: IRFB4110; TO-220-3_Vertical
Q17, Q18: BC817-40,215; SOT-23_Handsoldering
R25, R26, R27, R28, R29, R30, R31, R32, R33, R34, R35, R36, R37, R38, R39, R40: 27 Ω; R_1206_3216Metric_Pad1.30x1.75mm_HandSolder
R41, R42, R43, R44, R45, R46, R47, R48, R49, R50, R51, R52, R53, R54, R55, R56, R57, R58: 10 kΩ; R_1206_3216Metric_Pad1.30x1.75mm_HandSolder
R59, R61: 2.2 kΩ; R_1206_3216Metric_Pad1.30x1.75mm_HandSolder
R63, R65: 100 kΩ; R_1206_3216Metric_Pad1.30x1.75mm_HandSolder
R67, R68, R71, R72: 330 Ω; R_1206_3216Metric_Pad1.30x1.75mm_HandSolder
U2, U3: UCC27517DBVR; SOT-23-5
U4, U5, U6, U7: EL817; SOP-4_3.8x4.1mm_P2.54mm

Connections:
AFE_DCHG: R59.1
AFE_DDSG: R61.1
AFE_REG1: R67.1, R68.1
CHG_ENABLE_MCU: R71.1
CHG_OPTO_OUT: R57.2, U2.4 (IN-), U4.4
DSG_ENABLE_MCU: R72.1
DSG_OPTO_OUT: R58.2, U3.4 (IN-), U5.4
FET_SOURCE_COMMON: C_DRV1.2, C_DRV2.2, C_DRV3.2, C_DRV4.2, Q1.3 (S), Q2.3 (S), Q3.3 (S), Q4.3 (S), Q5.3 (S), Q6.3 (S), Q7.3 (S), Q8.3 (S), Q9.3 (S), Q10.3 (S), Q11.3 (S), Q12.3 (S), Q13.3 (S), Q14.3 (S), Q15.3 (S), Q16.3 (S), R41.2, R42.1, R43.2, R44.1, R45.2, R46.1, R47.2, R48.1, R49.2, R50.1, R51.2, R52.1, R53.2, R54.1, R55.2, R56.1, U2.2 (GND), U3.2 (GND), U4.3, U5.3
GATE_DRV_VDD: C_DRV1.1, C_DRV2.1, C_DRV3.1, C_DRV4.1, R57.1, R58.1, U2.1 (VDD), U2.3 (IN+), U3.1 (VDD), U3.3 (IN+)
GND: U6.2, U7.2
unnamed: Q1.1 (G), R25.2, R41.1
unnamed: Q2.1 (G), R28.2, R43.1
unnamed: Q3.1 (G), R30.2, R45.1
unnamed: Q4.1 (G), R32.2, R47.1
unnamed: Q5.1 (G), R34.2, R49.1
unnamed: Q6.1 (G), R36.2, R51.1
unnamed: Q7.1 (G), R38.2, R53.1
unnamed: Q8.1 (G), R40.2, R55.1
unnamed: Q9.1 (G), R26.2, R42.2
unnamed: Q10.1 (G), R27.2, R44.2
unnamed: Q11.1 (G), R29.2, R46.2
unnamed: Q12.1 (G), R31.2, R48.2
unnamed: Q13.1 (G), R33.2, R50.2
unnamed: Q14.1 (G), R35.2, R52.2
unnamed: Q15.1 (G), R37.2, R54.2
unnamed: Q16.1 (G), R39.2, R56.2
unnamed: Q17.1 (B), R59.2, R63.2
unnamed: Q17.3 (C), U6.3
unnamed: Q18.1 (B), R61.2, R65.2
unnamed: Q18.3 (C), U7.3
unnamed: R67.2, U4.1
unnamed: R68.2, U5.1
unnamed: R71.2, U6.1
unnamed: R72.2, U7.1
unnamed: U4.2, U6.4
unnamed: U5.2, U7.4
PACK_MINUS: Q9.2 (D), Q10.2 (D), Q11.2 (D), Q12.2 (D), Q13.2 (D), Q14.2 (D), Q15.2 (D), Q16.2 (D)
SHUNT_FET_SIDE: Q1.2 (D), Q2.2 (D), Q3.2 (D), Q4.2 (D), Q5.2 (D), Q6.2 (D), Q7.2 (D), Q8.2 (D)
U_DRV_CHG: R25.1, R28.1, R30.1, R32.1, R34.1, R36.1, R38.1, R40.1, U2.5 (OUT)
U_DRV_DSG: R26.1, R27.1, R29.1, R31.1, R33.1, R35.1, R37.1, R39.1, U3.5 (OUT)
VSS: Q17.2 (E), Q18.2 (E), R63.1, R65.1

Notes on the sheet:
1. OPTOISOLATED DUAL-CONTROL LOGIC
Hardware AND-logic: both MCU and AFE must agree to switch.
Charge Control (AFE_DCHG & CHG_ENABLE_MCU)
Discharge Control (AFE_DDSG & DSG_ENABLE_MCU)
2. GATE DRIVERS (UCC27517)
4A peak sink/source isolated gate drivers.
Charge Driver U2
Discharge Driver U3
3. POWER SWITCHING STAGE: 16x IRFB4110 (200A CONTINUOUS)
Common-Source back-to-back topology: 8x Charge FETs + 8x Discharge FETs.
Charge FETs (Q1 - Q8)
Discharge FETs (Q9 - Q16)
