koko69420/SmartBMS_Active-balancing/16s_BMS/05_Temperature_Sensing.kicad_sch

## KiCad design 16s_BMS/05_Temperature_Sensing.kicad_sch (2026-11-05)

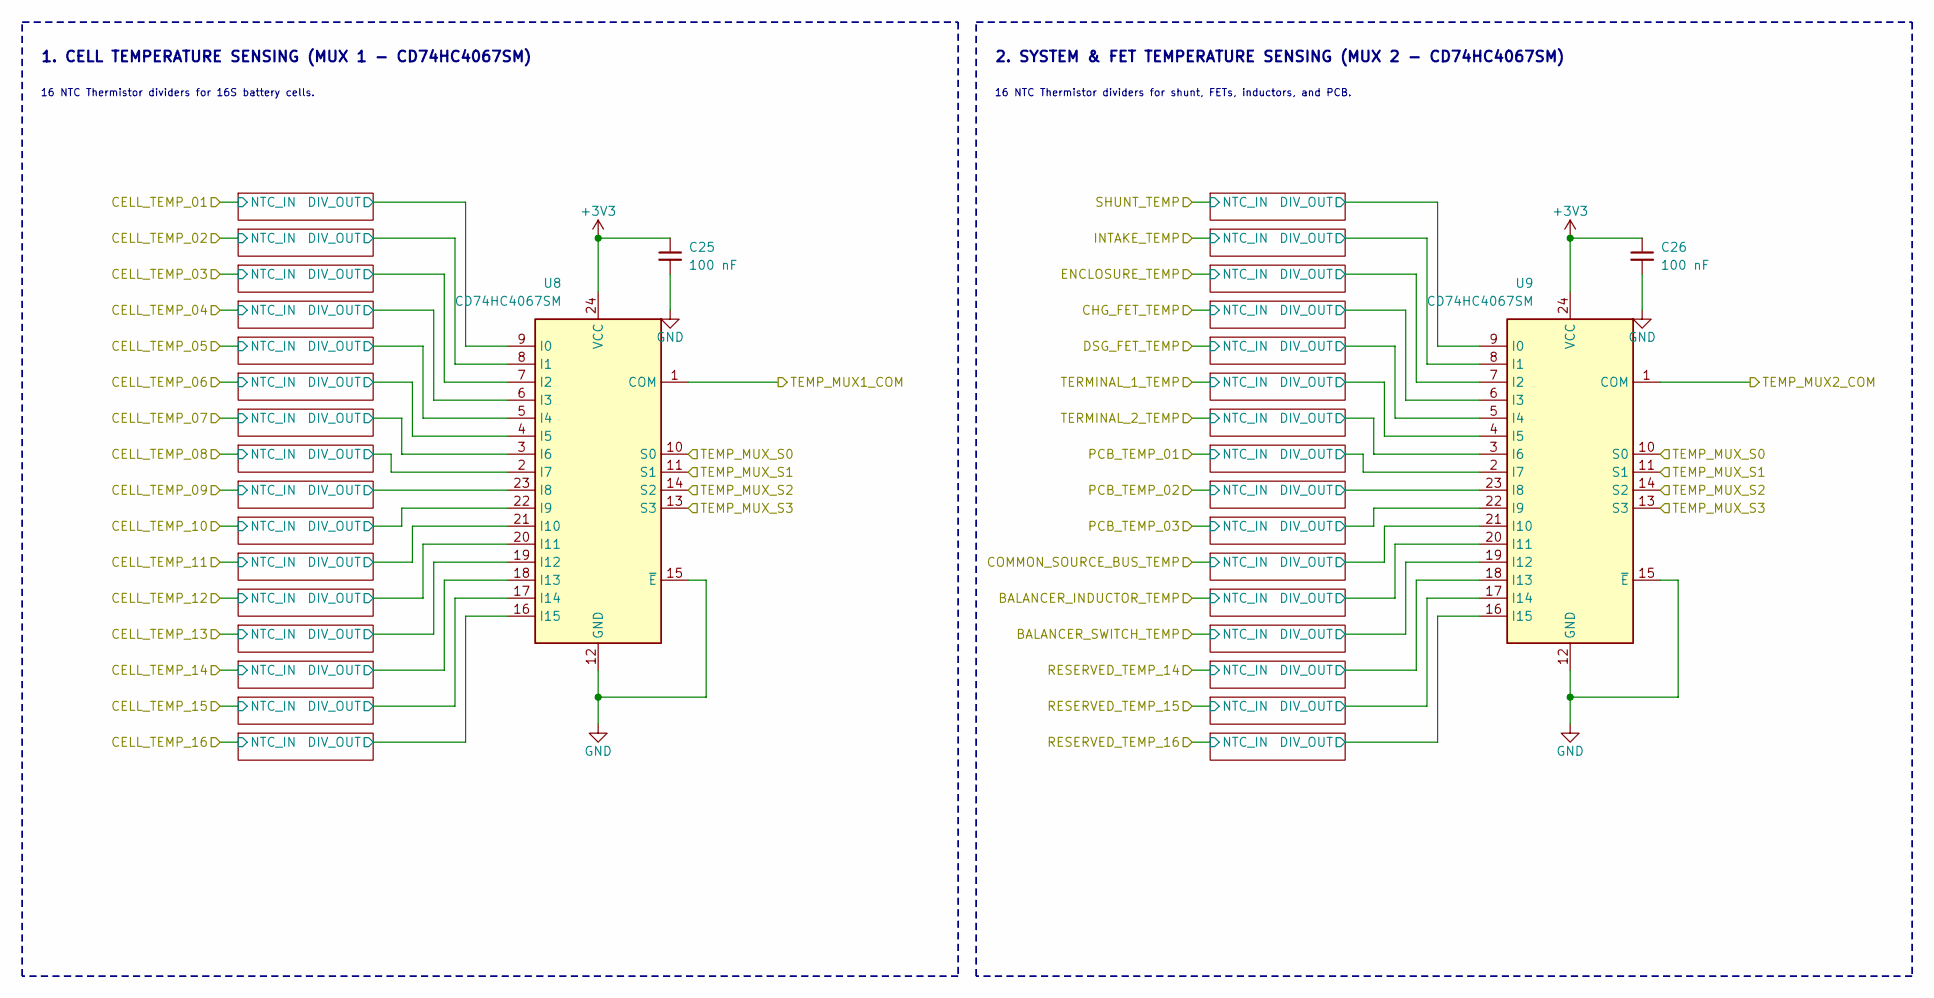
[picture p126: schematic 05_Temperature_Sensing.kicad_sch]

Parts:
C25, C26: 100 nF; C_1206_3216Metric_Pad1.33x1.80mm_HandSolder
U8, U9: CD74HC4067SM; SSOP-24_5.3x8.2mm_P0.65mm

Connections:
+3V3: C25.1, C26.1, U8.24 (VCC), U9.24 (VCC)
DIV_OUT: U8.2 (I7), U8.3 (I6), U8.4 (I5), U8.5 (I4), U8.6 (I3), U8.7 (I2), U8.8 (I1), U8.9 (I0), U8.16 (I15), U8.17 (I14), U8.18 (I13), U8.19 (I12), U8.20 (I11), U8.21 (I10), U8.22 (I9), U8.23 (I8), U9.2 (I7), U9.3 (I6), U9.4 (I5), U9.5 (I4), U9.6 (I3), U9.7 (I2), U9.8 (I1), U9.9 (I0), U9.16 (I15), U9.17 (I14), U9.18 (I13), U9.19 (I12), U9.20 (I11), U9.21 (I10), U9.22 (I9), U9.23 (I8)
GND: C25.2, C26.2, U8.12 (GND), U8.15 (~E), U9.12 (GND), U9.15 (~E)
TEMP_MUX1_COM: U8.1 (COM)
TEMP_MUX2_COM: U9.1 (COM)
TEMP_MUX_S0: U8.10 (S0), U9.10 (S0)
TEMP_MUX_S1: U8.11 (S1), U9.11 (S1)
TEMP_MUX_S2: U8.14 (S2), U9.14 (S2)
TEMP_MUX_S3: U8.13 (S3), U9.13 (S3)

Notes on the sheet:
1. CELL TEMPERATURE SENSING (MUX 1 - CD74HC4067SM)
16 NTC Thermistor dividers for 16S battery cells.
2. SYSTEM & FET TEMPERATURE SENSING (MUX 2 - CD74HC4067SM)
16 NTC Thermistor dividers for shunt, FETs, inductors, and PCB.
