koko69420/SmartBMS_Active-balancing/16s_BMS/06_Balance_Status.kicad_sch

## KiCad design 16s_BMS/06_Balance_Status.kicad_sch (2026-11-06)

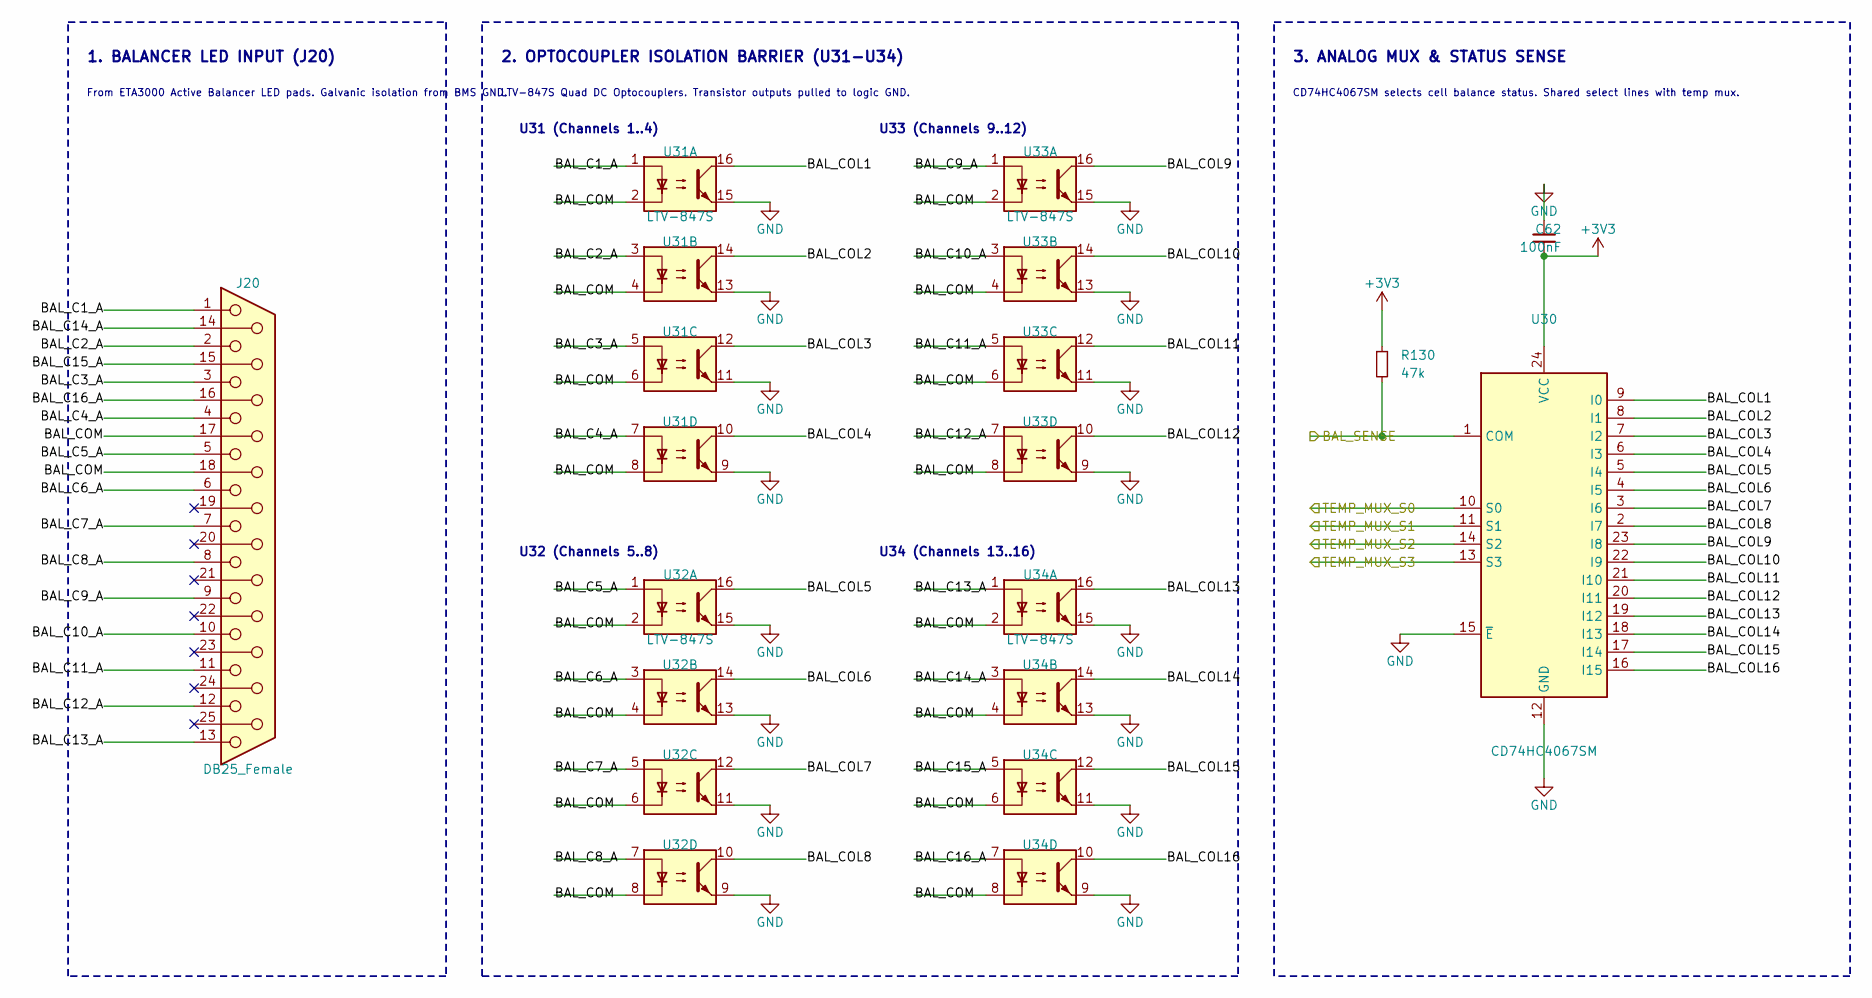
[picture p127: schematic 06_Balance_Status.kicad_sch]

Parts:
C62: 100nF; C_0805_2012Metric
J20: DB25_Female; DSUB-25_Socket_Horizontal_P2.77x2.84mm_EdgePinOffset4.94mm_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
R130: 47k; R_0805_2012Metric
U30: CD74HC4067SM; SSOP-24_5.3x8.2mm_P0.65mm
U31, U32, U33, U34: LTV-847S; SMDIP-16_W9.53mm

Connections:
+3V3: C62.1, R130.1, U30.24 (VCC)
BAL_C1_A: J20.1, U31.1
BAL_C2_A: J20.2, U31.3
BAL_C3_A: J20.3, U31.5
BAL_C4_A: J20.4, U31.7
BAL_C5_A: J20.5, U32.1
BAL_C6_A: J20.6, U32.3
BAL_C7_A: J20.7, U32.5
BAL_C8_A: J20.8, U32.7
BAL_C9_A: J20.9, U33.1
BAL_C10_A: J20.10, U33.3
BAL_C11_A: J20.11, U33.5
BAL_C12_A: J20.12, U33.7
BAL_C13_A: J20.13, U34.1
BAL_C14_A: J20.14, U34.3
BAL_C15_A: J20.15, U34.5
BAL_C16_A: J20.16, U34.7
BAL_COL1: U30.9 (I0), U31.16
BAL_COL2: U30.8 (I1), U31.14
BAL_COL3: U30.7 (I2), U31.12
BAL_COL4: U30.6 (I3), U31.10
BAL_COL5: U30.5 (I4), U32.16
BAL_COL6: U30.4 (I5), U32.14
BAL_COL7: U30.3 (I6), U32.12
BAL_COL8: U30.2 (I7), U32.10
BAL_COL9: U30.23 (I8), U33.16
BAL_COL10: U30.22 (I9), U33.14
BAL_COL11: U30.21 (I10), U33.12
BAL_COL12: U30.20 (I11), U33.10
BAL_COL13: U30.19 (I12), U34.16
BAL_COL14: U30.18 (I13), U34.14
BAL_COL15: U30.17 (I14), U34.12
BAL_COL16: U30.16 (I15), U34.10
BAL_COM: J20.17, J20.18, U31.2, U31.4, U31.6, U31.8, U32.2, U32.4, U32.6, U32.8, U33.2, U33.4, U33.6, U33.8, U34.2, U34.4, U34.6, U34.8
BAL_SENSE: R130.2, U30.1 (COM)
GND: C62.2, U30.12 (GND), U30.15 (~E), U31.9, U31.11, U31.13, U31.15, U32.9, U32.11, U32.13, U32.15, U33.9, U33.11, U33.13, U33.15, U34.9, U34.11, U34.13, U34.15
TEMP_MUX_S0: U30.10 (S0)
TEMP_MUX_S1: U30.11 (S1)
TEMP_MUX_S2: U30.14 (S2)
TEMP_MUX_S3: U30.13 (S3)

Notes on the sheet:
1. BALANCER LED INPUT (J20)
From ETA3000 Active Balancer LED pads. Galvanic isolation from BMS GND.
2. OPTOCOUPLER ISOLATION BARRIER (U31-U34)
LTV-847S Quad DC Optocouplers. Transistor outputs pulled to logic GND.
3. ANALOG MUX & STATUS SENSE
CD74HC4067SM selects cell balance status. Shared select lines with temp mux.
U31 (Channels 1..4)
U33 (Channels 9..12)
U32 (Channels 5..8)
U34 (Channels 13..16)
