koko69420/SmartBMS_Active-balancing/16s_BMS/07_Comms.kicad_sch

## KiCad design 16s_BMS/07_Comms.kicad_sch (2026-11-10, an earlier design)

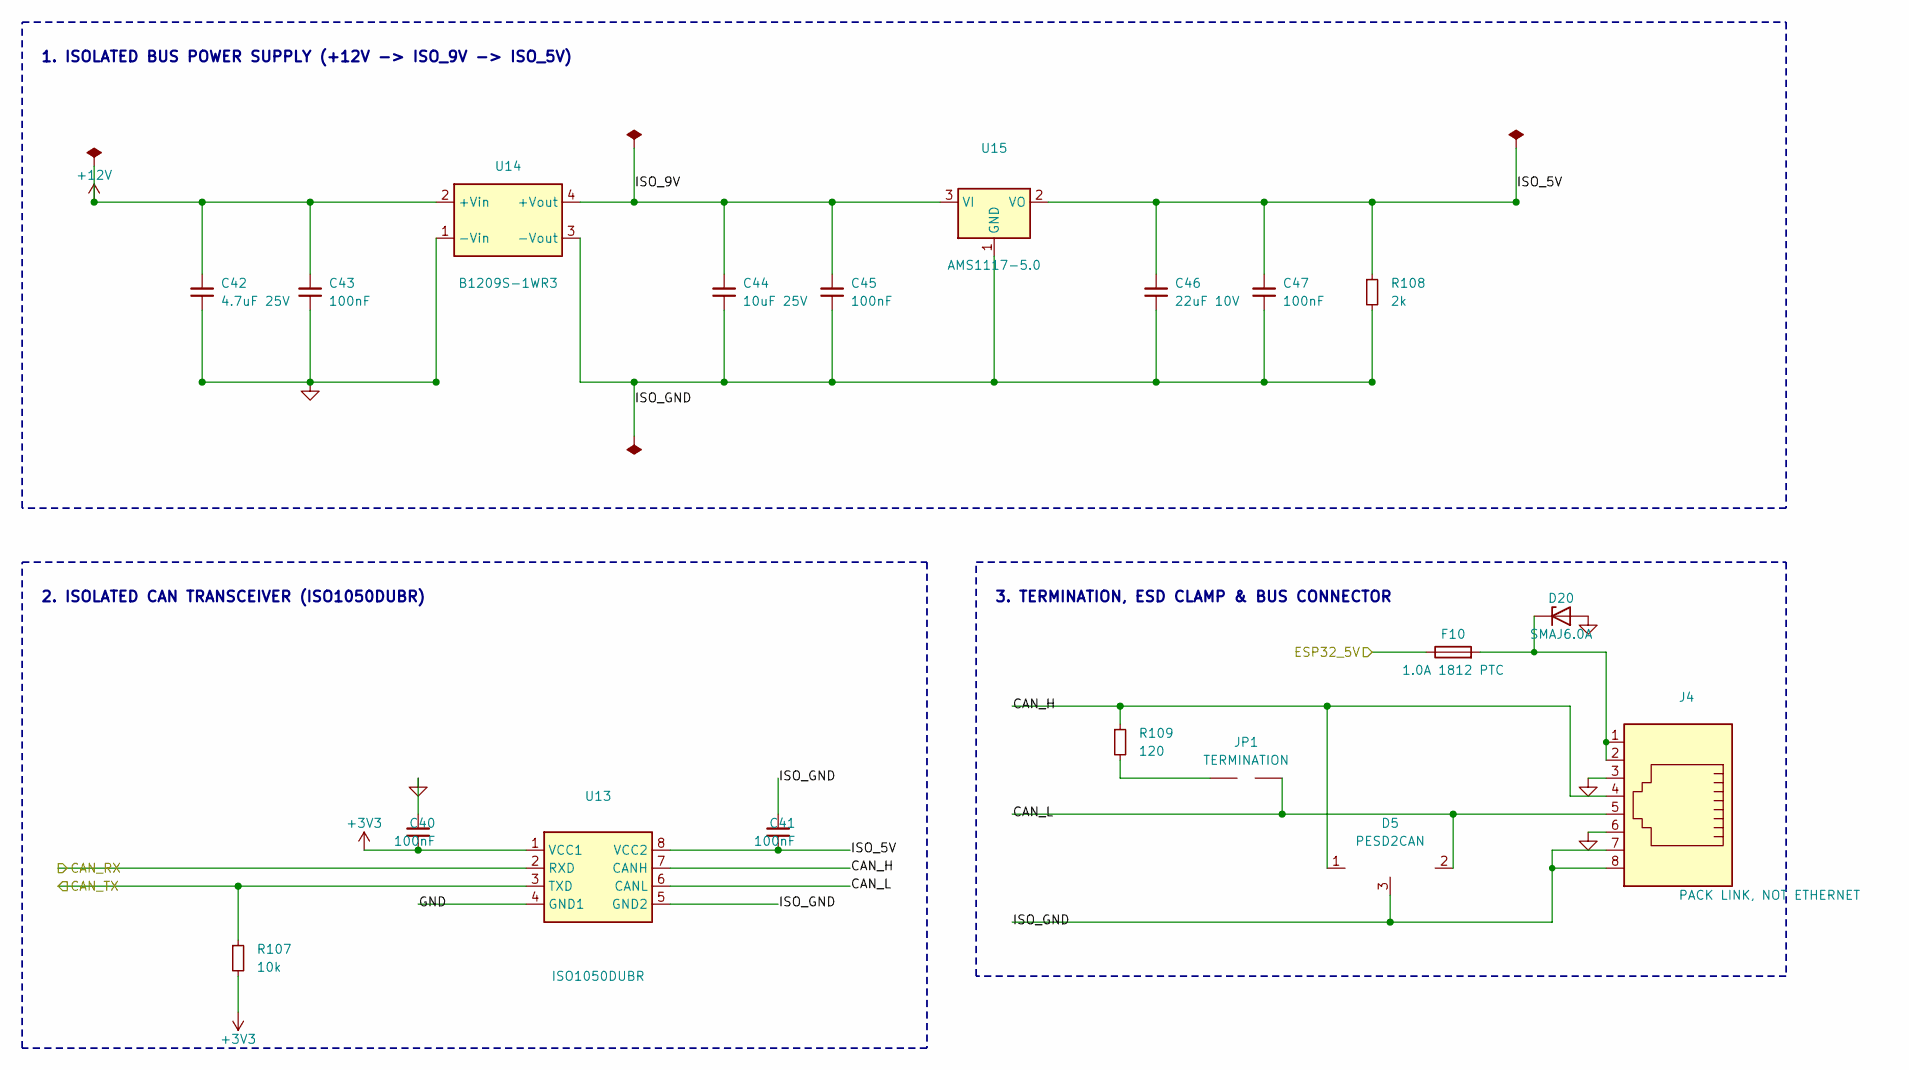
[picture p128: schematic 07_Comms.kicad_sch]

Parts:
C40, C41, C43, C45, C47: 100nF; C_0805_2012Metric
C42: 4.7uF 25V; C_0805_2012Metric
C44: 10uF 25V; C_1206_3216Metric
C46: 22uF 10V; C_1206_3216Metric
D5: PESD2CAN; SOT-23
D20: SMAJ6.0A; D_SMA
F10: 1.0A 1812 PTC; Fuse_1812_4532Metric
J4: PACK LINK, NOT ETHERNET; RJ45_Amphenol_54602-x08_Horizontal
JP1: TERMINATION; SolderJumper-2_P1.3mm_Open_RoundedPad1.0x1.5mm
R107: 10k; R_0805_2012Metric
R108: 2k; R_0805_2012Metric
R109: 120; R_1206_3216Metric
U13: ISO1050DUBR; SOP-8_6.62x9.15mm_P2.54mm
U14: B1209S-1WR3; Converter_DCDC_Murata_MEE1SxxxxSC_THT
U15: AMS1117-5.0; SOT-223-3_TabPin2

Connections:
+3V3: C40.1, R107.2, U13.1 (VCC1)
+12V: C42.1, C43.1, U14.2 (+Vin)
CAN_H: D5.1 (A1), J4.4, R109.1, U13.7 (CANH)
CAN_L: D5.2 (A2), J4.5, JP1.2 (B), U13.6 (CANL)
CAN_RX: U13.2 (RXD)
CAN_TX: R107.1, U13.3 (TXD)
ESP32_5V: F10.1
GND: C40.2, C42.2, C43.2, D20.2 (A), J4.3, J4.6, U13.4 (GND1), U14.1 (-Vin)
ISO_5V: C41.1, C46.1, C47.1, R108.1, U13.8 (VCC2), U15.2 (VO)
ISO_9V: C44.1, C45.1, U14.4 (+Vout), U15.3 (VI)
ISO_GND: C41.2, C44.2, C45.2, C46.2, C47.2, D5.3 (common), J4.7, J4.8, R108.2, U13.5 (GND2), U14.3 (-Vout), U15.1 (GND)
unnamed: D20.1 (K), F10.2, J4.1, J4.2
unnamed: JP1.1 (A), R109.2

Notes on the sheet:
1. ISOLATED BUS POWER SUPPLY (+12V -> ISO_9V -> ISO_5V)
2. ISOLATED CAN TRANSCEIVER (ISO1050DUBR)
3. TERMINATION, ESD CLAMP & BUS CONNECTOR
