koko69420/SmartBMS_Active-balancing/16s_BMS/08_Precharge.kicad_sch

## KiCad design 16s_BMS/08_Precharge.kicad_sch (2026-11-10, an earlier design)

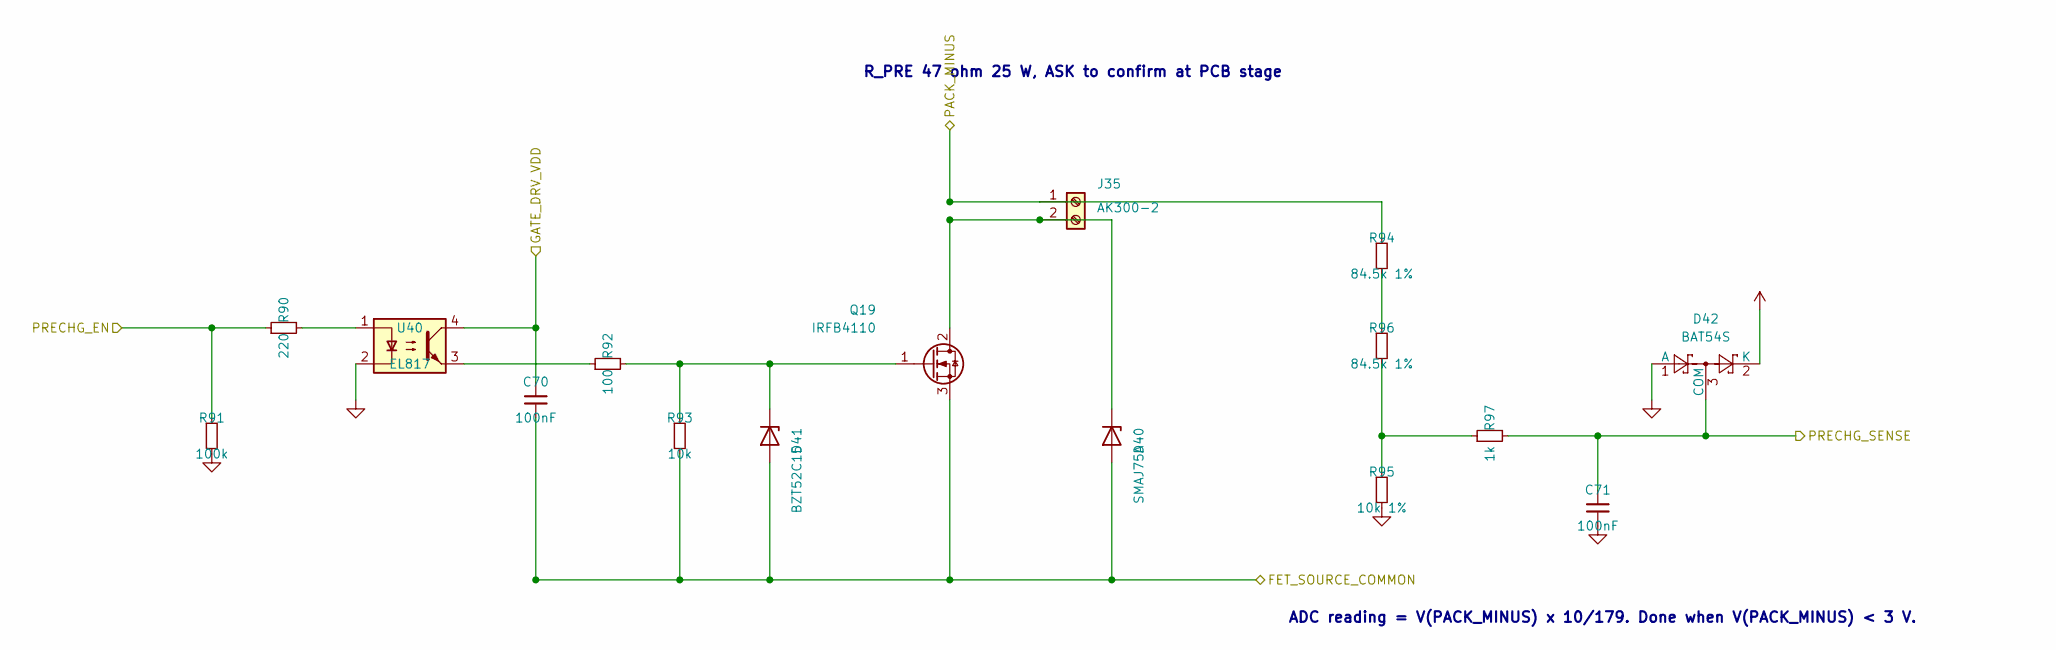
[picture p129: schematic 08_Precharge.kicad_sch]

Parts:
C70, C71: 100nF; C_0805_2012Metric
D40: SMAJ75A; D_SMA
D41: BZT52C15; D_SOD-123
D42: BAT54S; SOT-23
J35: AK300-2; TerminalBlock_Phoenix_MKDS-1,5-2-5.08_1x02_P5.08mm_Horizont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
Q19: IRFB4110; TO-220-3_Vertical
R90: 220; R_1206_3216Metric
R91: 100k; R_1206_3216Metric
R92: 100; R_1206_3216Metric
R93: 10k; R_1206_3216Metric
R94, R96: 84.5k 1%; R_1206_3216Metric
R95: 10k 1%; R_1206_3216Metric
R97: 1k; R_0805_2012Metric
U40: EL817; SOP-4_3.8x4.1mm_P2.54mm

Connections:
+3V3: D42.2 (K)
FET_SOURCE_COMMON: C70.2, D40.2 (A), D41.2 (A), Q19.3 (S), R93.2
GATE_DRV_VDD: C70.1, U40.4
GND: C71.2, D42.1 (A), R91.2, R95.2, U40.2
unnamed: D40.1 (K), J35.2, Q19.2 (D)
unnamed: D41.1 (K), Q19.1 (G), R92.2, R93.1
unnamed: R90.2, U40.1
unnamed: R92.1, U40.3
unnamed: R94.2, R96.1
unnamed: R95.1, R96.2, R97.1
PACK_MINUS: J35.1, R94.1
PRECHG_EN: R90.1, R91.1
PRECHG_SENSE: C71.1, D42.3 (COM), R97.2

Notes on the sheet:
R_PRE 47 ohm 25 W, ASK to confirm at PCB stage
ADC reading = V(PACK_MINUS) x 10/179. Done when V(PACK_MINUS) < 3 V.
