koko69420/SmartBMS_Active-balancing/16s_BMS/16s_BMS.kicad_sch

## KiCad design 16s_BMS/16s_BMS.kicad_sch (2026-11-10, an earlier design)

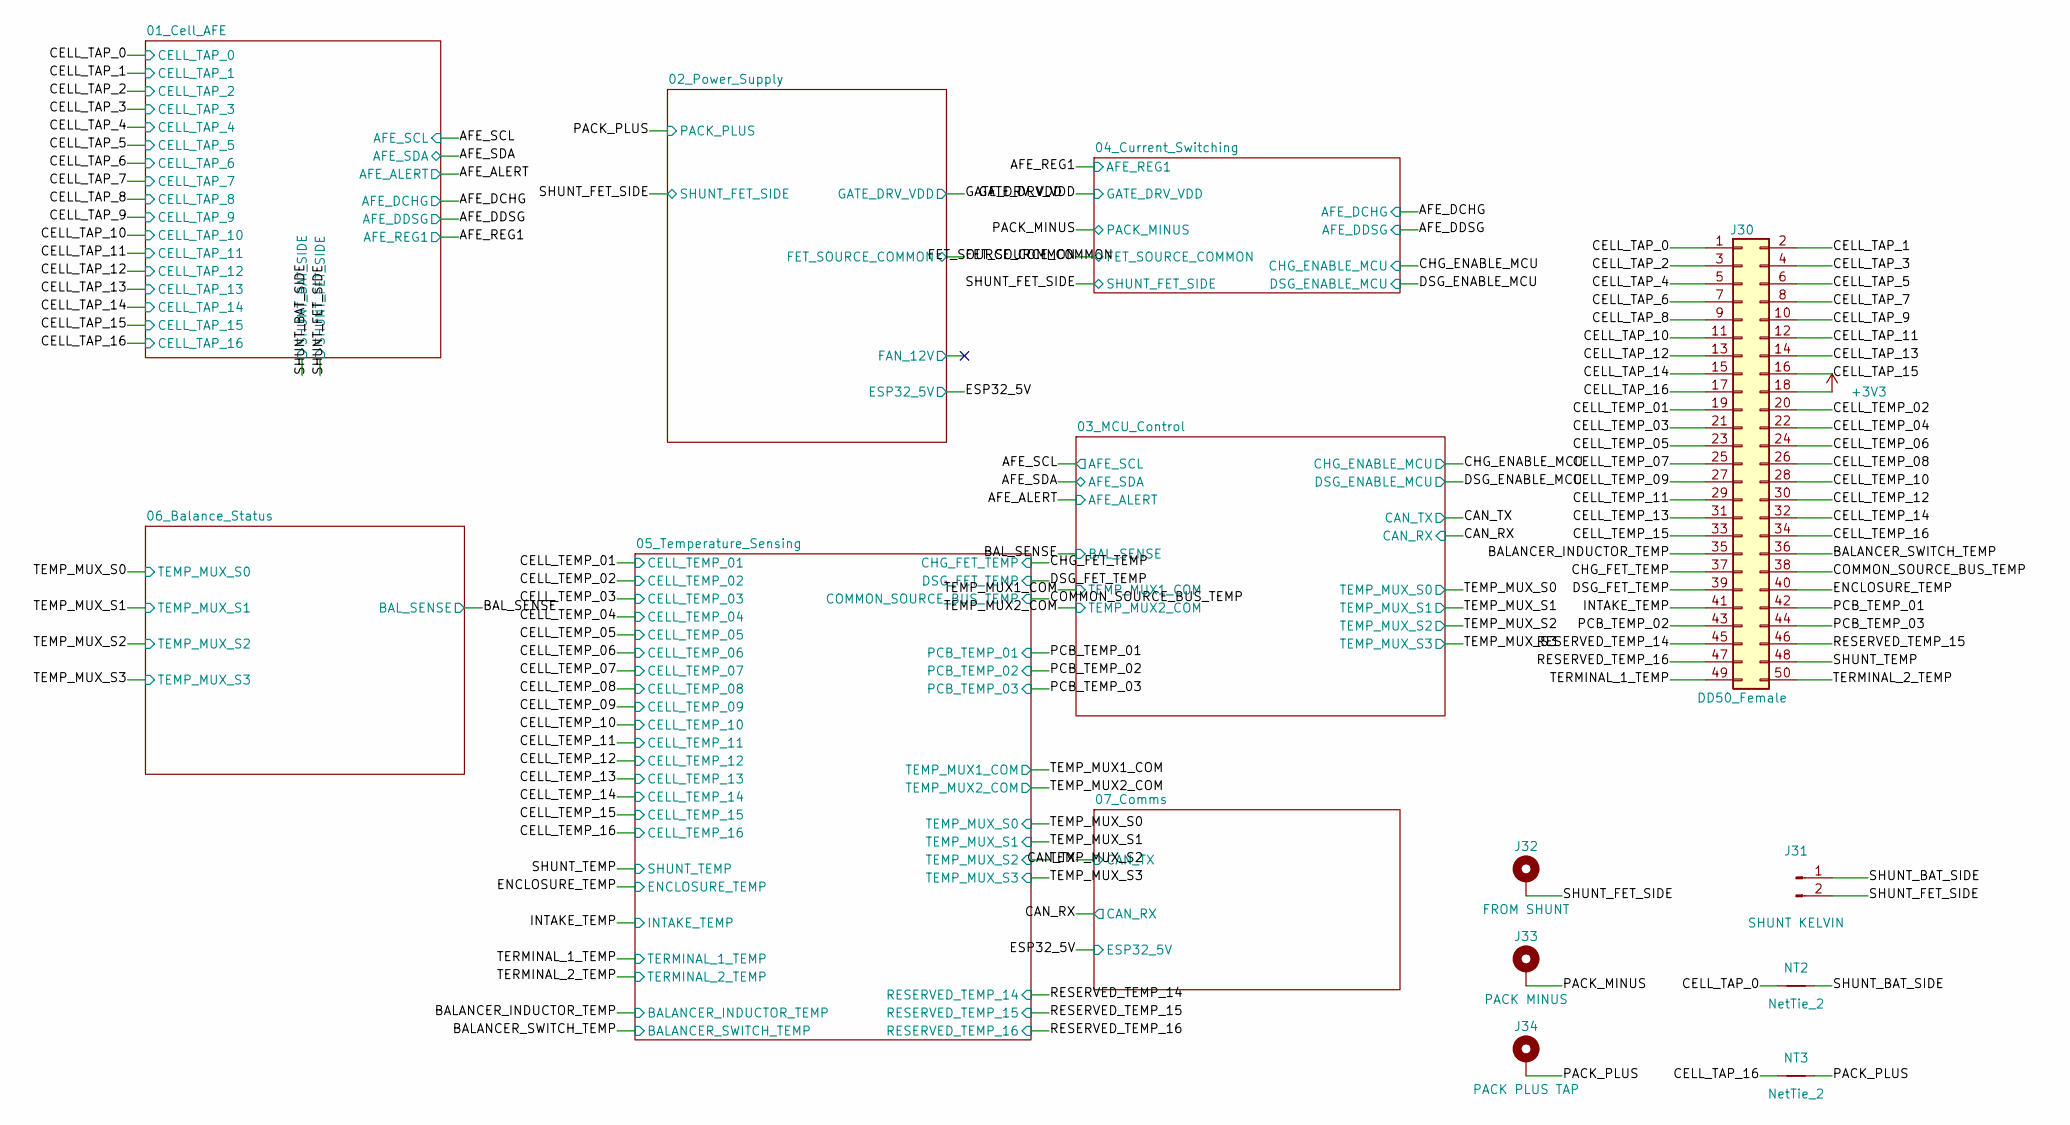
[picture p130: schematic 16s_BMS.kicad_sch]

Parts:
J30: DD50_Female
J31: SHUNT KELVIN; PinHeader_1x02_P2.54mm_Vertical
J32: FROM SHUNT; MountingHole_8.4mm_M8_Pad
J33: PACK MINUS; MountingHole_8.4mm_M8_Pad
J34: PACK PLUS TAP; MountingHole_8.4mm_M8_Pad
NT2, NT3: NetTie_2; NetTie-2_SMD_Pad0.5mm

Connections:
+3V3: J30.18
BALANCER_INDUCTOR_TEMP: J30.35
BALANCER_SWITCH_TEMP: J30.36
CELL_TAP_0: J30.1, NT2.1
CELL_TAP_1: J30.2
CELL_TAP_2: J30.3
CELL_TAP_3: J30.4
CELL_TAP_4: J30.5
CELL_TAP_5: J30.6
CELL_TAP_6: J30.7
CELL_TAP_7: J30.8
CELL_TAP_8: J30.9
CELL_TAP_9: J30.10
CELL_TAP_10: J30.11
CELL_TAP_11: J30.12
CELL_TAP_12: J30.13
CELL_TAP_13: J30.14
CELL_TAP_14: J30.15
CELL_TAP_15: J30.16
CELL_TAP_16: J30.17, NT3.1
CELL_TEMP_01: J30.19
CELL_TEMP_02: J30.20
CELL_TEMP_03: J30.21
CELL_TEMP_04: J30.22
CELL_TEMP_05: J30.23
CELL_TEMP_06: J30.24
CELL_TEMP_07: J30.25
CELL_TEMP_08: J30.26
CELL_TEMP_09: J30.27
CELL_TEMP_10: J30.28
CELL_TEMP_11: J30.29
CELL_TEMP_12: J30.30
CELL_TEMP_13: J30.31
CELL_TEMP_14: J30.32
CELL_TEMP_15: J30.33
CELL_TEMP_16: J30.34
CHG_FET_TEMP: J30.37
COMMON_SOURCE_BUS_TEMP: J30.38
DSG_FET_TEMP: J30.39
ENCLOSURE_TEMP: J30.40
INTAKE_TEMP: J30.41
PACK_MINUS: J33.1
PACK_PLUS: J34.1, NT3.2
PCB_TEMP_01: J30.42
PCB_TEMP_02: J30.43
PCB_TEMP_03: J30.44
RESERVED_TEMP_14: J30.45
RESERVED_TEMP_15: J30.46
RESERVED_TEMP_16: J30.47
SHUNT_BAT_SIDE: J31.1, NT2.2
SHUNT_FET_SIDE: J31.2, J32.1
SHUNT_TEMP: J30.48
TERMINAL_1_TEMP: J30.49
TERMINAL_2_TEMP: J30.50
