koko69420/SmartBMS_Active-balancing/(commit log)

2026-09-29 feat: initial commit for SmartBMS 16S 100Ah Active-Balancing BMS project
2026-09-29 Save: update git_tracker.py, start_tracker.sh, SmartBMS.kicad_pcb (2026-09-30 00:53:19)
    [SmartBMS.kicad_pcb]
2026-09-29 Save: update SmartBMS.kicad_sch (2026-09-30 00:53:30)
    [SmartBMS.kicad_sch]
2026-09-29 Save: update SmartBMS.kicad_pcb, SmartBMS.kicad_sch (2026-09-30 00:53:47)
    [SmartBMS.kicad_pcb, SmartBMS.kicad_sch]
2026-10-16 feat: upgrade BMS to KiCad 9.0 with TI BQ76952 AFE, 16x IRFB4110 power stage, dual UCC27517 drivers, and 32-channel NTC matrix
    - Implemented Sheet 01 (01_Cell_AFE): TI BQ76952PFBR 16S battery monitor with 17 RC tap filters, BAV21WS transient clamps, Kelvin shunt sensing, and BCX56-135 BJT pre-regulator
    - Implemented Sheet 04 (04_Current_Switching): 200A solid-state cutoff with 16x IRFB4110 MOSFETs in back-to-back common-source topology, dual UCC27517DBVR 4A gate drivers, individual 27 ohm gate damping networks, and EL817/BC817 optoisolated dual-control logic
    - Implemented Sheet 05 (05_Temperature_Sensing & 05_1_NTC_DIVIDER): 32-channel multiplexed NTC thermal matrix using dual CD74HC4067 mul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
2026-10-30 Update README for 100A continuous current rating
2026-10-30 Update continuous current rating from 200 A to 100 A
2026-11-05 feat: complete 06_Balance_Status & 07_Comms schematics, update power supply & MCU control, enhance git tracker
    - Add Sheet 06 (06_Balance_Status.kicad_sch): active balancing status monitoring circuitry and indicators
    - Add Sheet 07 (07_Comms.kicad_sch): isolated CAN 2.0B bus interface with ISO1050/ISO1042 and B1209S DC-DC
    - Update Sheet 02 (02_Power_Supply.kicad_sch) and Sheet 03 (03_MCU_Control.kicad_sch)
    - Update 16s_BMS root schematic and project configuration
    - Track schematic vector SVG and PDF documentation exports
    - Update .gitignore to exclude KiCad ERC/DRC report files (*.rpt)
    - Enhance git_tracker.py with report exclusions and automated rebase-on-retry logic
2026-11-05 Save: update 05_1_NTC_DIVIDER.kicad_sch (2026-11-06 02:52:25)
2026-11-05 Save: update 01_Cell_AFE.kicad_sch (2026-11-06 02:53:00)
2026-11-05 Save: update 16s_BMS.kicad_sch (2026-11-06 02:54:18)
2026-11-05 Save: update 03_MCU_Control.kicad_sch (2026-11-06 03:05:26)
2026-11-05 Save: update 03_MCU_Control.kicad_sch (2026-11-06 03:06:36)
2026-11-05 Save: update 03_MCU_Control.kicad_sch, 03_MCU_Control.net (2026-11-06 03:08:53)
2026-11-05 Save: update 07_Comms.kicad_sch (2026-11-06 03:29:13)
2026-11-05 Save: update 07_Comms.kicad_sch (2026-11-06 03:30:40)
2026-11-05 Save: update 07_Comms.kicad_sch (2026-11-06 03:35:01)
2026-11-05 Save: update 07_Comms.kicad_sch (2026-11-06 03:35:32)
2026-11-05 Save: update 07_Comms.kicad_sch (2026-11-06 03:36:48)
2026-11-05 Save: update 07_Comms.kicad_sch (2026-11-06 03:37:38)
2026-11-05 Save: update 07_Comms.kicad_sch (2026-11-06 03:37:52)
2026-11-05 Save: update 07_Comms.kicad_sch (2026-11-06 03:38:03)
2026-11-05 Save: update 07_Comms.kicad_sch (2026-11-06 03:38:12)
2026-11-05 Save: update 07_Comms.kicad_sch (2026-11-06 03:39:38)
2026-11-05 Save: update 07_Comms.kicad_sch (2026-11-06 03:40:53)
2026-11-05 Save: update 07_Comms.kicad_sch (2026-11-06 03:42:30)
2026-11-05 Save: update 06_Balance_Status.kicad_sch (2026-11-06 03:45:46)
2026-11-05 Save: update 06_Balance_Status.kicad_sch (2026-11-06 03:48:26)
2026-11-05 Save: update 05_Temperature_Sensing.kicad_sch (2026-11-06 03:56:37)
2026-11-05 Save: update 05_Temperature_Sensing.kicad_sch (2026-11-06 03:57:42)
2026-11-05 Save: update 05_Temperature_Sensing.kicad_sch (2026-11-06 03:59:30)
2026-11-05 Save: update 05_Temperature_Sensing.kicad_sch (2026-11-06 03:59:59)
2026-11-05 Save: update 02_Power_Supply.kicad_sch (2026-11-06 04:07:03)
2026-11-05 Save: update 02_Power_Supply.kicad_sch (2026-11-06 04:10:39)
2026-11-05 Save: update 02_Power_Supply.kicad_sch (2026-11-06 04:12:13)
2026-11-05 Save: update 04_Current_Switching.kicad_sch (2026-11-06 04:25:42)
2026-11-05 Save: update 04_Current_Switching.kicad_sch (2026-11-06 04:27:50)
2026-11-05 Save: update 04_Current_Switching.kicad_sch (2026-11-06 04:28:12)
2026-11-05 Save: update 04_Current_Switching.kicad_sch (2026-11-06 04:33:34)
2026-11-05 Save: update 04_Current_Switching.kicad_sch (2026-11-06 04:34:51)
2026-11-05 Save: update 04_Current_Switching.kicad_sch (2026-11-06 04:35:46)
2026-11-05 Save: update 04_Current_Switching.kicad_sch (2026-11-06 04:41:35)
2026-11-05 Save: update 04_Current_Switching.kicad_sch (2026-11-06 04:42:49)
2026-11-05 Save: update 03_MCU_Control.kicad_sch (2026-11-06 04:53:46)
2026-11-05 Save: update 03_MCU_Control.kicad_sch (2026-11-06 04:55:08)
2026-11-05 Save: update 03_MCU_Control.kicad_sch (2026-11-06 04:55:51)
2026-11-05 Save: update 03_MCU_Control.kicad_sch (2026-11-06 04:56:10)
2026-11-05 Save: update 03_MCU_Control.kicad_sch (2026-11-06 04:58:36)
2026-11-06 Save: update 03_MCU_Control.kicad_sch (2026-11-06 10:10:20)
2026-11-06 Save: update 02_Power_Supply.kicad_sch (2026-11-06 10:51:07)
2026-11-06 Save: update 07_Comms.kicad_sch (2026-11-06 10:55:41)
2026-11-06 Save: update 07_Comms.kicad_sch (2026-11-06 10:56:11)
2026-11-06 Save: update 07_Comms.kicad_sch (2026-11-06 10:57:49)
2026-11-06 Save: update 07_Comms.kicad_sch (2026-11-06 10:58:17)
2026-11-06 Save: update 07_Comms.kicad_sch (2026-11-06 10:59:18)
2026-11-06 Save: update 07_Comms.kicad_sch (2026-11-06 10:59:34)
2026-11-06 Save: update 07_Comms.kicad_sch (2026-11-06 11:00:11)
2026-11-06 Save: update 07_Comms.kicad_sch (2026-11-06 11:01:38)
2026-11-06 Save: update 06_Balance_Status.kicad_sch (2026-11-06 11:03:44)
2026-11-06 Save: update 16s_BMS.kicad_sch (2026-11-06 11:08:47)
2026-11-06 Save: update 16s_BMS.kicad_sch (2026-11-06 11:11:09)
2026-11-06 Save: update 16s_BMS.kicad_sch (2026-11-06 11:16:25)
2026-11-06 Save: update 16s_BMS.kicad_sch (2026-11-06 11:16:36)
2026-11-06 Save: update 16s_BMS.kicad_sch (2026-11-06 11:16:47)
2026-11-06 Save: update 16s_BMS.kicad_sch (2026-11-06 11:17:18)
2026-11-06 Save: update test_top.kicad_sch (2026-11-06 11:29:17)
2026-11-06 Save: update 16s_BMS.kicad_sch (2026-11-06 11:29:40)
2026-11-06 Save: update 16s_BMS.kicad_sch (2026-11-06 11:31:00)
2026-11-06 Save: update esp32_gateway.kicad_sch (2026-11-06 11:42:29)
2026-11-06 Save: update esp32_gateway.net (2026-11-06 11:42:42)
2026-11-06 Save: update esp32_gateway.kicad_sch (2026-11-06 11:45:10)
2026-11-06 Save: update esp32_gateway.kicad_sch, esp32_gateway.net, esp32_gateway.pdf (2026-11-06 16:54:33)
2026-11-06 Save: update esp32_gateway.pdf (2026-11-06 17:04:38)
2026-11-06 Save: update 16s_BMS.kicad_sch (2026-11-06 19:33:30)
2026-11-06 Save: update 16s_BMS.kicad_sch (2026-11-06 19:35:35)
2026-11-06 Save: update good.kicad_sch, good.net (2026-11-06 19:35:55)
2026-11-06 Save: update temp.kicad_sch, temp.net (2026-11-06 19:36:13)
2026-11-06 Save: update temp.kicad_sch, temp.net (2026-11-06 19:36:28)
2026-11-06 Save: update temp.kicad_sch, temp.net (2026-11-06 19:36:42)
2026-11-07 Save: update 16s_BMS.kicad_sch (2026-11-07 12:20:43)
2026-11-07 Save: update test_old.kicad_sch (2026-11-07 12:22:06)
2026-11-07 Save: update test_blend.kicad_sch (2026-11-07 12:23:15)
2026-11-10 Save: update 16s_BMS.kicad_sch, 16s_BMS.kicad_sch.orig (2026-11-10 13:35:41)
2026-11-10 Save: update 16s_BMS.kicad_sch (2026-11-10 13:36:11)
2026-11-10 Save: update 16s_BMS.kicad_sch (2026-11-10 13:36:18)
2026-11-10 Save: update 16s_BMS.kicad_sch (2026-11-10 13:36:25)
2026-11-10 Save: update 16s_BMS.kicad_sch (2026-11-10 13:36:33)
2026-11-10 Save: update 16s_BMS.kicad_sch (2026-11-10 13:36:45)
2026-11-10 Save: update 16s_BMS.kicad_sch (2026-11-10 13:36:54)
2026-11-10 Save: update 16s_BMS.kicad_sch (2026-11-10 13:37:01)
2026-11-10 Save: update 16s_BMS.kicad_sch (2026-11-10 13:37:36)
2026-11-10 Save: update 16s_BMS.kicad_sch (2026-11-10 13:38:01)
2026-11-10 Save: update 16s_BMS.kicad_sch (2026-11-10 13:38:19)
2026-11-10 Save: update 16s_BMS.kicad_sch (2026-11-10 13:38:29)
2026-11-10 Save: update 16s_BMS.kicad_sch (2026-11-10 13:39:01)
2026-11-10 Save: update 16s_BMS.kicad_sch (2026-11-10 13:39:15)
2026-11-10 Save: update 16s_BMS.kicad_sch.orig (2026-11-10 13:39:25)
2026-11-10 Save: update 02_Power_Supply.kicad_sch (2026-11-10 13:40:37)
2026-11-10 Save: update 02_Power_Supply.kicad_sch (2026-11-10 13:48:47)
2026-11-10 Save: update 02_Power_Supply.kicad_sch (2026-11-10 13:49:58)
2026-11-10 Save: update 02_Power_Supply.kicad_sch (2026-11-10 13:50:48)
2026-11-10 Save: update 02_Power_Supply.kicad_sch (2026-11-10 13:52:00)
2026-11-10 Save: update 03_MCU_Control.kicad_sch (2026-11-10 13:53:47)
2026-11-10 Save: update 16s_BMS.kicad_sch (2026-11-10 13:55:21)
2026-11-10 Save: update 02_Power_Supply.kicad_sch, 03_MCU_Control.kicad_sch (2026-11-10 13:57:27)
